dpilawa/bytec/various/hirschmann_ent10512_pinout.JPG

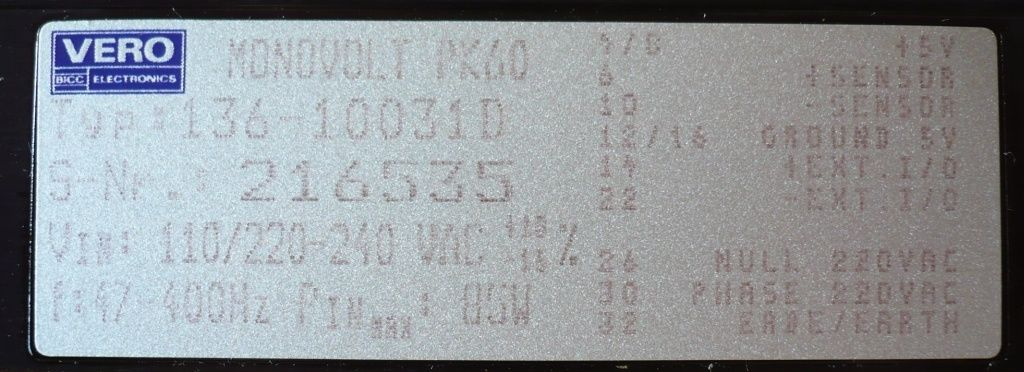
various/hirschmann_ent10512_pinout.JPG
