dpilawa/bytec/ucasm/README

Microcode Assembler

Release 2016-02-08

This software is part of "DIY Computer Poject" <http://www.pilawa.org/computer>
Copyright 2009, 2010, 2011, 2016 Dawid Pilawa <dpilawa(at)gmail(dot)com>
