dpilawa/bytec/diagrams/cpu2.0.png

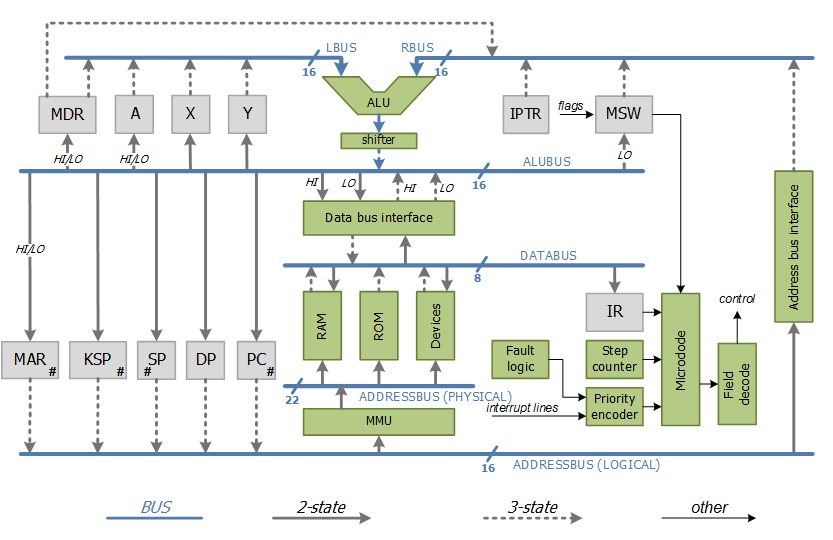
diagrams/cpu2.0.png
