dpilawa/bytec/diagrams/cpu6.png

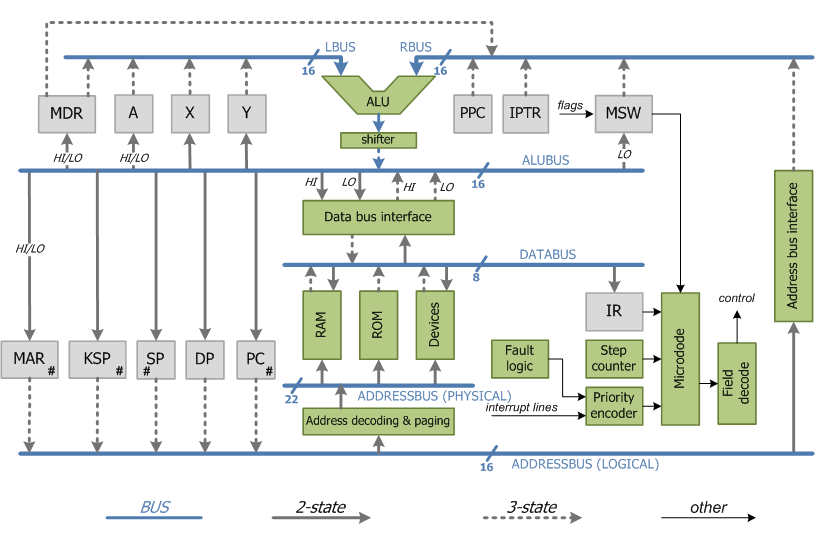
diagrams/cpu6.png
