dpilawa/bytec/instructionset/instructionset_20160414.xls

# | opcode | mnemonic | semantics | flags set | cycles
0 | 0 | NOP | no operation; fetch next instruction | -------- | 1
1 | 0 | FRET | return from fault | SICZNV-- | 17
2 | 0 | MOV A, X | copy X to A | -------- | 1
3 | 0 | MOV A, Y | copy Y to A | -------- | 1
4 | 0 | MOV A, SP | copy SP to A | -------- | 2
5 | 0 | MOV A, DP | copy DP to A | -------- | 2
6 | 0 | MOV X, A | copy A to X | -------- | 1
7 | 0 | MOV X, Y | copy Y to X | -------- | 1
8 | 0 | MOV Y, A | copy A to Y | -------- | 1
9 | 0 | MOV Y, X | copy X to Y | -------- | 1
10 | 0 | MOV SP, A | copy A to SP | -------- | 1
11 | 0 | MOV DP, A | copy A to DP | -------- | 1
12 | 0 | MOV AL, MSW | copy machine status word to low byte of A | -------- | 1
13 | 0 | MOV MSW, AL | copy low byte of A to machine status word | SICZNVP- | 1
14 | 0 | MOVL AL, X | copy low byte of X to AL | -------- | 1
15 | 0 | MOVL AL, Y | copy low byte of Y to AL | -------- | 1
16 | 0 | PUSH A | push A to stack | -------- | 4
17 | 0 | PUSH X | push X to stack | -------- | 4
18 | 0 | PUSH Y | push Y to stack | -------- | 4
19 | 0 | PUSH AH | push high byte of A to stack | -------- | 3
20 | 0 | PUSH AL | push low byte of A to stack | -------- | 3
21 | 0 | PUSH SP | push SP to stack | -------- | 4
22 | 0 | PUSH DP | push DP to stack | -------- | 4
23 | 0 | PUSH PC | push PC to stack | -------- | 4
24 | 0 | POP A | pop A from stack | -------- | 3
25 | 0 | POP X | pop X from stack | -------- | 3
26 | 0 | POP Y | pop Y from stack | -------- | 3
27 | 0 | POP AH | pop high byte of A from stack | -------- | 2
28 | 0 | POP AL | pop low byte of A from stack | -------- | 2
29 | 0 | POP SP | pop SP from stack | -------- | 3
30 | 0 | POP DP | pop DP from stack | -------- | 3
31 | 0 | JMP A | jump to absolute address in A | -------- | 2
32 | 0 | JMP #i16 | unconditional jump (offset relative to PC) | -------- | 4
33 | 0 | CALL #i16 | push program counter to stack and jump to subroutine (offset relative to PC) | -------- | 7
34 | 0 | RET | return from subroutine (pop program counter from stack) | -------- | 4
35 | 0 | IRET | return from interrupt | SICZNV-- | 20
36 | 0 | CALL A | push program counter to stack and jump to subroutine address in A | -------- | 5
37 | 0 | LD A, #i16 | load A with 16-bit immediate | -------- | 3
38 | 0 | LD A, (SP:#i8) | load A with memory at address in SP plus 8-bit signed offset | -------- | 5
39 | 0 | LD A, (SP:#i16) | load A with memory at address in SP plus 16-bit signed offset | -------- | 6
40 | 0 | LD A, (DP:#i16) | load A with memory at address in DP plus 16-bit signed offset | -------- | 6
41 | 0 | LD A, (A:#i16) | load A with memory at address in A plus 16-bit signed offset | -------- | 6
42 | 0 | LD A, (X:#i16) | load A with memory at address in X plus 16-bit signed offset | -------- | 6
43 | 0 | LD A, (Y:#i16) | load A with memory at address in Y plus 16-bit signed offset | -------- | 6
44 | 0 | LD X, #i16 | load X with 16-bit immediate | -------- | 3
45 | 0 | LD X, (SP:#i8) | load X with memory at address in SP plus 8-bit signed offset | -------- | 5
46 | 0 | LD X, (SP:#i16) | load X with memory at address in SP plus 16-bit signed offset | -------- | 6
47 | 0 | LD X, (DP:#i16) | load X with memory at address in DP plus 16-bit signed offset | -------- | 6
48 | 0 | LD X, (A:#i16) | load X with memory at address in A plus 16-bit signed offset | -------- | 6
49 | 0 | LD X, (X:#i16) | load X with memory at address in X plus 16-bit signed offset | -------- | 6
50 | 0 | LD X, (Y:#i16) | load X with memory at address in Y plus 16-bit signed offset | -------- | 6
51 | 0 | LD Y, #i16 | load Y with 16-bit immediate | -------- | 3
52 | 0 | LD Y, (SP:#i8) | load Y with memory at address in SP plus 8-bit signed offset | -------- | 5
53 | 0 | LD Y, (SP:#i16) | load Y with memory at address in SP plus 16-bit signed offset | -------- | 6
54 | 0 | LD Y, (DP:#i16) | load Y with memory at address in DP plus 16-bit signed offset | -------- | 6
55 | 0 | LD Y, (A:#i16) | load Y with memory at address in A plus 16-bit signed offset | -------- | 6
56 | 0 | LD Y, (X:#i16) | load Y with memory at address in X plus 16-bit signed offset | -------- | 6
57 | 0 | LD Y, (Y:#i16) | load Y with memory at address in Y plus 16-bit signed offset | -------- | 6
58 | 0 | LD AH, #i8 | load low byte of A with 8-bit immediate | -------- | 2
59 | 0 | LD AL, #i8 | load high byte of A with 8-bit immediate | -------- | 2
60 | 0 | LD AH, (SP:#i8) | load high byte of A with memory at address in SP plus 8-bit signed offset | -------- | 4
61 | 0 | LD AL, (SP:#i8) | load low byte of A with memory at address in SP plus 8-bit signed offset | -------- | 4
62 | 0 | LD AH, (SP:#i16) | load high byte of A with memory at address in SP plus 16-bit signed offset | -------- | 5
63 | 0 | LD AL, (SP:#i16) | load low byte of A with memory at address in SP plus 16-bit signed offset | -------- | 5
64 | 0 | LD AH, (DP:#i16) | load high byte of A with memory at address in DP plus 16-bit signed offset | -------- | 5
65 | 0 | LD AL, (DP:#i16) | load low byte of A with memory at address in DP plus 16-bit signed offset | -------- | 5
66 | 0 | LD AH, (X:#i16) | load high byte of A with memory at address in X plus 16-bit signed offset | -------- | 5
67 | 0 | LD AL, (X:#i16) | load low byte of A with memory at address in X plus 16-bit signed offset | -------- | 5
68 | 0 | LD AH, (Y:#i16) | load high byte of A with memory at address in Y plus 16-bit signed offset | -------- | 5
69 | 0 | LD AL, (Y:#i16) | load low byte of A with memory at address in Y plus 16-bit signed offset | -------- | 5
70 | 0 | ST (SP:#i8), A | store A in memory at address in SP plus 8-bit signed offset | -------- | 5
71 | 0 | ST (SP:#i16), A | store A in memory at address in SP plus 16-bit signed offset | -------- | 6
72 | 0 | ST (DP:#i16), A | store A in memory at address in DP plus 16-bit signed offset | -------- | 6
73 | 0 | ST (A:#i16), A | store A in memory at address in A plus 16-bit signed offset | -------- | 6
74 | 0 | ST (X:#i16), A | store A in memory at address in X plus 16-bit signed offset | -------- | 6
75 | 0 | ST (Y:#i16), A | store A in memory at address in Y plus 16-bit signed offset | -------- | 6
76 | 0 | ST (SP:#i8), X | store X in memory at address in SP plus 8-bit signed offset | -------- | 5
77 | 0 | ST (SP:#i16), X | store X in memory at address in SP plus 16-bit signed offset | -------- | 6
78 | 0 | ST (DP:#i16), X | store X in memory at address in DP plus 16-bit signed offset | -------- | 6
79 | 0 | ST (A:#i16), X | store X in memory at address in A plus 16-bit signed offset | -------- | 6
80 | 0 | ST (X:#i16), X | store X in memory at address in X plus 16-bit signed offset | -------- | 6
81 | 0 | ST (Y:#i16), X | store X in memory at address in Y plus 16-bit signed offset | -------- | 6
82 | 0 | ST (SP:#i8), Y | store Y in memory at address in SP plus 8-bit signed offset | -------- | 5
83 | 0 | ST (SP:#i16), Y | store Y in memory at address in SP plus 16-bit signed offset | -------- | 6
84 | 0 | ST (DP:#i16), Y | store Y in memory at address in DP plus 16-bit signed offset | -------- | 6
85 | 0 | ST (A:#i16), Y | store Y in memory at address in A plus 16-bit signed offset | -------- | 6
86 | 0 | ST (X:#i16), Y | store Y in memory at address in X plus 16-bit signed offset | -------- | 6
87 | 0 | ST (Y:#i16), Y | store Y in memory at address in Y plus 16-bit signed offset | -------- | 6
88 | 0 | ST (SP:#i8), AH | store high byte of A at address in SP plus 8-bit signed offset | -------- | 4
89 | 0 | ST (SP:#i8), AL | store low byte of A at address in SP plus 8-bit signed offset | -------- | 4
90 | 0 | ST (SP:#i16), AH | store high byte of A at address in SP plus 16-bit signed offset | -------- | 5
91 | 0 | ST (SP:#i16), AL | store low byte of A at address in SP plus 16-bit signed offset | -------- | 5
92 | 0 | ST (DP:#i16), AH | store high byte of A at address in DP plus 16-bit signed offset | -------- | 5
93 | 0 | ST (DP:#i16), AL | store low byte of A at address in DP plus 16-bit signed offset | -------- | 5
94 | 0 | ST (X:#i16), AH | store high byte of A at address in X plus 16-bit signed offset | -------- | 5
95 | 0 | ST (X:#i16), AL | store low byte of A at address in X plus 16-bit signed offset | -------- | 5
96 | 0 | ST (Y:#i16), AH | store high byte of A at address in Y plus 16-bit signed offset | -------- | 5
97 | 0 | ST (Y:#i16), AL | store low byte of A at address in Y plus 16-bit signed offset | -------- | 5
98 | 0 | ADD A, #i16 | add 16-bit signed immediate to A | --CZNV-- | 3
99 | 0 | ADD A, X | add X to A | --CZNV-- | 2
100 | 0 | ADD A, Y | add Y to A | --CZNV-- | 2
101 | 0 | ADD A, (SP:#i8) | add memory at address in SP plus 8-bit signed offset to A | --CZNV-- | 5
102 | 0 | ADD A, (SP:#i16) | add memory at address in SP plus 16-bit signed offset to A | --CZNV-- | 6
103 | 0 | ADD A, (DP:#i16) | add memory at address in DP plus 16-bit signed offset to A | --CZNV-- | 6
104 | 0 | ADD A, (A:#i16) | add memory at address in A plus 16-bit signed offset to A | --CZNV-- | 6
105 | 0 | ADD A, (X:#i16) | add memory at address in X plus 16-bit signed offset to A | --CZNV-- | 6
106 | 0 | ADD A, (Y:#i16) | add memory at address in Y plus 16-bit signed offset to A | --CZNV-- | 6
107 | 0 | ADD X, #i16 | add 16-bit signed immediate to X | --CZNV-- | 3
108 | 0 | ADD X, A | add A to X | --CZNV-- | 2
109 | 0 | ADD X, Y | add Y to X | --CZNV-- | 2
110 | 0 | ADD X, (SP:#i8) | add memory at address in SP plus 8-bit signed offset to X | --CZNV-- | 5
111 | 0 | ADD X, (SP:#i16) | add memory at address in SP plus 16-bit signed offset to X | --CZNV-- | 6
112 | 0 | ADD X, (DP:#i16) | add memory at address in DP plus 16-bit signed offset to X | --CZNV-- | 6
113 | 0 | ADD X, (A:#i16) | add memory at address in A plus 16-bit signed offset to X | --CZNV-- | 6
114 | 0 | ADD X, (X:#i16) | add memory at address in X plus 16-bit signed offset to X | --CZNV-- | 6
115 | 0 | ADD X, (Y:#i16) | add memory at address in Y plus 16-bit signed offset to X | --CZNV-- | 6
116 | 0 | ADD Y, #i16 | add 16-bit signed immediate to Y | --CZNV-- | 3
117 | 0 | ADD Y, A | add A to Y | --CZNV-- | 2
118 | 0 | ADD Y, X | add X to Y | --CZNV-- | 2
119 | 0 | ADD Y, (SP:#i8) | add memory at address in SP plus 8-bit signed offset to Y | --CZNV-- | 5
120 | 0 | ADD Y, (SP:#i16) | add memory at address in SP plus 16-bit signed offset to Y | --CZNV-- | 6
121 | 0 | ADD Y, (DP:#i16) | add memory at address in DP plus 16-bit signed offset to Y | --CZNV-- | 6
122 | 0 | ADD Y, (A:#i16) | add memory at address in A plus 16-bit signed offset to Y | --CZNV-- | 6
123 | 0 | ADD Y, (X:#i16) | add memory at address in X plus 16-bit signed offset to Y | --CZNV-- | 6
124 | 0 | ADD Y, (Y:#i16) | add memory at address in Y plus 16-bit signed offset to Y | --CZNV-- | 6
125 | 0 | ADD AH, #i8 | add 8-bit immediate to high byte of A | --CZNV-- | 3
126 | 0 | ADD AL, #i8 | add 8-bit immediate to low byte of A | --CZNV-- | 2
127 | 0 | ADD AH, (SP:#i16) | add memory at address in SP plus 16-bit signed offset to high byte of A | --CZNV-- | 6
128 | 0 | ADD AL, (SP:#i16) | add memory at address in SP plus 16-bit signed offset to low byte of A | --CZNV-- | 5
129 | 0 | ADD AH, (DP:#i16) | add memory at address in DP plus 16-bit signed offset to high byte of A | --CZNV-- | 6
130 | 0 | ADD AL, (DP:#i16) | add memory at address in DP plus 16-bit signed offset to low byte of A | --CZNV-- | 5
131 | 0 | ADD AH, (X:#i16) | add memory at address in X plus 16-bit signed offset to high byte of A | --CZNV-- | 6
132 | 0 | ADD AL, (X:#i16) | add memory at address in X plus 16-bit signed offset to low byte of A | --CZNV-- | 5
133 | 0 | ADD AH, (Y:#i16) | add memory at address in Y plus 16-bit signed offset to high byte of A | --CZNV-- | 6
134 | 0 | ADD AL, (Y:#i16) | add memory at address in Y plus 16-bit signed offset to low byte of A | --CZNV-- | 5
135 | 0 | SUB A, #i16 | subtract 16-bit signed immediate from A | --CZNV-- | 3
136 | 0 | SUB A, X | subtract X from A | --CZNV-- | 2
137 | 0 | SUB A, Y | subtract Y from A | --CZNV-- | 2
138 | 0 | SUB A, (SP:#i8) | subtract memory at address in SP plus 8-bit signed offset from A | --CZNV-- | 5
139 | 0 | SUB A, (SP:#i16) | subtract memory at address in SP plus 16-bit signed offset from A | --CZNV-- | 6
140 | 0 | SUB A, (DP:#i16) | subtract memory at address in DP plus 16-bit signed offset from A | --CZNV-- | 6
141 | 0 | SUB A, (A:#i16) | subtract memory at address in A plus 16-bit signed offset from A | --CZNV-- | 6
142 | 0 | SUB A, (X:#i16) | subtract memory at address in X plus 16-bit signed offset from A | --CZNV-- | 6
143 | 0 | SUB A, (Y:#i16) | subtract memory at address in Y plus 16-bit signed offset from A | --CZNV-- | 6
144 | 0 | SUB X, #i16 | subtract 16-bit signed immediate from X | --CZNV-- | 3
145 | 0 | SUB X, A | subtract A from X | --CZNV-- | 2
146 | 0 | SUB X, Y | subtract Y from X | --CZNV-- | 2
147 | 0 | SUB X, (SP:#i8) | subtract memory at address in SP plus 8-bit signed offset from X | --CZNV-- | 5
148 | 0 | SUB X, (SP:#i16) | subtract memory at address in SP plus 16-bit signed offset from X | --CZNV-- | 6
149 | 0 | SUB X, (DP:#i16) | subtract memory at address in DP plus 16-bit signed offset from X | --CZNV-- | 6
150 | 0 | SUB X, (A:#i16) | subtract memory at address in A plus 16-bit signed offset from X | --CZNV-- | 6
151 | 0 | SUB X, (X:#i16) | subtract memory at address in X plus 16-bit signed offset from X | --CZNV-- | 6
152 | 0 | SUB X, (Y:#i16) | subtract memory at address in Y plus 16-bit signed offset from X | --CZNV-- | 6
153 | 0 | SUB Y, #i16 | subtract 16-bit signed immediate from Y | --CZNV-- | 3
154 | 0 | SUB Y, A | subtract A from Y | --CZNV-- | 2
155 | 0 | SUB Y, X | subtract X from Y | --CZNV-- | 2
156 | 0 | SUB Y, (SP:#i8) | subtract memory at address in SP plus 8-bit signed offset from Y | --CZNV-- | 5
157 | 0 | SUB Y, (SP:#i16) | subtract memory at address in SP plus 16-bit signed offset from Y | --CZNV-- | 6
158 | 0 | SUB Y, (DP:#i16) | subtract memory at address in DP plus 16-bit signed offset from Y | --CZNV-- | 6
159 | 0 | SUB Y, (A:#i16) | subtract memory at address in A plus 16-bit signed offset from Y | --CZNV-- | 6
160 | 0 | SUB Y, (X:#i16) | subtract memory at address in X plus 16-bit signed offset from Y | --CZNV-- | 6
161 | 0 | SUB Y, (Y:#i16) | subtract memory at address in Y plus 16-bit signed offset from Y | --CZNV-- | 6
162 | 0 | SUB AH, #i8 | subtract 8-bit immediate from high byte of A | --CZNV-- | 3
163 | 0 | SUB AL, #i8 | subtract 8-bit immediate from low byte of A | --CZNV-- | 2
164 | 0 | SUB AH, (SP:#i16) | subtract memory at address in SP plus 16-bit signed offset from high byte of A | --CZNV-- | 6
165 | 0 | SUB AL, (SP:#i16) | subtract memory at address in SP plus 16-bit signed offset from low byte of A | --CZNV-- | 5
166 | 0 | SUB AH, (DP:#i16) | subtract memory at address in DP plus 16-bit signed offset from high byte of A | --CZNV-- | 6
167 | 0 | SUB AL, (DP:#i16) | subtract memory at address in DP plus 16-bit signed offset from low byte of A | --CZNV-- | 5
168 | 0 | SUB AH, (X:#i16) | subtract memory at address in X plus 16-bit signed offset from high byte of A | --CZNV-- | 6
169 | 0 | SUB AL, (X:#i16) | subtract memory at address in X plus 16-bit signed offset from low byte of A | --CZNV-- | 5
170 | 0 | SUB AH, (Y:#i16) | subtract memory at address in Y plus 16-bit signed offset from high byte of A | --CZNV-- | 6
171 | 0 | SUB AL, (Y:#i16) | subtract memory at address in Y plus 16-bit signed offset from low byte of A | --CZNV-- | 5
172 | 0 | AND A, #i16 | bitwise AND on A and 16-bit immediate, result in A | --CZNV-- | 3
173 | 0 | AND A, X | bitwise AND on A and X, result in A | --CZNV-- | 2
174 | 0 | AND A, Y | bitwise AND on A and Y, result in A | --CZNV-- | 2
175 | 0 | AND A, (SP:#i16) | bitwise AND on A and memory at address in SP plus 16-bit signed offset, result in A | --CZNV-- | 6
176 | 0 | AND A, (DP:#i16) | bitwise AND on A and memory at address in DP plus 16-bit signed offset, result in A | --CZNV-- | 6
177 | 0 | AND AH, #i8 | bitwise AND on high byte of A and 8-bit immediate, result in low byte of A | --CZNV-- | 2
178 | 0 | AND AL, #i8 | bitwise AND on low byte of A and 8-bit immediate, result in low byte of A | --CZNV-- | 2
179 | 0 | AND AH, (SP:#i16) | bitwise AND on high byte of A and memory at address in SP plus 16-bit signed offset, result in high byte of A | --CZNV-- | 5
180 | 0 | AND AL, (SP:#i16) | bitwise AND on low byte of A and memory at address in SP plus 16-bit signed offset, result in low byte of A | --CZNV-- | 5
181 | 0 | AND AH, (DP:#i16) | bitwise AND on high byte of A and memory at address in DP plus 16-bit signed offset, result in high byte of A | --CZNV-- | 5
182 | 0 | AND AL, (DP:#i16) | bitwise AND on low byte of A and memory at address in DP plus 16-bit signed offset, result in low byte of A | --CZNV-- | 5
183 | 0 | OR A, #i16 | bitwise OR on A and 16-bit immediate, result in A | --CZNV-- | 3
184 | 0 | OR A, X | bitwise OR on A and X, result in A | --CZNV-- | 2
185 | 0 | OR A, Y | bitwise OR on A and Y, result in A | --CZNV-- | 2
186 | 0 | OR A, (SP:#i16) | bitwise OR on A and memory at address in SP plus 16-bit signed offset, result in A | --CZNV-- | 6
187 | 0 | OR A, (DP:#i16) | bitwise OR on A and memory at address in DP plus 16-bit signed offset, result in A | --CZNV-- | 6
188 | 0 | OR AH, #i8 | bitwise OR on high byte of A and 8-bit immediate, result in low byte of A | --CZNV-- | 2
189 | 0 | OR AL, #i8 | bitwise OR on low byte of A and 8-bit immediate, result in low byte of A | --CZNV-- | 2
190 | 0 | OR AH, (SP:#i16) | bitwise OR on high byte of A and memory at address in SP plus 16-bit signed offset, result in high byte of A | --CZNV-- | 5
191 | 0 | OR AL, (SP:#i16) | bitwise OR on low byte of A and memory at address in SP plus 16-bit signed offset, result in low byte of A | --CZNV-- | 5
192 | 0 | OR AH, (DP:#i16) | bitwise OR on high byte of A and memory at address in DP plus 16-bit signed offset, result in high byte of A | --CZNV-- | 5
193 | 0 | OR AL, (DP:#i16) | bitwise OR on low byte of A and memory at address in DP plus 16-bit signed offset, result in low byte of A | --CZNV-- | 5
194 | 0 | XOR A, #i16 | bitwise XOR on A and 16-bit immediate, result in A | --CZNV-- | 3
195 | 0 | XOR A, X | bitwise XOR on A and X, result in A | --CZNV-- | 2
196 | 0 | XOR A, Y | bitwise XOR on A and Y, result in A | --CZNV-- | 2
197 | 0 | XOR A, (SP:#i16) | bitwise XOR on A and memory at address in SP plus 16-bit signed offset, result in A | --CZNV-- | 6
198 | 0 | XOR A, (DP:#i16) | bitwise XOR on A and memory at address in DP plus 16-bit signed offset, result in A | --CZNV-- | 6
199 | 0 | XOR AH, #i8 | bitwise XOR on high byte of A and 8-bit immediate, result in low byte of A | --CZNV-- | 2
200 | 0 | XOR AL, #i8 | bitwise XOR on low byte of A and 8-bit immediate, result in low byte of A | --CZNV-- | 2
201 | 0 | XOR AH, (SP:#i16) | bitwise XOR on high byte of A and memory at address in SP plus 16-bit signed offset, result in high byte of A | --CZNV-- | 5
202 | 0 | XOR AL, (SP:#i16) | bitwise XOR on low byte of A and memory at address in SP plus 16-bit signed offset, result in low byte of A | --CZNV-- | 5
203 | 0 | XOR AH, (DP:#i16) | bitwise XOR on high byte of A and memory at address in DP plus 16-bit signed offset, result in high byte of A | --CZNV-- | 5
204 | 0 | XOR AL, (DP:#i16) | bitwise XOR on low byte of A and memory at address in DP plus 16-bit signed offset, result in low byte of A | --CZNV-- | 5
205 | 0 | SEX A | sign extend A (low 8 bits to 16 bits) | --CZNV-- | 2
206 | 0 | SHL A | logical shift left of A | --CZNV-- | 1
207 | 0 | SHR A | logical shift right of A | --CZNV-- | 1
208 | 0 | SHL AH | logical shift left of high byte of A | --CZNV-- | 1
209 | 0 | SHL AL | logical shift left of low byte of A | --CZNV-- | 1
210 | 0 | SHR AH | logical shift right of high byte of A | --CZNV-- | 1
211 | 0 | SHR AL | logical shift right of low byte of A | --CZNV-- | 1
212 | 0 | ADC A, X | add with carry X to A | --CZNV-- | 2
213 | 0 | ADC A, Y | add with carry Y to A | --CZNV-- | 2
214 | 0 | SBC A, X | subtract with carry X from A | --CZNV-- | 2
215 | 0 | SBC A, Y | subtract with carry Y from A | --CZNV-- | 2
216 | 0 | ADD SP, #i16 | Add 16-bit signed immediate to SP | --CZNV-- | 4
217 | 0 | CMP A, #i16 | compare A to 16-bit signed immediate, set flags | --CZNV-- | 3
218 | 0 | CMP A, X | compare A to X, set flags | --CZNV-- | 2
219 | 0 | CMP A, Y | compare A to Y, set flags | --CZNV-- | 2
220 | 0 | CMP A, (SP:#i16) | compare A to memory at address in SP plus 16-bit signed offset | --CZNV-- | 6
221 | 0 | CMP A, (DP:#i16) | compare A to memory at address in DP plus 16-bit signed offset | --CZNV-- | 6
222 | 0 | CMP AH, #i8 | compare AH to 8-bit signed immediate, set flags | --CZNV-- | 3
223 | 0 | CMP AH, (SP:#i16) | compare high byte of A to memory at address in SP plus 16-bit signed offset | --CZNV-- | 6
224 | 0 | CMP AH, (DP:#i16) | compare high byte of A to memory at address in DP plus 16-bit signed offset | --CZNV-- | 6
225 | 0 | CMP AL, #i8 | compare AL to 8-bit signed immediate, set flags | --CZNV-- | 2
226 | 0 | CMP AL, (SP:#i16) | compare low byte of A to memory at address in SP plus 16-bit signed offset | --CZNV-- | 5
227 | 0 | CMP AL, (DP:#i16) | compare low byte of A to memory at address in DP plus 16-bit signed offset | --CZNV-- | 5
228 | 0 | JE #i16 | jump if equal (offset relative to PC) | -------- | 3 /4
229 | 0 | JNE #i16 | jump if not equal (offset relative to PC) | -------- | 3 /4
230 | 0 | JL #i16 | jump if lower (offset relative to PC) | -------- | 3 /4
231 | 0 | JLE #i16 | jump if lower or equal (offset relative to PC) | -------- | 3 /4
232 | 0 | JG #i16 | jump if greater (offset relative to PC) | -------- | 3 /4
233 | 0 | JGE #i16 | jump if greater or equal (offset relative to PC) | -------- | 3 /4
234 | 0 | JLU #i16 | jump if lower unsigned (offset relative to PC) | -------- | 3 /4
235 | 0 | JLEU #i16 | jump if lower or equal unsigned (offset relative to PC) | -------- | 3 /4
236 | 0 | JGU #i16 | jump if greater unsigned (offset relative to PC) | -------- | 3 /4
237 | 0 | JGEU #i16 | jump if greater or equal unsigned (offset relative to PC) | -------- | 3 /4
238 | 0 | JZ #i16 | jump if zero (offset relative to PC) | -------- | 3 /4
239 | 0 | JNZ #i16 | jump if not zero (offset relative to PC) | -------- | 3 /4
240 | 0 | JC #i16 | jump if carry (offset relative to PC) | -------- | 3 /4
241 | 0 | JNC #i16 | jump if not carry (offset relative to PC) | -------- | 3 /4
242 | 0 | JN #i16 | jump if negative (offset relative to PC) | -------- | 3 /4
243 | 0 | JNN #i16 | jump if not negative (offset relative to PC) | -------- | 3 /4
244 | 0 | JV #i16 | jump if overflow (offset relative to PC) | -------- | 3 /4
245 | 0 | JNV #i16 | jump if not overflow (offset relative to PC) | -------- | 3 /4
246 | 0 | LEA A, (A:#i16) | load effective address in A plus 16-bit signed offset to A | -------- | 3
247 | 0 | LEA A, (DP:#i16) | load effective address in SP plus 16-bit signed offset to A | -------- | 4
248 | 0 | LEA A, (SP:#i16) | load effective address in DP plus 16-bit signed offset to A | -------- | 4
249 | 0 | LEA X, (A:#i16) | load effective address in A plus 16-bit signed offset to X | -------- | 3
250 | 0 | LEA X, (DP:#i16) | load effective address in SP plus 16-bit signed offset to X | -------- | 4
251 | 0 | LEA X, (SP:#i16) | load effective address in DP plus 16-bit signed offset to X | -------- | 4
252 | 0 | LEA Y, (A:#i16) | load effective address in A plus 16-bit signed offset to Y | -------- | 3
253 | 0 | LEA Y, (DP:#i16) | load effective address in SP plus 16-bit signed offset to Y | -------- | 4
254 | 0 | LEA Y, (SP:#i16) | load effective address in DP plus 16-bit signed offset to Y | -------- | 4
255 | 0 | SYSCALL #i8 | call a system interrupt | SI------ | 29
256 | 0 | n/a | IRQ #0 | SI------ | 22
257 | 0 | n/a | IRQ #1 | SI------ | 22
258 | 0 | n/a | IRQ #2 | SI------ | 22
259 | 0 | n/a | IRQ #3 | SI------ | 22
260 | 0 | n/a | IRQ #4 | SI------ | 22
261 | 0 | n/a | IRQ #5 | SI------ | 22
262 | 0 | n/a | IRQ #6 | SI------ | 22
263 | 0 | n/a | IRQ #7 | SI------ | 22
264 | 0 | n/a | fault #0 – illegal instruction / protection violation | SI------ | 22
265 | 0 | n/a | fault #1 – unused | SI------ | 22
266 | 0 | n/a | fault #2 – unused | SI------ | 22
267 | 0 | n/a | fault #3 – unused | SI------ | 22
268 | 0 | n/a | fault #4 – unused | SI------ | 22
269 | 0 | n/a | fault #5 – unused | SI------ | 22
270 | 0 | n/a | fault #6 – unused | SI------ | 22
271 | 0 | n/a | unreachable opcode – interrupt vector entry used for SYSCALL | SI------ | 1
