dpilawa/bytec/instructionset/instructionset_20110624.xls

# | opcode | mnemonic | semantics | flags set | cycles
0 | 00 | NOP | no operation; fetch next instruction | ------ | 1
1 | 01 | HALT | halt the machine; fetch self | ------ | 3
2 | 02 | MOV A, X | copy X to A | ------ | 1
3 | 03 | MOV A, Y | copy Y to A | ------ | 1
4 | 04 | MOV A, SP | copy SP to A | ------ | 2
5 | 05 | MOV A, DP | copy DP to A | ------ | 2
6 | 06 | MOV X, A | copy A to X | ------ | 1
7 | 07 | MOV X, Y | copy Y to X | ------ | 1
8 | 08 | MOV Y, A | copy A to Y | ------ | 1
9 | 09 | MOV Y, X | copy X to Y | ------ | 1
10 | 0A | MOV SP, A | copy A to SP | ------ | 1
11 | 0B | MOV SP, DP | copy DP to SP | ------ | 2
12 | 0C | MOV DP, A | copy A to DP | ------ | 1
13 | 0D | MOV DP, SP | copy SP to DP | ------ | 2
14 | 0E | MOV AL, MSW | copy machine status word to low byte of A | ------ | 1
15 | 0F | MOV MSW, AL | copy low byte of A to machine status word | SICZNV | 1
16 | 10 | PUSH A | push A to stack | ------ | 4
17 | 11 | PUSH X | push X to stack | ------ | 4
18 | 12 | PUSH Y | push Y to stack | ------ | 4
19 | 13 | PUSH SP | push SP to stack | ------ | 4
20 | 14 | PUSH DP | push DP to stack | ------ | 4
21 | 15 | PUSH PC | push PC to stack | ------ | 4
22 | 16 | POP A | pop A from stack | ------ | 3
23 | 17 | POP X | pop X from stack | ------ | 3
24 | 18 | POP Y | pop Y from stack | ------ | 3
25 | 19 | POP SP | pop SP from stack | ------ | 3
26 | 1A | POP DP | pop DP from stack | ------ | 3
27 | 1B | POP PC | pop PC from stack | ------ | 4
28 | 1C | JMP #i16 | unconditional jump (offset relative to PC) | ------ | 4
29 | 1D | CALL #i16 | push program counter to stack and jump to subroutine (offset relative to PC) | ------ | 7
30 | 1E | RET | return from subroutine (pop program counter from stack) | ------ | 4
31 | 1F | IRET | return from interrupt | SICZNV | 20
32 | 20 | CALL (SP) | push program counter to stack and jump to subroutine address on previous top of the stack | ------ | 8
33 | 21 | LD A, #i16 | load A with 16-bit immediate | ------ | 3
34 | 22 | LD A, #i8 | load A with 8-bit immediate (with sign extension to high byte) | ------ | 2
35 | 23 | LD A, (SP) | load A with memory at address in SP | ------ | 4
36 | 24 | LD A, (SP:#i8) | load A with memory at address in SP plus 8-bit signed offset | ------ | 5
37 | 25 | LD A, (SP:#i16) | load A with memory at address in SP plus 16-bit signed offset | ------ | 6
38 | 26 | LD A, (DP:#i16) | load A with memory at address in DP plus 16-bit signed offset | ------ | 6
39 | 27 | LD A, (A:#i16) | load A with memory at address in A plus 16-bit signed offset | ------ | 6
40 | 28 | LD A, (X:#i16) | load A with memory at address in X plus 16-bit signed offset | ------ | 6
41 | 29 | LD A, (Y:#i16) | load A with memory at address in Y plus 16-bit signed offset | ------ | 6
42 | 2A | LD X, #i16 | load X with 16-bit immediate | ------ | 3
43 | 2B | LD X, #i8 | load X with 8-bit immediate (sign extended) | ------ | 2
44 | 2C | LD X, (SP) | load X with memory at address in SP | ------ | 4
45 | 2D | LD X, (SP:#i8) | load X with memory at address in SP plus 8-bit signed offset | ------ | 5
46 | 2E | LD X, (SP:#i16) | load X with memory at address in SP plus 16-bit signed offset | ------ | 6
47 | 2F | LD X, (DP:#i16) | load X with memory at address in DP plus 16-bit signed offset | ------ | 6
48 | 30 | LD X, (A:#i16) | load X with memory at address in A plus 16-bit signed offset | ------ | 6
49 | 31 | LD X, (X:#i16) | load X with memory at address in X plus 16-bit signed offset | ------ | 6
50 | 32 | LD X, (Y:#i16) | load X with memory at address in Y plus 16-bit signed offset | ------ | 6
51 | 33 | LD Y, #i16 | load Y with 16-bit immediate | ------ | 3
52 | 34 | LD Y, #i8 | load Y with 8-bit immediate (sign extended) | ------ | 2
53 | 35 | LD Y, (SP) | load Y with memory at address in SP | ------ | 4
54 | 36 | LD Y, (SP:#i8) | load Y with memory at address in SP plus 8-bit signed offset | ------ | 5
55 | 37 | LD Y, (SP:#i16) | load Y with memory at address in SP plus 16-bit signed offset | ------ | 6
56 | 38 | LD Y, (DP:#i16) | load Y with memory at address in DP plus 16-bit signed offset | ------ | 6
57 | 39 | LD Y, (A:#i16) | load Y with memory at address in A plus 16-bit signed offset | ------ | 6
58 | 3A | LD Y, (X:#i16) | load Y with memory at address in X plus 16-bit signed offset | ------ | 6
59 | 3B | LD Y, (Y:#i16) | load Y with memory at address in Y plus 16-bit signed offset | ------ | 6
60 | 3C | LD AH, #i8 | load low byte of A with 8-bit immediate | ------ | 2
61 | 3D | LD AL, #i8 | load high byte of A with 8-bit immediate | ------ | 2
62 | 3E | LD AH, (SP:#i8) | load high byte of A with memory at address in SP plus 8-bit signed offset | ------ | 4
63 | 3F | LD AL, (SP:#i8) | load low byte of A with memory at address in SP plus 8-bit signed offset | ------ | 4
64 | 40 | LD AH, (SP:#i16) | load high byte of A with memory at address in SP plus 16-bit signed offset | ------ | 5
65 | 41 | LD AL, (SP:#i16) | load low byte of A with memory at address in SP plus 16-bit signed offset | ------ | 5
66 | 42 | LD AH, (DP:#i16) | load high byte of A with memory at address in DP plus 16-bit signed offset | ------ | 5
67 | 43 | LD AL, (DP:#i16) | load low byte of A with memory at address in DP plus 16-bit signed offset | ------ | 5
68 | 44 | LD AH, (DP:X) | load high byte of A with memory at address in DP plus 16-bit signed offset in X | ------ | 3
69 | 45 | LD AL, (DP:X) | load low byte of A with memory at address in DP plus 16-bit signed offset in X | ------ | 3
70 | 46 | LD AH, (X:#i16) | load high byte of A with memory at address in X plus 16-bit signed offset | ------ | 5
71 | 47 | LD AL, (X:#i16) | load low byte of A with memory at address in X plus 16-bit signed offset | ------ | 5
72 | 48 | LD AH, (Y:#i16) | load high byte of A with memory at address in Y plus 16-bit signed offset | ------ | 5
73 | 49 | LD AL, (Y:#i16) | load low byte of A with memory at address in Y plus 16-bit signed offset | ------ | 5
74 | 4A | ST (SP), A | store A in memory at address in SP | ------ | 4
75 | 4B | ST (SP:#i8), A | store A in memory at address in SP plus 8-bit signed offset | ------ | 5
76 | 4C | ST (SP:#i16), A | store A in memory at address in SP plus 16-bit signed offset | ------ | 6
77 | 4D | ST (DP:#i16), A | store A in memory at address in DP plus 16-bit signed offset | ------ | 6
78 | 4E | ST (A:#i16), A | store A in memory at address in A plus 16-bit signed offset | ------ | 6
79 | 4F | ST (X:#i16), A | store A in memory at address in X plus 16-bit signed offset | ------ | 6
80 | 50 | ST (Y:#i16), A | store A in memory at address in Y plus 16-bit signed offset | ------ | 6
81 | 51 | ST (SP), X | store X in memory at address in SP | ------ | 4
82 | 52 | ST (SP:#i8), X | store X in memory at address in SP plus 8-bit signed offset | ------ | 5
83 | 53 | ST (SP:#i16), X | store X in memory at address in SP plus 16-bit signed offset | ------ | 6
84 | 54 | ST (DP:#i16), X | store X in memory at address in DP plus 16-bit signed offset | ------ | 6
85 | 55 | ST (A:#i16), X | store X in memory at address in A plus 16-bit signed offset | ------ | 6
86 | 56 | ST (X:#i16), X | store X in memory at address in X plus 16-bit signed offset | ------ | 6
87 | 57 | ST (Y:#i16), X | store X in memory at address in Y plus 16-bit signed offset | ------ | 6
88 | 58 | ST (SP), Y | store Y in memory at address in SP | ------ | 4
89 | 59 | ST (SP:#i8), Y | store Y in memory at address in SP plus 8-bit signed offset | ------ | 5
90 | 5A | ST (SP:#i16), Y | store Y in memory at address in SP plus 16-bit signed offset | ------ | 6
91 | 5B | ST (DP:#i16), Y | store Y in memory at address in DP plus 16-bit signed offset | ------ | 6
92 | 5C | ST (A:#i16), Y | store Y in memory at address in A plus 16-bit signed offset | ------ | 6
93 | 5D | ST (X:#i16), Y | store Y in memory at address in X plus 16-bit signed offset | ------ | 6
94 | 5E | ST (Y:#i16), Y | store Y in memory at address in Y plus 16-bit signed offset | ------ | 6
95 | 5F | ST (SP), AH | store high byte of A at address in SP | ------ | 2
96 | 60 | ST (SP), AL | store low byte of A at address in SP | ------ | 2
97 | 61 | ST (SP:#i8), AH | store high byte of A at address in SP plus 8-bit signed offset | ------ | 4
98 | 62 | ST (SP:#i8), AL | store low byte of A at address in SP plus 8-bit signed offset | ------ | 4
99 | 63 | ST (SP:#i16), AH | store high byte of A at address in SP plus 16-bit signed offset | ------ | 5
100 | 64 | ST (SP:#i16), AL | store low byte of A at address in SP plus 16-bit signed offset | ------ | 5
101 | 65 | ST (DP:#i16), AH | store high byte of A at address in DP plus 16-bit signed offset | ------ | 5
102 | 66 | ST (DP:#i16), AL | store low byte of A at address in DP plus 16-bit signed offset | ------ | 5
103 | 67 | ST (DP:X), AH | store high byte of A at address in DP plus 16-bit signed offset in X | ------ | 3
104 | 68 | ST (DP:X), AL | store low byte of A at address in DP plus 16-bit signed offset in X | ------ | 3
105 | 69 | ST (X:#i16), AH | store high byte of A at address in X plus 16-bit signed offset | ------ | 5
106 | 6A | ST (X:#i16), AL | store low byte of A at address in X plus 16-bit signed offset | ------ | 5
107 | 6B | ST (Y:#i16), AH | store high byte of A at address in Y plus 16-bit signed offset | ------ | 5
108 | 6C | ST (Y:#i16), AL | store low byte of A at address in Y plus 16-bit signed offset | ------ | 5
109 | 6D | ADD A, #i8 | add 8-bit signed immediate to A | --CZNV | 2
110 | 6E | ADD A, #i16 | add 16-bit signed immediate to A | --CZNV | 3
111 | 6F | ADD A, X | add X to A | --CZNV | 2
112 | 70 | ADD A, Y | add Y to A | --CZNV | 2
113 | 71 | ADD A, (SP) | add memory at address in SP to A | --CZNV | 4
114 | 72 | ADD A, (SP:#i8) | add memory at address in SP plus 8-bit signed offset to A | --CZNV | 5
115 | 73 | ADD A, (SP:#i16) | add memory at address in SP plus 16-bit signed offset to A | --CZNV | 6
116 | 74 | ADD A, (DP:#i16) | add memory at address in DP plus 16-bit signed offset to A | --CZNV | 6
117 | 75 | ADD AH, (SP) | add memory at address in SP to high byte of A | --CZNV | 3
118 | 76 | ADD AH, (SP:#i8) | add memory at address in SP plus 8-bit signed offset to high byte of A | --CZNV | 5
119 | 77 | ADD AH, (SP:#i16) | add memory at address in SP plus 16-bit signed offset to high byte of A | --CZNV | 6
120 | 78 | ADD AH, (DP:#i16) | add memory at address in DP plus 16-bit signed offset to high byte of A | --CZNV | 6
121 | 79 | ADD AL, (SP) | add memory at address in SP to low byte of A | --CZNV | 2
122 | 7A | ADD AL, (SP:#i8) | add memory at address in SP plus 8-bit signed offset to low byte of A | --CZNV | 4
123 | 7B | ADD AL, (SP:#i16) | add memory at address in SP plus 16-bit signed offset to low byte of A | --CZNV | 5
124 | 7C | ADD AL, (DP:#i16) | add memory at address in DP plus 16-bit signed offset to low byte of A | --CZNV | 5
125 | 7D | SUB A, #i8 | subtract 8-bit signed immediate from A | --CZNV | 2
126 | 7E | SUB A, #i16 | subtract 16-bit signed immediate from A | --CZNV | 3
127 | 7F | SUB A, X | subtract X from A | --CZNV | 2
128 | 80 | SUB A, Y | subtract Y from A | --CZNV | 2
129 | 81 | SUB A, (SP) | subtract memory at address in SP from A | --CZNV | 4
130 | 82 | SUB A, (SP:#i8) | subtract memory at address in SP plus 8-bit signed offset from A | --CZNV | 5
131 | 83 | SUB A, (SP:#i16) | subtract memory at address in SP plus 16-bit signed offset from A | --CZNV | 6
132 | 84 | SUB A, (DP:#i16) | subtract memory at address in DP plus 16-bit signed offset from A | --CZNV | 6
133 | 85 | SUB AH, (SP) | subtract memory at address in SP from high byte of A | --CZNV | 3
134 | 86 | SUB AH, (SP:#i8) | subtract memory at address in SP plus 8-bit signed offset from high byte of A | --CZNV | 5
135 | 87 | SUB AH, (SP:#i16) | subtract memory at address in SP plus 16-bit signed offset from high byte of A | --CZNV | 6
136 | 88 | SUB AH, (DP:#i16) | subtract memory at address in DP plus 16-bit signed offset from high byte of A | --CZNV | 6
137 | 89 | SUB AL, (SP) | subtract memory at address in SP from low byte of A | --CZNV | 2
138 | 8A | SUB AL, (SP:#i8) | subtract memory at address in SP plus 8-bit signed offset from low byte of A | --CZNV | 4
139 | 8B | SUB AL, (SP:#i16) | subtract memory at address in SP plus 16-bit signed offset from low byte of A | --CZNV | 5
140 | 8C | SUB AL, (DP:#i16) | subtract memory at address in DP plus 16-bit signed offset from low byte of A | --CZNV | 5
141 | 8D | AND A, #i16 | bitwise AND on A and 16-bit immediate, result in A | --CZNV | 3
142 | 8E | AND A, X | bitwise AND on A and X, result in A | --CZNV | 2
143 | 8F | AND A, Y | bitwise AND on A and Y, result in A | --CZNV | 2
144 | 90 | AND A, (SP) | bitwise AND on A and memory at address in SP, result in A | --CZNV | 4
145 | 91 | AND A, (SP:#i8) | bitwise AND on A and memory at address in SP plus 8-bit signed offset, result in A | --CZNV | 5
146 | 92 | AND A, (SP:#i16) | bitwise AND on A and memory at address in SP plus 16-bit signed offset, result in A | --CZNV | 6
147 | 93 | AND A, (DP:#i16) | bitwise AND on A and memory at address in DP plus 16-bit signed offset, result in A | --CZNV | 6
148 | 94 | AND AH, (SP) | bitwise AND on high byte of A and memory at address in SP, result in high byte of A | --CZNV | 2
149 | 95 | AND AH, (SP:#i8) | bitwise AND on high byte of A and memory at address in SP plus 8-bit signed offset, result in high byte of A | --CZNV | 4
150 | 96 | AND AH, (SP:#i16) | bitwise AND on high byte of A and memory at address in SP plus 16-bit signed offset, result in high byte of A | --CZNV | 5
151 | 97 | AND AH, (DP:#i16) | bitwise AND on high byte of A and memory at address in DP plus 16-bit signed offset, result in high byte of A | --CZNV | 5
152 | 98 | AND AL, (SP) | bitwise AND on low byte of A and memory at address in SP, result in low byte of A | --CZNV | 2
153 | 99 | AND AL, (SP:#i8) | bitwise AND on low byte of A and memory at address in SP plus 8-bit signed offset, result in low byte of A | --CZNV | 4
154 | 9A | AND AL, (SP:#i16) | bitwise AND on low byte of A and memory at address in SP plus 16-bit signed offset, result in low byte of A | --CZNV | 5
155 | 9B | AND AL, (DP:#i16) | bitwise AND on low byte of A and memory at address in DP plus 16-bit signed offset, result in low byte of A | --CZNV | 5
156 | 9C | OR A, #i16 | bitwise OR on A and 16-bit immediate, result in A | --CZNV | 3
157 | 9D | OR A, X | bitwise OR on A and X, result in A | --CZNV | 2
158 | 9E | OR A, Y | bitwise OR on A and Y, result in A | --CZNV | 2
159 | 9F | OR A, (SP) | bitwise OR on A and memory at address in SP, result in A | --CZNV | 4
160 | A0 | OR A, (SP:#i8) | bitwise OR on A and memory at address in SP plus 8-bit signed offset, result in A | --CZNV | 5
161 | A1 | OR A, (SP:#i16) | bitwise OR on A and memory at address in SP plus 16-bit signed offset, result in A | --CZNV | 6
162 | A2 | OR A, (DP:#i16) | bitwise OR on A and memory at address in DP plus 16-bit signed offset, result in A | --CZNV | 6
163 | A3 | OR AH, (SP) | bitwise OR on high byte of A and memory at address in SP, result in high byte of A | --CZNV | 2
164 | A4 | OR AH, (SP:#i8) | bitwise OR on high byte of A and memory at address in SP plus 8-bit signed offset, result in high byte of A | --CZNV | 4
165 | A5 | OR AH, (SP:#i16) | bitwise OR on high byte of A and memory at address in SP plus 16-bit signed offset, result in high byte of A | --CZNV | 5
166 | A6 | OR AH, (DP:#i16) | bitwise OR on high byte of A and memory at address in DP plus 16-bit signed offset, result in high byte of A | --CZNV | 5
167 | A7 | OR AL, (SP) | bitwise OR on low byte of A and memory at address in SP, result in low byte of A | --CZNV | 2
168 | A8 | OR AL, (SP:#i8) | bitwise OR on low byte of A and memory at address in SP plus 8-bit signed offset, result in low byte of A | --CZNV | 4
169 | A9 | OR AL, (SP:#i16) | bitwise OR on low byte of A and memory at address in SP plus 16-bit signed offset, result in low byte of A | --CZNV | 5
170 | AA | OR AL, (DP:#i16) | bitwise OR on low byte of A and memory at address in DP plus 16-bit signed offset, result in low byte of A | --CZNV | 5
171 | AB | XOR A, #i16 | bitwise exclusive OR on A and 16-bit immediate, result in A | --CZNV | 3
172 | AC | XOR A, A | bitwise exclusive OR on A and A, result in A | --CZNV | 2
173 | AD | XOR A, X | bitwise exclusive OR on A and X, result in A | --CZNV | 2
174 | AE | XOR A, Y | bitwise exclusive OR on A and Y, result in A | --CZNV | 2
175 | AF | XOR X, X | bitwise exclusive OR on X and X, result in X | --CZNV | 2
176 | B0 | XOR Y, Y | bitwise exclusive OR on Y and Y, result in Y | --CZNV | 2
177 | B1 | SHL A | logical shift left of A | --CZNV | 2
178 | B2 | SHL X | logical shift left of X | --CZNV | 2
179 | B3 | SHL Y | logical shift left of Y | --CZNV | 2
180 | B4 | SHR A | logical shift right of A | --CZNV | 2
181 | B5 | SHR X | logical shift right of X | --CZNV | 2
182 | B6 | SHR Y | logical shift right of Y | --CZNV | 2
183 | B7 | SHL AH | logical shift left of high byte of A | --CZNV | 4
184 | B8 | SHL AL | logical shift left of low byte of A | --CZNV | 2
185 | B9 | SHR AH | logical shift right of high byte of A | --CZNV | 2
186 | BA | SHR AL | logical shift right of low byte of A | --CZNV | 3
187 | BB | ADC A, X | add with carry X to A | --CZNV | 2
188 | BC | ADC A, Y | add with carry Y to A | --CZNV | 2
189 | BD | SBC A, X | subtract with carry X from A | --CZNV | 2
190 | BE | SBC A, Y | subtract with carry Y from A | --CZNV | 2
191 | BF | ADD SP, #i8 | add 8-bit signed immediate to SP | --CZNV | 3
192 | C0 | ADD DP, #i8 | add 8-bit signed immediate to DP | --CZNV | 3
193 | C1 | ADD X, #i8 | add 8-bit signed immediate to X | --CZNV | 2
194 | C2 | ADD Y, #i8 | add 8-bit signed immediate to Y | --CZNV | 2
195 | C3 | PUSH AH | push high byte of A to stack | ------ | 3
196 | C4 | PUSH AL | push low byte of A to stack | ------ | 3
197 | C5 | CMP A, #i8 | compare A to 8-bit signed immediate, set flags | --CZNV | 2
198 | C6 | CMP A, #i16 | compare A to 16-bit signed immediate, set flags | --CZNV | 3
199 | C7 | CMP A, X | compare A to X, set flags | --CZNV | 2
200 | C8 | CMP A, Y | compare A to Y, set flags | --CZNV | 2
201 | C9 | CMP A, (SP) | compare A to memory at address in SP | --CZNV | 4
202 | CA | CMP A, (SP:#i8) | compare A to memory at address in SP plus 8-bit signed offset | --CZNV | 5
203 | CB | CMP A, (SP:#i16) | compare A to memory at address in SP plus 16-bit signed offset | --CZNV | 6
204 | CC | CMP A, (DP:#i16) | compare A to memory at address in DP plus 16-bit signed offset | --CZNV | 6
205 | CD | CMP AH, (SP) | compare high byte of A to memory at address in SP | --CZNV | 3
206 | CE | CMP AH, (SP:#i8) | compare high byte of A to memory at address in SP plus 8-bit signed offset | --CZNV | 5
207 | CF | CMP AH, (SP:#i16) | compare high byte of A to memory at address in SP plus 16-bit signed offset | --CZNV | 6
208 | D0 | CMP AH, (DP:#i16) | compare high byte of A to memory at address in DP plus 16-bit signed offset | --CZNV | 6
209 | D1 | CMP AL, (SP) | compare low byte of A to memory at address in SP | --CZNV | 2
210 | D2 | CMP AL, (SP:#i8) | compare low byte of A to memory at address in SP plus 8-bit signed offset | --CZNV | 4
211 | D3 | CMP AL, (SP:#i16) | compare low byte of A to memory at address in SP plus 16-bit signed offset | --CZNV | 5
212 | D4 | CMP AL, (DP:#i16) | compare low byte of A to memory at address in DP plus 16-bit signed offset | --CZNV | 5
213 | D5 | JE #i16 | jump if equal (offset relative to PC) | ------ | 3 /4
214 | D6 | JL #i16 | jump if lower (offset relative to PC) | ------ | 3 /4
215 | D7 | JLE #i16 | jump if lower or equal (offset relative to PC) | ------ | 3 /4
216 | D8 | JG #i16 | jump if greater (offset relative to PC) | ------ | 3 /4
217 | D9 | JGE #i16 | jump if greater or equal (offset relative to PC) | ------ | 3 /4
218 | DA | JZ #i16 | jump if zero (offset relative to PC) | ------ | 3 /4
219 | DB | JNE #i16 | jump if not equal (offset relative to PC) | ------ | 3 /4
220 | DC | JNZ #i16 | jump if not zero (offset relative to PC) | ------ | 3 /4
221 | DD | JC #i16 | jump if carry (offset relative to PC) | ------ | 3 /4
222 | DE | JNC #i16 | jump if not carry (offset relative to PC) | ------ | 3 /4
223 | DF | JN #i16 | jump if negative (offset relative to PC) | ------ | 3 /4
224 | E0 | JNN #i16 | jump if not negative (offset relative to PC) | ------ | 3 /4
225 | E1 | JV #i16 | jump if overflow (offset relative to PC) | ------ | 3 /4
226 | E2 | JNV #i16 | jump if not overflow (offset relative to PC) | ------ | 3 /4
227 | E3 | INC X | increase value of X | --CZNV | 1
228 | E4 | DEC X | decrease value of X | --CZNV | 1
229 | E5 | INC Y | increase value of Y | --CZNV | 1
230 | E6 | DEC Y | decrease value of Y | --CZNV | 1
231 | E7 | LD A, (DP) | load A with memory at address in DP | ------ | 4
232 | E8 | LD A, (DP:X) | load A with memory at address in DP plus 16-bit signed offset in X | ------ | 4
233 | E9 | LD A, (DP:Y) | load A with memory at address in DP plus 16-bit signed offset in Y | ------ | 4
234 | EA | ST (DP), A | store A in memory at address in DP | ------ | 4
235 | EB | ST (DP:X), A | store A in memory at address in DP plus 16-bit signed offset in X | ------ | 4
236 | EC | ST (DP:Y), A | store A in memory at address in DP plus 16-bit signed offset in Y | ------ | 4
237 | ED | LD AL, (DP) | load low byte of A with memory at address in DP | ------ | 2
238 | EE | ST (DP), AL | store low byte of A at address in DP | ------ | 2
239 | EF | push #i8 | push 8-bit immediate on stack | ------ | 3
240 | F0 | push #i16 | push 16-bit immediate on stack | ------ | 5
241 | F1 | ld dp, #i16 | load immediate to data pointer | ------ | 3
242 | F2 | ld sp, #i16 | load immediate to stack pointer | ------ | 3
243 | F3 | add ah, #i8 | add 8-bit immediate to high byte of A | ------ | 3
244 | F4 | add al, #i8 | add 8-bit immediate to low byte of A | ------ | 2
245 | F5 | sub ah, #i8 | subtract 8-bit immediate from high byte of A | ------ | 3
246 | F6 | sub al, #i8 | subtract 8-bit immediate from low byte of A | ------ | 2
247 | F7 | and ah, #i8 | bitwise AND on high byte of A and 8-bit immediate, result in low byte of A | --CZNV | 2
248 | F8 | and al, #i8 | bitwise AND on low byte of A and 8-bit immediate, result in low byte of A | --CZNV | 2
249 | F9 | or ah, #i8 | bitwise OR on high byte of A and 8-bit immediate, result in low byte of A | --CZNV | 2
250 | FA | or al, #i8 | bitwise OR on low byte of A and 8-bit immediate, result in low byte of A | --CZNV | 2
251 | FB | cmp ah, #i8 | compare high byte of A to 8-bit signed immediate | --CZNV | 3
252 | FC | cmp al, #i8 | compare low byte of A to 8-bit signed immediate | --CZNV | 2
253 | FD | STI | set interrupt enable flag | -I---- | 2
254 | FE | CLI | clear interrupt enable flag | -I---- | 2
255 | FF | SYSCALL | call a software interrupt | SI---- | 25
256 | 100 | n/a | IRQ #0 | SI---- | 25
257 | 101 | n/a | IRQ #1 | SI---- | 25
258 | 102 | n/a | IRQ #2 | SI---- | 25
259 | 103 | n/a | IRQ #3 | SI---- | 25
260 | 104 | n/a | IRQ #4 | SI---- | 25
261 | 105 | n/a | IRQ #5 | SI---- | 25
262 | 106 | n/a | IRQ #6 | SI---- | 25
263 | 107 | n/a | IRQ #7 | SI---- | 25
264 | 108 | n/a | fault #0 – illegal instruction / protection violation | SI---- | 25
265 | 109 | n/a | fault #1 – unused | SI---- | 25
266 | 10A | n/a | fault #2 – unused | SI---- | 25
267 | 10B | n/a | fault #3 – unused | SI---- | 25
268 | 10C | n/a | fault #4 – unused | SI---- | 25
269 | 10D | n/a | fault #5 – unused | SI---- | 25
270 | 10E | n/a | fault #6 – unused | SI---- | 25
271 | 10F | n/a | unreachable opcode – interrupt vector entry used for SYSCALL | SI---- | 25
