dpilawa/bytec/instructionset/instructionset_20130125.xls

# | opcode | mnemonic | semantics | flags set | cycles
0 | 00 | NOP | no operation; fetch next instruction | ------ | 1
1 | 01 | HALT | halt the machine; fetch self | ------ | 3
2 | 02 | MOV A, X | copy X to A | ------ | 1
3 | 03 | MOV A, Y | copy Y to A | ------ | 1
4 | 04 | MOV A, SP | copy SP to A | ------ | 2
5 | 05 | MOV A, DP | copy DP to A | ------ | 2
6 | 06 | MOV X, A | copy A to X | ------ | 1
7 | 07 | MOV X, Y | copy Y to X | ------ | 1
8 | 08 | MOV Y, A | copy A to Y | ------ | 1
9 | 09 | MOV Y, X | copy X to Y | ------ | 1
10 | 0A | MOV SP, A | copy A to SP | ------ | 1
11 | 0B | MOV DP, A | copy A to DP | ------ | 1
12 | 0C | MOV AL, MSW | copy machine status word to low byte of A | ------ | 1
13 | 0D | MOV MSW, AL | copy low byte of A to machine status word | SICZNV | 1
14 | 0E | MOVL AL, X | copy low byte of X to AL | ------ | 1
15 | 0F | MOVL AL, Y | copy low byte of Y to AL | ------ | 1
16 | 10 | PUSH A | push A to stack | ------ | 4
17 | 11 | PUSH X | push X to stack | ------ | 4
18 | 12 | PUSH Y | push Y to stack | ------ | 4
19 | 13 | PUSH AH | push high byte of A to stack | ------ | 3
20 | 14 | PUSH AL | push low byte of A to stack | ------ | 3
21 | 15 | PUSH SP | push SP to stack | ------ | 4
22 | 16 | PUSH DP | push DP to stack | ------ | 4
23 | 17 | PUSH PC | push PC to stack | ------ | 4
24 | 18 | POP A | pop A from stack | ------ | 3
25 | 19 | POP X | pop X from stack | ------ | 3
26 | 1A | POP Y | pop Y from stack | ------ | 3
27 | 1B | POP AH | pop high byte of A from stack | ------ | 2
28 | 1C | POP AL | pop low byte of A from stack | ------ | 2
29 | 1D | POP SP | pop SP from stack | ------ | 3
30 | 1E | POP DP | pop DP from stack | ------ | 3
31 | 1F | POP PC | pop PC from stack | ------ | 4
32 | 20 | JMP #i16 | unconditional jump (offset relative to PC) | ------ | 4
33 | 21 | CALL #i16 | push program counter to stack and jump to subroutine (offset relative to PC) | ------ | 7
34 | 22 | RET | return from subroutine (pop program counter from stack) | ------ | 4
35 | 23 | IRET | return from interrupt | SICZNV | 20
36 | 24 | CALL (SP) | push program counter to stack and jump to subroutine address on previous top of the stack | ------ | 8
37 | 25 | LD A, #i16 | load A with 16-bit immediate | ------ | 3
38 | 26 | LD A, (SP:#i8) | load A with memory at address in SP plus 8-bit signed offset | ------ | 5
39 | 27 | LD A, (SP:#i16) | load A with memory at address in SP plus 16-bit signed offset | ------ | 6
40 | 28 | LD A, (DP:#i16) | load A with memory at address in DP plus 16-bit signed offset | ------ | 6
41 | 29 | LD A, (A:#i16) | load A with memory at address in A plus 16-bit signed offset | ------ | 6
42 | 2A | LD A, (X:#i16) | load A with memory at address in X plus 16-bit signed offset | ------ | 6
43 | 2B | LD A, (Y:#i16) | load A with memory at address in Y plus 16-bit signed offset | ------ | 6
44 | 2C | LD X, #i16 | load X with 16-bit immediate | ------ | 3
45 | 2D | LD X, (SP:#i8) | load X with memory at address in SP plus 8-bit signed offset | ------ | 5
46 | 2E | LD X, (SP:#i16) | load X with memory at address in SP plus 16-bit signed offset | ------ | 6
47 | 2F | LD X, (DP:#i16) | load X with memory at address in DP plus 16-bit signed offset | ------ | 6
48 | 30 | LD X, (A:#i16) | load X with memory at address in A plus 16-bit signed offset | ------ | 6
49 | 31 | LD X, (X:#i16) | load X with memory at address in X plus 16-bit signed offset | ------ | 6
50 | 32 | LD X, (Y:#i16) | load X with memory at address in Y plus 16-bit signed offset | ------ | 6
51 | 33 | LD Y, #i16 | load Y with 16-bit immediate | ------ | 3
52 | 34 | LD Y, (SP:#i8) | load Y with memory at address in SP plus 8-bit signed offset | ------ | 5
53 | 35 | LD Y, (SP:#i16) | load Y with memory at address in SP plus 16-bit signed offset | ------ | 6
54 | 36 | LD Y, (DP:#i16) | load Y with memory at address in DP plus 16-bit signed offset | ------ | 6
55 | 37 | LD Y, (A:#i16) | load Y with memory at address in A plus 16-bit signed offset | ------ | 6
56 | 38 | LD Y, (X:#i16) | load Y with memory at address in X plus 16-bit signed offset | ------ | 6
57 | 39 | LD Y, (Y:#i16) | load Y with memory at address in Y plus 16-bit signed offset | ------ | 6
58 | 3A | LD AH, #i8 | load low byte of A with 8-bit immediate | ------ | 2
59 | 3B | LD AL, #i8 | load high byte of A with 8-bit immediate | ------ | 2
60 | 3C | LD AH, (SP:#i8) | load high byte of A with memory at address in SP plus 8-bit signed offset | ------ | 4
61 | 3D | LD AL, (SP:#i8) | load low byte of A with memory at address in SP plus 8-bit signed offset | ------ | 4
62 | 3E | LD AH, (SP:#i16) | load high byte of A with memory at address in SP plus 16-bit signed offset | ------ | 5
63 | 3F | LD AL, (SP:#i16) | load low byte of A with memory at address in SP plus 16-bit signed offset | ------ | 5
64 | 40 | LD AH, (DP:#i16) | load high byte of A with memory at address in DP plus 16-bit signed offset | ------ | 5
65 | 41 | LD AL, (DP:#i16) | load low byte of A with memory at address in DP plus 16-bit signed offset | ------ | 5
66 | 42 | LD AH, (X:#i16) | load high byte of A with memory at address in X plus 16-bit signed offset | ------ | 5
67 | 43 | LD AL, (X:#i16) | load low byte of A with memory at address in X plus 16-bit signed offset | ------ | 5
68 | 44 | LD AH, (Y:#i16) | load high byte of A with memory at address in Y plus 16-bit signed offset | ------ | 5
69 | 45 | LD AL, (Y:#i16) | load low byte of A with memory at address in Y plus 16-bit signed offset | ------ | 5
70 | 46 | ST (SP:#i8), A | store A in memory at address in SP plus 8-bit signed offset | ------ | 5
71 | 47 | ST (SP:#i16), A | store A in memory at address in SP plus 16-bit signed offset | ------ | 6
72 | 48 | ST (DP:#i16), A | store A in memory at address in DP plus 16-bit signed offset | ------ | 6
73 | 49 | ST (A:#i16), A | store A in memory at address in A plus 16-bit signed offset | ------ | 6
74 | 4A | ST (X:#i16), A | store A in memory at address in X plus 16-bit signed offset | ------ | 6
75 | 4B | ST (Y:#i16), A | store A in memory at address in Y plus 16-bit signed offset | ------ | 6
76 | 4C | ST (SP:#i8), X | store X in memory at address in SP plus 8-bit signed offset | ------ | 5
77 | 4D | ST (SP:#i16), X | store X in memory at address in SP plus 16-bit signed offset | ------ | 6
78 | 4E | ST (DP:#i16), X | store X in memory at address in DP plus 16-bit signed offset | ------ | 6
79 | 4F | ST (A:#i16), X | store X in memory at address in A plus 16-bit signed offset | ------ | 6
80 | 50 | ST (X:#i16), X | store X in memory at address in X plus 16-bit signed offset | ------ | 6
81 | 51 | ST (Y:#i16), X | store X in memory at address in Y plus 16-bit signed offset | ------ | 6
82 | 52 | ST (SP:#i8), Y | store Y in memory at address in SP plus 8-bit signed offset | ------ | 5
83 | 53 | ST (SP:#i16), Y | store Y in memory at address in SP plus 16-bit signed offset | ------ | 6
84 | 54 | ST (DP:#i16), Y | store Y in memory at address in DP plus 16-bit signed offset | ------ | 6
85 | 55 | ST (A:#i16), Y | store Y in memory at address in A plus 16-bit signed offset | ------ | 6
86 | 56 | ST (X:#i16), Y | store Y in memory at address in X plus 16-bit signed offset | ------ | 6
87 | 57 | ST (Y:#i16), Y | store Y in memory at address in Y plus 16-bit signed offset | ------ | 6
88 | 58 | ST (SP:#i8), AH | store high byte of A at address in SP plus 8-bit signed offset | ------ | 4
89 | 59 | ST (SP:#i8), AL | store low byte of A at address in SP plus 8-bit signed offset | ------ | 4
90 | 5A | ST (SP:#i16), AH | store high byte of A at address in SP plus 16-bit signed offset | ------ | 5
91 | 5B | ST (SP:#i16), AL | store low byte of A at address in SP plus 16-bit signed offset | ------ | 5
92 | 5C | ST (DP:#i16), AH | store high byte of A at address in DP plus 16-bit signed offset | ------ | 5
93 | 5D | ST (DP:#i16), AL | store low byte of A at address in DP plus 16-bit signed offset | ------ | 5
94 | 5E | ST (X:#i16), AH | store high byte of A at address in X plus 16-bit signed offset | ------ | 5
95 | 5F | ST (X:#i16), AL | store low byte of A at address in X plus 16-bit signed offset | ------ | 5
96 | 60 | ST (Y:#i16), AH | store high byte of A at address in Y plus 16-bit signed offset | ------ | 5
97 | 61 | ST (Y:#i16), AL | store low byte of A at address in Y plus 16-bit signed offset | ------ | 5
98 | 62 | ADD A, #i16 | add 16-bit signed immediate to A | --CZNV | 3
99 | 63 | ADD A, X | add X to A | --CZNV | 2
100 | 64 | ADD A, Y | add Y to A | --CZNV | 2
101 | 65 | ADD A, (SP:#i8) | add memory at address in SP plus 8-bit signed offset to A | --CZNV | 5
102 | 66 | ADD A, (SP:#i16) | add memory at address in SP plus 16-bit signed offset to A | --CZNV | 6
103 | 67 | ADD A, (DP:#i16) | add memory at address in DP plus 16-bit signed offset to A | --CZNV | 6
104 | 68 | ADD A, (A:#i16) | add memory at address in A plus 16-bit signed offset to A | --CZNV | 6
105 | 69 | ADD A, (X:#i16) | add memory at address in X plus 16-bit signed offset to A | --CZNV | 6
106 | 6A | ADD A, (Y:#i16) | add memory at address in Y plus 16-bit signed offset to A | --CZNV | 6
107 | 6B | ADD X, #i16 | add 16-bit signed immediate to X | --CZNV | 3
108 | 6C | ADD X, A | add A to X | --CZNV | 2
109 | 6D | ADD X, Y | add Y to X | --CZNV | 2
110 | 6E | ADD X, (SP:#i8) | add memory at address in SP plus 8-bit signed offset to X | --CZNV | 5
111 | 6F | ADD X, (SP:#i16) | add memory at address in SP plus 16-bit signed offset to X | --CZNV | 6
112 | 70 | ADD X, (DP:#i16) | add memory at address in DP plus 16-bit signed offset to X | --CZNV | 6
113 | 71 | ADD X, (A:#i16) | add memory at address in A plus 16-bit signed offset to X | --CZNV | 6
114 | 72 | ADD X, (X:#i16) | add memory at address in X plus 16-bit signed offset to X | --CZNV | 6
115 | 73 | ADD X, (Y:#i16) | add memory at address in Y plus 16-bit signed offset to X | --CZNV | 6
116 | 74 | ADD Y, #i16 | add 16-bit signed immediate to Y | --CZNV | 3
117 | 75 | ADD Y, A | add A to Y | --CZNV | 2
118 | 76 | ADD Y, X | add X to Y | --CZNV | 2
119 | 77 | ADD Y, (SP:#i8) | add memory at address in SP plus 8-bit signed offset to Y | --CZNV | 5
120 | 78 | ADD Y, (SP:#i16) | add memory at address in SP plus 16-bit signed offset to Y | --CZNV | 6
121 | 79 | ADD Y, (DP:#i16) | add memory at address in DP plus 16-bit signed offset to Y | --CZNV | 6
122 | 7A | ADD Y, (A:#i16) | add memory at address in A plus 16-bit signed offset to Y | --CZNV | 6
123 | 7B | ADD Y, (X:#i16) | add memory at address in X plus 16-bit signed offset to Y | --CZNV | 6
124 | 7C | ADD Y, (Y:#i16) | add memory at address in Y plus 16-bit signed offset to Y | --CZNV | 6
125 | 7D | ADD AH, #i8 | add 8-bit immediate to high byte of A | --CZNV | 3
126 | 7E | ADD AL, #i8 | add 8-bit immediate to low byte of A | --CZNV | 2
127 | 7F | ADD AH, (SP:#i16) | add memory at address in SP plus 16-bit signed offset to high byte of A | --CZNV | 6
128 | 80 | ADD AL, (SP:#i16) | add memory at address in SP plus 16-bit signed offset to low byte of A | --CZNV | 5
129 | 81 | ADD AH, (DP:#i16) | add memory at address in DP plus 16-bit signed offset to high byte of A | --CZNV | 6
130 | 82 | ADD AL, (DP:#i16) | add memory at address in DP plus 16-bit signed offset to low byte of A | --CZNV | 5
131 | 83 | ADD AH, (X:#i16) | add memory at address in X plus 16-bit signed offset to high byte of A | --CZNV | 6
132 | 84 | ADD AL, (X:#i16) | add memory at address in X plus 16-bit signed offset to low byte of A | --CZNV | 5
133 | 85 | ADD AH, (Y:#i16) | add memory at address in Y plus 16-bit signed offset to high byte of A | --CZNV | 6
134 | 86 | ADD AL, (Y:#i16) | add memory at address in Y plus 16-bit signed offset to low byte of A | --CZNV | 5
135 | 87 | SUB A, #i16 | subtract 16-bit signed immediate from A | --CZNV | 3
136 | 88 | SUB A, X | subtract X from A | --CZNV | 2
137 | 89 | SUB A, Y | subtract Y from A | --CZNV | 2
138 | 8A | SUB A, (SP:#i8) | subtract memory at address in SP plus 8-bit signed offset from A | --CZNV | 5
139 | 8B | SUB A, (SP:#i16) | subtract memory at address in SP plus 16-bit signed offset from A | --CZNV | 6
140 | 8C | SUB A, (DP:#i16) | subtract memory at address in DP plus 16-bit signed offset from A | --CZNV | 6
141 | 8D | SUB A, (A:#i16) | subtract memory at address in A plus 16-bit signed offset from A | --CZNV | 6
142 | 8E | SUB A, (X:#i16) | subtract memory at address in X plus 16-bit signed offset from A | --CZNV | 6
143 | 8F | SUB A, (Y:#i16) | subtract memory at address in Y plus 16-bit signed offset from A | --CZNV | 6
144 | 90 | SUB X, #i16 | subtract 16-bit signed immediate from X | --CZNV | 3
145 | 91 | SUB X, A | subtract A from X | --CZNV | 2
146 | 92 | SUB X, Y | subtract Y from X | --CZNV | 2
147 | 93 | SUB X, (SP:#i8) | subtract memory at address in SP plus 8-bit signed offset from X | --CZNV | 5
148 | 94 | SUB X, (SP:#i16) | subtract memory at address in SP plus 16-bit signed offset from X | --CZNV | 6
149 | 95 | SUB X, (DP:#i16) | subtract memory at address in DP plus 16-bit signed offset from X | --CZNV | 6
150 | 96 | SUB X, (A:#i16) | subtract memory at address in A plus 16-bit signed offset from X | --CZNV | 6
151 | 97 | SUB X, (X:#i16) | subtract memory at address in X plus 16-bit signed offset from X | --CZNV | 6
152 | 98 | SUB X, (Y:#i16) | subtract memory at address in Y plus 16-bit signed offset from X | --CZNV | 6
153 | 99 | SUB Y, #i16 | subtract 16-bit signed immediate from Y | --CZNV | 3
154 | 9A | SUB Y, A | subtract A from Y | --CZNV | 2
155 | 9B | SUB Y, X | subtract X from Y | --CZNV | 2
156 | 9C | SUB Y, (SP:#i8) | subtract memory at address in SP plus 8-bit signed offset from Y | --CZNV | 5
157 | 9D | SUB Y, (SP:#i16) | subtract memory at address in SP plus 16-bit signed offset from Y | --CZNV | 6
158 | 9E | SUB Y, (DP:#i16) | subtract memory at address in DP plus 16-bit signed offset from Y | --CZNV | 6
159 | 9F | SUB Y, (A:#i16) | subtract memory at address in A plus 16-bit signed offset from Y | --CZNV | 6
160 | A0 | SUB Y, (X:#i16) | subtract memory at address in X plus 16-bit signed offset from Y | --CZNV | 6
161 | A1 | SUB Y, (Y:#i16) | subtract memory at address in Y plus 16-bit signed offset from Y | --CZNV | 6
162 | A2 | SUB AH, #i8 | subtract 8-bit immediate from high byte of A | --CZNV | 3
163 | A3 | SUB AL, #i8 | subtract 8-bit immediate from low byte of A | --CZNV | 2
164 | A4 | SUB AH, (SP:#i16) | subtract memory at address in SP plus 16-bit signed offset from high byte of A | --CZNV | 6
165 | A5 | SUB AL, (SP:#i16) | subtract memory at address in SP plus 16-bit signed offset from low byte of A | --CZNV | 5
166 | A6 | SUB AH, (DP:#i16) | subtract memory at address in DP plus 16-bit signed offset from high byte of A | --CZNV | 6
167 | A7 | SUB AL, (DP:#i16) | subtract memory at address in DP plus 16-bit signed offset from low byte of A | --CZNV | 5
168 | A8 | SUB AH, (X:#i16) | subtract memory at address in X plus 16-bit signed offset from high byte of A | --CZNV | 6
169 | A9 | SUB AL, (X:#i16) | subtract memory at address in X plus 16-bit signed offset from low byte of A | --CZNV | 5
170 | AA | SUB AH, (Y:#i16) | subtract memory at address in Y plus 16-bit signed offset from high byte of A | --CZNV | 6
171 | AB | SUB AL, (Y:#i16) | subtract memory at address in Y plus 16-bit signed offset from low byte of A | --CZNV | 5
172 | AC | AND A, #i16 | bitwise AND on A and 16-bit immediate, result in A | --CZNV | 3
173 | AD | AND A, X | bitwise AND on A and X, result in A | --CZNV | 2
174 | AE | AND A, Y | bitwise AND on A and Y, result in A | --CZNV | 2
175 | AF | AND A, (SP:#i16) | bitwise AND on A and memory at address in SP plus 16-bit signed offset, result in A | --CZNV | 6
176 | B0 | AND A, (DP:#i16) | bitwise AND on A and memory at address in DP plus 16-bit signed offset, result in A | --CZNV | 6
177 | B1 | AND AH, #i8 | bitwise AND on high byte of A and 8-bit immediate, result in low byte of A | --CZNV | 2
178 | B2 | AND AL, #i8 | bitwise AND on low byte of A and 8-bit immediate, result in low byte of A | --CZNV | 2
179 | B3 | AND AH, (SP:#i16) | bitwise AND on high byte of A and memory at address in SP plus 16-bit signed offset, result in high byte of A | --CZNV | 5
180 | B4 | AND AL, (SP:#i16) | bitwise AND on low byte of A and memory at address in SP plus 16-bit signed offset, result in low byte of A | --CZNV | 5
181 | B5 | AND AH, (DP:#i16) | bitwise AND on high byte of A and memory at address in DP plus 16-bit signed offset, result in high byte of A | --CZNV | 5
182 | B6 | AND AL, (DP:#i16) | bitwise AND on low byte of A and memory at address in DP plus 16-bit signed offset, result in low byte of A | --CZNV | 5
183 | B7 | OR A, #i16 | bitwise OR on A and 16-bit immediate, result in A | --CZNV | 3
184 | B8 | OR A, X | bitwise OR on A and X, result in A | --CZNV | 2
185 | B9 | OR A, Y | bitwise OR on A and Y, result in A | --CZNV | 2
186 | BA | OR A, (SP:#i16) | bitwise OR on A and memory at address in SP plus 16-bit signed offset, result in A | --CZNV | 6
187 | BB | OR A, (DP:#i16) | bitwise OR on A and memory at address in DP plus 16-bit signed offset, result in A | --CZNV | 6
188 | BC | OR AH, #i8 | bitwise OR on high byte of A and 8-bit immediate, result in low byte of A | --CZNV | 2
189 | BD | OR AL, #i8 | bitwise OR on low byte of A and 8-bit immediate, result in low byte of A | --CZNV | 2
190 | BE | OR AH, (SP:#i16) | bitwise OR on high byte of A and memory at address in SP plus 16-bit signed offset, result in high byte of A | --CZNV | 5
191 | BF | OR AL, (SP:#i16) | bitwise OR on low byte of A and memory at address in SP plus 16-bit signed offset, result in low byte of A | --CZNV | 5
192 | C0 | OR AH, (DP:#i16) | bitwise OR on high byte of A and memory at address in DP plus 16-bit signed offset, result in high byte of A | --CZNV | 5
193 | C1 | OR AL, (DP:#i16) | bitwise OR on low byte of A and memory at address in DP plus 16-bit signed offset, result in low byte of A | --CZNV | 5
194 | C2 | XOR A, #i16 | bitwise XOR on A and 16-bit immediate, result in A | --CZNV | 3
195 | C3 | XOR A, X | bitwise XOR on A and X, result in A | --CZNV | 2
196 | C4 | XOR A, Y | bitwise XOR on A and Y, result in A | --CZNV | 2
197 | C5 | XOR A, (SP:#i16) | bitwise XOR on A and memory at address in SP plus 16-bit signed offset, result in A | --CZNV | 6
198 | C6 | XOR A, (DP:#i16) | bitwise XOR on A and memory at address in DP plus 16-bit signed offset, result in A | --CZNV | 6
199 | C7 | XOR AH, #i8 | bitwise XOR on high byte of A and 8-bit immediate, result in low byte of A | --CZNV | 2
200 | C8 | XOR AL, #i8 | bitwise XOR on low byte of A and 8-bit immediate, result in low byte of A | --CZNV | 2
201 | C9 | XOR AH, (SP:#i16) | bitwise XOR on high byte of A and memory at address in SP plus 16-bit signed offset, result in high byte of A | --CZNV | 5
202 | CA | XOR AL, (SP:#i16) | bitwise XOR on low byte of A and memory at address in SP plus 16-bit signed offset, result in low byte of A | --CZNV | 5
203 | CB | XOR AH, (DP:#i16) | bitwise XOR on high byte of A and memory at address in DP plus 16-bit signed offset, result in high byte of A | --CZNV | 5
204 | CC | XOR AL, (DP:#i16) | bitwise XOR on low byte of A and memory at address in DP plus 16-bit signed offset, result in low byte of A | --CZNV | 5
205 | CD | SEX A | sign extend A (low 8 bits to 16 bits) | --CZNV | 2
206 | CE | SHL A | logical shift left of A | --CZNV | 2
207 | CF | SHR A | logical shift right of A | --CZNV | 1
208 | D0 | SHL AH | logical shift left of high byte of A | --CZNV | 2
209 | D1 | SHL AL | logical shift left of low byte of A | --CZNV | 2
210 | D2 | SHR AH | logical shift right of high byte of A | --CZNV | 1
211 | D3 | SHR AL | logical shift right of low byte of A | --CZNV | 1
212 | D4 | ADC A, X | add with carry X to A | --CZNV | 2
213 | D5 | ADC A, Y | add with carry Y to A | --CZNV | 2
214 | D6 | SBC A, X | subtract with carry X from A | --CZNV | 2
215 | D7 | SBC A, Y | subtract with carry Y from A | --CZNV | 2
216 | D8 | ADD SP, #i16 | Add 16-bit signed immediate to SP | --CZNV | 4
217 | D9 | CMP A, #i16 | compare A to 16-bit signed immediate, set flags | --CZNV | 3
218 | DA | CMP A, X | compare A to X, set flags | --CZNV | 2
219 | DB | CMP A, Y | compare A to Y, set flags | --CZNV | 2
220 | DC | CMP A, (SP:#i16) | compare A to memory at address in SP plus 16-bit signed offset | --CZNV | 6
221 | DD | CMP A, (DP:#i16) | compare A to memory at address in DP plus 16-bit signed offset | --CZNV | 6
222 | DE | CMP AH, #i8 | compare AH to 8-bit signed immediate, set flags | --CZNV | 3
223 | DF | CMP AH, (SP:#i16) | compare high byte of A to memory at address in SP plus 16-bit signed offset | --CZNV | 6
224 | E0 | CMP AH, (DP:#i16) | compare high byte of A to memory at address in DP plus 16-bit signed offset | --CZNV | 6
225 | E1 | CMP AL, #i8 | compare AL to 8-bit signed immediate, set flags | --CZNV | 2
226 | E2 | CMP AL, (SP:#i16) | compare low byte of A to memory at address in SP plus 16-bit signed offset | --CZNV | 5
227 | E3 | CMP AL, (DP:#i16) | compare low byte of A to memory at address in DP plus 16-bit signed offset | --CZNV | 5
228 | E4 | JE #i16 | jump if equal (offset relative to PC) | ------ | 3 /4
229 | E5 | JNE #i16 | jump if not equal (offset relative to PC) | ------ | 3 /4
230 | E6 | JL #i16 | jump if lower (offset relative to PC) | ------ | 3 /4
231 | E7 | JLE #i16 | jump if lower or equal (offset relative to PC) | ------ | 3 /4
232 | E8 | JG #i16 | jump if greater (offset relative to PC) | ------ | 3 /4
233 | E9 | JGE #i16 | jump if greater or equal (offset relative to PC) | ------ | 3 /4
234 | EA | JLU #i16 | jump if lower unsigned (offset relative to PC) | ------ | 3 /4
235 | EB | JLEU #i16 | jump if lower or equal unsigned (offset relative to PC) | ------ | 3 /4
236 | EC | JGU #i16 | jump if greater unsigned (offset relative to PC) | ------ | 3 /4
237 | ED | JGEU #i16 | jump if greater or equal unsigned (offset relative to PC) | ------ | 3 /4
238 | EE | JZ #i16 | jump if zero (offset relative to PC) | ------ | 3 /4
239 | EF | JNZ #i16 | jump if not zero (offset relative to PC) | ------ | 3 /4
240 | F0 | JC #i16 | jump if carry (offset relative to PC) | ------ | 3 /4
241 | F1 | JNC #i16 | jump if not carry (offset relative to PC) | ------ | 3 /4
242 | F2 | JN #i16 | jump if negative (offset relative to PC) | ------ | 3 /4
243 | F3 | JNN #i16 | jump if not negative (offset relative to PC) | ------ | 3 /4
244 | F4 | JV #i16 | jump if overflow (offset relative to PC) | ------ | 3 /4
245 | F5 | JNV #i16 | jump if not overflow (offset relative to PC) | ------ | 3 /4
246 | F6 | LEA A, (DP:#i16) | load effective address in SP plus 16-bit signed offset to A | ------ | 4
247 | F7 | LEA A, (SP:#i16) | load effective address in DP plus 16-bit signed offset to A | ------ | 4
248 | F8 | LEA X, (DP:#i16) | load effective address in SP plus 16-bit signed offset to X | ------ | 4
249 | F9 | LEA X, (SP:#i16) | load effective address in DP plus 16-bit signed offset to X | ------ | 4
250 | FA | LEA Y, (DP:#i16) | load effective address in SP plus 16-bit signed offset to Y | ------ | 4
251 | FB | LEA Y, (SP:#i16) | load effective address in DP plus 16-bit signed offset to Y | ------ | 4
252 | FC
253 | FD | STI | set interrupt enable flag | -I---- | 2
254 | FE | CLI | clear interrupt enable flag | -I---- | 2
255 | FF | SYSCALL #i8 | call a system interrupt | SI---- | 32
256 | 100 | n/a | IRQ #0 | SI---- | 25
257 | 101 | n/a | IRQ #1 | SI---- | 25
258 | 102 | n/a | IRQ #2 | SI---- | 25
259 | 103 | n/a | IRQ #3 | SI---- | 25
260 | 104 | n/a | IRQ #4 | SI---- | 25
261 | 105 | n/a | IRQ #5 | SI---- | 25
262 | 106 | n/a | IRQ #6 | SI---- | 25
263 | 107 | n/a | IRQ #7 | SI---- | 25
264 | 108 | n/a | fault #0 – illegal instruction / protection violation | SI---- | 25
265 | 109 | n/a | fault #1 – unused | SI---- | 25
266 | 10A | n/a | fault #2 – unused | SI---- | 25
267 | 10B | n/a | fault #3 – unused | SI---- | 25
268 | 10C | n/a | fault #4 – unused | SI---- | 25
269 | 10D | n/a | fault #5 – unused | SI---- | 25
270 | 10E | n/a | fault #6 – unused | SI---- | 25
271 | 10F | n/a | unreachable opcode – interrupt vector entry used for SYSCALL | SI---- | 25
