dpilawa/bytec/schematics/schematics_20100606.pdf

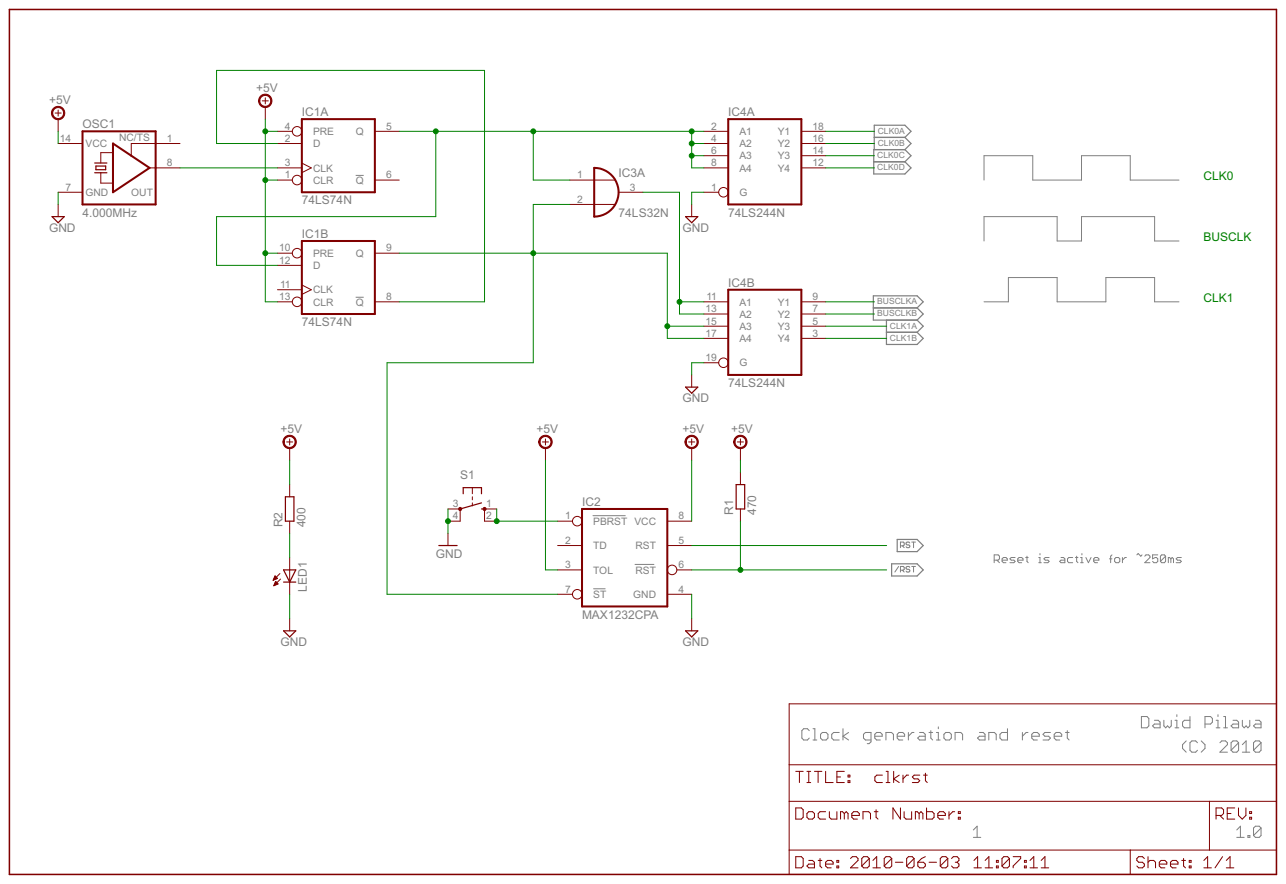
[picture p4: page 1]

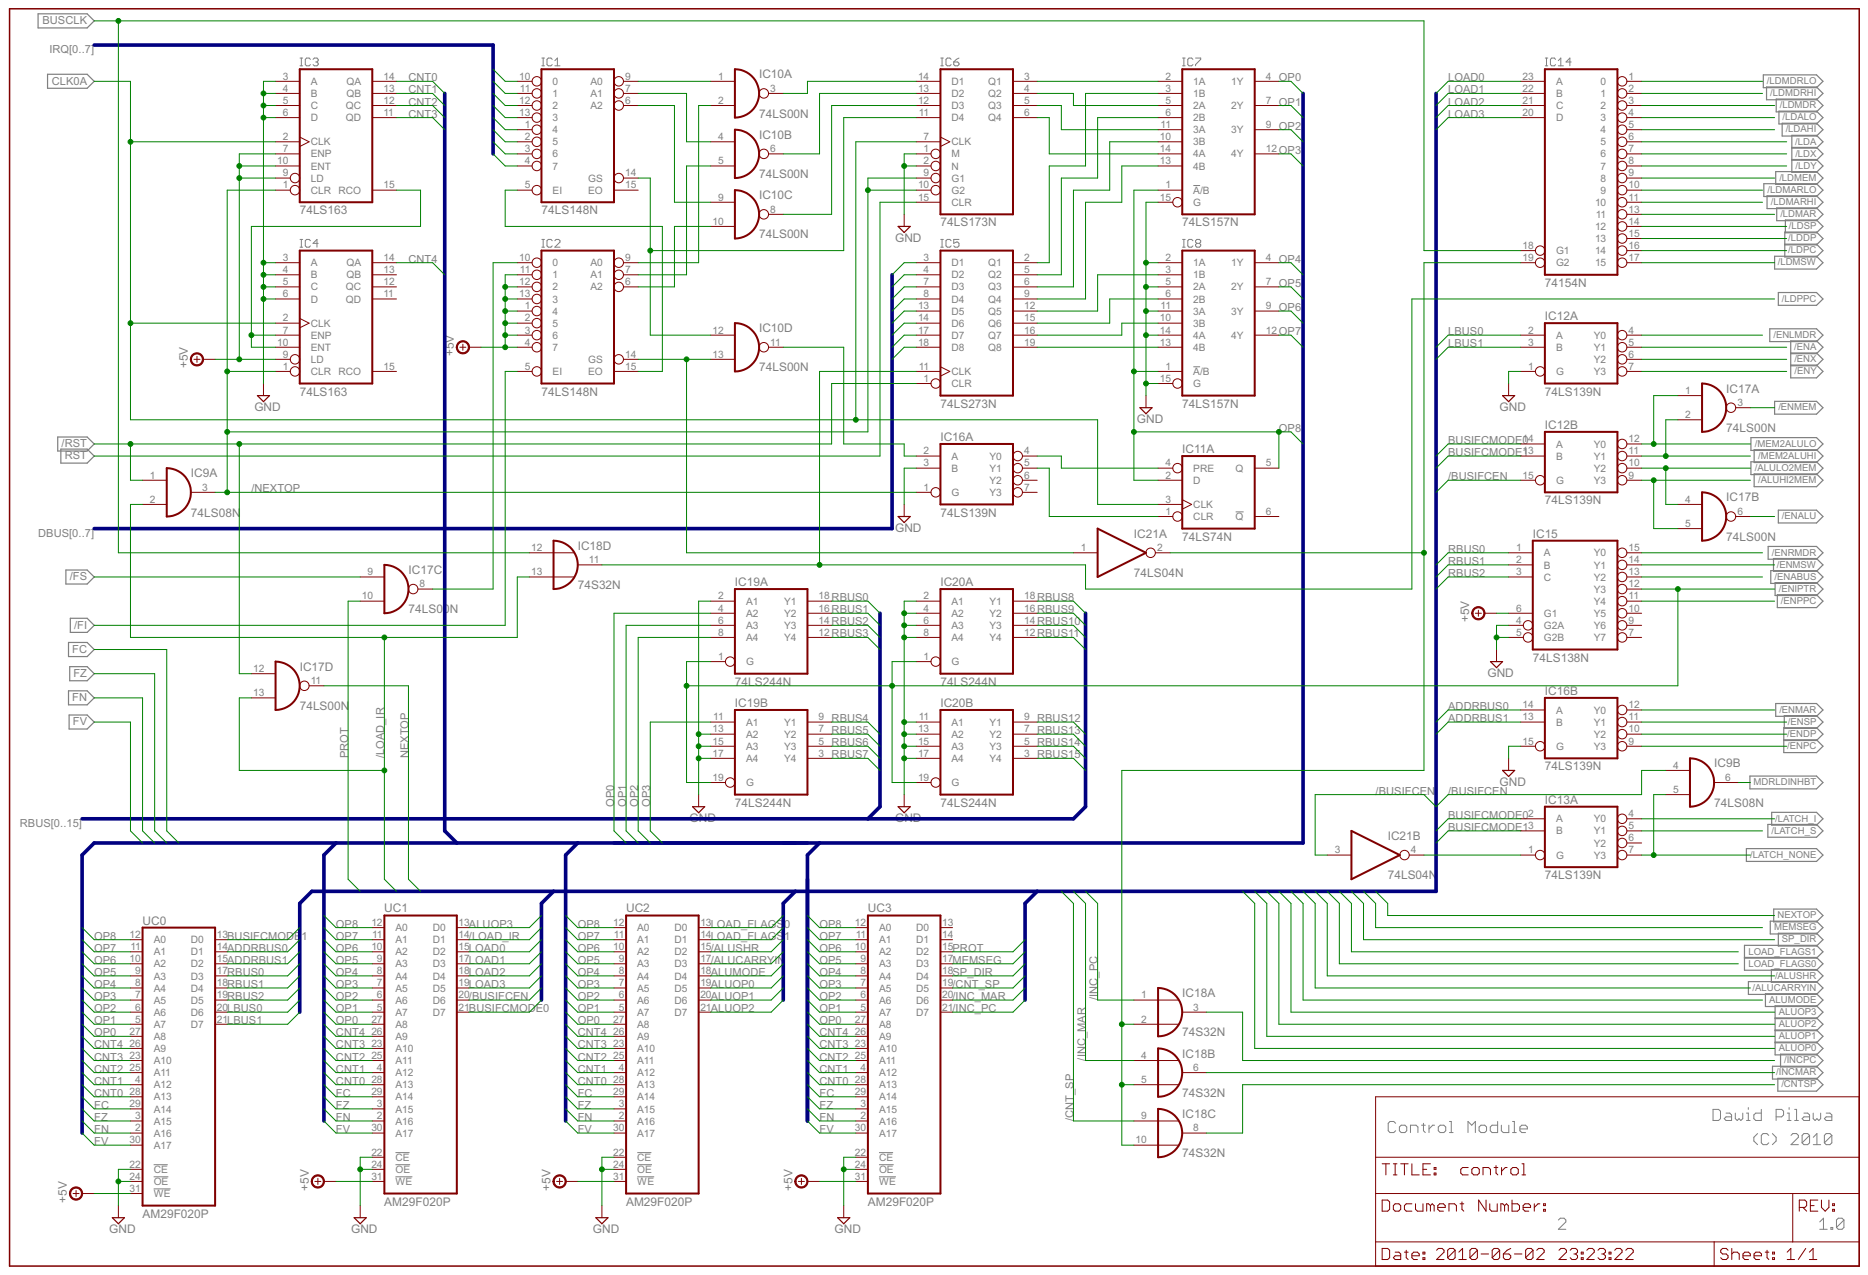
[picture p5: page 2]

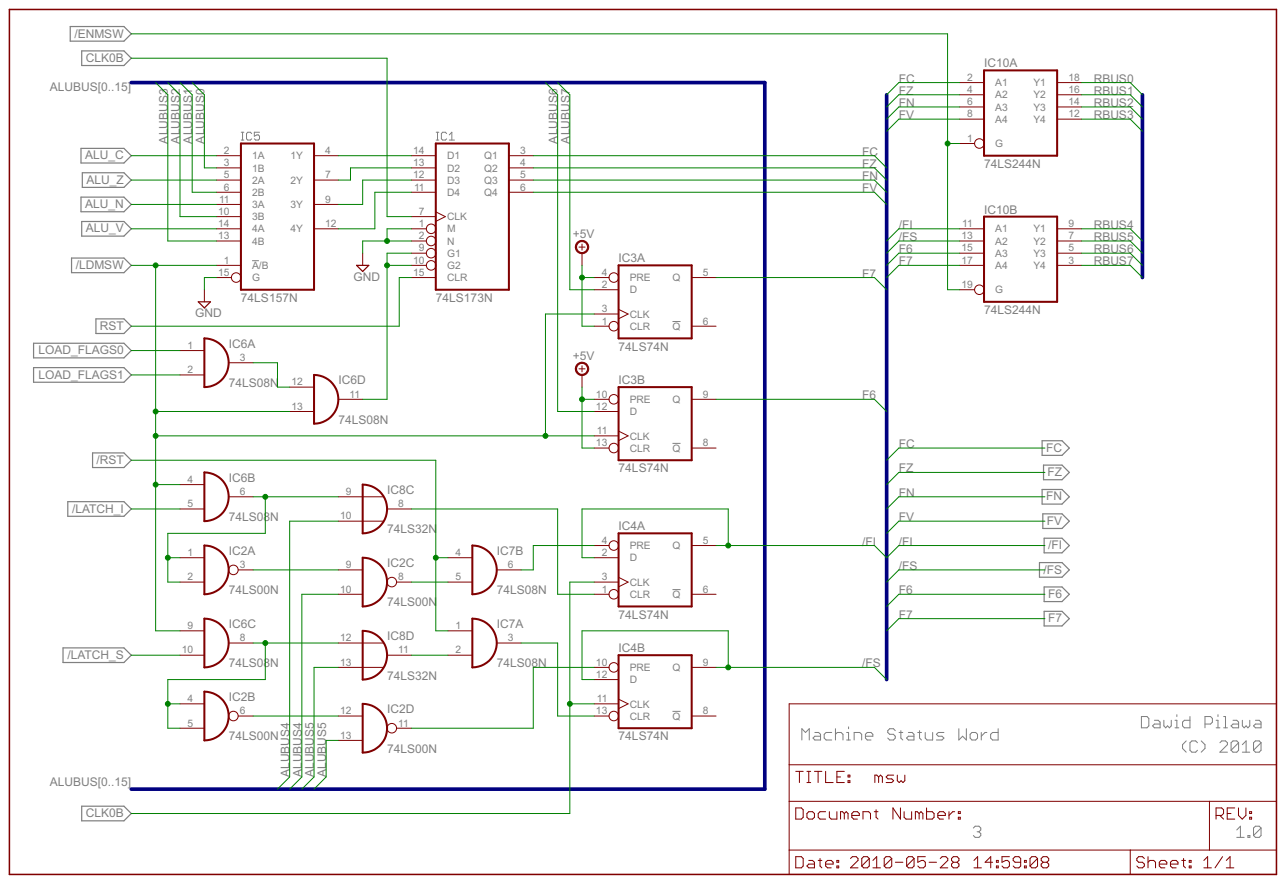
[picture p6: page 3]

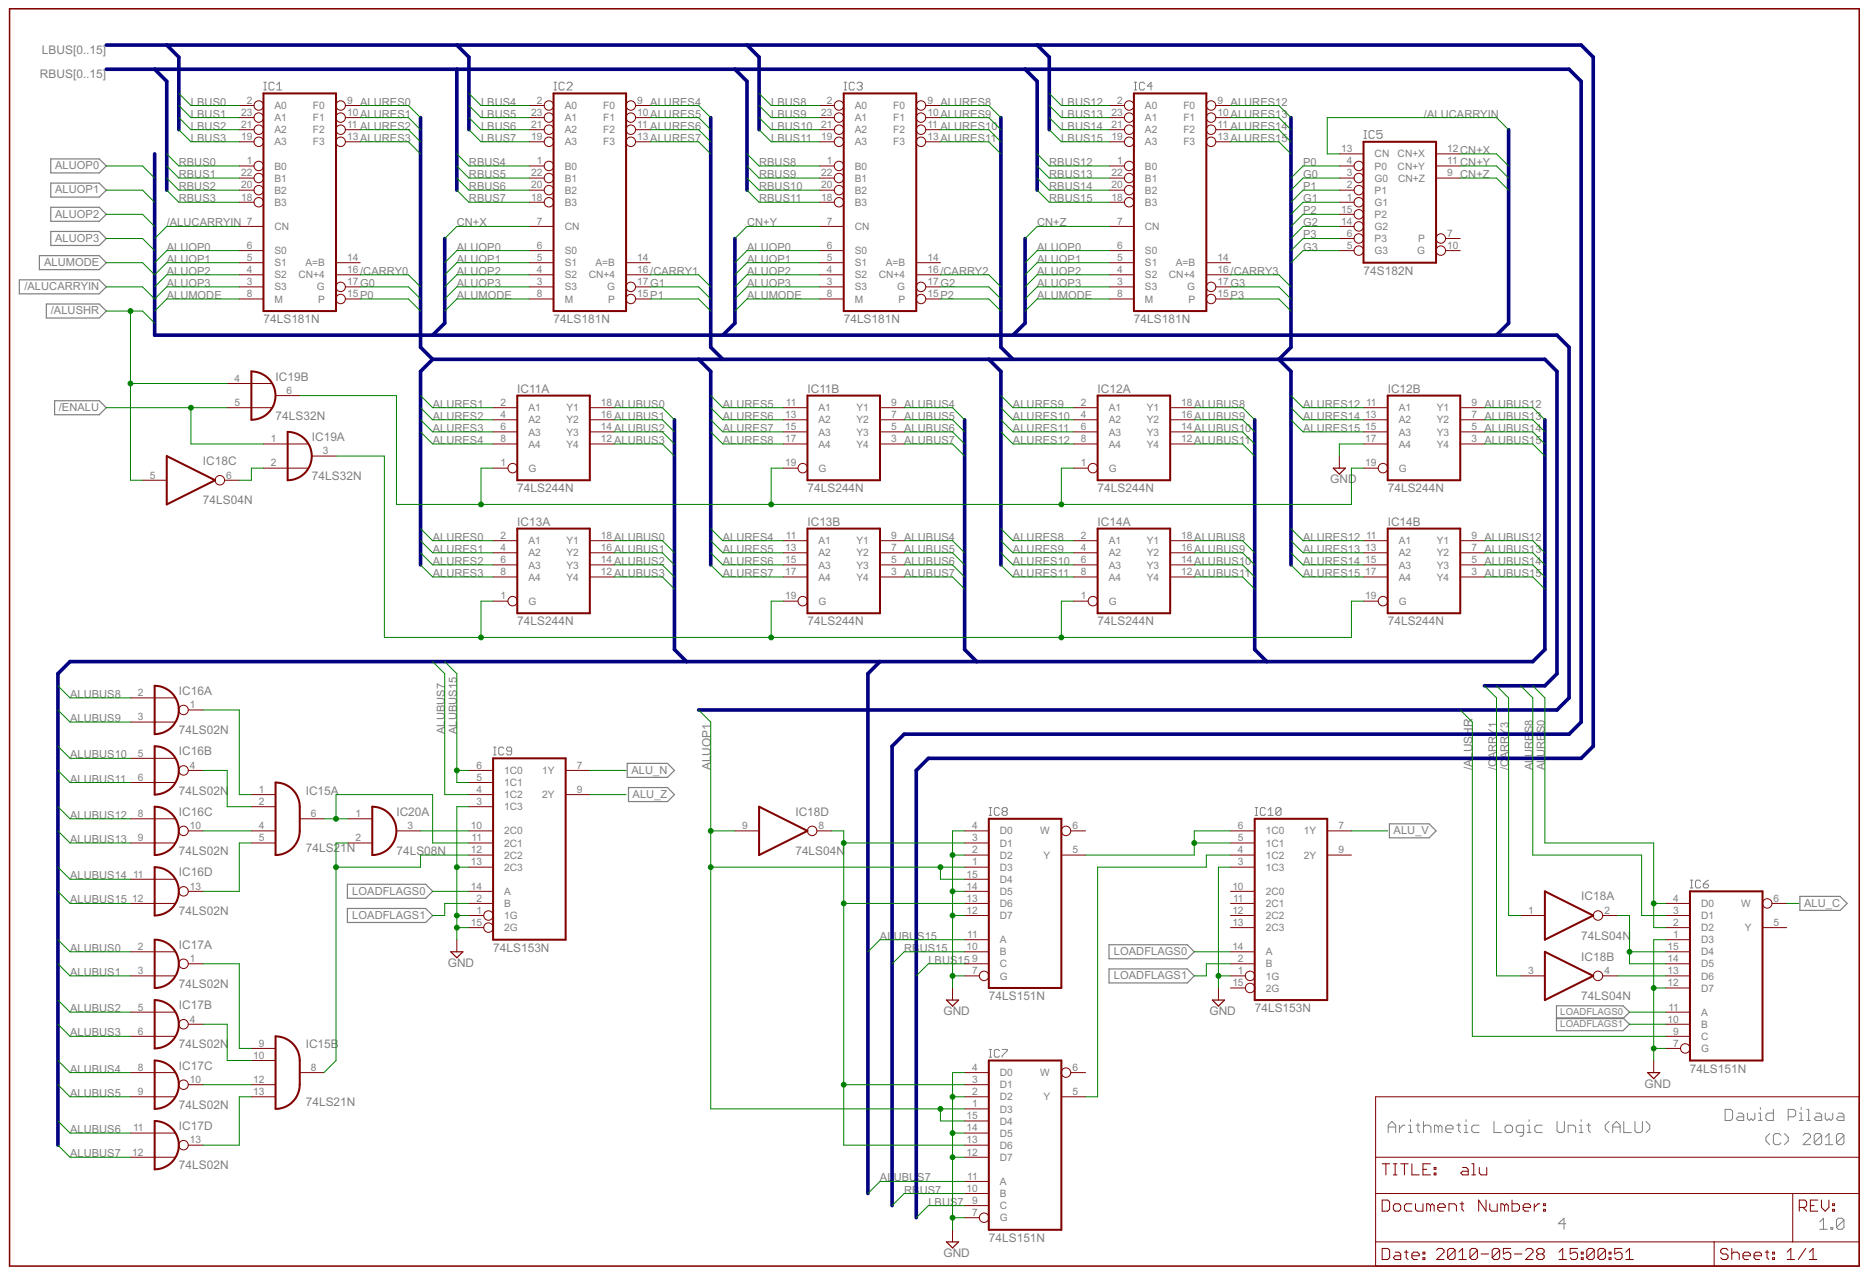
[picture p7: page 4]

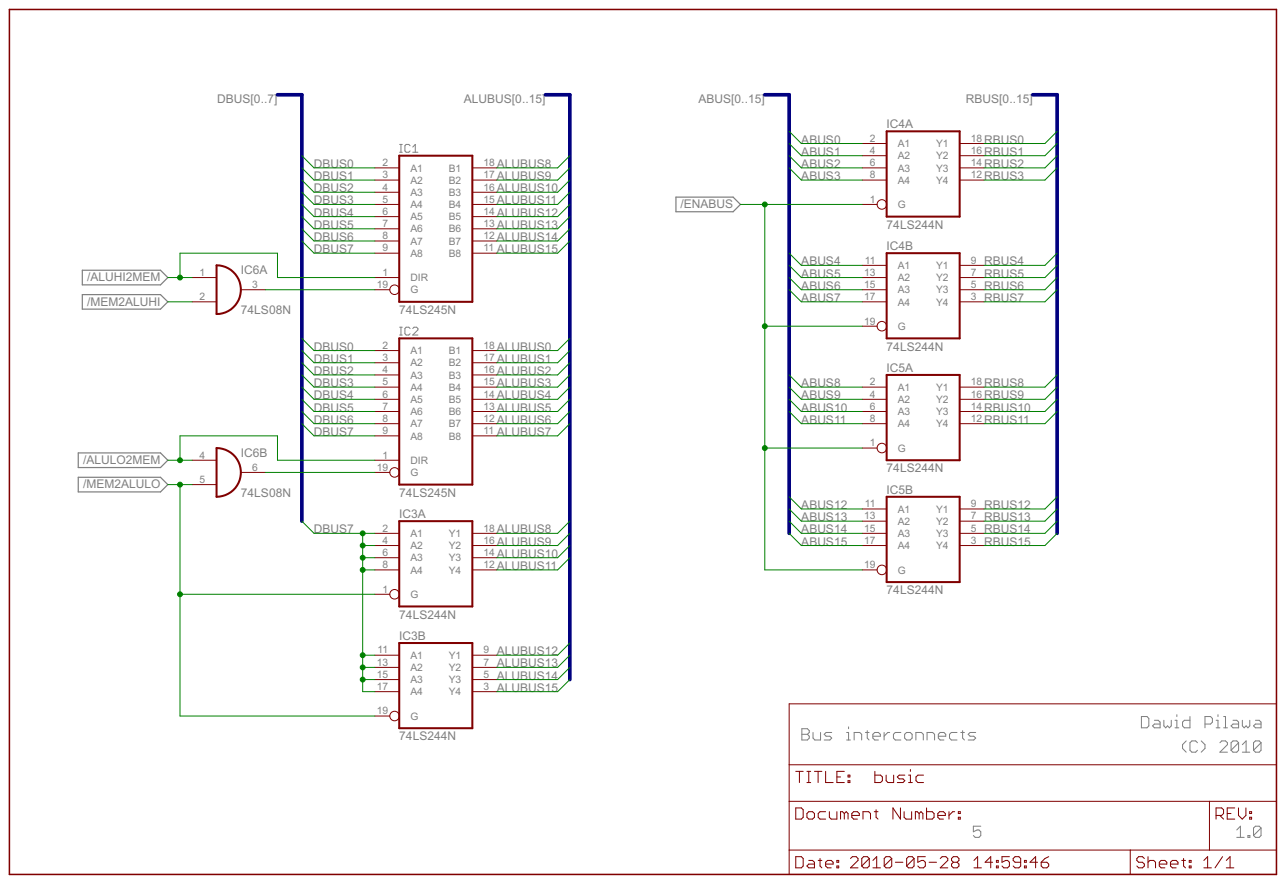
[picture p8: page 5]

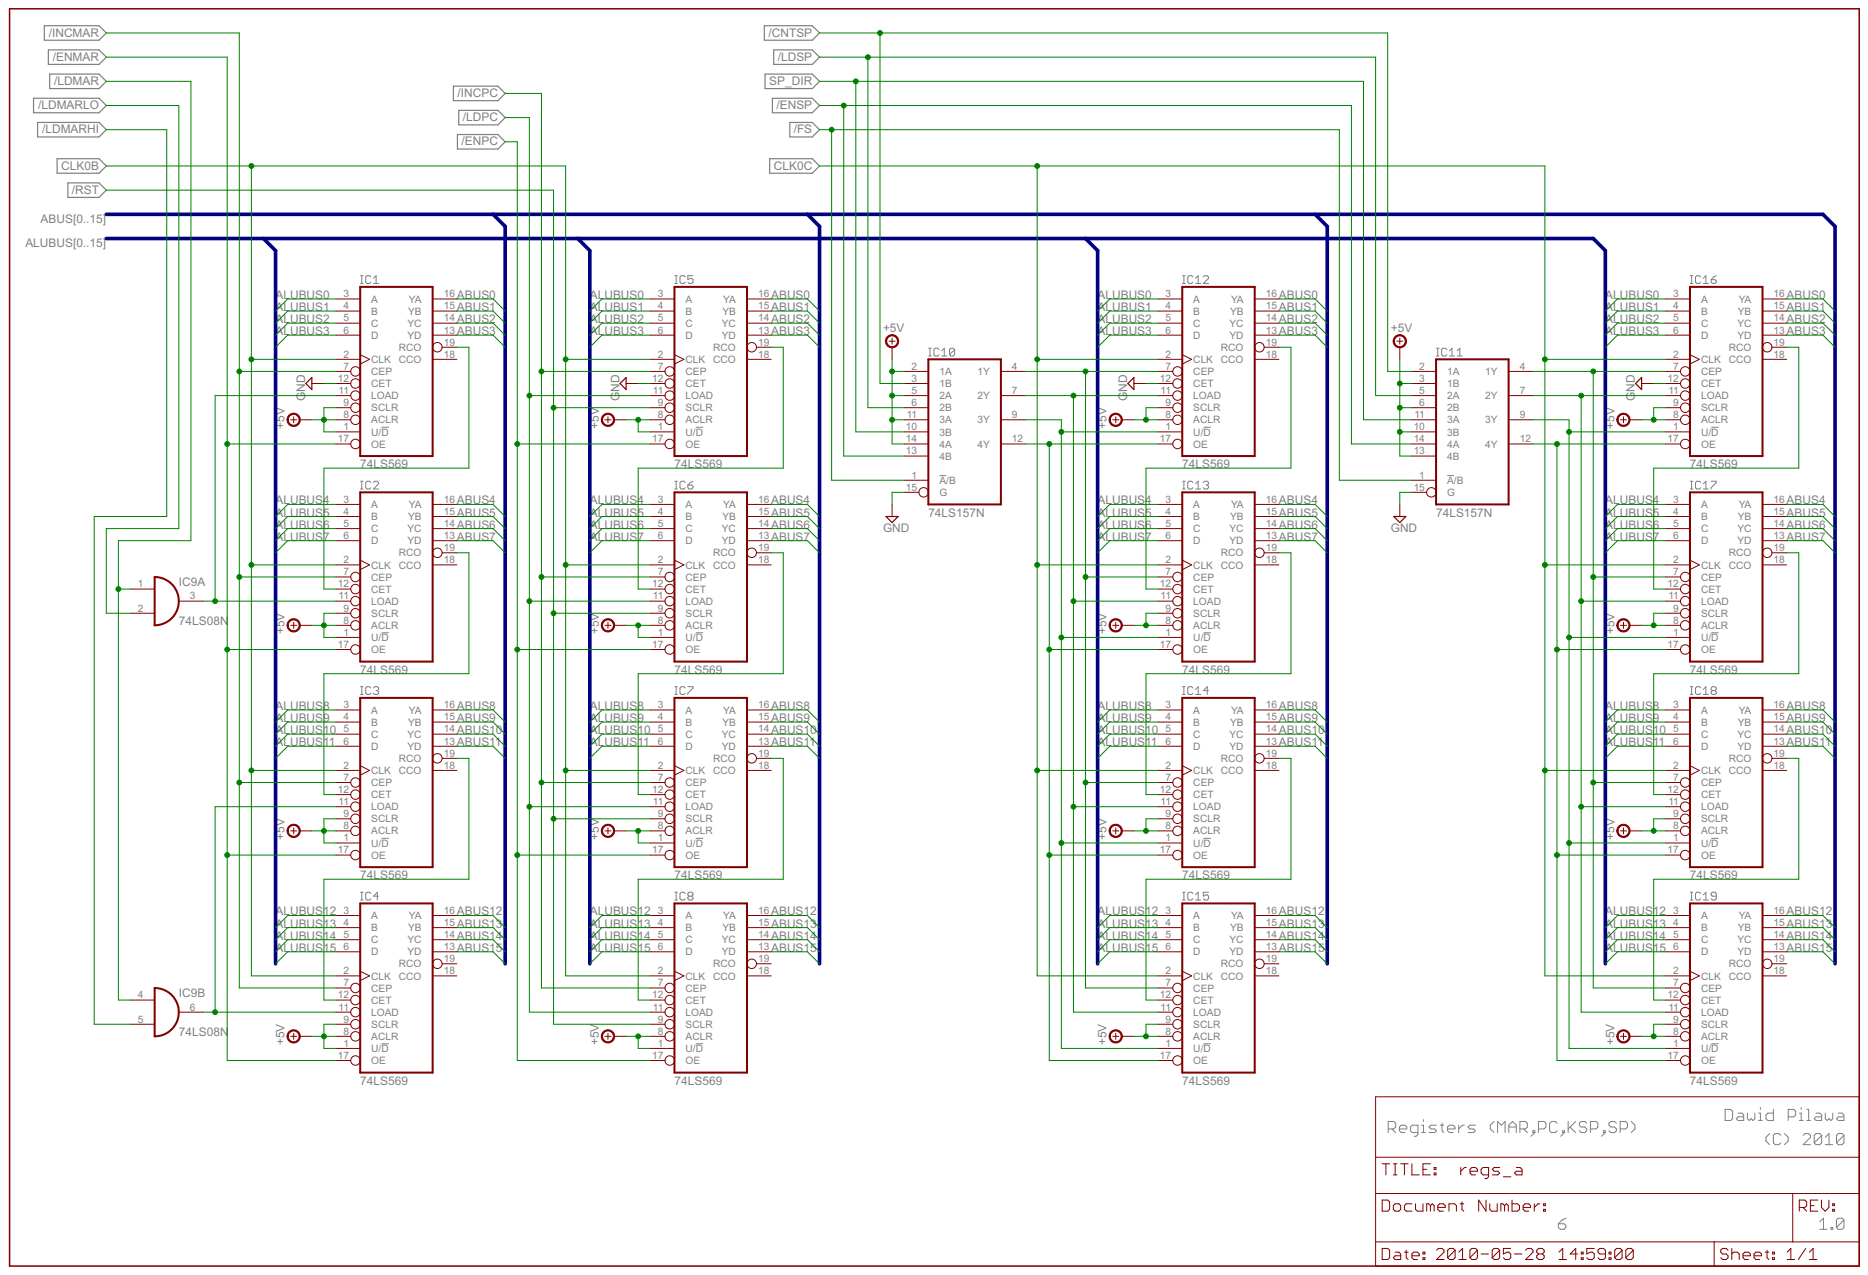
[picture p9: page 6]

+5V +5V +5V +5V +5V +5V +5V +5V 74LS08N 74LS08N 74LS569 74LS569 74LS569 74LS569 74LS569 74LS569 74LS569 74LS569 74LS157N 74LS157N 74LS569 74LS569 74LS569 74LS569 74LS569 74LS569 74LS569 74LS569 +5V GND +5V +5V +5V +5V +5V GND +5V +5V +5V +5V GND GND GND GND 12 3 IC9A 45 6 IC9B U/D 1 CLK 2 A 3 B 4 C 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

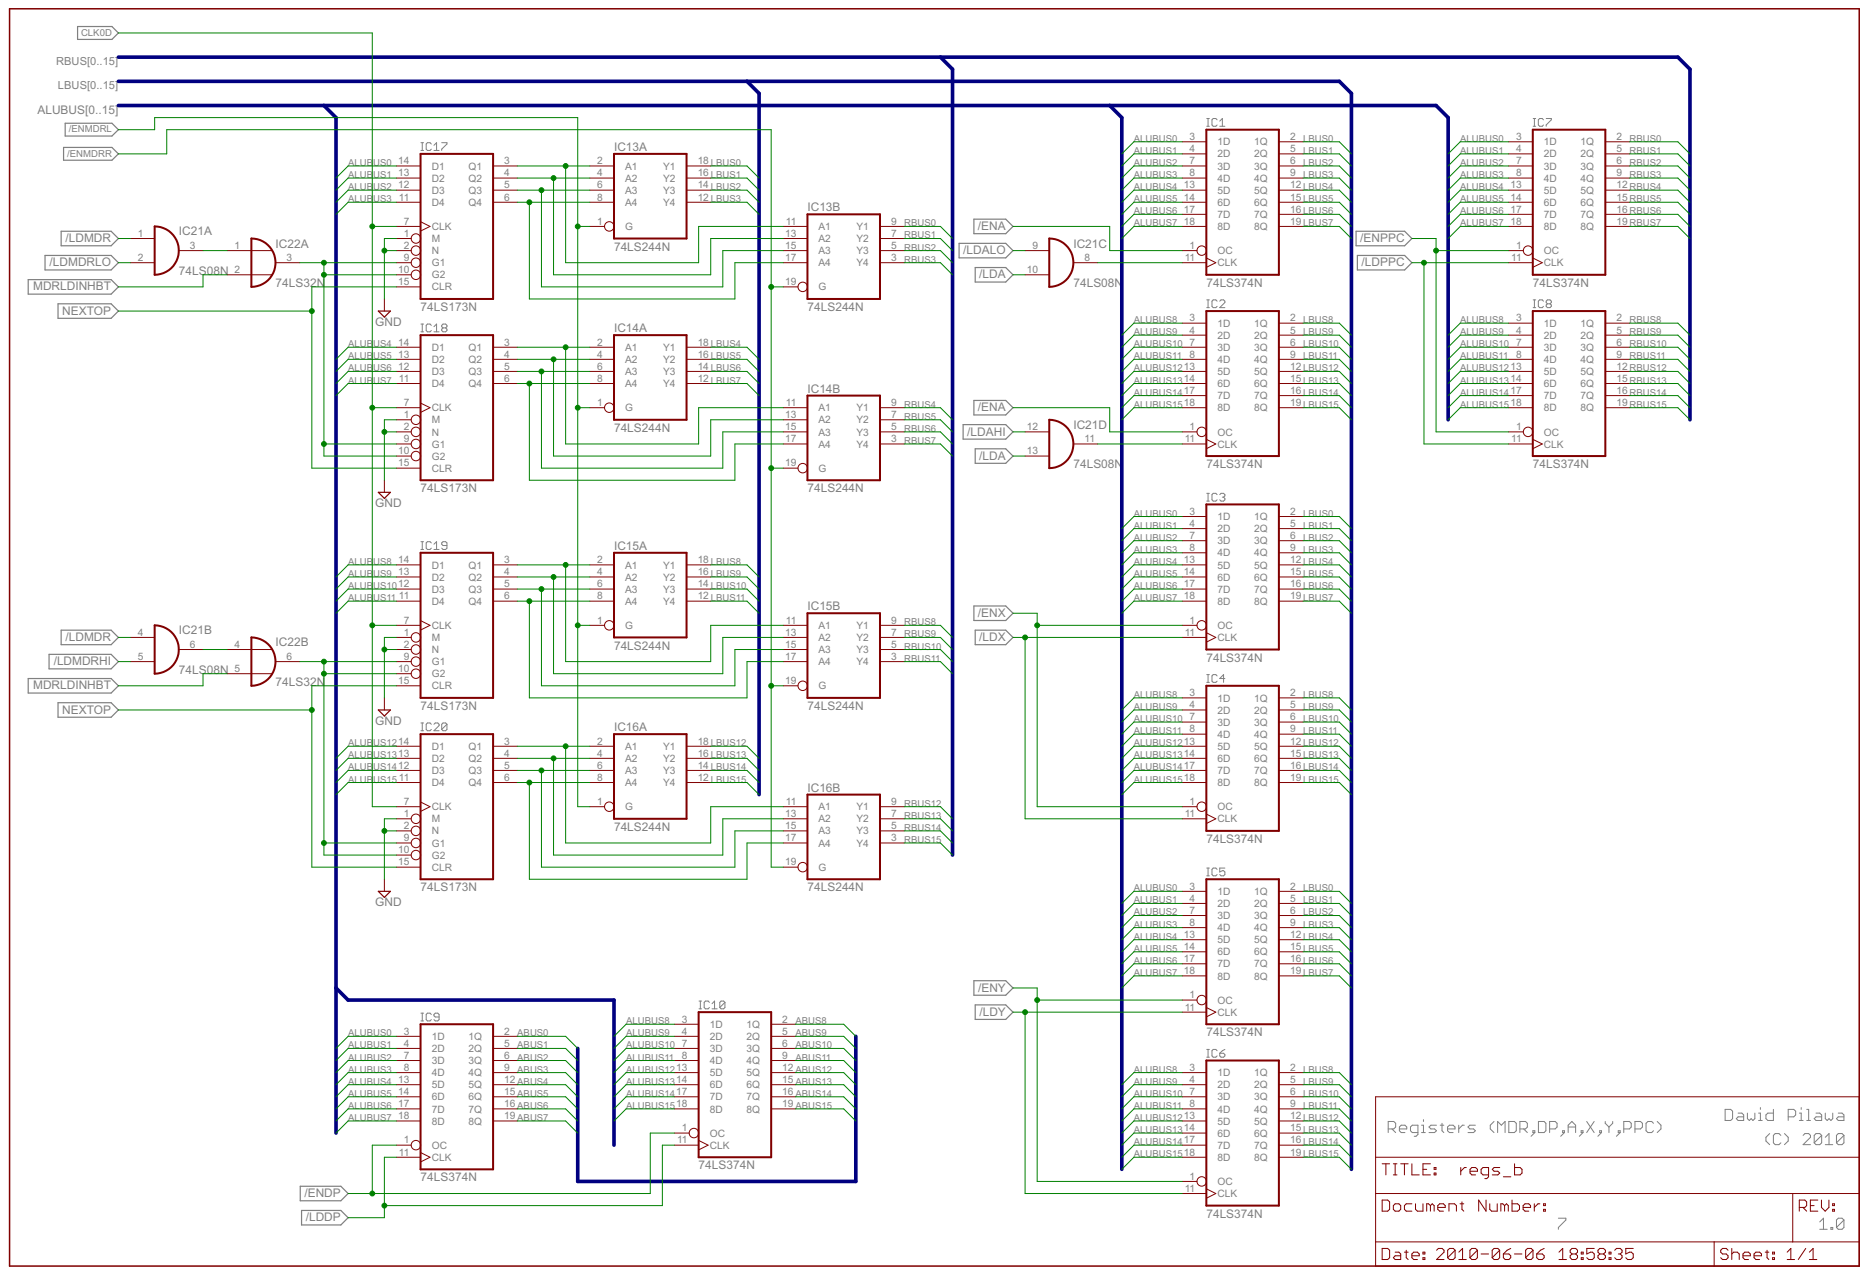
[picture p10: page 7]

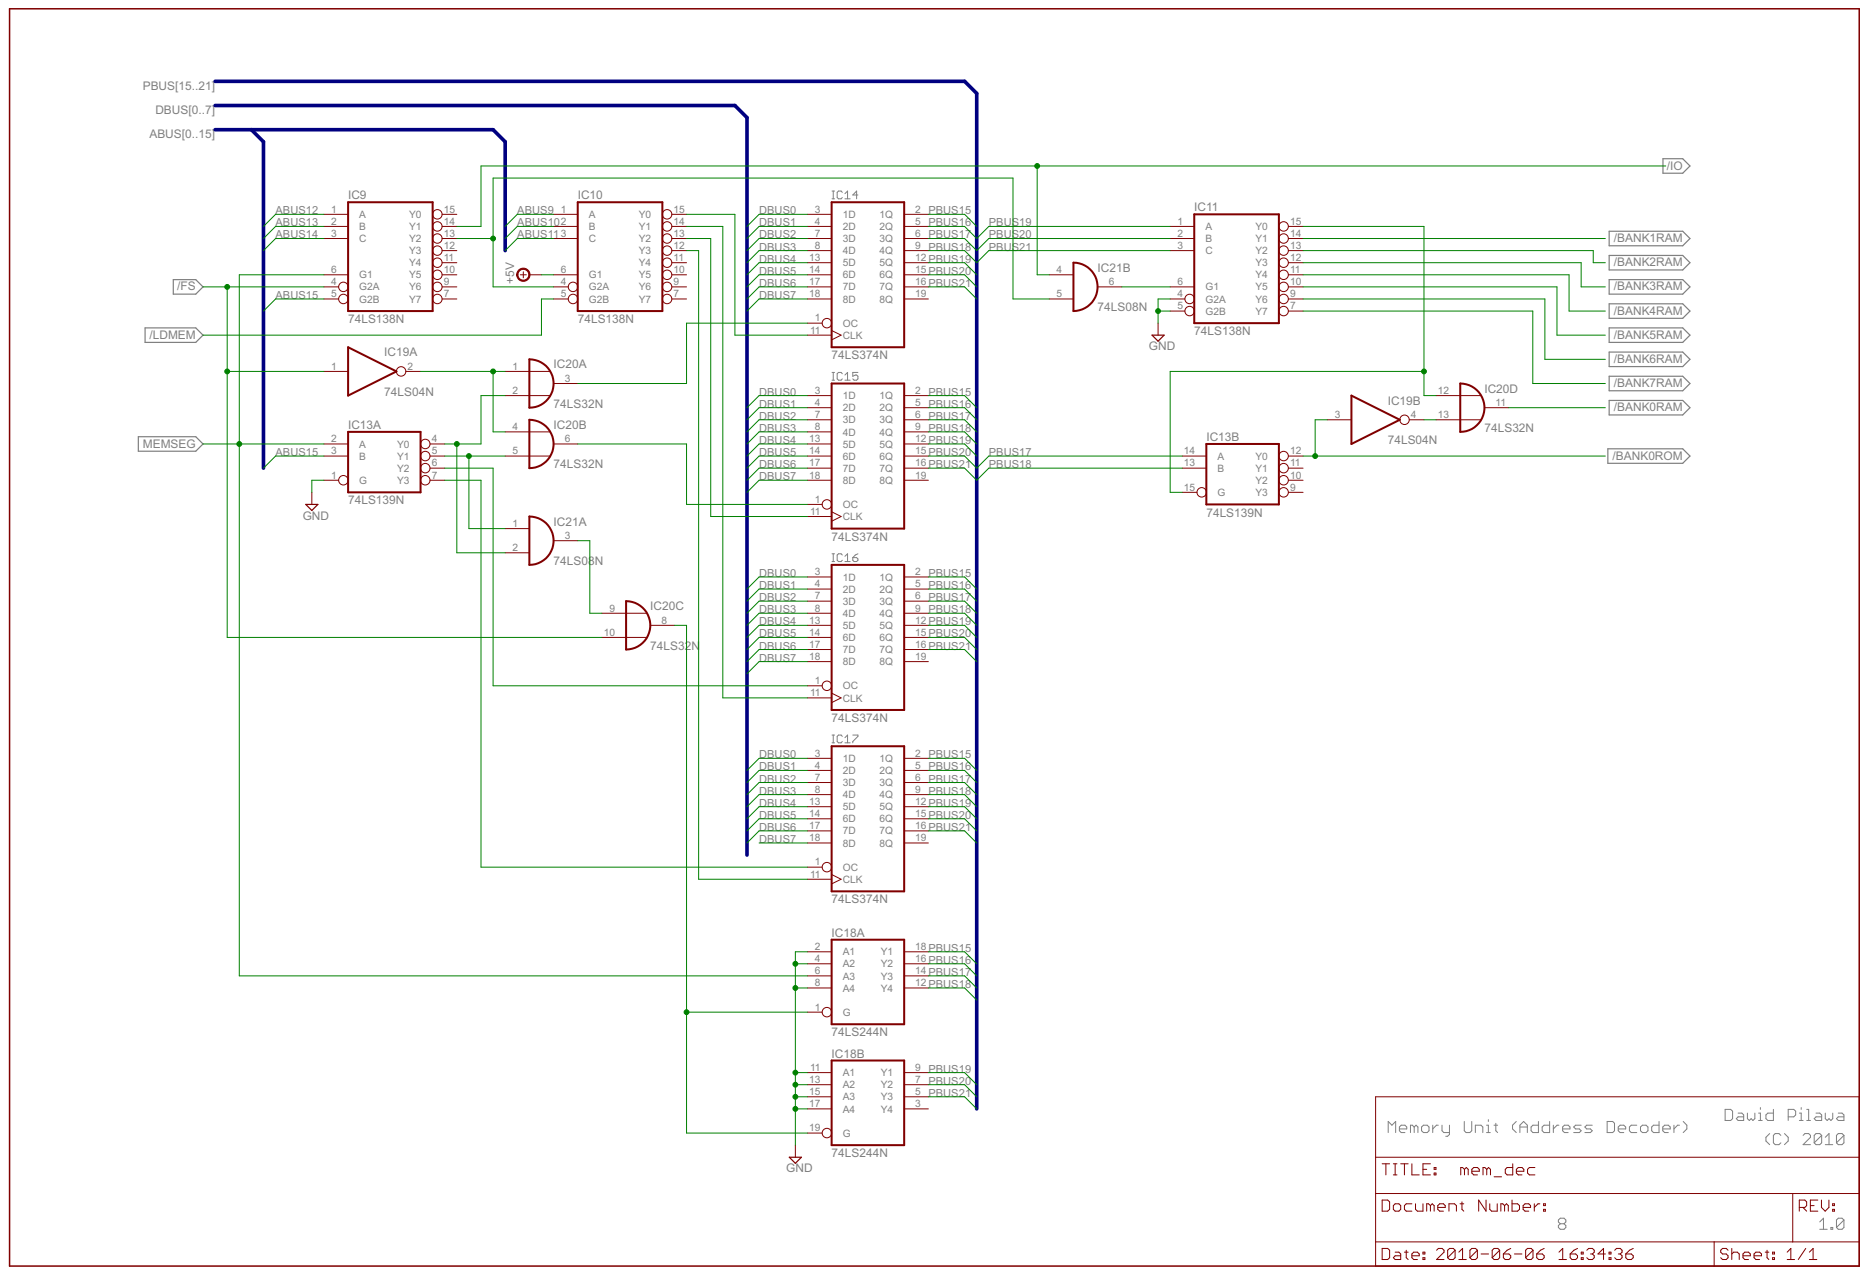
[picture p11: page 8]

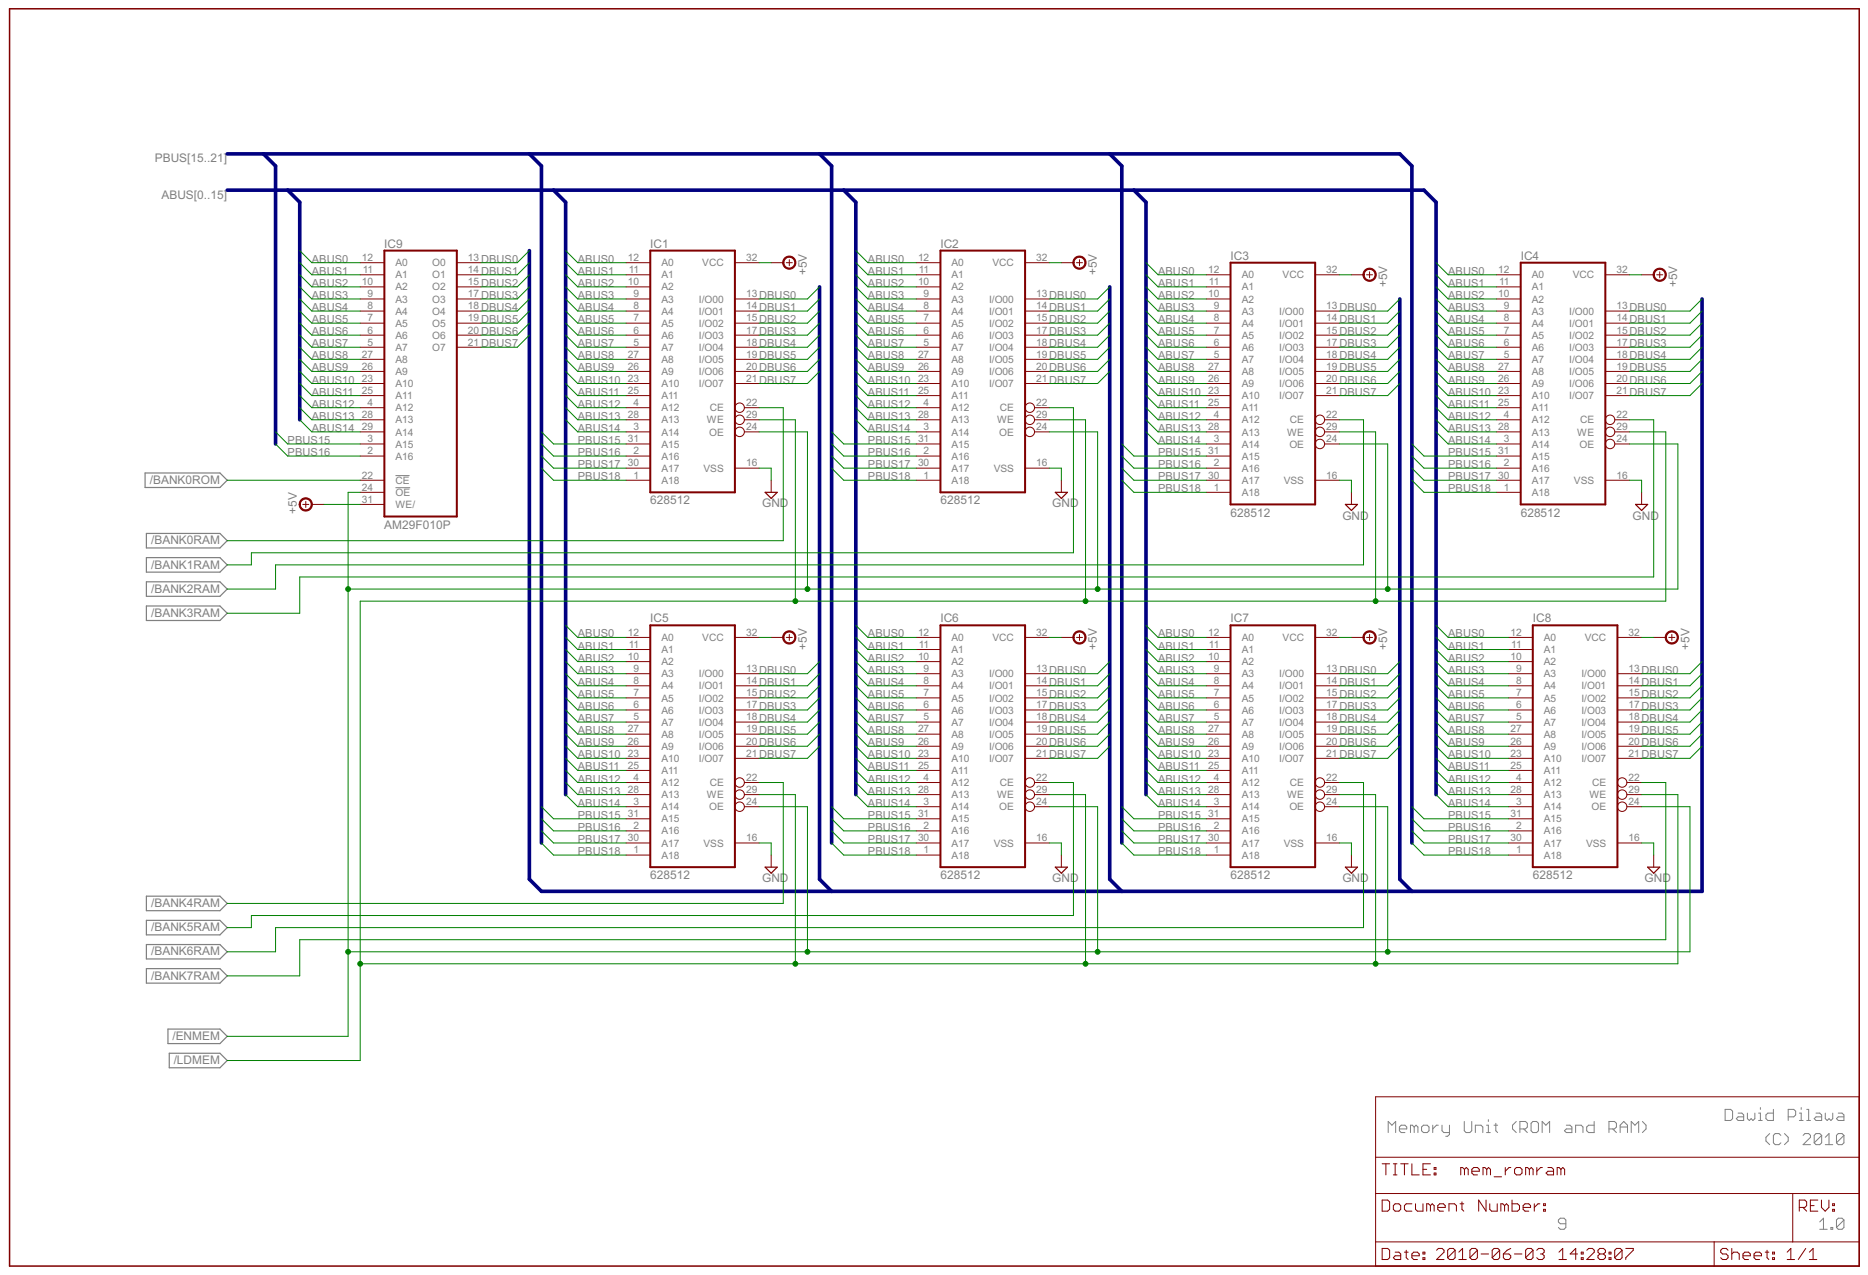
[picture p12: page 9]
