dpilawa/bytec/schematics/schematics_20100728.pdf

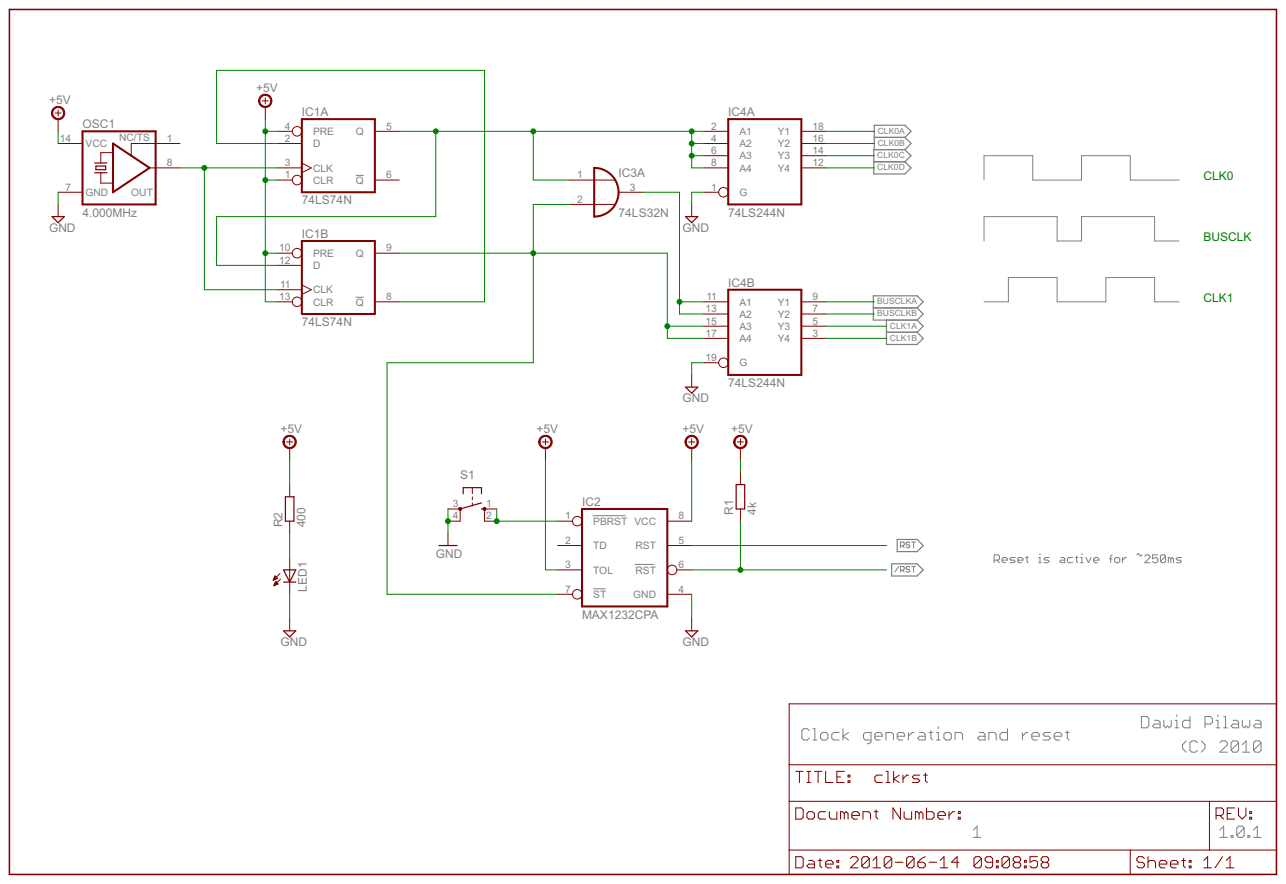
[picture p13: page 1]

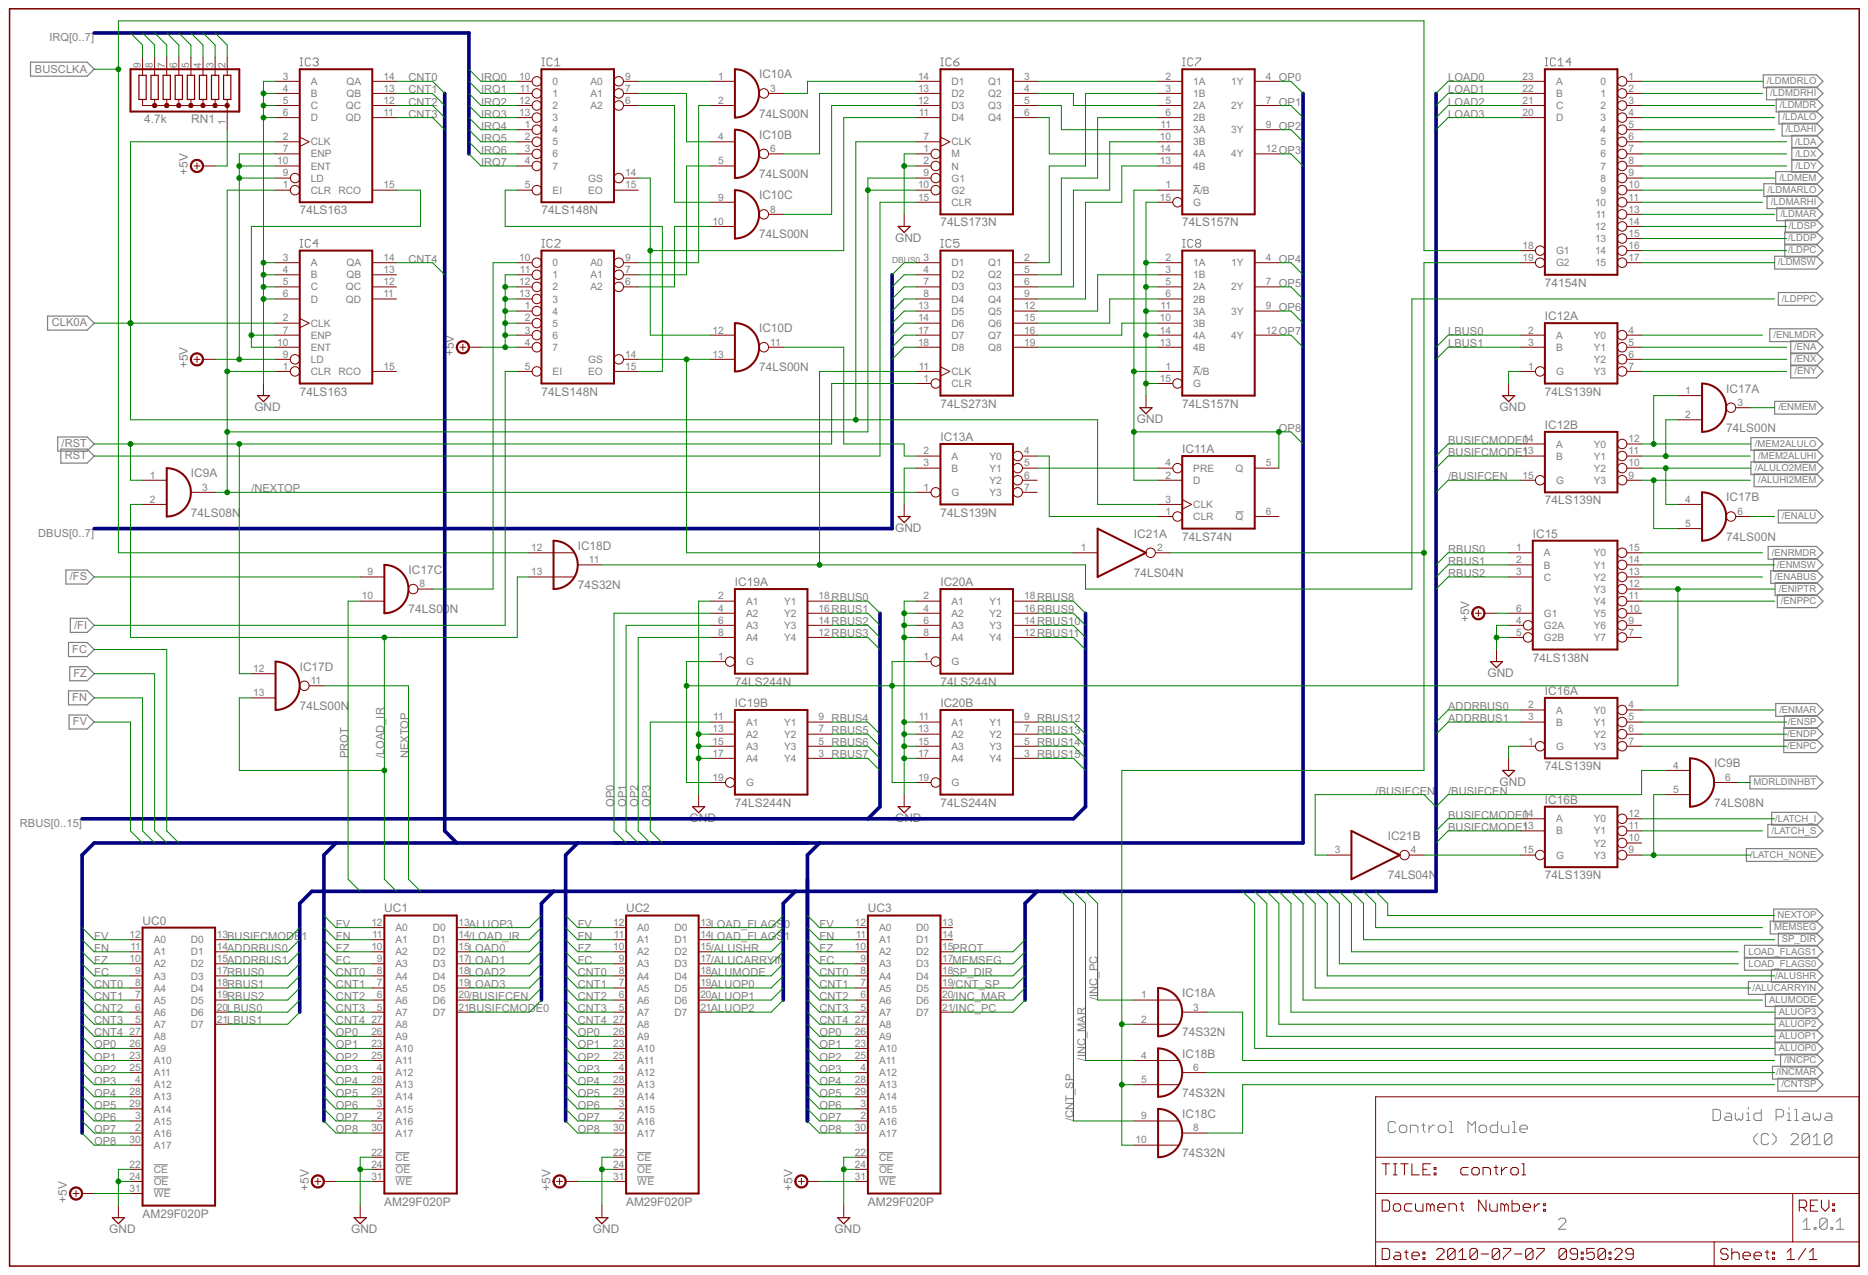
[picture p14: page 2]





+5V +5V +5V +5V +5V +5V +5V +5V 74LS08N 74LS08N 74LS569 74LS569 74LS569 74LS569 74LS569 74LS569 74LS569 74LS569 74LS157N 74LS157N 74LS569 74LS569 74LS569 74LS569 74LS569 74LS569 74LS569 74LS569 +5V GND +5V +5V +5V +5V +5V GND +5V +5V +5V +5V GND GND GND GND 12 3 IC9A 45 6 IC9B U/D 1 CLK 2 A 3 B 4 C 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


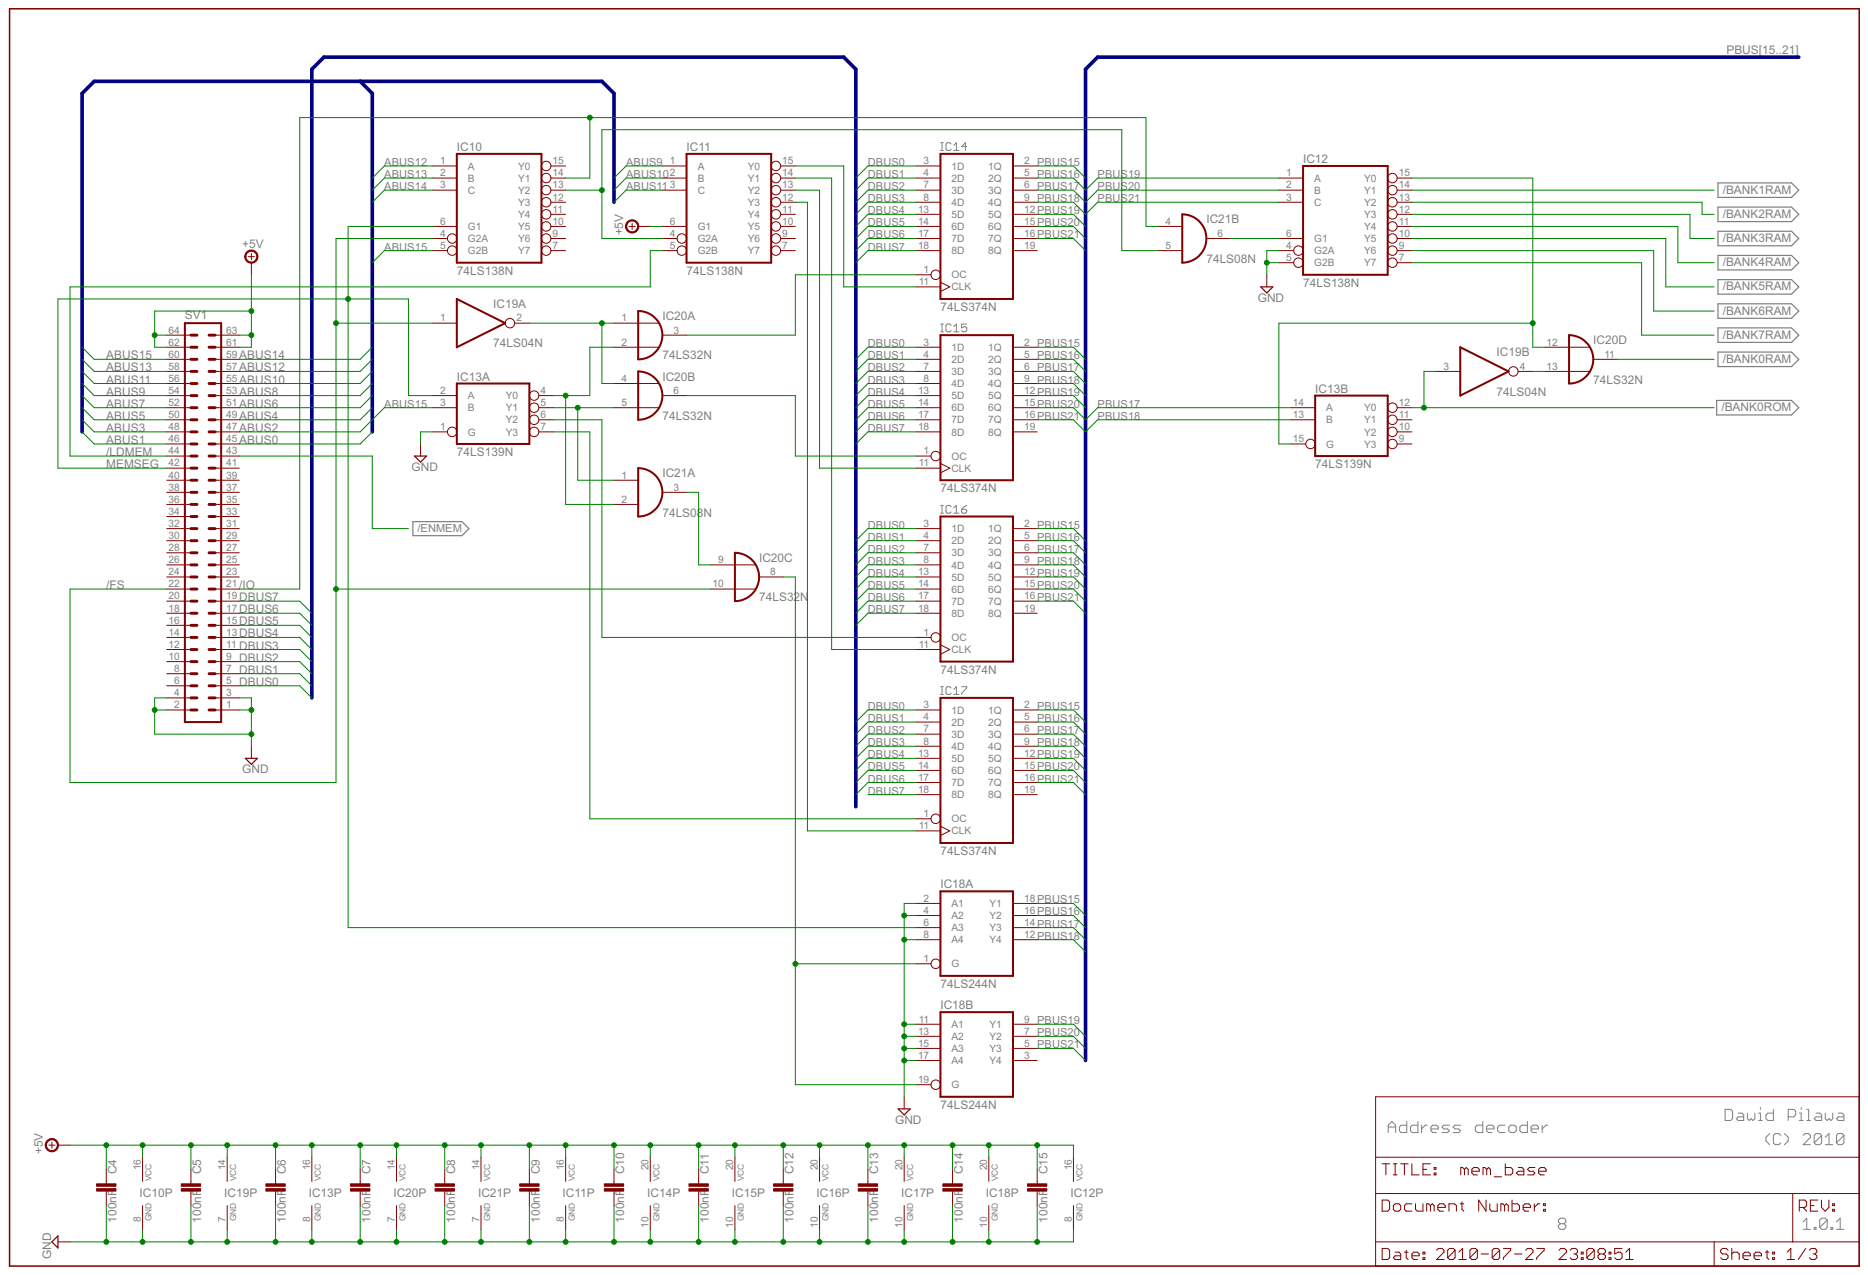
[picture p15: page 8]

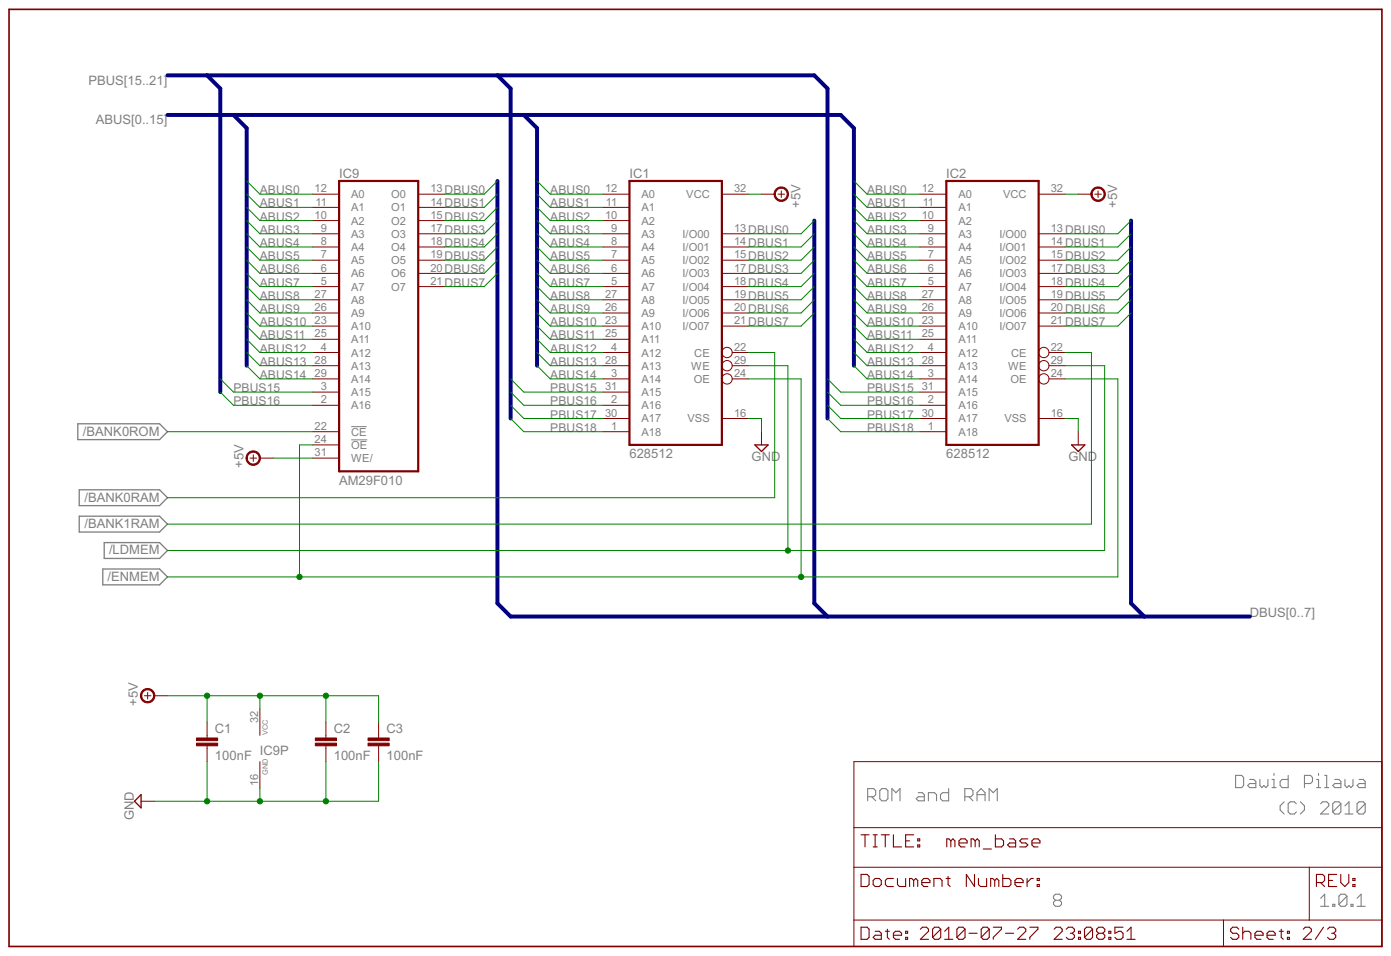
[picture p16: page 9]

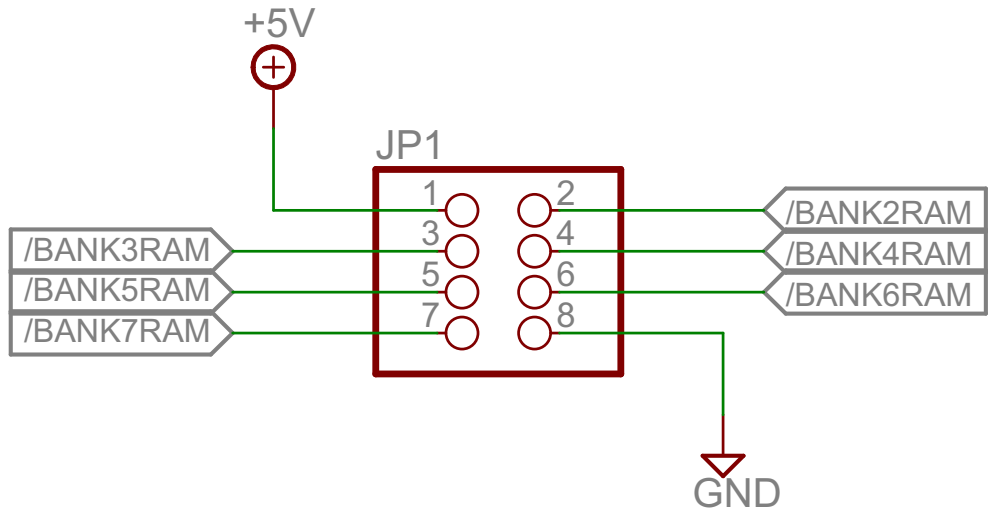
[picture p17: page 10]

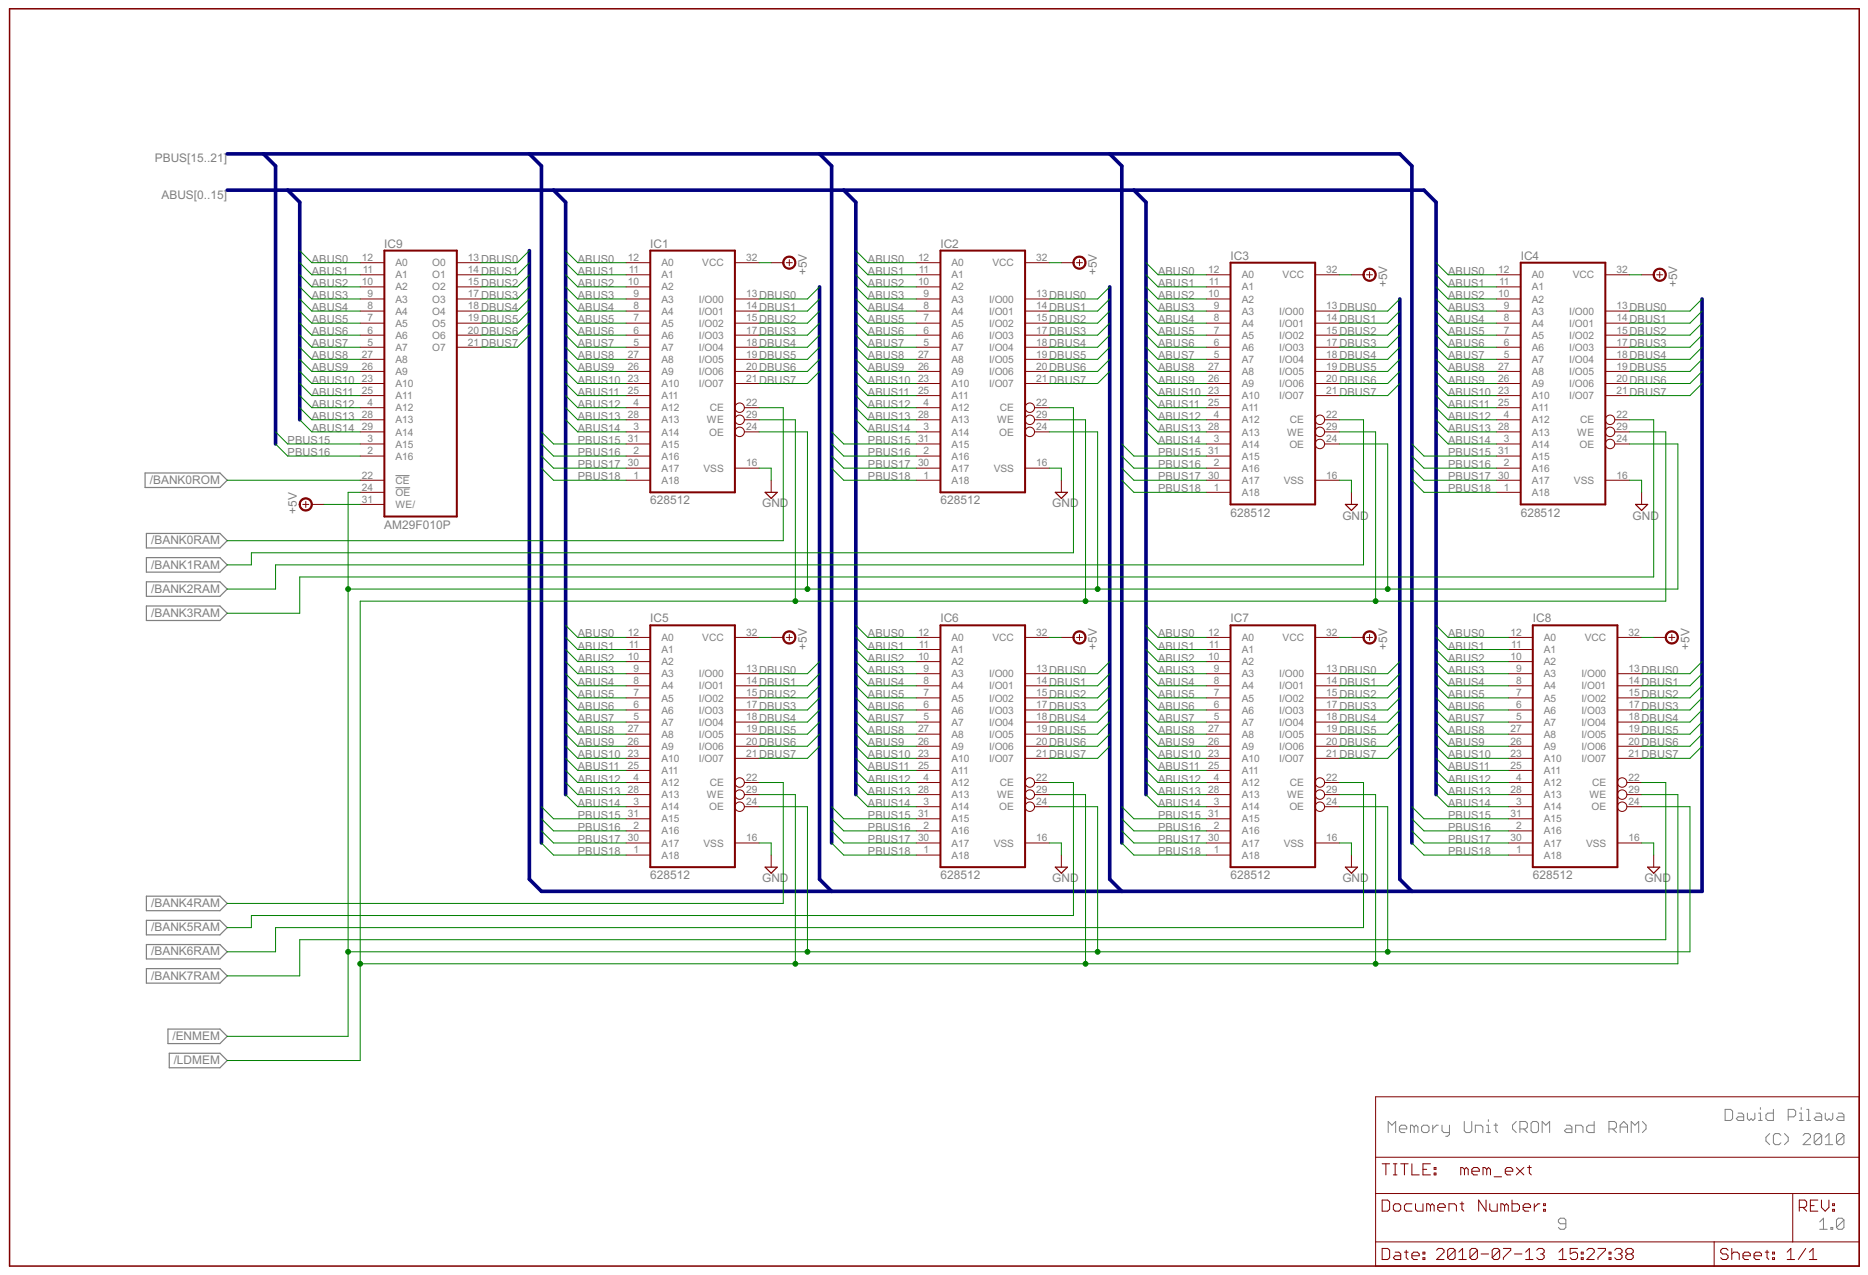
[picture p18: page 11]
