dpilawa/bytec/schematics/schematics_20110614.pdf

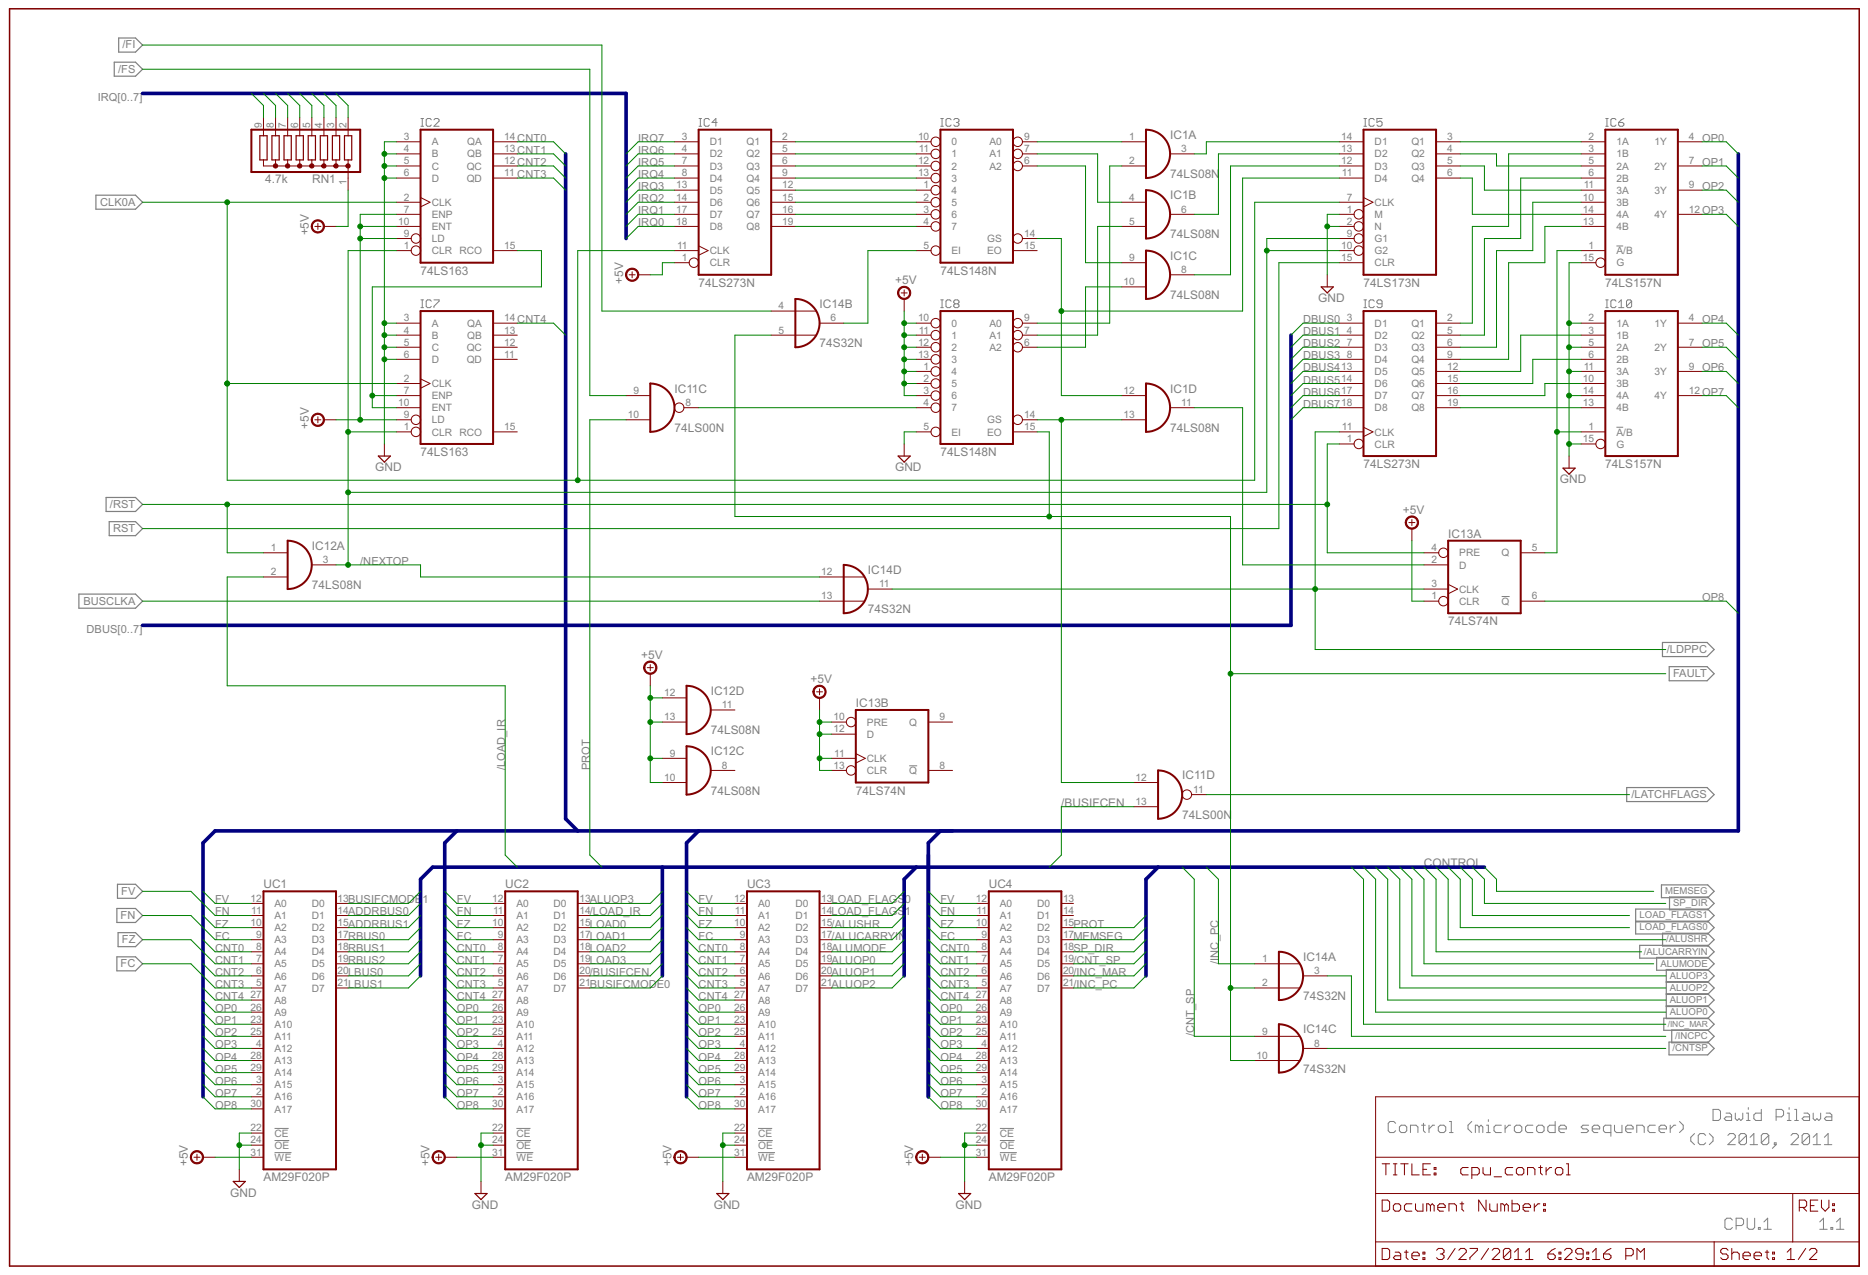
[picture p19: page 1]

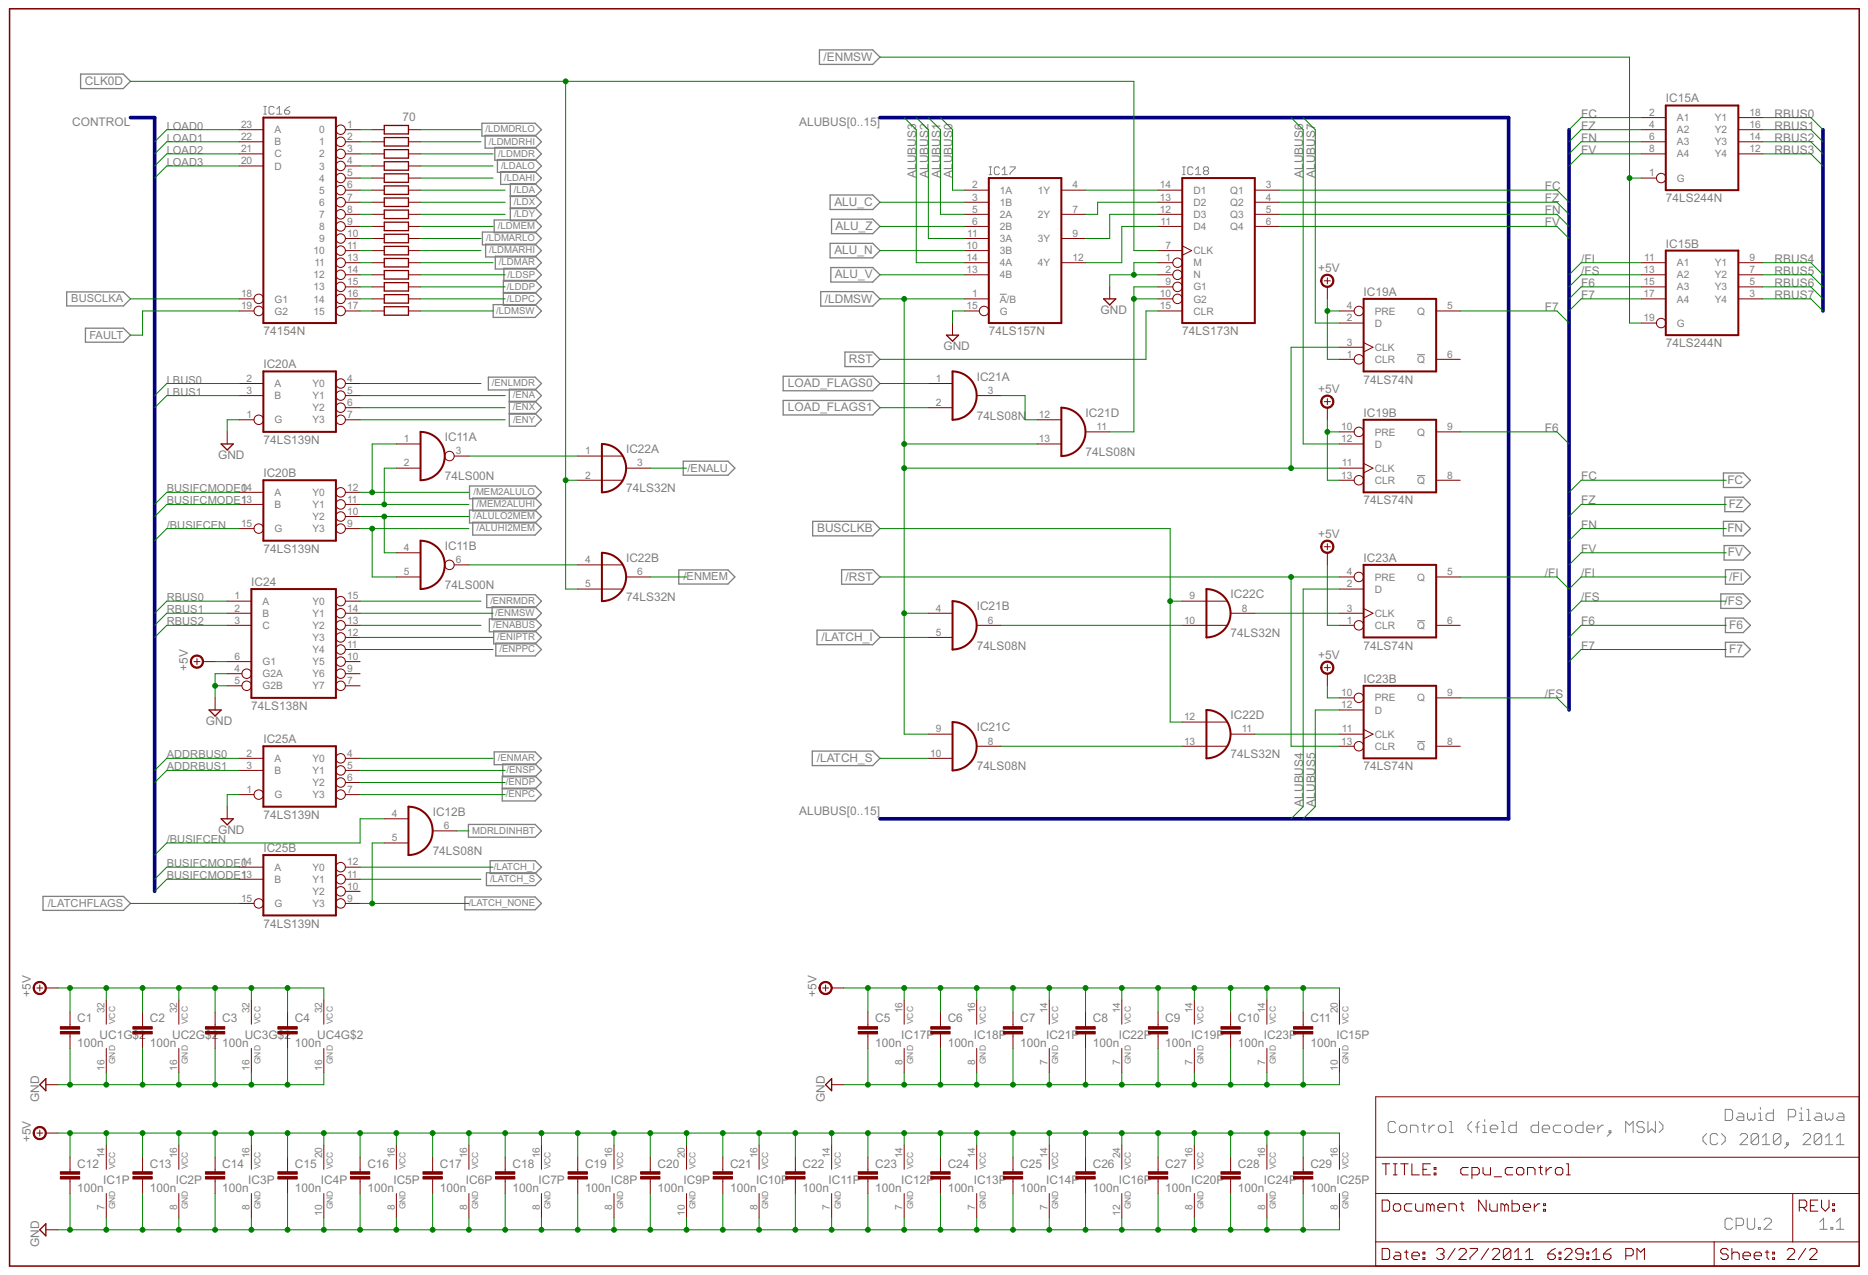
[picture p20: page 2]

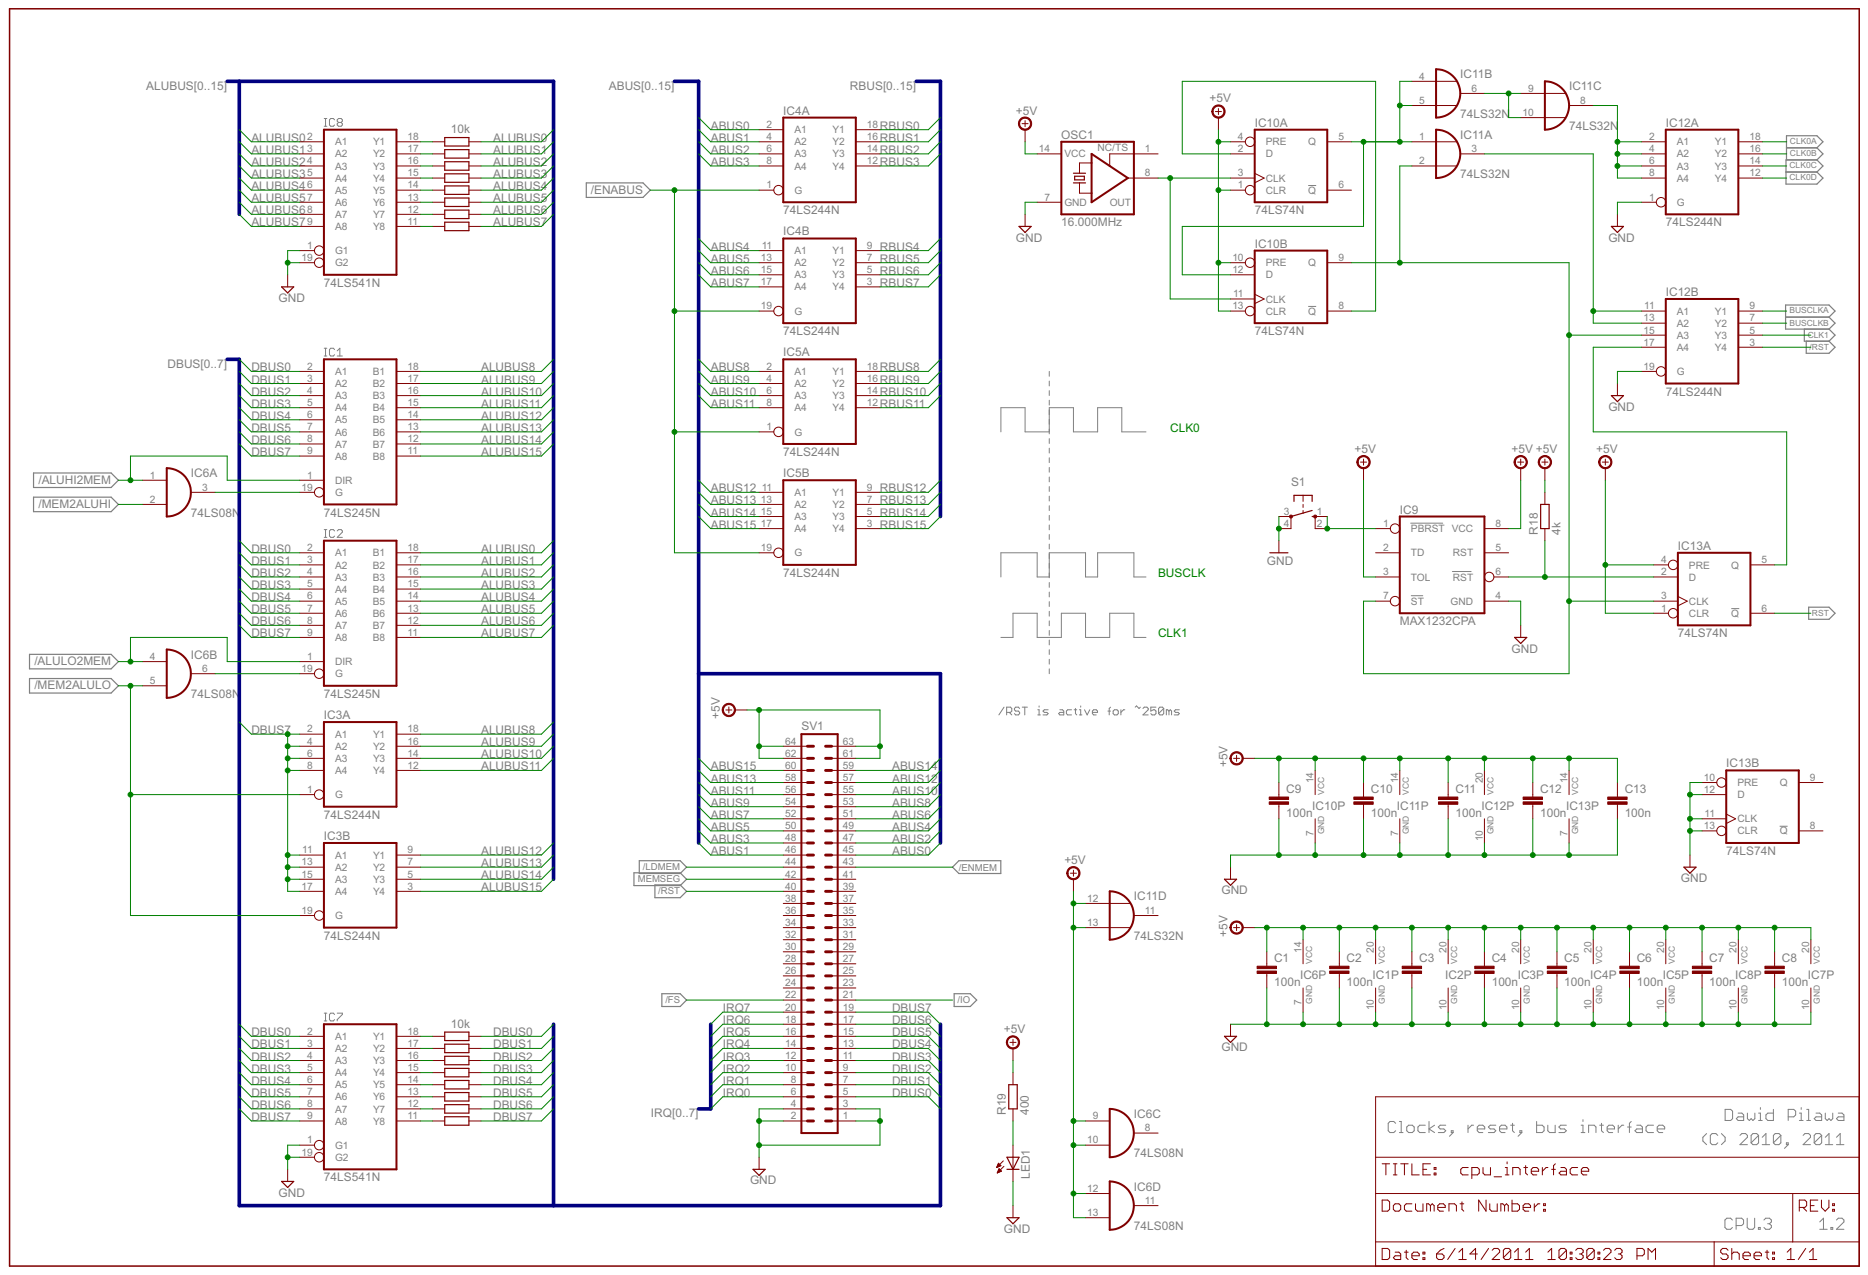
[picture p21: page 3]

4 G3

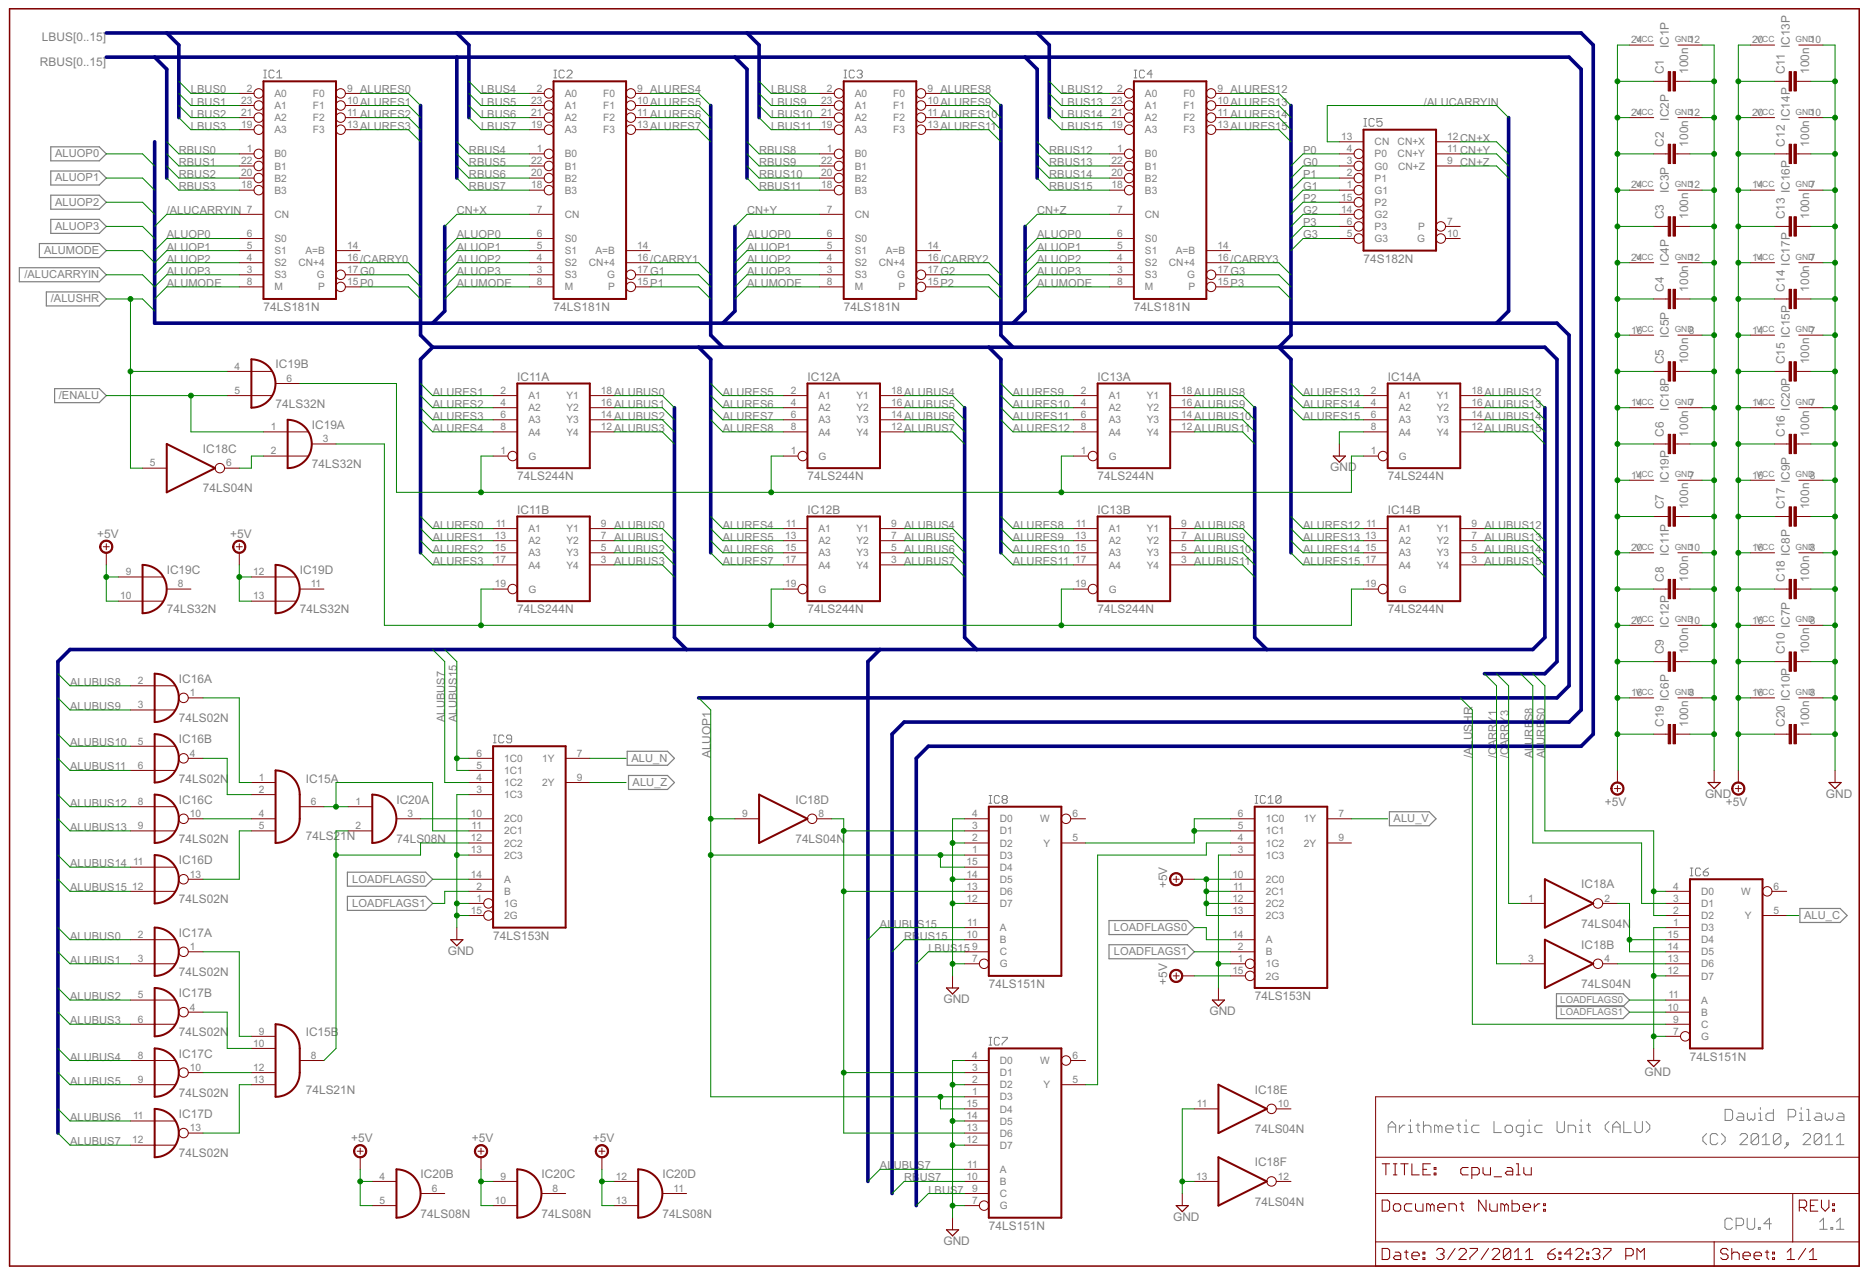
[picture p22: page 4]

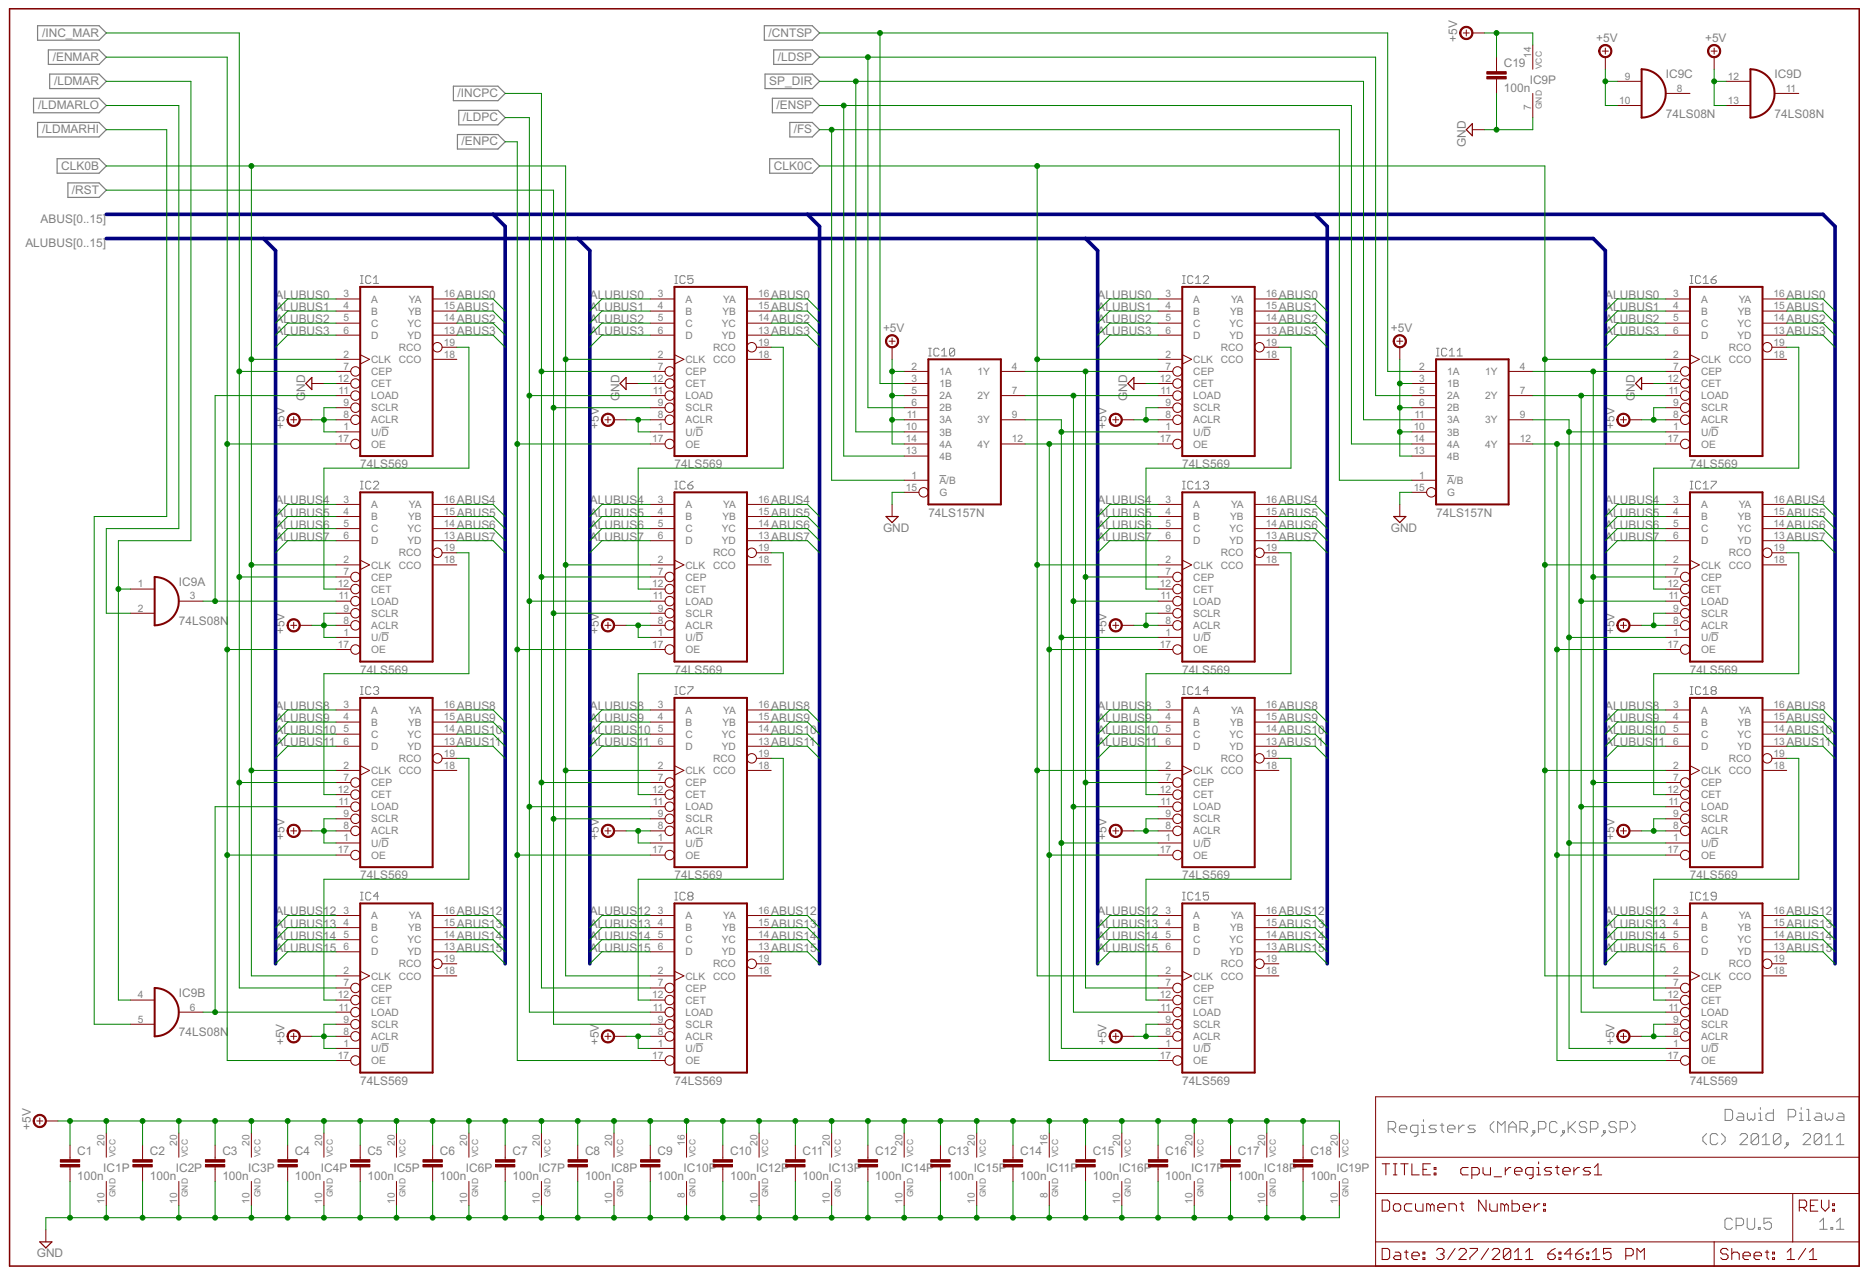
[picture p23: page 5]

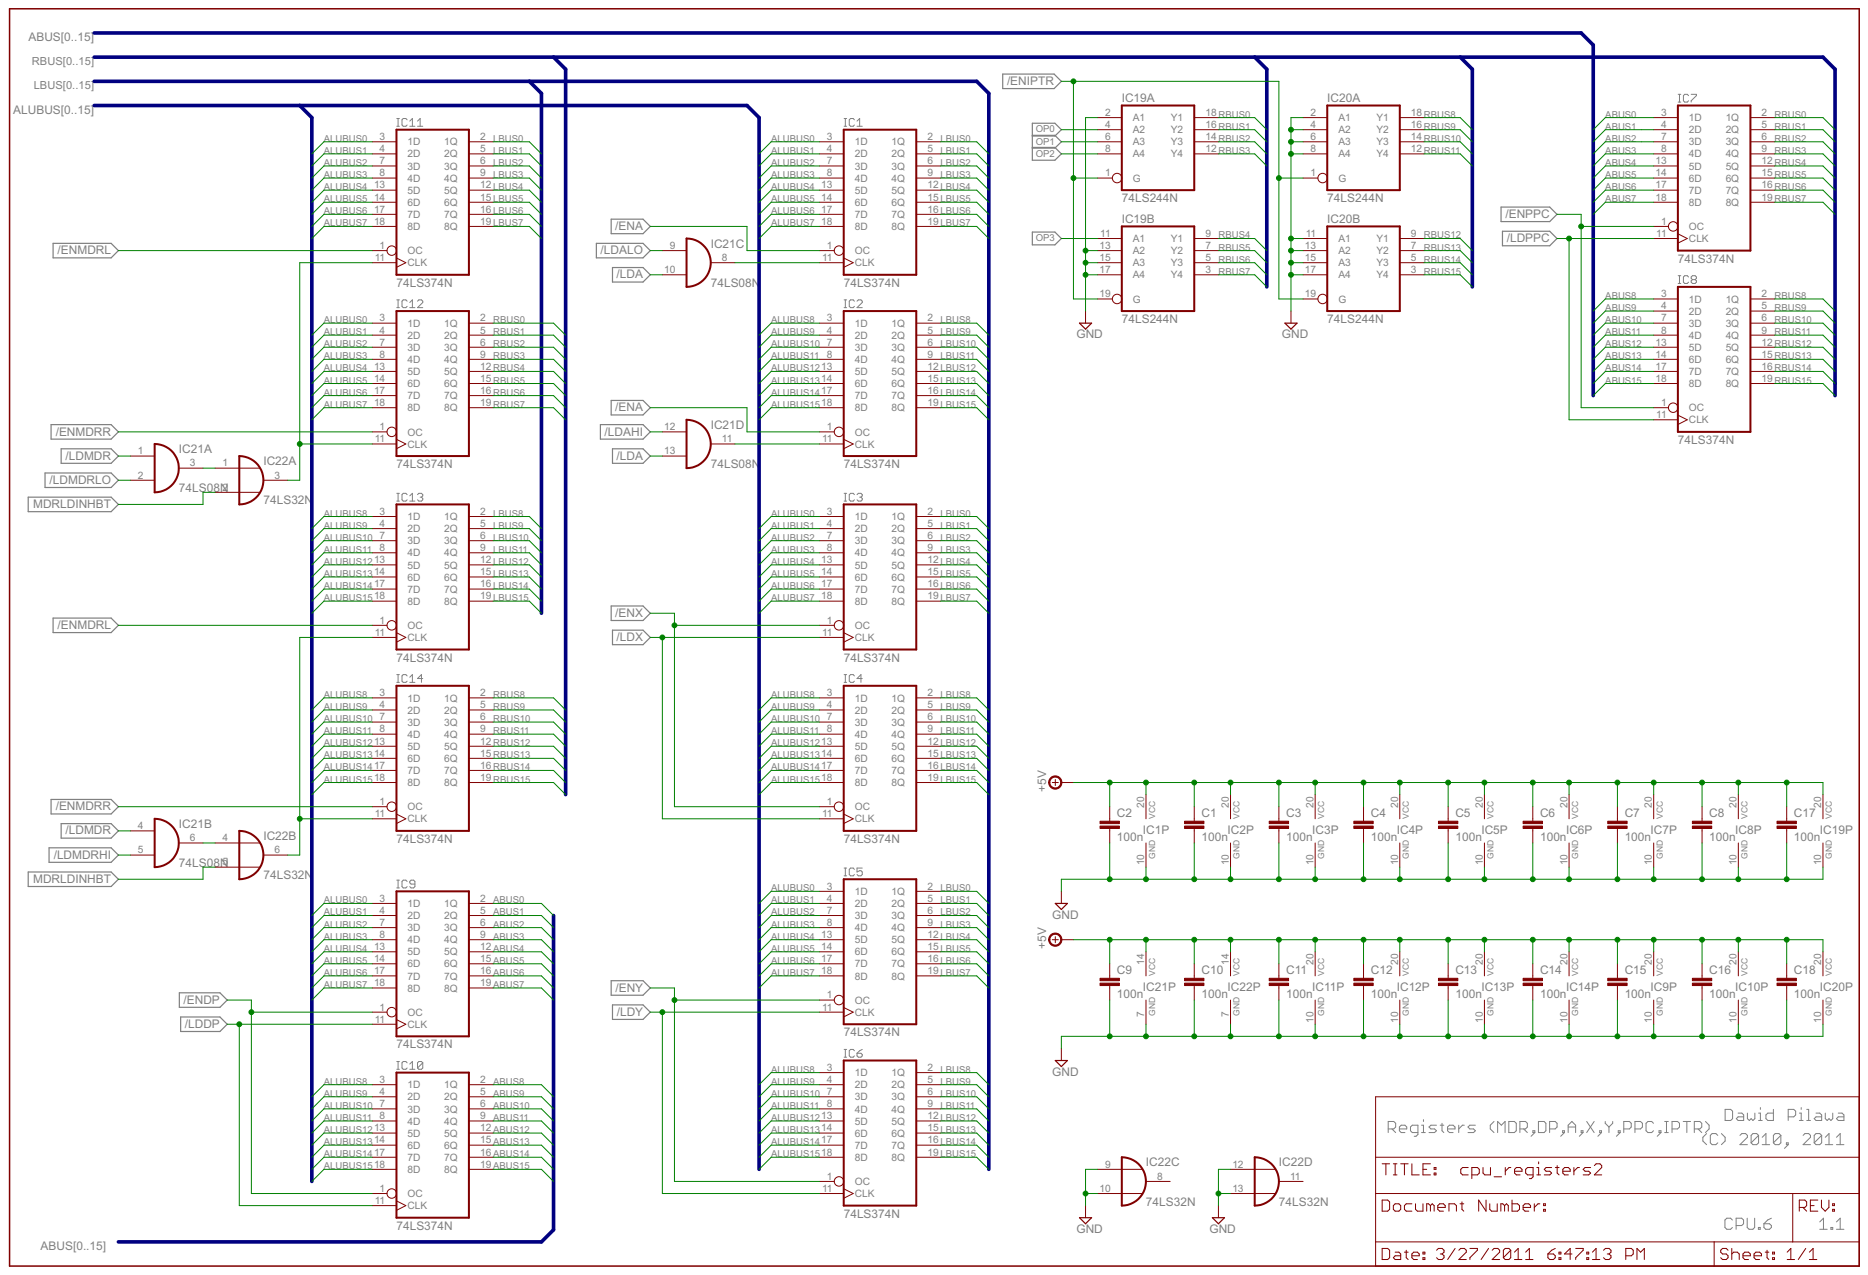
[picture p24: page 6]

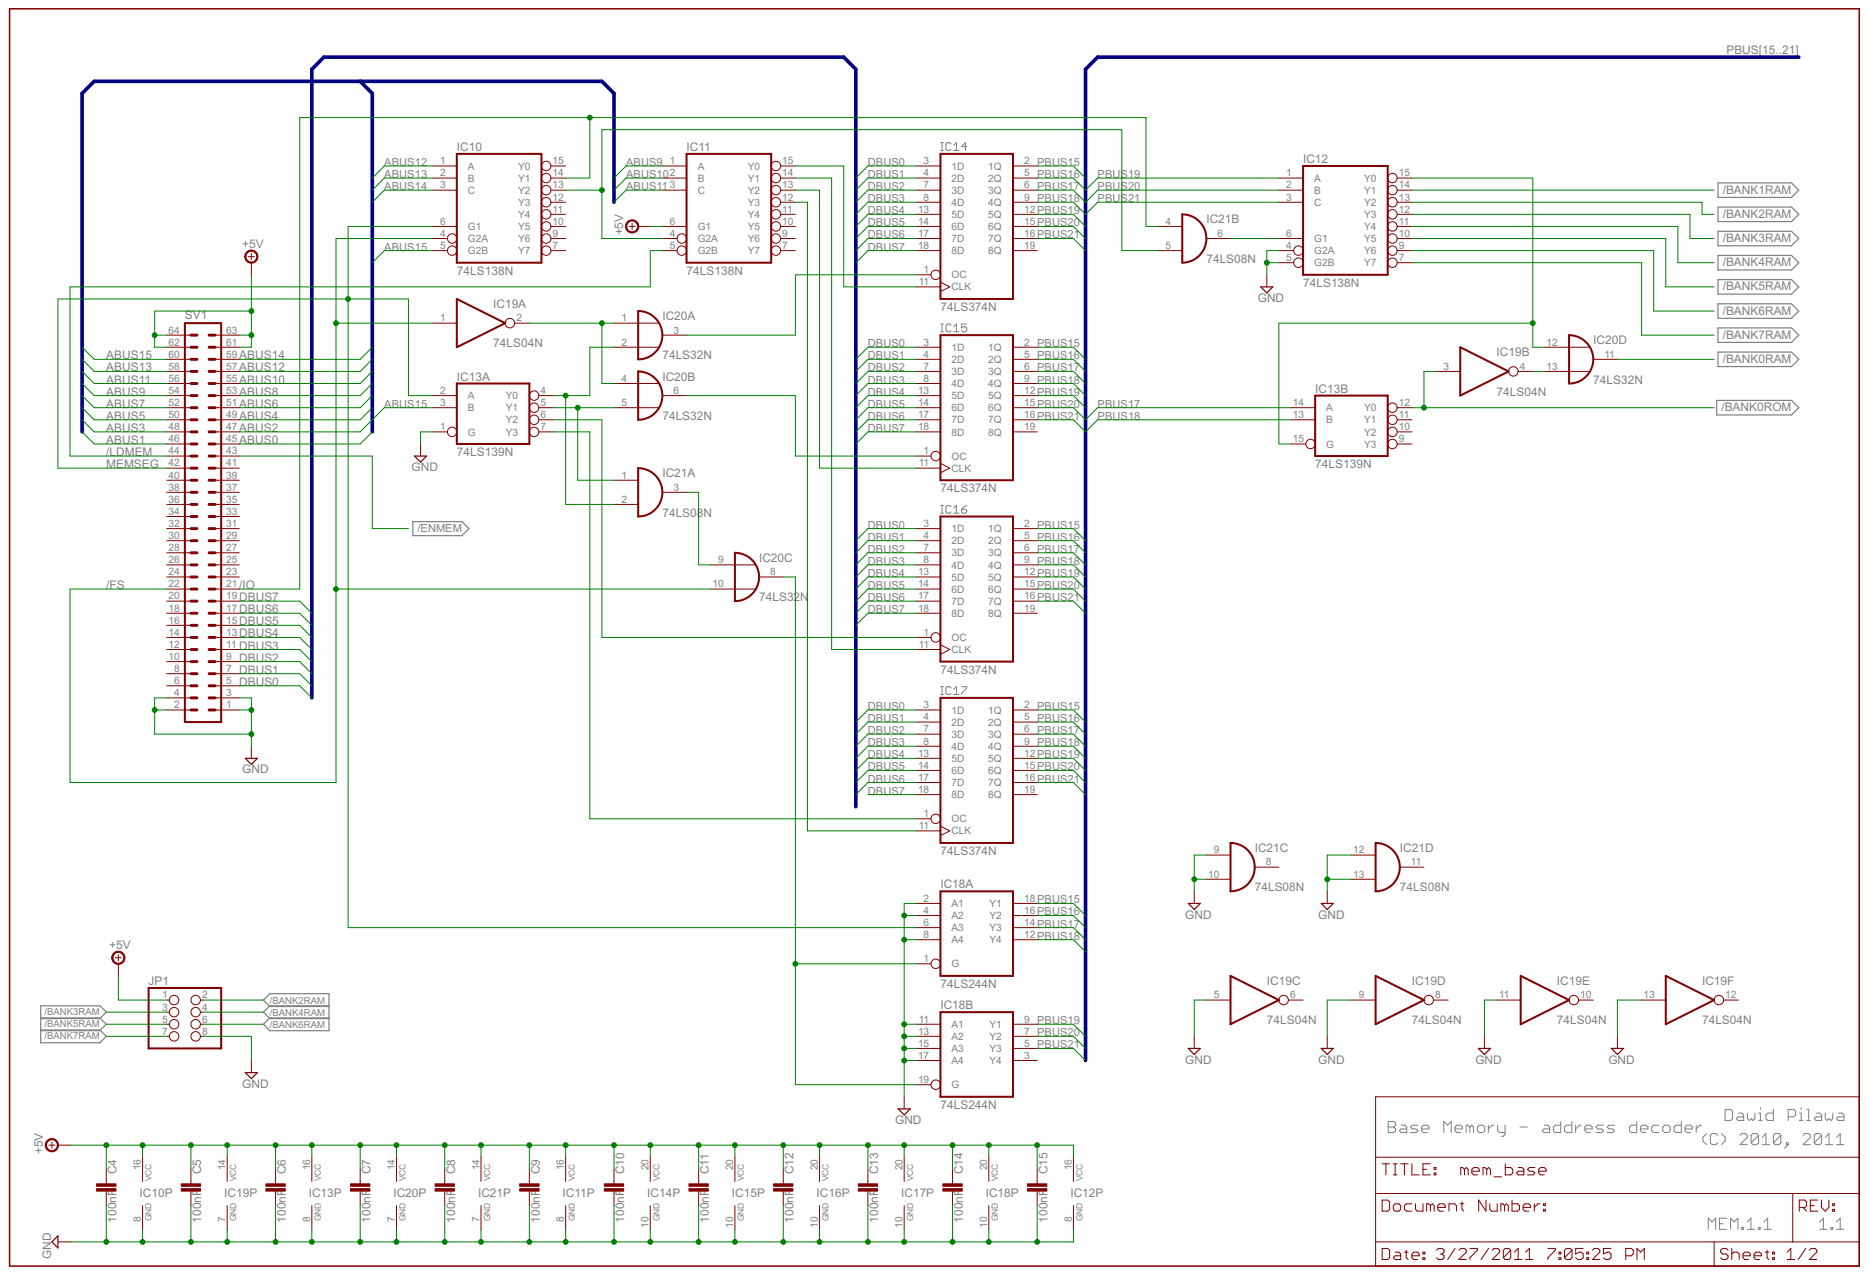
[picture p25: page 7]

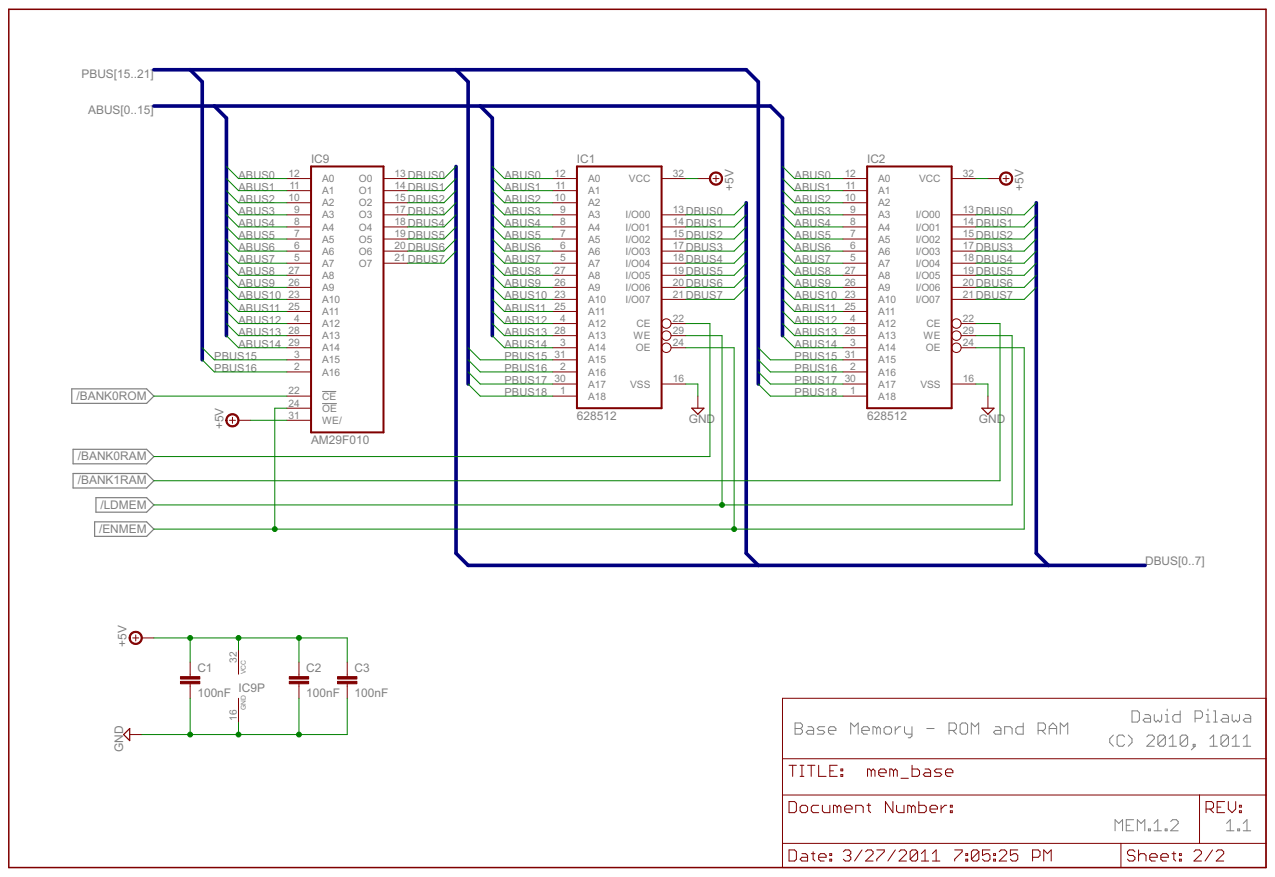
[picture p26: page 8]
+5V GND; GND 100nF ⁺⁵V GND; VCC; 32 VSS; GND VCC IC9P C1; C3 ABUS[0..15] PBUS[15..21]; DBUS[0..7] ABUS0; ABUS0; ABUS0 ABUS1; ABUS1; ABUS1 ABUS2; ABUS2; ABUS2 ABUS3; ABUS3; ABUS3 ABUS4; ABUS4; ABUS4 ABUS5; ABUS5; ABUS5 ABUS6; ABUS6; ABUS6 ABUS7; ABUS7; ABUS7 ABUS8; ABUS8; ABUS8 ABUS9; ABUS9; ABUS9 ABUS10; ABUS10; ABUS10 ABUS11; ABUS11; ABUS11 ABUS12; ABUS12; ABUS12 ABUS13; ABUS13; ABUS13 ABUS14; ABUS14; ABUS14 PBUS15; PBUS15; PBUS15 PBUS16; PBUS16; PBUS16 DBUS0; DBUS0; DBUS0 DBUS1; DBUS1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

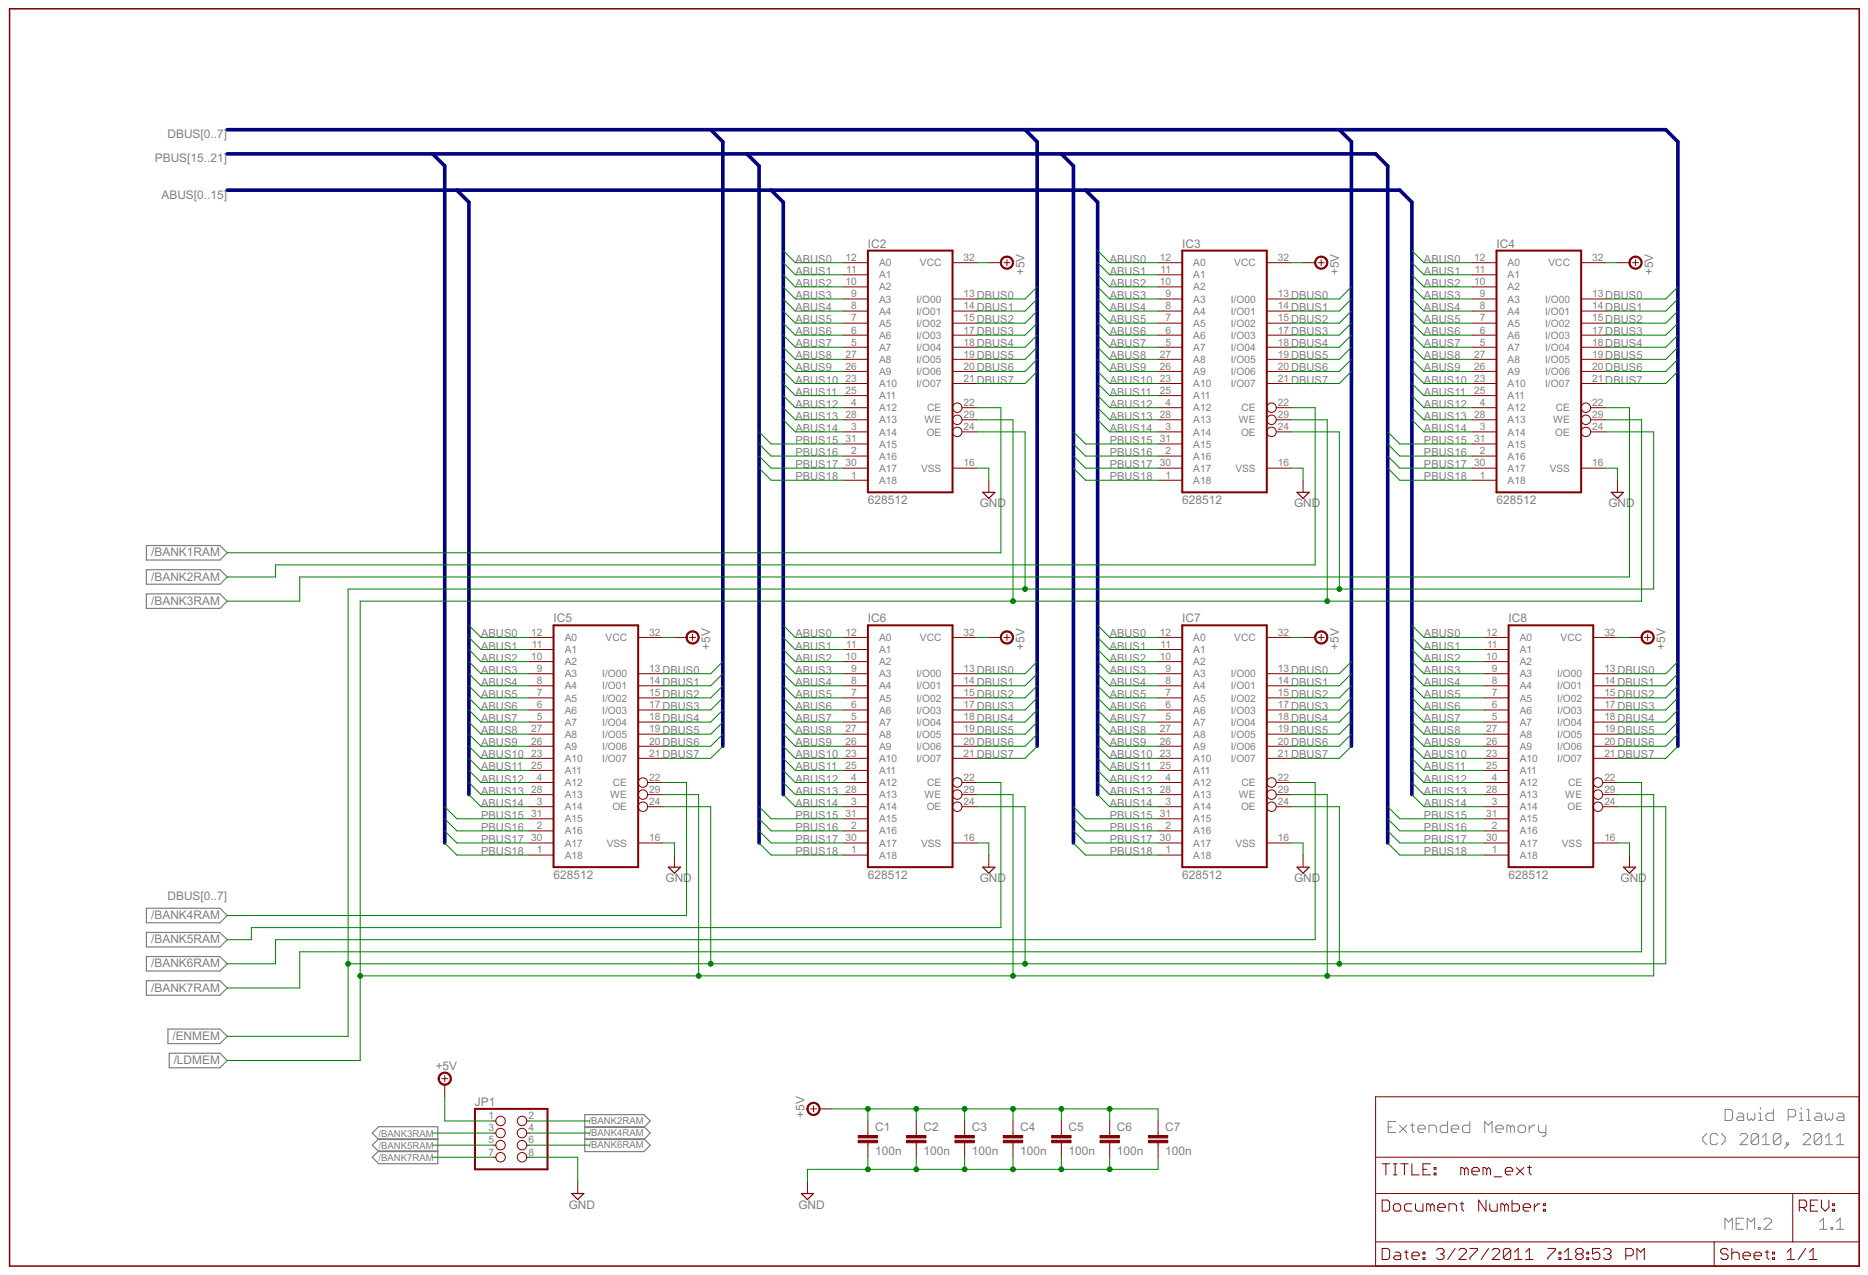
[picture p27: page 9]

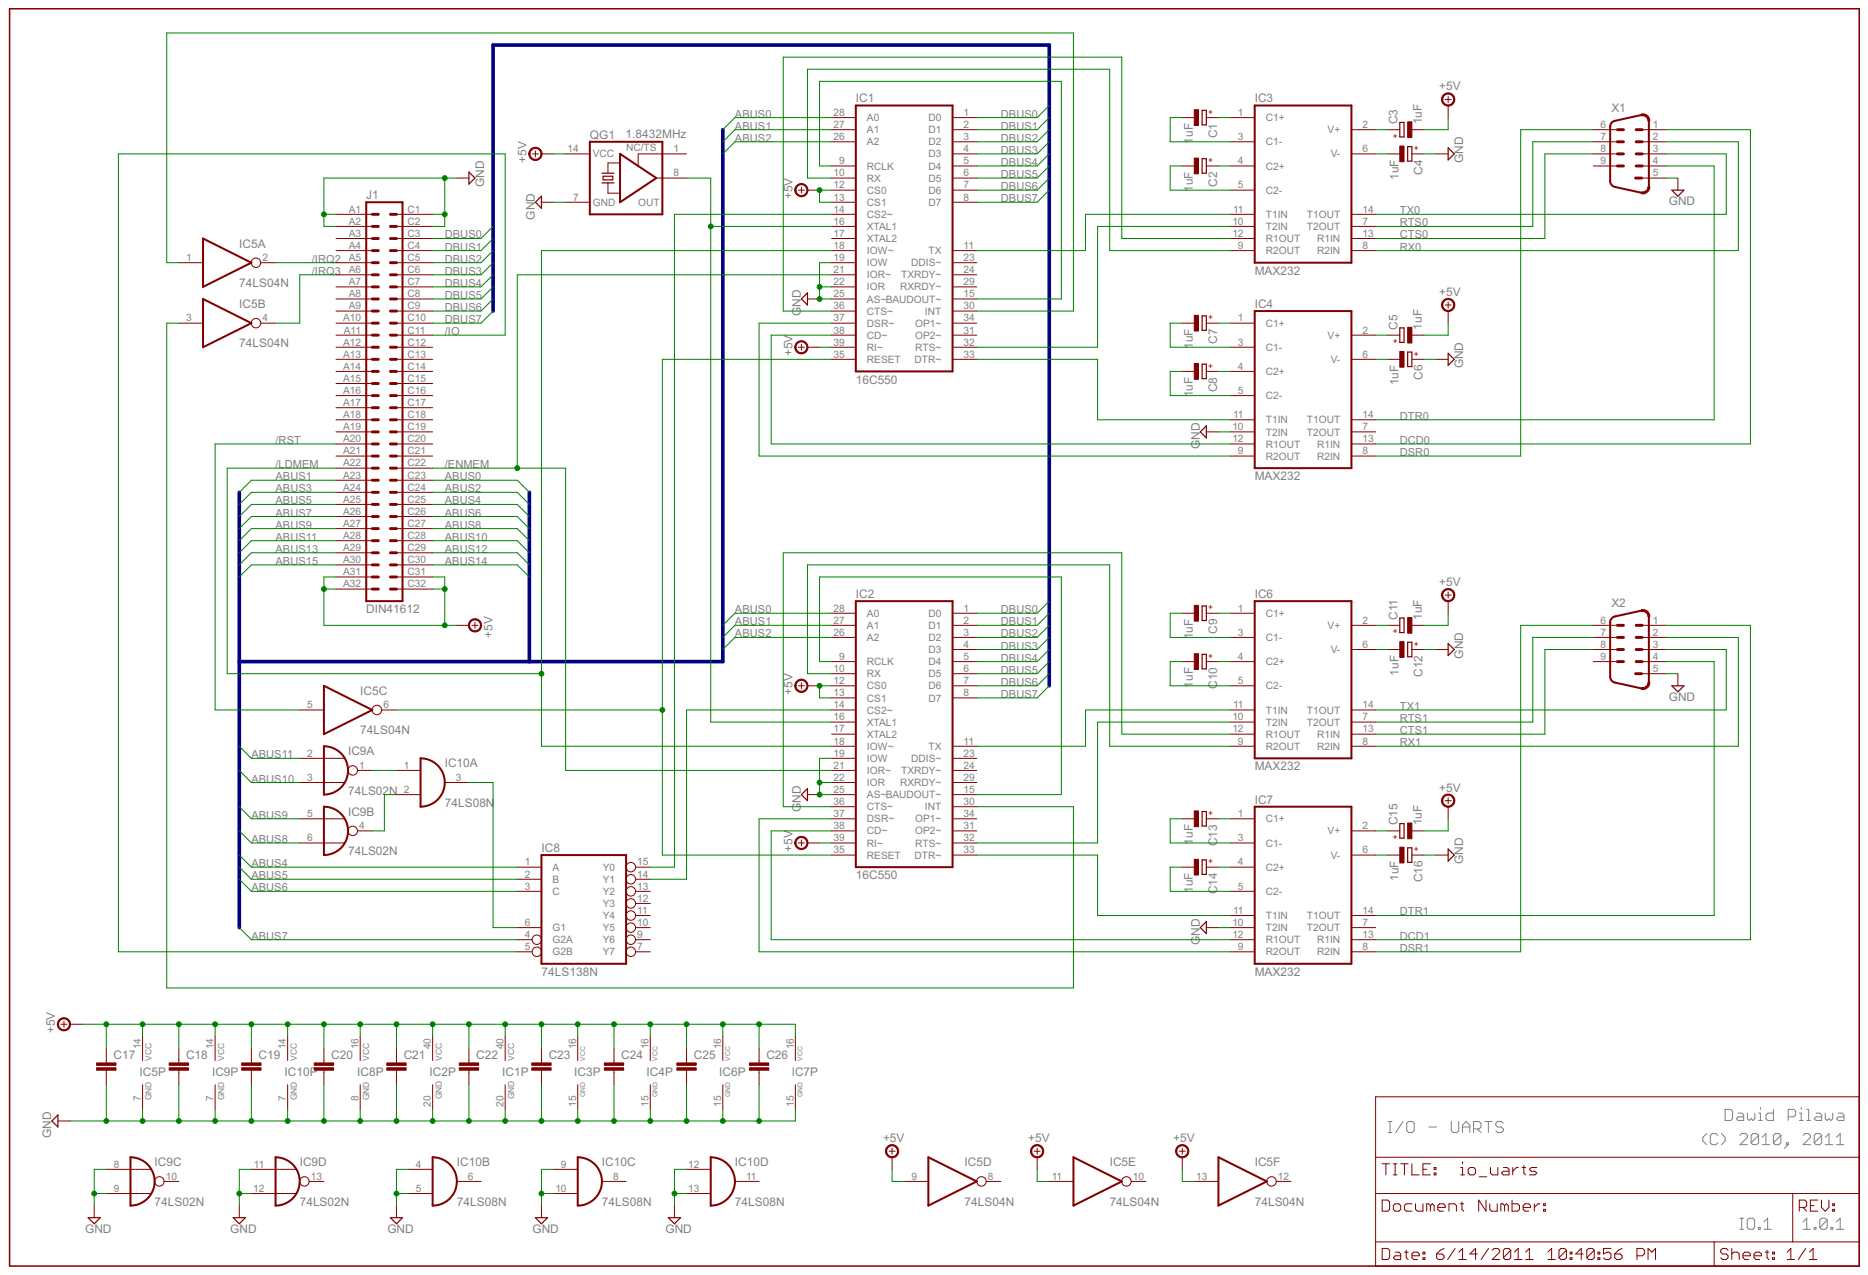
[picture p28: page 10]
