dpilawa/bytec/schematics/schematics_20141206.pdf

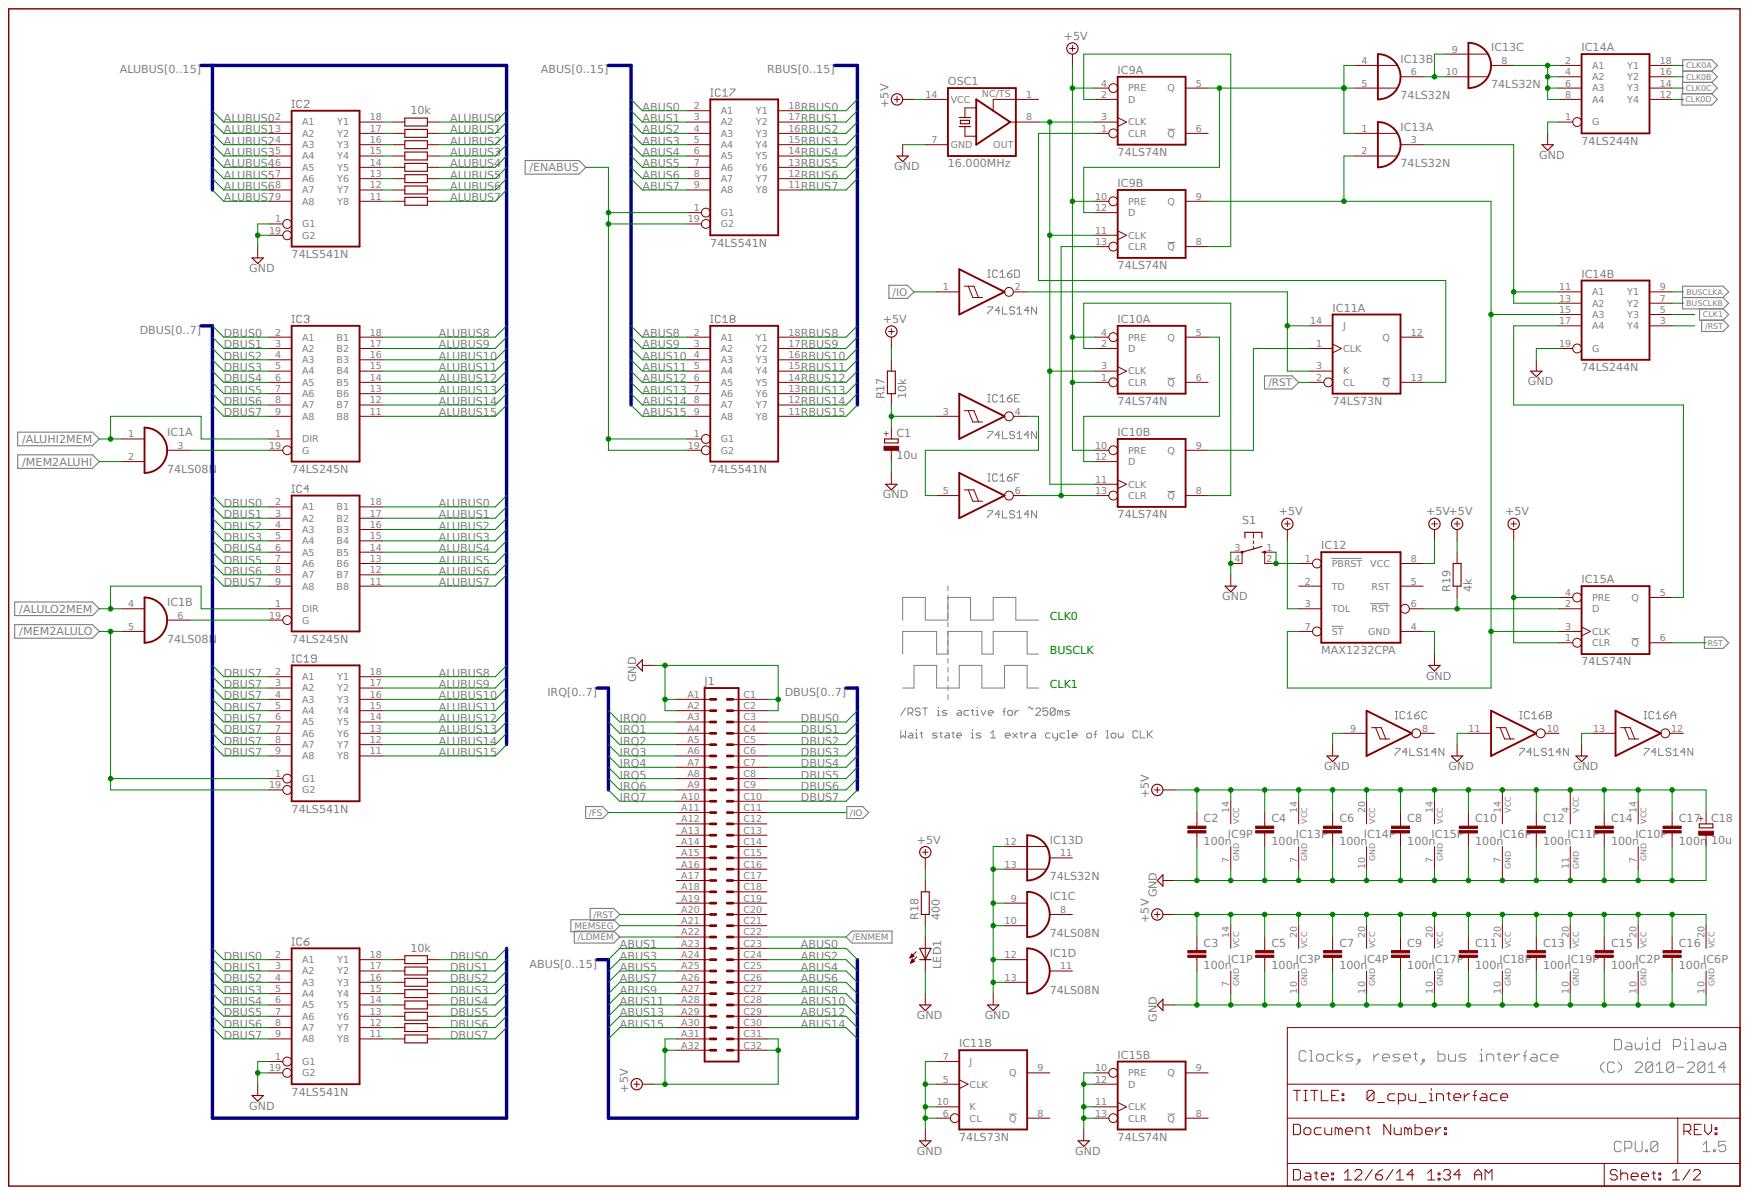
[picture p29: page 1]

# BOARD CONNECTORS

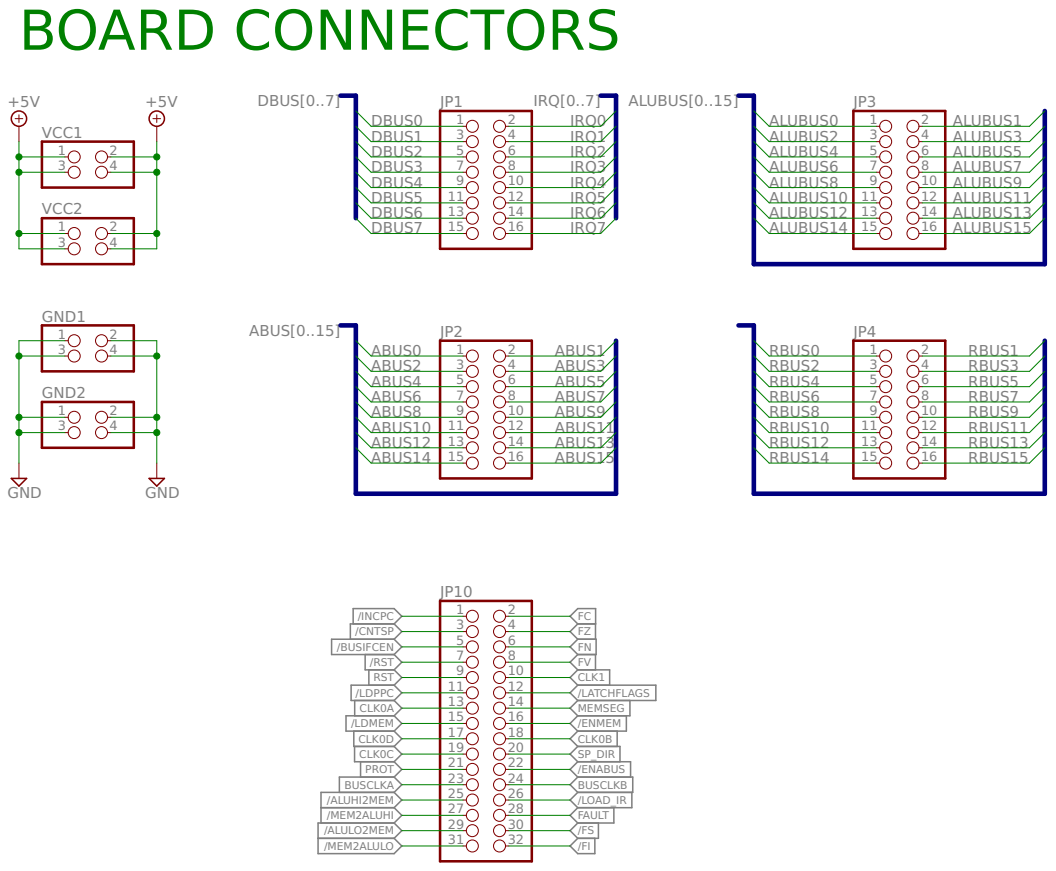
[picture p30: page 2]
GND; VCC1; VCC2; 4 GND1; 4 GND2; DBUS[0..7]; IRQ[0..7]; ALUBUS[0..15]; ABUS[0..15]; /ALUHI2MEM; /ALULO2MEM; /MEM2ALUHI /MEM2ALULO; DBUS0 DBUS1 DBUS2 DBUS3 DBUS4 DBUS5 DBUS6 DBUS7; ALUBUS8; ALUBUS9; ALUBUS10; ALUBUS11; ALUBUS12; ALUBUS13; ALUBUS14; ALUBUS15; ALUBUS0; ALUBUS1; ALUBUS2; ALUBUS3; ALUBUS4; ALUBUS5; ALUBUS6; ALUBUS7; /ENABUS; ABUS0; ABUS1; ABUS2; ABUS3; ABUS4; ABUS5; ABUS6; ABUS7; ABUS8; ABUS9; ABUS10; ABUS11; ABUS12; ABUS13; ABUS14; ABUS15; RBUS0; RBUS1; RBUS2; RBUS3; RBUS4; RBUS5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

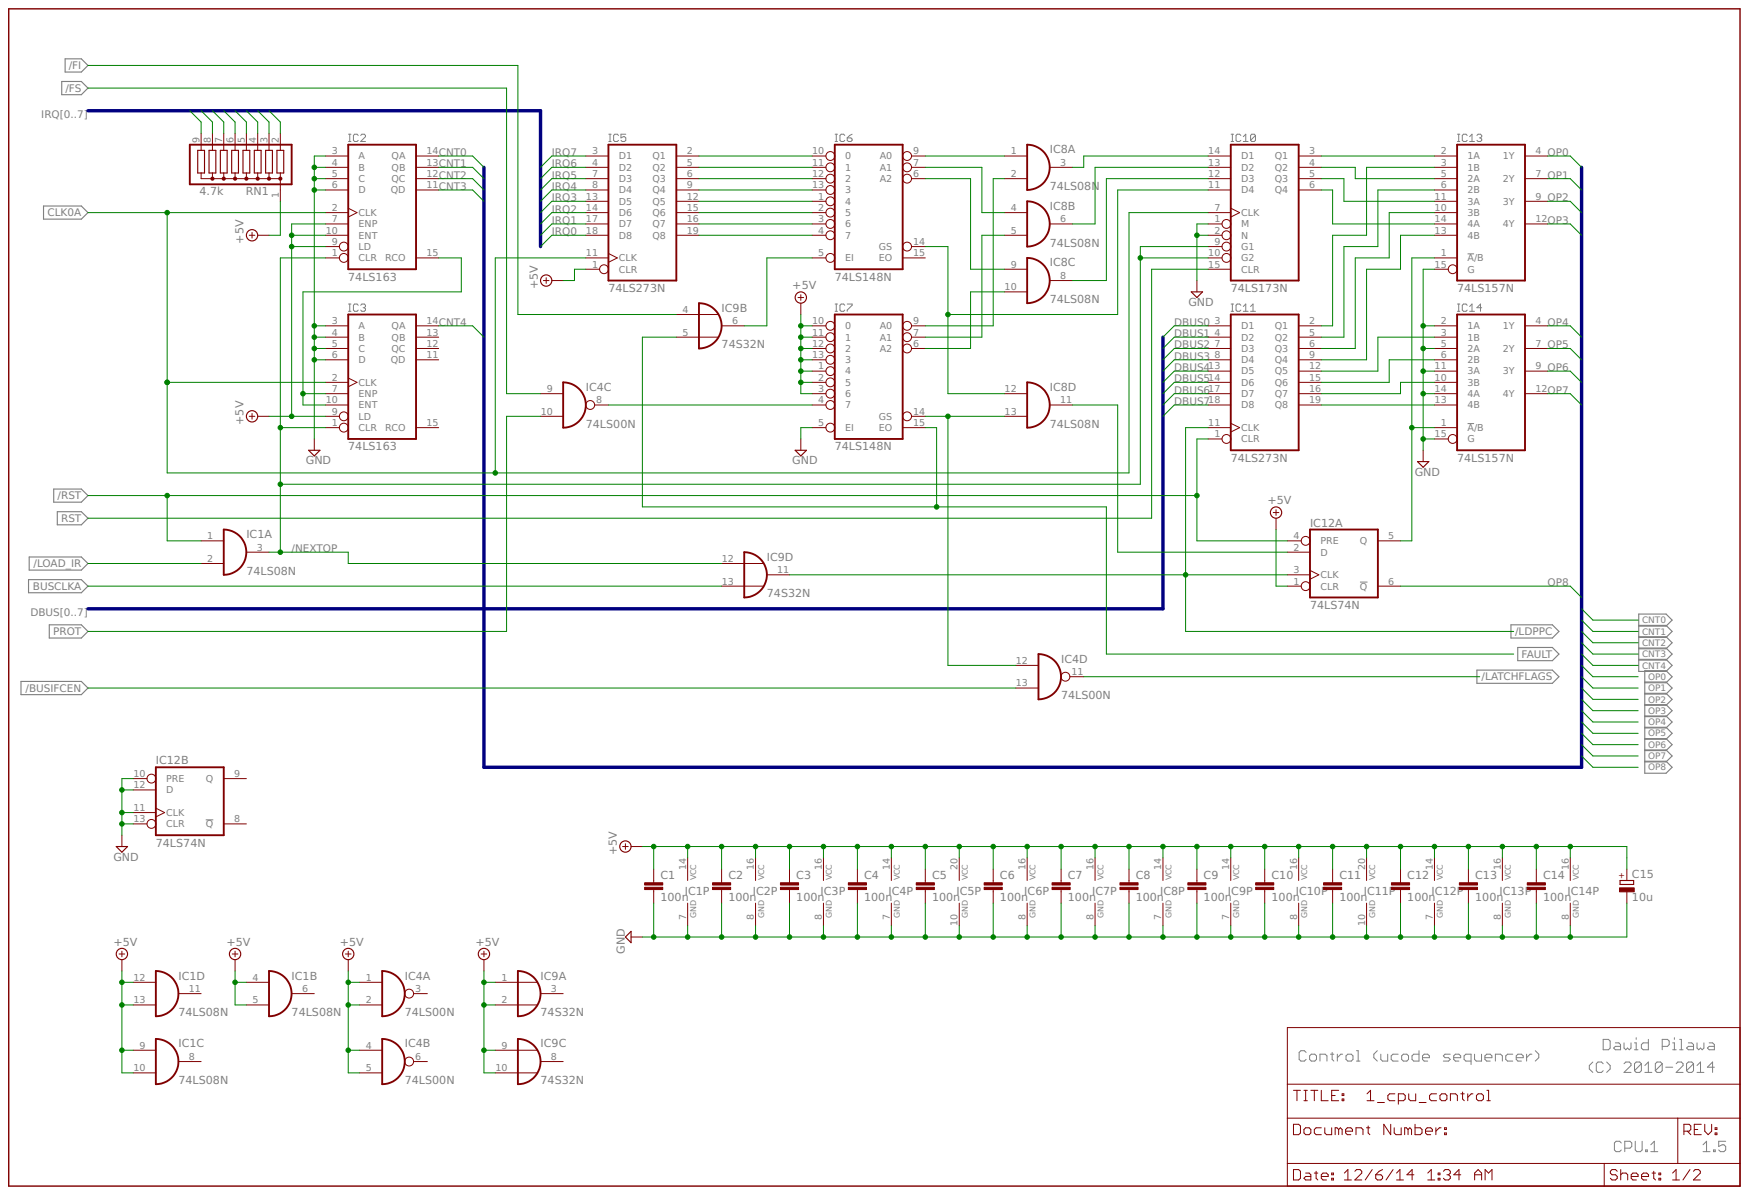
[picture p31: page 3]

# BOARD CONNECTORS

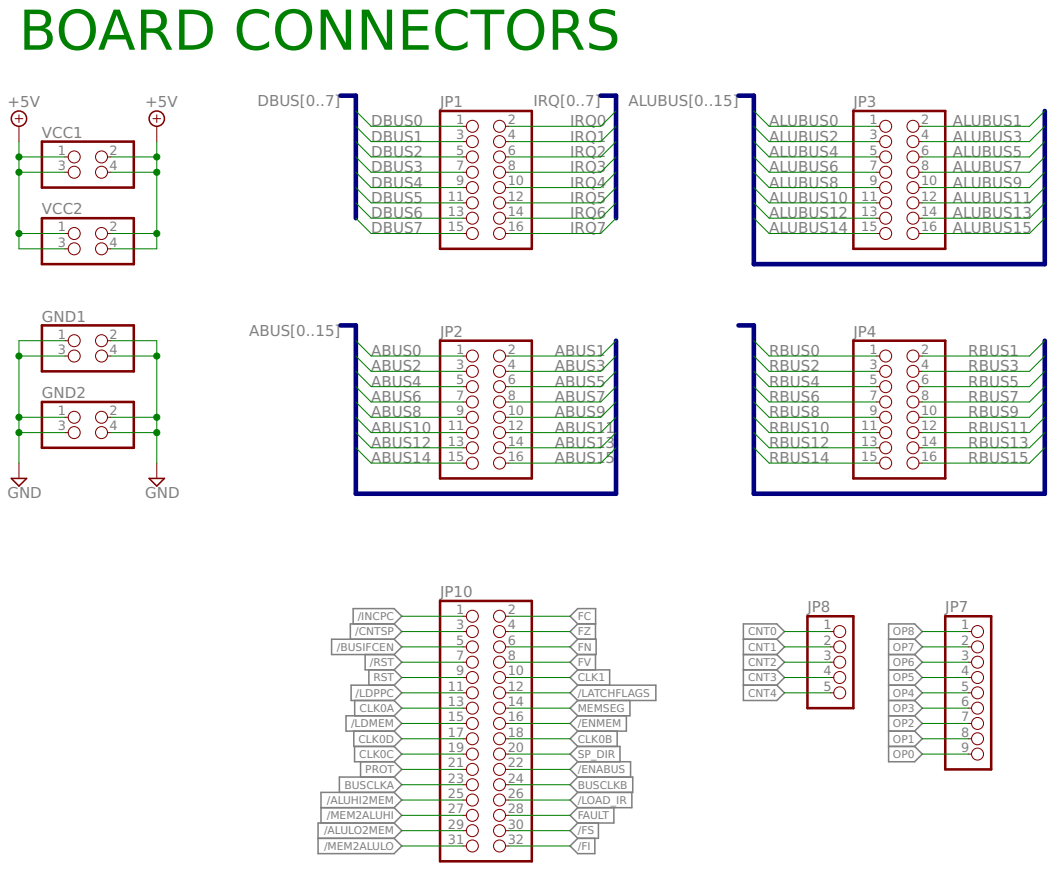
[picture p32: page 4]
GND; VCC1; 4 VCC2; 4 GND1; 4 GND2; DBUS[0..7]; IRQ[0..7]; ALUBUS[0..15]; ABUS[0..15]; CNT0 CNT1 CNT2 CNT3 CNT4; /RST; FAULT; IRQ0 IRQ1; IRQ3 IRQ4 IRQ5; IRQ7; DBUS0 DBUS1 DBUS2 DBUS3; DBUS5 DBUS6 DBUS7; RST; /LOAD_IR; /BUSIFCEN; /LDPPC; BUSCLKA; CLK0A; PROT; DBUS4; IRQ2; IRQ6; /LATCHFLAGS; /ALUHI2MEM; /ALULO2MEM; /MEM2ALUHI /MEM2ALULO; ALUBUS8; ALUBUS9; ALUBUS10; ALUBUS11; ALUBUS12; ALUBUS13; ALUBUS14; ALUBUS15; ALUBUS0; ALUBUS1; ALUBUS2; ALUBUS3; ALUBUS4; ALUBUS5; ALUBUS6; ALUBUS7; /ENABUS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

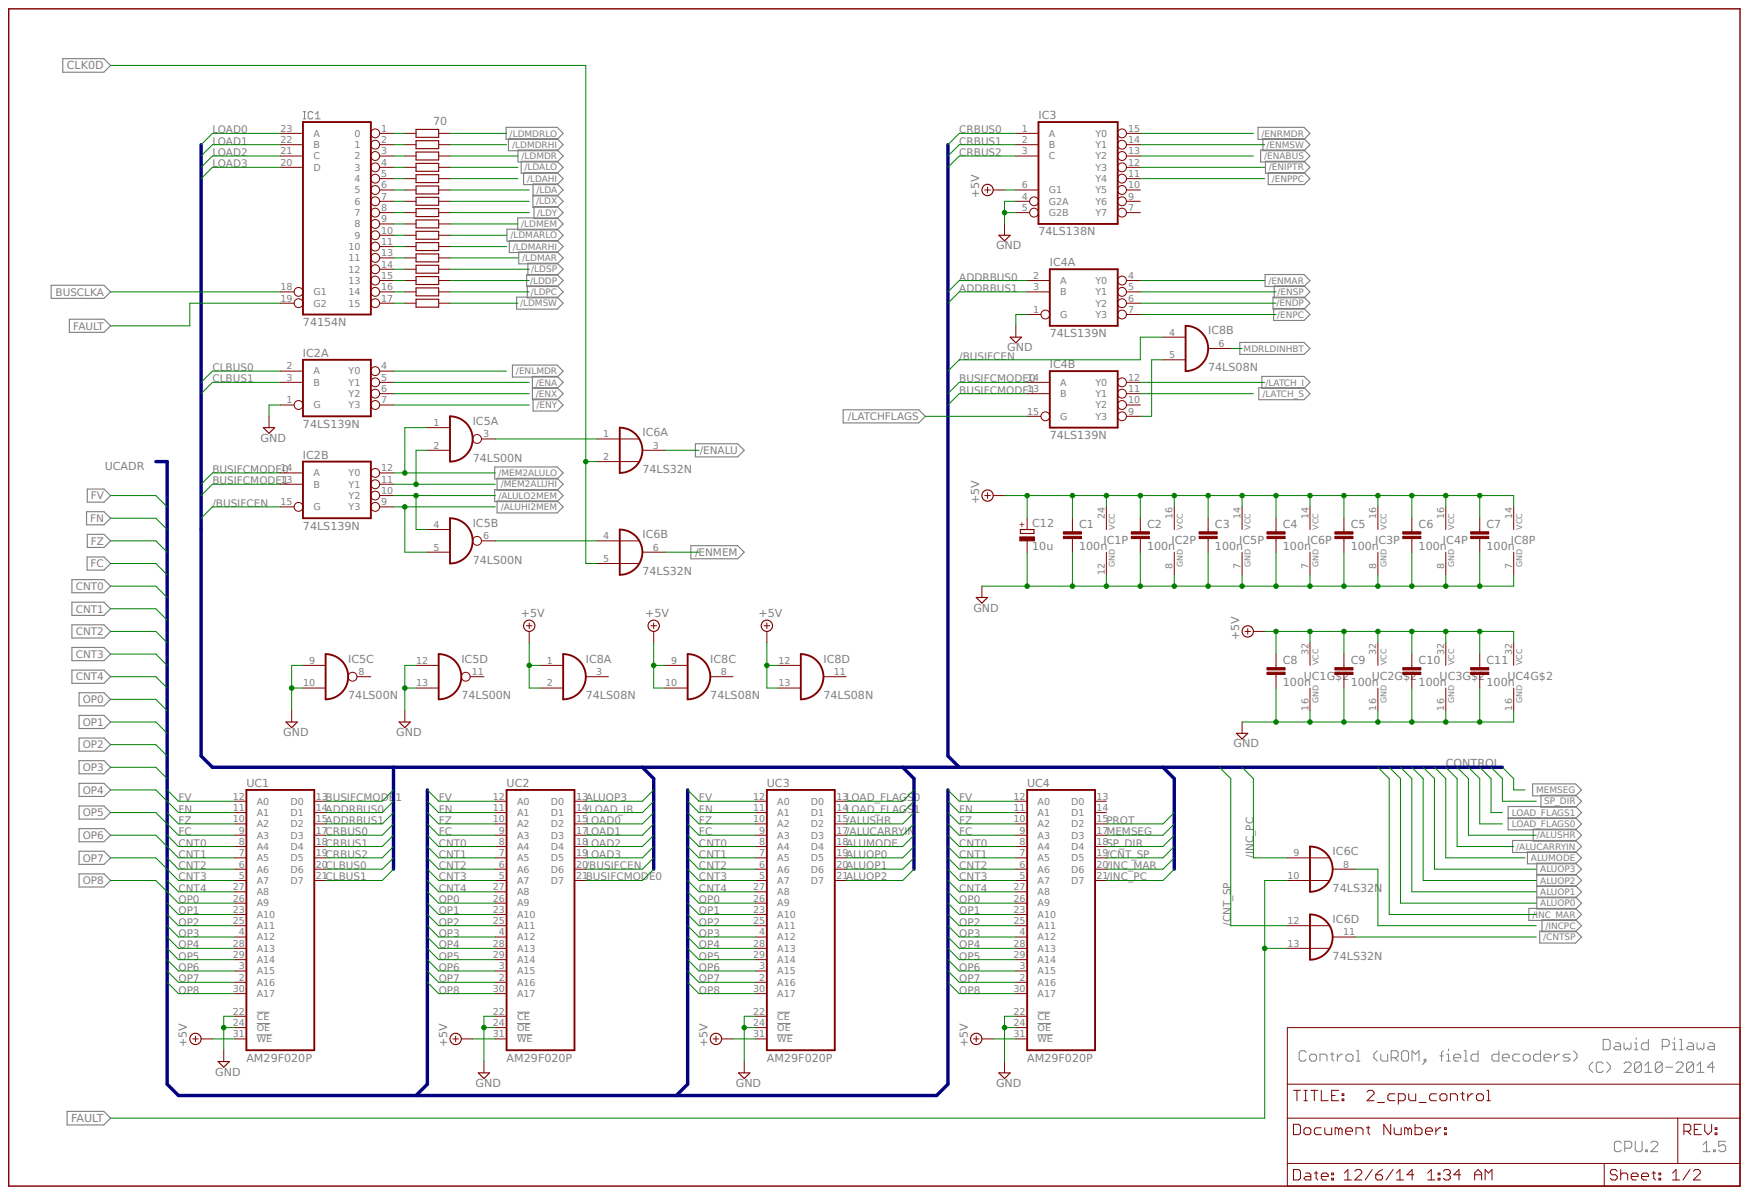
[picture p33: page 5]

# BOARD CONNECTORS

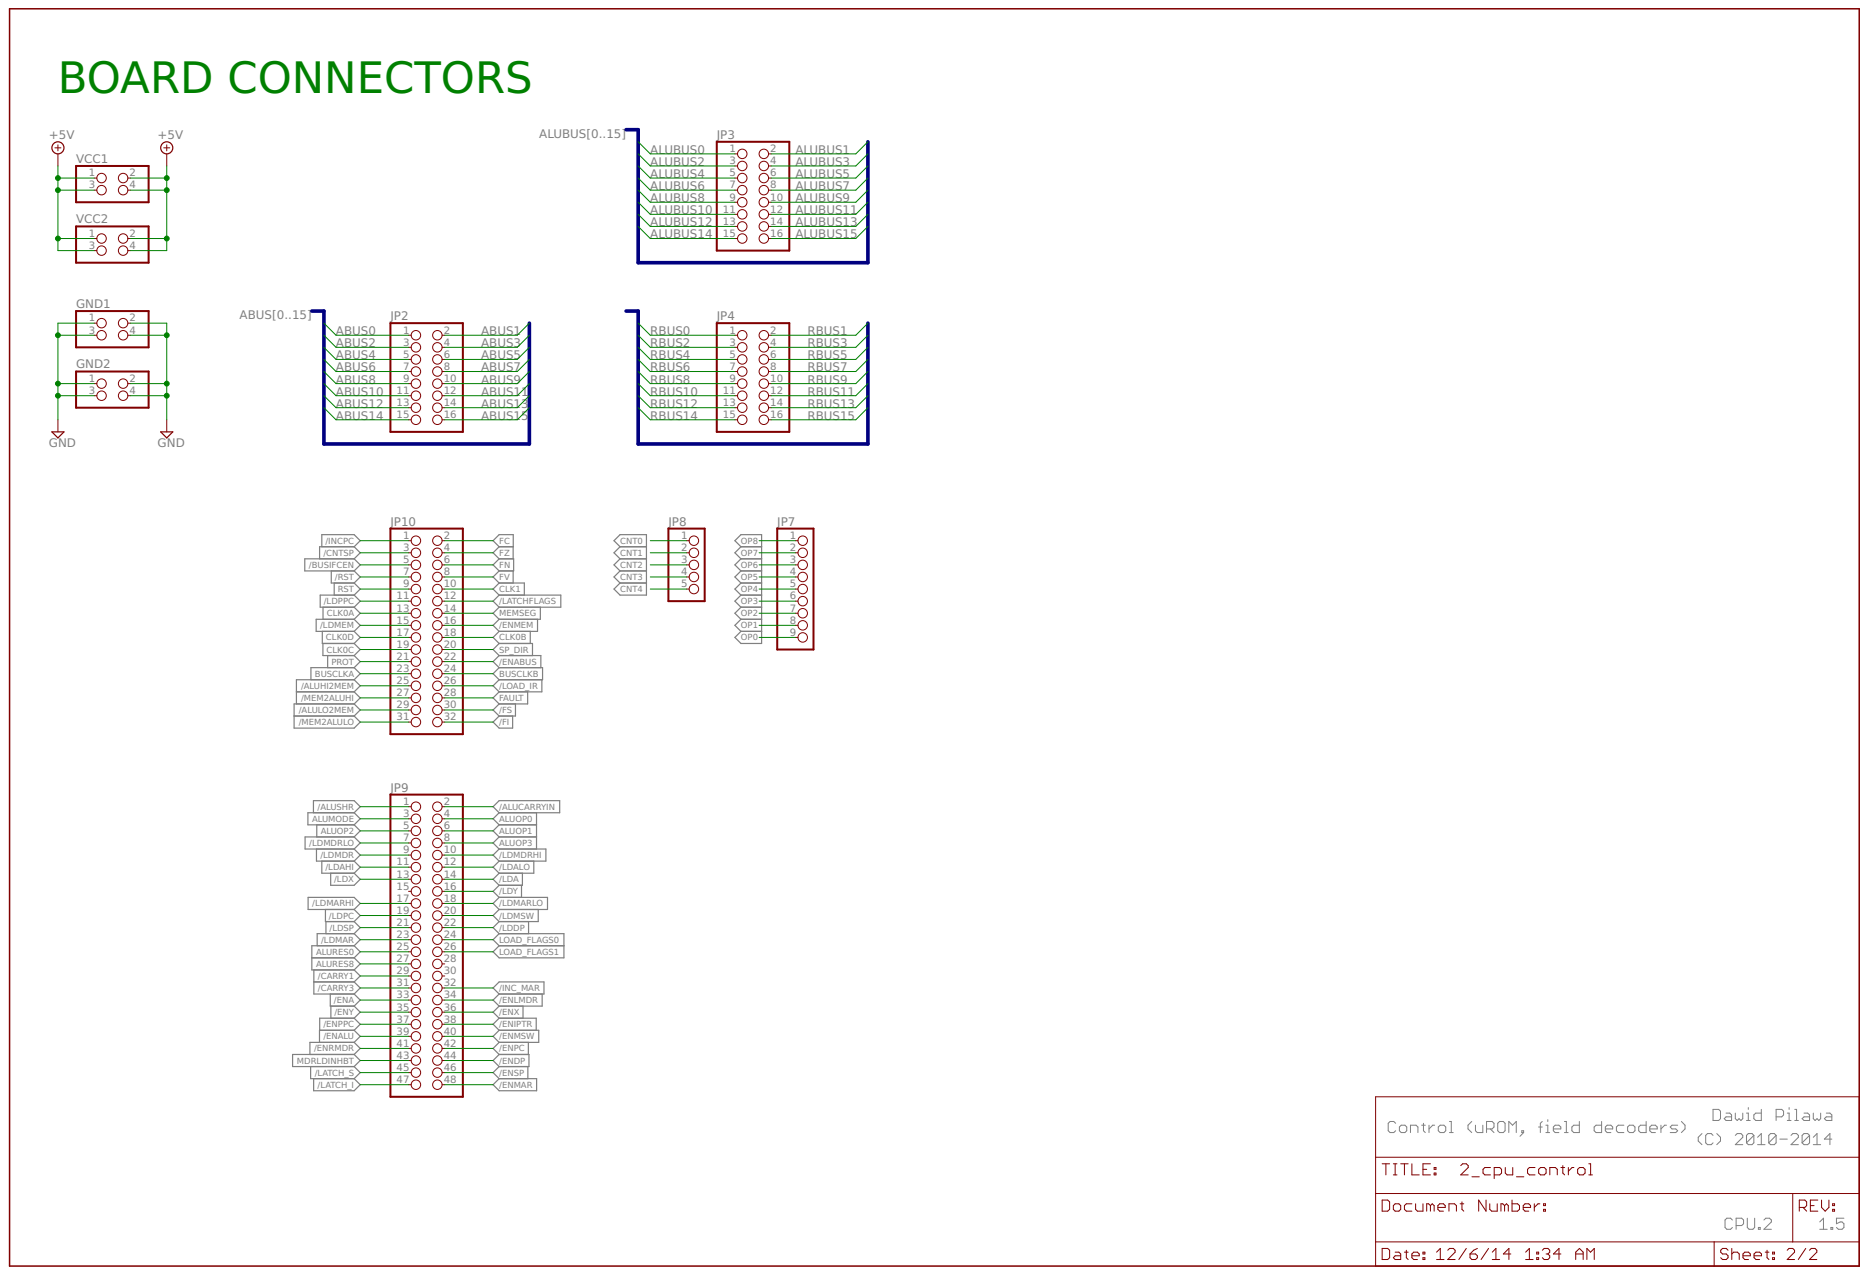
[picture p34: page 6]
GND; VCC1; VCC2; 4 GND1; 4 GND2; ALUBUS[0..15]; ABUS[0..15]; CNT0 CNT1 CNT2 CNT3 CNT4; /RST; FAULT; RST; /LOAD_IR; /BUSIFCEN; ALUOP3 ALUOP2; ALUOP1 ALUMODE; ALUOP0; /ALUSHR; /ALUCARRYIN; LOAD_FLAGS1; LOAD_FLAGS0; /INC_MAR; SP_DIR MEMSEG; /CNTSP; /INCPC; /LDPPC; BUSCLKA; CLK0A; PROT; /LATCHFLAGS; /ALUHI2MEM; /ALULO2MEM; /MEM2ALUHI /MEM2ALULO; ALUBUS8; ALUBUS9; ALUBUS10; ALUBUS11; ALUBUS12; ALUBUS13; ALUBUS14; ALUBUS15; ALUBUS0; ALUBUS1; ALUBUS2; ALUBUS3; ALUBUS4; ALUBUS5; ALUBUS6; ALUBUS7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

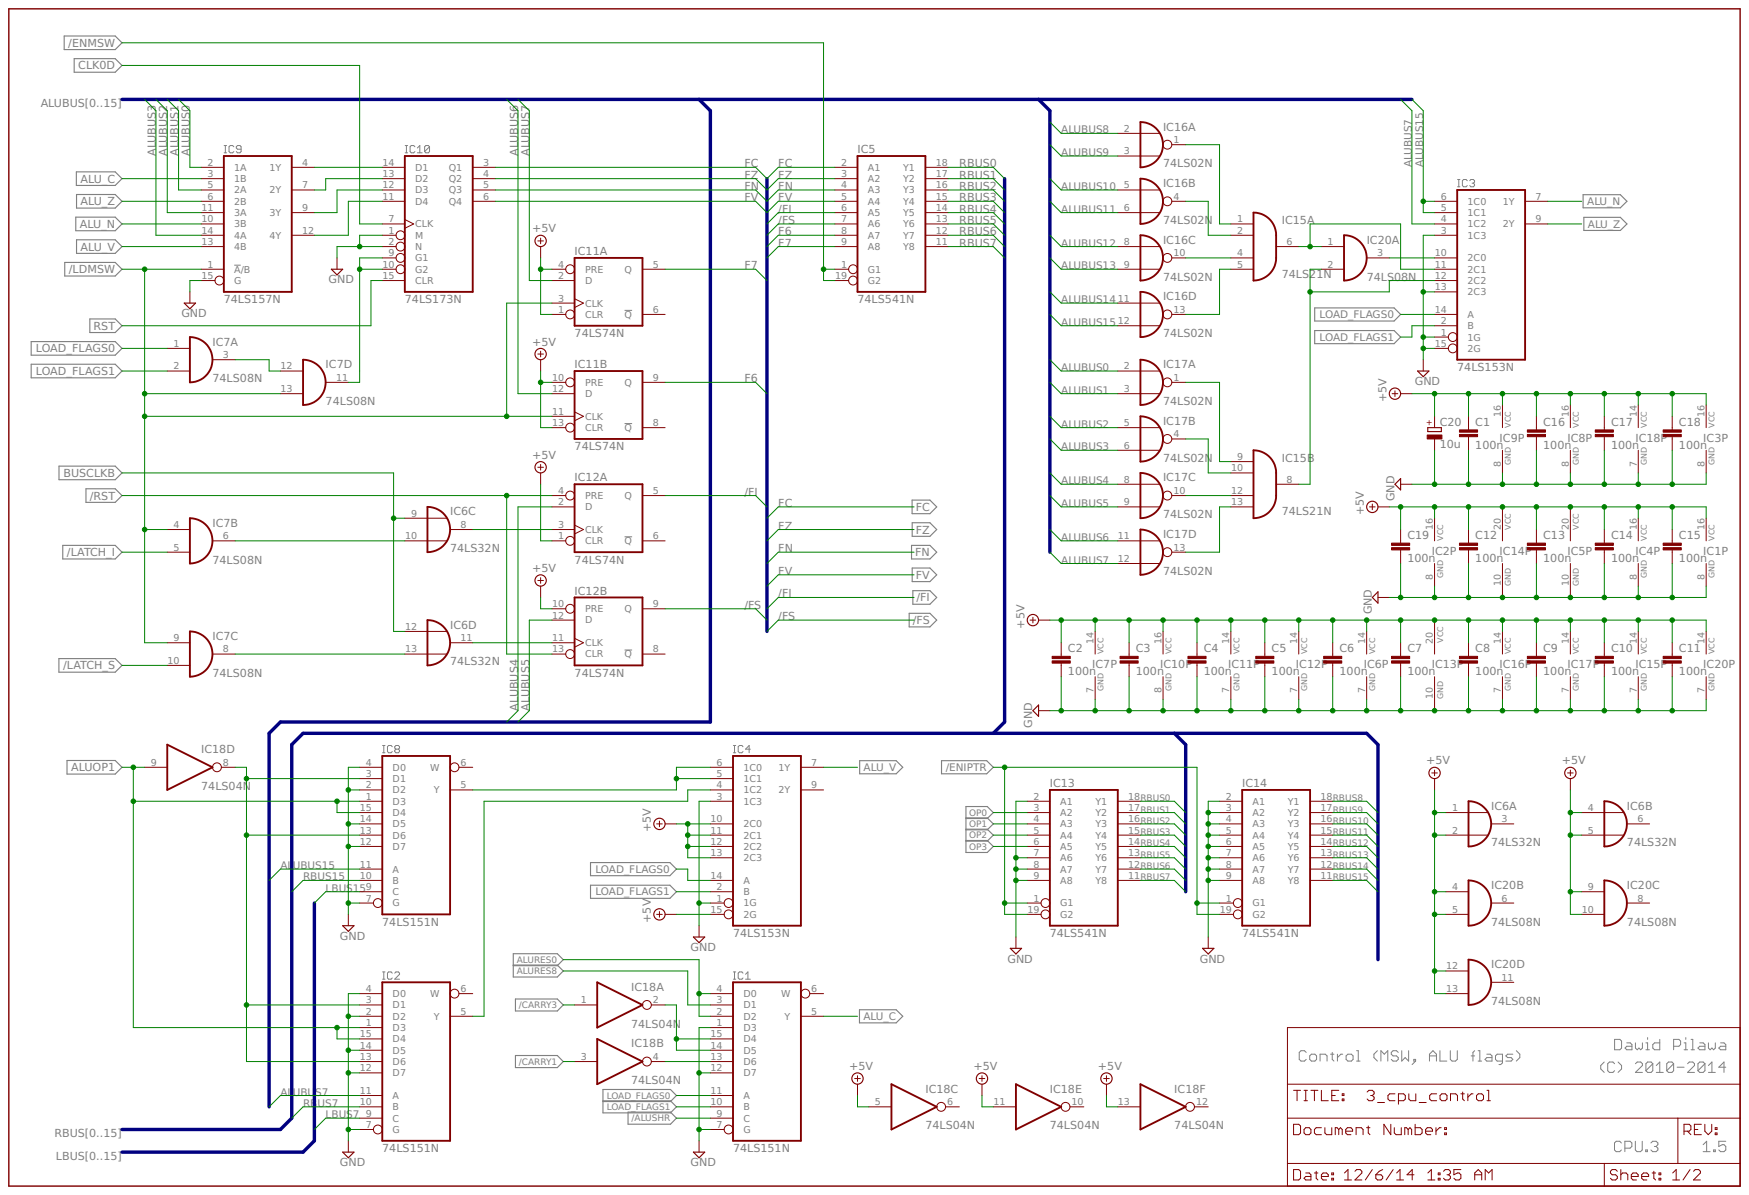
[picture p35: page 7]

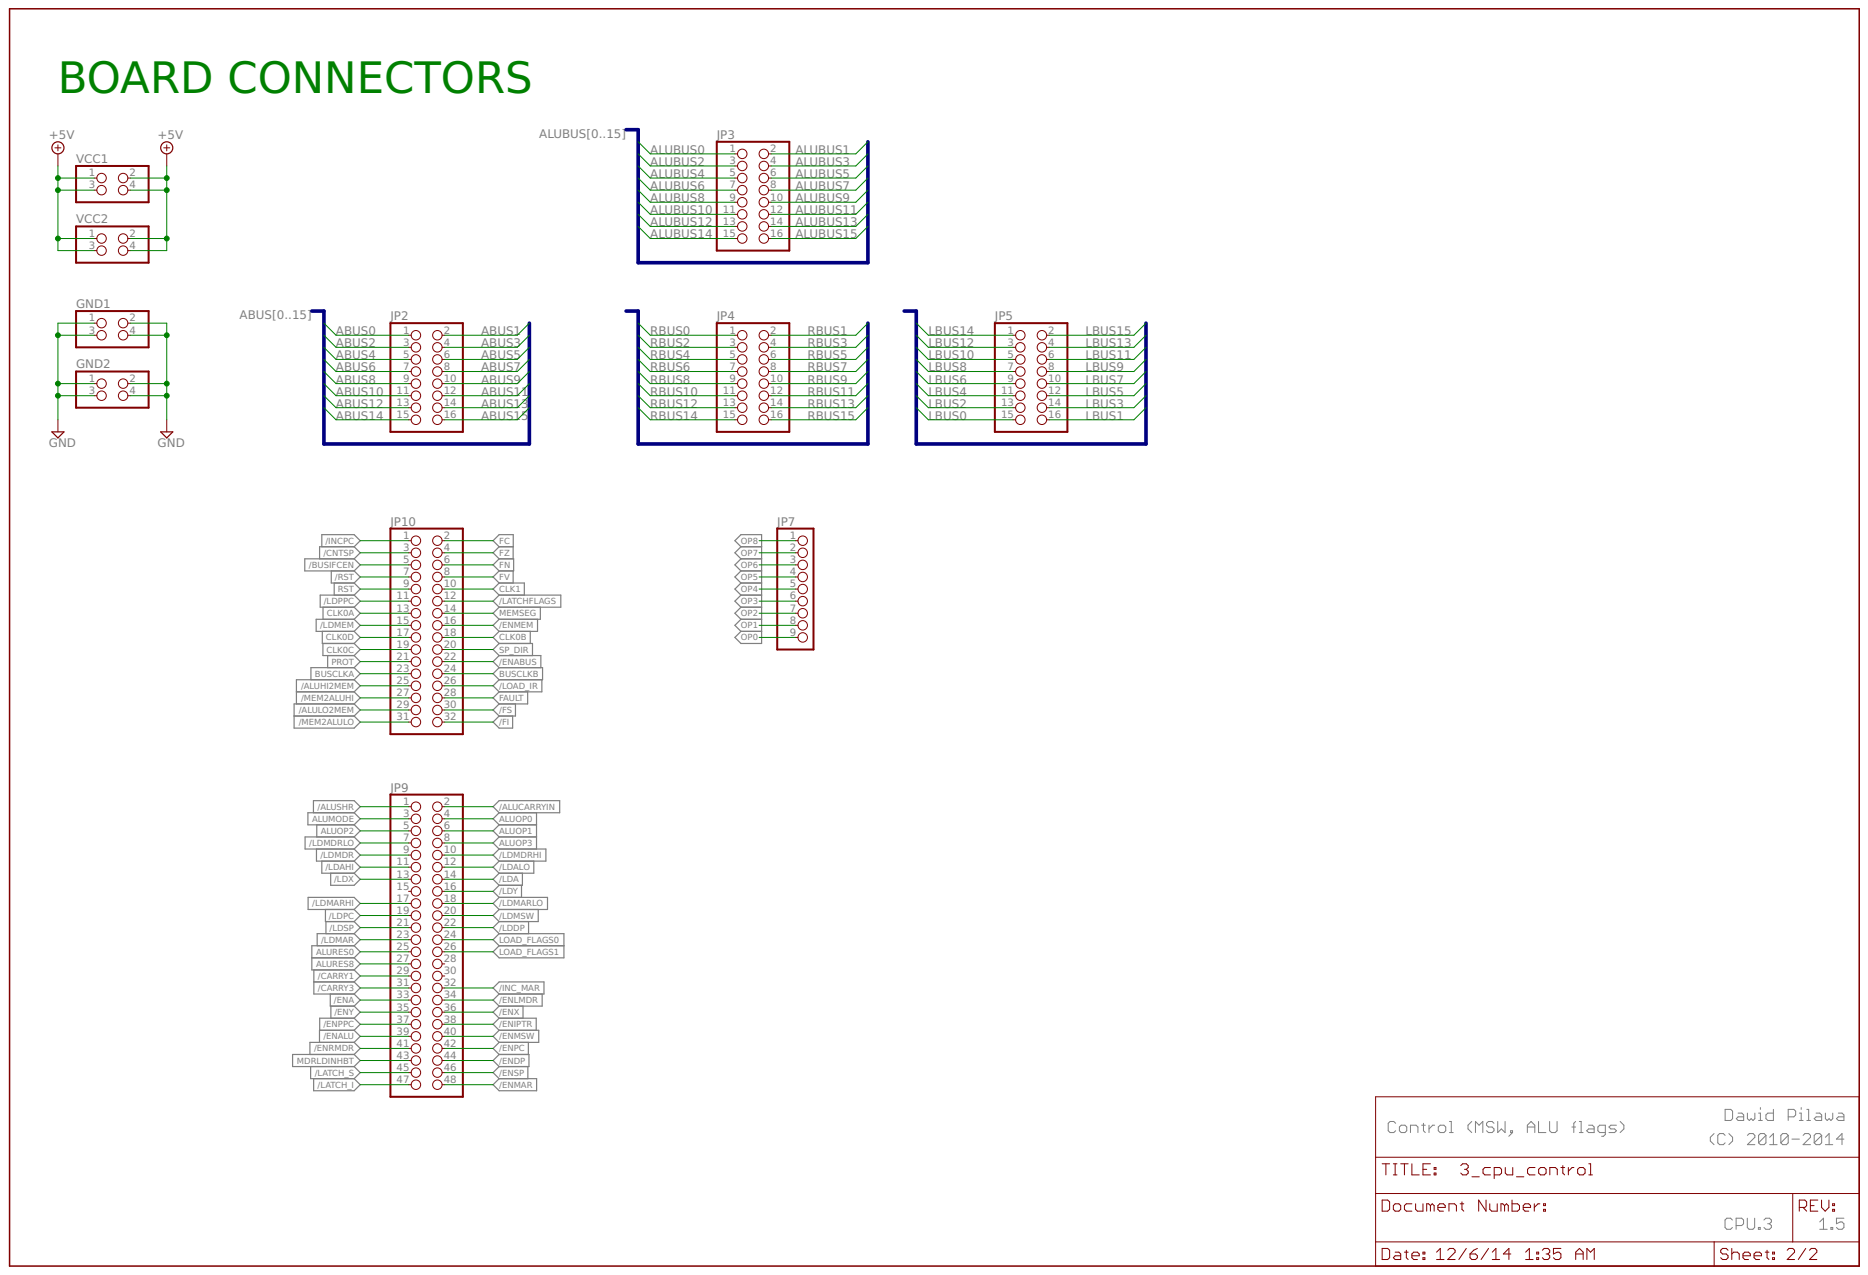
[picture p36: page 8]
+5V GND; GND VCC1 1; 16 VCC2 1; 4 GND1 1; 4 GND2 1; 16 ALUBUS[0..15] ABUS[0..15]; ALUBUS0; ALUBUS1 LOAD_FLAGS0 LOAD_FLAGS1 /LDMSW /LATCH_S /RST /LATCH_I; ALUBUS2; ALUBUS3 FCFZFNFV/FI /FS /ENMSW; RBUS0; RBUS1 RBUS2; RBUS3 RBUS4; RBUS5 RBUS6; RBUS7 RST; ALUBUS6; ALUBUS7 BUSCLKB; ALUBUS4; ALUBUS5 CLK0D ALURES0 ALURES8; ALUOP1 /ALUSHR; LBUS7 LBUS15 /CARRY1; RBUS15 /CARRY3; ALUBUS8; ALUBUS9 ALUBUS10; ALUBUS11 ALUBUS12; ALUBUS13 ALUBUS14; ALUBUS15 RBUS8; RBUS9 RBUS10; RBUS11 RBUS12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

4 G3

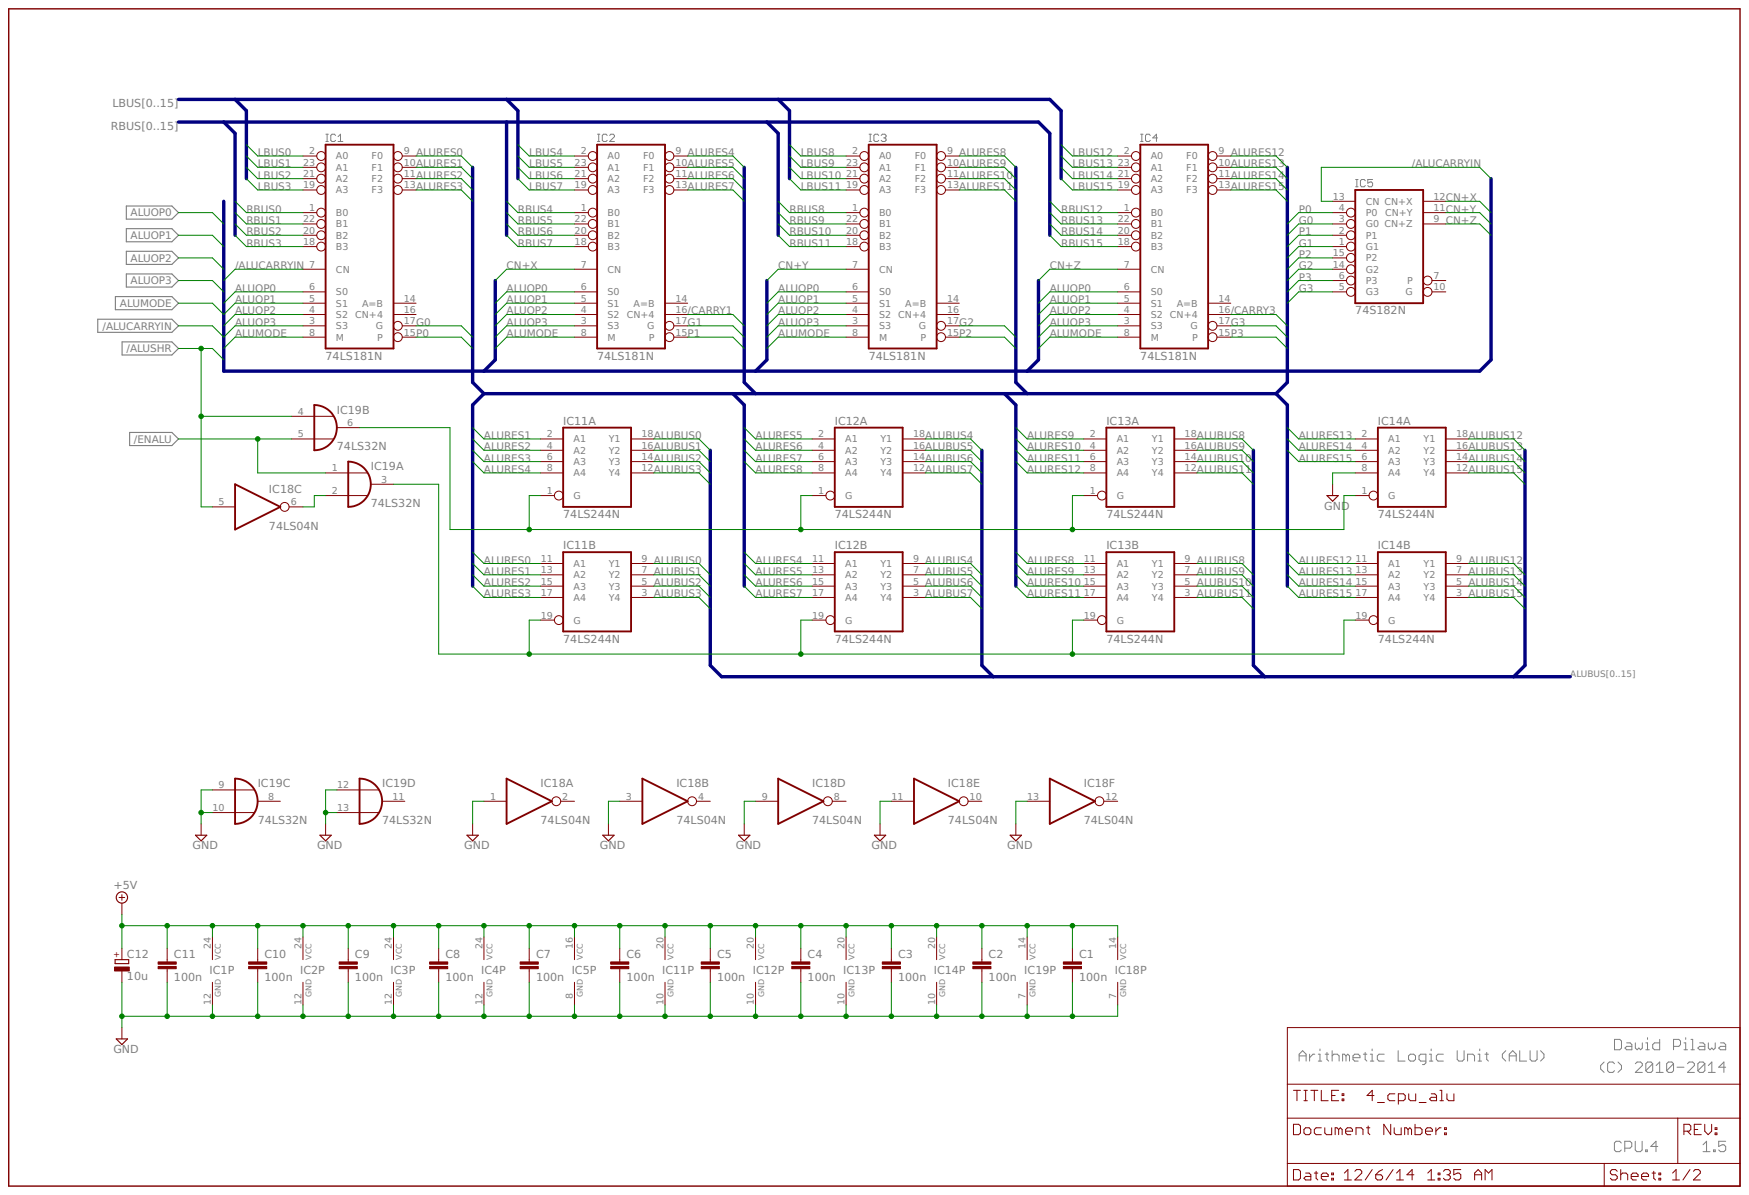
[picture p37: page 9]

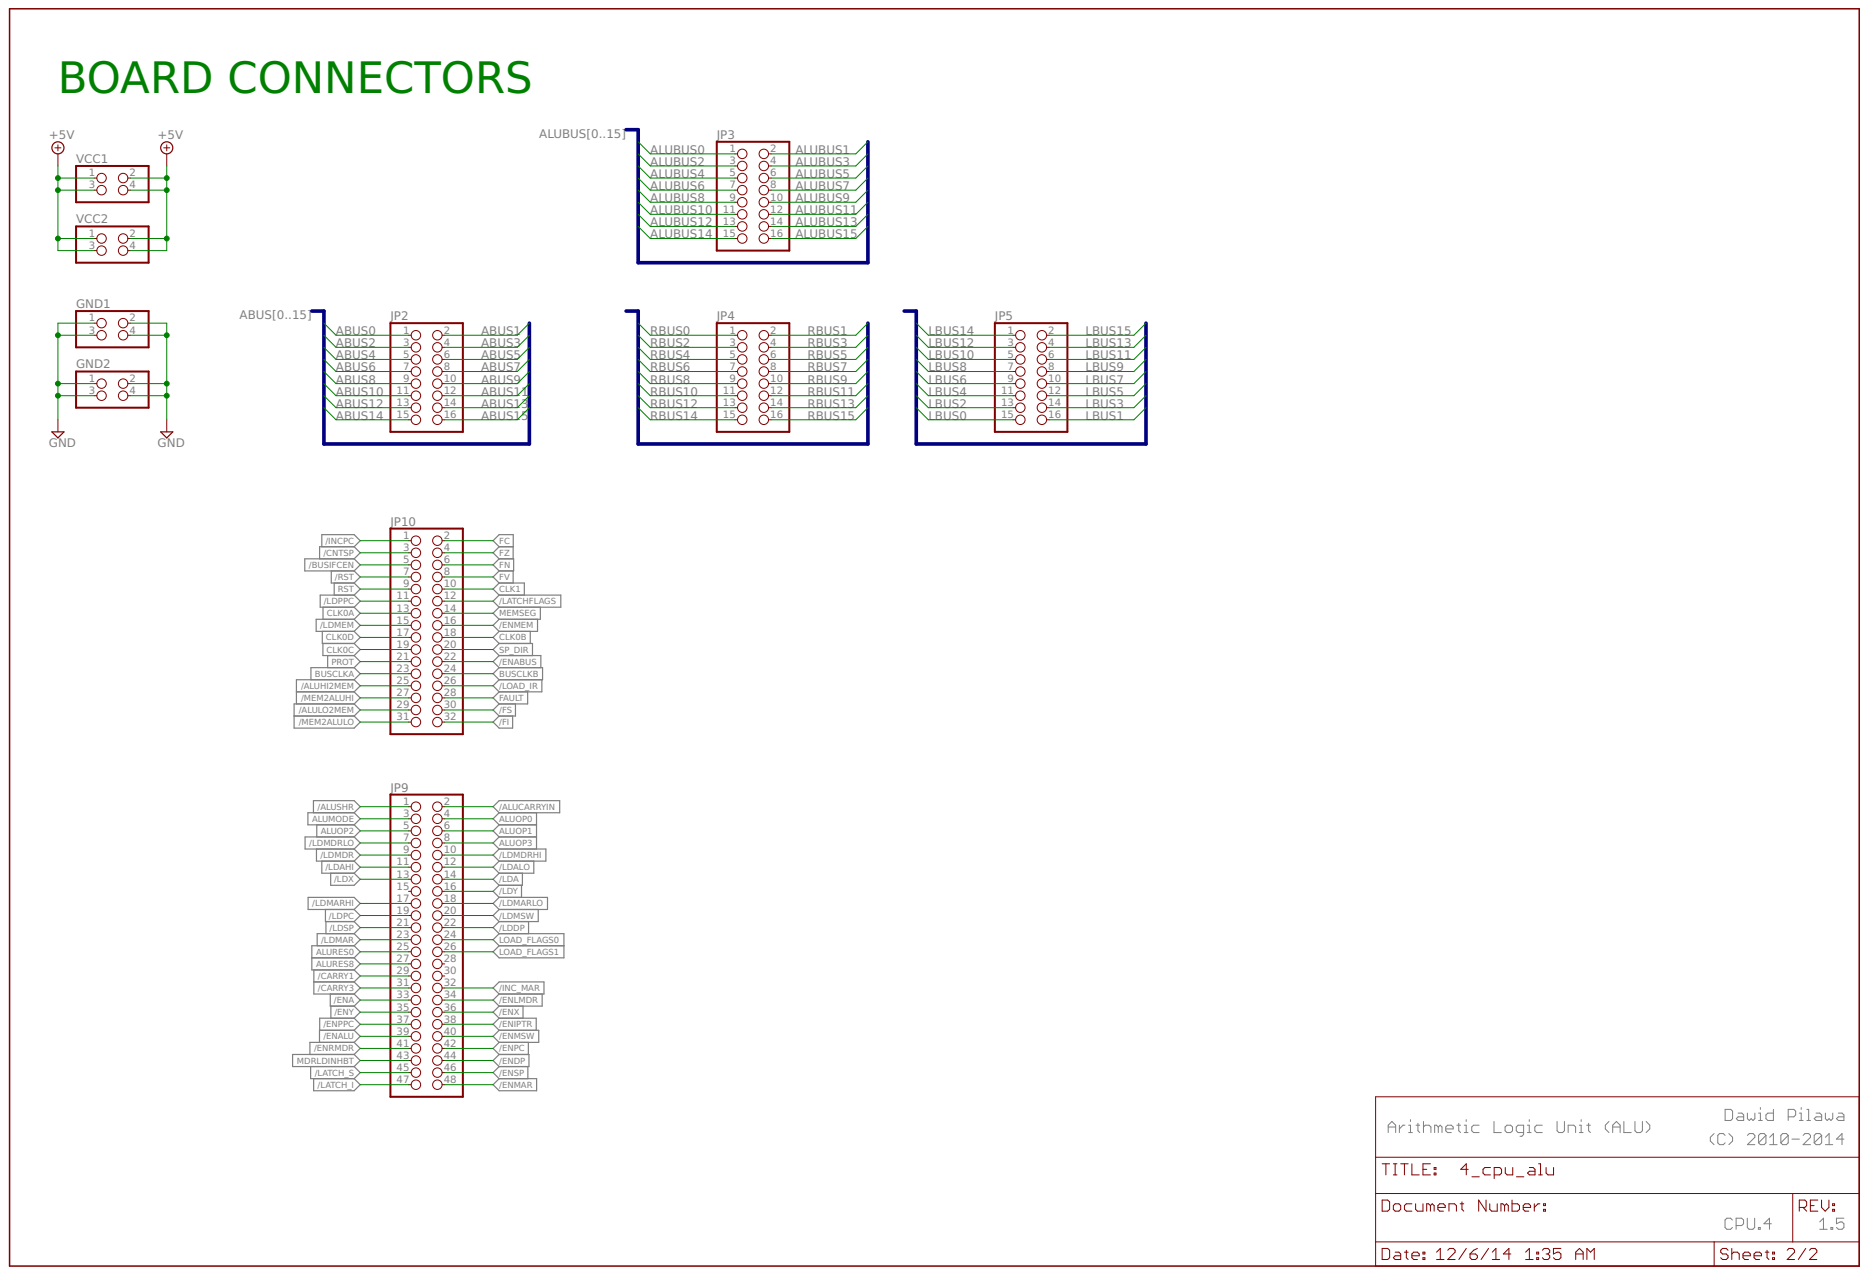
[picture p38: page 10]
+5V GND; GND VCC1 1; 16 VCC2 1; 4 GND1 1; 4 GND2 1; 16 ALUBUS[0..15] ABUS[0..15]; ALURES0 ALURES8; /ALUCARRYIN ALUOP0 ALUOP2; ALUOP1 ALUOP3 ALUMODE /ALUSHR /ENALU; LBUS0; LBUS1 LBUS2; LBUS3 RBUS0; RBUS1 RBUS2; RBUS3; LBUS4; LBUS5 LBUS6; LBUS7 RBUS4; RBUS5 RBUS6; RBUS7; LBUS8; LBUS9 LBUS10; LBUS11 RBUS8; RBUS9 RBUS10; RBUS11; LBUS12; LBUS13 LBUS14; LBUS15 /CARRY1; RBUS12; RBUS13 RBUS14; RBUS15 /CARRY3; ALUBUS0; ALUBUS1 ALUBUS2; ALUBUS3 ALUBUS4; ALUBUS5 ALUBUS6; ALUBUS7 ALUBUS8; ALUBUS9 ALUBUS10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

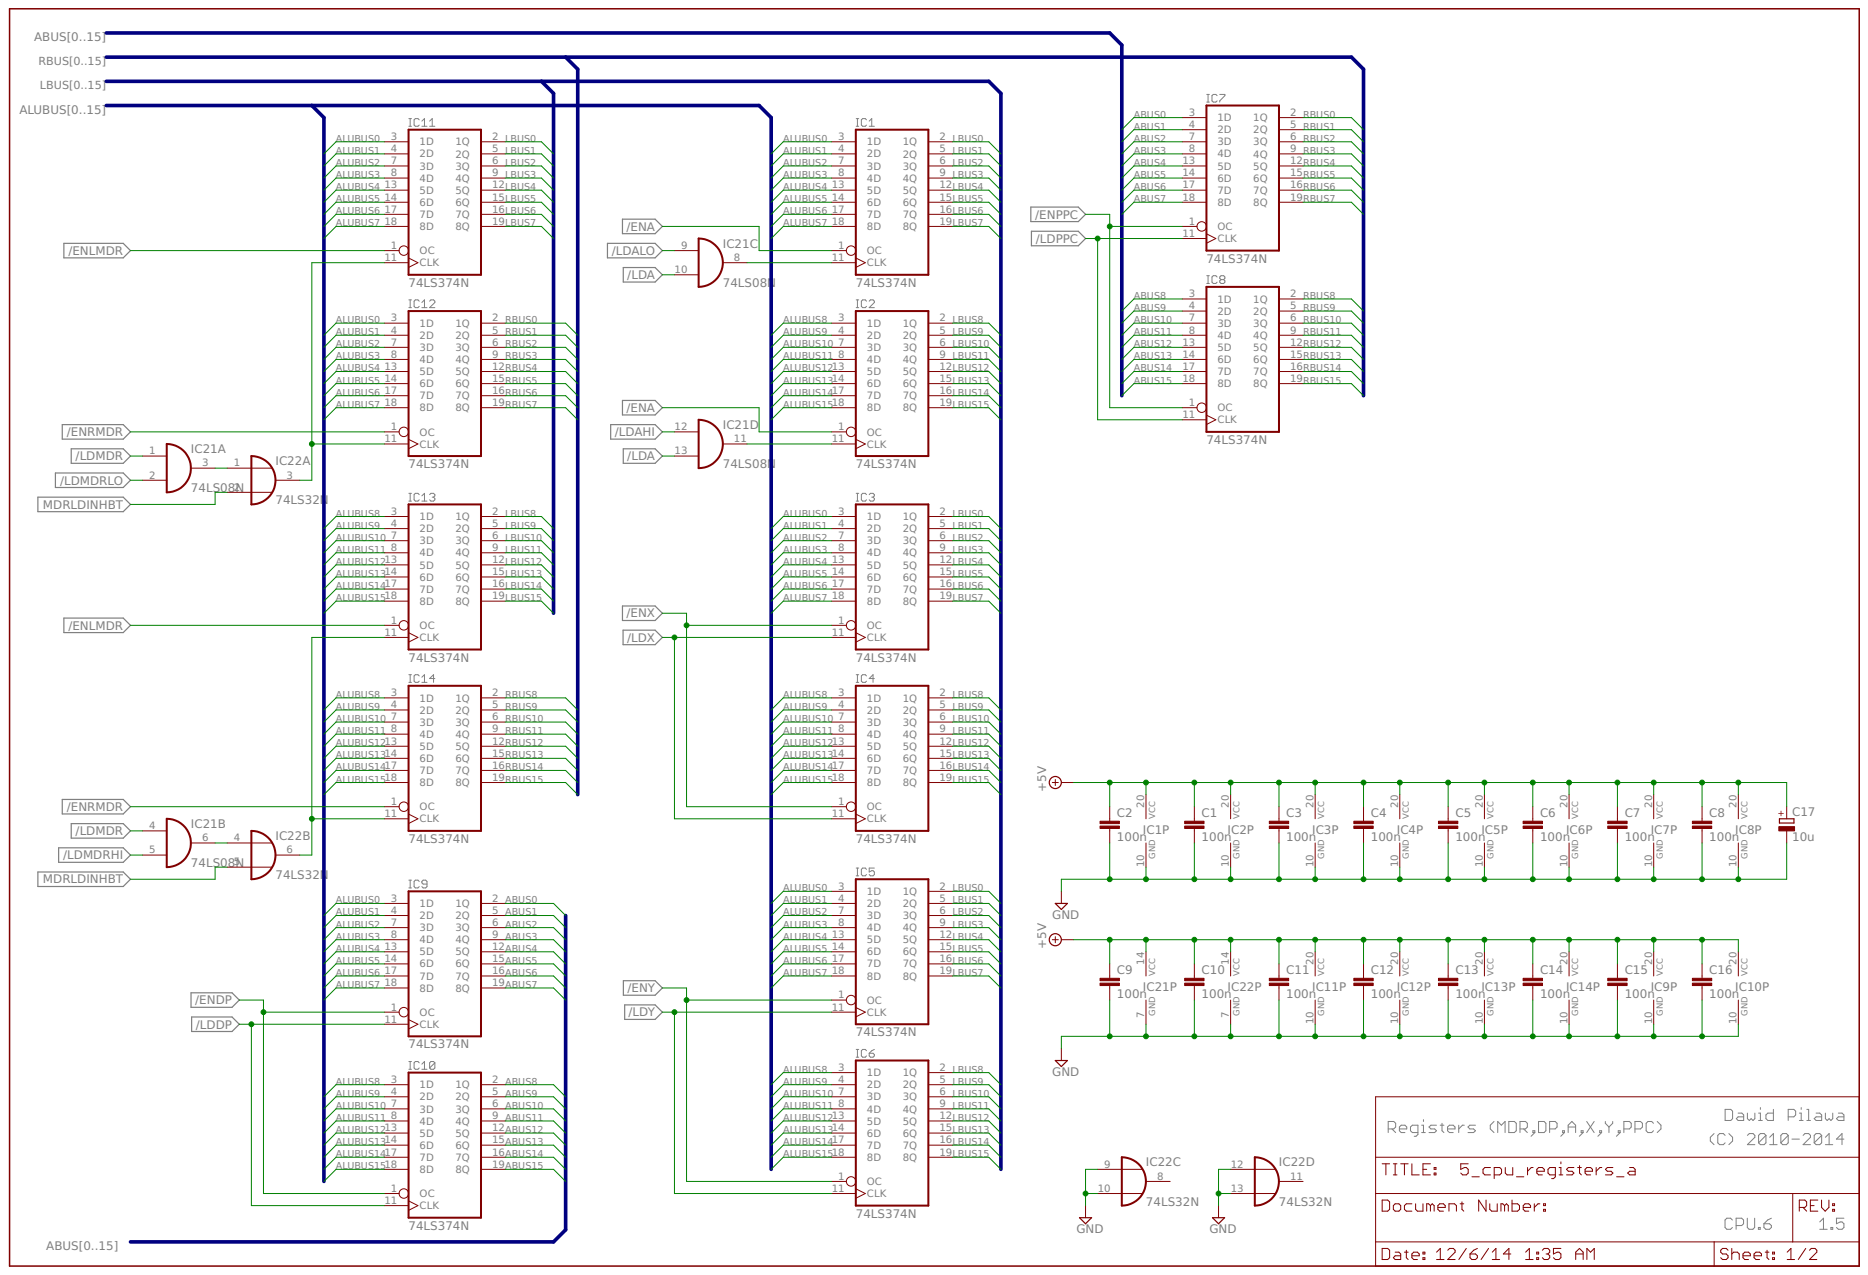
[picture p39: page 11]

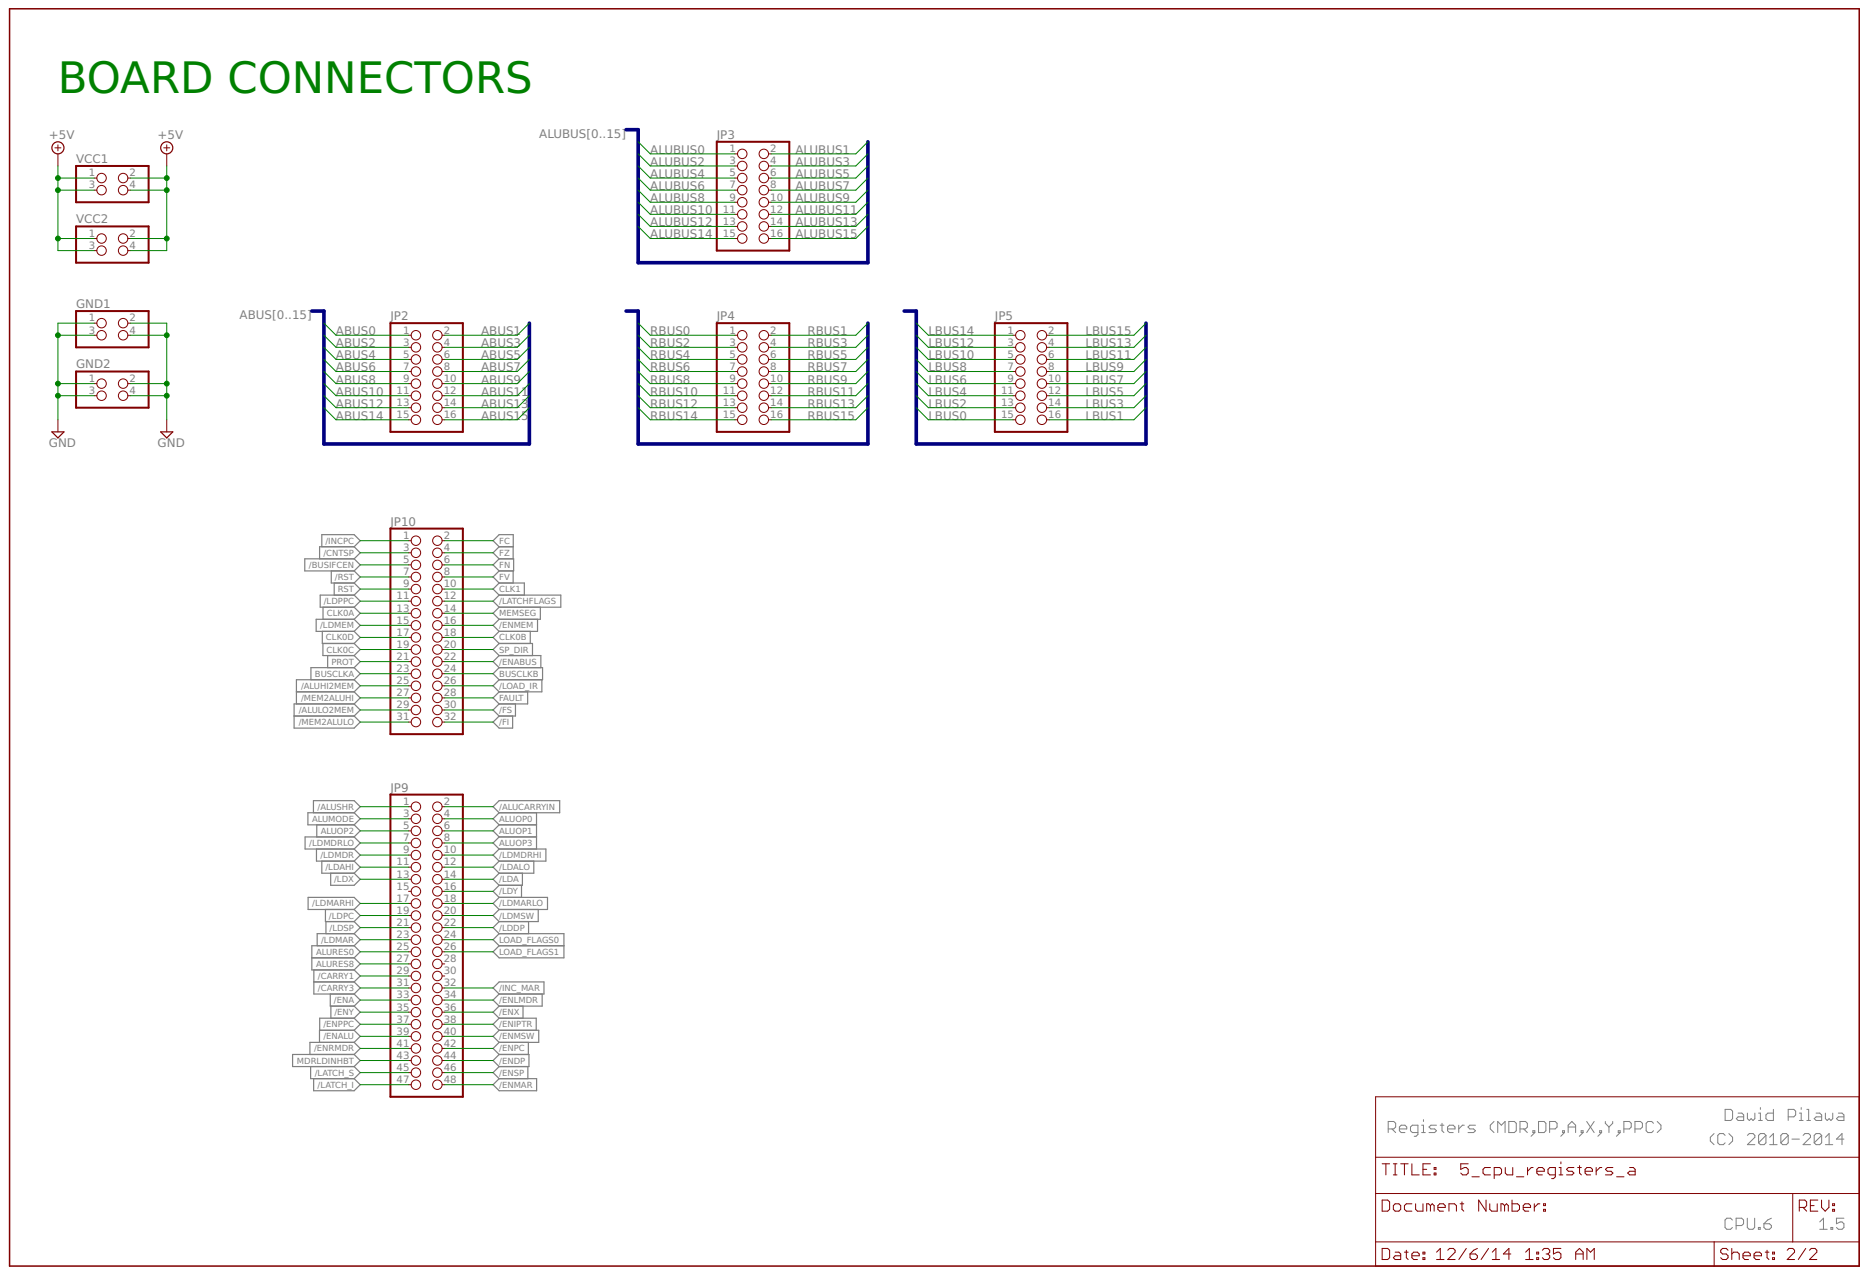
[picture p40: page 12]
+5V GND; GND VCC1 1; 16 VCC2 1; 4 GND1 1; 4 GND2 1; 16 ALUBUS[0..15] ABUS[0..15]; /LDMDR /LDMDRLO MDRLDINHBT; /LDMDRHI; ALUBUS0; ALUBUS1 ALUBUS2; ALUBUS3 ALUBUS4; ALUBUS5 ALUBUS6; ALUBUS7 ALUBUS9 ALUBUS10; ALUBUS11 ALUBUS12; ALUBUS13 ALUBUS15 ALUBUS8 ALUBUS14; LBUS0; LBUS1 LBUS2; LBUS3 RBUS0; RBUS1 RBUS2; RBUS3; LBUS4; LBUS5 LBUS7 LBUS8; LBUS9 LBUS10; LBUS11 LBUS12; LBUS13 LBUS14; LBUS15 LBUS6 RBUS4; RBUS5 RBUS6; RBUS7 RBUS8; RBUS9 RBUS10; RBUS11 RBUS12; RBUS13 RBUS14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

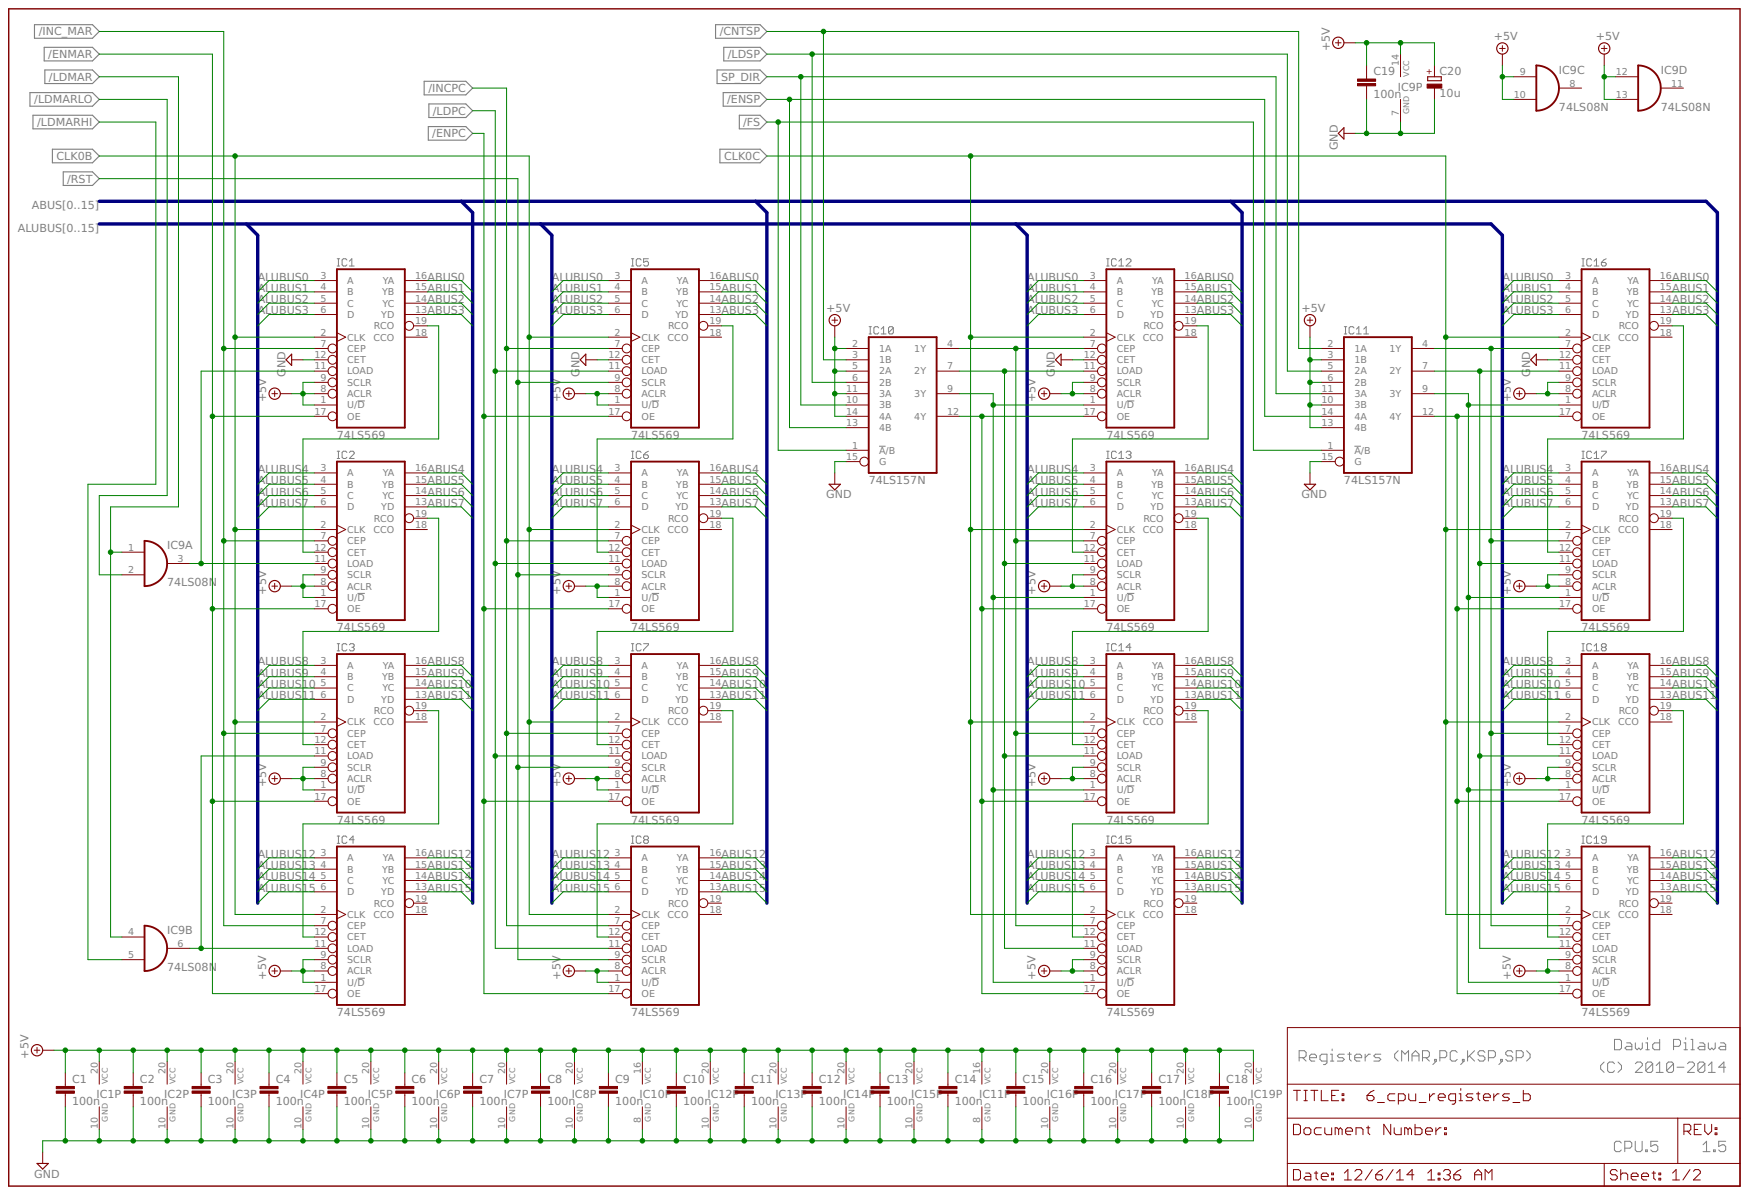
[picture p41: page 13]

# BOARD CONNECTORS

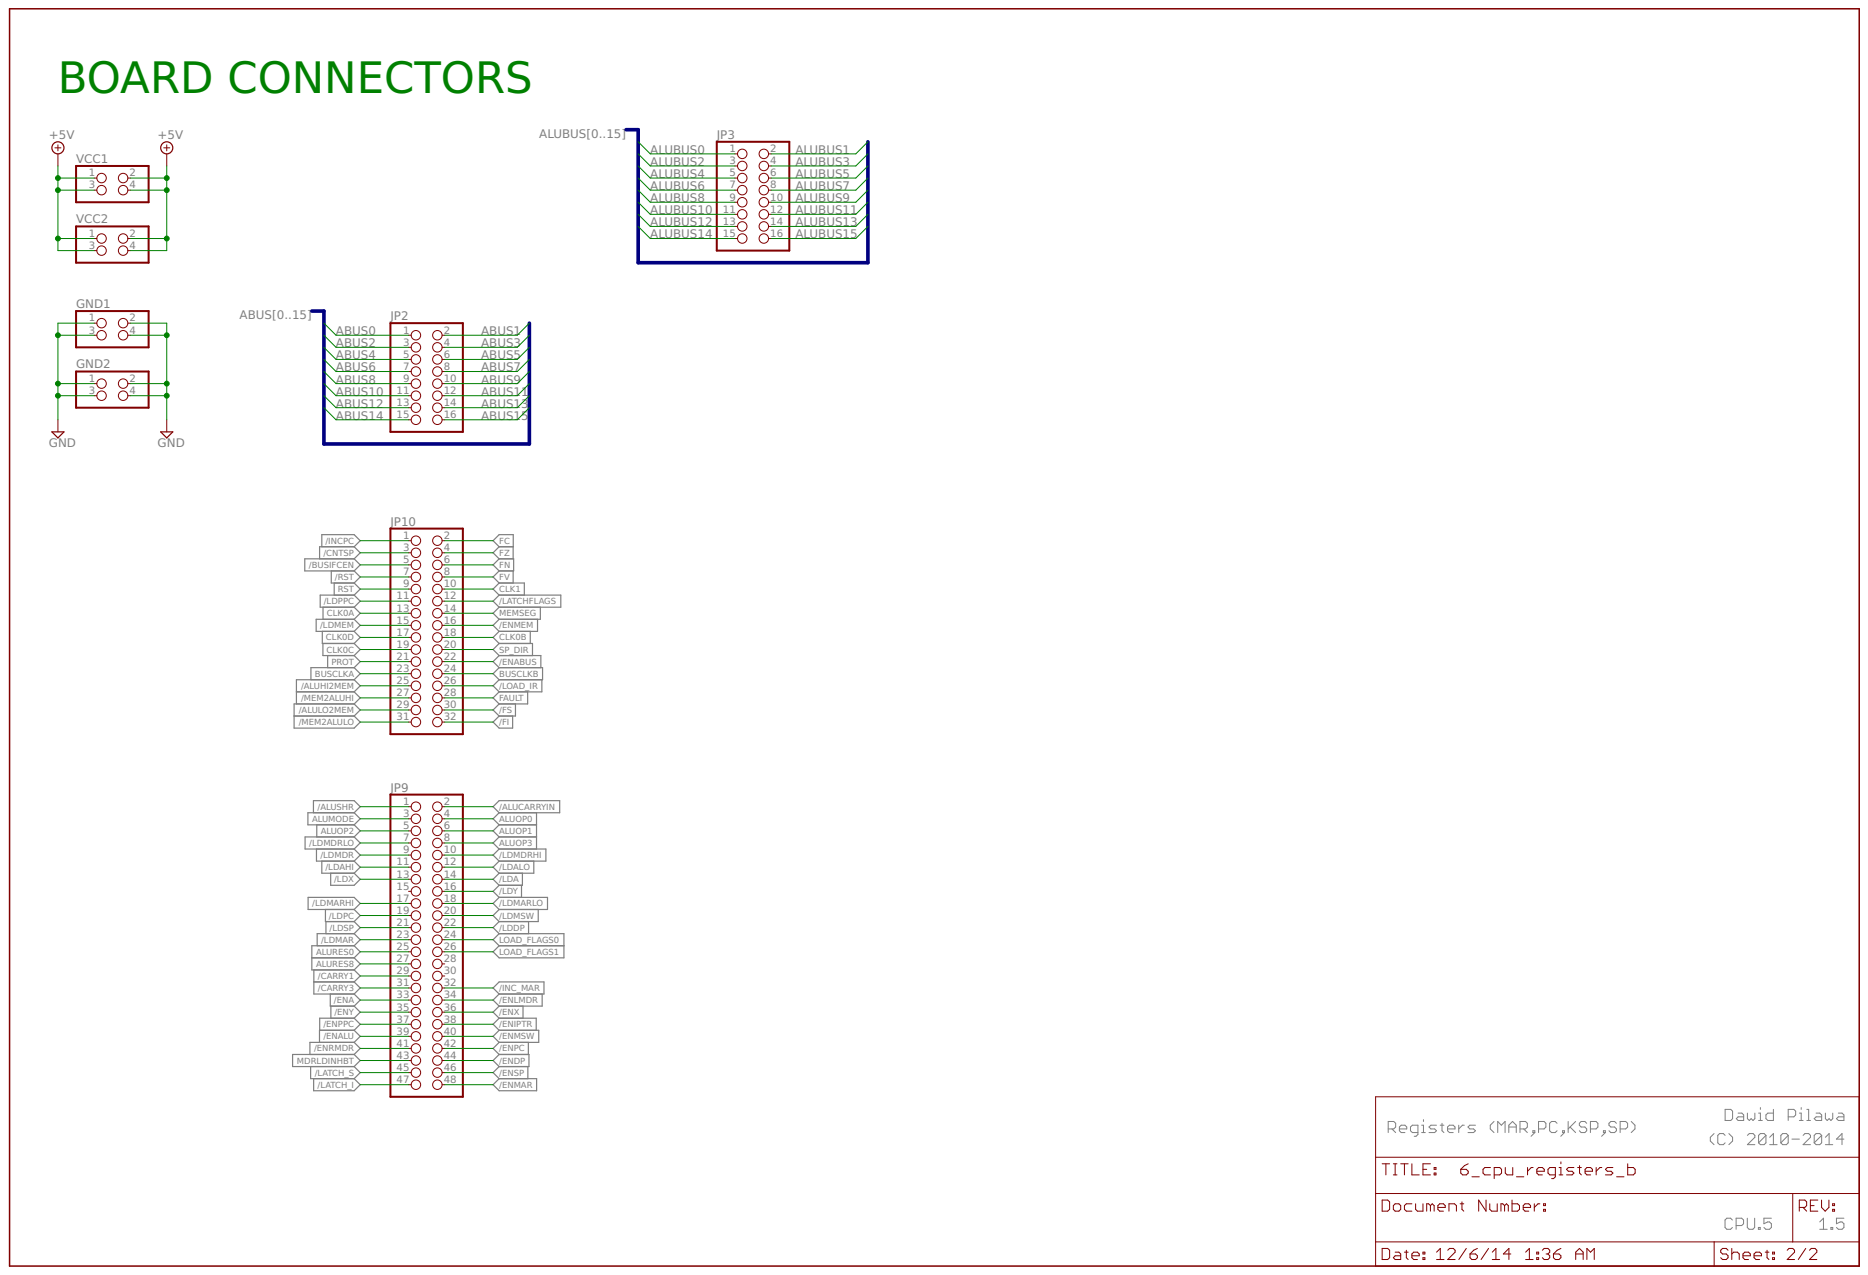
[picture p42: page 14]
GND; VCC1; VCC2; 4 GND1; 4 GND2; ALUBUS[0..15]; ABUS[0..15]; ALUBUS0; ALUBUS1; ALUBUS2; ALUBUS3; ALUBUS4; ALUBUS5; ALUBUS6; ALUBUS7; ALUBUS8; ALUBUS9; ALUBUS10; ALUBUS11; ALUBUS12; ALUBUS13; ALUBUS14; ALUBUS15; /RST; /INCPC; /LDPC; /ENPC; ABUS0; ABUS1; ABUS2; ABUS3; ABUS4; ABUS5; ABUS6; ABUS7; ABUS8; ABUS9; ABUS10; ABUS11; ABUS12; ABUS13; ABUS14; ABUS15; /INC_MAR; /ENMAR; /LDMAR; /LDMARHI; /LDMARLO; /LDSP; /ENSP; /CNTSP; SP_DIR; CLK0C; CLK0B; LOAD_FLAGS0 LOAD_FLAGS1; /LDMSW; /LATCH_S /LATCH_I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

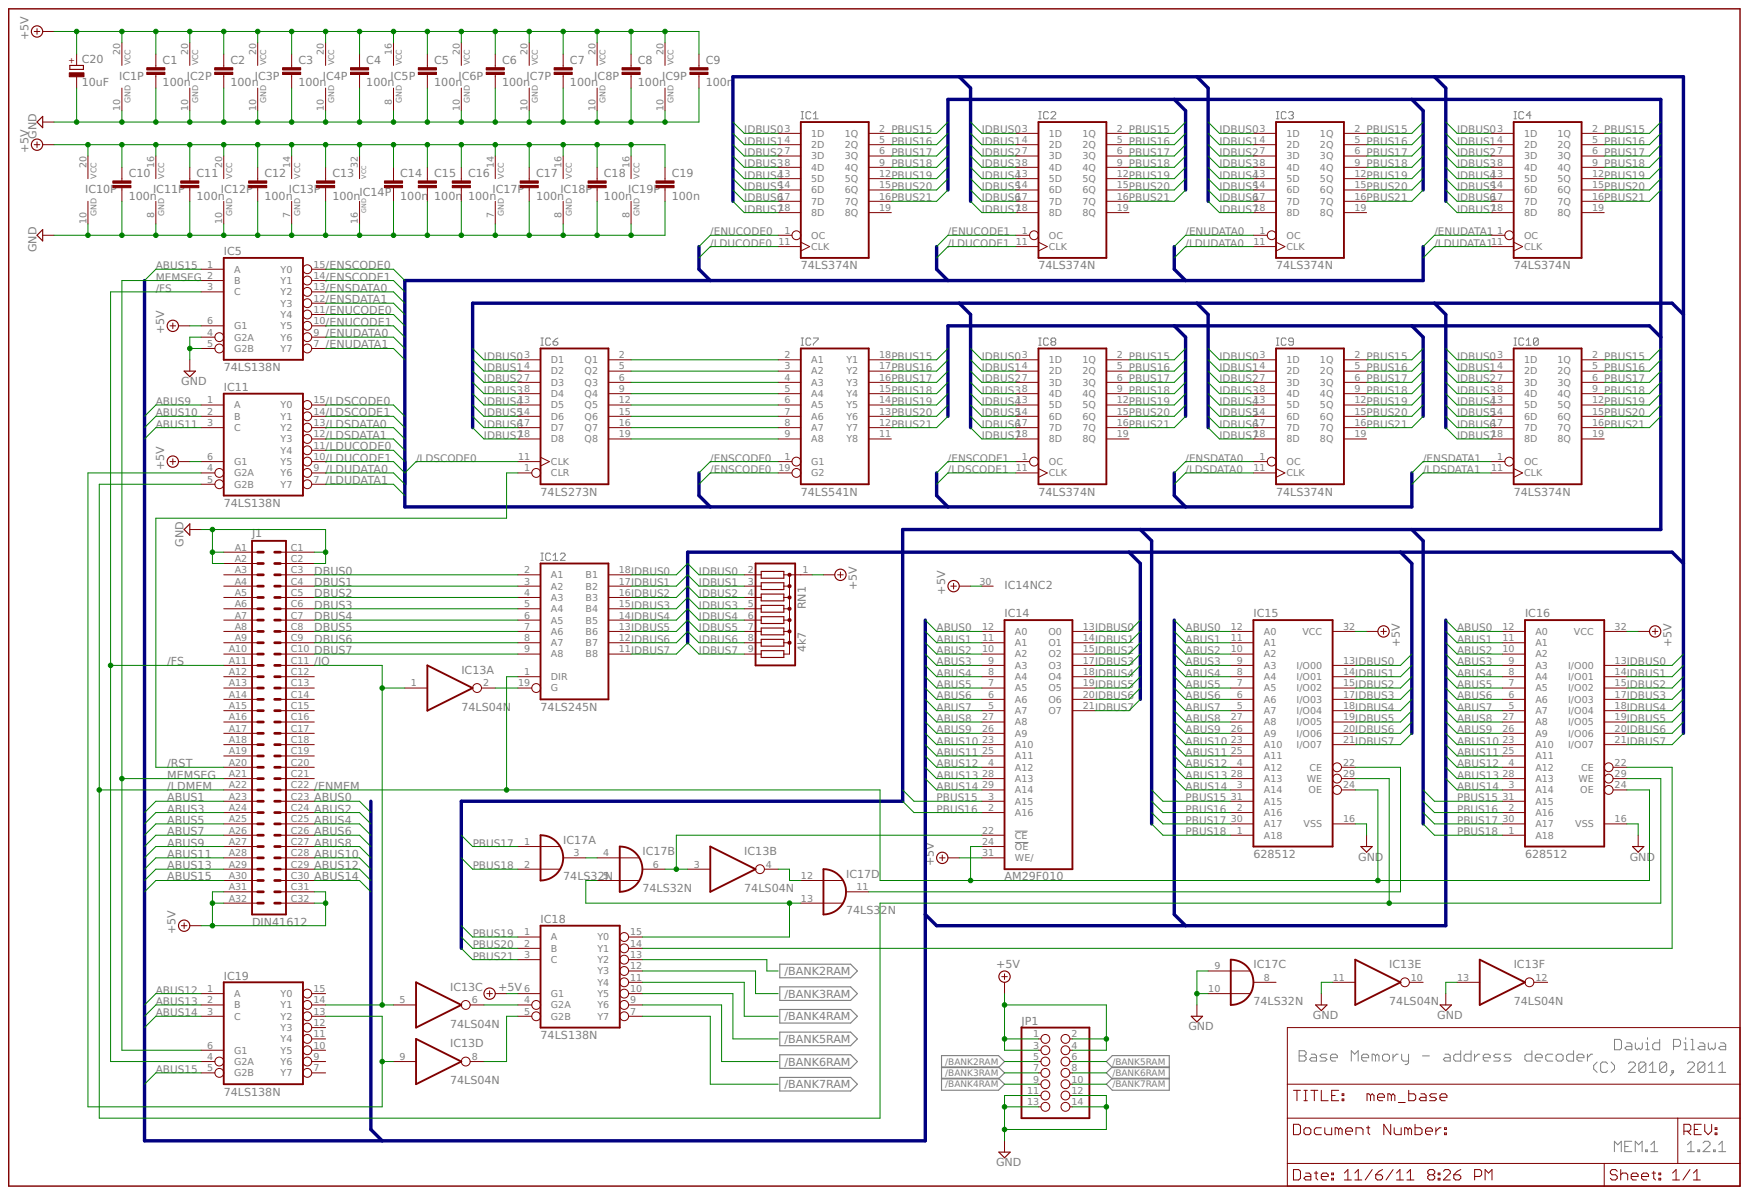
[picture p43: page 15]

17 B1 IDBUS1 | IDBUS1 3
16 B2 IDBUS2 15 B3 | IDBUS2 4

14 B4 IDBUS4 | IDBUS4 6

IDBUS3 | 5 IDBUS3

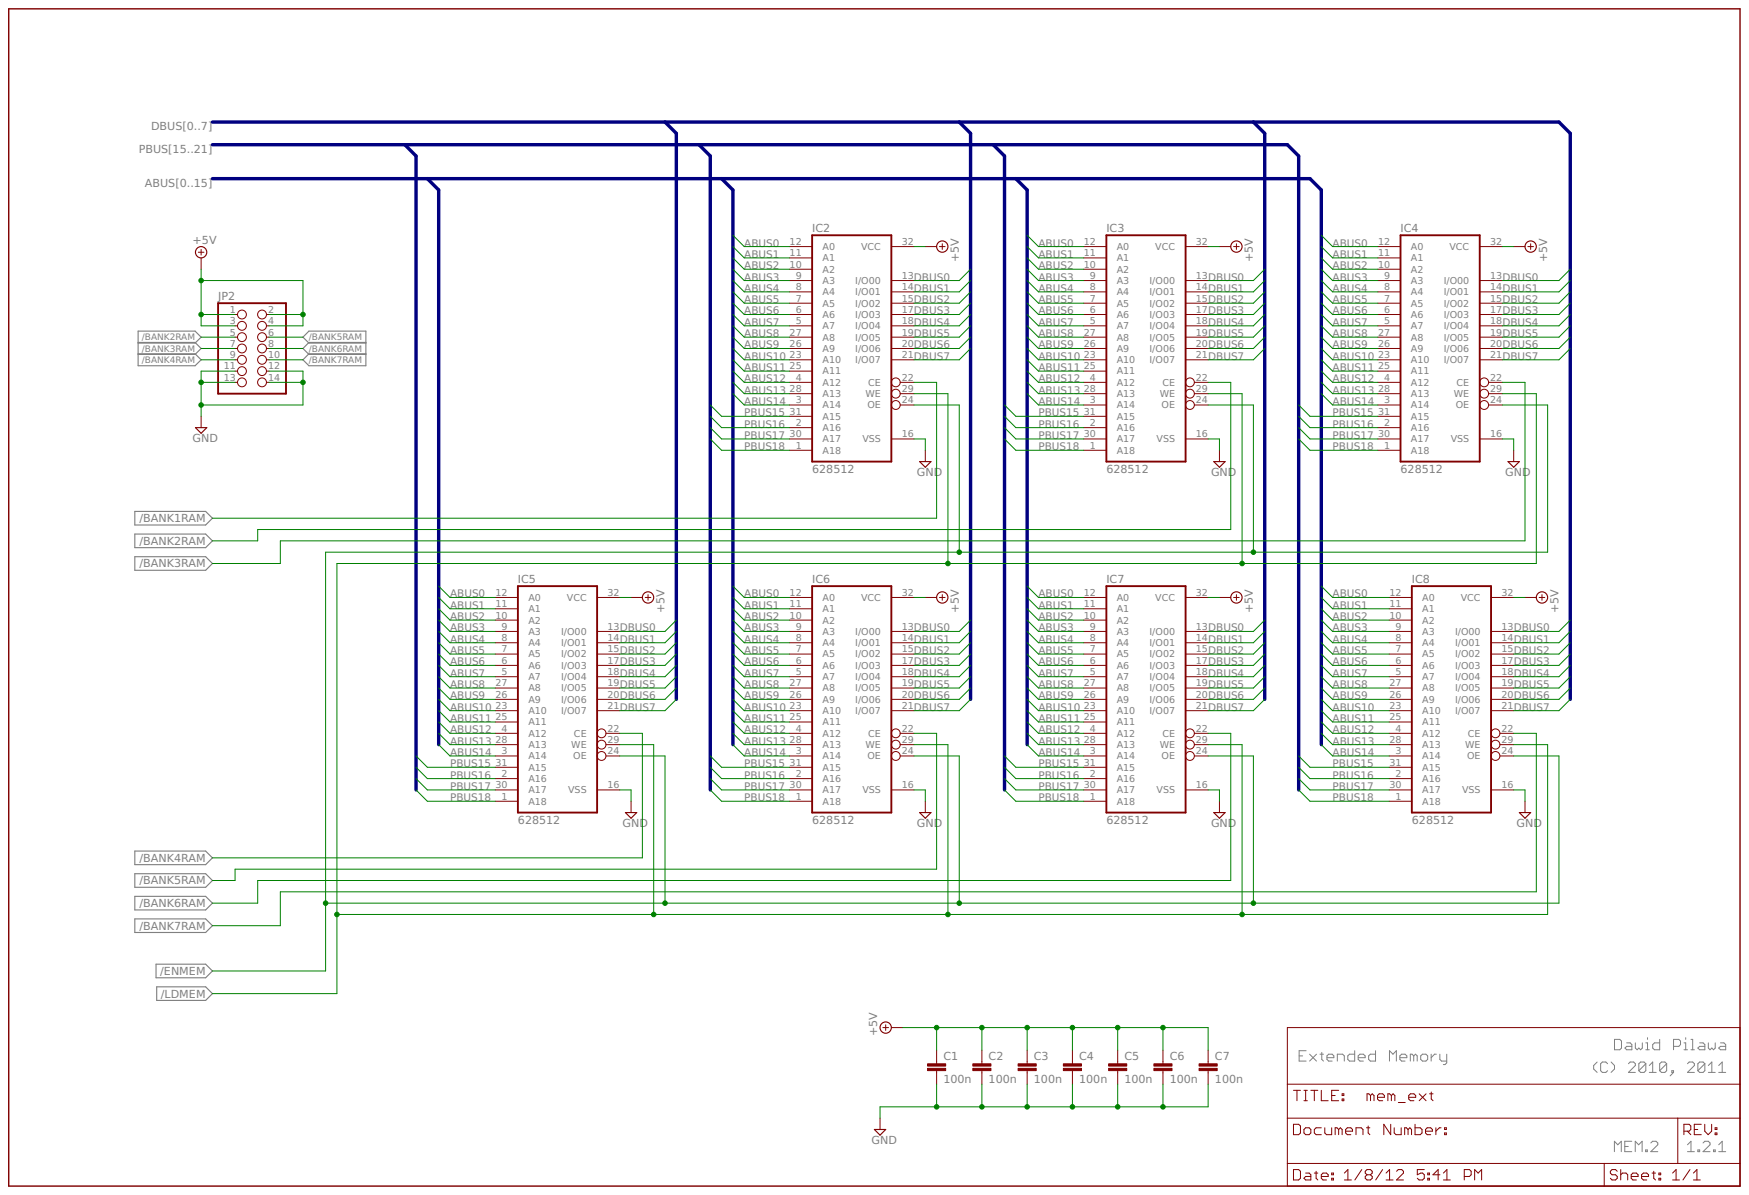
[picture p44: page 16]

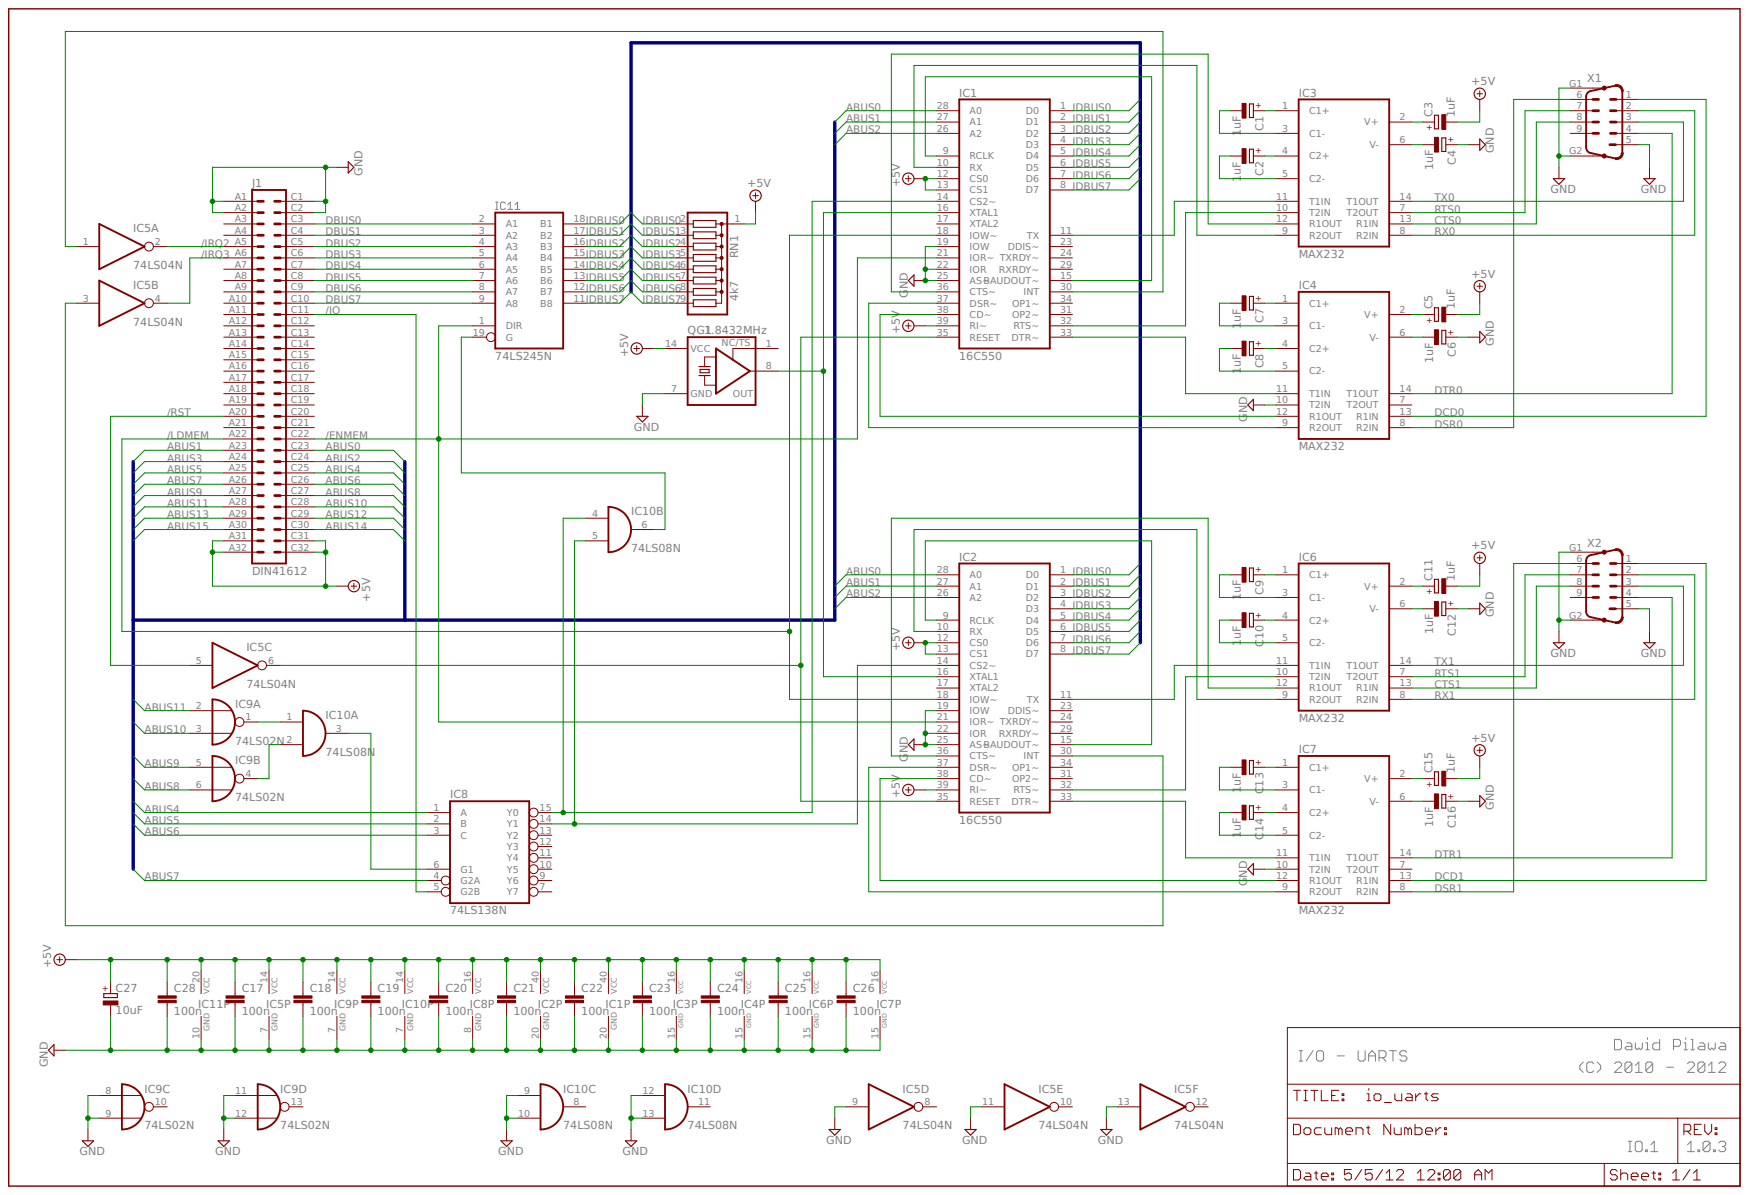
[picture p45: page 17]

A1A2A3A4A5A6A7A8A9 A10 A11 A12 A13 A14 A15 A16 A17 A18 A19 A20 A21 A22 A23 A24 A25 A26 A27 A28 A29 A30 A31 A32

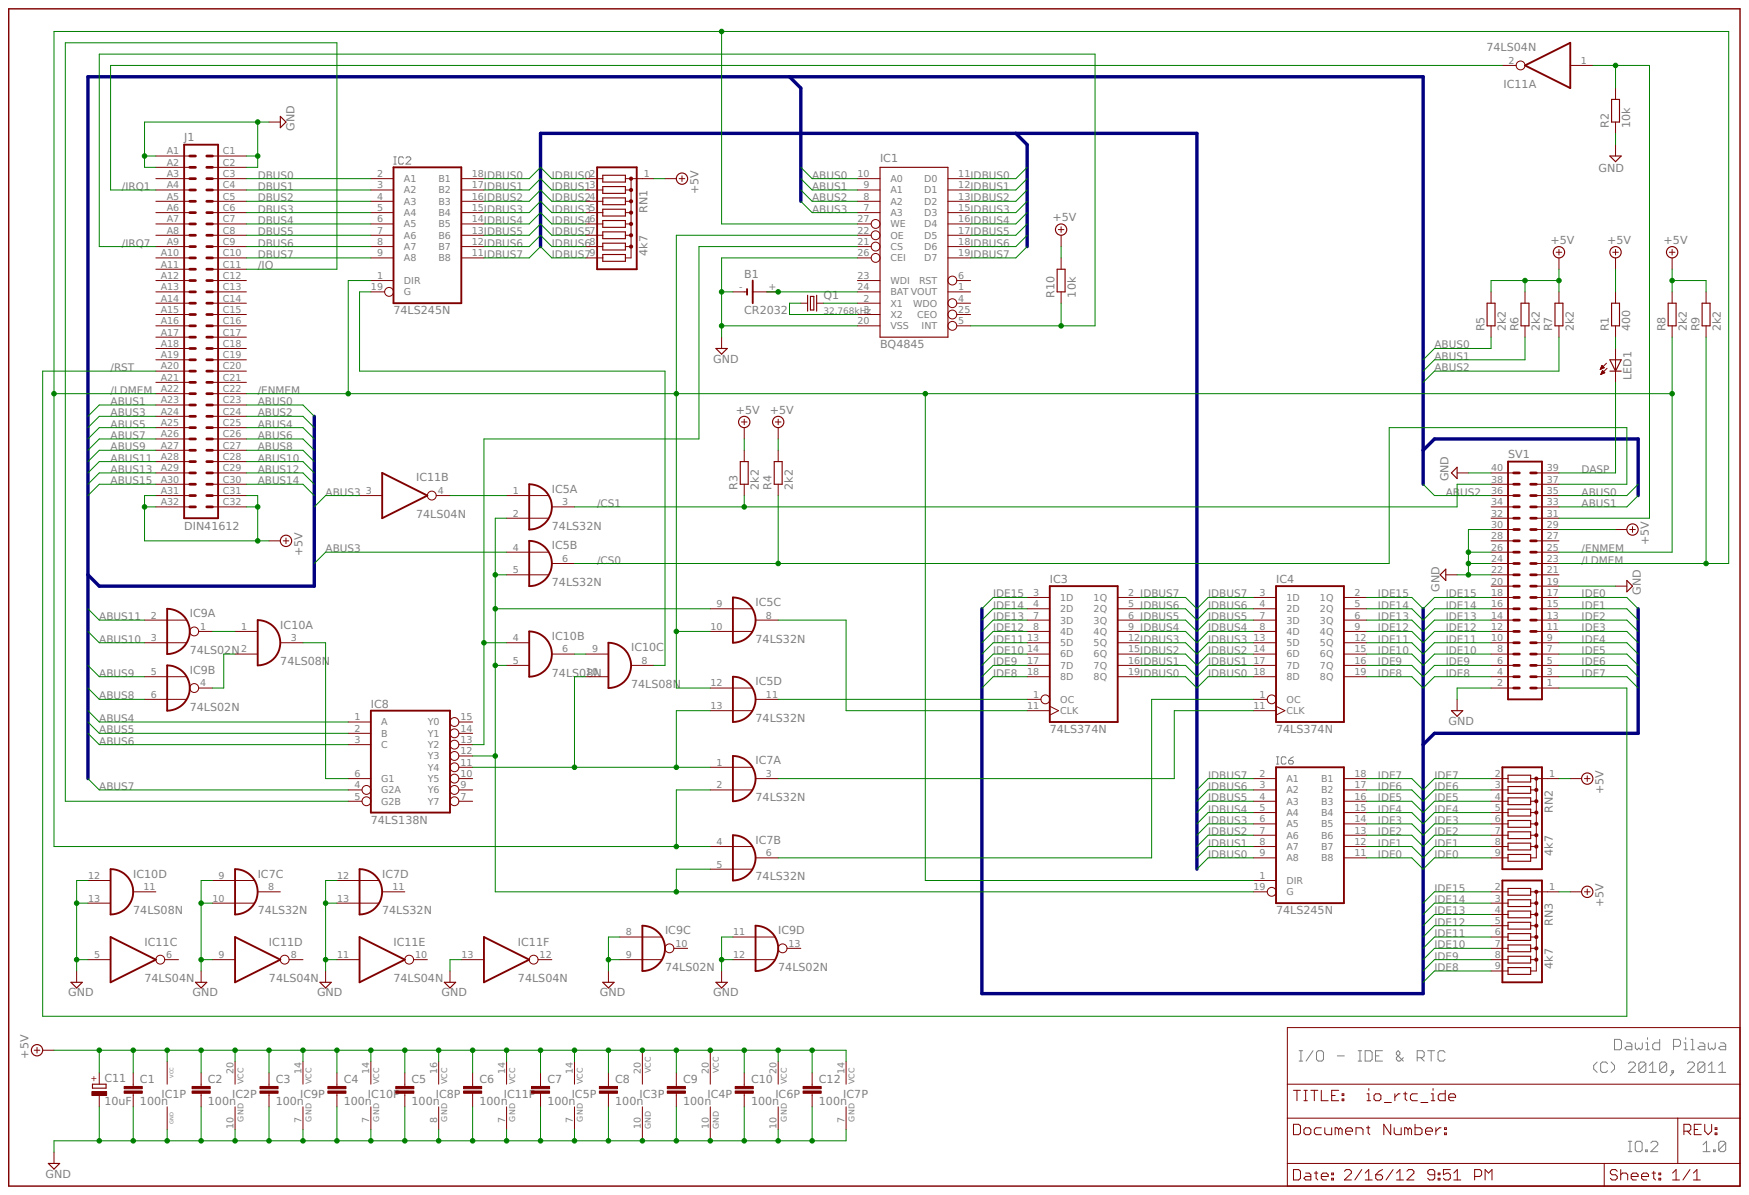
[picture p46: page 18]

12 B6 IDE1 | IDE1 8

IDE2 | 7 IDE2
