dpilawa/bytec/schematics/schematics_20160414.pdf

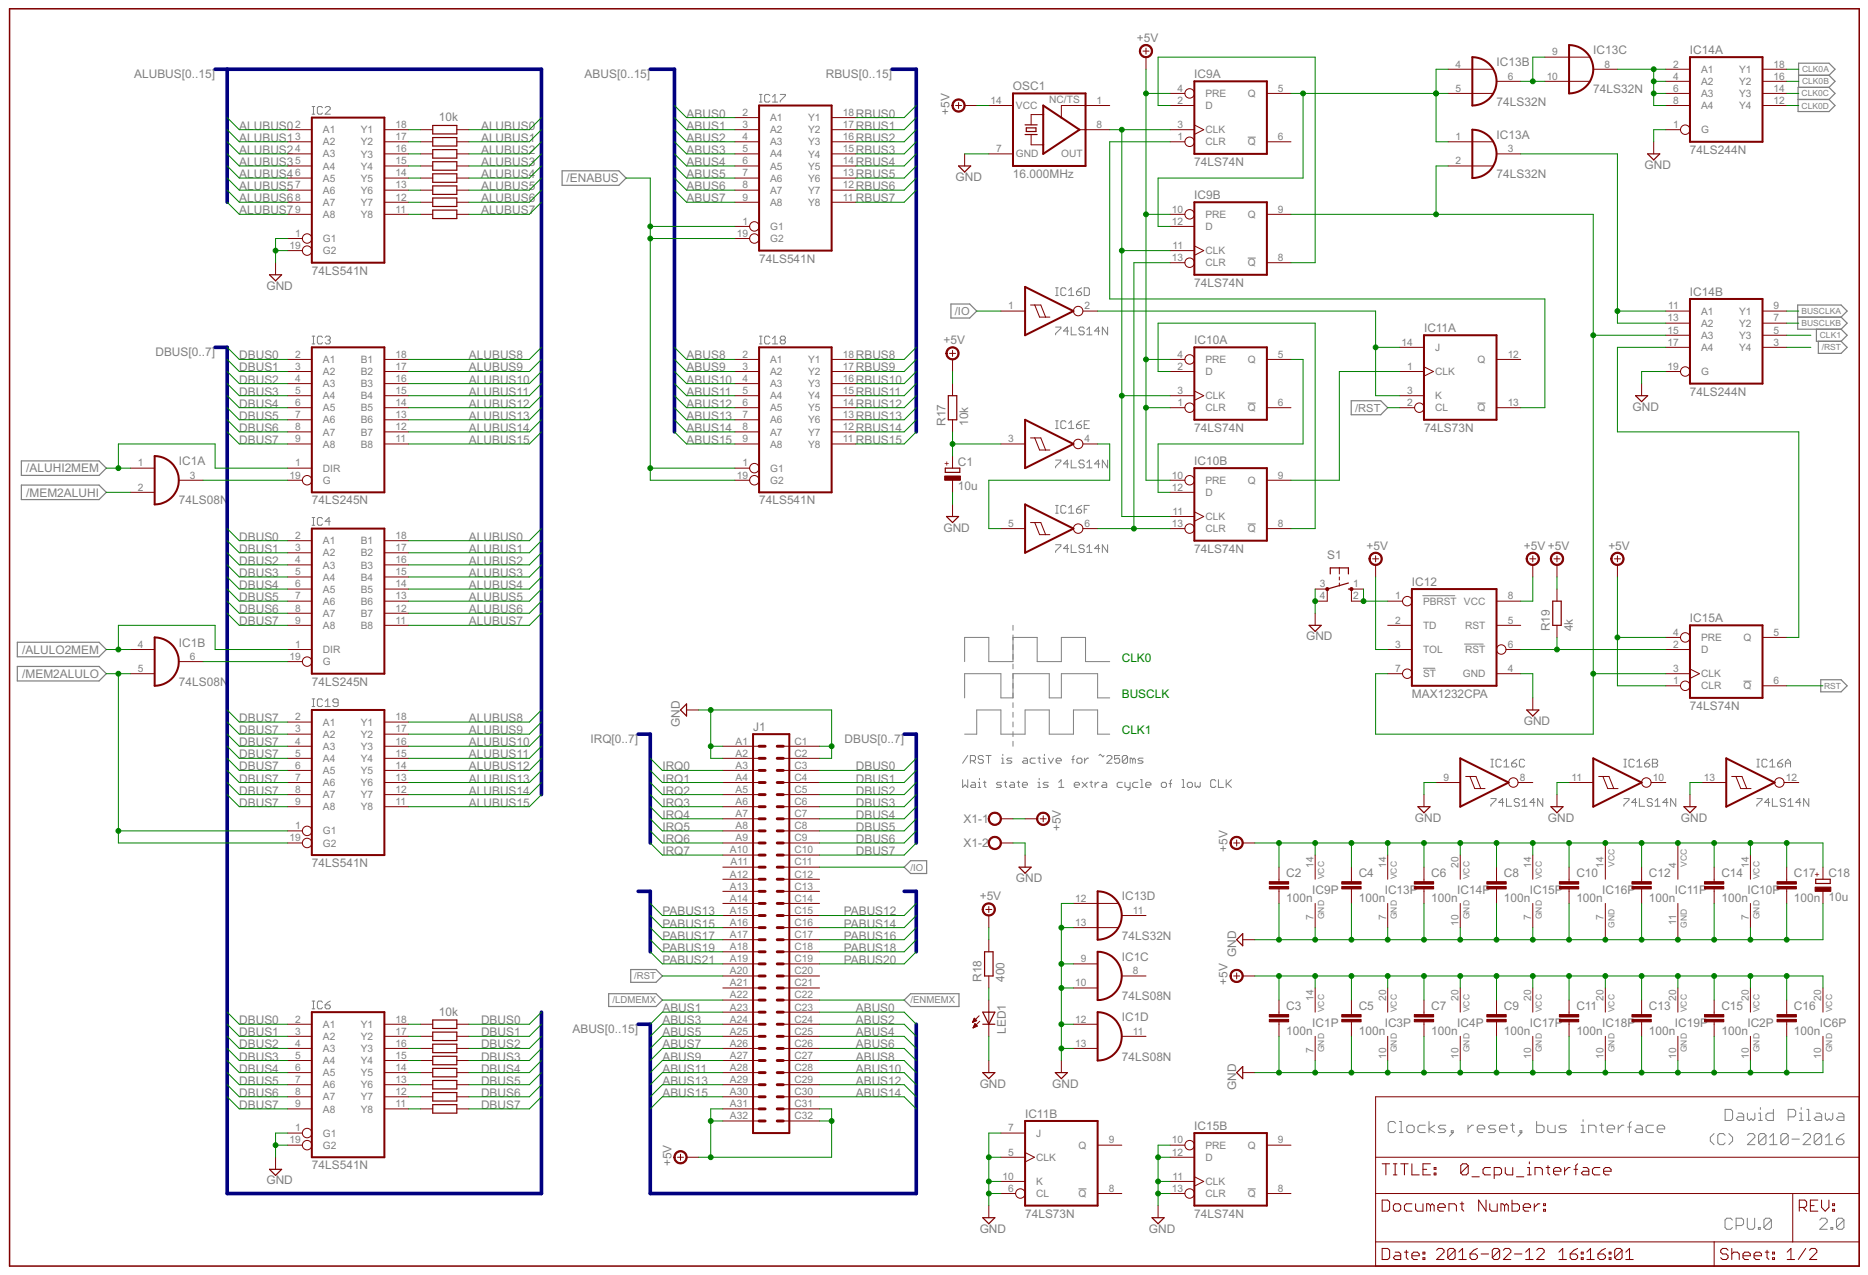
[picture p47: page 1]

# BOARD CONNECTORS

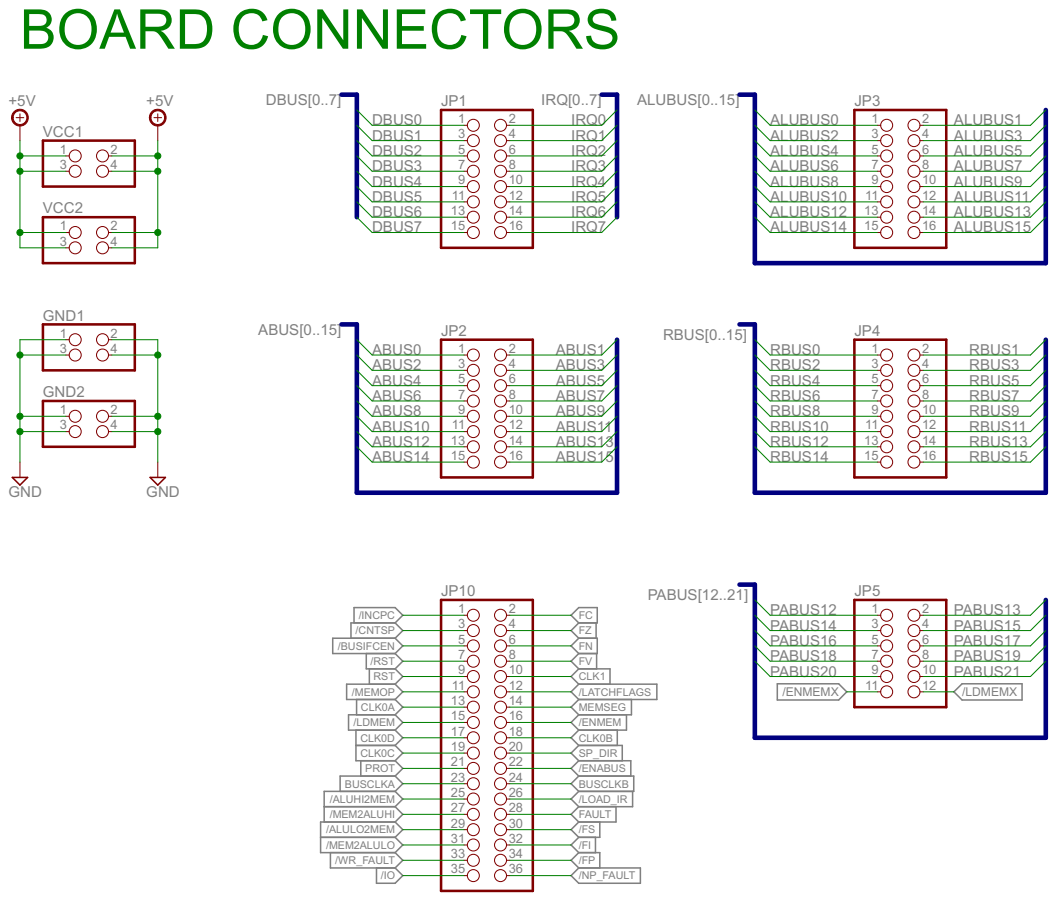
[picture p48: page 2]
GND; VCC1; VCC2; 4 GND1; 4 GND2; DBUS[0..7]; ALUBUS[0..15]; RBUS[0..15]; IRQ[0..7]; ABUS[0..15]; PABUS[12..21]; /ALUHI2MEM; /ALULO2MEM; /MEM2ALUHI; /MEM2ALULO; DBUS0 DBUS1 DBUS2 DBUS3 DBUS4 DBUS5 DBUS6 DBUS7; ALUBUS8; ALUBUS9; ALUBUS10; ALUBUS11; ALUBUS12; ALUBUS13; ALUBUS14; ALUBUS15; ALUBUS0; ALUBUS1; ALUBUS2; ALUBUS3; ALUBUS4; ALUBUS5; ALUBUS6; ALUBUS7; /ENABUS; ABUS0; ABUS1; ABUS2; ABUS3; ABUS4; ABUS5; ABUS6; ABUS7; ABUS8; ABUS9; ABUS10; ABUS11; ABUS12; ABUS13; ABUS14; ABUS15; RBUS0; RBUS1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

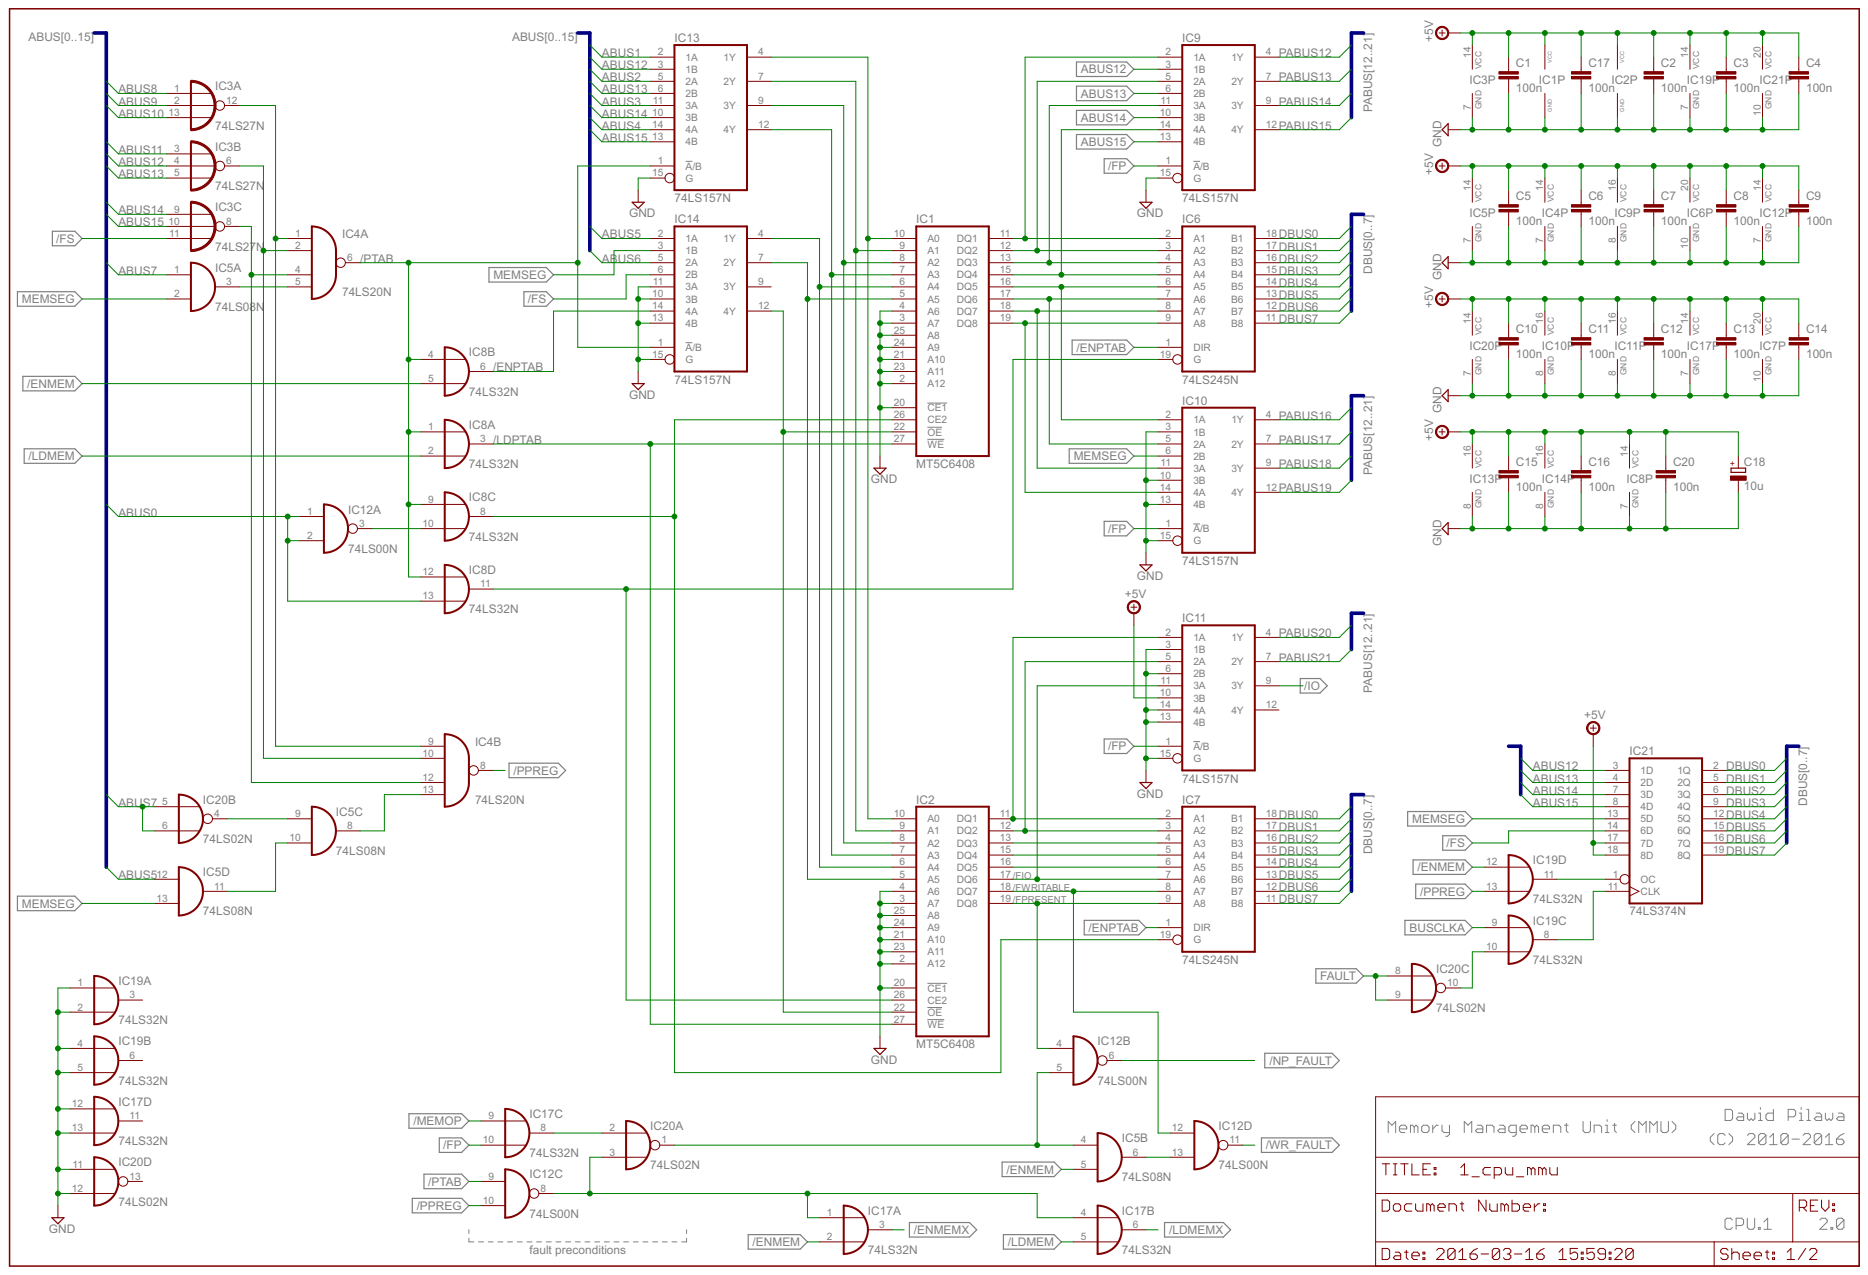
[picture p49: page 3]

# BOARD CONNECTORS

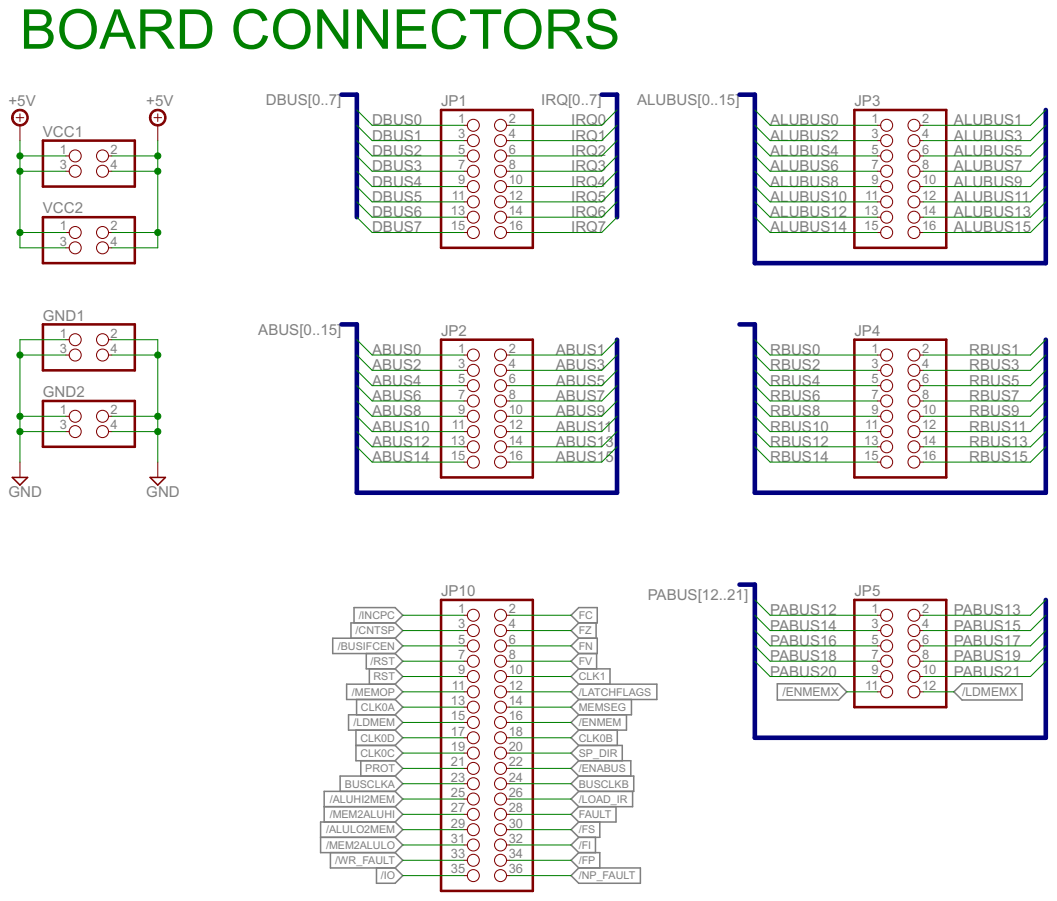
[picture p50: page 4]
GND; VCC1; VCC2; 4 GND1; 4 GND2; DBUS[0..7]; IRQ[0..7]; ALUBUS[0..15]; ABUS[0..15]; PABUS[12..21]; /ALUHI2MEM; /ALULO2MEM; /MEM2ALUHI; /MEM2ALULO; DBUS0 DBUS1 DBUS2 DBUS3 DBUS4 DBUS5 DBUS6 DBUS7; ALUBUS8; ALUBUS9; ALUBUS10; ALUBUS11; ALUBUS12; ALUBUS13; ALUBUS14; ALUBUS15; ALUBUS0; ALUBUS1; ALUBUS2; ALUBUS3; ALUBUS4; ALUBUS5; ALUBUS6; ALUBUS7; /ENABUS; ABUS0; ABUS1; ABUS2; ABUS3; ABUS4; ABUS5; ABUS6; ABUS7; ABUS8; ABUS9; ABUS10; ABUS11; ABUS12; ABUS13; ABUS14; ABUS15; RBUS0; RBUS1; RBUS2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

# IC10M

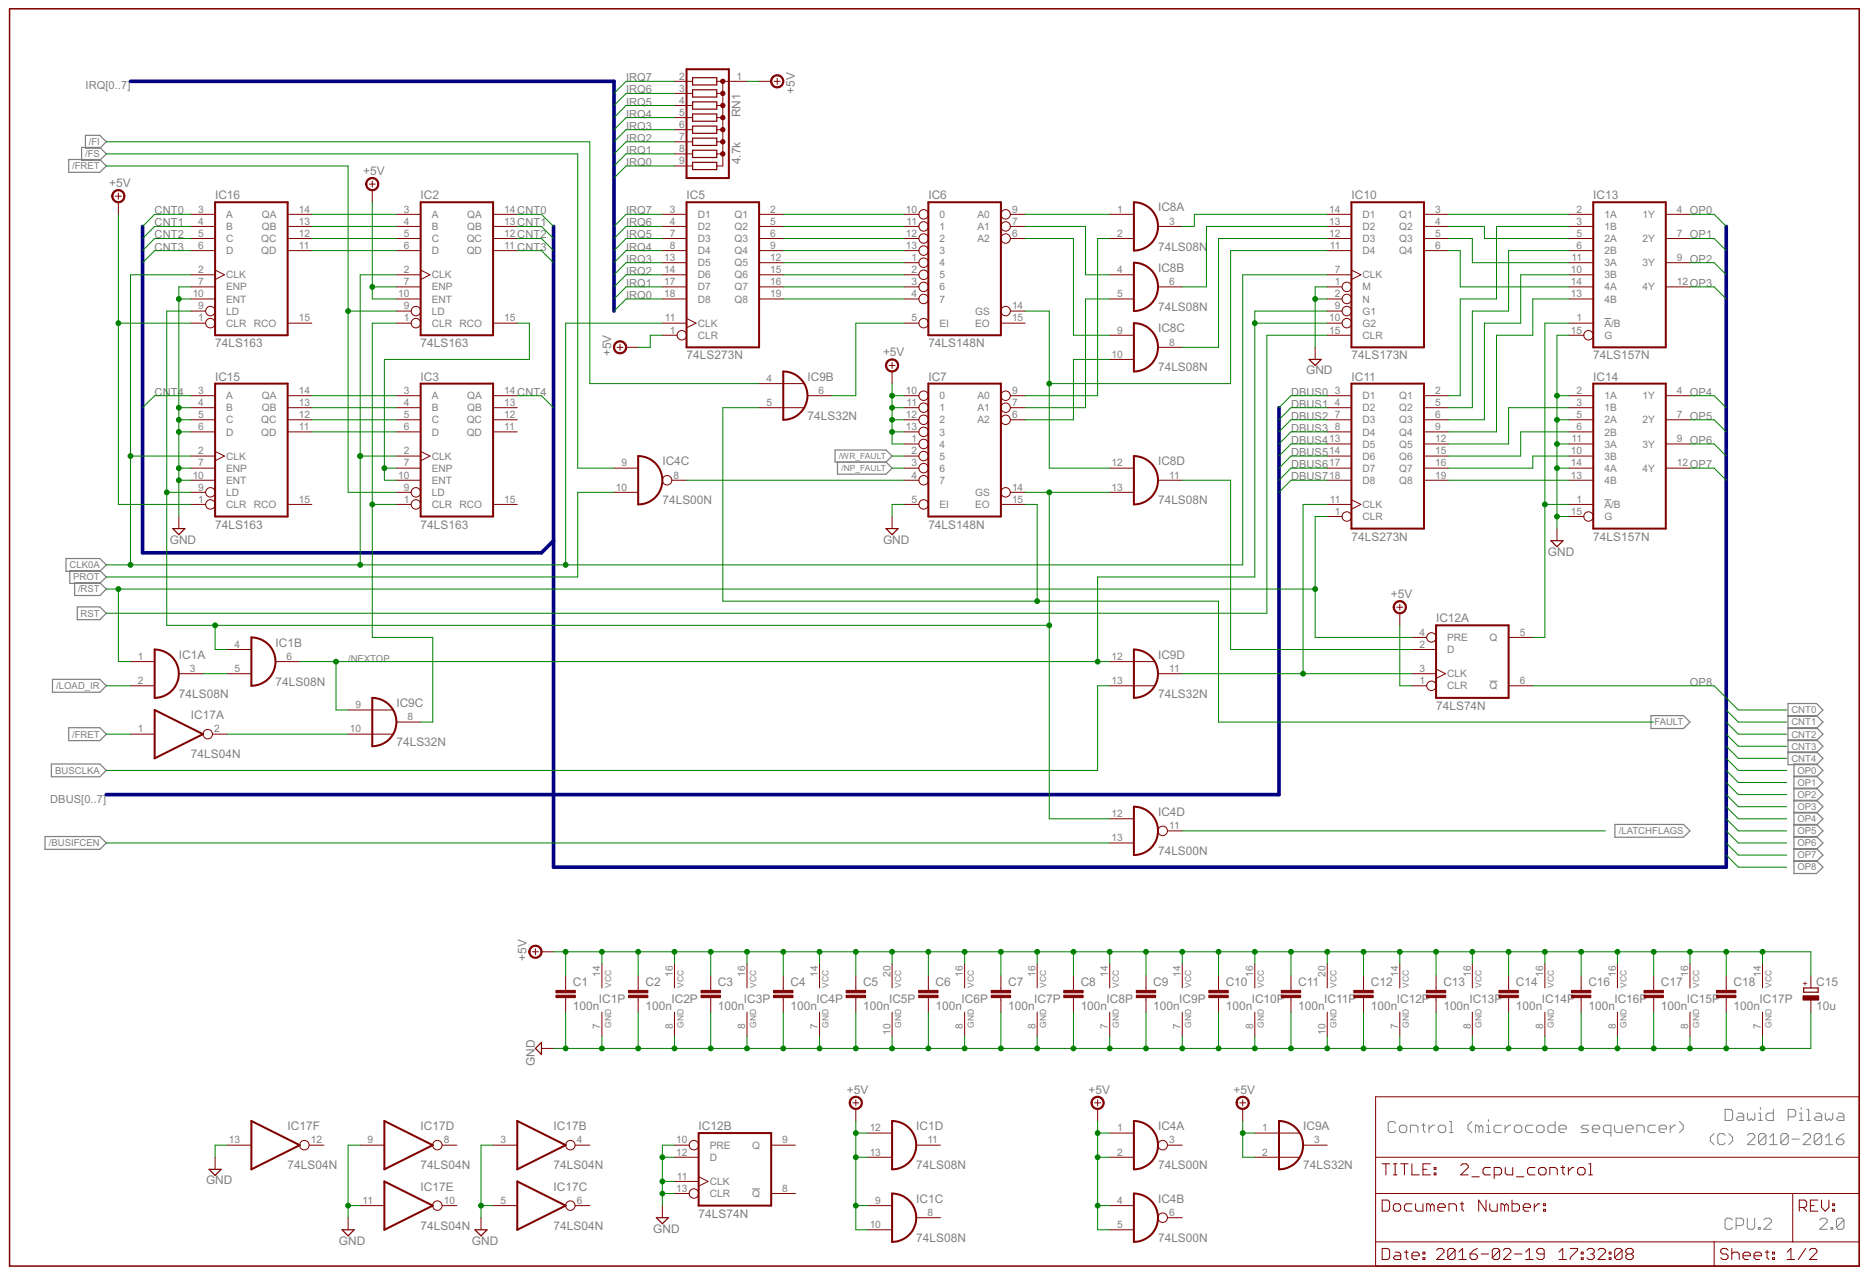
[picture p51: page 5]

# BOARD CONNECTORS

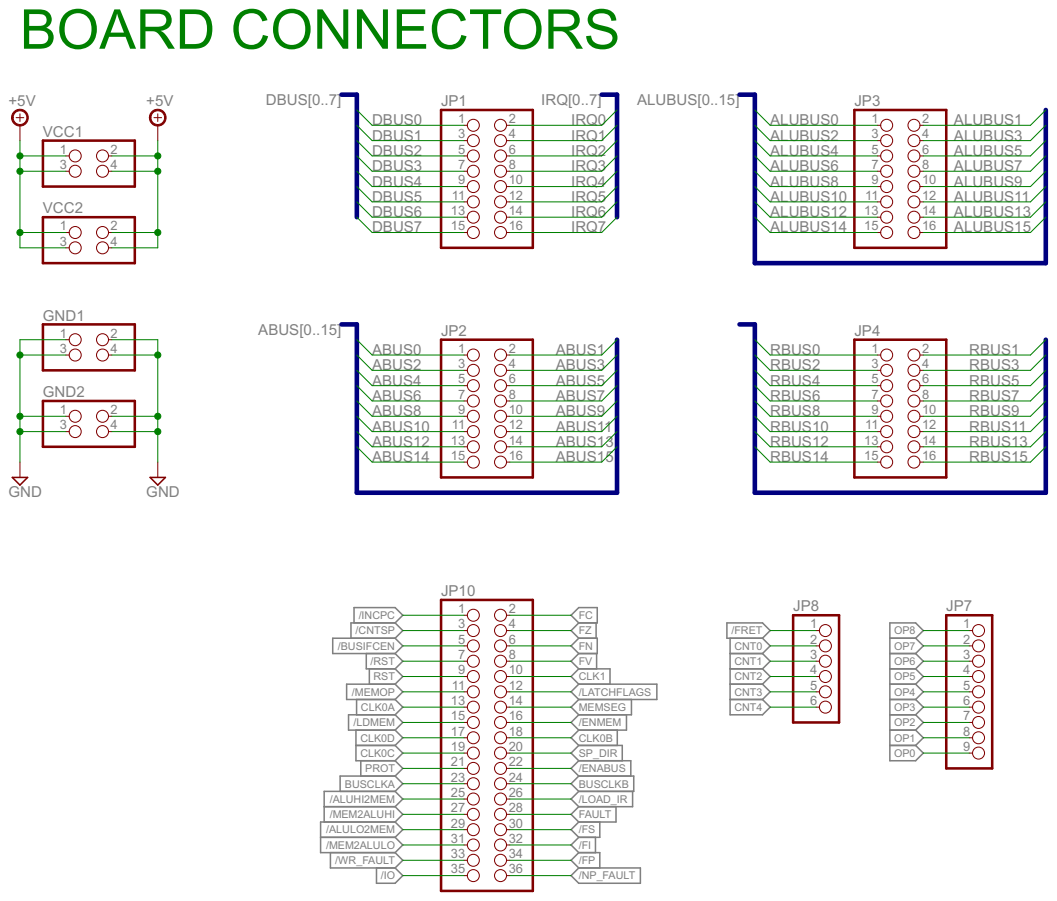
[picture p52: page 6]
GND; VCC1; 4 VCC2; 4 GND1; 4 GND2; DBUS[0..7]; IRQ[0..7]; ALUBUS[0..15]; ABUS[0..15]; CNT0 CNT1 CNT2 CNT3 CNT4; /RST; FAULT; IRQ0 IRQ1; IRQ3 IRQ4 IRQ5; IRQ7; DBUS0 DBUS1 DBUS2 DBUS3; DBUS5 DBUS6 DBUS7; RST; /LOAD_IR; /BUSIFCEN; BUSCLKA; CLK0A; PROT; DBUS4; IRQ2; IRQ6; /LATCHFLAGS; /ALUHI2MEM; /ALULO2MEM; /MEM2ALUHI; /MEM2ALULO; ALUBUS8; ALUBUS9; ALUBUS10; ALUBUS11; ALUBUS12; ALUBUS13; ALUBUS14; ALUBUS15; ALUBUS0; ALUBUS1; ALUBUS2; ALUBUS3; ALUBUS4; ALUBUS5; ALUBUS6; ALUBUS7; /ENABUS; ABUS0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

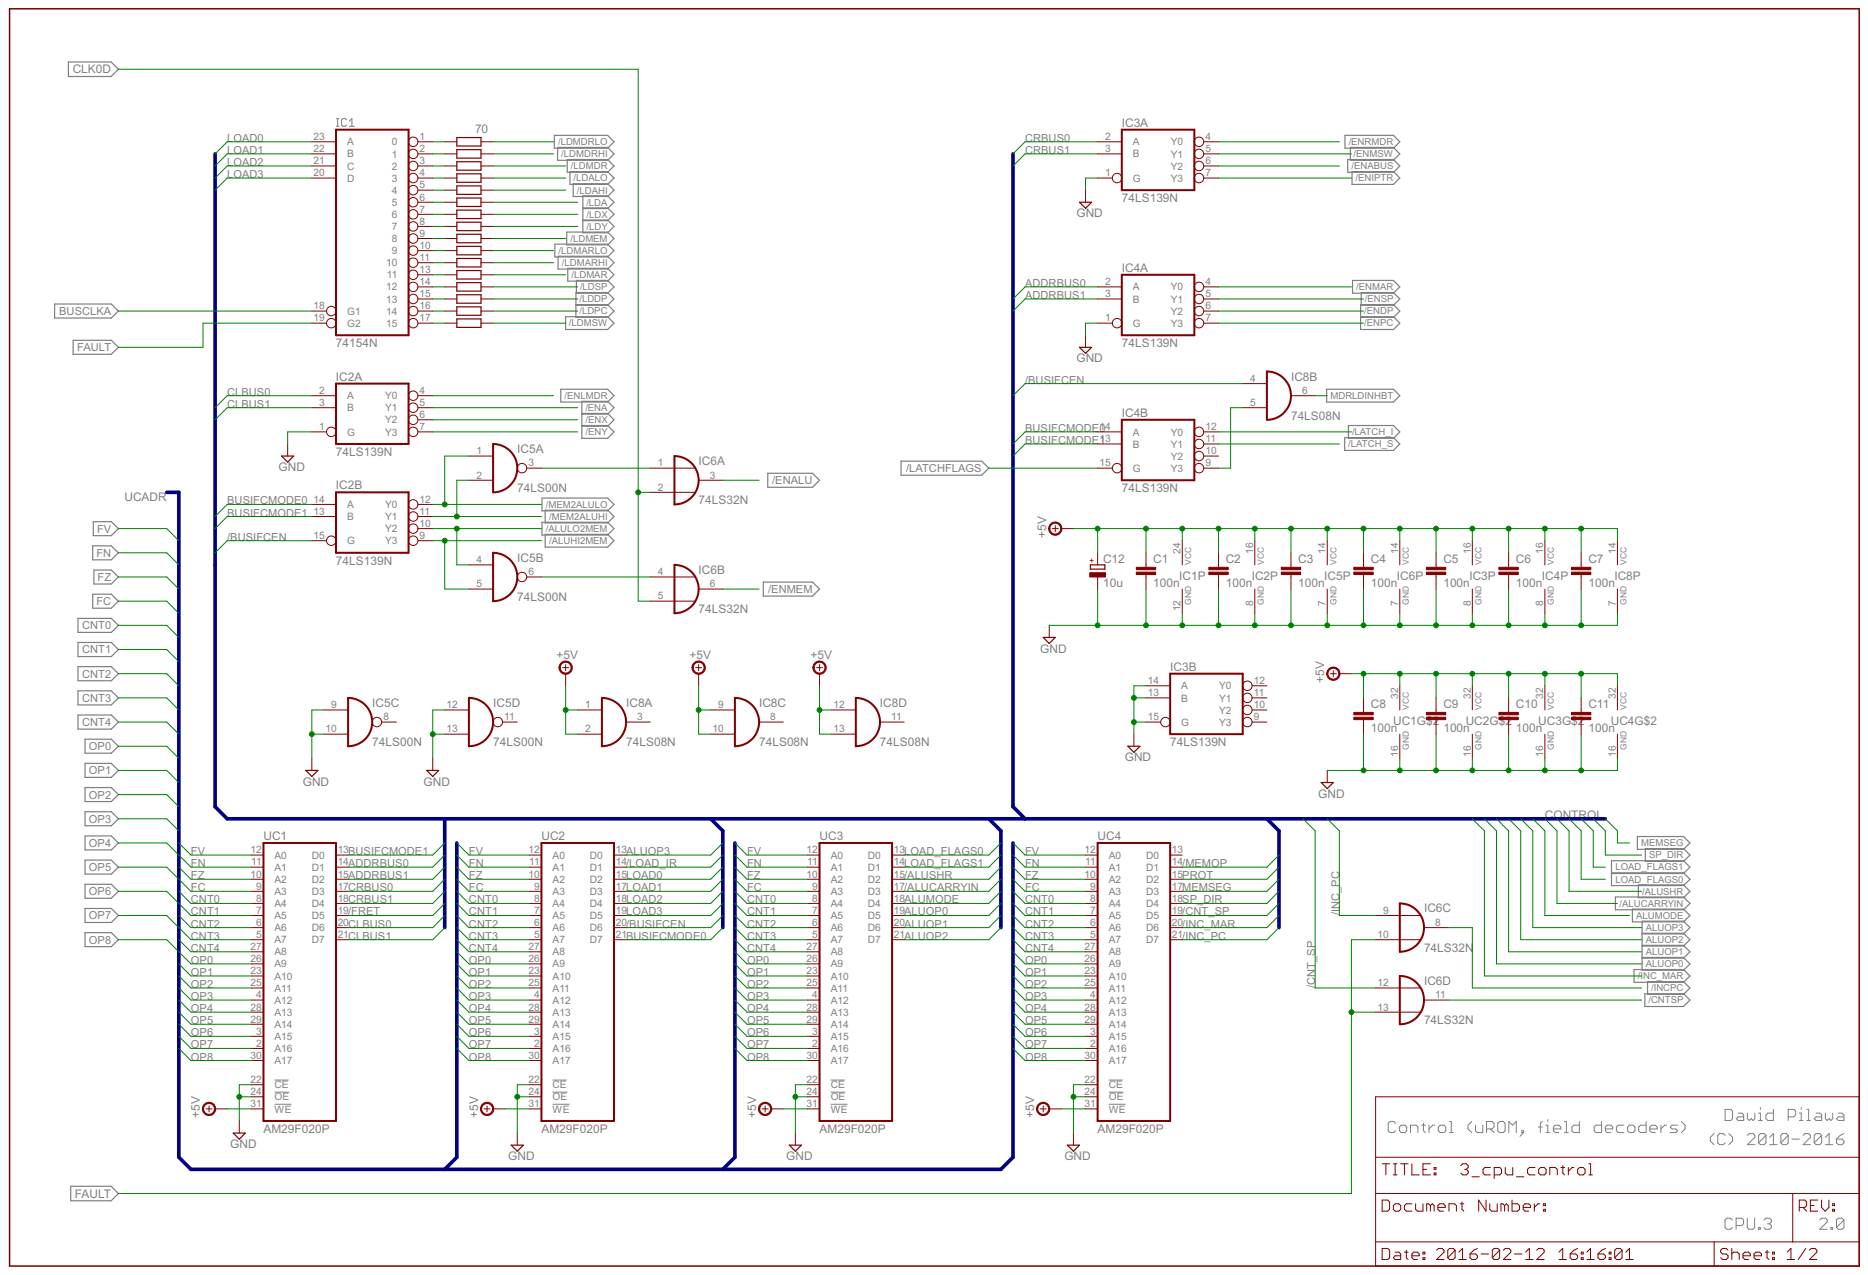
[picture p53: page 7]

# BOARD CONNECTORS

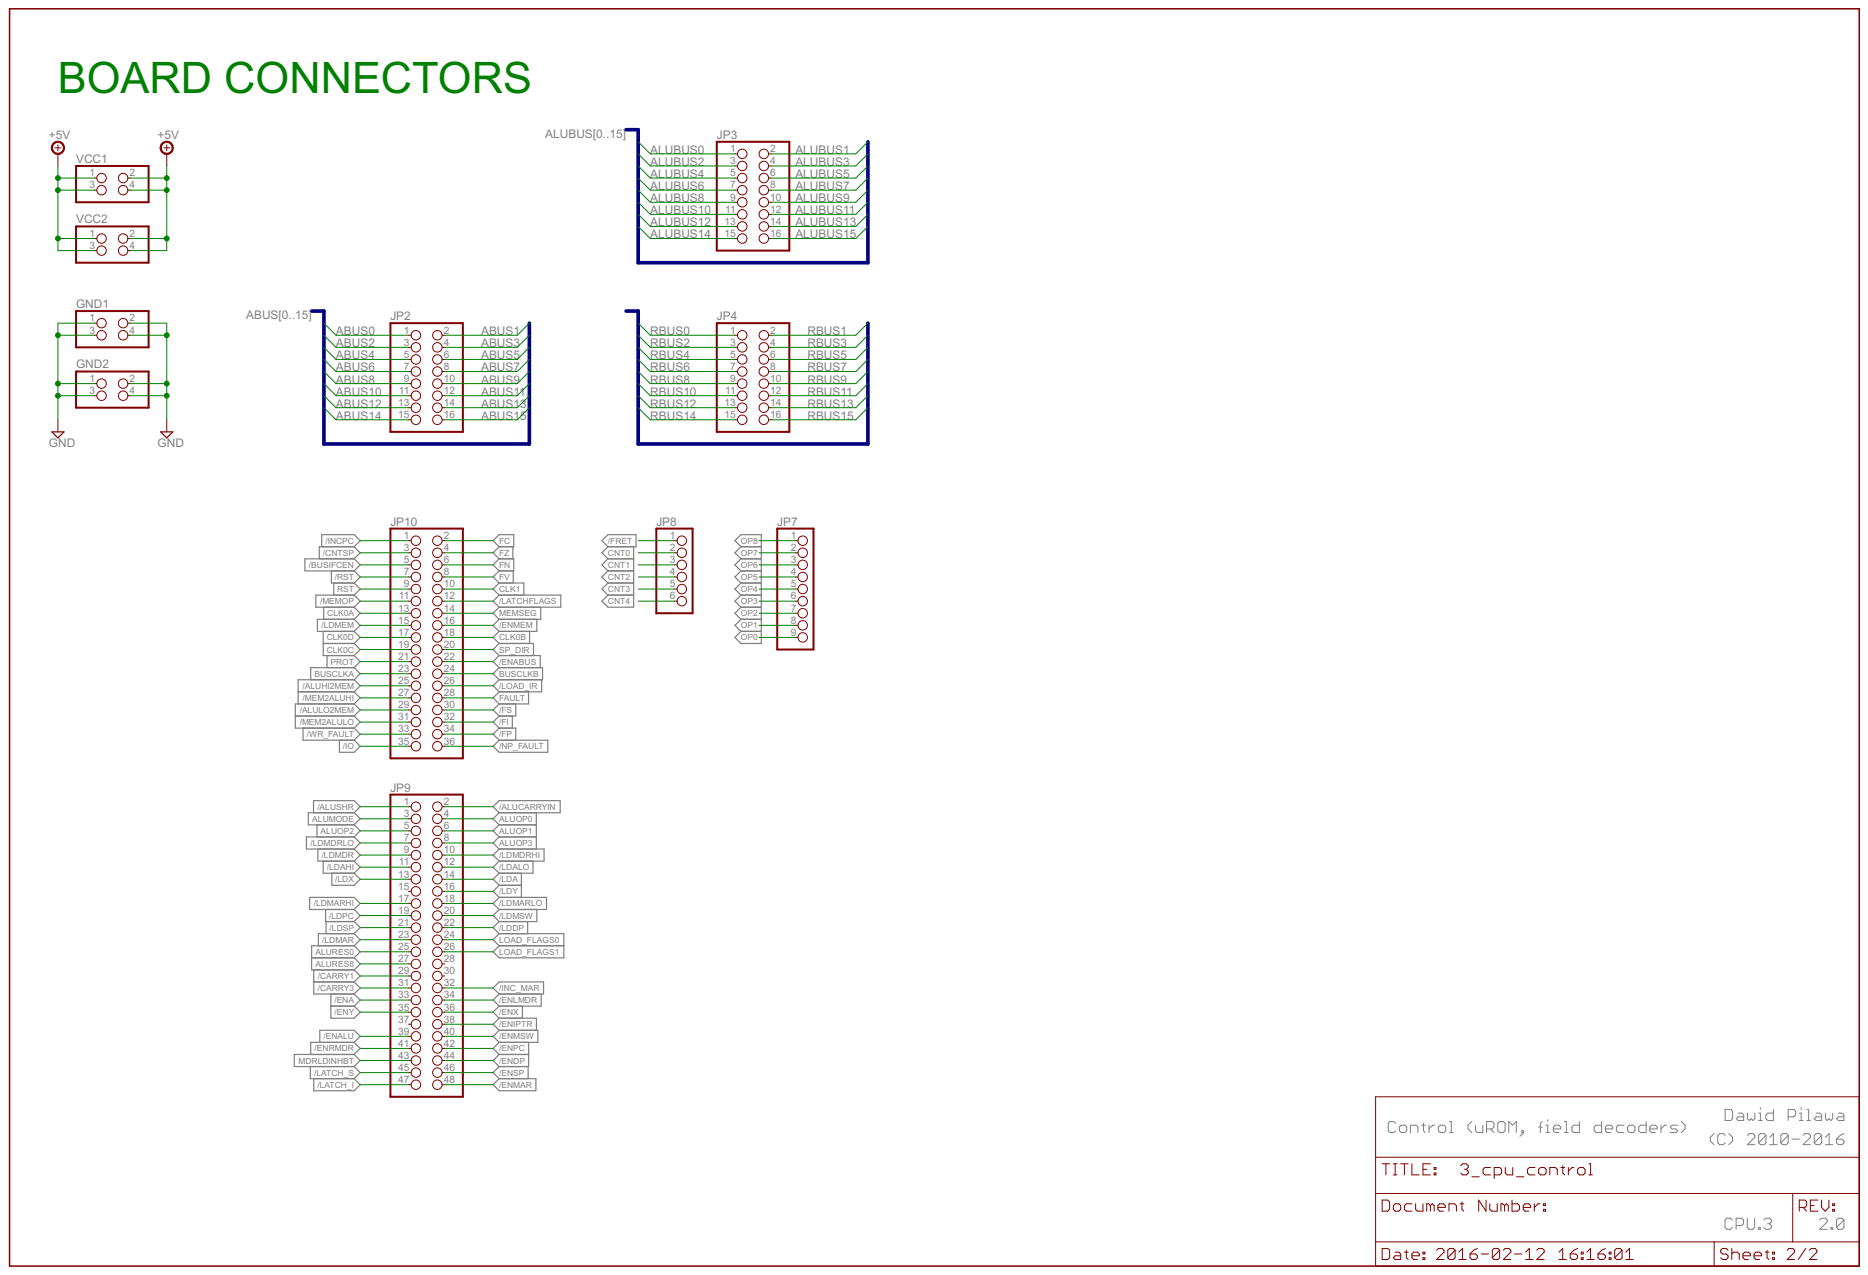
[picture p54: page 8]
GND; VCC1; VCC2; 4 GND1; 4 GND2; ALUBUS[0..15]; ABUS[0..15]; CNT0 CNT1 CNT2 CNT3 CNT4; /RST; FAULT; RST; /LOAD_IR; /BUSIFCEN; ALUOP3 ALUOP2; ALUOP1 ALUMODE; ALUOP0; /ALUSHR; /ALUCARRYIN; LOAD_FLAGS1; LOAD_FLAGS0; /INC_MAR; SP_DIR MEMSEG; /CNTSP; /INCPC; BUSCLKA; CLK0A; PROT; /LATCHFLAGS; /ALUHI2MEM; /ALULO2MEM; /MEM2ALUHI; /MEM2ALULO; ALUBUS8; ALUBUS9; ALUBUS10; ALUBUS11; ALUBUS12; ALUBUS13; ALUBUS14; ALUBUS15; ALUBUS0; ALUBUS1; ALUBUS2; ALUBUS3; ALUBUS4; ALUBUS5; ALUBUS6; ALUBUS7; /ENABUS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

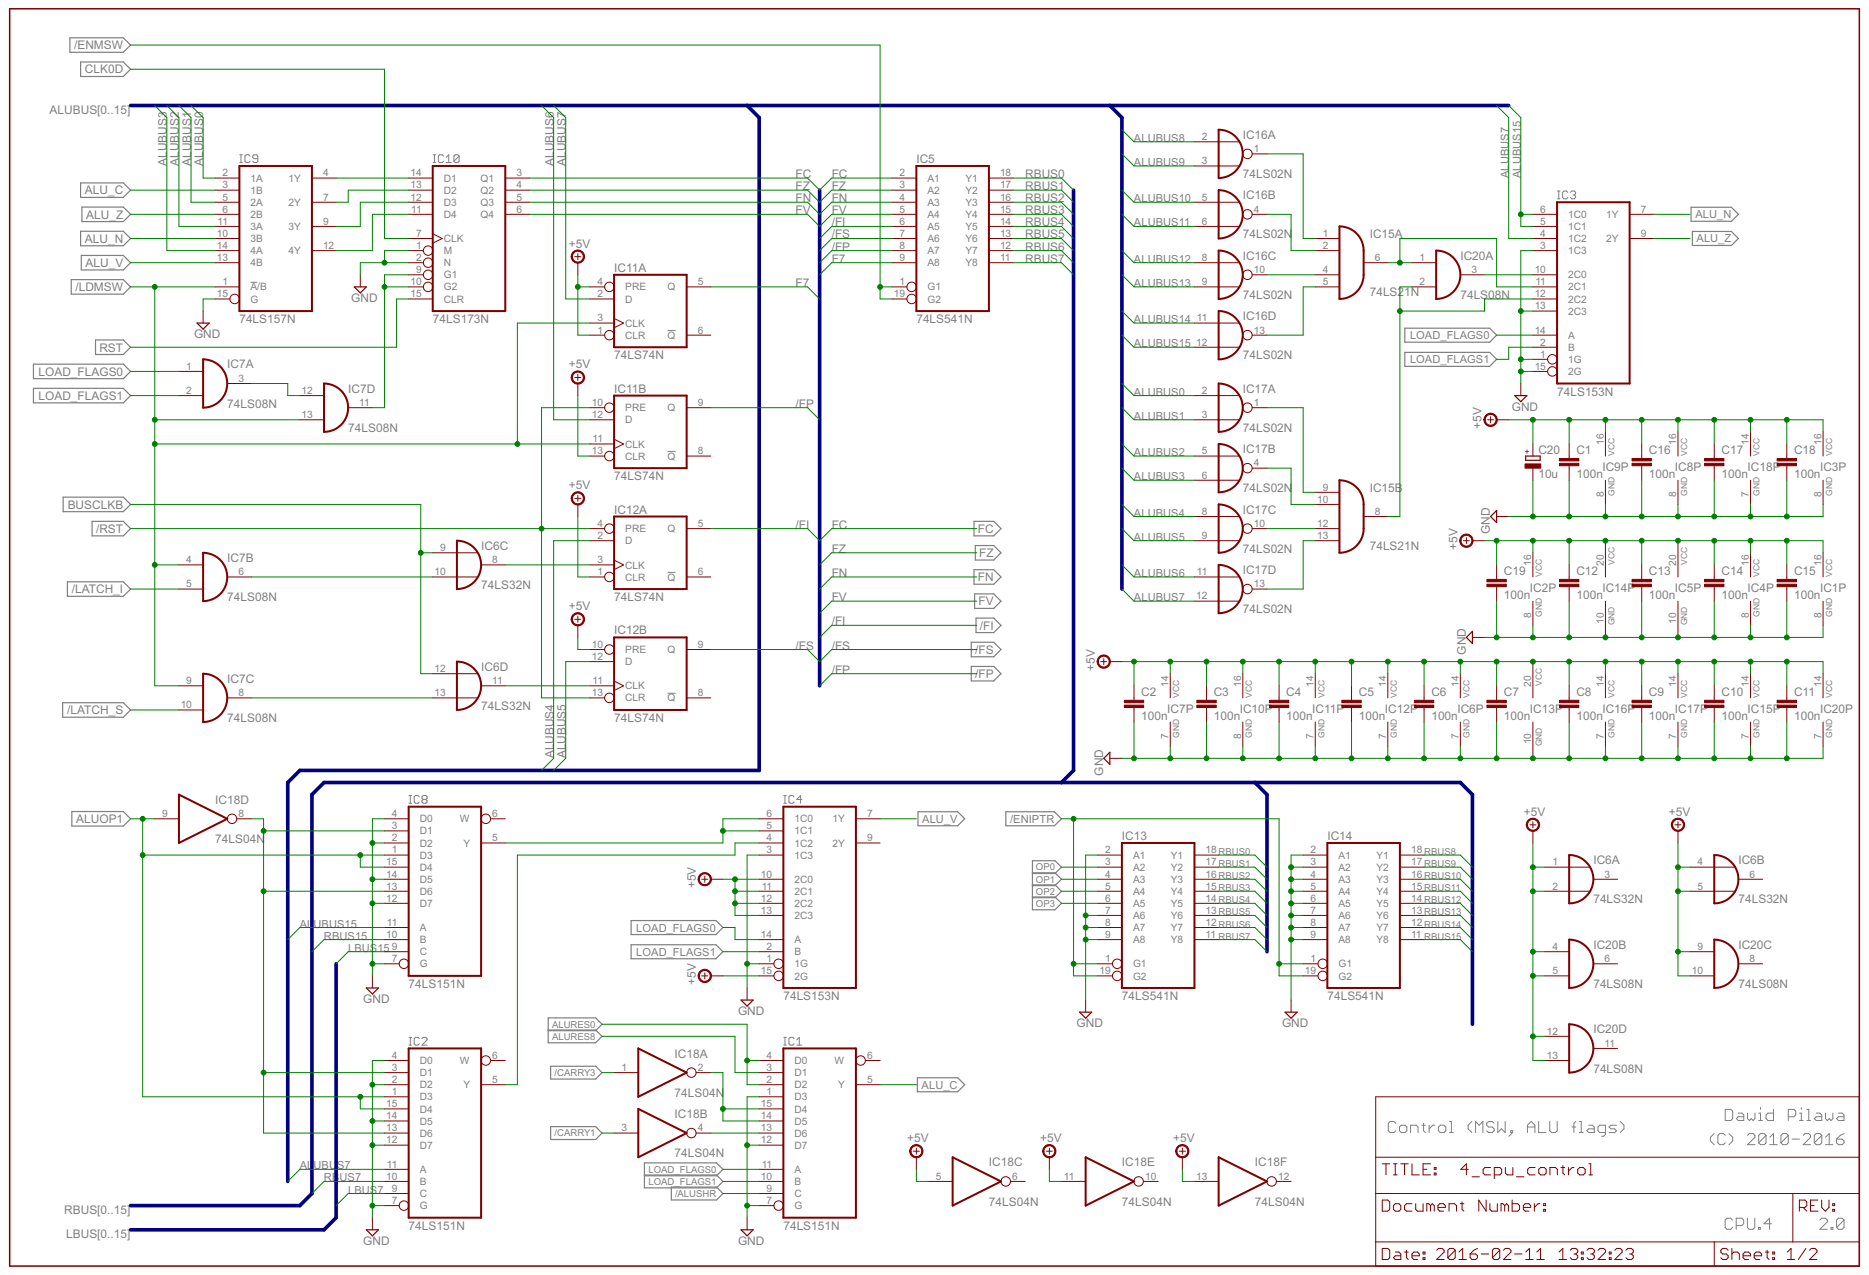
[picture p55: page 9]

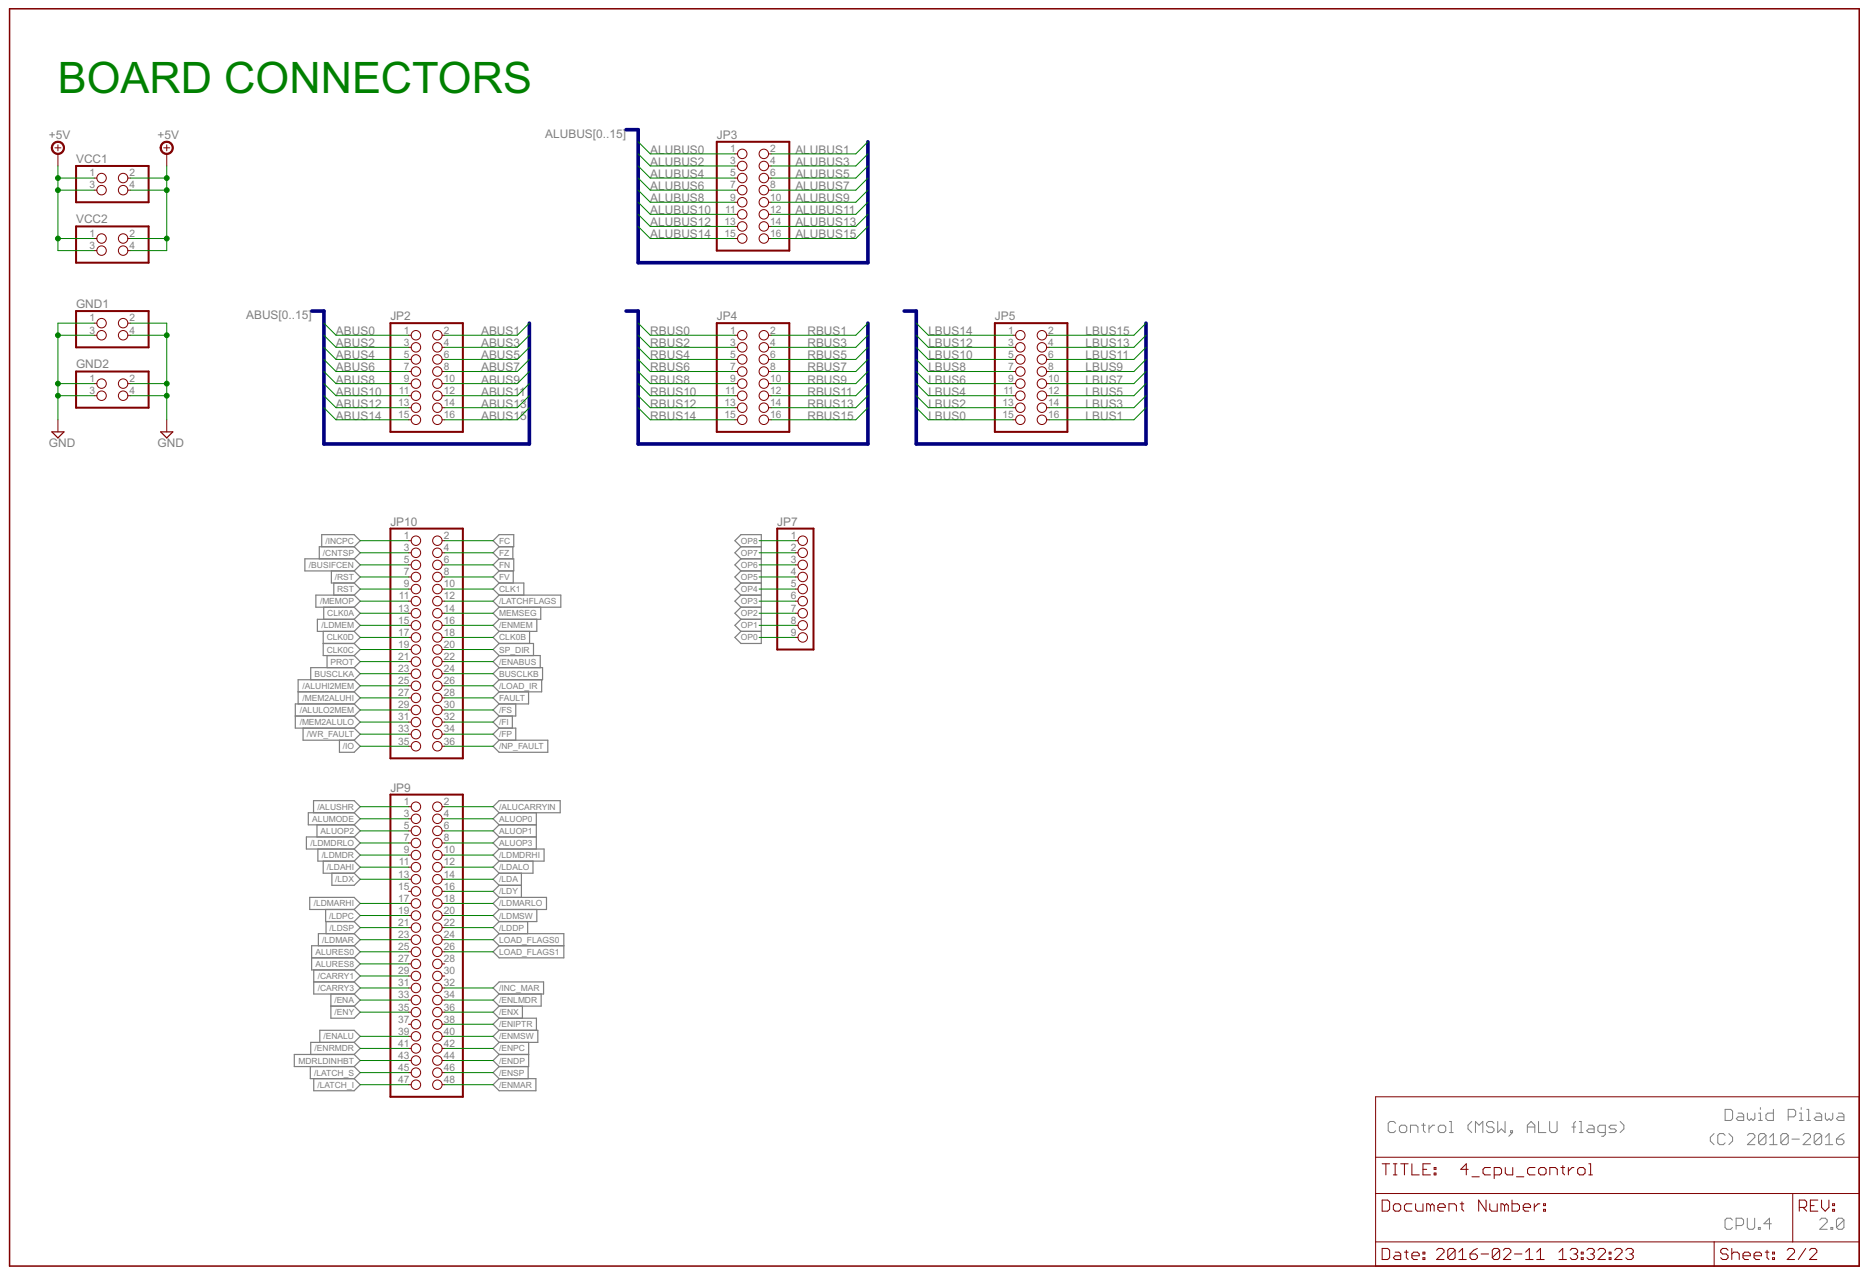
[picture p56: page 10]
+5V GND; GND VCC1 1; 16 VCC2 1; 4 GND1 1; 4 GND2 1; 16 ALUBUS[0..15] ABUS[0..15]; ALUBUS0; ALUBUS1 LOAD_FLAGS0 LOAD_FLAGS1 /LDMSW /LATCH_S /RST /LATCH_I; ALUBUS2; ALUBUS3 FCFZFNFV/FI /FS /ENMSW; RBUS0; RBUS1 RBUS2; RBUS3 RBUS4; RBUS5 RBUS6; RBUS7 RST; ALUBUS6; ALUBUS7 BUSCLKB; ALUBUS4; ALUBUS5 CLK0D ALURES0 ALURES8; ALUOP1 /ALUSHR; LBUS7 LBUS15 /CARRY1; RBUS15 /CARRY3; ALUBUS8; ALUBUS9 ALUBUS10; ALUBUS11 ALUBUS12; ALUBUS13 ALUBUS14; ALUBUS15 RBUS8; RBUS9 RBUS10; RBUS11 RBUS12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

4 G3

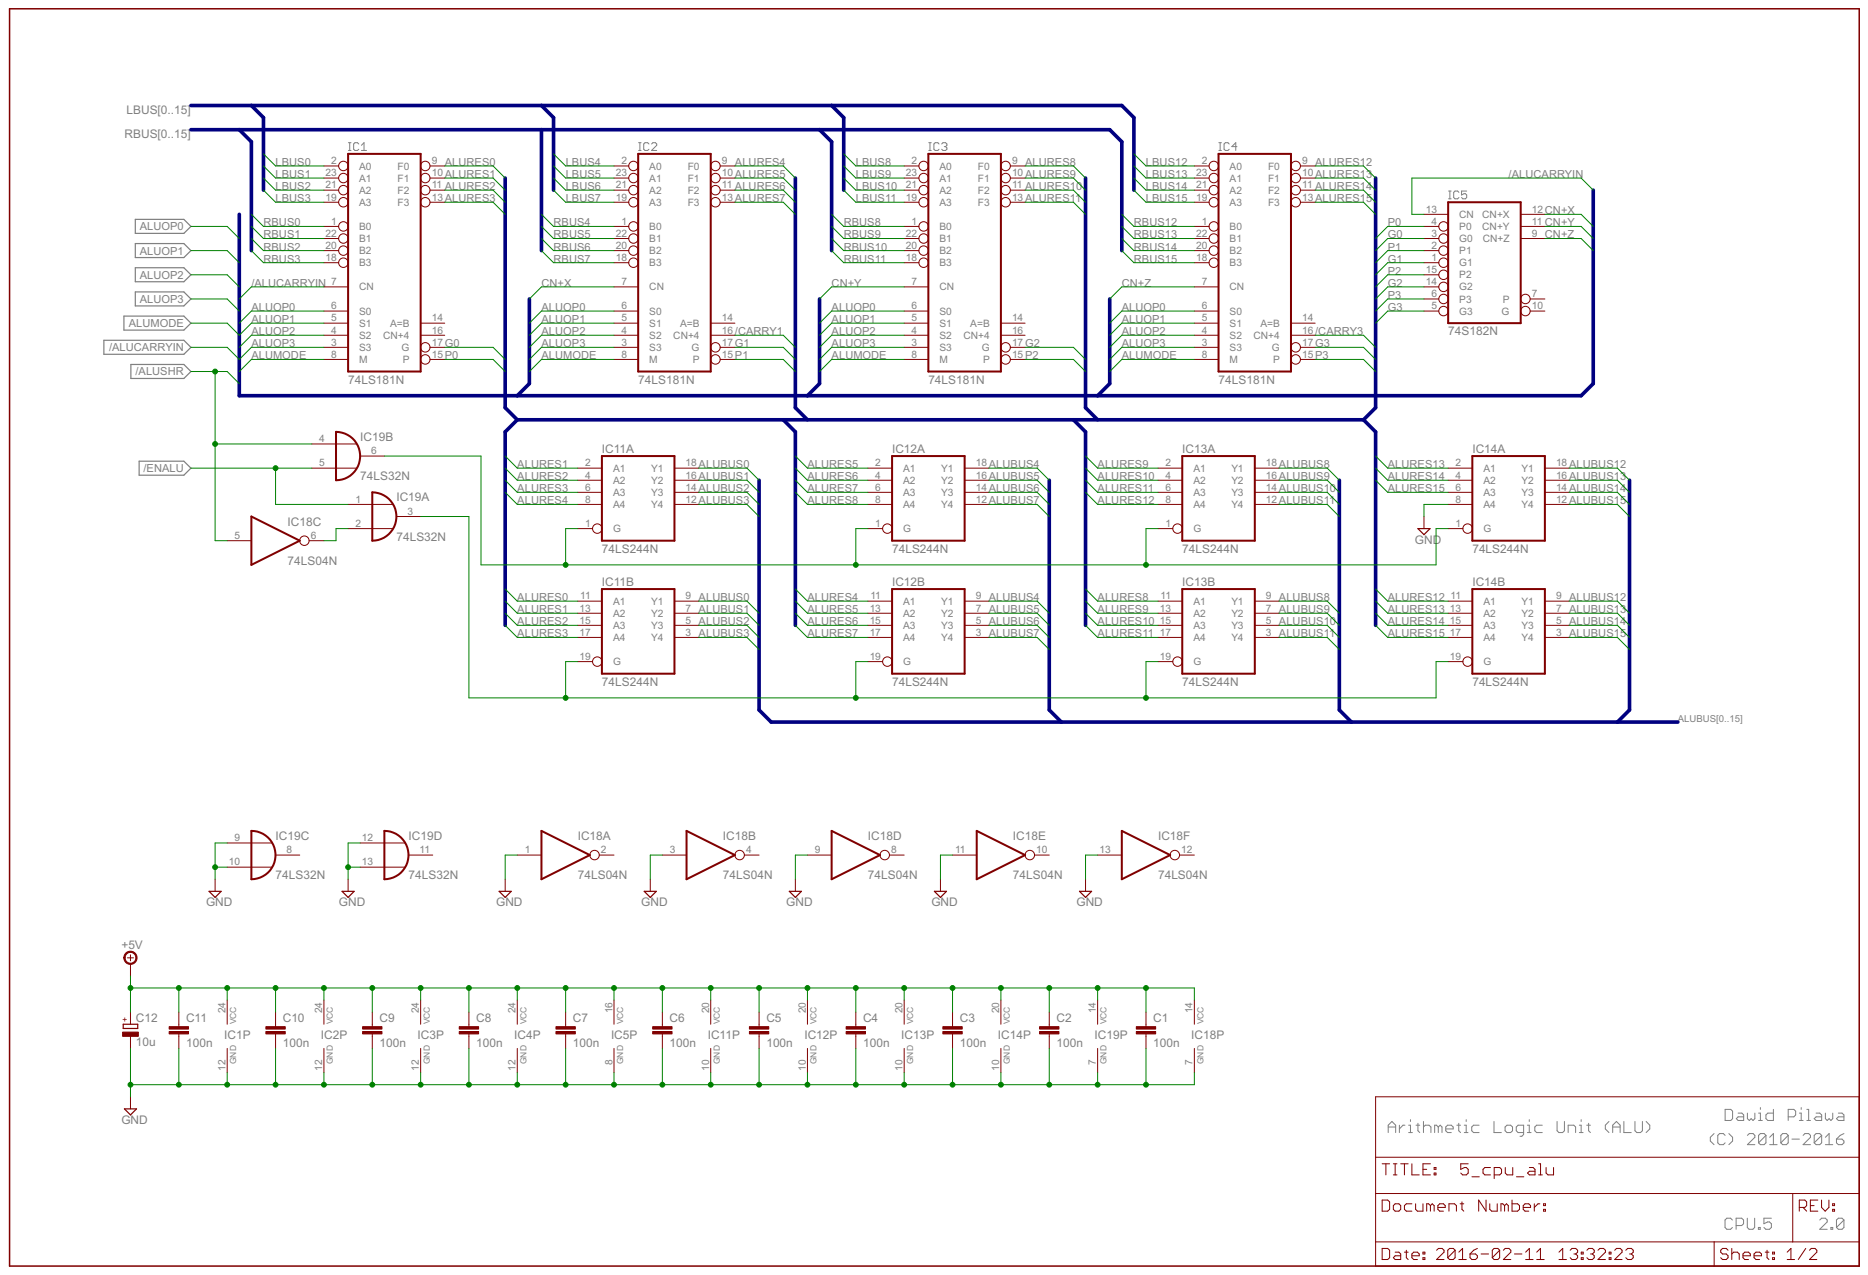
[picture p57: page 11]

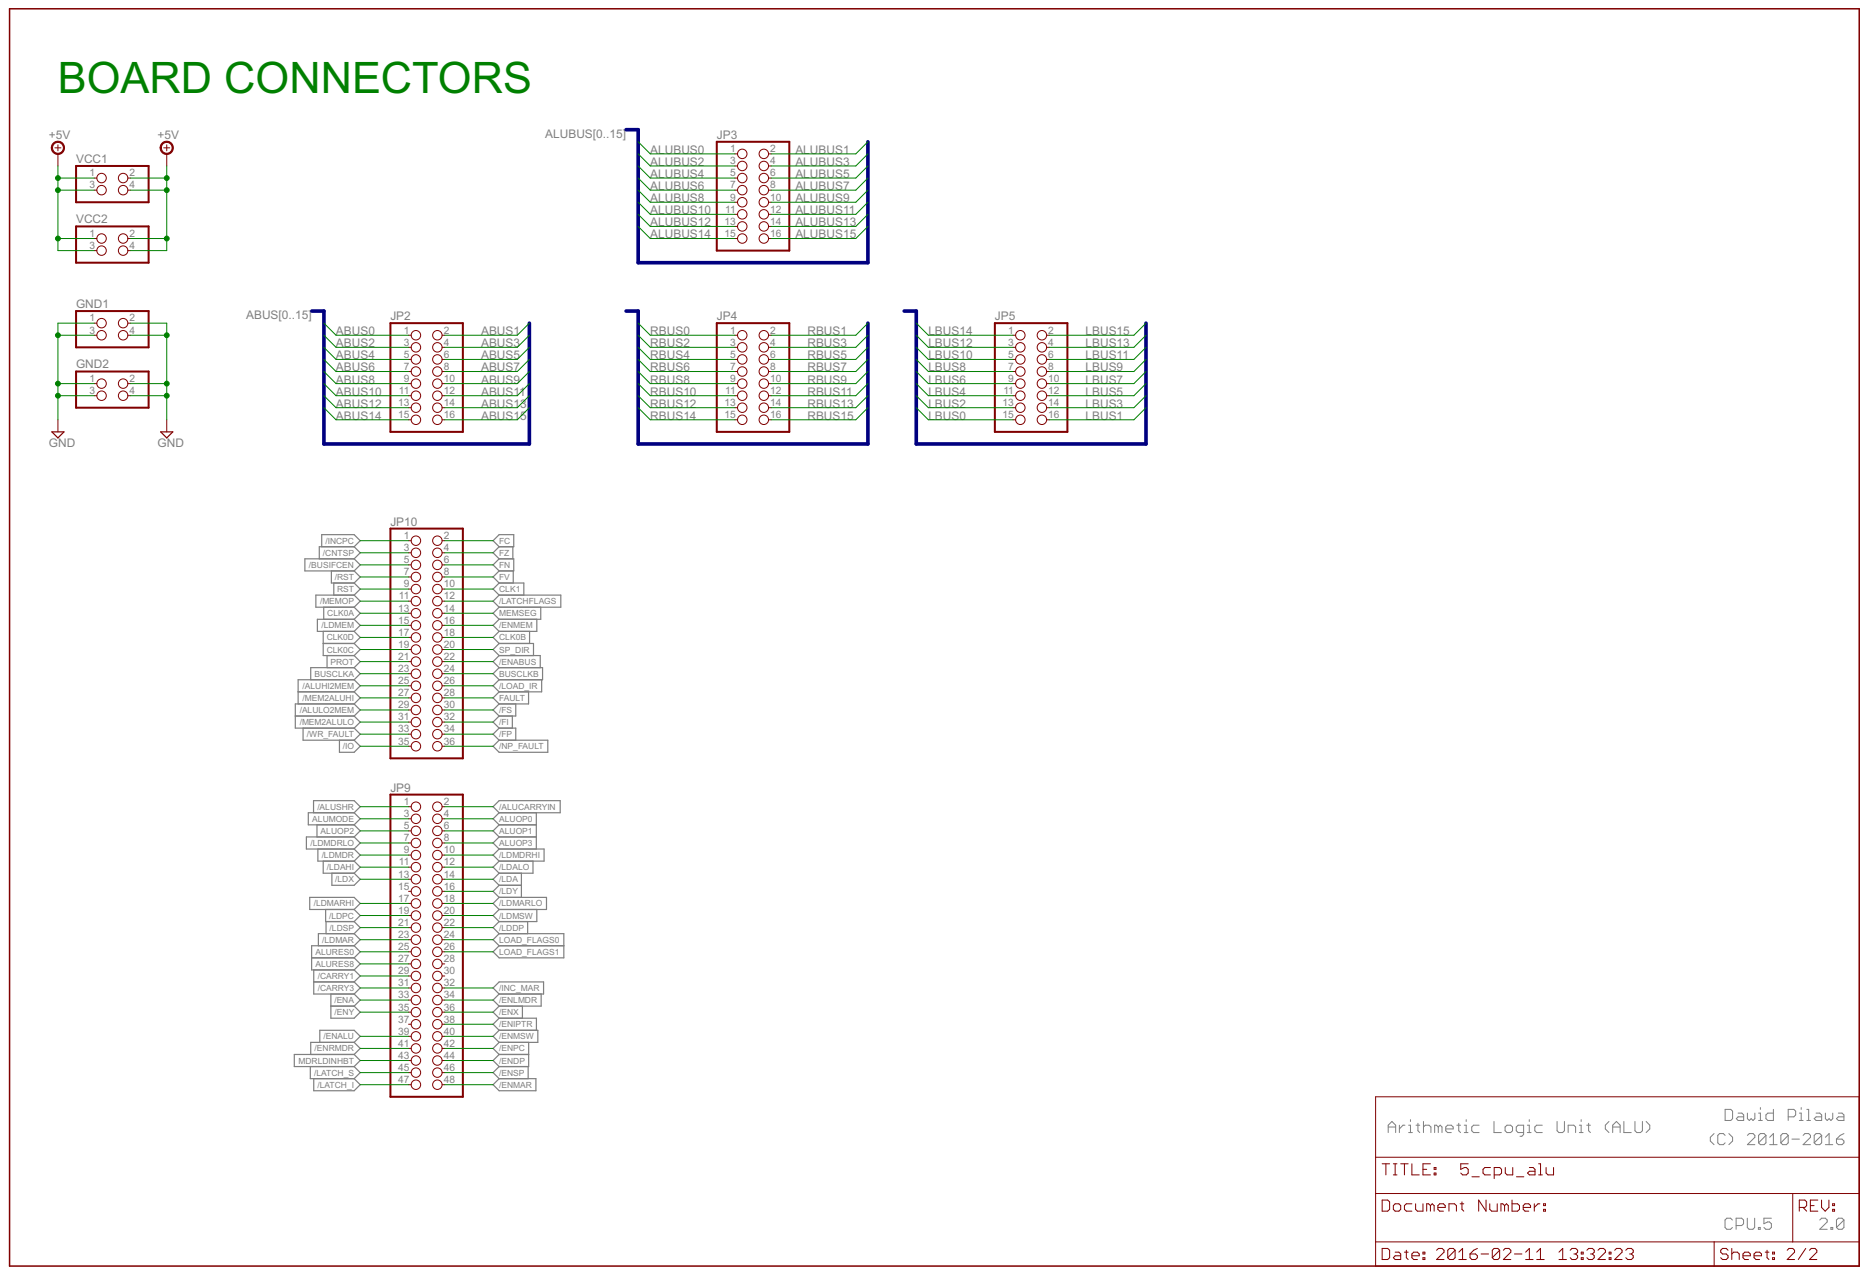
[picture p58: page 12]
+5V GND; GND VCC1 1; 16 VCC2 1; 4 GND1 1; 4 GND2 1; 16 ALUBUS[0..15] ABUS[0..15]; ALURES0 ALURES8; /ALUCARRYIN ALUOP0 ALUOP2; ALUOP1 ALUOP3 ALUMODE /ALUSHR /ENALU; LBUS0; LBUS1 LBUS2; LBUS3 RBUS0; RBUS1 RBUS2; RBUS3; LBUS4; LBUS5 LBUS6; LBUS7 RBUS4; RBUS5 RBUS6; RBUS7; LBUS8; LBUS9 LBUS10; LBUS11 RBUS8; RBUS9 RBUS10; RBUS11; LBUS12; LBUS13 LBUS14; LBUS15 /CARRY1; RBUS12; RBUS13 RBUS14; RBUS15 /CARRY3; ALUBUS0; ALUBUS1 ALUBUS2; ALUBUS3 ALUBUS4; ALUBUS5 ALUBUS6; ALUBUS7 ALUBUS8; ALUBUS9 ALUBUS10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

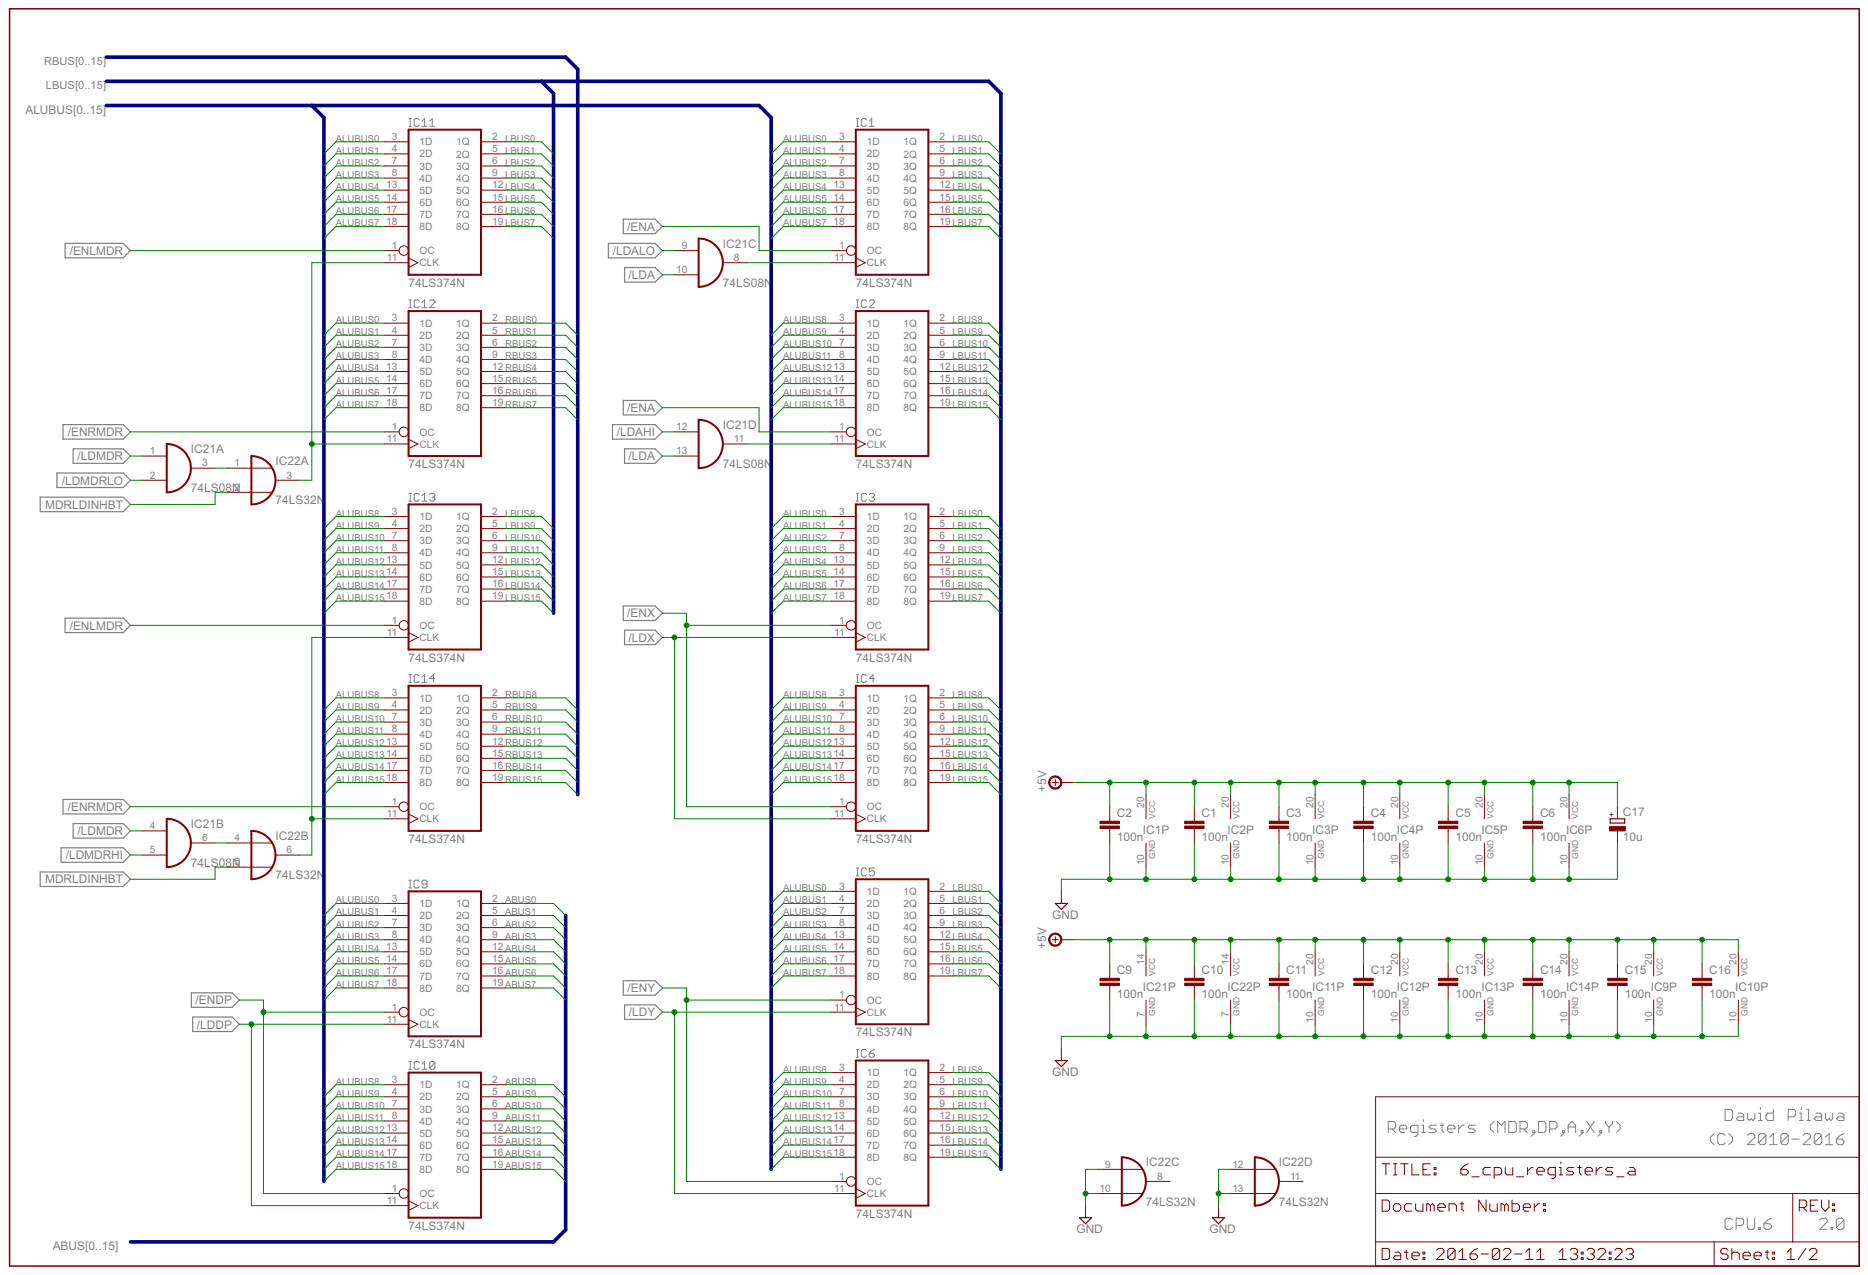
[picture p59: page 13]

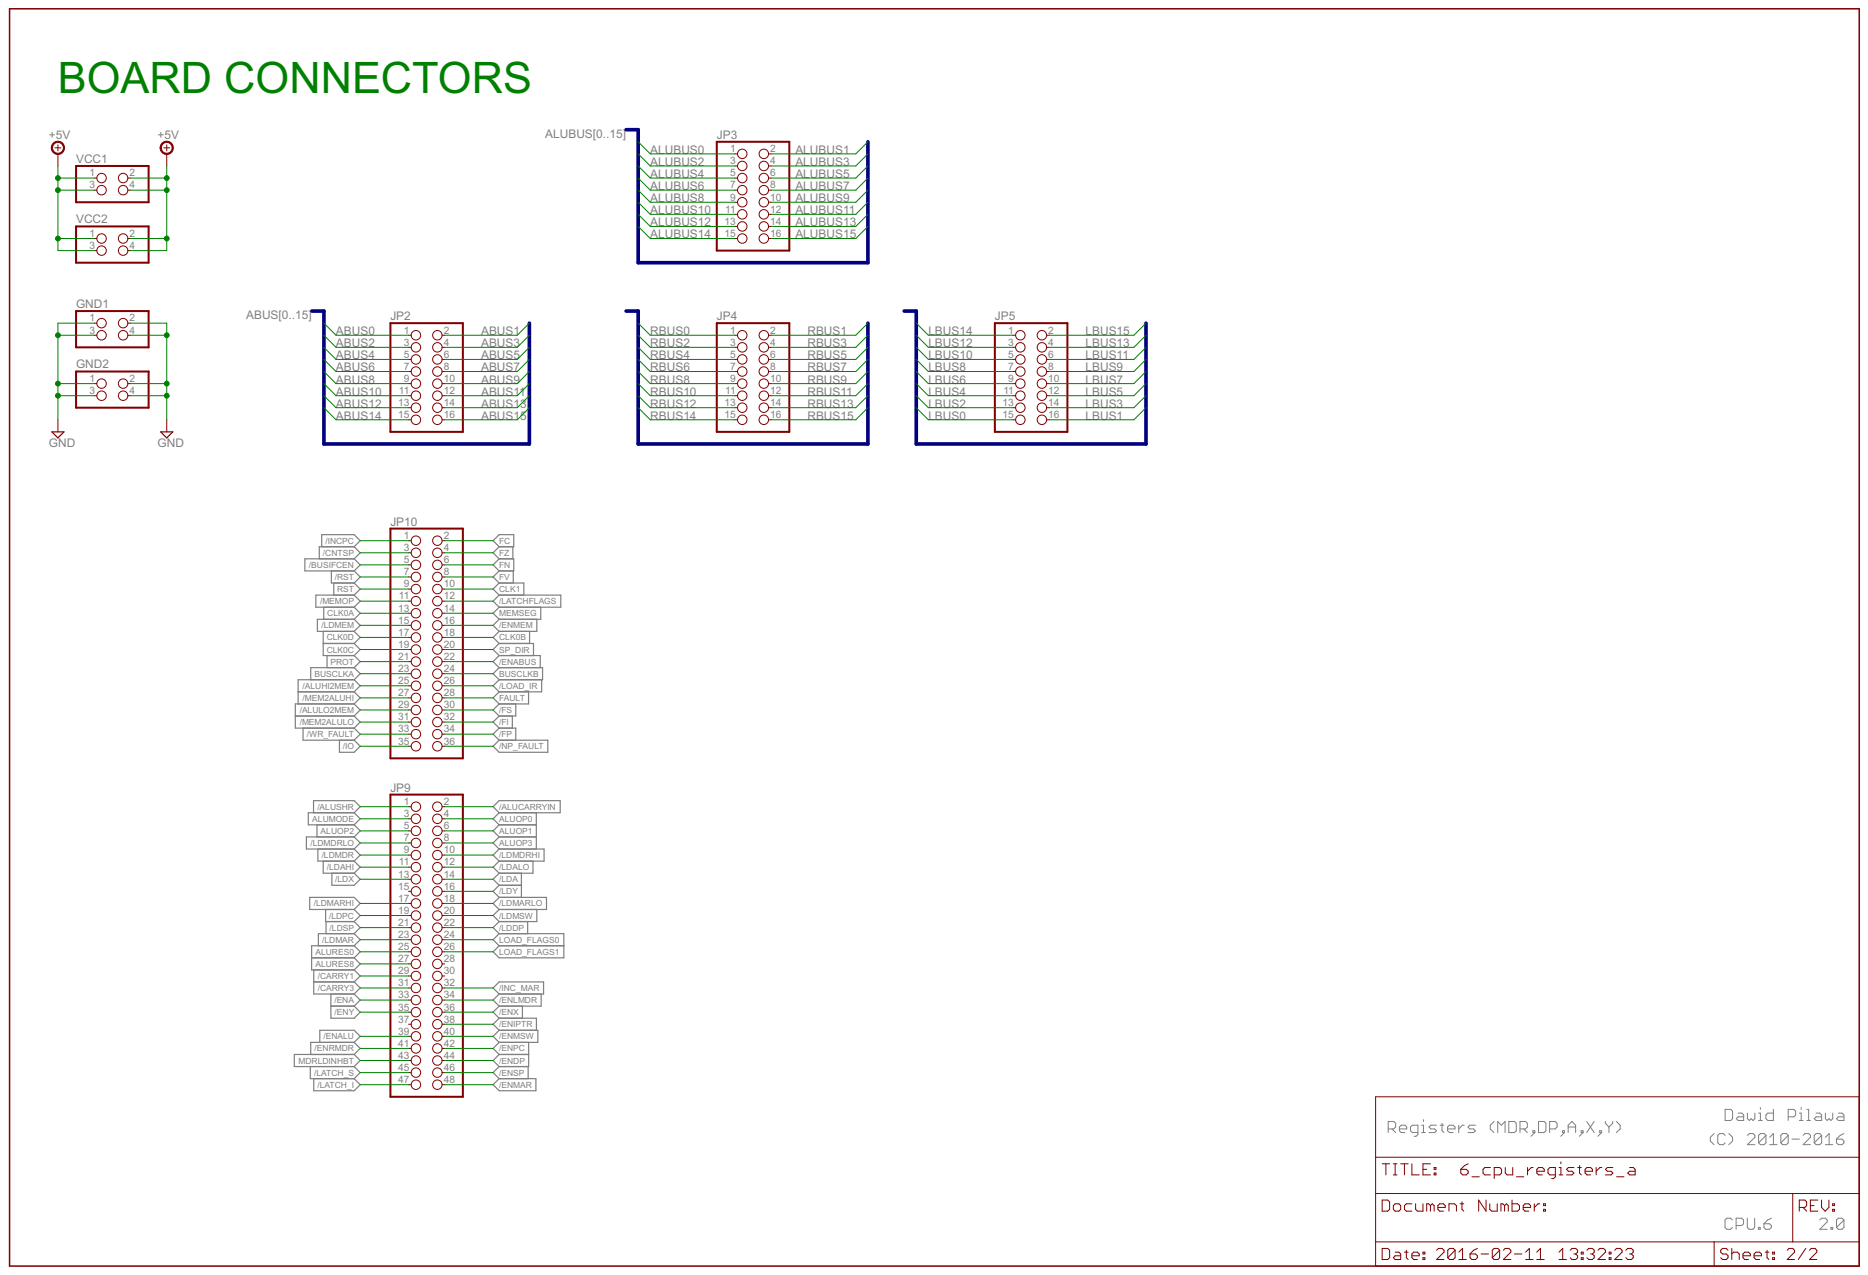
[picture p60: page 14]
+5V GND; GND VCC1 1; 16 VCC2 1; 4 GND1 1; 4 GND2 1; 16 ALUBUS[0..15] ABUS[0..15]; /LDMDR /LDMDRLO MDRLDINHBT; /LDMDRHI; ALUBUS0; ALUBUS1 ALUBUS2; ALUBUS3 ALUBUS4; ALUBUS5 ALUBUS6; ALUBUS7 ALUBUS9 ALUBUS10; ALUBUS11 ALUBUS12; ALUBUS13 ALUBUS15 ALUBUS8 ALUBUS14; LBUS0; LBUS1 LBUS2; LBUS3 RBUS0; RBUS1 RBUS2; RBUS3; LBUS4; LBUS5 LBUS7 LBUS8; LBUS9 LBUS10; LBUS11 LBUS12; LBUS13 LBUS14; LBUS15 LBUS6 RBUS4; RBUS5 RBUS6; RBUS7 RBUS8; RBUS9 RBUS10; RBUS11 RBUS12; RBUS13 RBUS14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

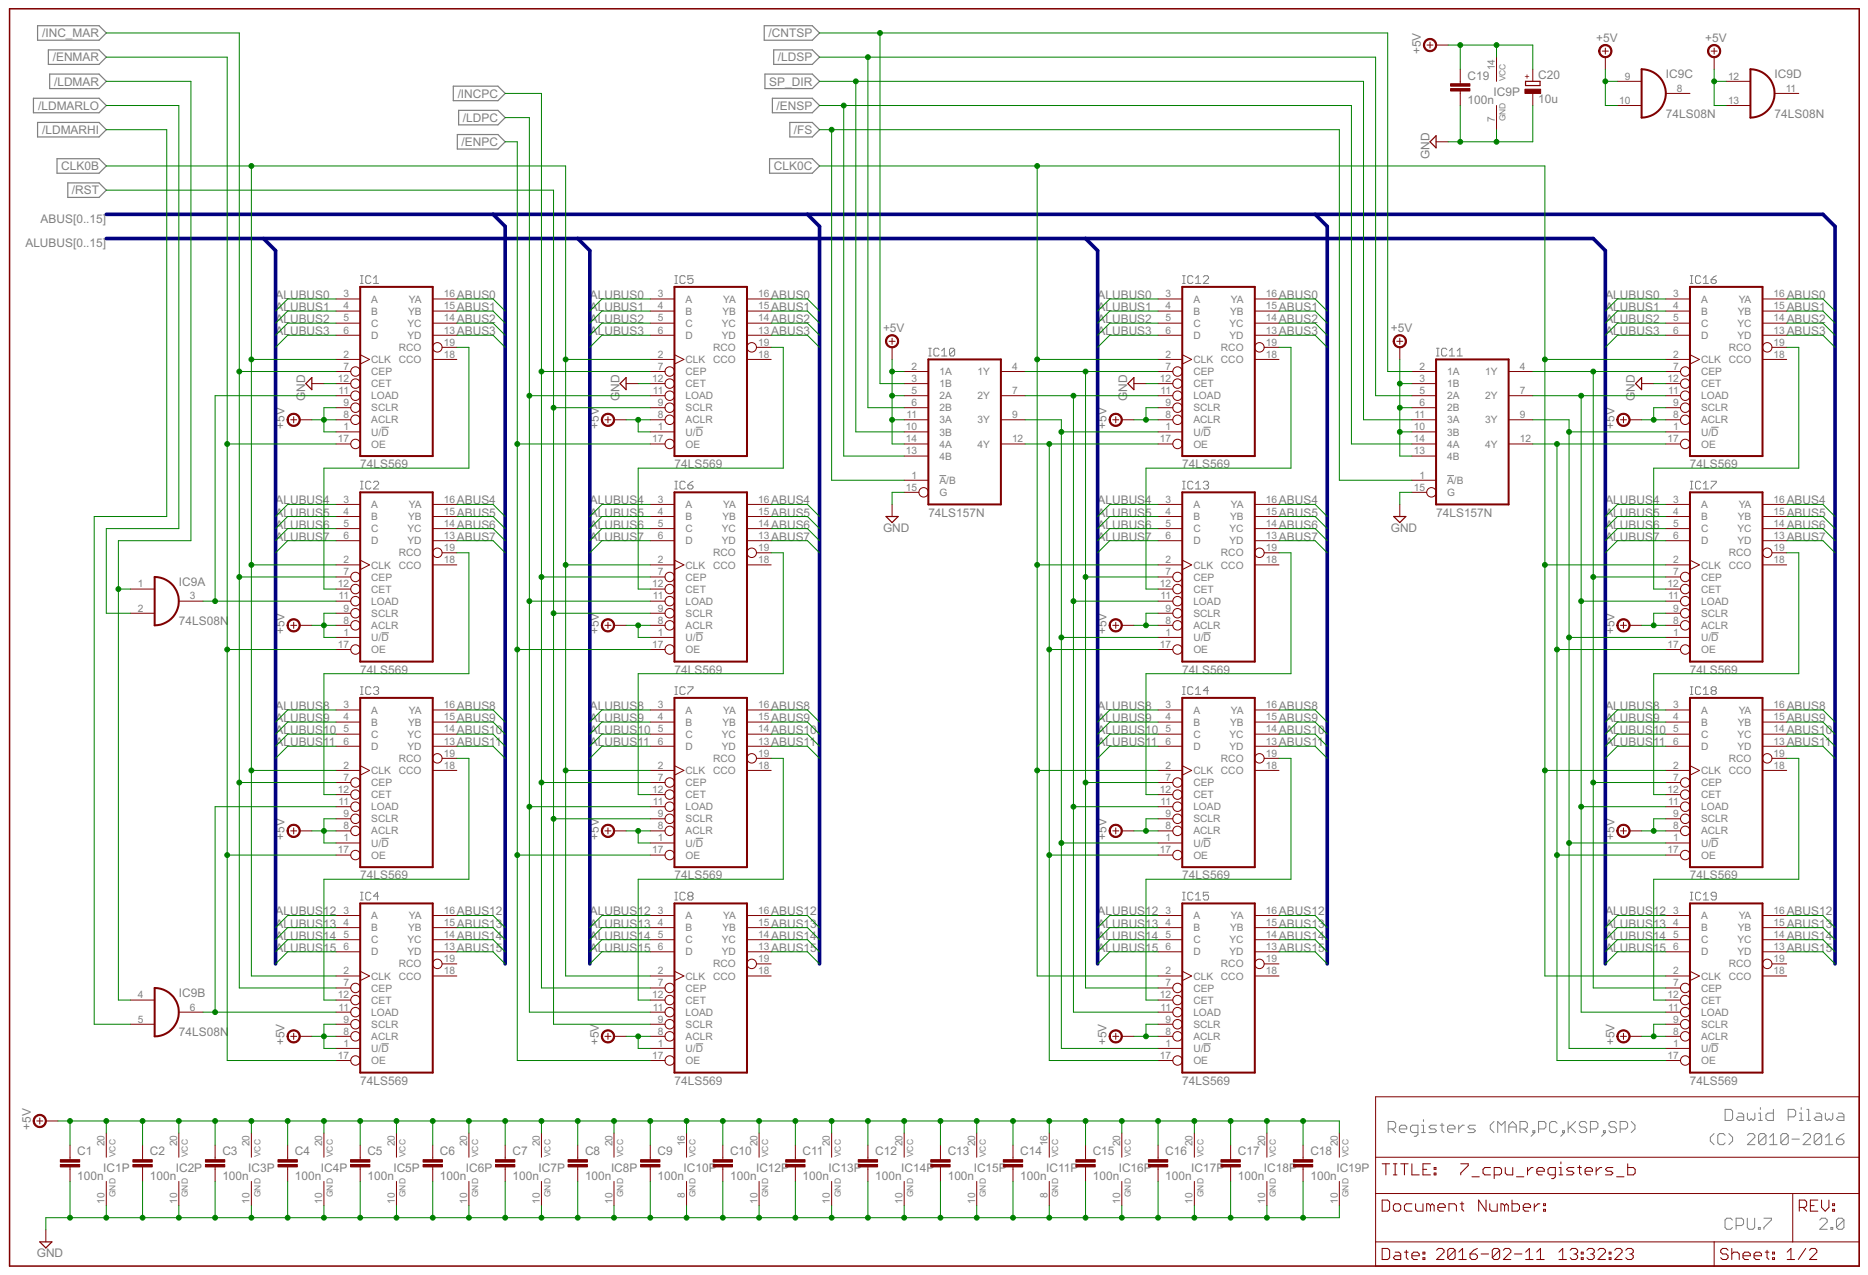
[picture p61: page 15]

# BOARD CONNECTORS

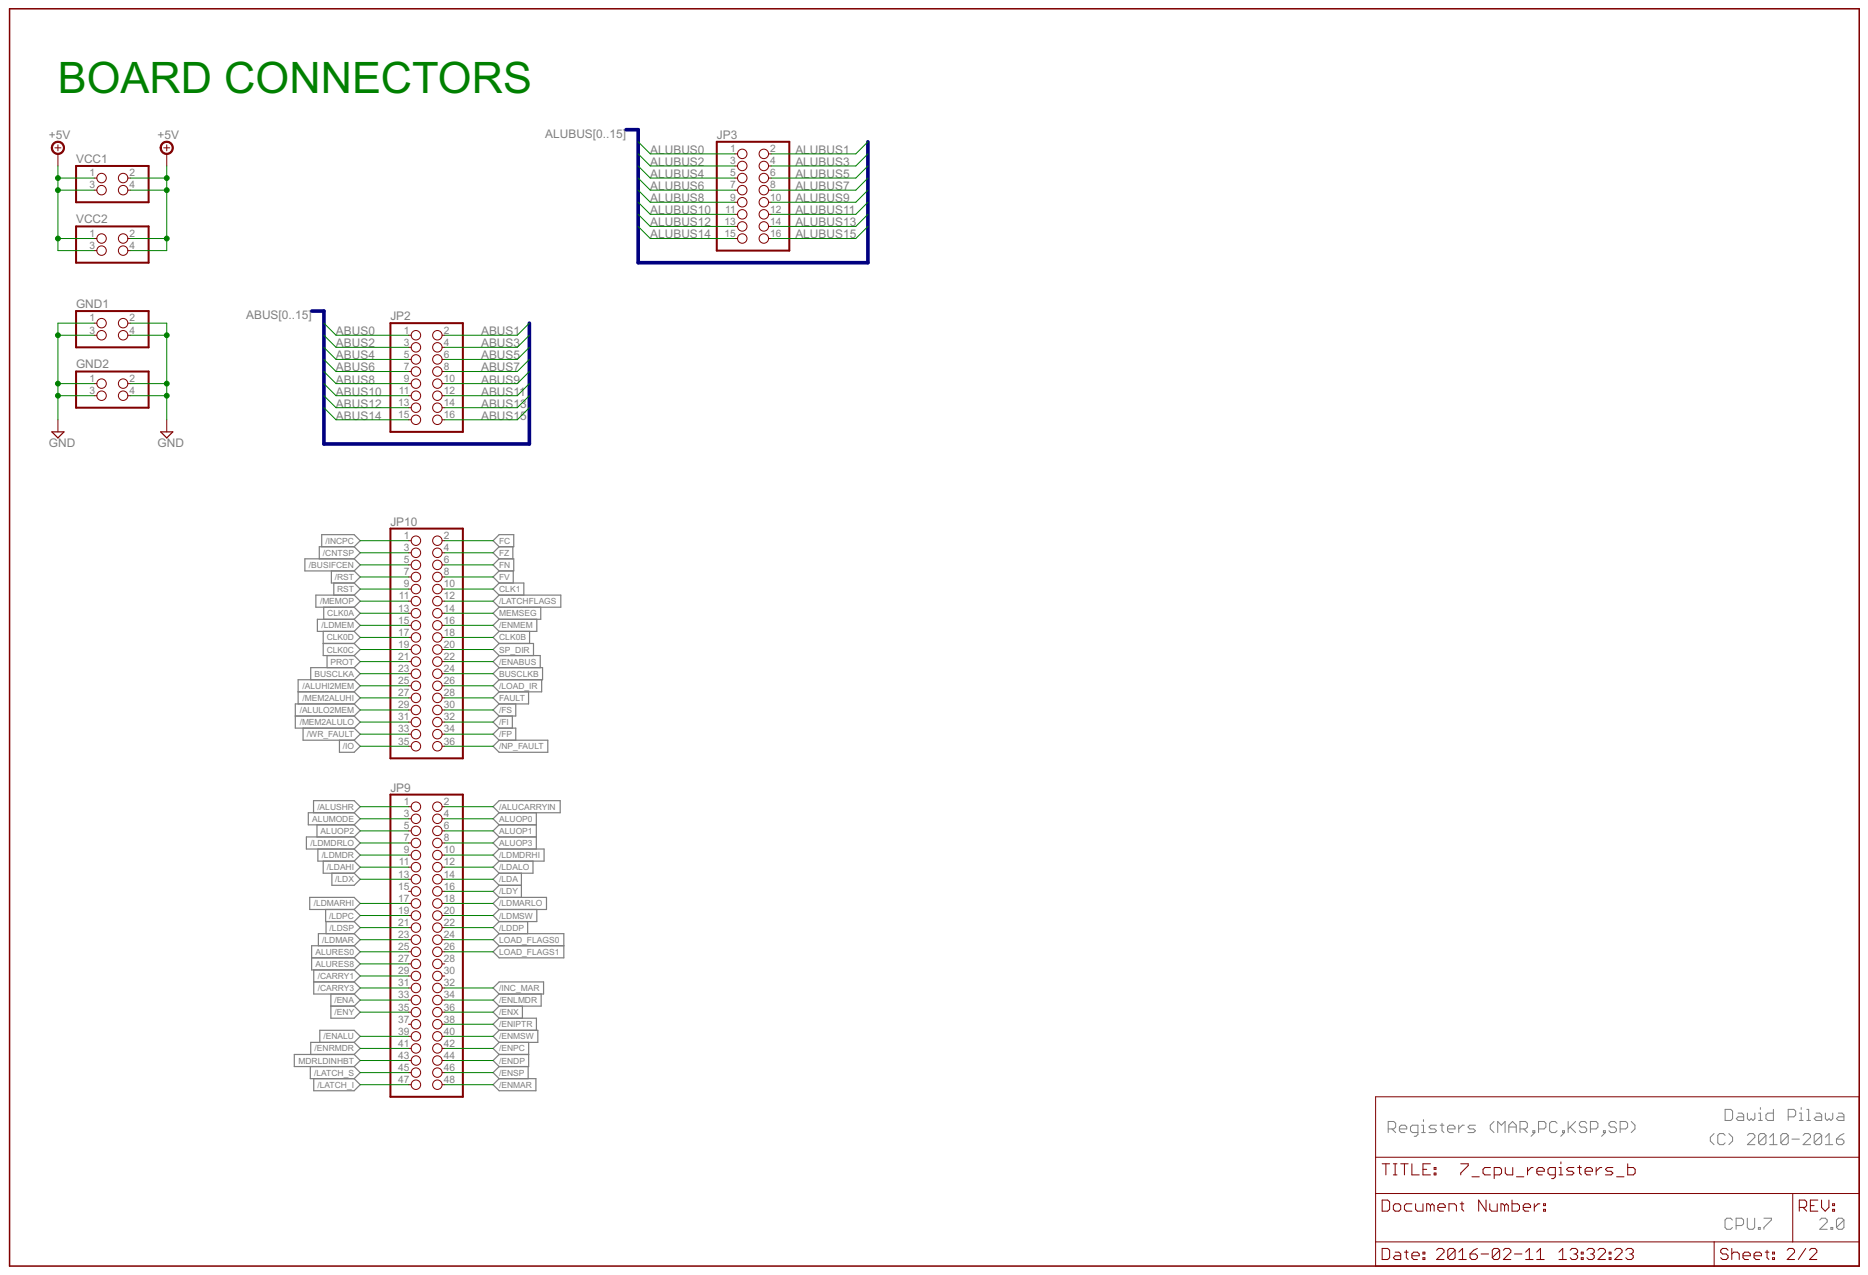
[picture p62: page 16]
GND; VCC1; VCC2; 4 GND1; 4 GND2; ALUBUS[0..15]; ABUS[0..15]; ALUBUS0; ALUBUS1; ALUBUS2; ALUBUS3; ALUBUS4; ALUBUS5; ALUBUS6; ALUBUS7; ALUBUS8; ALUBUS9; ALUBUS10; ALUBUS11; ALUBUS12; ALUBUS13; ALUBUS14; ALUBUS15; /RST; /INCPC; /LDPC; /ENPC; ABUS0; ABUS1; ABUS2; ABUS3; ABUS4; ABUS5; ABUS6; ABUS7; ABUS8; ABUS9; ABUS10; ABUS11; ABUS12; ABUS13; ABUS14; ABUS15; /INC_MAR; /ENMAR; /LDMAR; /LDMARHI; /LDMARLO; /LDSP; /ENSP; /CNTSP; SP_DIR; CLK0C; CLK0B; LOAD_FLAGS0; LOAD_FLAGS1; /LDMSW; /LATCH_S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

C1C2C3C4C5C6C7C8C9C10 C11 C12 C13 C14 C15 C16 C17 C18 C19 C20 C21 C22 C23 C24 C25 C26 C27 C28 C29 C30 C31 C32 A1A2A3A4A5A6A7A8A9 A10 A11 A12 A13 A14 A15 A16 A17 A18 A19 A20 A21 A22 A23 A24 A25 A26 A27 A28 A29 A30 A31 A32

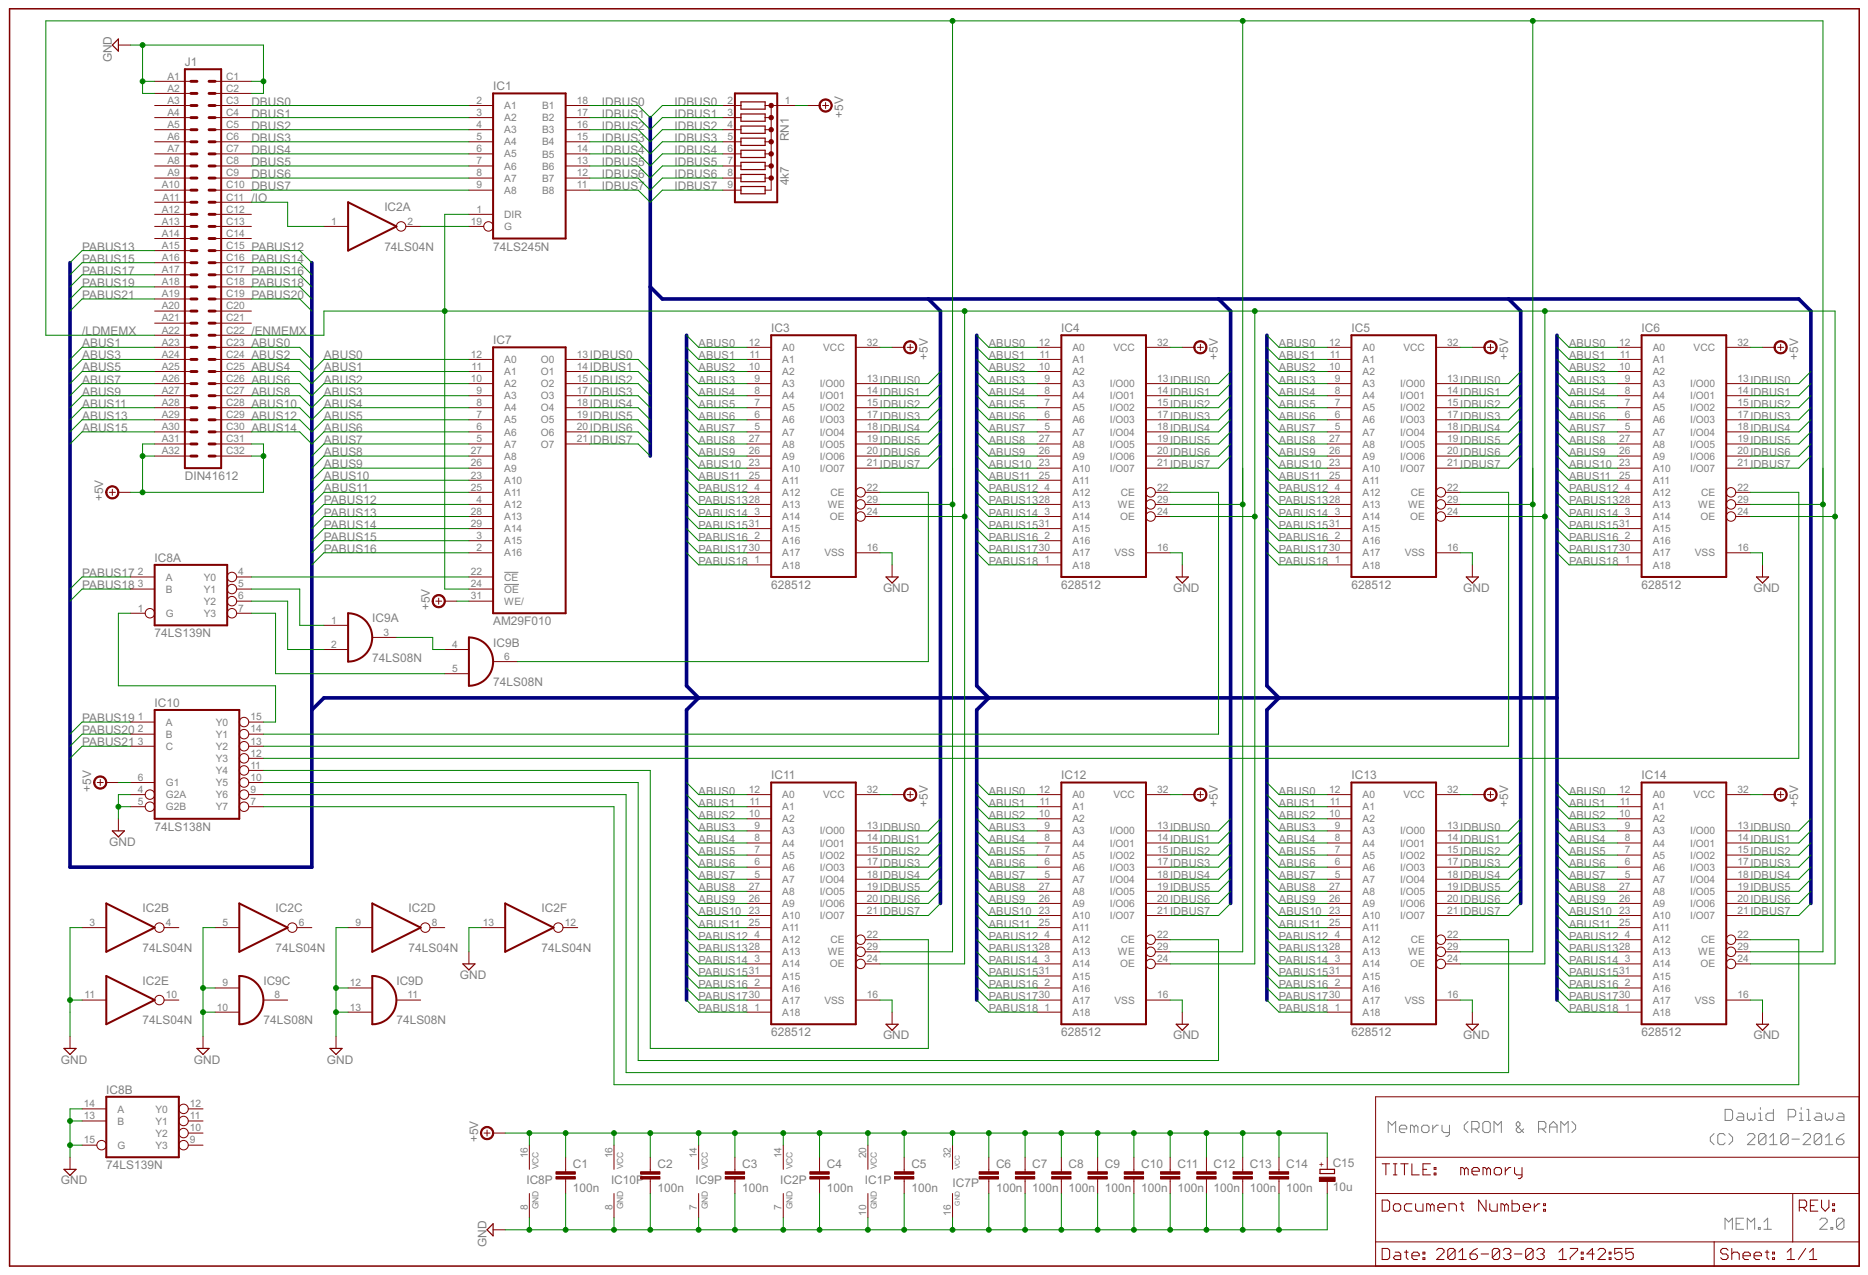
[picture p63: page 17]

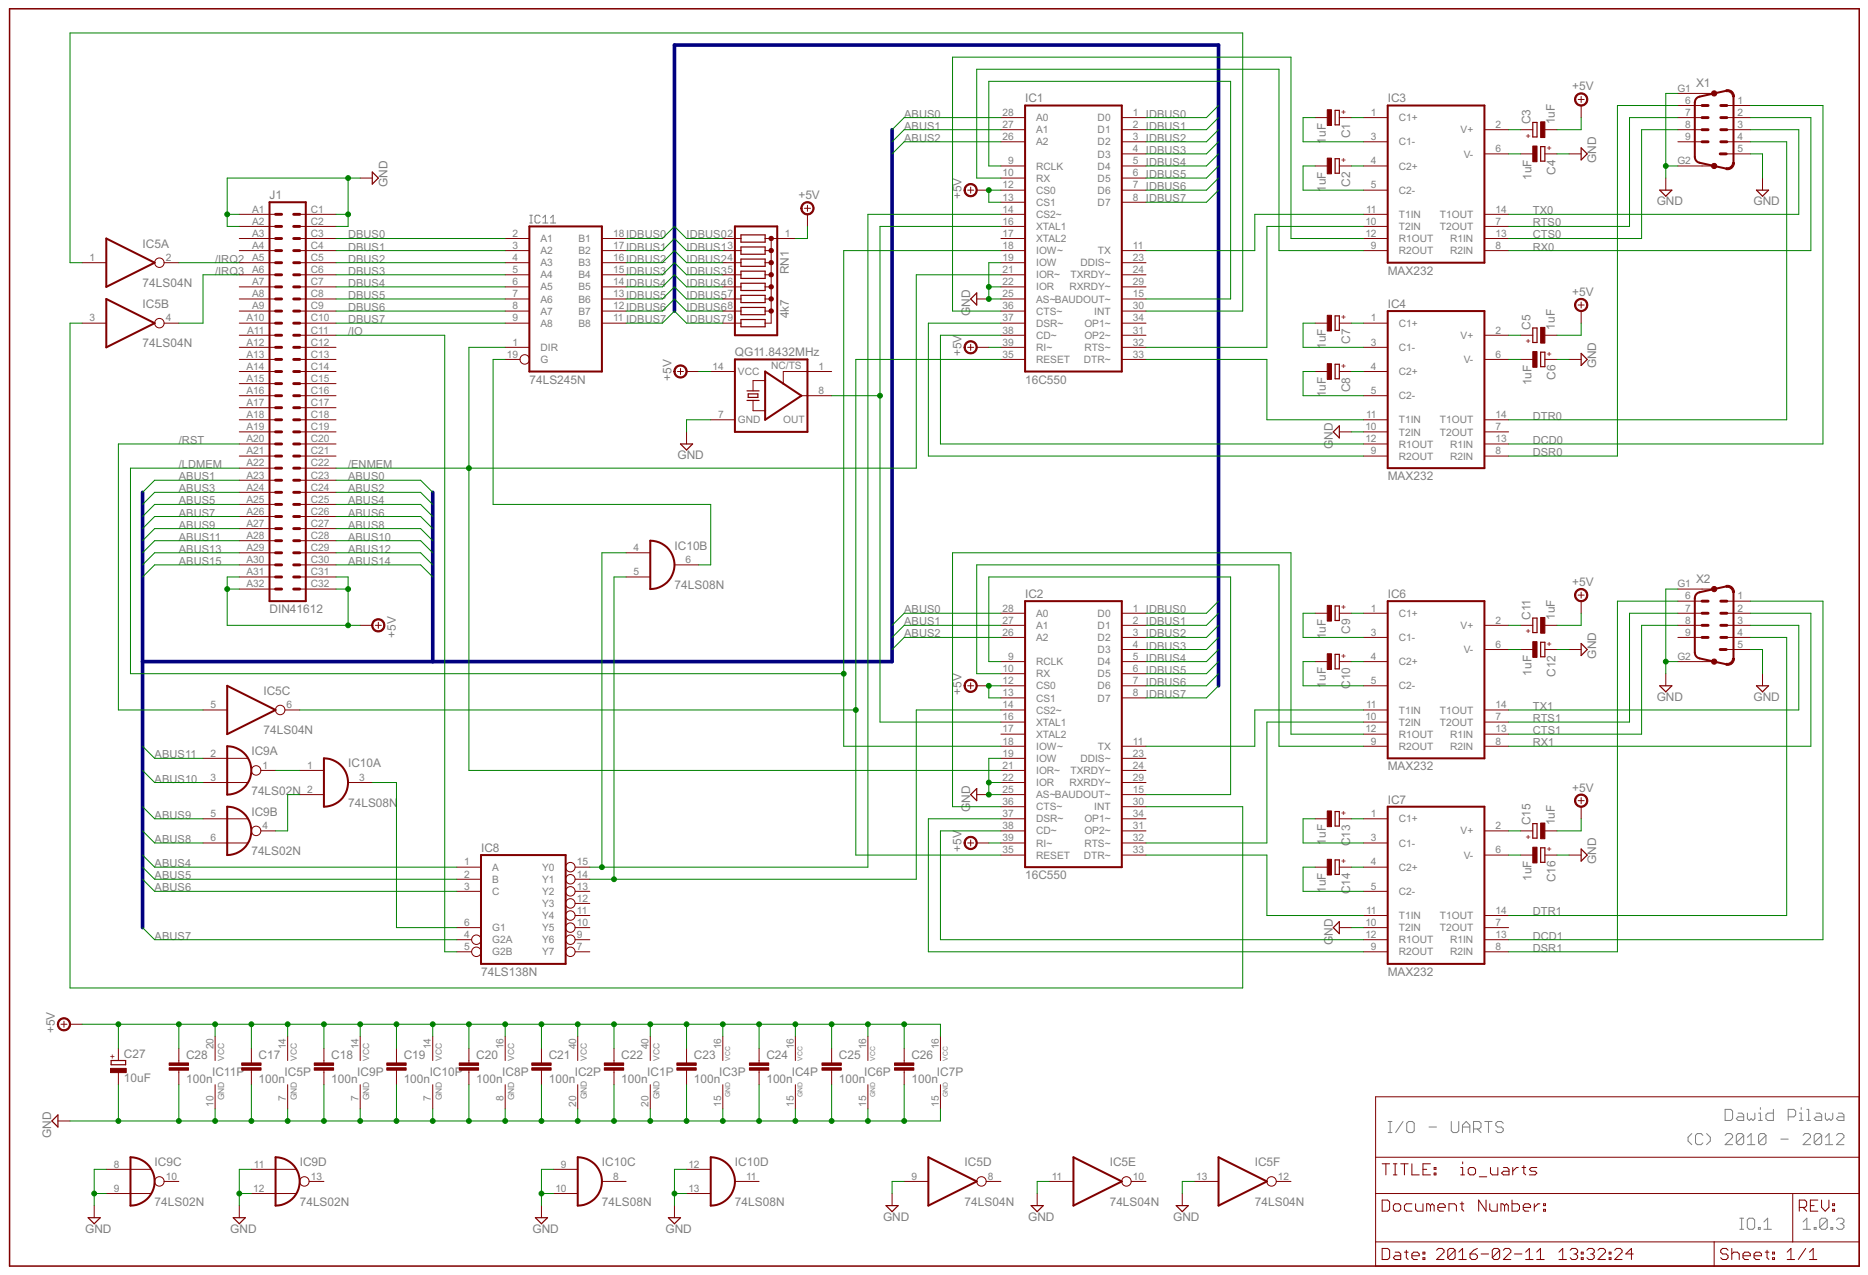
[picture p64: page 18]
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

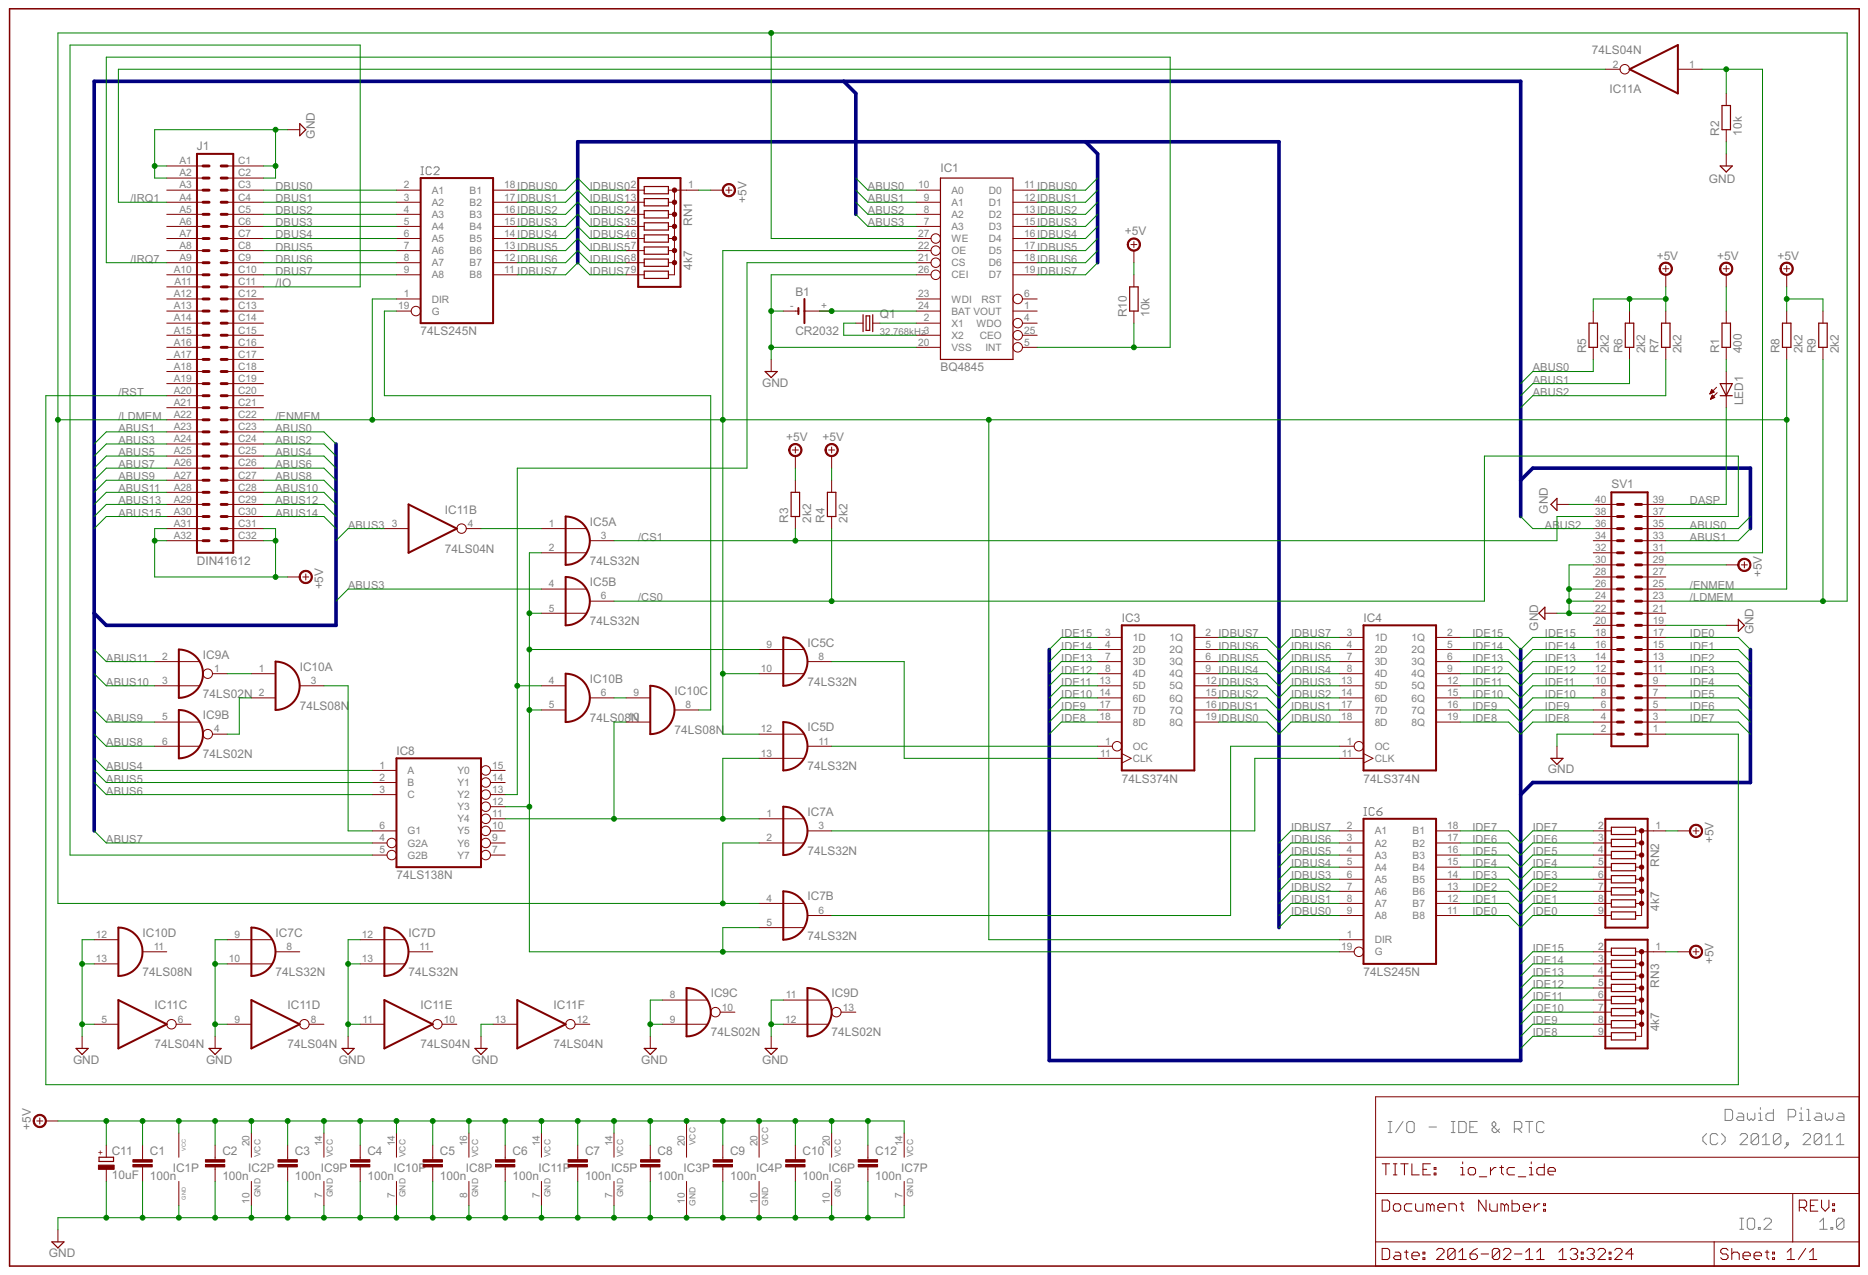
[picture p65: page 19]

16 B2 IDE5 | IDE5 4
15 B3 IDE4 | IDE4 5

13 B5 IDE2 | IDE2 7
12 B6 IDE1 | IDE1 8
