dpilawa/bytec/schematics/schematics_20110327.pdf

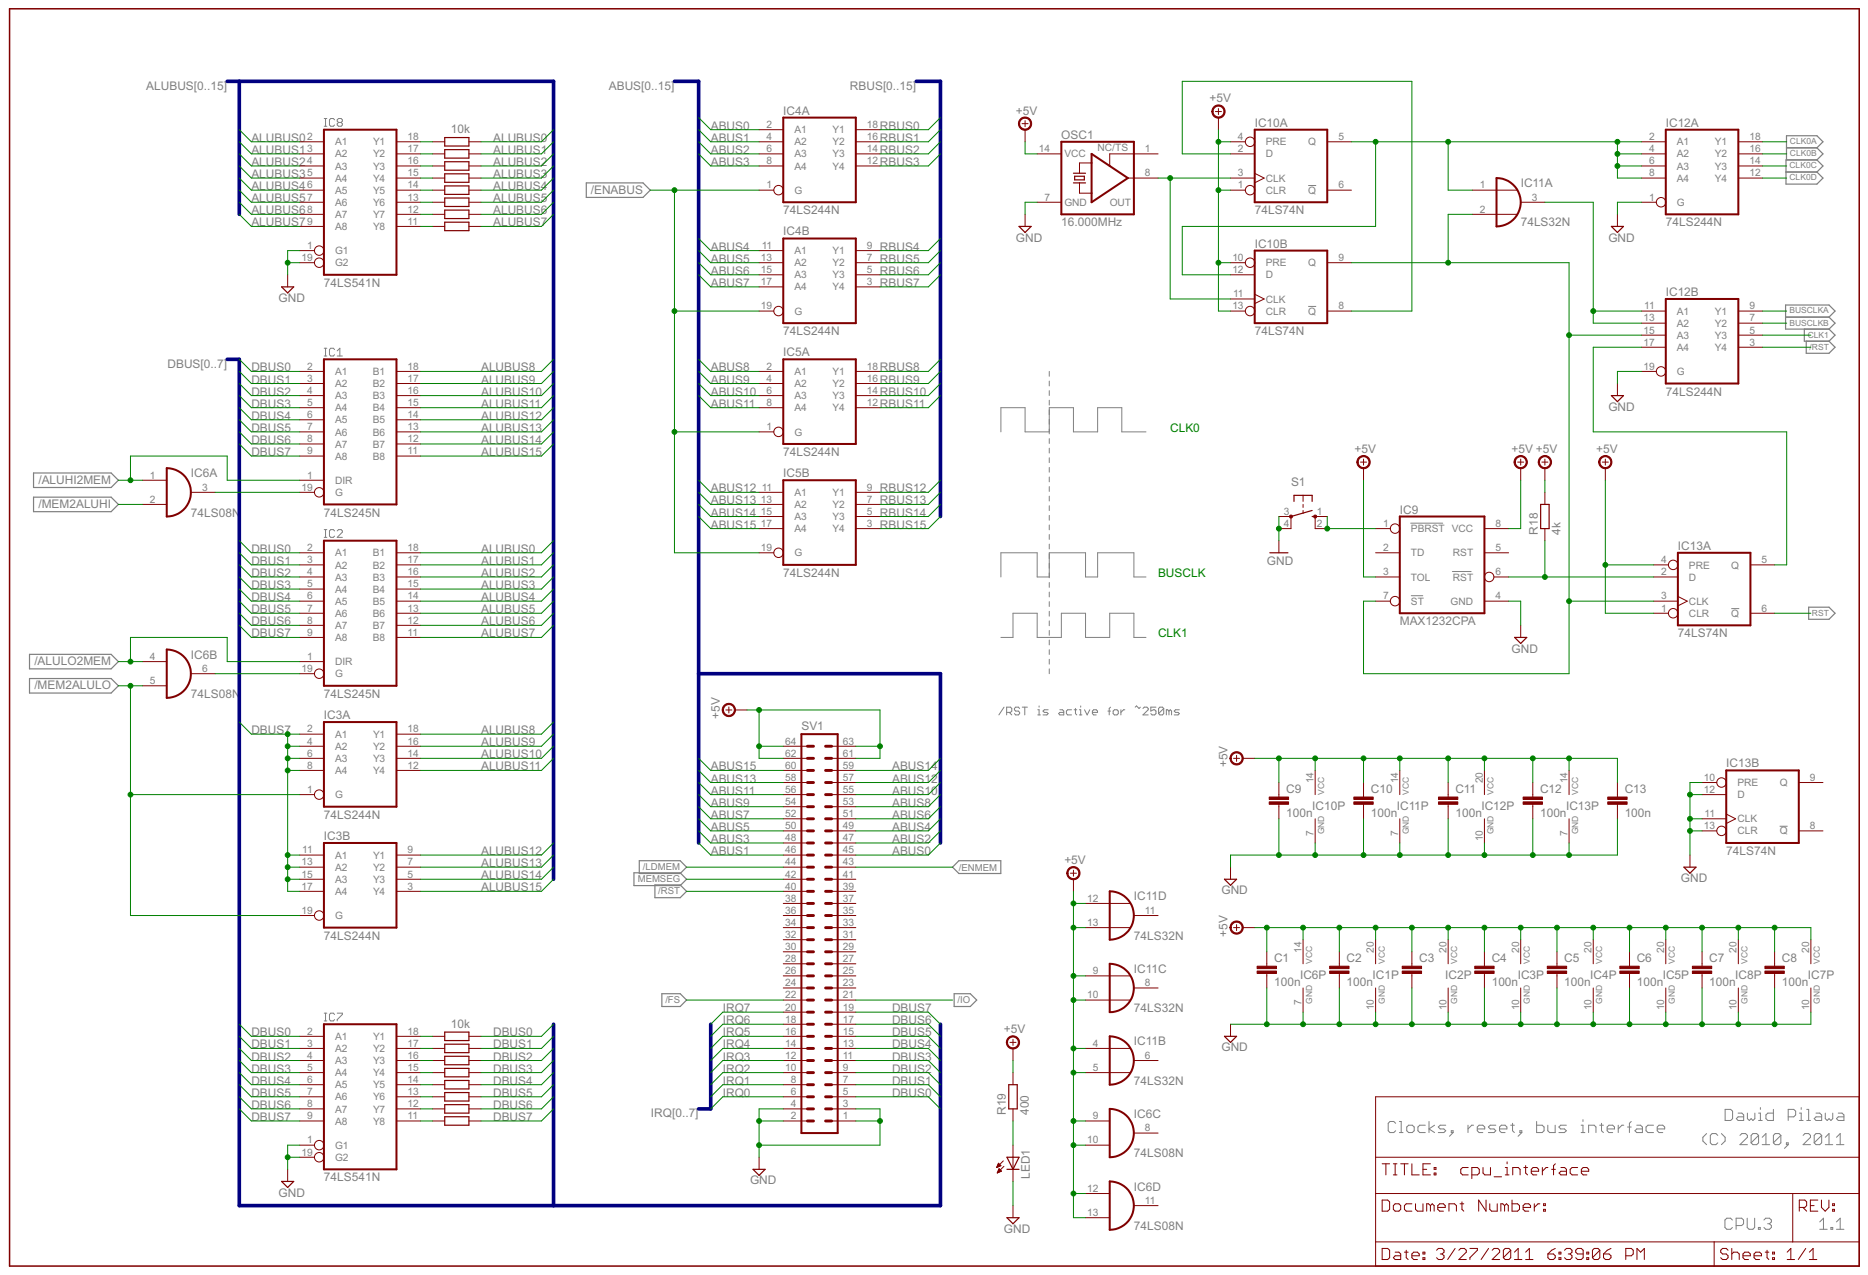
[picture p66: page 3]






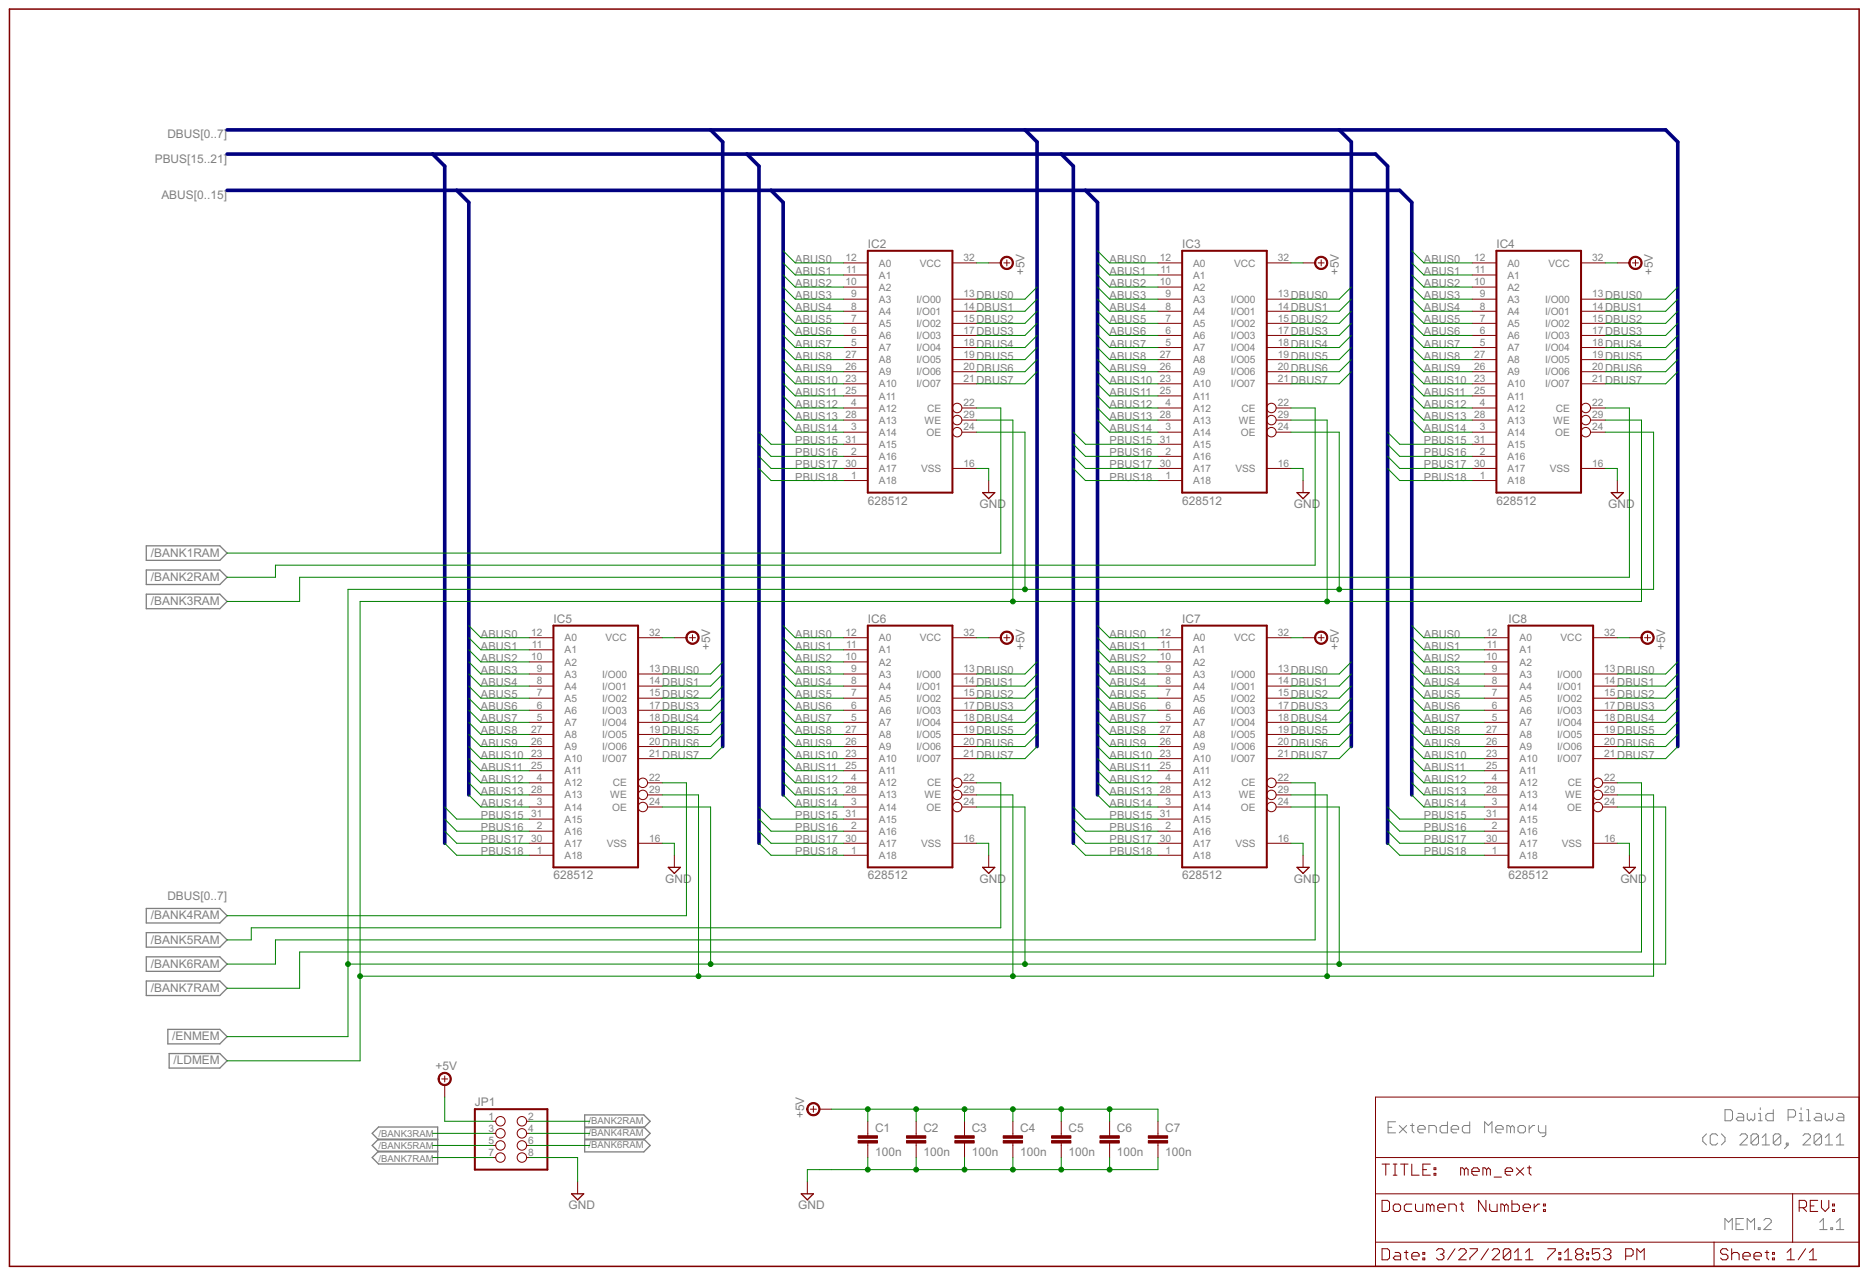
[picture p67: page 9]
