dpilawa/bytec/schematics/schematics_20110528.pdf

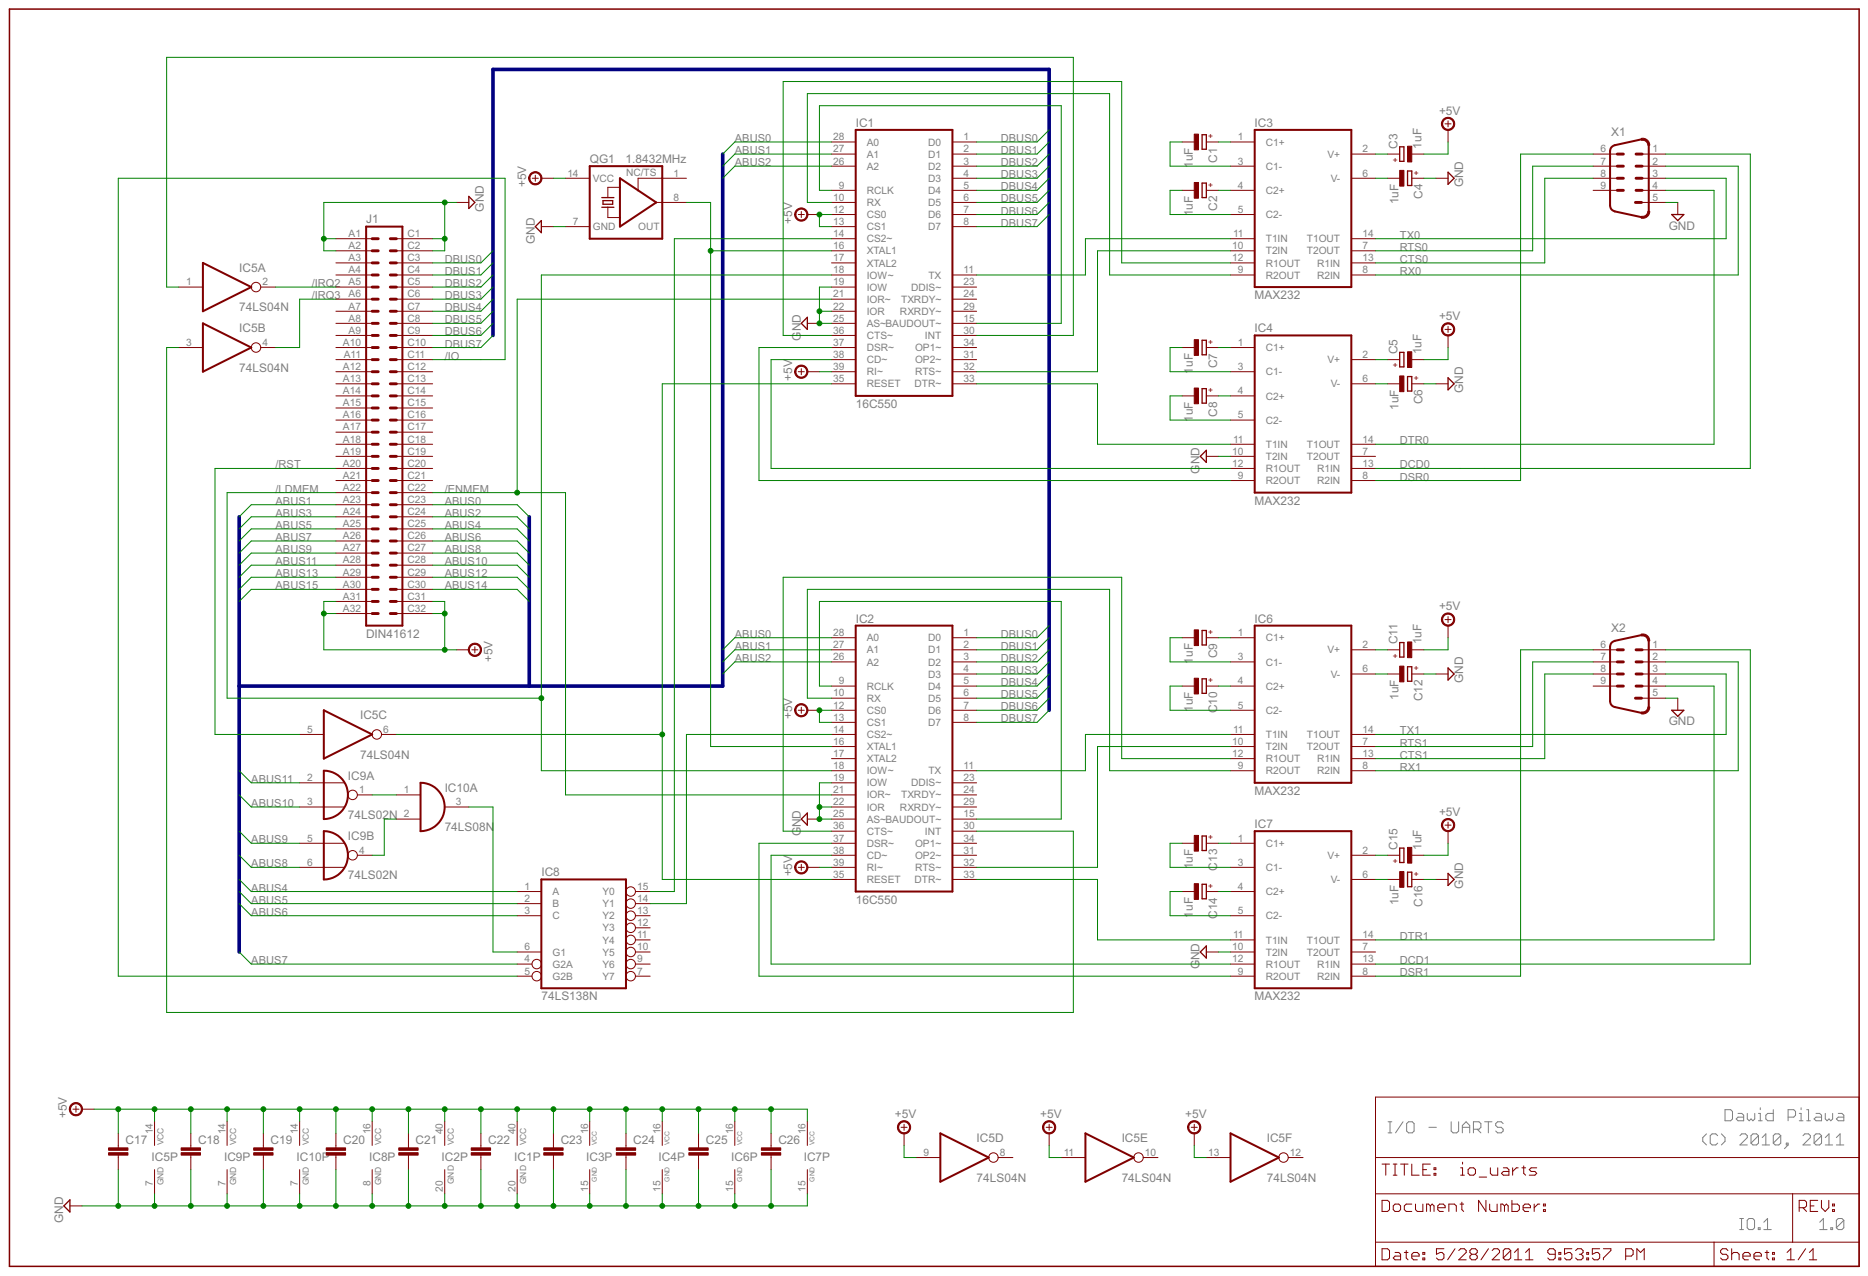
[picture p68: page 10]
