dpilawa/bytec/schematics/schematics_20111101.pdf

4 G3




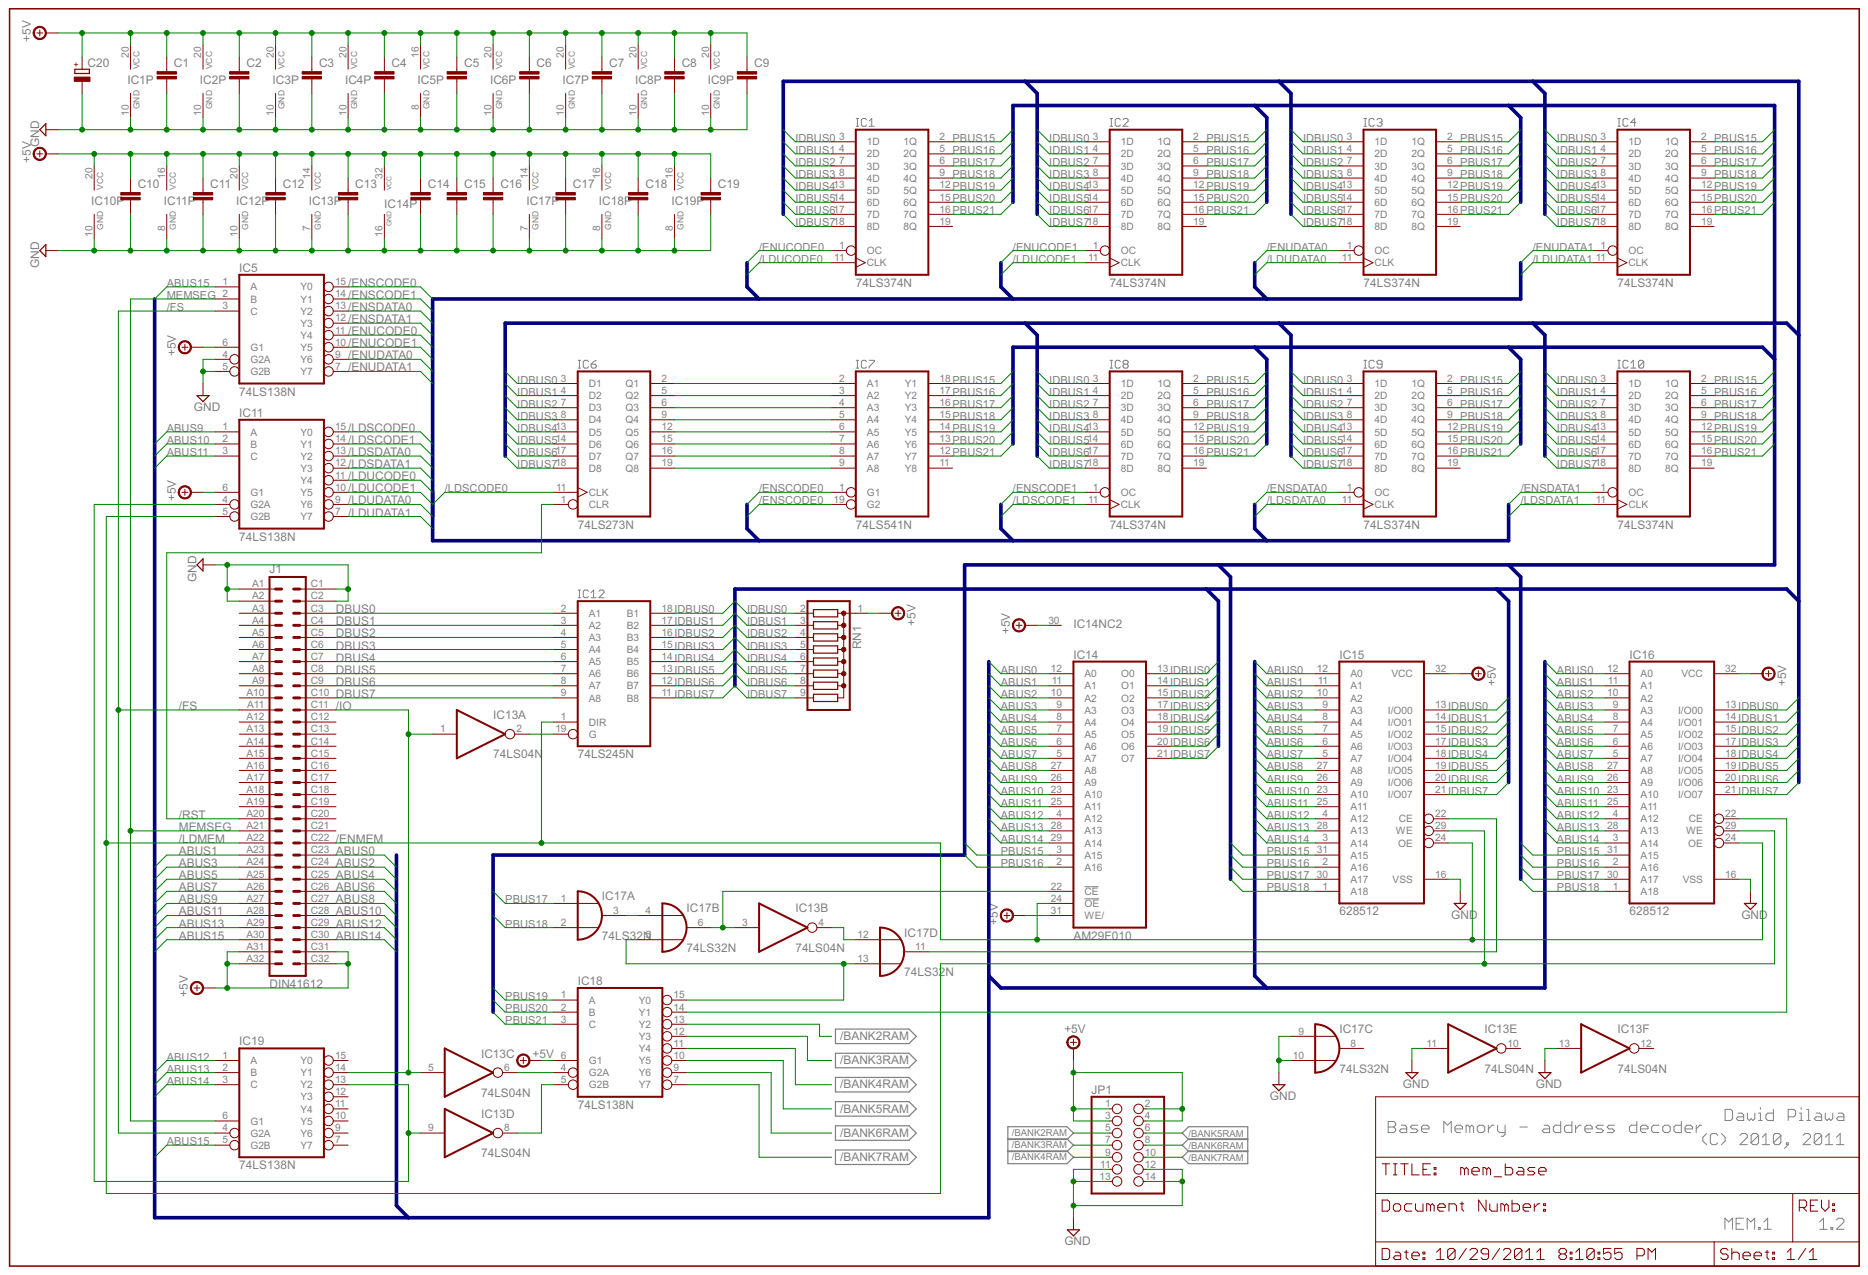
[picture p69: page 7]

17 B1 IDBUS1 | IDBUS1 3
16 B2 IDBUS2 | 4 IDBUS2
15 B3 IDBUS3 | IDBUS3 5
14 B4 IDBUS4 | IDBUS4 6

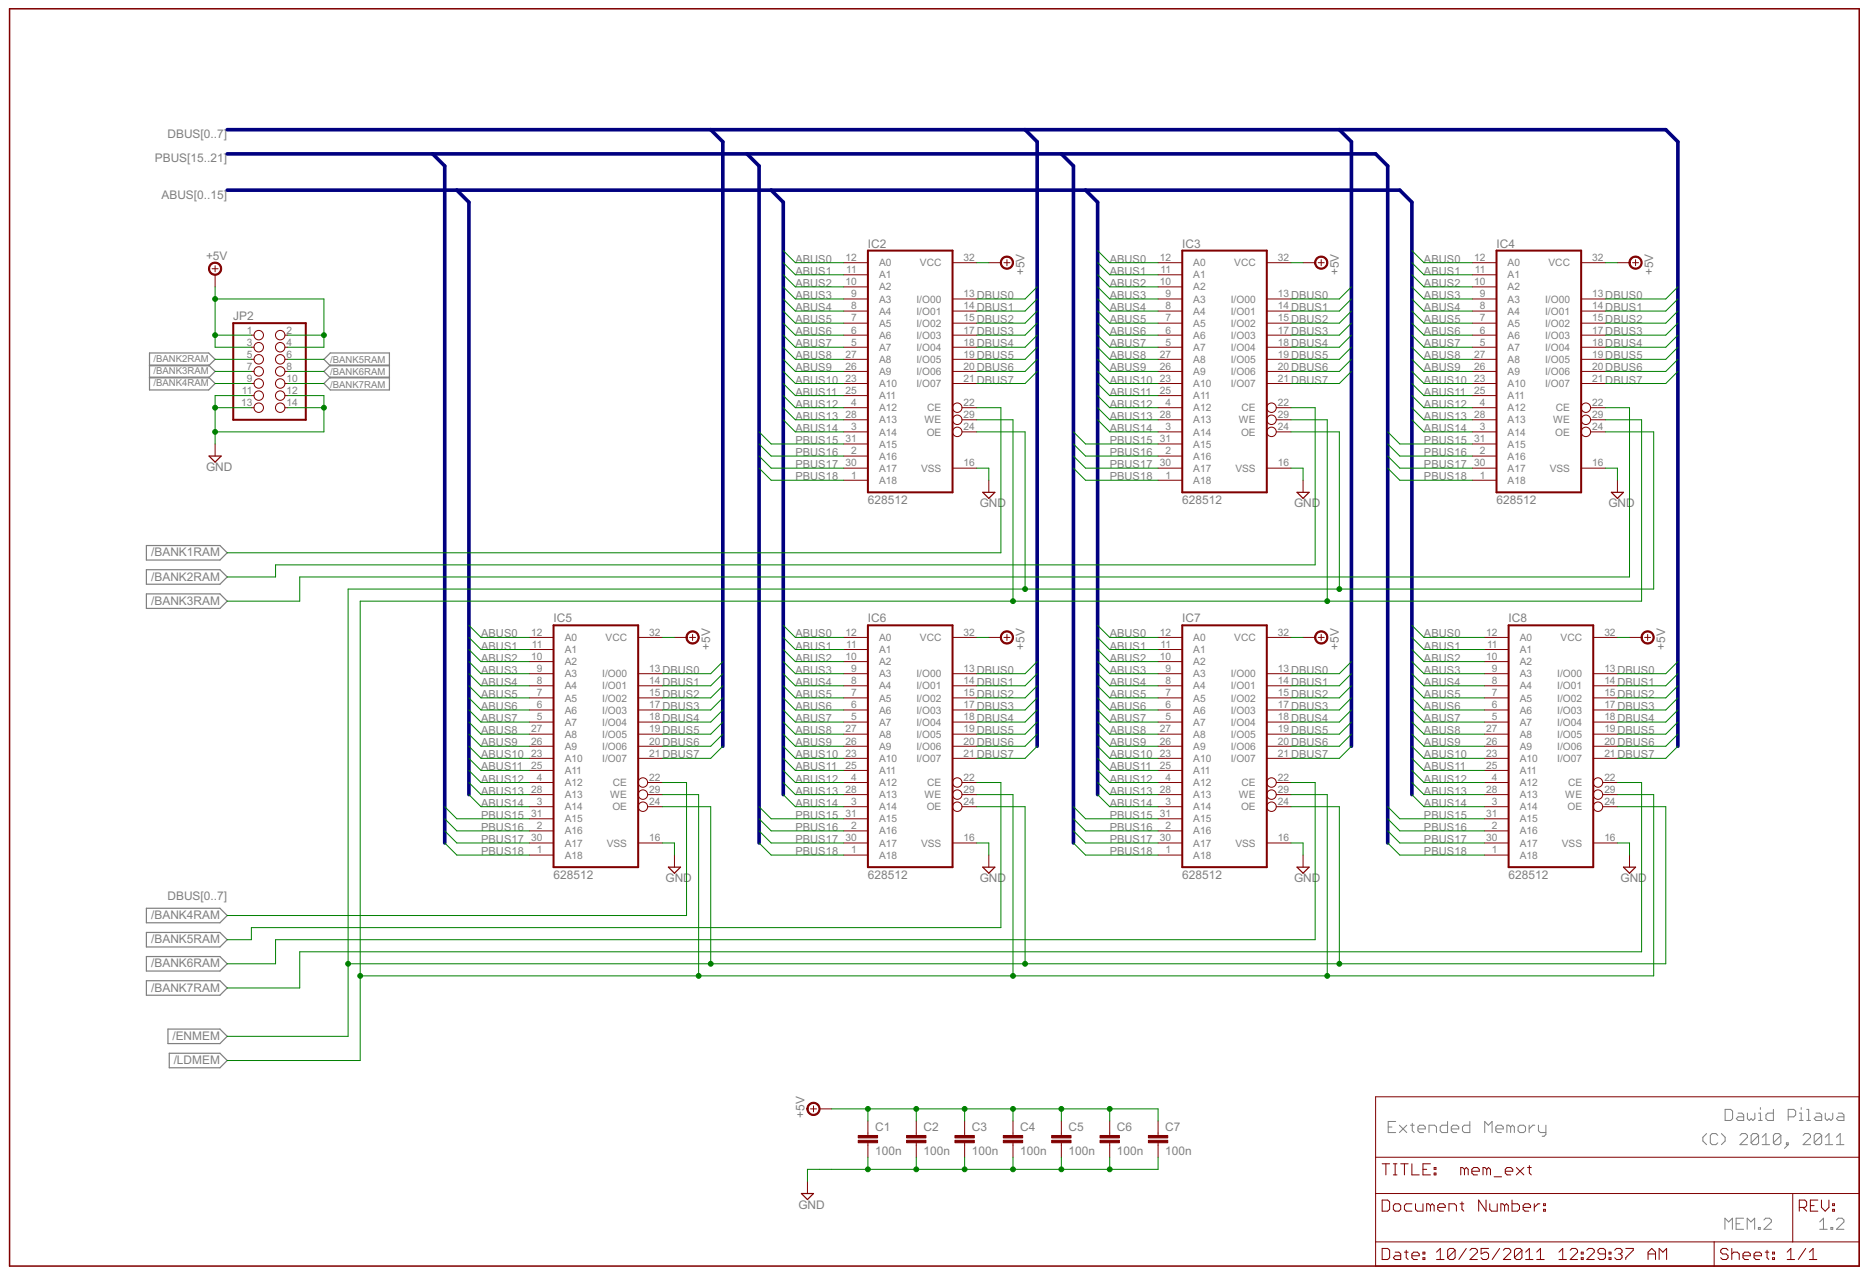
[picture p70: page 8]

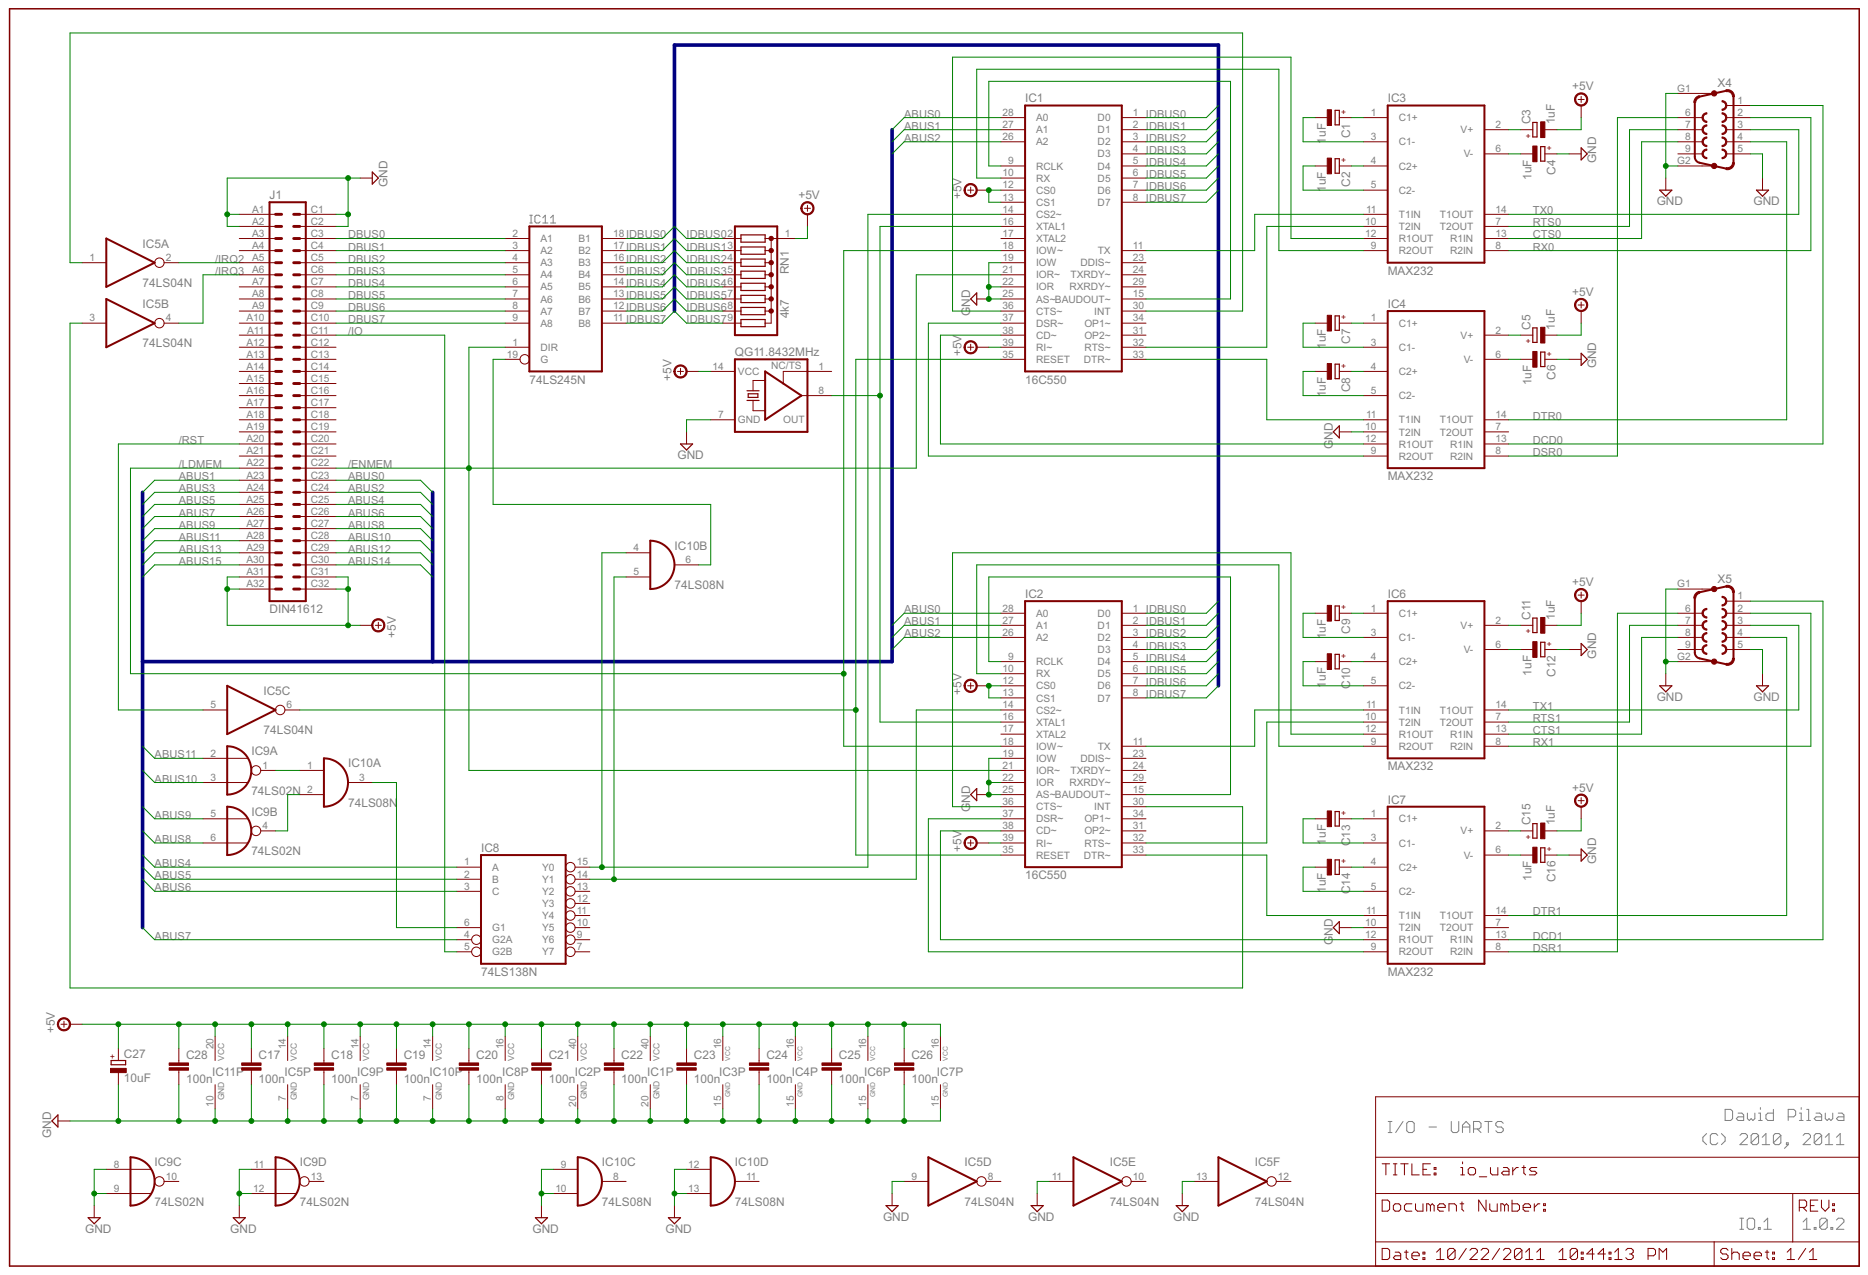
[picture p71: page 9]
