dpilawa/bytec/schematics/schematics_20120108.pdf

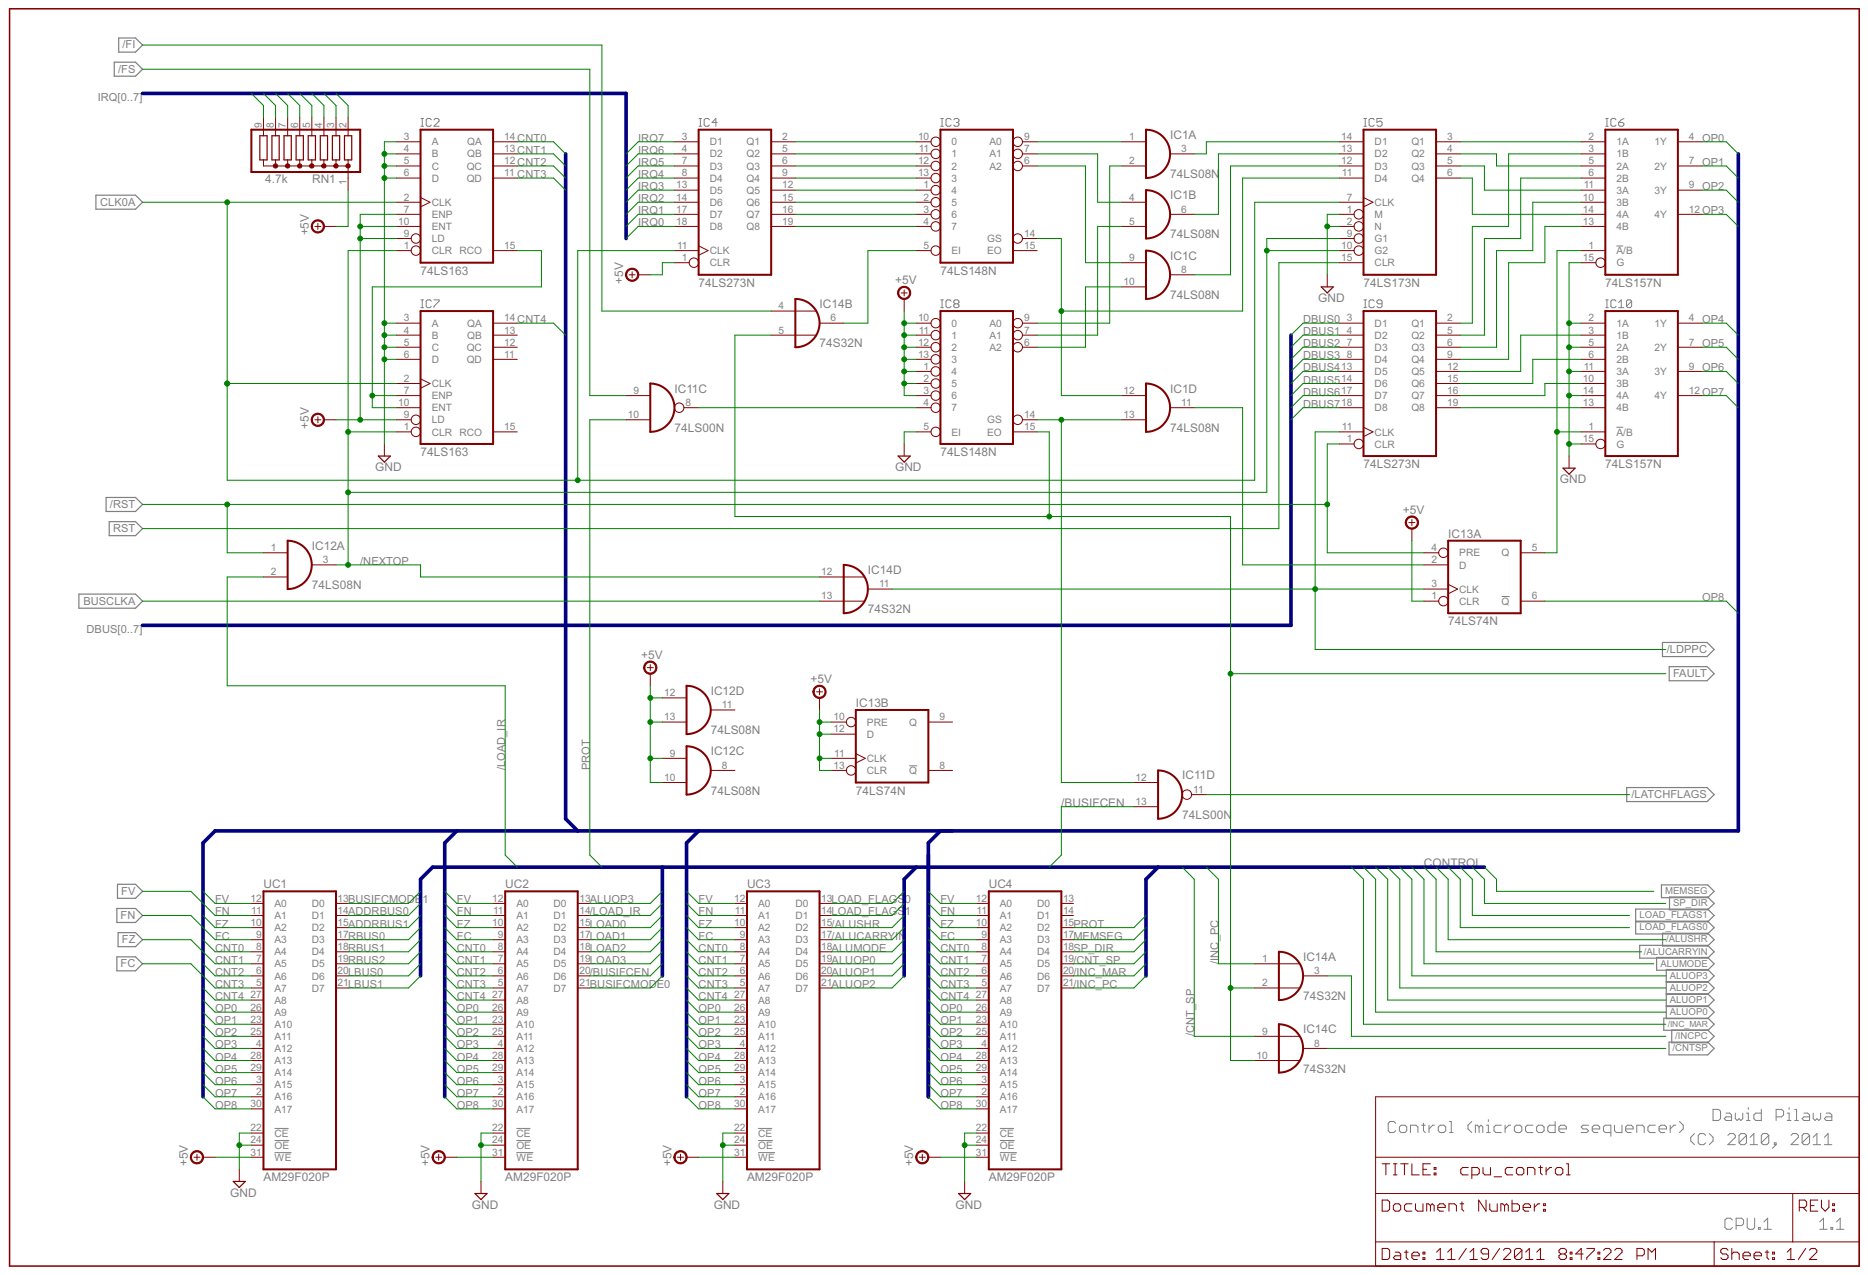
[picture p72: page 1]

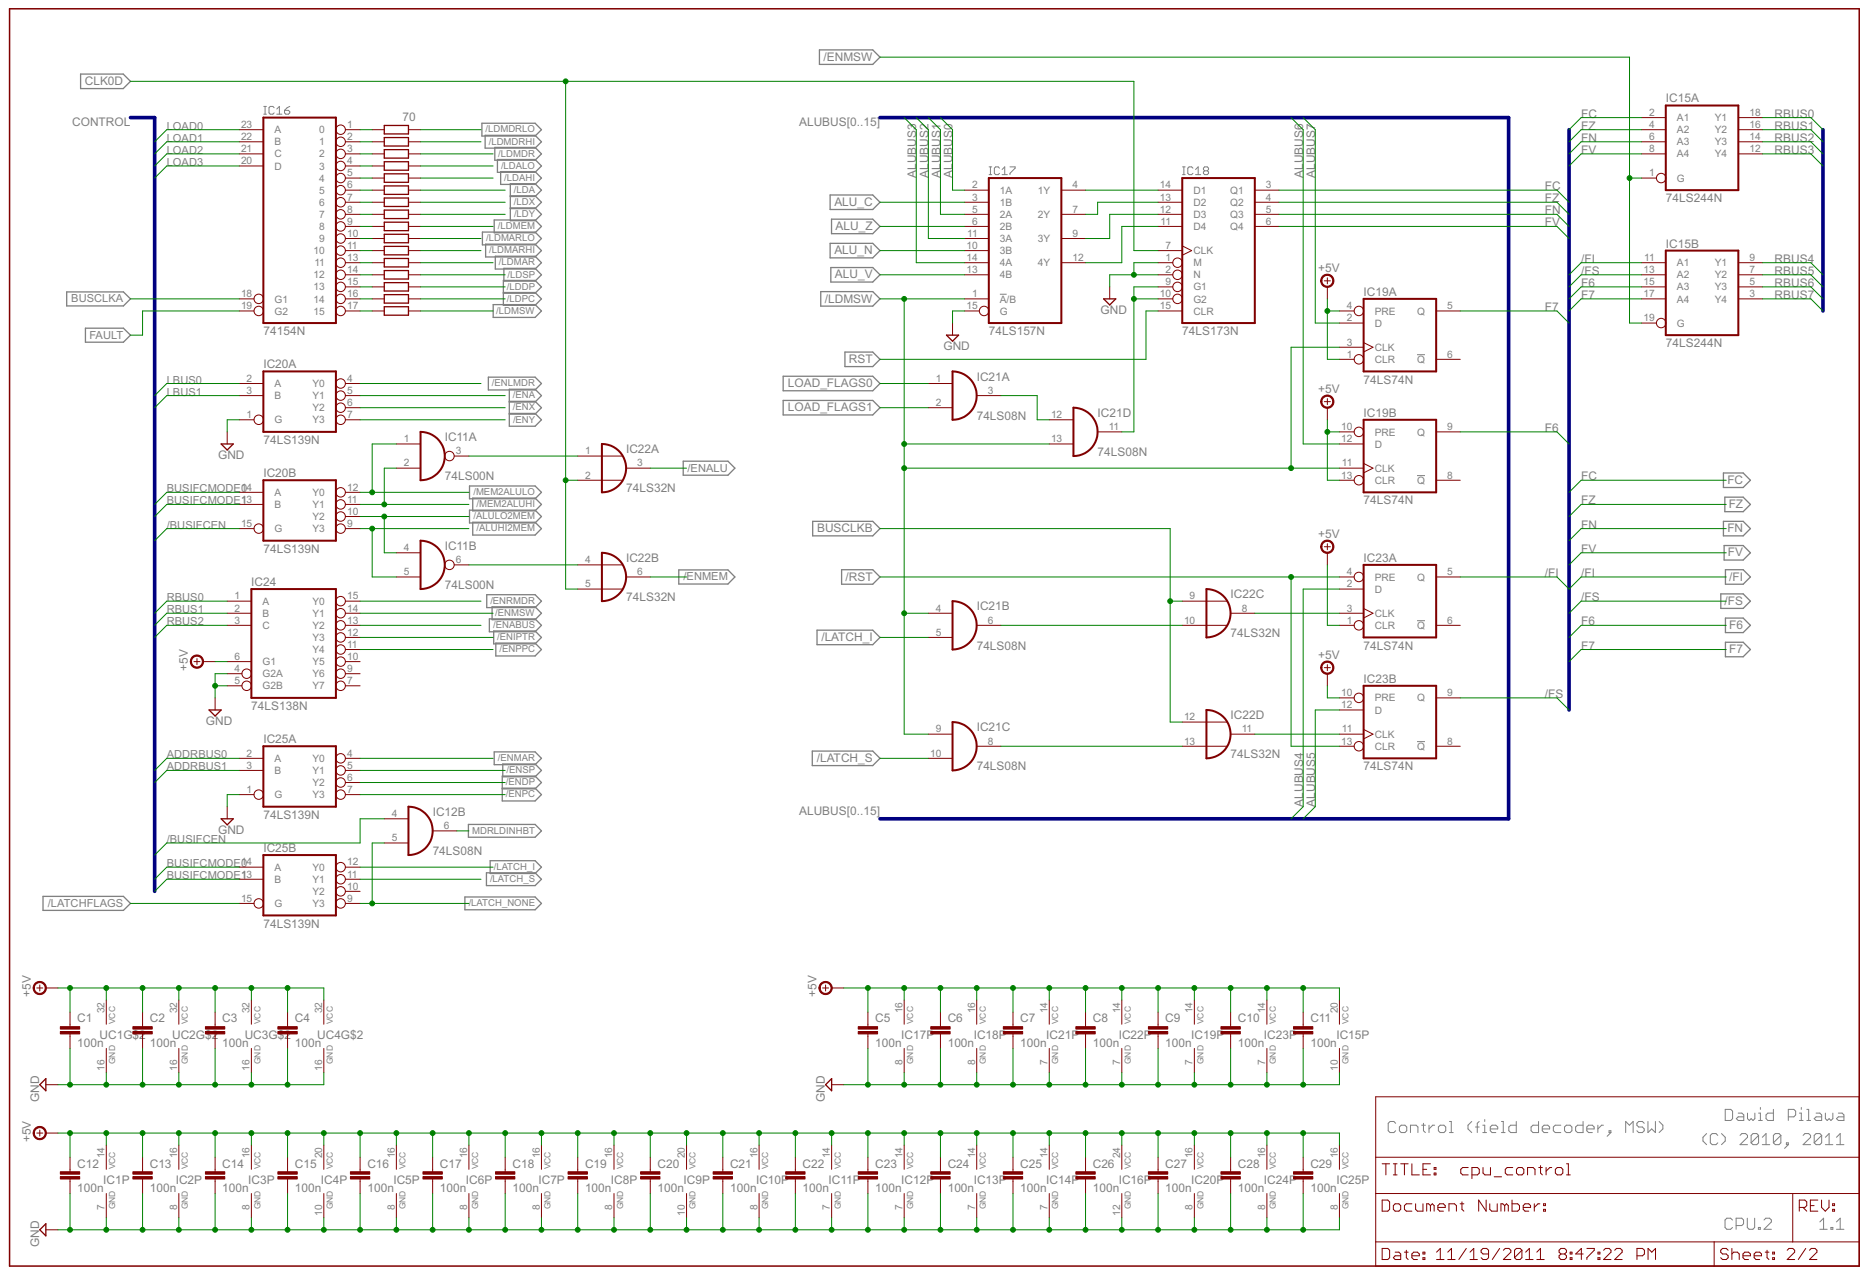
[picture p73: page 2]

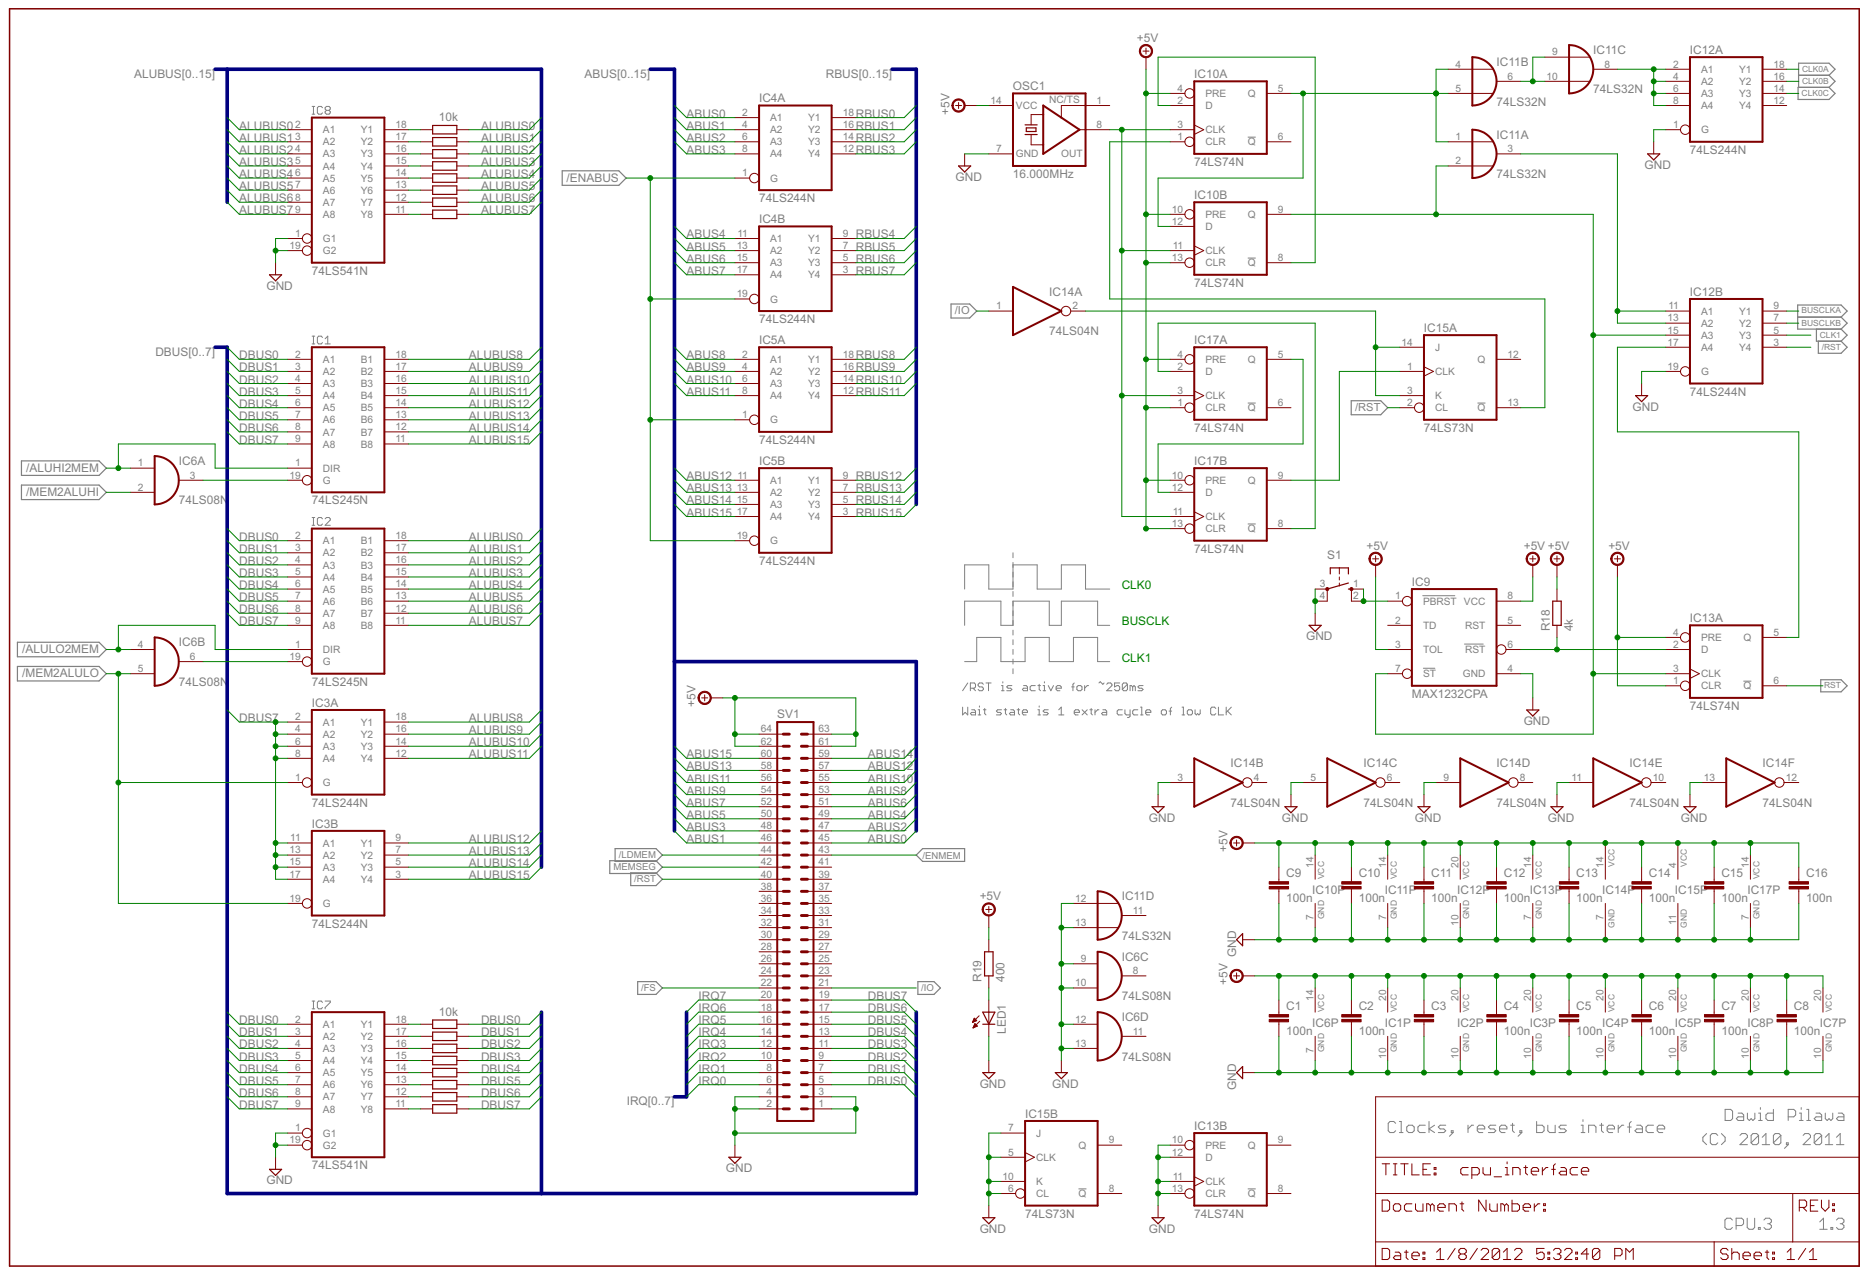
[picture p74: page 3]

4 G3




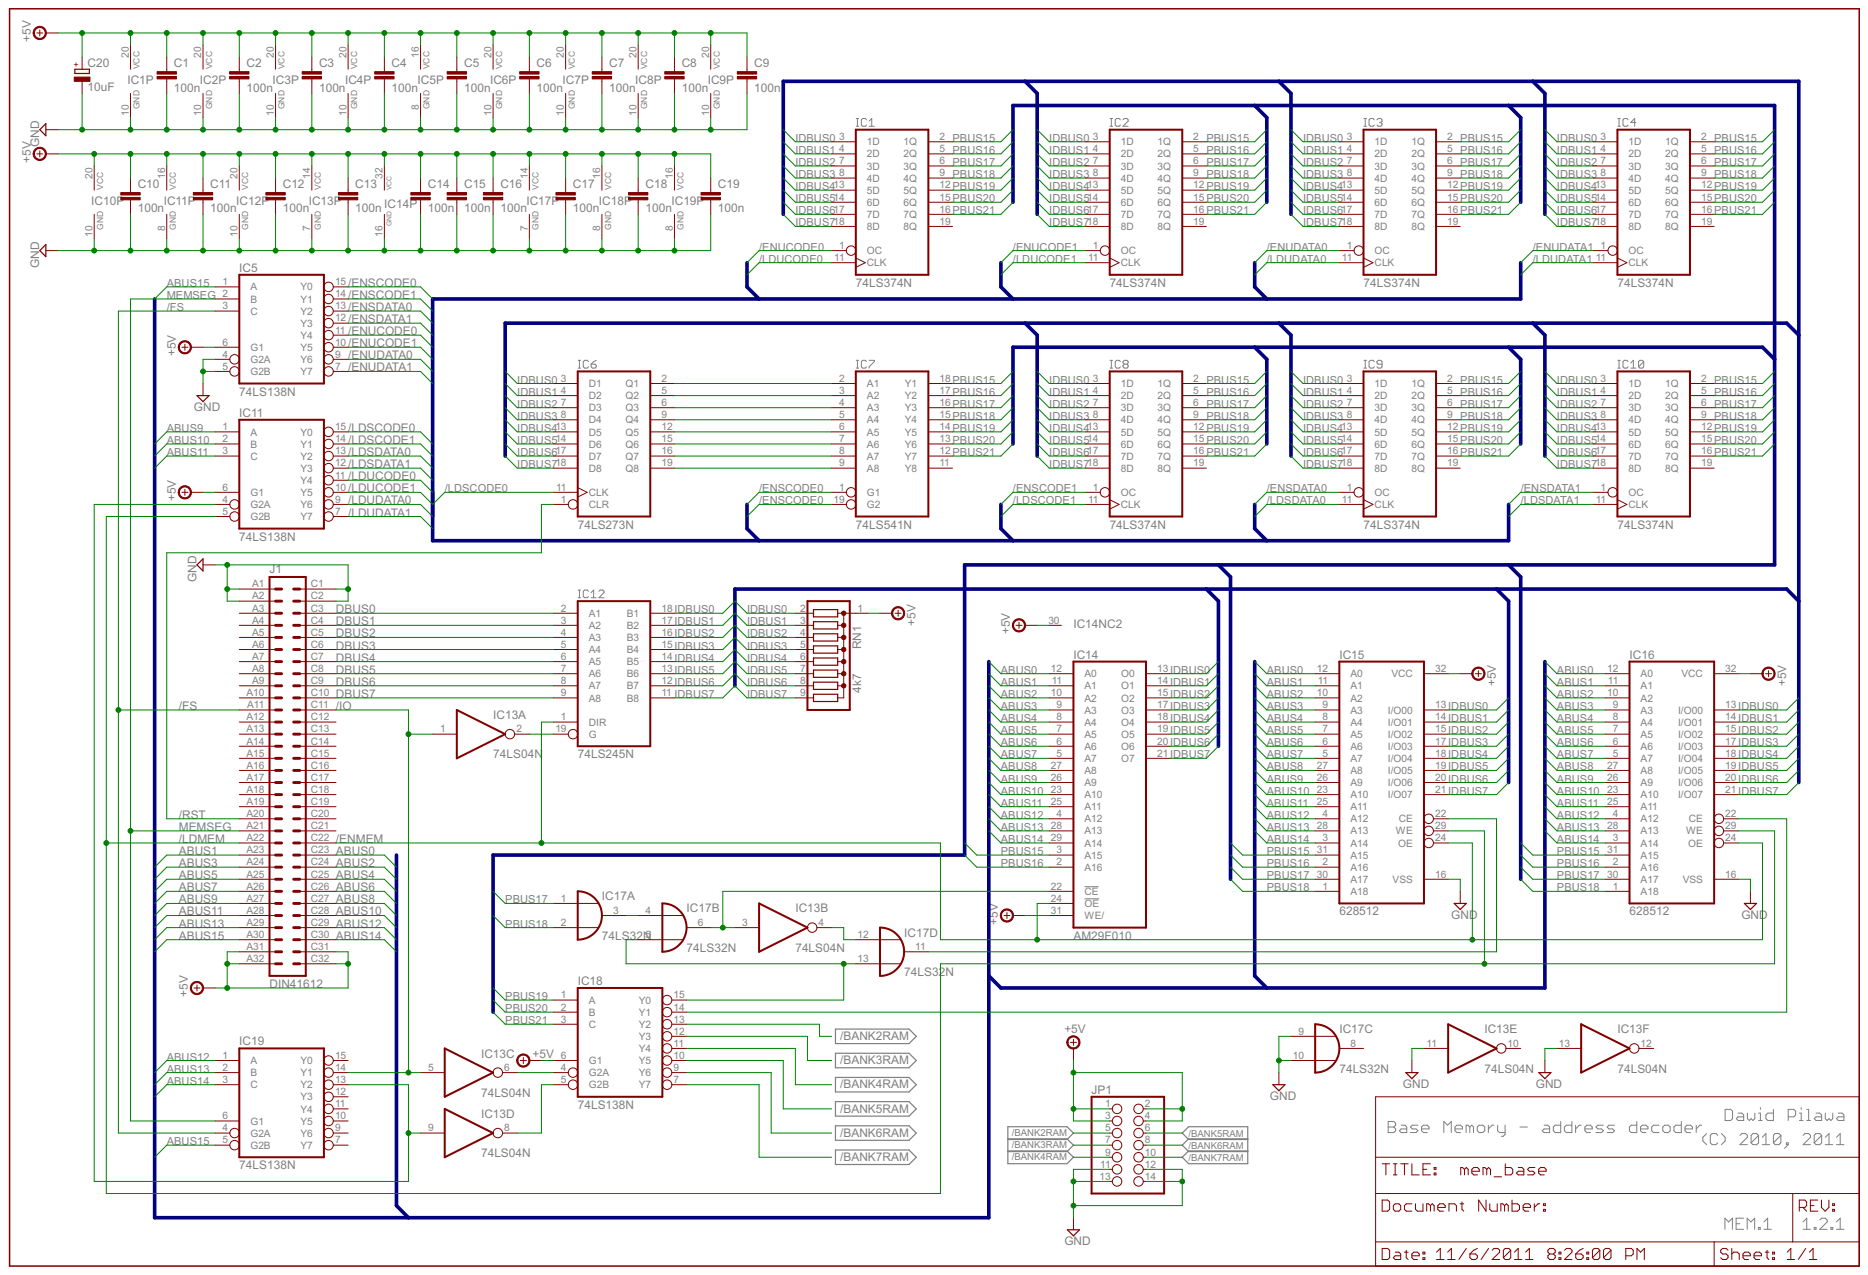
[picture p75: page 7]

17 B1 IDBUS1 | IDBUS1 3
16 B2 IDBUS2 | 4 IDBUS2
15 B3 IDBUS3 | IDBUS3 5
14 B4 IDBUS4 | IDBUS4 6

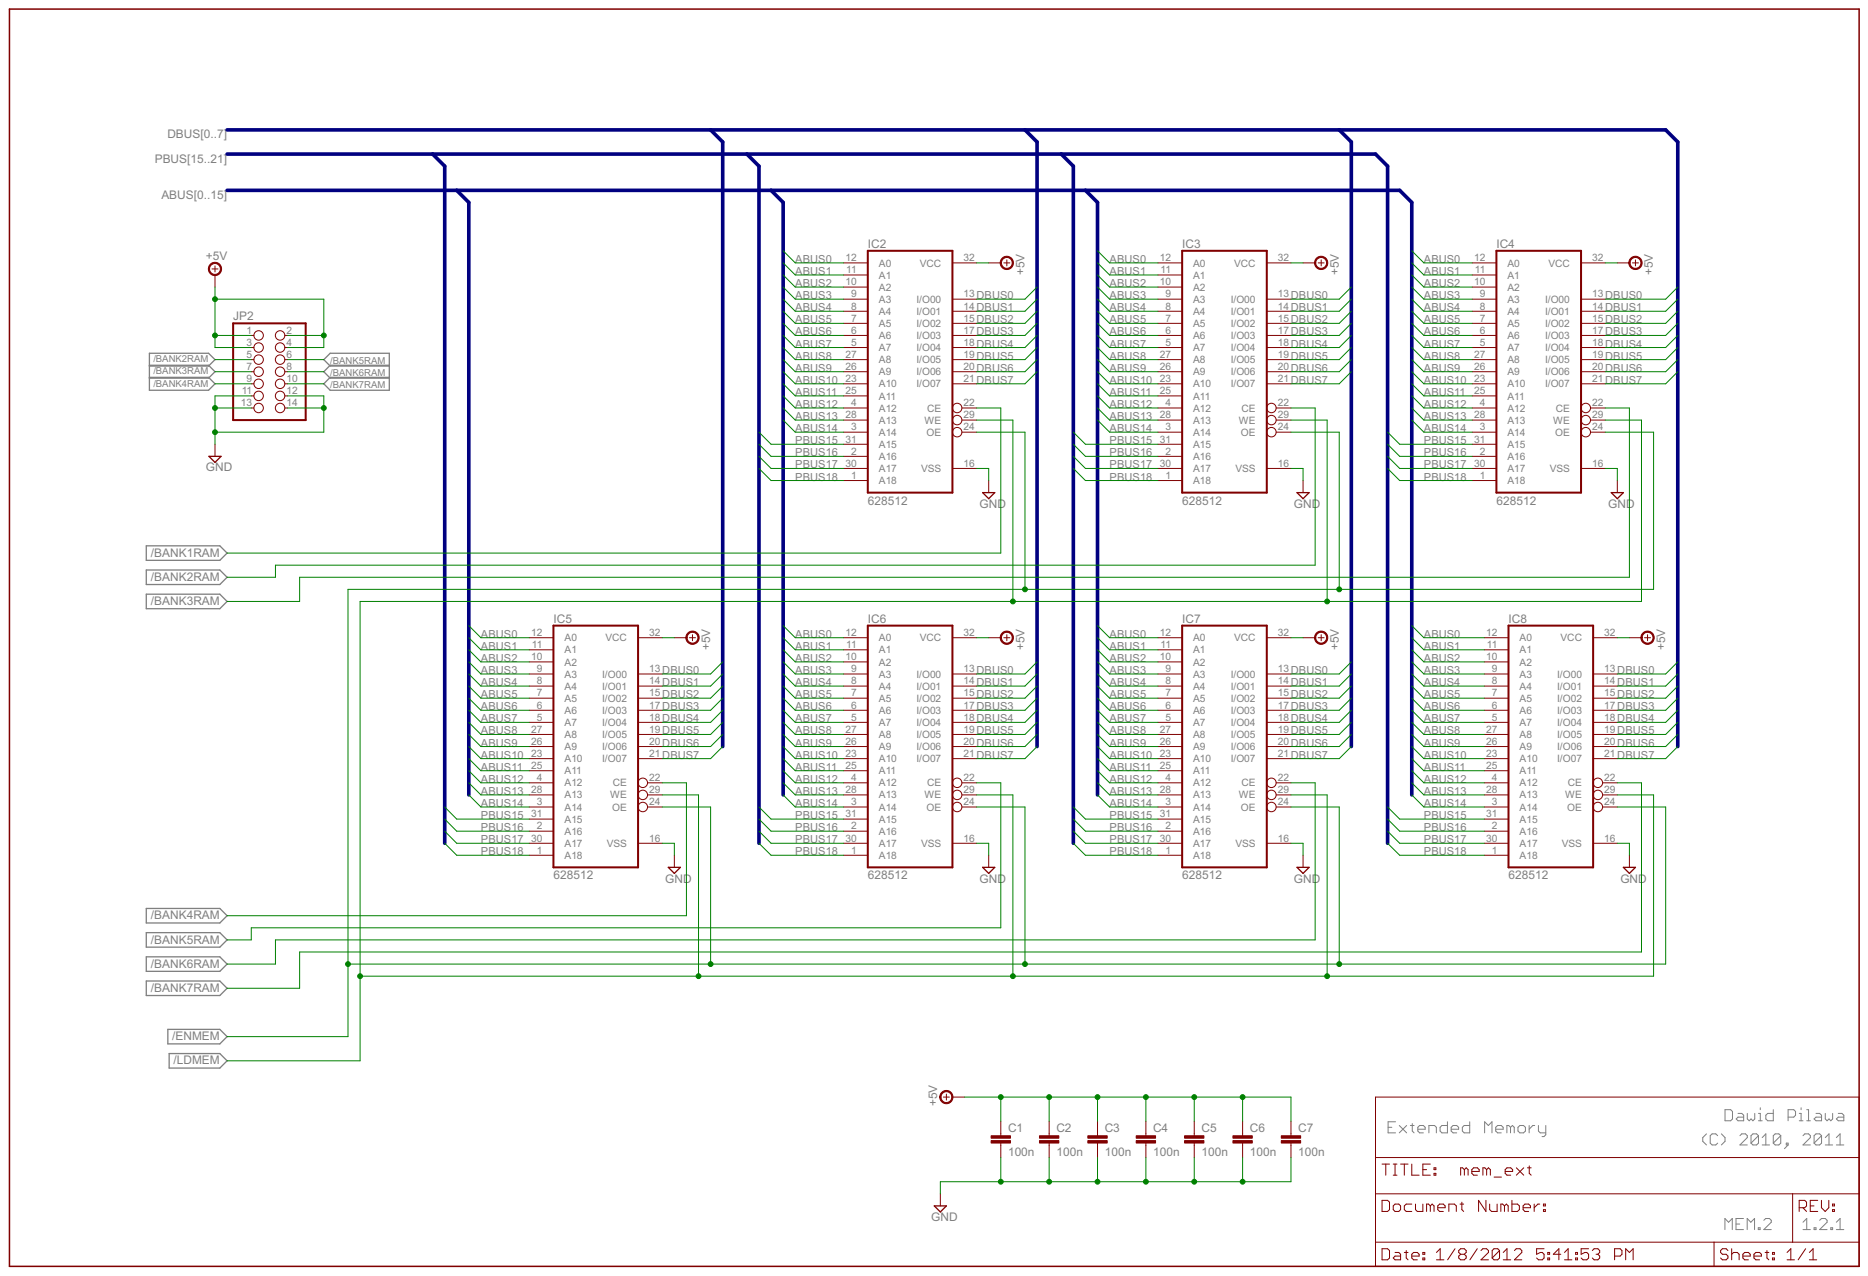
[picture p76: page 8]
