dpilawa/bytec/schematics/schematics_20120505.pdf

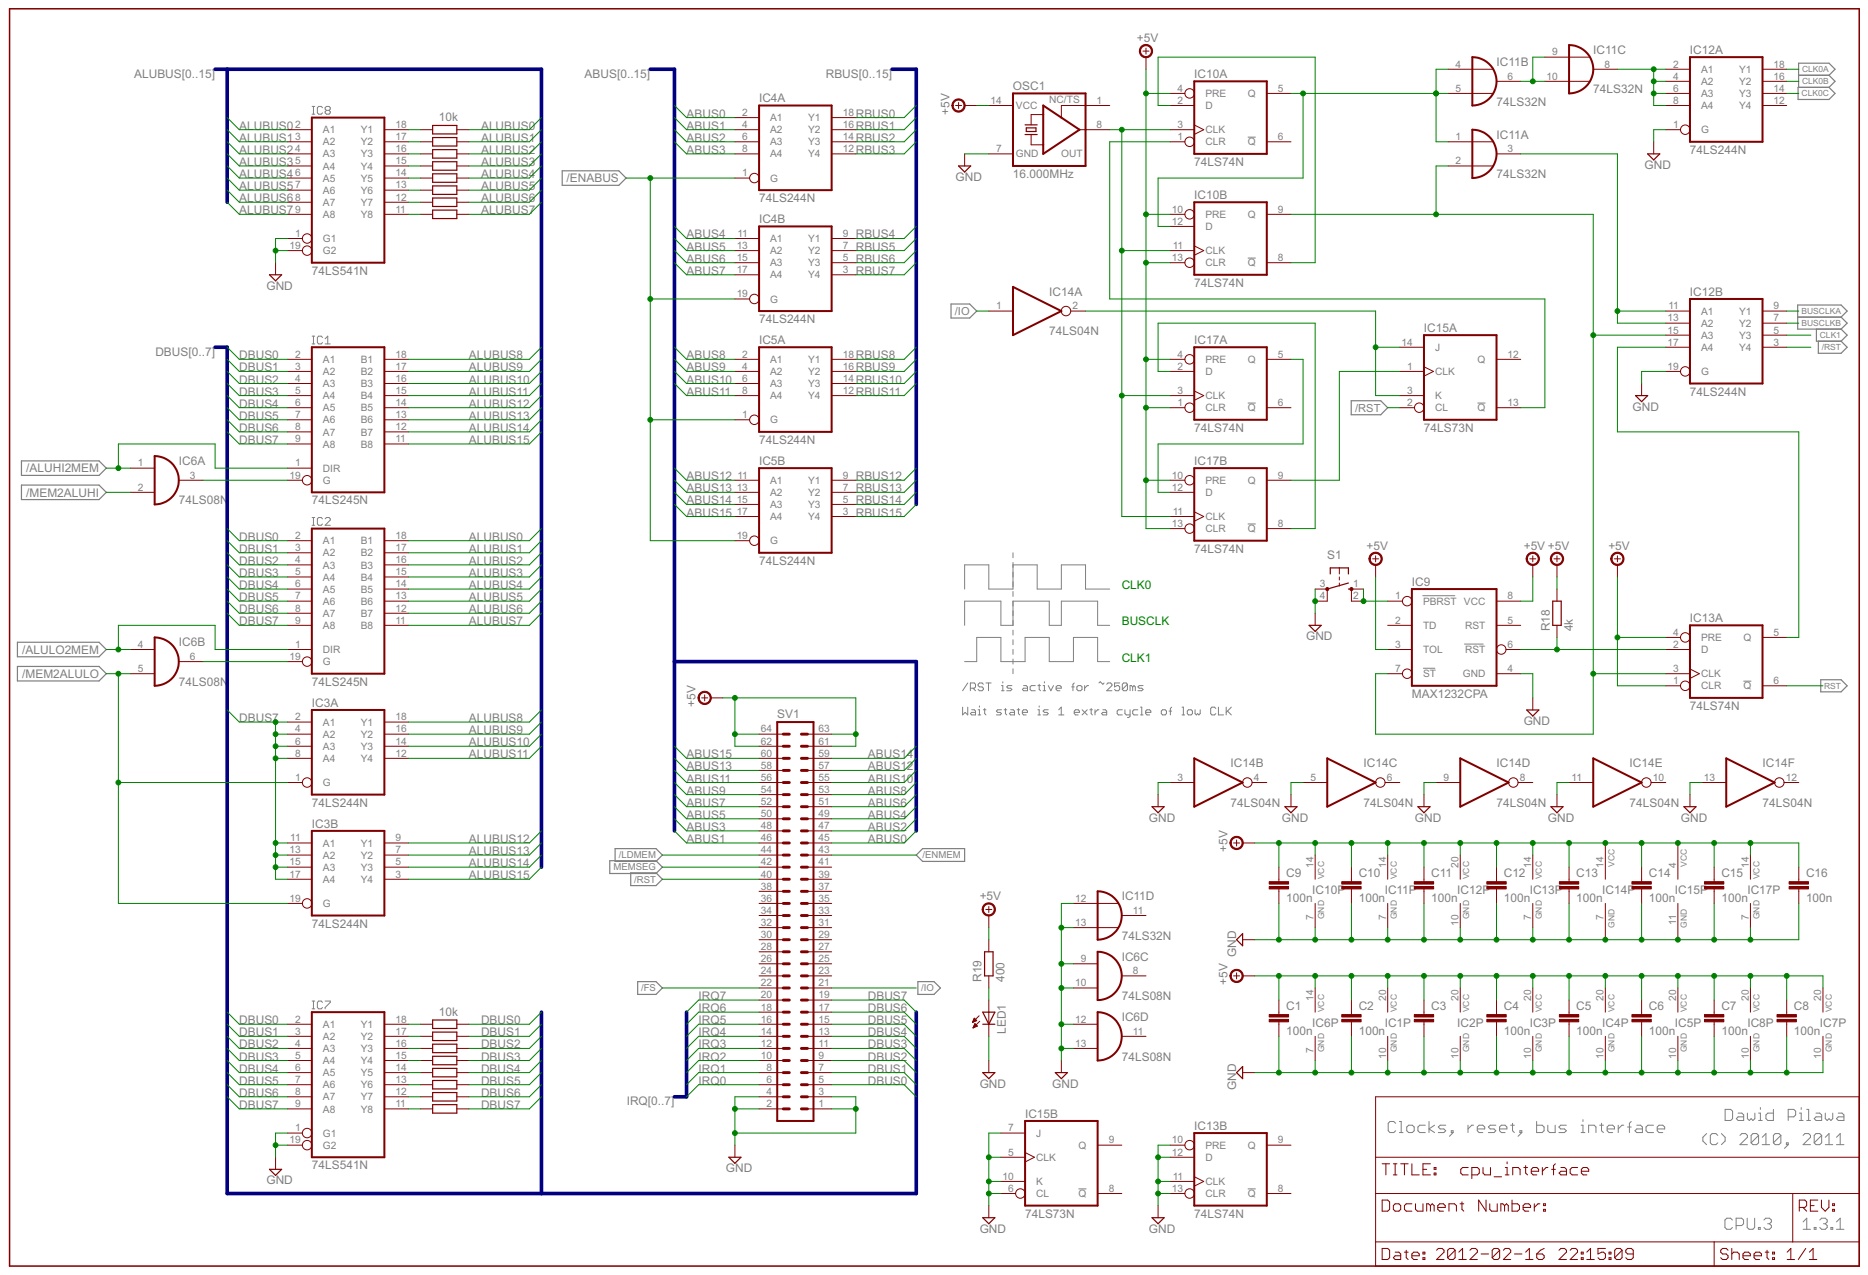
[picture p87: page 3]

4 G3




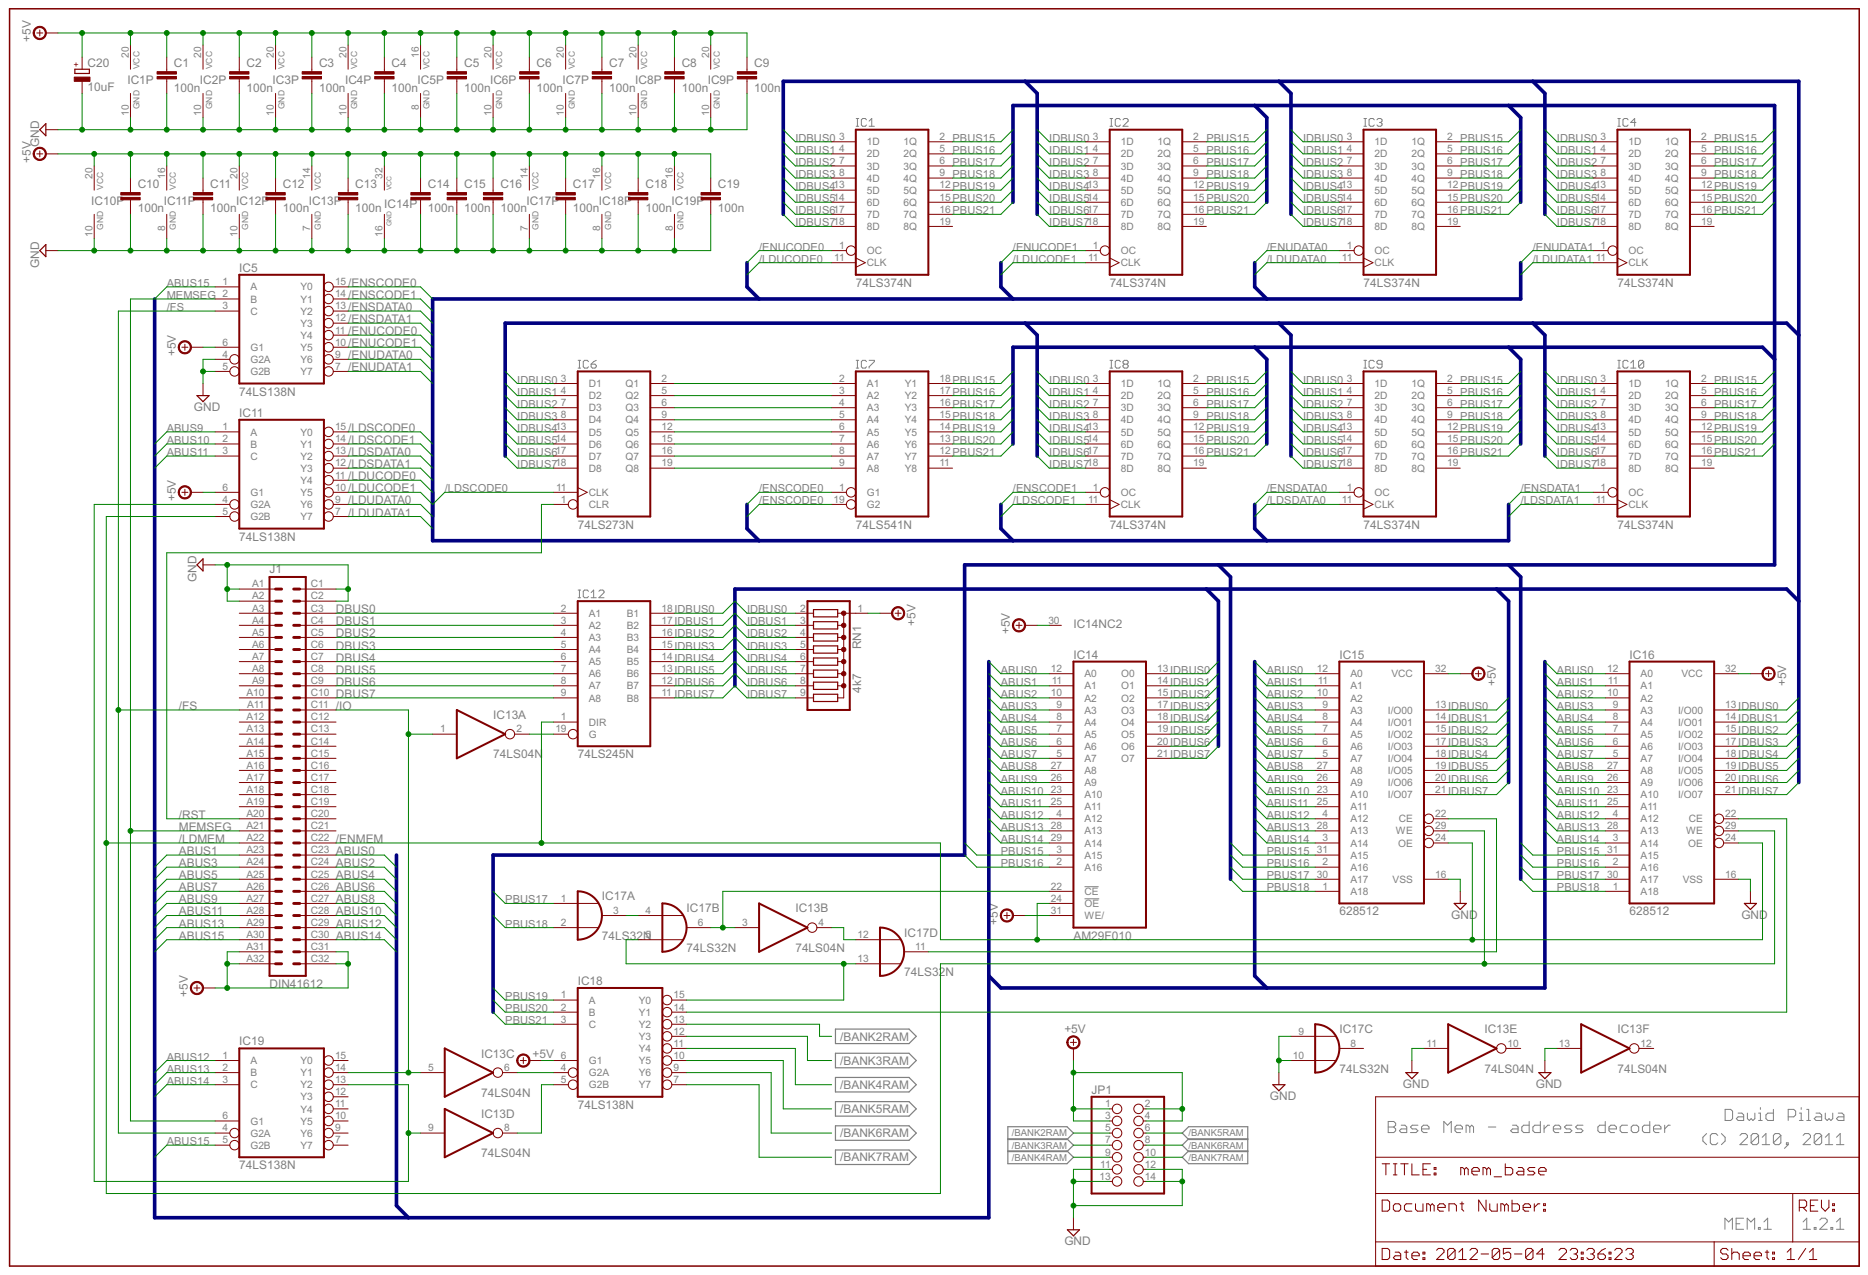
[picture p88: page 7]

17 B1 IDBUS1 | IDBUS1 3
16 B2 IDBUS2 | 4 IDBUS2
15 B3 IDBUS3 | IDBUS3 5
14 B4 IDBUS4 | IDBUS4 6


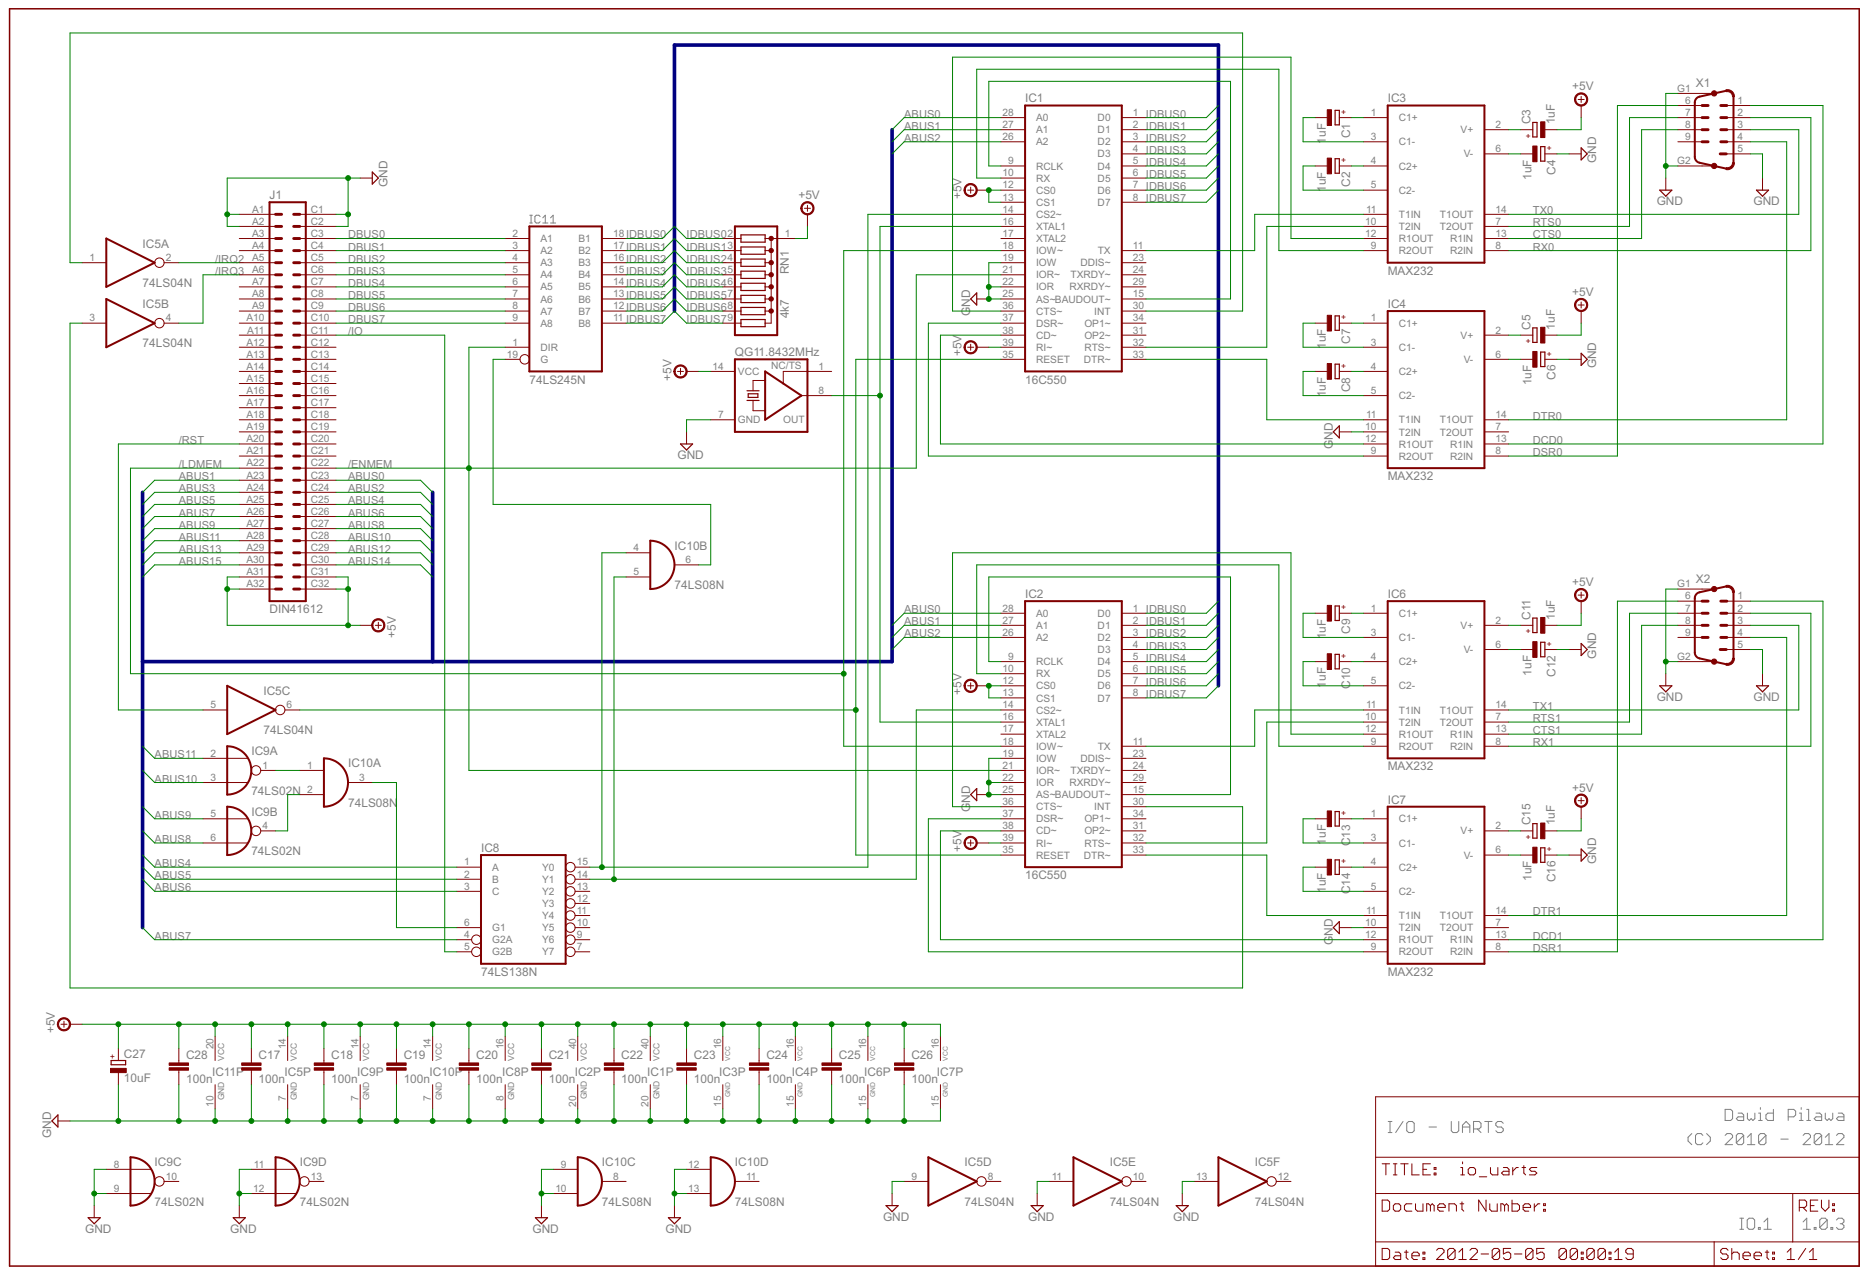
[picture p89: page 9]

C1C2C3C4C5C6C7C8C9C10 C11 C12 C13 C14 C15 C16 C17 C18 C19 C20 C21 C22 C23 C24 C25 C26 C27 C28 C29 C30 C31 C32

J1 A1A2A3A4A5A6A7A8A9 A10 A11 A12 A13 A14 A15 A16 A17 A18 A19 A20 A21 A22 A23 A24 A25 A26 A27 A28 A29 A30 A31 A32


16 B2 IDE5 | IDE5 4
15 B3 IDE4 | IDE4 5

13 B5 IDE2 | IDE2 7
12 B6 IDE1 | IDE1 8
