dpilawa/bytec/eagle/0_cpu_interface.brd

## EAGLE design eagle/0_cpu_interface.brd (2016-04-14)

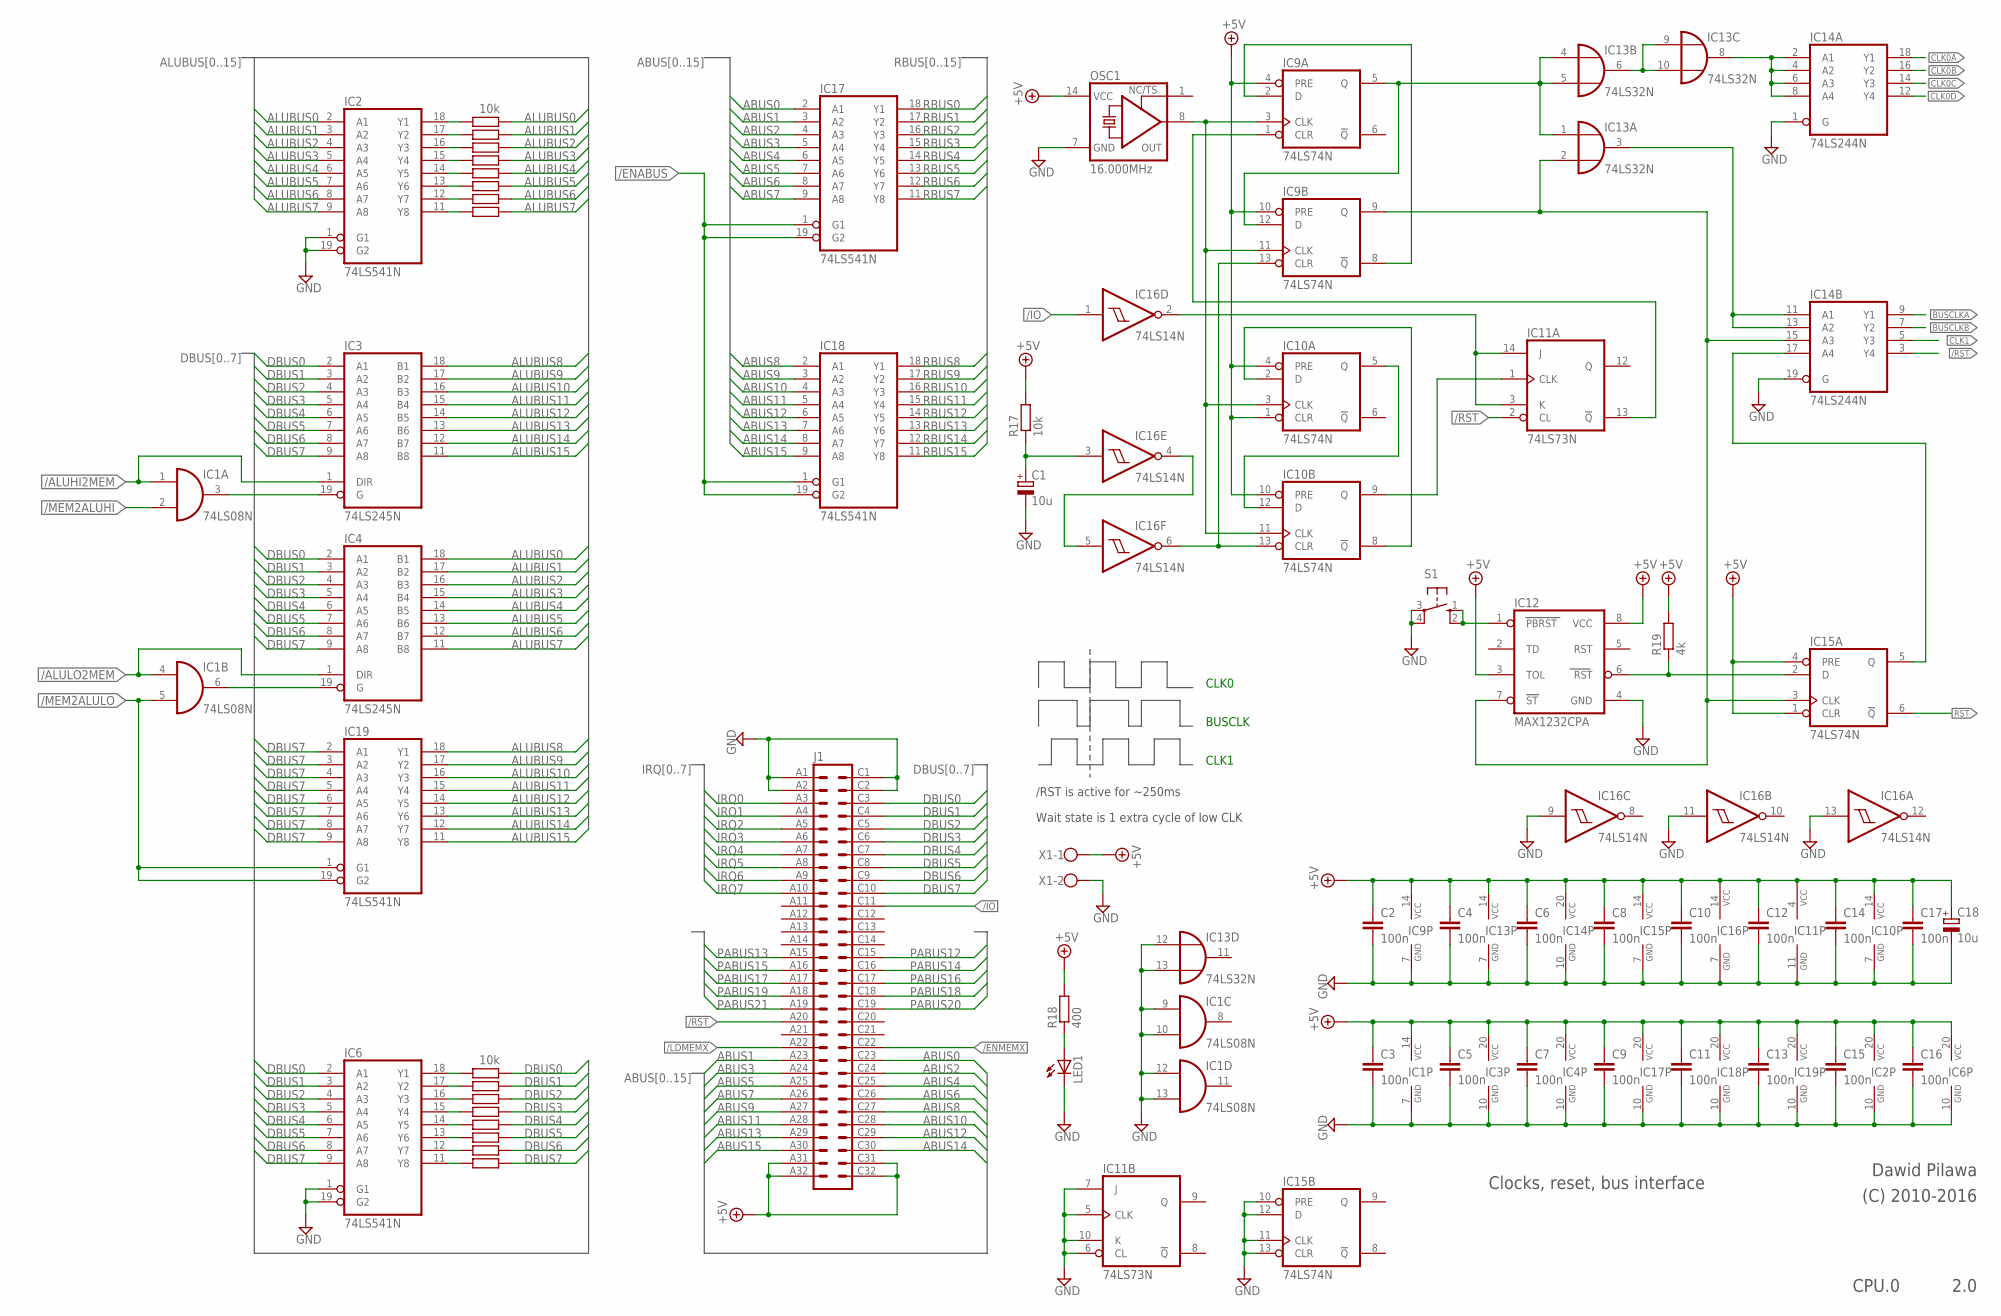
[picture p90: schematic 0_cpu_interface.sch, sheet 1]

Parts:
C1: 10u; E2,5-5
C2, C3, C4, C5, C6, C7, C8, C9, C10, C11, C12, C13, C14, C15, C16, C17: 100n; C050-024X044
C18: 10u; E2,5-6
IC1: 74LS08N; DIL14
IC2, IC6, IC17, IC18, IC19: 74LS541N; DIL20
IC3, IC4: 74LS245N; DIL20
IC9, IC10, IC15: 74LS74N; DIL14
IC11: 74LS73N; DIL14
IC12: MAX1232CPA; DIL08
IC13: 74LS32N; DIL14
IC14: 74LS244N; DIL20
IC16: 74LS14N; DIL14
J1: VG64B
LED1: LED5MM
OSC1: 16.000MHz; DIL14S
R1, R9, R17: 10k; 0204/7
R2, R3, R4, R5, R6, R7, R8, R10, R11, R12, R13, R14, R15, R16: R-EU_0204/7; 0204/7
R18: 400; 0204/7
R19: 4k; 0204/7
S1: 10-XX; B3F-10XX
X1: W237-102

Connections:
+5V: C2.1, C3.1, C4.1, C5.1, C6.1, C7.1, C8.1, C9.1, C10.1, C11.1, C12.1, C13.1, C14.1, C15.1, C16.1, C17.1, C18.+, IC1.14 (VCC), IC2.20 (VCC), IC3.20 (VCC), IC4.20 (VCC), IC6.20 (VCC), IC9.4 (PRE), IC9.10 (PRE), IC9.14 (VCC), IC10.1 (CLR), IC10.4 (PRE), IC10.10 (PRE), IC10.14 (VCC), IC11.4 (VCC), IC12.3 (TOL), IC12.8 (VCC), IC13.14 (VCC), IC14.20 (VCC), IC15.1 (CLR), IC15.4 (PRE), IC15.14 (VCC), IC16.14 (VCC), IC17.20 (VCC), IC18.20 (VCC), IC19.20 (VCC), J1.A31, J1.A32, J1.C31, J1.C32, OSC1.14 (VCC), R17.2, R18.2, R19.2, X1.1; also elsewhere on the board
/ALUHI2MEM: IC1.1 (I0), IC3.1 (DIR); also elsewhere on the board
/ALULO2MEM: IC1.4 (I0), IC4.1 (DIR); also elsewhere on the board
/ENABUS: IC17.1 (G1), IC17.19 (G2), IC18.1 (G1), IC18.19 (G2); also elsewhere on the board
/ENMEMX: J1.C22; also elsewhere on the board
/IO: IC16.1 (I), J1.C11; also elsewhere on the board
/LDMEMX: J1.A22; also elsewhere on the board
/MEM2ALUHI: IC1.2 (I1); also elsewhere on the board
/MEM2ALULO: IC1.5 (I1), IC19.1 (G1), IC19.19 (G2); also elsewhere on the board
/RST: IC11.2 (CL), IC14.3 (Y4), J1.A20; also elsewhere on the board
ABUS0: IC17.2 (A1), J1.C23; also elsewhere on the board
ABUS1: IC17.3 (A2), J1.A23; also elsewhere on the board
ABUS2: IC17.4 (A3), J1.C24; also elsewhere on the board
ABUS3: IC17.5 (A4), J1.A24; also elsewhere on the board
ABUS4: IC17.6 (A5), J1.C25; also elsewhere on the board
ABUS5: IC17.7 (A6), J1.A25; also elsewhere on the board
ABUS6: IC17.8 (A7), J1.C26; also elsewhere on the board
ABUS7: IC17.9 (A8), J1.A26; also elsewhere on the board
ABUS8: IC18.2 (A1), J1.C27; also elsewhere on the board
ABUS9: IC18.3 (A2), J1.A27; also elsewhere on the board
ABUS10: IC18.4 (A3), J1.C28; also elsewhere on the board
ABUS11: IC18.5 (A4), J1.A28; also elsewhere on the board
ABUS12: IC18.6 (A5), J1.C29; also elsewhere on the board
ABUS13: IC18.7 (A6), J1.A29; also elsewhere on the board
ABUS14: IC18.8 (A7), J1.C30; also elsewhere on the board
ABUS15: IC18.9 (A8), J1.A30; also elsewhere on the board
ALUBUS0: IC2.2 (A1), IC4.18 (B1), R1.2; also elsewhere on the board
ALUBUS1: IC2.3 (A2), IC4.17 (B2), R2.2; also elsewhere on the board
ALUBUS2: IC2.4 (A3), IC4.16 (B3), R3.2; also elsewhere on the board
ALUBUS3: IC2.5 (A4), IC4.15 (B4), R4.2; also elsewhere on the board
ALUBUS4: IC2.6 (A5), IC4.14 (B5), R5.2; also elsewhere on the board
ALUBUS5: IC2.7 (A6), IC4.13 (B6), R6.2; also elsewhere on the board
ALUBUS6: IC2.8 (A7), IC4.12 (B7), R7.2; also elsewhere on the board
ALUBUS7: IC2.9 (A8), IC4.11 (B8), R8.2; also elsewhere on the board
ALUBUS8: IC3.18 (B1), IC19.18 (Y1); also elsewhere on the board
ALUBUS9: IC3.17 (B2), IC19.17 (Y2); also elsewhere on the board
ALUBUS10: IC3.16 (B3), IC19.16 (Y3); also elsewhere on the board
ALUBUS11: IC3.15 (B4), IC19.15 (Y4); also elsewhere on the board
ALUBUS12: IC3.14 (B5), IC19.14 (Y5); also elsewhere on the board
ALUBUS13: IC3.13 (B6), IC19.13 (Y6); also elsewhere on the board
ALUBUS14: IC3.12 (B7), IC19.12 (Y7); also elsewhere on the board
ALUBUS15: IC3.11 (B8), IC19.11 (Y8); also elsewhere on the board
BUSCLK: IC13.3 (O), IC14.11 (A1), IC14.13 (A2)
BUSCLKA: IC14.9 (Y1); also elsewhere on the board
BUSCLKB: IC14.7 (Y2); also elsewhere on the board
CLK0: IC9.5 (Q), IC9.12 (D), IC13.1 (I0), IC13.4 (I0), IC13.5 (I1)
CLK0A: IC14.18 (Y1); also elsewhere on the board
CLK0B: IC14.16 (Y2); also elsewhere on the board
CLK0C: IC14.14 (Y3); also elsewhere on the board
CLK0D: IC14.12 (Y4); also elsewhere on the board
CLK1: IC14.5 (Y3); also elsewhere on the board
DBUS0: IC3.2 (A1), IC4.2 (A1), IC6.2 (A1), J1.C3, R9.2; also elsewhere on the board
DBUS1: IC3.3 (A2), IC4.3 (A2), IC6.3 (A2), J1.C4, R10.2; also elsewhere on the board
DBUS2: IC3.4 (A3), IC4.4 (A3), IC6.4 (A3), J1.C5, R11.2; also elsewhere on the board
DBUS3: IC3.5 (A4), IC4.5 (A4), IC6.5 (A4), J1.C6, R12.2; also elsewhere on the board
DBUS4: IC3.6 (A5), IC4.6 (A5), IC6.6 (A5), J1.C7, R13.2; also elsewhere on the board
DBUS5: IC3.7 (A6), IC4.7 (A6), IC6.7 (A6), J1.C8, R14.2; also elsewhere on the board
DBUS6: IC3.8 (A7), IC4.8 (A7), IC6.8 (A7), J1.C9, R15.2; also elsewhere on the board
DBUS7: IC3.9 (A8), IC4.9 (A8), IC6.9 (A8), IC19.2 (A1), IC19.3 (A2), IC19.4 (A3), IC19.5 (A4), IC19.6 (A5), IC19.7 (A6), IC19.8 (A7), IC19.9 (A8), J1.C10, R16.2; also elsewhere on the board
GND: C1.-, C2.2, C3.2, C4.2, C5.2, C6.2, C7.2, C8.2, C9.2, C10.2, C11.2, C12.2, C13.2, C14.2, C15.2, C16.2, C17.2, C18.-, IC1.7 (GND), IC1.9 (I0), IC1.10 (I1), IC1.12 (I0), IC1.13 (I1), IC2.1 (G1), IC2.10 (GND), IC2.19 (G2), IC3.10 (GND), IC4.10 (GND), IC6.1 (G1), IC6.10 (GND), IC6.19 (G2), IC9.7 (GND), IC10.7 (GND), IC11.5 (CLK), IC11.6 (CL), IC11.7 (J), IC11.10 (K), IC11.11 (GND), IC12.4 (GND), IC13.7 (GND), IC13.12 (I0), IC13.13 (I1), IC14.1 (G), IC14.10 (GND), IC14.19 (G), IC15.7 (GND), IC15.10 (PRE), IC15.11 (CLK), IC15.12 (D), IC15.13 (CLR), IC16.7 (GND), IC16.9 (I), IC16.11 (I), IC16.13 (I), IC17.10 (GND), IC18.10 (GND), IC19.10 (GND), J1.A1, J1.A2, J1.C1, J1.C2, LED1.K (C), OSC1.7 (GND), S1.3, S1.4 (P1), X1.2; also elsewhere on the board
IRQ0: J1.A3; also elsewhere on the board
IRQ1: J1.A4; also elsewhere on the board
IRQ2: J1.A5; also elsewhere on the board
IRQ3: J1.A6; also elsewhere on the board
IRQ4: J1.A7; also elsewhere on the board
IRQ5: J1.A8; also elsewhere on the board
IRQ6: J1.A9; also elsewhere on the board
IRQ7: J1.A10; also elsewhere on the board
unnamed: IC1.3 (O), IC3.19 (G)
unnamed: IC1.6 (O), IC4.19 (G)
unnamed: IC2.18 (Y1), R1.1
unnamed: IC2.17 (Y2), R2.1
unnamed: IC2.16 (Y3), R3.1
unnamed: IC2.15 (Y4), R4.1
unnamed: IC2.14 (Y5), R5.1
unnamed: IC2.13 (Y6), R6.1
unnamed: IC2.12 (Y7), R7.1
unnamed: IC2.11 (Y8), R8.1
unnamed: IC6.18 (Y1), R9.1
unnamed: IC6.17 (Y2), R10.1
unnamed: IC6.16 (Y3), R11.1
unnamed: IC6.15 (Y4), R12.1
unnamed: IC6.14 (Y5), R13.1
unnamed: IC6.12 (Y7), R15.1
unnamed: IC6.11 (Y8), R16.1
unnamed: IC6.13 (Y6), R14.1
unnamed: IC12.1 (PBRST), S1.1 (S), S1.2 (S1)
unnamed: IC9.3 (CLK), IC9.11 (CLK), IC10.3 (CLK), IC10.11 (CLK), OSC1.8 (OUT)
unnamed: LED1.A, R18.1
unnamed: IC9.2 (D), IC9.8 (!Q)
unnamed: IC14.17 (A4), IC15.5 (Q)
unnamed: IC12.6 (RST), IC15.2 (D), R19.1
unnamed: IC10.2 (D), IC10.8 (!Q)
unnamed: IC13.8 (O), IC14.2 (A1), IC14.4 (A2), IC14.6 (A3), IC14.8 (A4)
unnamed: IC9.1 (CLR), IC11.13 (!Q)
unnamed: C1.+, IC16.3 (I), R17.1
unnamed: IC13.6 (O), IC13.9 (I0), IC13.10 (I1)
unnamed: IC9.9 (Q), IC12.7 (ST), IC13.2 (I1), IC14.15 (A3), IC15.3 (CLK)
unnamed: IC10.5 (Q), IC10.12 (D)
unnamed: IC10.9 (Q), IC11.1 (CLK)
unnamed: IC11.3 (K), IC11.14 (J), IC16.2 (O)
unnamed: IC16.4 (O), IC16.5 (I)
unnamed: IC9.13 (CLR), IC10.13 (CLR), IC16.6 (O)
PABUS12: J1.C15; also elsewhere on the board
PABUS13: J1.A15; also elsewhere on the board
PABUS14: J1.C16; also elsewhere on the board
PABUS15: J1.A16; also elsewhere on the board
PABUS16: J1.C17; also elsewhere on the board
PABUS17: J1.A17; also elsewhere on the board
PABUS18: J1.C18; also elsewhere on the board
PABUS19: J1.A18; also elsewhere on the board
PABUS20: J1.C19; also elsewhere on the board
PABUS21: J1.A19; also elsewhere on the board
RBUS0: IC17.18 (Y1); also elsewhere on the board
RBUS1: IC17.17 (Y2); also elsewhere on the board
RBUS2: IC17.16 (Y3); also elsewhere on the board
RBUS3: IC17.15 (Y4); also elsewhere on the board
RBUS4: IC17.14 (Y5); also elsewhere on the board
RBUS5: IC17.13 (Y6); also elsewhere on the board
RBUS6: IC17.12 (Y7); also elsewhere on the board
RBUS7: IC17.11 (Y8); also elsewhere on the board
RBUS8: IC18.18 (Y1); also elsewhere on the board
RBUS9: IC18.17 (Y2); also elsewhere on the board
RBUS10: IC18.16 (Y3); also elsewhere on the board
RBUS11: IC18.15 (Y4); also elsewhere on the board
RBUS12: IC18.14 (Y5); also elsewhere on the board
RBUS13: IC18.13 (Y6); also elsewhere on the board
RBUS14: IC18.12 (Y7); also elsewhere on the board
RBUS15: IC18.11 (Y8); also elsewhere on the board
RST: IC15.6 (!Q); also elsewhere on the board

Notes on the sheet:
Clocks, reset, bus interface
Dawid Pilawa
(C) 2010-2016
CPU.0
2.0
/RST is active for ~250ms
CLK0
BUSCLK
CLK1
Wait state is 1 extra cycle of low CLK

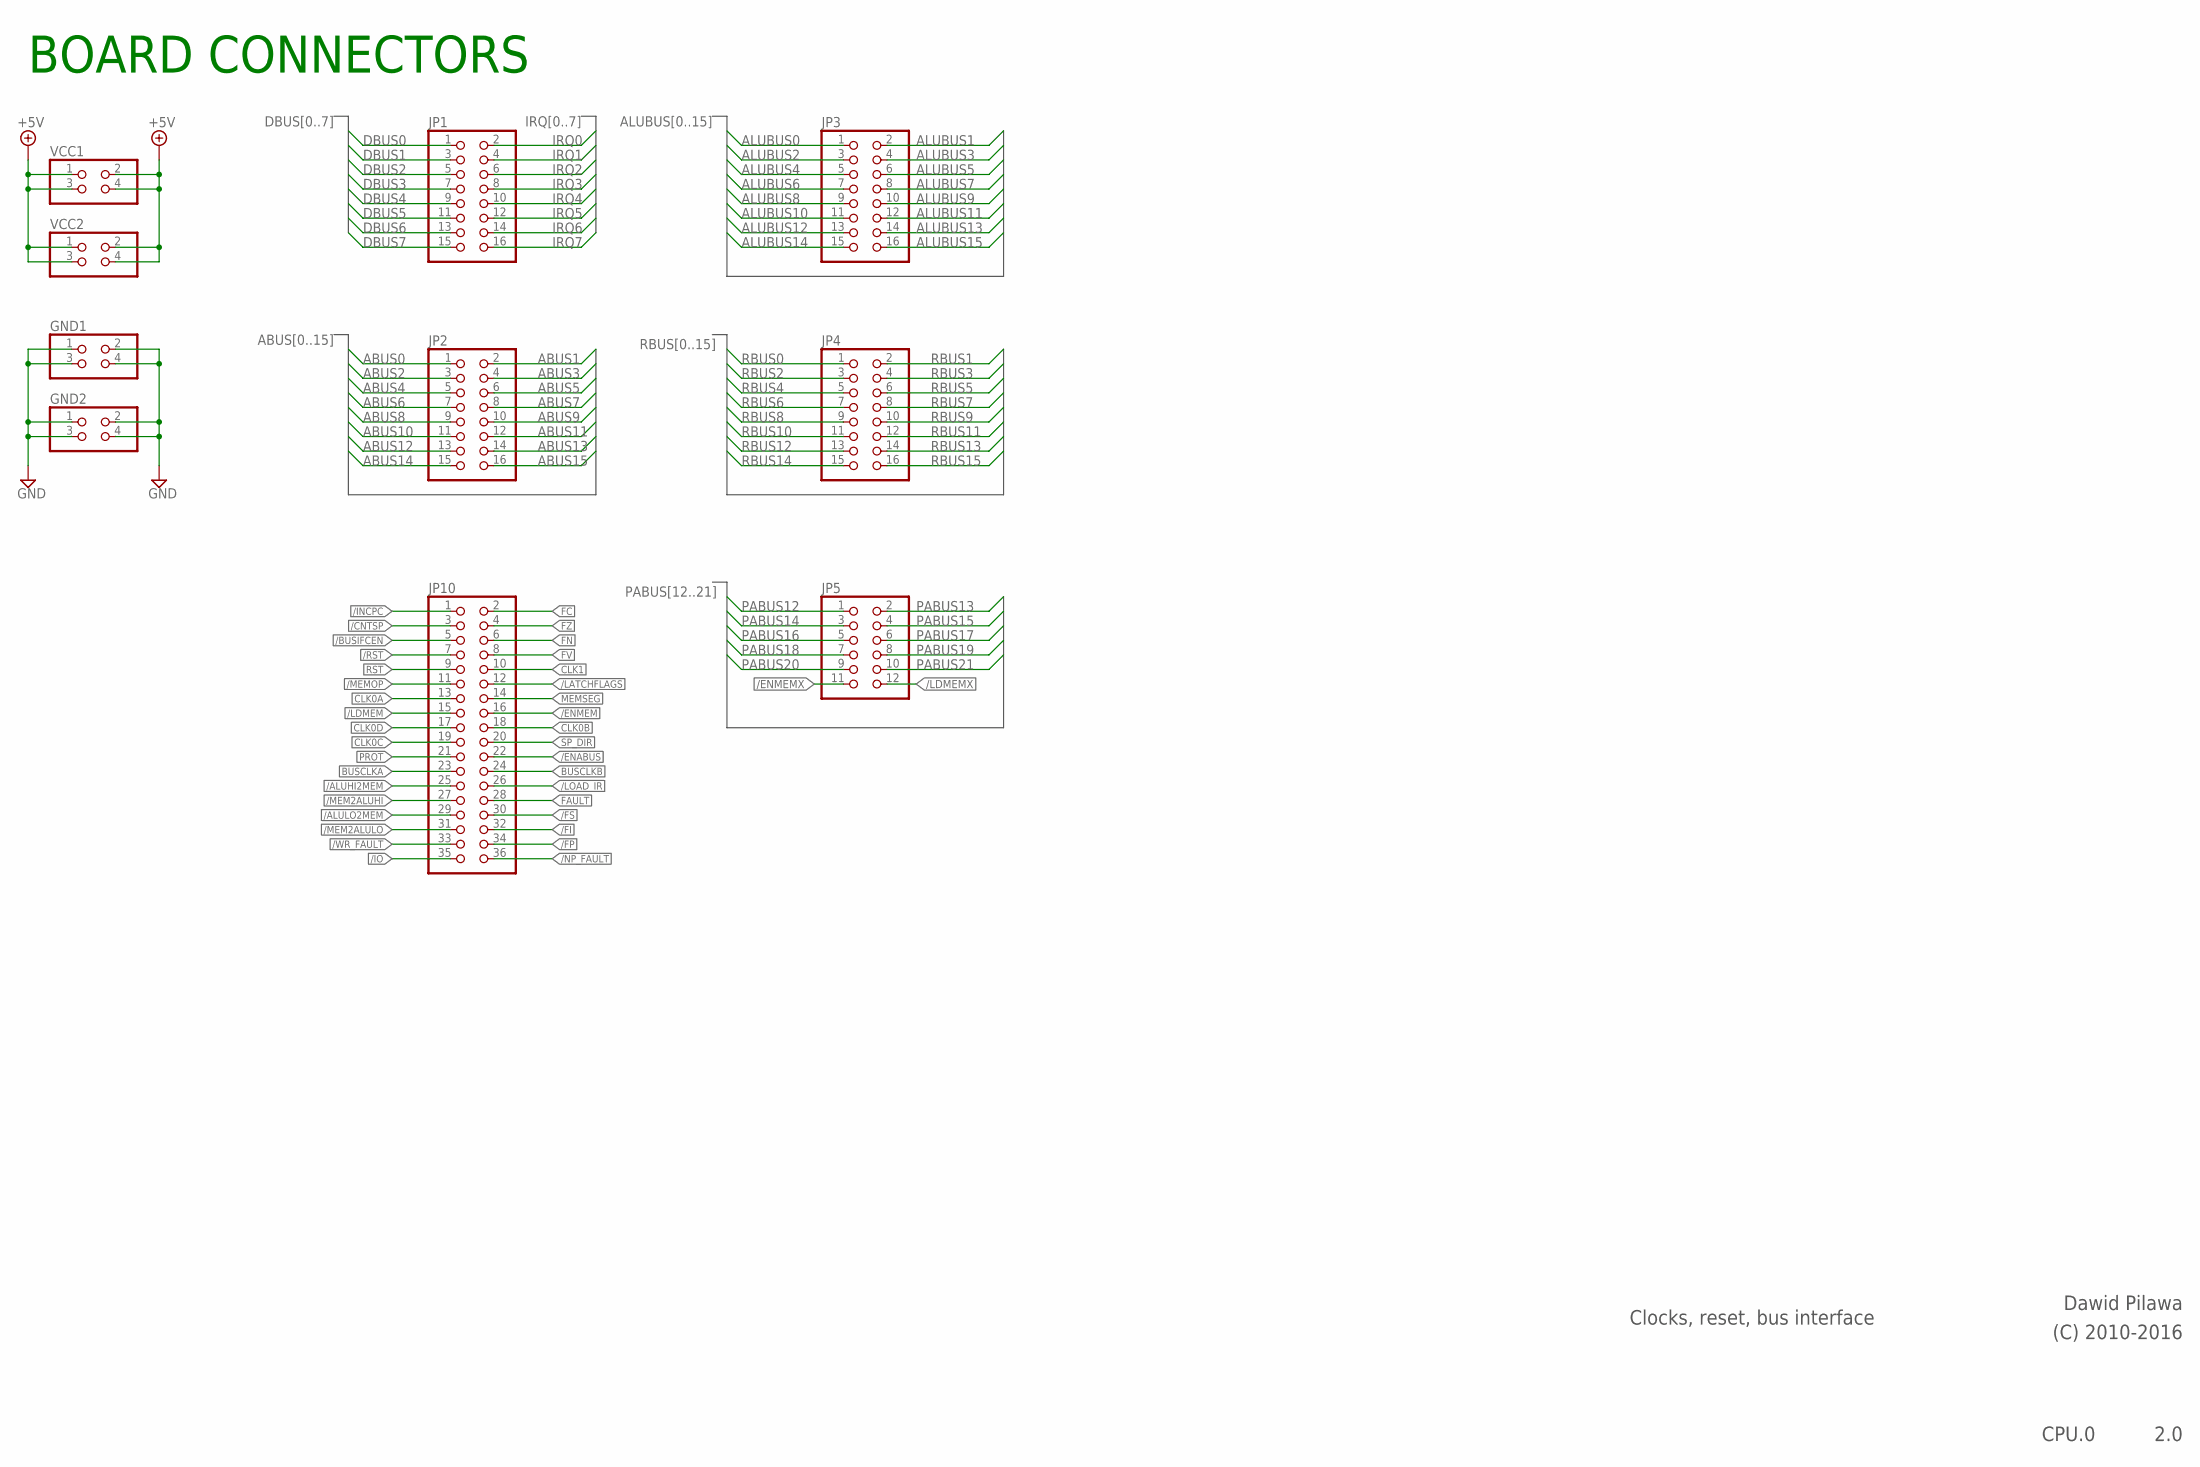
[picture p91: schematic 0_cpu_interface.sch, sheet 2]

Parts:
GND1, GND2: PINHD-2X2; 2X02
JP1, JP2, JP3, JP4: PINHD-2X8; 2X08
JP5: PINHD-2X6; 2X06
JP10: PINHD-2X18; 2X18
VCC1, VCC2: PINHD-2X2; 2X02

Connections:
+5V: VCC1.1, VCC1.2, VCC1.3, VCC1.4, VCC2.1, VCC2.2, VCC2.3, VCC2.4; also elsewhere on the board
/ALUHI2MEM: JP10.25; also elsewhere on the board
/ALULO2MEM: JP10.29; also elsewhere on the board
/BUSIFCEN: JP10.5
/CNTSP: JP10.3
/ENABUS: JP10.22; also elsewhere on the board
/ENMEM: JP10.16
/ENMEMX: JP5.11; also elsewhere on the board
/FI: JP10.32
/FP: JP10.34
/FS: JP10.30
/INCPC: JP10.1
/IO: JP10.35; also elsewhere on the board
/LATCHFLAGS: JP10.12
/LDMEM: JP10.15
/LDMEMX: JP5.12; also elsewhere on the board
/LOAD_IR: JP10.26
/MEM2ALUHI: JP10.27; also elsewhere on the board
/MEM2ALULO: JP10.31; also elsewhere on the board
/MEMOP: JP10.11
/NP_FAULT: JP10.36
/RST: JP10.7; also elsewhere on the board
/WR_FAULT: JP10.33
ABUS0: JP2.1; also elsewhere on the board
ABUS1: JP2.2; also elsewhere on the board
ABUS2: JP2.3; also elsewhere on the board
ABUS3: JP2.4; also elsewhere on the board
ABUS4: JP2.5; also elsewhere on the board
ABUS5: JP2.6; also elsewhere on the board
ABUS6: JP2.7; also elsewhere on the board
ABUS7: JP2.8; also elsewhere on the board
ABUS8: JP2.9; also elsewhere on the board
ABUS9: JP2.10; also elsewhere on the board
ABUS10: JP2.11; also elsewhere on the board
ABUS11: JP2.12; also elsewhere on the board
ABUS12: JP2.13; also elsewhere on the board
ABUS13: JP2.14; also elsewhere on the board
ABUS14: JP2.15; also elsewhere on the board
ABUS15: JP2.16; also elsewhere on the board
ALUBUS0: JP3.1; also elsewhere on the board
ALUBUS1: JP3.2; also elsewhere on the board
ALUBUS2: JP3.3; also elsewhere on the board
ALUBUS3: JP3.4; also elsewhere on the board
ALUBUS4: JP3.5; also elsewhere on the board
ALUBUS5: JP3.6; also elsewhere on the board
ALUBUS6: JP3.7; also elsewhere on the board
ALUBUS7: JP3.8; also elsewhere on the board
ALUBUS8: JP3.9; also elsewhere on the board
ALUBUS9: JP3.10; also elsewhere on the board
ALUBUS10: JP3.11; also elsewhere on the board
ALUBUS11: JP3.12; also elsewhere on the board
ALUBUS12: JP3.13; also elsewhere on the board
ALUBUS13: JP3.14; also elsewhere on the board
ALUBUS14: JP3.15; also elsewhere on the board
ALUBUS15: JP3.16; also elsewhere on the board
BUSCLKA: JP10.23; also elsewhere on the board
BUSCLKB: JP10.24; also elsewhere on the board
CLK0A: JP10.13; also elsewhere on the board
CLK0B: JP10.18; also elsewhere on the board
CLK0C: JP10.19; also elsewhere on the board
CLK0D: JP10.17; also elsewhere on the board
CLK1: JP10.10; also elsewhere on the board
DBUS0: JP1.1; also elsewhere on the board
DBUS1: JP1.3; also elsewhere on the board
DBUS2: JP1.5; also elsewhere on the board
DBUS3: JP1.7; also elsewhere on the board
DBUS4: JP1.9; also elsewhere on the board
DBUS5: JP1.11; also elsewhere on the board
DBUS6: JP1.13; also elsewhere on the board
DBUS7: JP1.15; also elsewhere on the board
FAULT: JP10.28
FC: JP10.2
FN: JP10.6
FV: JP10.8
FZ: JP10.4
GND: GND1.1, GND1.2, GND1.3, GND1.4, GND2.1, GND2.2, GND2.3, GND2.4; also elsewhere on the board
IRQ0: JP1.2; also elsewhere on the board
IRQ1: JP1.4; also elsewhere on the board
IRQ2: JP1.6; also elsewhere on the board
IRQ3: JP1.8; also elsewhere on the board
IRQ4: JP1.10; also elsewhere on the board
IRQ5: JP1.12; also elsewhere on the board
IRQ6: JP1.14; also elsewhere on the board
IRQ7: JP1.16; also elsewhere on the board
MEMSEG: JP10.14
PABUS12: JP5.1; also elsewhere on the board
PABUS13: JP5.2; also elsewhere on the board
PABUS14: JP5.3; also elsewhere on the board
PABUS15: JP5.4; also elsewhere on the board
PABUS16: JP5.5; also elsewhere on the board
PABUS17: JP5.6; also elsewhere on the board
PABUS18: JP5.7; also elsewhere on the board
PABUS19: JP5.8; also elsewhere on the board
PABUS20: JP5.9; also elsewhere on the board
PABUS21: JP5.10; also elsewhere on the board
PROT: JP10.21
RBUS0: JP4.1; also elsewhere on the board
RBUS1: JP4.2; also elsewhere on the board
RBUS2: JP4.3; also elsewhere on the board
RBUS3: JP4.4; also elsewhere on the board
RBUS4: JP4.5; also elsewhere on the board
RBUS5: JP4.6; also elsewhere on the board
RBUS6: JP4.7; also elsewhere on the board
RBUS7: JP4.8; also elsewhere on the board
RBUS8: JP4.9; also elsewhere on the board
RBUS9: JP4.10; also elsewhere on the board
RBUS10: JP4.11; also elsewhere on the board
RBUS11: JP4.12; also elsewhere on the board
RBUS12: JP4.13; also elsewhere on the board
RBUS13: JP4.14; also elsewhere on the board
RBUS14: JP4.15; also elsewhere on the board
RBUS15: JP4.16; also elsewhere on the board
RST: JP10.9; also elsewhere on the board
SP_DIR: JP10.20

Notes on the sheet:
Clocks, reset, bus interface
Dawid Pilawa
(C) 2010-2016
CPU.0
2.0
BOARD CONNECTORS

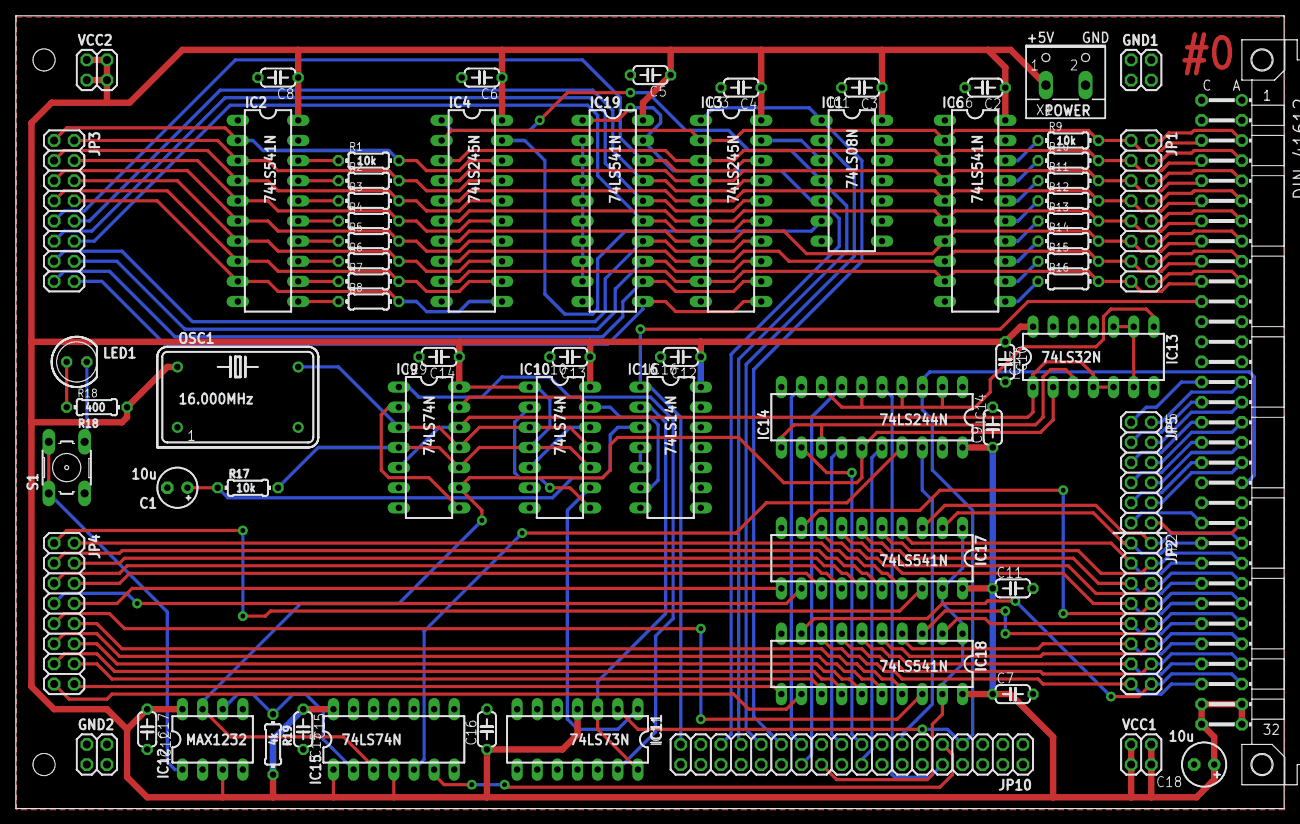
[picture p92: board 0_cpu_interface.brd from above]

Board: 2 copper layers, 160.0 x 100.0 mm, 68 parts (0 on the bottom side), 130 nets.
