dpilawa/bytec/eagle/1_cpu_mmu.brd

## EAGLE design eagle/1_cpu_mmu.brd (2016-04-14)

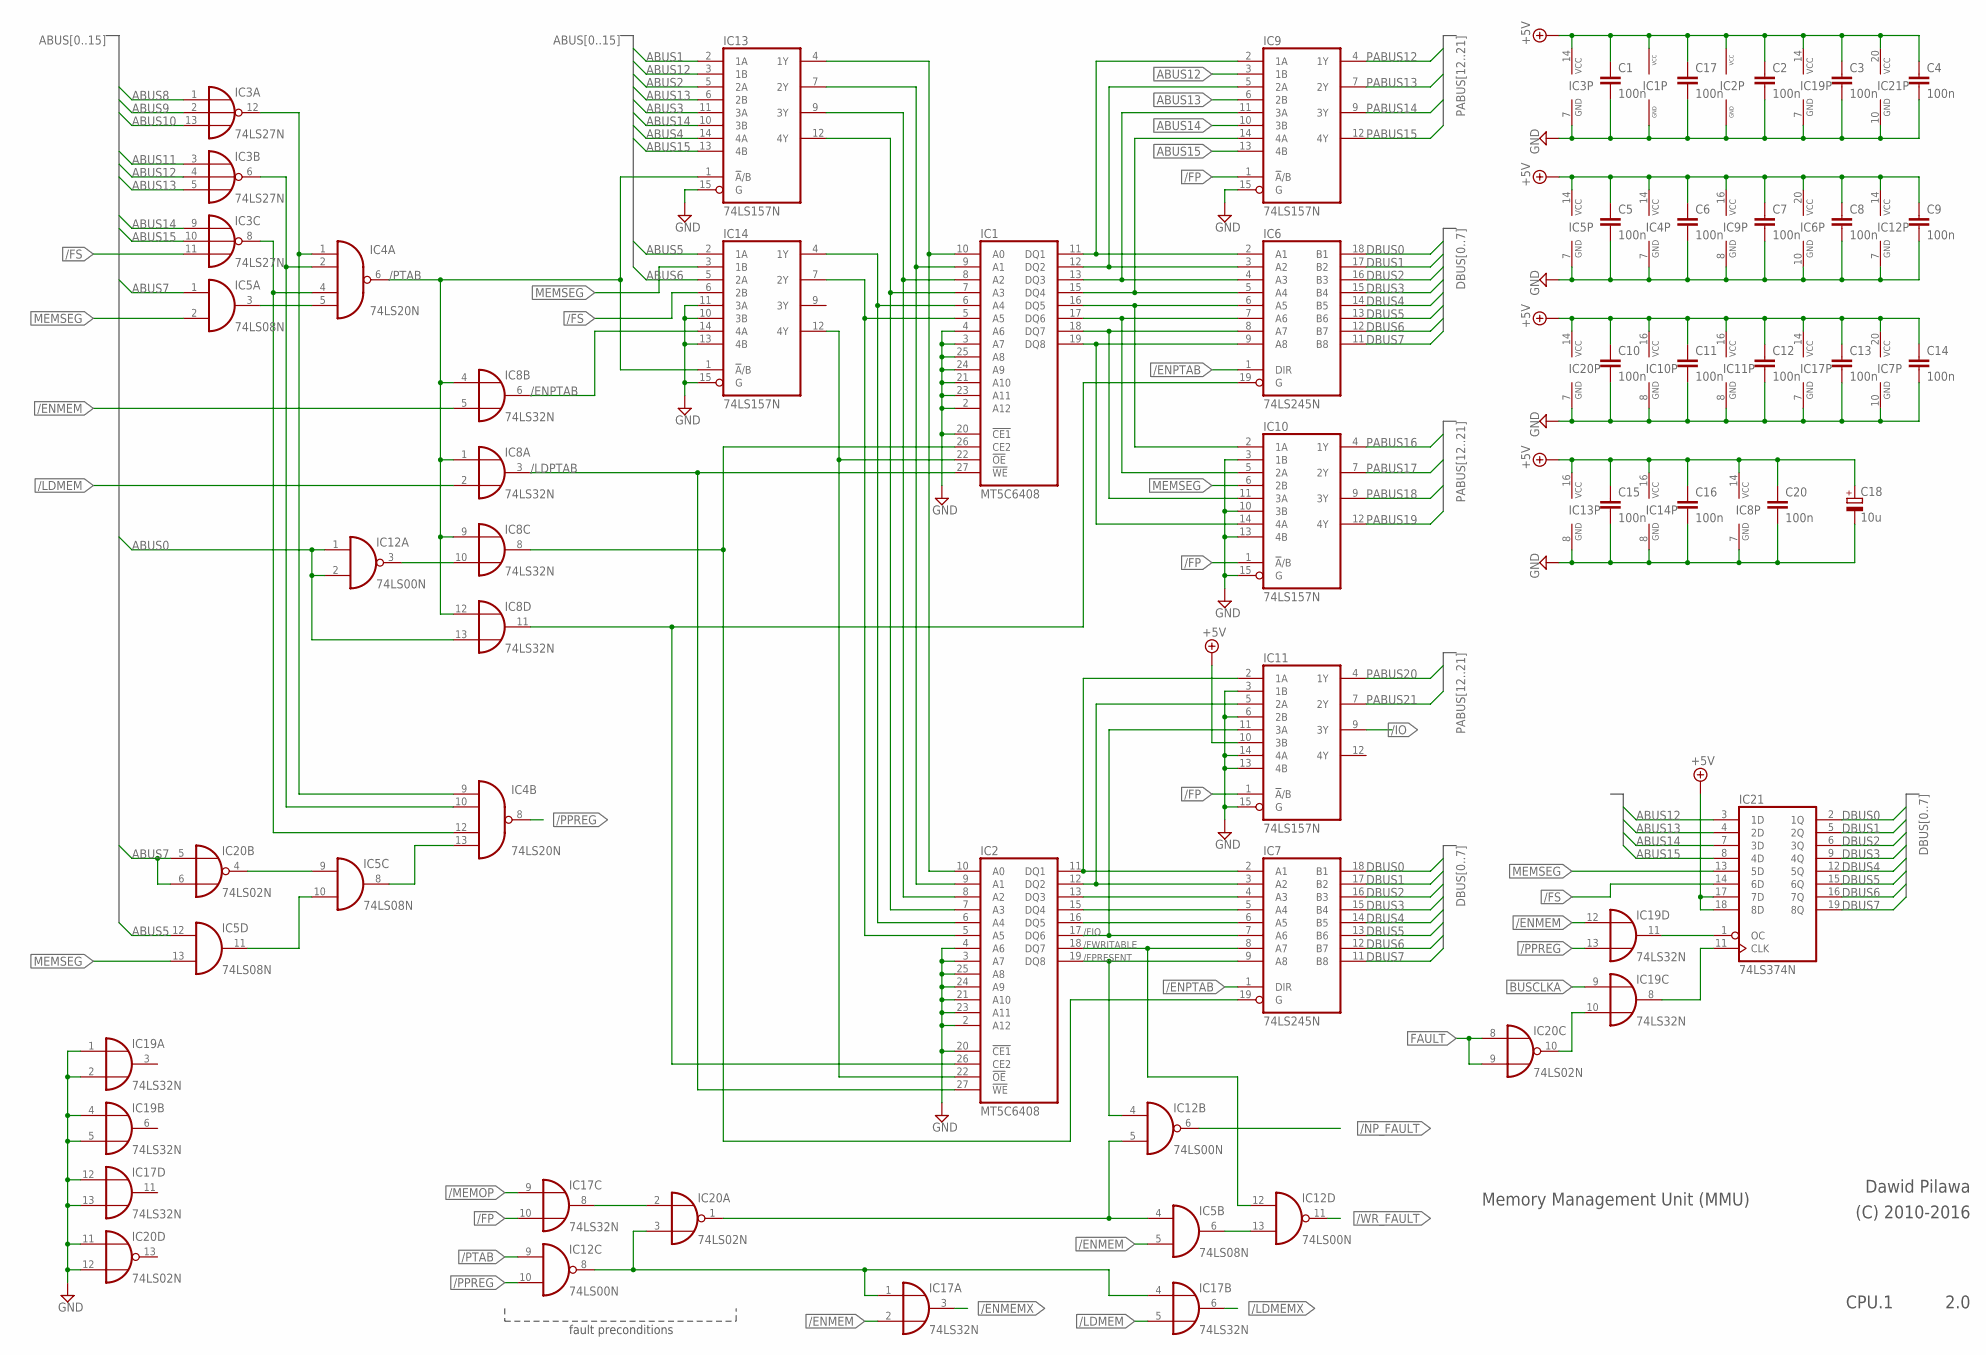
[picture p93: schematic 1_cpu_mmu.sch, sheet 1]

Parts:
C1, C2, C3, C4, C5, C6, C7, C8, C9, C10, C11, C12, C13, C14, C15, C16, C17, C20: 100n; C050-024X044
C18: 10u; E2,5-6
IC1, IC2: MT5C6408; DIL28-3
IC3: 74LS27N; DIL14
IC4: 74LS20N; DIL14
IC5: 74LS08N; DIL14
IC6, IC7: 74LS245N; DIL20
IC8, IC17, IC19: 74LS32N; DIL14
IC9, IC10, IC11, IC13, IC14: 74LS157N; DIL16
IC12: 74LS00N; DIL14
IC20: 74LS02N; DIL14
IC21: 74LS374N; DIL20

Connections:
+5V: C1.1, C2.1, C3.1, C4.1, C5.1, C6.1, C7.1, C8.1, C9.1, C10.1, C11.1, C12.1, C13.1, C14.1, C15.1, C16.1, C17.1, C18.+, C20.1, IC1.28 (VCC), IC2.28 (VCC), IC3.14 (VCC), IC4.14 (VCC), IC5.14 (VCC), IC6.20 (VCC), IC7.20 (VCC), IC8.14 (VCC), IC9.16 (VCC), IC10.16 (VCC), IC11.10 (3B), IC11.16 (VCC), IC12.14 (VCC), IC13.16 (VCC), IC14.16 (VCC), IC17.14 (VCC), IC19.14 (VCC), IC20.14 (VCC), IC21.17 (7D), IC21.18 (8D), IC21.20 (VCC); also elsewhere on the board
/ENMEM: IC5.5 (I1), IC8.5 (I1), IC17.2 (I1), IC19.12 (I0); also elsewhere on the board
/ENMEMX: IC17.3 (O); also elsewhere on the board
/ENPTAB: IC6.1 (DIR), IC7.1 (DIR), IC8.6 (O), IC14.14 (4A)
/FIO: IC2.17 (DQ6), IC7.7 (A6), IC11.11 (3A)
/FP: IC9.1 (!A!/B), IC10.1 (!A!/B), IC11.1 (!A!/B), IC17.10 (I1); also elsewhere on the board
/FPRESENT: IC2.19 (DQ8), IC7.9 (A8), IC12.4 (I0)
/FS: IC3.11 (I2), IC14.6 (2B), IC21.14 (6D); also elsewhere on the board
/FWRITABLE: IC2.18 (DQ7), IC7.8 (A7), IC12.12 (I0)
/IO: IC11.9 (3Y); also elsewhere on the board
/LDMEM: IC8.2 (I1), IC17.5 (I1); also elsewhere on the board
/LDMEMX: IC17.6 (O); also elsewhere on the board
/LDPTAB: IC1.27 (!WE), IC2.27 (!WE), IC8.3 (O)
/MEMOP: IC17.9 (I0); also elsewhere on the board
/NP_FAULT: IC12.6 (O); also elsewhere on the board
/PPREG: IC4.8 (O), IC12.10 (I1), IC19.13 (I1)
/PTAB: IC4.6 (O), IC8.1 (I0), IC8.4 (I0), IC8.9 (I0), IC8.12 (I0), IC12.9 (I0), IC13.1 (!A!/B), IC14.1 (!A!/B)
/WR_FAULT: IC12.11 (O); also elsewhere on the board
ABUS0: IC8.13 (I1), IC12.1 (I0), IC12.2 (I1); also elsewhere on the board
ABUS1: IC13.2 (1A); also elsewhere on the board
ABUS2: IC13.5 (2A); also elsewhere on the board
ABUS3: IC13.11 (3A); also elsewhere on the board
ABUS4: IC13.14 (4A); also elsewhere on the board
ABUS5: IC5.12 (I0), IC14.2 (1A); also elsewhere on the board
ABUS6: IC14.5 (2A); also elsewhere on the board
ABUS7: IC5.1 (I0), IC20.5 (I0), IC20.6 (I1); also elsewhere on the board
ABUS8: IC3.1 (I0); also elsewhere on the board
ABUS9: IC3.2 (I1); also elsewhere on the board
ABUS10: IC3.13 (I2); also elsewhere on the board
ABUS11: IC3.3 (I0); also elsewhere on the board
ABUS12: IC3.4 (I1), IC9.3 (1B), IC13.3 (1B), IC21.3 (1D); also elsewhere on the board
ABUS13: IC3.5 (I2), IC9.6 (2B), IC13.6 (2B), IC21.4 (2D); also elsewhere on the board
ABUS14: IC3.9 (I0), IC9.10 (3B), IC13.10 (3B), IC21.7 (3D); also elsewhere on the board
ABUS15: IC3.10 (I1), IC9.13 (4B), IC13.13 (4B), IC21.8 (4D); also elsewhere on the board
BUSCLKA: IC19.9 (I0); also elsewhere on the board
DBUS0: IC6.18 (B1), IC7.18 (B1), IC21.2 (1Q); also elsewhere on the board
DBUS1: IC6.17 (B2), IC7.17 (B2), IC21.5 (2Q); also elsewhere on the board
DBUS2: IC6.16 (B3), IC7.16 (B3), IC21.6 (3Q); also elsewhere on the board
DBUS3: IC6.15 (B4), IC7.15 (B4), IC21.9 (4Q); also elsewhere on the board
DBUS4: IC6.14 (B5), IC7.14 (B5), IC21.12 (5Q); also elsewhere on the board
DBUS5: IC6.13 (B6), IC7.13 (B6), IC21.15 (6Q); also elsewhere on the board
DBUS6: IC6.12 (B7), IC7.12 (B7), IC21.16 (7Q); also elsewhere on the board
DBUS7: IC6.11 (B8), IC7.11 (B8), IC21.19 (8Q); also elsewhere on the board
FAULT: IC20.8 (I0), IC20.9 (I1); also elsewhere on the board
GND: C1.2, C2.2, C3.2, C4.2, C5.2, C6.2, C7.2, C8.2, C9.2, C10.2, C11.2, C12.2, C13.2, C14.2, C15.2, C16.2, C17.2, C18.-, C20.2, IC1.2 (A12), IC1.3 (A7), IC1.4 (A6), IC1.14 (GND), IC1.20 (!CE1), IC1.21 (A10), IC1.23 (A11), IC1.24 (A9), IC1.25 (A8), IC2.2 (A12), IC2.3 (A7), IC2.4 (A6), IC2.14 (GND), IC2.20 (!CE1), IC2.21 (A10), IC2.23 (A11), IC2.24 (A9), IC2.25 (A8), IC3.7 (GND), IC4.7 (GND), IC5.7 (GND), IC6.10 (GND), IC7.10 (GND), IC8.7 (GND), IC9.8 (GND), IC9.15 (G), IC10.3 (1B), IC10.8 (GND), IC10.10 (3B), IC10.13 (4B), IC10.15 (G), IC11.3 (1B), IC11.6 (2B), IC11.8 (GND), IC11.13 (4B), IC11.14 (4A), IC11.15 (G), IC12.7 (GND), IC13.8 (GND), IC13.15 (G), IC14.8 (GND), IC14.10 (3B), IC14.11 (3A), IC14.13 (4B), IC14.15 (G), IC17.7 (GND), IC17.12 (I0), IC17.13 (I1), IC19.1 (I0), IC19.2 (I1), IC19.4 (I0), IC19.5 (I1), IC19.7 (GND), IC20.7 (GND), IC20.11 (I0), IC20.12 (I1), IC21.10 (GND); also elsewhere on the board
MEMSEG: IC5.2 (I1), IC5.13 (I1), IC10.6 (2B), IC14.3 (1B), IC21.13 (5D); also elsewhere on the board
unnamed: IC3.12 (O), IC4.1 (I0), IC4.9 (I0)
unnamed: IC3.6 (O), IC4.2 (I1), IC4.10 (I1)
unnamed: IC5.9 (I0), IC20.4 (O)
unnamed: IC4.5 (I3), IC5.3 (O)
unnamed: IC1.11 (DQ1), IC6.2 (A1), IC9.2 (1A)
unnamed: IC1.12 (DQ2), IC6.3 (A2), IC9.5 (2A)
unnamed: IC1.13 (DQ3), IC6.4 (A3), IC9.11 (3A)
unnamed: IC1.15 (DQ4), IC6.5 (A4), IC9.14 (4A)
unnamed: IC1.16 (DQ5), IC6.6 (A5), IC10.2 (1A)
unnamed: IC1.17 (DQ6), IC6.7 (A6), IC10.5 (2A)
unnamed: IC1.18 (DQ7), IC6.8 (A7), IC10.11 (3A)
unnamed: IC1.19 (DQ8), IC6.9 (A8), IC10.14 (4A)
unnamed: IC2.11 (DQ1), IC7.2 (A1), IC11.2 (1A)
unnamed: IC2.12 (DQ2), IC7.3 (A2), IC11.5 (2A)
unnamed: IC2.13 (DQ3), IC7.4 (A3)
unnamed: IC2.15 (DQ4), IC7.5 (A4)
unnamed: IC2.16 (DQ5), IC7.6 (A5)
unnamed: IC17.8 (O), IC20.2 (I0)
unnamed: IC1.10 (A0), IC2.10 (A0), IC13.4 (1Y)
unnamed: IC1.9 (A1), IC2.9 (A1), IC13.7 (2Y)
unnamed: IC1.8 (A2), IC2.8 (A2), IC13.9 (3Y)
unnamed: IC1.7 (A3), IC2.7 (A3), IC13.12 (4Y)
unnamed: IC1.6 (A4), IC2.6 (A4), IC14.4 (1Y)
unnamed: IC1.5 (A5), IC2.5 (A5), IC14.7 (2Y)
unnamed: IC1.26 (CE2), IC7.19 (G), IC8.8 (O)
unnamed: IC2.26 (CE2), IC6.19 (G), IC8.11 (O)
unnamed: IC1.22 (!OE), IC2.22 (!OE), IC14.12 (4Y)
unnamed: IC8.10 (I1), IC12.3 (O)
unnamed: IC12.8 (O), IC17.1 (I0), IC17.4 (I0), IC20.3 (I1)
unnamed: IC5.4 (I0), IC12.5 (I1), IC20.1 (O)
unnamed: IC5.6 (O), IC12.13 (I1)
unnamed: IC5.10 (I1), IC5.11 (O)
unnamed: IC3.8 (O), IC4.4 (I2), IC4.12 (I2)
unnamed: IC4.13 (I3), IC5.8 (O)
unnamed: IC19.10 (I1), IC20.10 (O)
unnamed: IC19.8 (O), IC21.11 (CLK)
unnamed: IC19.11 (O), IC21.1 (OC)
PABUS12: IC9.4 (1Y); also elsewhere on the board
PABUS13: IC9.7 (2Y); also elsewhere on the board
PABUS14: IC9.9 (3Y); also elsewhere on the board
PABUS15: IC9.12 (4Y); also elsewhere on the board
PABUS16: IC10.4 (1Y); also elsewhere on the board
PABUS17: IC10.7 (2Y); also elsewhere on the board
PABUS18: IC10.9 (3Y); also elsewhere on the board
PABUS19: IC10.12 (4Y); also elsewhere on the board
PABUS20: IC11.4 (1Y); also elsewhere on the board
PABUS21: IC11.7 (2Y); also elsewhere on the board

Notes on the sheet:
Memory Management Unit (MMU)
Dawid Pilawa
(C) 2010-2016
CPU.1
2.0
fault preconditions
