dpilawa/bytec/eagle/1_cpu_mmu.brd

## EAGLE design eagle/1_cpu_mmu.brd (continued)

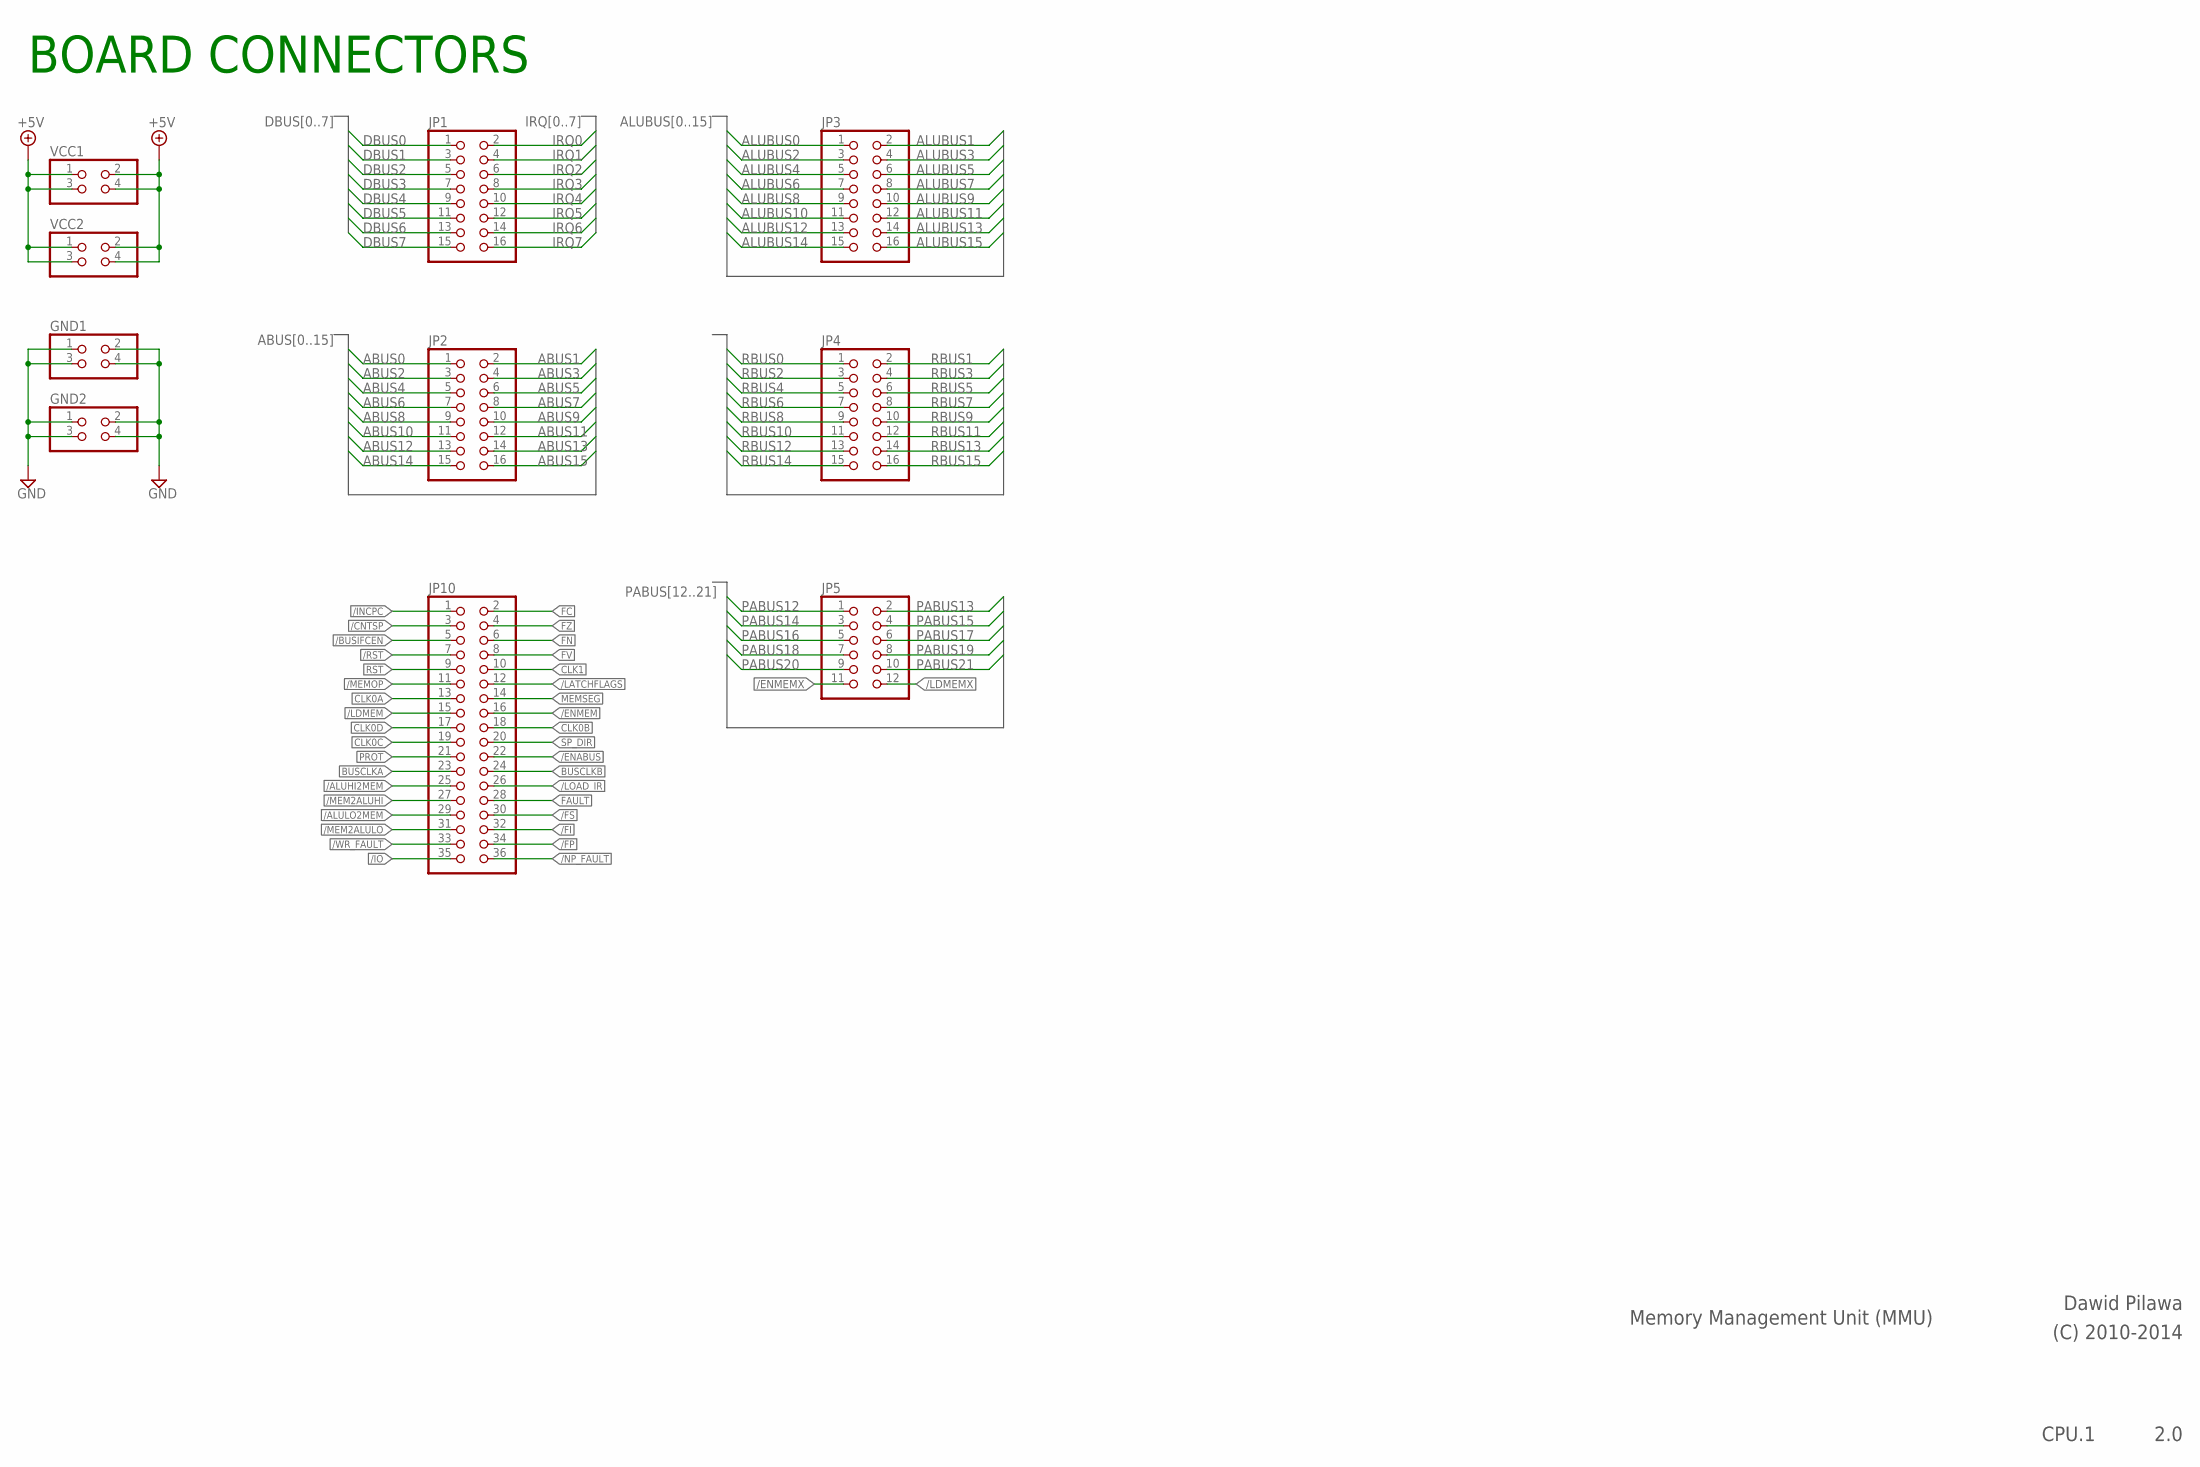
[picture p94: schematic 1_cpu_mmu.sch, sheet 2]

Parts:
GND1, GND2: PINHD-2X2; 2X02
JP1, JP2, JP3, JP4: PINHD-2X8; 2X08
JP5: PINHD-2X6; 2X06
JP10: PINHD-2X18; 2X18
VCC1, VCC2: PINHD-2X2; 2X02

Connections:
+5V: VCC1.1, VCC1.2, VCC1.3, VCC1.4, VCC2.1, VCC2.2, VCC2.3, VCC2.4; also elsewhere on the board
/ALUHI2MEM: JP10.25
/ALULO2MEM: JP10.29
/BUSIFCEN: JP10.5
/CNTSP: JP10.3
/ENABUS: JP10.22
/ENMEM: JP10.16; also elsewhere on the board
/ENMEMX: JP5.11; also elsewhere on the board
/FI: JP10.32
/FP: JP10.34; also elsewhere on the board
/FS: JP10.30; also elsewhere on the board
/INCPC: JP10.1
/IO: JP10.35; also elsewhere on the board
/LATCHFLAGS: JP10.12
/LDMEM: JP10.15; also elsewhere on the board
/LDMEMX: JP5.12; also elsewhere on the board
/LOAD_IR: JP10.26
/MEM2ALUHI: JP10.27
/MEM2ALULO: JP10.31
/MEMOP: JP10.11; also elsewhere on the board
/NP_FAULT: JP10.36; also elsewhere on the board
/RST: JP10.7
/WR_FAULT: JP10.33; also elsewhere on the board
ABUS0: JP2.1; also elsewhere on the board
ABUS1: JP2.2; also elsewhere on the board
ABUS2: JP2.3; also elsewhere on the board
ABUS3: JP2.4; also elsewhere on the board
ABUS4: JP2.5; also elsewhere on the board
ABUS5: JP2.6; also elsewhere on the board
ABUS6: JP2.7; also elsewhere on the board
ABUS7: JP2.8; also elsewhere on the board
ABUS8: JP2.9; also elsewhere on the board
ABUS9: JP2.10; also elsewhere on the board
ABUS10: JP2.11; also elsewhere on the board
ABUS11: JP2.12; also elsewhere on the board
ABUS12: JP2.13; also elsewhere on the board
ABUS13: JP2.14; also elsewhere on the board
ABUS14: JP2.15; also elsewhere on the board
ABUS15: JP2.16; also elsewhere on the board
ALUBUS0: JP3.1
ALUBUS1: JP3.2
ALUBUS2: JP3.3
ALUBUS3: JP3.4
ALUBUS4: JP3.5
ALUBUS5: JP3.6
ALUBUS6: JP3.7
ALUBUS7: JP3.8
ALUBUS8: JP3.9
ALUBUS9: JP3.10
ALUBUS10: JP3.11
ALUBUS11: JP3.12
ALUBUS12: JP3.13
ALUBUS13: JP3.14
ALUBUS14: JP3.15
ALUBUS15: JP3.16
BUSCLKA: JP10.23; also elsewhere on the board
BUSCLKB: JP10.24
CLK0A: JP10.13
CLK0B: JP10.18
CLK0C: JP10.19
CLK0D: JP10.17
CLK1: JP10.10
DBUS0: JP1.1; also elsewhere on the board
DBUS1: JP1.3; also elsewhere on the board
DBUS2: JP1.5; also elsewhere on the board
DBUS3: JP1.7; also elsewhere on the board
DBUS4: JP1.9; also elsewhere on the board
DBUS5: JP1.11; also elsewhere on the board
DBUS6: JP1.13; also elsewhere on the board
DBUS7: JP1.15; also elsewhere on the board
FAULT: JP10.28; also elsewhere on the board
FC: JP10.2
FN: JP10.6
FV: JP10.8
FZ: JP10.4
GND: GND1.1, GND1.2, GND1.3, GND1.4, GND2.1, GND2.2, GND2.3, GND2.4; also elsewhere on the board
IRQ0: JP1.2
IRQ1: JP1.4
IRQ2: JP1.6
IRQ3: JP1.8
IRQ4: JP1.10
IRQ5: JP1.12
IRQ6: JP1.14
IRQ7: JP1.16
MEMSEG: JP10.14; also elsewhere on the board
PABUS12: JP5.1; also elsewhere on the board
PABUS13: JP5.2; also elsewhere on the board
PABUS14: JP5.3; also elsewhere on the board
PABUS15: JP5.4; also elsewhere on the board
PABUS16: JP5.5; also elsewhere on the board
PABUS17: JP5.6; also elsewhere on the board
PABUS18: JP5.7; also elsewhere on the board
PABUS19: JP5.8; also elsewhere on the board
PABUS20: JP5.9; also elsewhere on the board
PABUS21: JP5.10; also elsewhere on the board
PROT: JP10.21
RBUS0: JP4.1
RBUS1: JP4.2
RBUS2: JP4.3
RBUS3: JP4.4
RBUS4: JP4.5
RBUS5: JP4.6
RBUS6: JP4.7
RBUS7: JP4.8
RBUS8: JP4.9
RBUS9: JP4.10
RBUS10: JP4.11
RBUS11: JP4.12
RBUS12: JP4.13
RBUS13: JP4.14
RBUS14: JP4.15
RBUS15: JP4.16
RST: JP10.9
SP_DIR: JP10.20

Notes on the sheet:
Memory Management Unit (MMU)
Dawid Pilawa
(C) 2010-2014
CPU.1
2.0
BOARD CONNECTORS

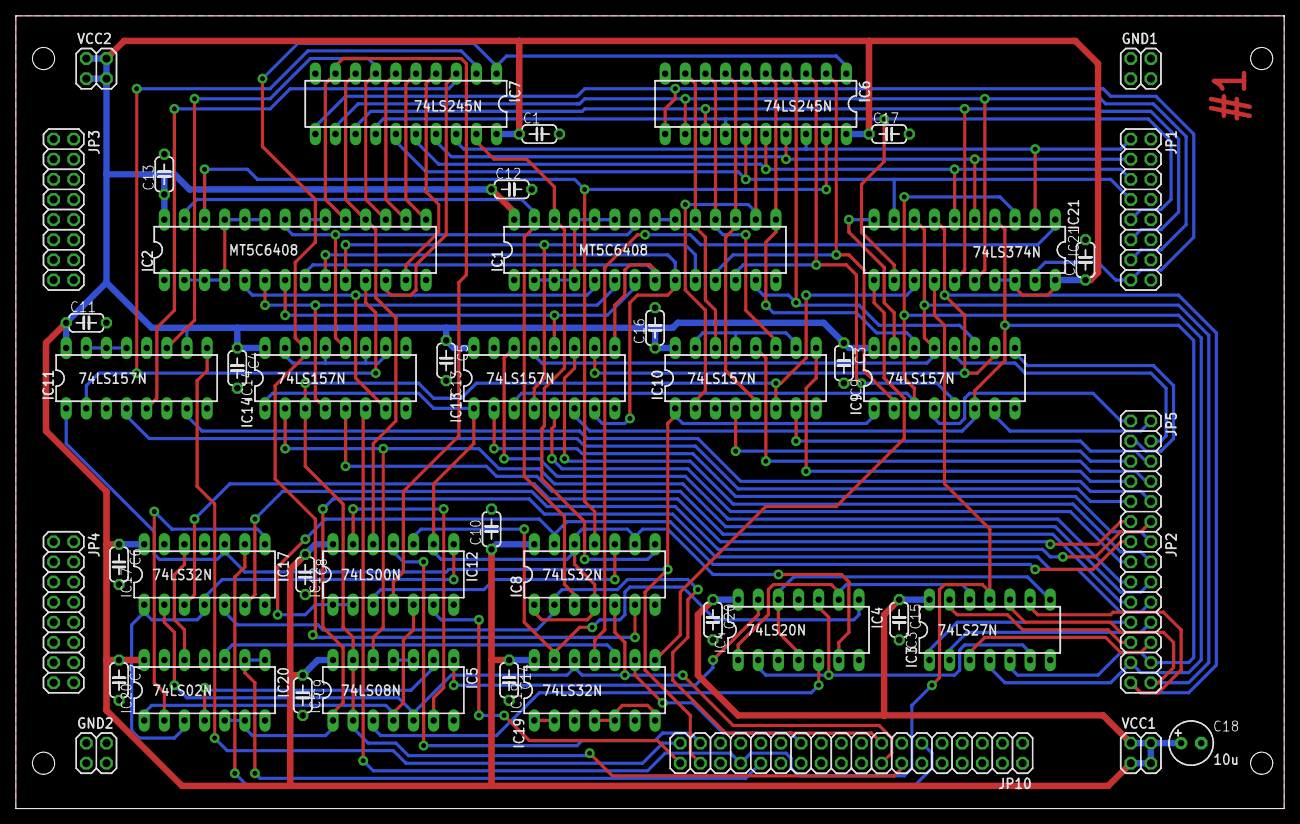
[picture p95: board 1_cpu_mmu.brd from above]

Board: 2 copper layers, 160.0 x 100.0 mm, 47 parts (0 on the bottom side), 93 nets.
