dpilawa/bytec/eagle/memory.brd

## EAGLE design eagle/memory.brd (2016-03-07)

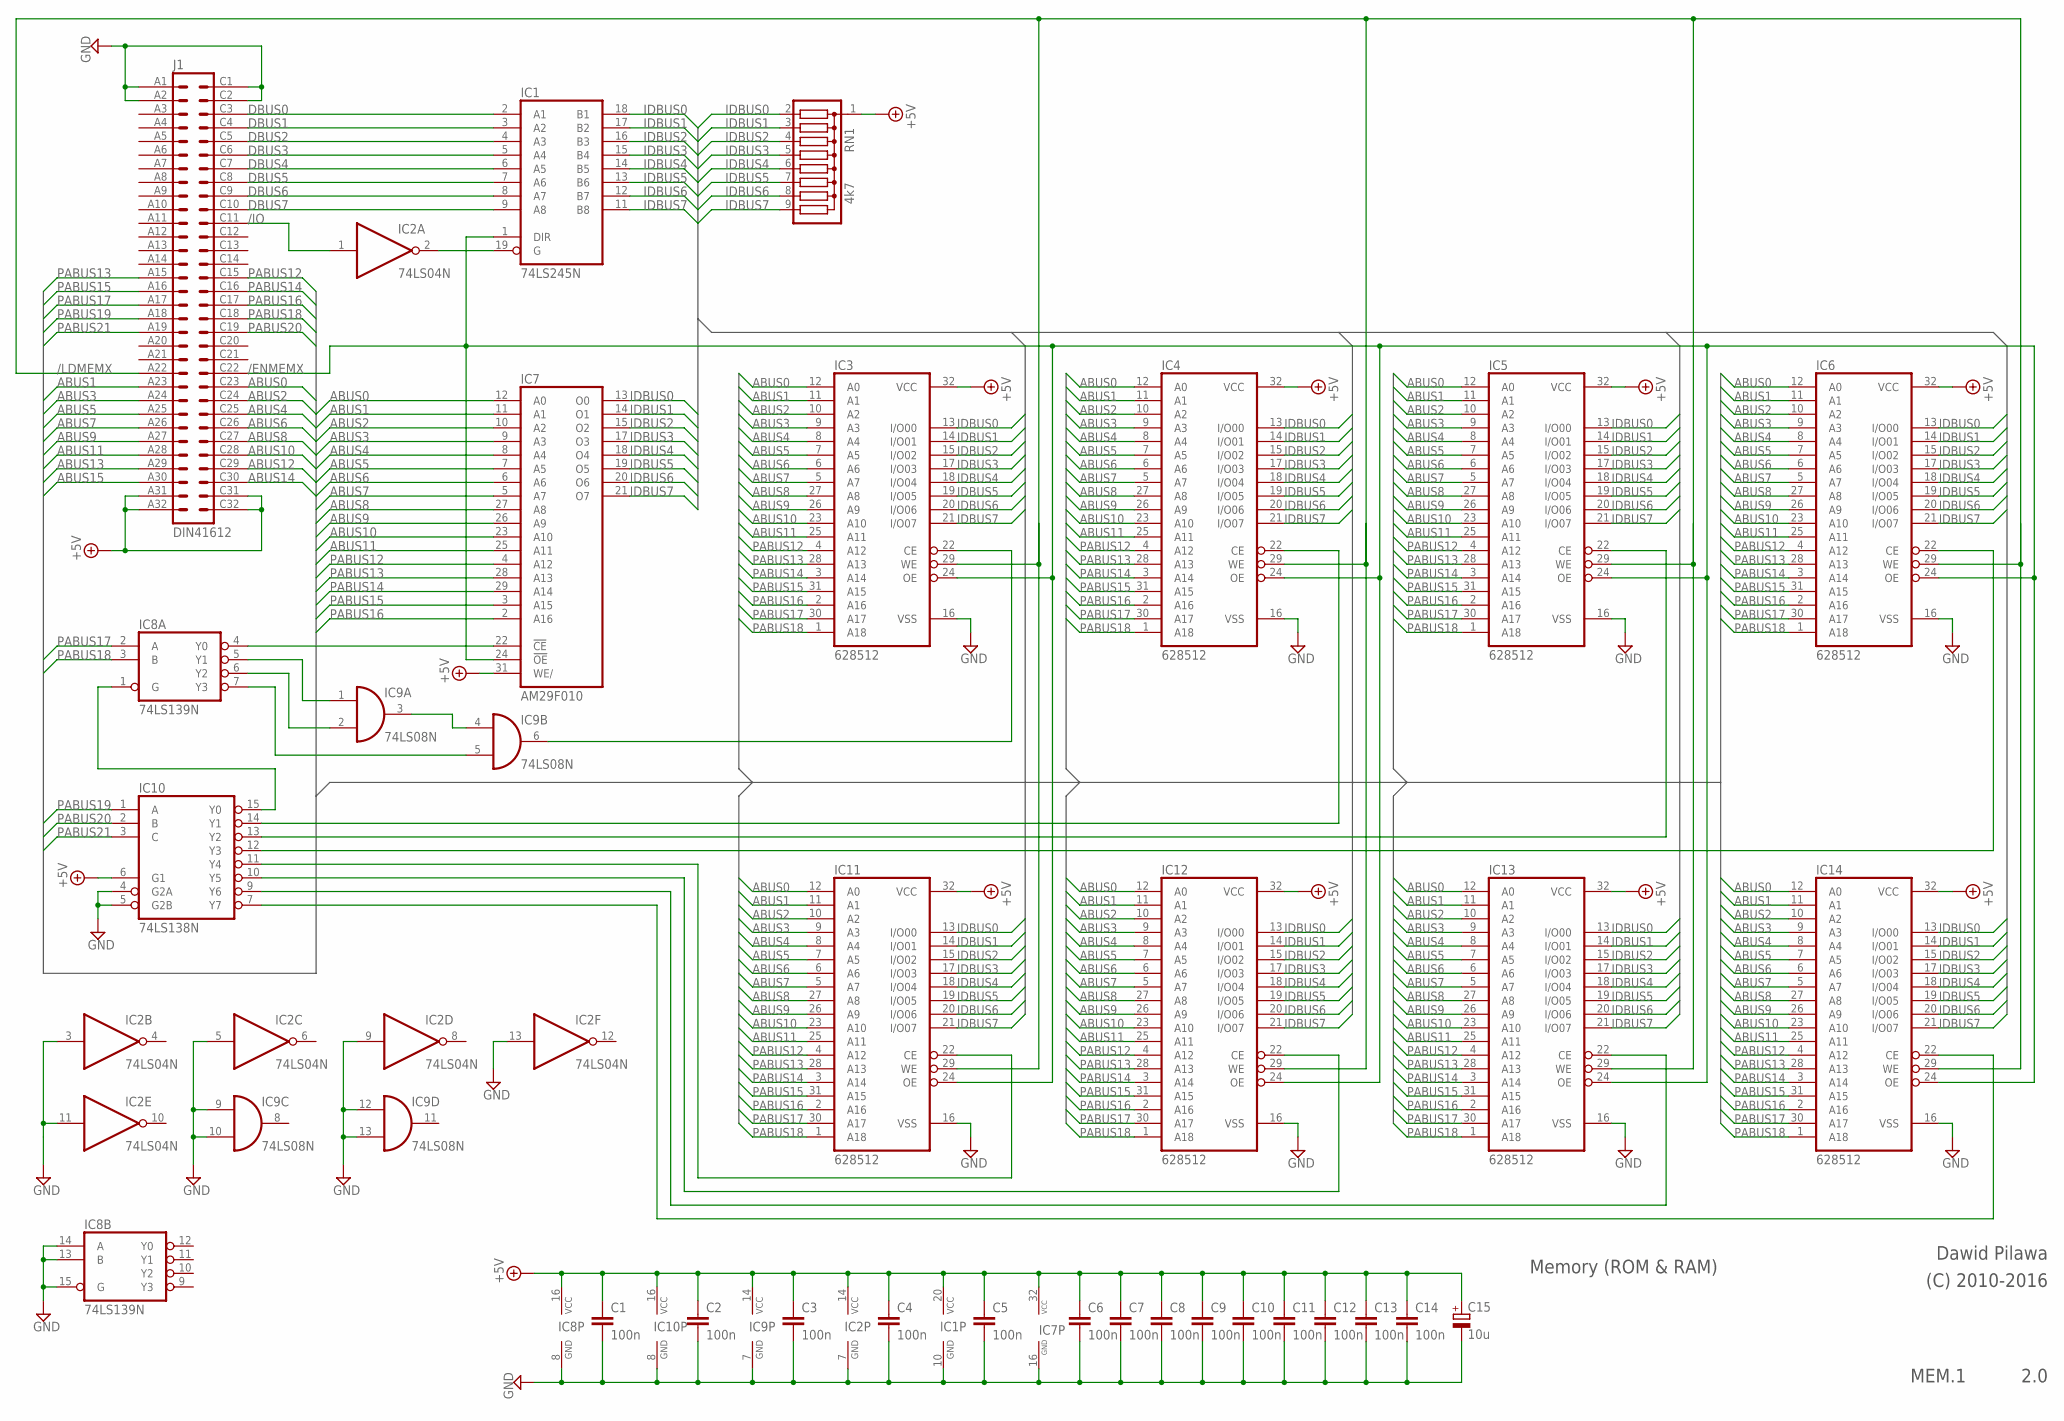
[picture p96: schematic memory.sch]

Parts:
C1, C2, C3, C4, C5, C6, C7, C8, C9, C10, C11, C12, C13, C14: 100n; C050-024X044
C15: 10u; E2,5-6
IC1: 74LS245N; DIL20
IC2: 74LS04N; DIL14
IC3, IC4, IC5, IC6, IC11, IC12, IC13, IC14: 628512; DIL32
IC7: AM29F010; DIL32-6
IC8: 74LS139N; DIL16
IC9: 74LS08N; DIL14
IC10: 74LS138N; DIL16
J1: DIN41612; VG64B
RN1: 4k7; SIL9

Connections:
+5V: C1.1, C2.1, C3.1, C4.1, C5.1, C6.1, C7.1, C8.1, C9.1, C10.1, C11.1, C12.1, C13.1, C14.1, C15.+, IC1.20 (VCC), IC2.14 (VCC), IC3.32 (VCC), IC4.32 (VCC), IC5.32 (VCC), IC6.32 (VCC), IC7.31 (WE/), IC7.32 (VCC), IC8.16 (VCC), IC9.14 (VCC), IC10.6 (G1), IC10.16 (VCC), IC11.32 (VCC), IC12.32 (VCC), IC13.32 (VCC), IC14.32 (VCC), J1.A31, J1.A32, J1.C31, J1.C32, RN1.1
/BANK0RAM: IC3.22 (CE), IC9.6 (O)
/BANK1: IC4.22 (CE), IC10.14 (Y1)
/BANK2: IC5.22 (CE), IC10.13 (Y2)
/BANK3: IC6.22 (CE), IC10.12 (Y3)
/BANK4: IC10.11 (Y4), IC11.22 (CE)
/BANK5: IC10.10 (Y5), IC12.22 (CE)
/BANK6: IC10.9 (Y6), IC13.22 (CE)
/BANK7: IC10.7 (Y7), IC14.22 (CE)
/ENMEMX: IC1.1 (DIR), IC3.24 (OE), IC4.24 (OE), IC5.24 (OE), IC6.24 (OE), IC7.24 (!OE), IC11.24 (OE), IC12.24 (OE), IC13.24 (OE), IC14.24 (OE), J1.C22
/IO: IC2.1 (I), J1.C11
/LDMEMX: IC3.29 (WE), IC4.29 (WE), IC5.29 (WE), IC6.29 (WE), IC11.29 (WE), IC12.29 (WE), IC13.29 (WE), IC14.29 (WE), J1.A22
ABUS0: IC3.12 (A0), IC4.12 (A0), IC5.12 (A0), IC6.12 (A0), IC7.12 (A0), IC11.12 (A0), IC12.12 (A0), IC13.12 (A0), IC14.12 (A0), J1.C23
ABUS1: IC3.11 (A1), IC4.11 (A1), IC5.11 (A1), IC6.11 (A1), IC7.11 (A1), IC11.11 (A1), IC12.11 (A1), IC13.11 (A1), IC14.11 (A1), J1.A23
ABUS2: IC3.10 (A2), IC4.10 (A2), IC5.10 (A2), IC6.10 (A2), IC7.10 (A2), IC11.10 (A2), IC12.10 (A2), IC13.10 (A2), IC14.10 (A2), J1.C24
ABUS3: IC3.9 (A3), IC4.9 (A3), IC5.9 (A3), IC6.9 (A3), IC7.9 (A3), IC11.9 (A3), IC12.9 (A3), IC13.9 (A3), IC14.9 (A3), J1.A24
ABUS4: IC3.8 (A4), IC4.8 (A4), IC5.8 (A4), IC6.8 (A4), IC7.8 (A4), IC11.8 (A4), IC12.8 (A4), IC13.8 (A4), IC14.8 (A4), J1.C25
ABUS5: IC3.7 (A5), IC4.7 (A5), IC5.7 (A5), IC6.7 (A5), IC7.7 (A5), IC11.7 (A5), IC12.7 (A5), IC13.7 (A5), IC14.7 (A5), J1.A25
ABUS6: IC3.6 (A6), IC4.6 (A6), IC5.6 (A6), IC6.6 (A6), IC7.6 (A6), IC11.6 (A6), IC12.6 (A6), IC13.6 (A6), IC14.6 (A6), J1.C26
ABUS7: IC3.5 (A7), IC4.5 (A7), IC5.5 (A7), IC6.5 (A7), IC7.5 (A7), IC11.5 (A7), IC12.5 (A7), IC13.5 (A7), IC14.5 (A7), J1.A26
ABUS8: IC3.27 (A8), IC4.27 (A8), IC5.27 (A8), IC6.27 (A8), IC7.27 (A8), IC11.27 (A8), IC12.27 (A8), IC13.27 (A8), IC14.27 (A8), J1.C27
ABUS9: IC3.26 (A9), IC4.26 (A9), IC5.26 (A9), IC6.26 (A9), IC7.26 (A9), IC11.26 (A9), IC12.26 (A9), IC13.26 (A9), IC14.26 (A9), J1.A27
ABUS10: IC3.23 (A10), IC4.23 (A10), IC5.23 (A10), IC6.23 (A10), IC7.23 (A10), IC11.23 (A10), IC12.23 (A10), IC13.23 (A10), IC14.23 (A10), J1.C28
ABUS11: IC3.25 (A11), IC4.25 (A11), IC5.25 (A11), IC6.25 (A11), IC7.25 (A11), IC11.25 (A11), IC12.25 (A11), IC13.25 (A11), IC14.25 (A11), J1.A28
ABUS12: J1.C29
ABUS13: J1.A29
ABUS14: J1.C30
ABUS15: J1.A30
DBUS0: IC1.2 (A1), J1.C3
DBUS1: IC1.3 (A2), J1.C4
DBUS2: IC1.4 (A3), J1.C5
DBUS3: IC1.5 (A4), J1.C6
DBUS4: IC1.6 (A5), J1.C7
DBUS5: IC1.7 (A6), J1.C8
DBUS6: IC1.8 (A7), J1.C9
DBUS7: IC1.9 (A8), J1.C10
GND: C1.2, C2.2, C3.2, C4.2, C5.2, C6.2, C7.2, C8.2, C9.2, C10.2, C11.2, C12.2, C13.2, C14.2, C15.-, IC1.10 (GND), IC2.3 (I), IC2.5 (I), IC2.7 (GND), IC2.9 (I), IC2.11 (I), IC2.13 (I), IC3.16 (VSS), IC4.16 (VSS), IC5.16 (VSS), IC6.16 (VSS), IC7.16 (GND), IC8.8 (GND), IC8.13 (B), IC8.14 (A), IC8.15 (G), IC9.7 (GND), IC9.9 (I0), IC9.10 (I1), IC9.12 (I0), IC9.13 (I1), IC10.4 (G2A), IC10.5 (G2B), IC10.8 (GND), IC11.16 (VSS), IC12.16 (VSS), IC13.16 (VSS), IC14.16 (VSS), J1.A1, J1.A2, J1.C1, J1.C2
IDBUS0: IC1.18 (B1), IC3.13 (I/O00), IC4.13 (I/O00), IC5.13 (I/O00), IC6.13 (I/O00), IC7.13 (O0), IC11.13 (I/O00), IC12.13 (I/O00), IC13.13 (I/O00), IC14.13 (I/O00), RN1.2
IDBUS1: IC1.17 (B2), IC3.14 (I/O01), IC4.14 (I/O01), IC5.14 (I/O01), IC6.14 (I/O01), IC7.14 (O1), IC11.14 (I/O01), IC12.14 (I/O01), IC13.14 (I/O01), IC14.14 (I/O01), RN1.3
IDBUS2: IC1.16 (B3), IC3.15 (I/O02), IC4.15 (I/O02), IC5.15 (I/O02), IC6.15 (I/O02), IC7.15 (O2), IC11.15 (I/O02), IC12.15 (I/O02), IC13.15 (I/O02), IC14.15 (I/O02), RN1.4
IDBUS3: IC1.15 (B4), IC3.17 (I/O03), IC4.17 (I/O03), IC5.17 (I/O03), IC6.17 (I/O03), IC7.17 (O3), IC11.17 (I/O03), IC12.17 (I/O03), IC13.17 (I/O03), IC14.17 (I/O03), RN1.5
IDBUS4: IC1.14 (B5), IC3.18 (I/O04), IC4.18 (I/O04), IC5.18 (I/O04), IC6.18 (I/O04), IC7.18 (O4), IC11.18 (I/O04), IC12.18 (I/O04), IC13.18 (I/O04), IC14.18 (I/O04), RN1.6
IDBUS5: IC1.13 (B6), IC3.19 (I/O05), IC4.19 (I/O05), IC5.19 (I/O05), IC6.19 (I/O05), IC7.19 (O5), IC11.19 (I/O05), IC12.19 (I/O05), IC13.19 (I/O05), IC14.19 (I/O05), RN1.7
IDBUS6: IC1.12 (B7), IC3.20 (I/O06), IC4.20 (I/O06), IC5.20 (I/O06), IC6.20 (I/O06), IC7.20 (O6), IC11.20 (I/O06), IC12.20 (I/O06), IC13.20 (I/O06), IC14.20 (I/O06), RN1.8
IDBUS7: IC1.11 (B8), IC3.21 (I/O07), IC4.21 (I/O07), IC5.21 (I/O07), IC6.21 (I/O07), IC7.21 (O7), IC11.21 (I/O07), IC12.21 (I/O07), IC13.21 (I/O07), IC14.21 (I/O07), RN1.9
unnamed: IC1.19 (G), IC2.2 (O)
unnamed: IC8.1 (G), IC10.15 (Y0)
unnamed: IC8.5 (Y1), IC9.1 (I0)
unnamed: IC8.6 (Y2), IC9.2 (I1)
unnamed: IC7.22 (!CE), IC8.4 (Y0)
unnamed: IC8.7 (Y3), IC9.5 (I1)
unnamed: IC9.3 (O), IC9.4 (I0)
PABUS12: IC3.4 (A12), IC4.4 (A12), IC5.4 (A12), IC6.4 (A12), IC7.4 (A12), IC11.4 (A12), IC12.4 (A12), IC13.4 (A12), IC14.4 (A12), J1.C15
PABUS13: IC3.28 (A13), IC4.28 (A13), IC5.28 (A13), IC6.28 (A13), IC7.28 (A13), IC11.28 (A13), IC12.28 (A13), IC13.28 (A13), IC14.28 (A13), J1.A15
PABUS14: IC3.3 (A14), IC4.3 (A14), IC5.3 (A14), IC6.3 (A14), IC7.29 (A14), IC11.3 (A14), IC12.3 (A14), IC13.3 (A14), IC14.3 (A14), J1.C16
PABUS15: IC3.31 (A15), IC4.31 (A15), IC5.31 (A15), IC6.31 (A15), IC7.3 (A15), IC11.31 (A15), IC12.31 (A15), IC13.31 (A15), IC14.31 (A15), J1.A16
PABUS16: IC3.2 (A16), IC4.2 (A16), IC5.2 (A16), IC6.2 (A16), IC7.2 (A16), IC11.2 (A16), IC12.2 (A16), IC13.2 (A16), IC14.2 (A16), J1.C17
PABUS17: IC3.30 (A17), IC4.30 (A17), IC5.30 (A17), IC6.30 (A17), IC8.2 (A), IC11.30 (A17), IC12.30 (A17), IC13.30 (A17), IC14.30 (A17), J1.A17
PABUS18: IC3.1 (A18), IC4.1 (A18), IC5.1 (A18), IC6.1 (A18), IC8.3 (B), IC11.1 (A18), IC12.1 (A18), IC13.1 (A18), IC14.1 (A18), J1.C18
PABUS19: IC10.1 (A), J1.A18
PABUS20: IC10.2 (B), J1.C19
PABUS21: IC10.3 (C), J1.A19

Notes on the sheet:
Memory (ROM & RAM)
Dawid Pilawa
(C) 2010-2016
MEM.1
2.0

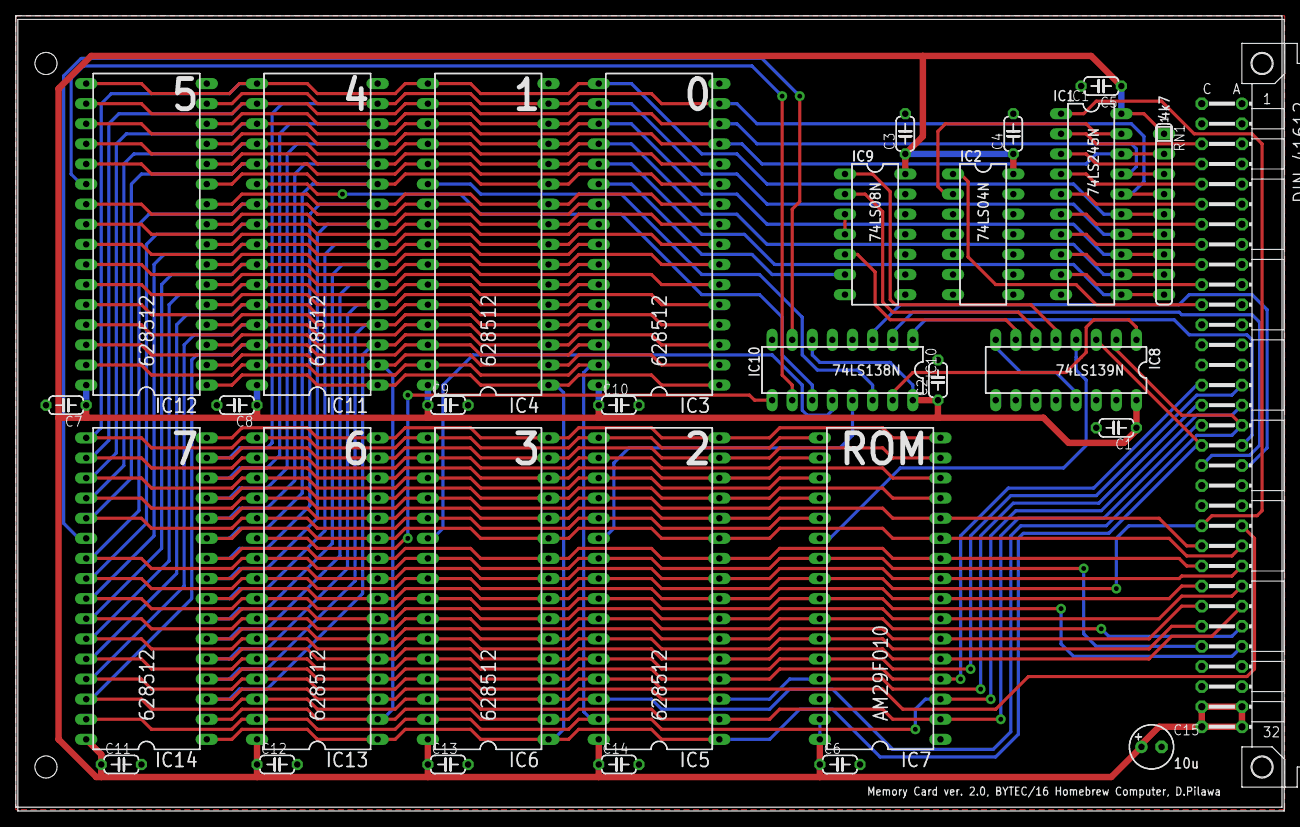
[picture p97: board memory.brd from above]

Board: 2 copper layers, 160.0 x 100.0 mm, 31 parts (0 on the bottom side), 58 nets.
