dpilawa/bytec/eagle/3_cpu_control.brd

## EAGLE design eagle/3_cpu_control.brd (2016-02-10)

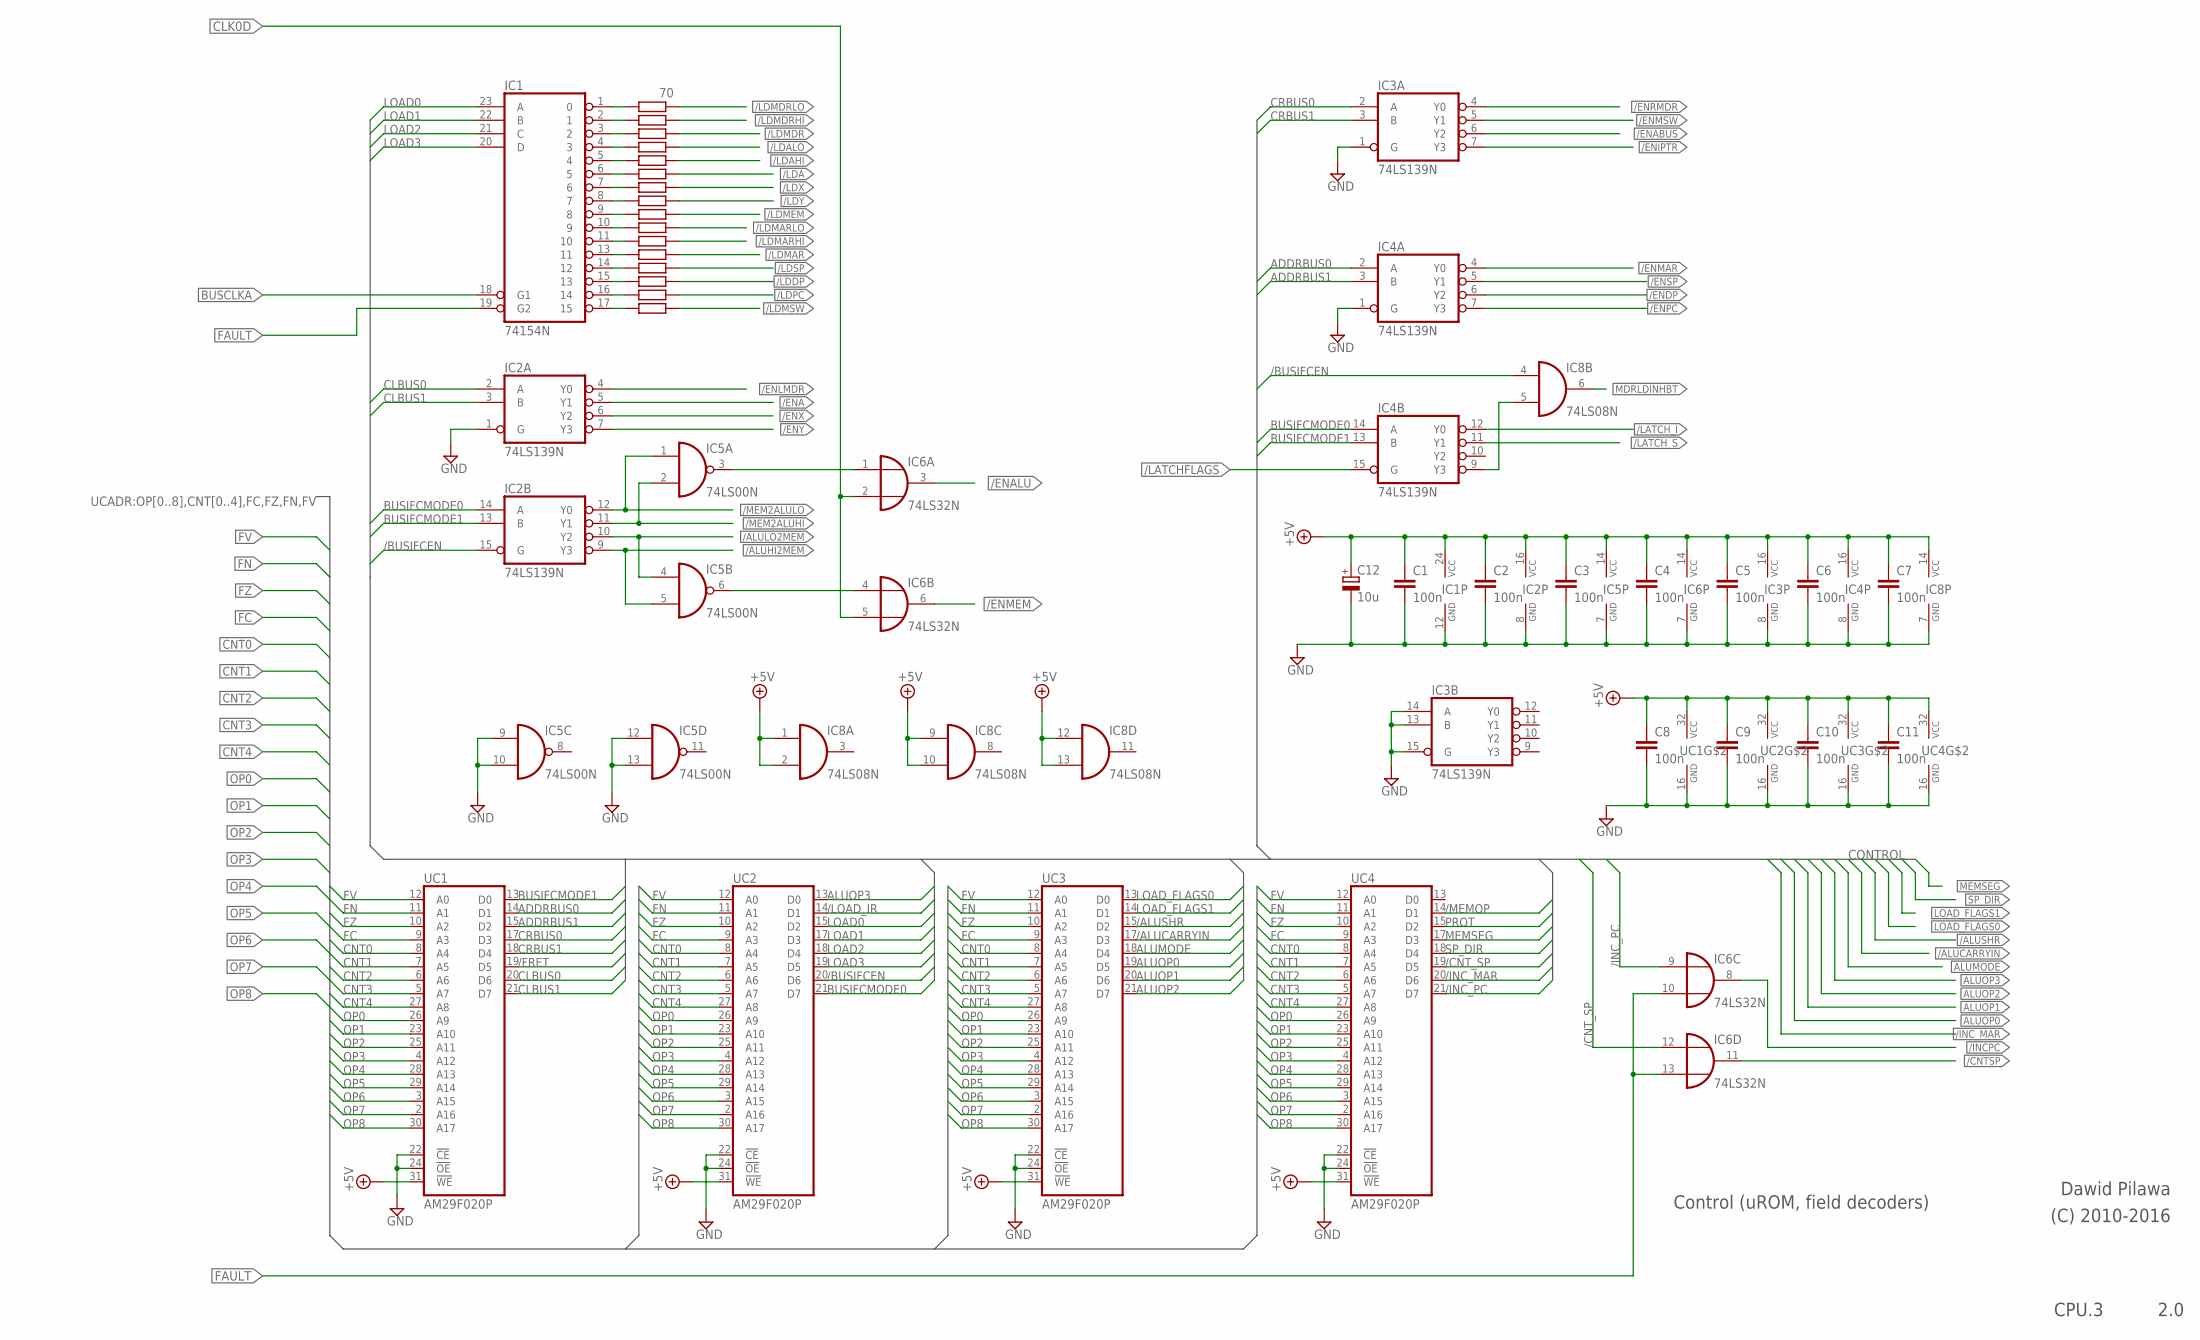
[picture p98: schematic 3_cpu_control.sch, sheet 1]

Parts:
C1, C2, C3, C4, C5, C6, C7, C8, C9, C10, C11: 100n; C050-024X044
C12: 10u; E5-6
IC1: 74154N; DIL24-6
IC2, IC3, IC4: 74LS139N; DIL16
IC5: 74LS00N; DIL14
IC6: 74LS32N; DIL14
IC8: 74LS08N; DIL14
R1: 70; 0204/7
R2, R3, R4, R5, R6, R7, R8, R9, R10, R11, R12, R13, R14, R15, R16: R-EU_0204/7; 0204/7
UC1, UC2, UC3, UC4: AM29F020P; DIL32-6

Connections:
+5V: C1.1, C2.1, C3.1, C4.1, C5.1, C6.1, C7.1, C8.1, C9.1, C10.1, C11.1, C12.+, IC1.24 (VCC), IC2.16 (VCC), IC3.16 (VCC), IC4.16 (VCC), IC5.14 (VCC), IC6.14 (VCC), IC8.1 (I0), IC8.2 (I1), IC8.9 (I0), IC8.10 (I1), IC8.12 (I0), IC8.13 (I1), IC8.14 (VCC), UC1.31 (!WE), UC1.32 (AVCC), UC2.31 (!WE), UC2.32 (AVCC), UC3.31 (!WE), UC3.32 (AVCC), UC4.31 (!WE), UC4.32 (AVCC); also elsewhere on the board
/ALUCARRYIN: UC3.17 (D3); also elsewhere on the board
/ALUHI2MEM: IC2.9 (Y3), IC5.5 (I1); also elsewhere on the board
/ALULO2MEM: IC2.10 (Y2), IC5.4 (I0); also elsewhere on the board
/ALUSHR: UC3.15 (D2); also elsewhere on the board
/BUSIFCEN: IC2.15 (G), IC8.4 (I0), UC2.20 (D6); also elsewhere on the board
/CNTSP: IC6.11 (O); also elsewhere on the board
/CNT_SP: IC6.12 (I0), UC4.19 (D5)
/ENA: IC2.5 (Y1); also elsewhere on the board
/ENABUS: IC3.6 (Y2); also elsewhere on the board
/ENALU: IC6.3 (O); also elsewhere on the board
/ENDP: IC4.6 (Y2); also elsewhere on the board
/ENIPTR: IC3.7 (Y3); also elsewhere on the board
/ENLMDR: IC2.4 (Y0); also elsewhere on the board
/ENMAR: IC4.4 (Y0); also elsewhere on the board
/ENMEM: IC6.6 (O); also elsewhere on the board
/ENMSW: IC3.5 (Y1); also elsewhere on the board
/ENPC: IC4.7 (Y3); also elsewhere on the board
/ENRMDR: IC3.4 (Y0); also elsewhere on the board
/ENSP: IC4.5 (Y1); also elsewhere on the board
/ENX: IC2.6 (Y2); also elsewhere on the board
/ENY: IC2.7 (Y3); also elsewhere on the board
/FRET: UC1.19 (D5); also elsewhere on the board
/INCPC: IC6.8 (O); also elsewhere on the board
/INC_MAR: UC4.20 (D6); also elsewhere on the board
/INC_PC: IC6.9 (I0), UC4.21 (D7)
/LATCHFLAGS: IC4.15 (G); also elsewhere on the board
/LATCH_I: IC4.12 (Y0); also elsewhere on the board
/LATCH_NONE: IC4.9 (Y3), IC8.5 (I1)
/LATCH_S: IC4.11 (Y1); also elsewhere on the board
/LDA: R6.2; also elsewhere on the board
/LDAHI: R5.2; also elsewhere on the board
/LDALO: R4.2; also elsewhere on the board
/LDDP: R14.2; also elsewhere on the board
/LDMAR: R12.2; also elsewhere on the board
/LDMARHI: R11.2; also elsewhere on the board
/LDMARLO: R10.2; also elsewhere on the board
/LDMDR: R3.2; also elsewhere on the board
/LDMDRHI: R2.2; also elsewhere on the board
/LDMDRLO: R1.2; also elsewhere on the board
/LDMEM: R9.2; also elsewhere on the board
/LDMSW: R16.2; also elsewhere on the board
/LDPC: R15.2; also elsewhere on the board
/LDSP: R13.2; also elsewhere on the board
/LDX: R7.2; also elsewhere on the board
/LDY: R8.2; also elsewhere on the board
/LOAD_IR: UC2.14 (D1); also elsewhere on the board
/MEM2ALUHI: IC2.11 (Y1), IC5.2 (I1); also elsewhere on the board
/MEM2ALULO: IC2.12 (Y0), IC5.1 (I0); also elsewhere on the board
/MEMOP: UC4.14 (D1); also elsewhere on the board
ADDRBUS0: IC4.2 (A), UC1.14 (D1)
ADDRBUS1: IC4.3 (B), UC1.15 (D2)
ALUMODE: UC3.18 (D4); also elsewhere on the board
ALUOP0: UC3.19 (D5); also elsewhere on the board
ALUOP1: UC3.20 (D6); also elsewhere on the board
ALUOP2: UC3.21 (D7); also elsewhere on the board
ALUOP3: UC2.13 (D0); also elsewhere on the board
BUSCLKA: IC1.18 (G1); also elsewhere on the board
BUSIFCMODE0: IC2.14 (A), IC4.14 (A), UC2.21 (D7)
BUSIFCMODE1: IC2.13 (B), IC4.13 (B), UC1.13 (D0)
CLBUS0: IC2.2 (A), UC1.20 (D6)
CLBUS1: IC2.3 (B), UC1.21 (D7)
CLK0D: IC6.2 (I1), IC6.5 (I1); also elsewhere on the board
CNT0: UC1.8 (A4), UC2.8 (A4), UC3.8 (A4), UC4.8 (A4); also elsewhere on the board
CNT1: UC1.7 (A5), UC2.7 (A5), UC3.7 (A5), UC4.7 (A5); also elsewhere on the board
CNT2: UC1.6 (A6), UC2.6 (A6), UC3.6 (A6), UC4.6 (A6); also elsewhere on the board
CNT3: UC1.5 (A7), UC2.5 (A7), UC3.5 (A7), UC4.5 (A7); also elsewhere on the board
CNT4: UC1.27 (A8), UC2.27 (A8), UC3.27 (A8), UC4.27 (A8); also elsewhere on the board
CRBUS0: IC3.2 (A), UC1.17 (D3)
CRBUS1: IC3.3 (B), UC1.18 (D4)
FAULT: IC1.19 (G2), IC6.10 (I1), IC6.13 (I1); also elsewhere on the board
FC: UC1.9 (A3), UC2.9 (A3), UC3.9 (A3), UC4.9 (A3); also elsewhere on the board
FN: UC1.11 (A1), UC2.11 (A1), UC3.11 (A1), UC4.11 (A1); also elsewhere on the board
FV: UC1.12 (A0), UC2.12 (A0), UC3.12 (A0), UC4.12 (A0); also elsewhere on the board
FZ: UC1.10 (A2), UC2.10 (A2), UC3.10 (A2), UC4.10 (A2); also elsewhere on the board
GND: C1.2, C2.2, C3.2, C4.2, C5.2, C6.2, C7.2, C8.2, C9.2, C10.2, C11.2, C12.-, IC1.12 (GND), IC2.1 (G), IC2.8 (GND), IC3.1 (G), IC3.8 (GND), IC3.13 (B), IC3.14 (A), IC3.15 (G), IC4.1 (G), IC4.8 (GND), IC5.7 (GND), IC5.9 (I0), IC5.10 (I1), IC5.12 (I0), IC5.13 (I1), IC6.7 (GND), IC8.7 (GND), UC1.16 (AGND), UC1.22 (!CE), UC1.24 (!OE), UC2.16 (AGND), UC2.22 (!CE), UC2.24 (!OE), UC3.16 (AGND), UC3.22 (!CE), UC3.24 (!OE), UC4.16 (AGND), UC4.22 (!CE), UC4.24 (!OE); also elsewhere on the board
LOAD0: IC1.23 (A), UC2.15 (D2)
LOAD1: IC1.22 (B), UC2.17 (D3)
LOAD2: IC1.21 (C), UC2.18 (D4)
LOAD3: IC1.20 (D), UC2.19 (D5)
LOAD_FLAGS0: UC3.13 (D0); also elsewhere on the board
LOAD_FLAGS1: UC3.14 (D1); also elsewhere on the board
MDRLDINHBT: IC8.6 (O); also elsewhere on the board
MEMSEG: UC4.17 (D3); also elsewhere on the board
unnamed: IC1.16 (14), R15.1
unnamed: IC5.3 (O), IC6.1 (I0)
unnamed: IC5.6 (O), IC6.4 (I0)
unnamed: IC1.1 (0), R1.1
unnamed: IC1.2 (1), R2.1
unnamed: IC1.3 (2), R3.1
unnamed: IC1.4 (3), R4.1
unnamed: IC1.5 (4), R5.1
unnamed: IC1.6 (5), R6.1
unnamed: IC1.7 (6), R7.1
unnamed: IC1.8 (7), R8.1
unnamed: IC1.9 (8), R9.1
unnamed: IC1.10 (9), R10.1
unnamed: IC1.11 (10), R11.1
unnamed: IC1.13 (11), R12.1
unnamed: IC1.14 (12), R13.1
unnamed: IC1.15 (13), R14.1
unnamed: IC1.17 (15), R16.1
OP0: UC1.26 (A9), UC2.26 (A9), UC3.26 (A9), UC4.26 (A9); also elsewhere on the board
OP1: UC1.23 (A10), UC2.23 (A10), UC3.23 (A10), UC4.23 (A10); also elsewhere on the board
OP2: UC1.25 (A11), UC2.25 (A11), UC3.25 (A11), UC4.25 (A11); also elsewhere on the board
OP3: UC1.4 (A12), UC2.4 (A12), UC3.4 (A12), UC4.4 (A12); also elsewhere on the board
OP4: UC1.28 (A13), UC2.28 (A13), UC3.28 (A13), UC4.28 (A13); also elsewhere on the board
OP5: UC1.29 (A14), UC2.29 (A14), UC3.29 (A14), UC4.29 (A14); also elsewhere on the board
OP6: UC1.3 (A15), UC2.3 (A15), UC3.3 (A15), UC4.3 (A15); also elsewhere on the board
OP7: UC1.2 (A16), UC2.2 (A16), UC3.2 (A16), UC4.2 (A16); also elsewhere on the board
OP8: UC1.30 (A17), UC2.30 (A17), UC3.30 (A17), UC4.30 (A17); also elsewhere on the board
PROT: UC4.15 (D2); also elsewhere on the board
SP_DIR: UC4.18 (D4); also elsewhere on the board

Notes on the sheet:
Control (uROM, field decoders)
2.0
Dawid Pilawa
(C) 2010-2016
CPU.3
CONTROL
