dpilawa/bytec/eagle/3_cpu_control.brd

## EAGLE design eagle/3_cpu_control.brd (continued)

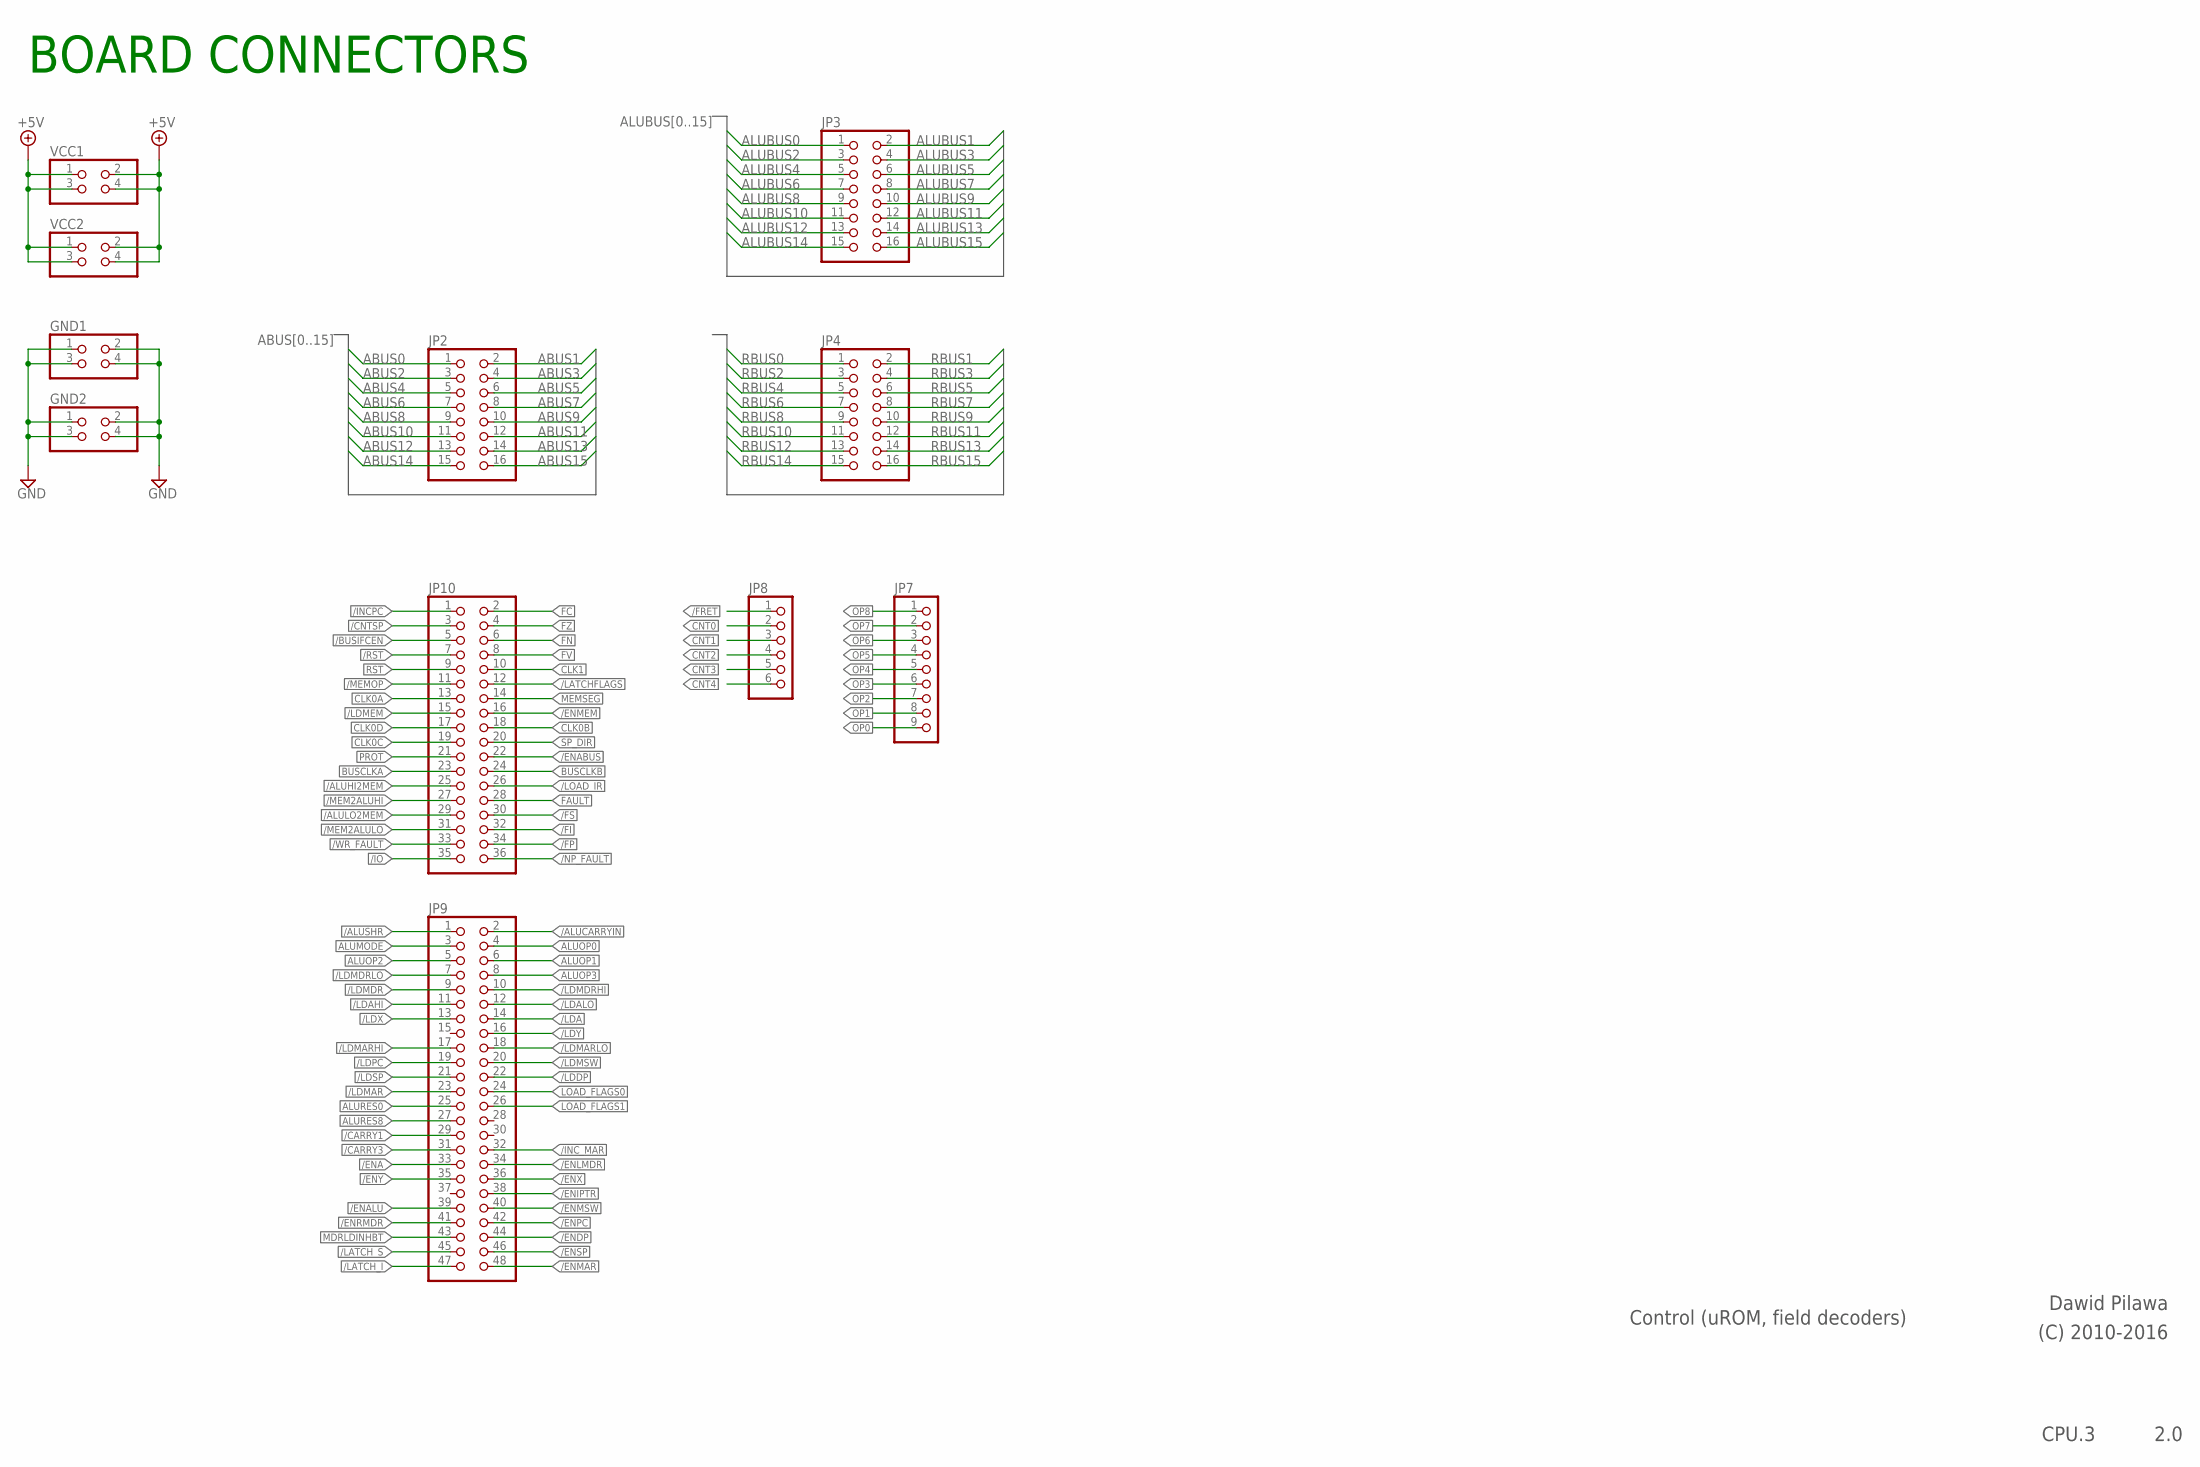
[picture p99: schematic 3_cpu_control.sch, sheet 2]

Parts:
GND1, GND2: PINHD-2X2; 2X02
JP2, JP3, JP4: PINHD-2X8; 2X08
JP7: PINHD-1X9; 1X09
JP8: PINHD-1X6; 1X06
JP9: PINHD-2X24; 2X24
JP10: PINHD-2X18; 2X18
VCC1, VCC2: PINHD-2X2; 2X02

Connections:
+5V: VCC1.1, VCC1.2, VCC1.3, VCC1.4, VCC2.1, VCC2.2, VCC2.3, VCC2.4; also elsewhere on the board
/ALUCARRYIN: JP9.2; also elsewhere on the board
/ALUHI2MEM: JP10.25; also elsewhere on the board
/ALULO2MEM: JP10.29; also elsewhere on the board
/ALUSHR: JP9.1; also elsewhere on the board
/BUSIFCEN: JP10.5; also elsewhere on the board
/CARRY1: JP9.29
/CARRY3: JP9.31
/CNTSP: JP10.3; also elsewhere on the board
/ENA: JP9.33; also elsewhere on the board
/ENABUS: JP10.22; also elsewhere on the board
/ENALU: JP9.39; also elsewhere on the board
/ENDP: JP9.44; also elsewhere on the board
/ENIPTR: JP9.38; also elsewhere on the board
/ENLMDR: JP9.34; also elsewhere on the board
/ENMAR: JP9.48; also elsewhere on the board
/ENMEM: JP10.16; also elsewhere on the board
/ENMSW: JP9.40; also elsewhere on the board
/ENPC: JP9.42; also elsewhere on the board
/ENRMDR: JP9.41; also elsewhere on the board
/ENSP: JP9.46; also elsewhere on the board
/ENX: JP9.36; also elsewhere on the board
/ENY: JP9.35; also elsewhere on the board
/FI: JP10.32
/FP: JP10.34
/FRET: JP8.1; also elsewhere on the board
/FS: JP10.30
/INCPC: JP10.1; also elsewhere on the board
/INC_MAR: JP9.32; also elsewhere on the board
/IO: JP10.35
/LATCHFLAGS: JP10.12; also elsewhere on the board
/LATCH_I: JP9.47; also elsewhere on the board
/LATCH_S: JP9.45; also elsewhere on the board
/LDA: JP9.14; also elsewhere on the board
/LDAHI: JP9.11; also elsewhere on the board
/LDALO: JP9.12; also elsewhere on the board
/LDDP: JP9.22; also elsewhere on the board
/LDMAR: JP9.23; also elsewhere on the board
/LDMARHI: JP9.17; also elsewhere on the board
/LDMARLO: JP9.18; also elsewhere on the board
/LDMDR: JP9.9; also elsewhere on the board
/LDMDRHI: JP9.10; also elsewhere on the board
/LDMDRLO: JP9.7; also elsewhere on the board
/LDMEM: JP10.15; also elsewhere on the board
/LDMSW: JP9.20; also elsewhere on the board
/LDPC: JP9.19; also elsewhere on the board
/LDSP: JP9.21; also elsewhere on the board
/LDX: JP9.13; also elsewhere on the board
/LDY: JP9.16; also elsewhere on the board
/LOAD_IR: JP10.26; also elsewhere on the board
/MEM2ALUHI: JP10.27; also elsewhere on the board
/MEM2ALULO: JP10.31; also elsewhere on the board
/MEMOP: JP10.11; also elsewhere on the board
/NP_FAULT: JP10.36
/RST: JP10.7
/WR_FAULT: JP10.33
ABUS0: JP2.1
ABUS1: JP2.2
ABUS2: JP2.3
ABUS3: JP2.4
ABUS4: JP2.5
ABUS5: JP2.6
ABUS6: JP2.7
ABUS7: JP2.8
ABUS8: JP2.9
ABUS9: JP2.10
ABUS10: JP2.11
ABUS11: JP2.12
ABUS12: JP2.13
ABUS13: JP2.14
ABUS14: JP2.15
ABUS15: JP2.16
ALUBUS0: JP3.1
ALUBUS1: JP3.2
ALUBUS2: JP3.3
ALUBUS3: JP3.4
ALUBUS4: JP3.5
ALUBUS5: JP3.6
ALUBUS6: JP3.7
ALUBUS7: JP3.8
ALUBUS8: JP3.9
ALUBUS9: JP3.10
ALUBUS10: JP3.11
ALUBUS11: JP3.12
ALUBUS12: JP3.13
ALUBUS13: JP3.14
ALUBUS14: JP3.15
ALUBUS15: JP3.16
ALUMODE: JP9.3; also elsewhere on the board
ALUOP0: JP9.4; also elsewhere on the board
ALUOP1: JP9.6; also elsewhere on the board
ALUOP2: JP9.5; also elsewhere on the board
ALUOP3: JP9.8; also elsewhere on the board
ALURES0: JP9.25
ALURES8: JP9.27
BUSCLKA: JP10.23; also elsewhere on the board
BUSCLKB: JP10.24
CLK0A: JP10.13
CLK0B: JP10.18
CLK0C: JP10.19
CLK0D: JP10.17; also elsewhere on the board
CLK1: JP10.10
CNT0: JP8.2; also elsewhere on the board
CNT1: JP8.3; also elsewhere on the board
CNT2: JP8.4; also elsewhere on the board
CNT3: JP8.5; also elsewhere on the board
CNT4: JP8.6; also elsewhere on the board
FAULT: JP10.28; also elsewhere on the board
FC: JP10.2; also elsewhere on the board
FN: JP10.6; also elsewhere on the board
FV: JP10.8; also elsewhere on the board
FZ: JP10.4; also elsewhere on the board
GND: GND1.1, GND1.2, GND1.3, GND1.4, GND2.1, GND2.2, GND2.3, GND2.4; also elsewhere on the board
LOAD_FLAGS0: JP9.24; also elsewhere on the board
LOAD_FLAGS1: JP9.26; also elsewhere on the board
MDRLDINHBT: JP9.43; also elsewhere on the board
MEMSEG: JP10.14; also elsewhere on the board
OP0: JP7.9; also elsewhere on the board
OP1: JP7.8; also elsewhere on the board
OP2: JP7.7; also elsewhere on the board
OP3: JP7.6; also elsewhere on the board
OP4: JP7.5; also elsewhere on the board
OP5: JP7.4; also elsewhere on the board
OP6: JP7.3; also elsewhere on the board
OP7: JP7.2; also elsewhere on the board
OP8: JP7.1; also elsewhere on the board
PROT: JP10.21; also elsewhere on the board
RBUS0: JP4.1
RBUS1: JP4.2
RBUS2: JP4.3
RBUS3: JP4.4
RBUS4: JP4.5
RBUS5: JP4.6
RBUS6: JP4.7
RBUS7: JP4.8
RBUS8: JP4.9
RBUS9: JP4.10
RBUS10: JP4.11
RBUS11: JP4.12
RBUS12: JP4.13
RBUS13: JP4.14
RBUS14: JP4.15
RBUS15: JP4.16
RST: JP10.9
SP_DIR: JP10.20; also elsewhere on the board

Notes on the sheet:
Control (uROM, field decoders)
2.0
Dawid Pilawa
(C) 2010-2016
CPU.3
BOARD CONNECTORS

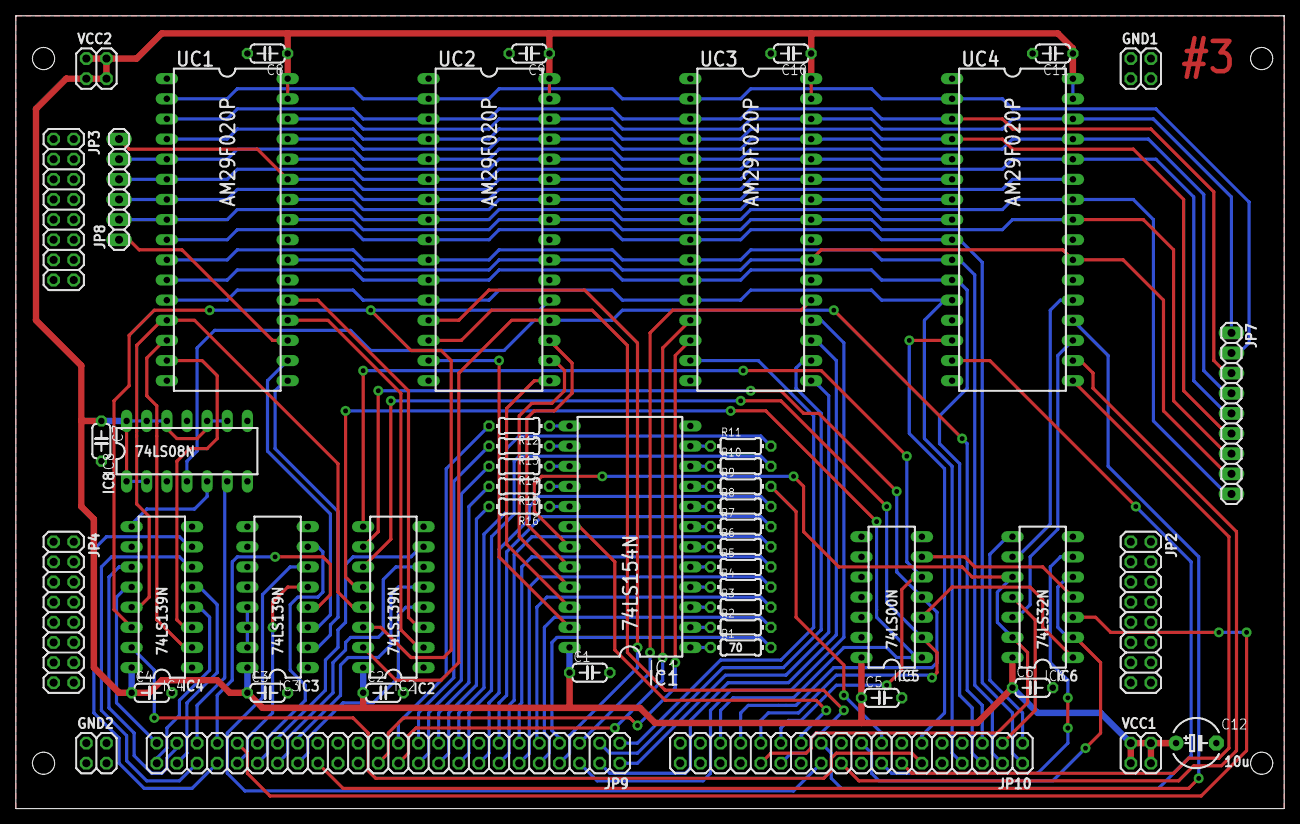
[picture p100: board 3_cpu_control.brd from above]

Board: 2 copper layers, 160.0 x 100.0 mm, 50 parts (0 on the bottom side), 113 nets.
