dpilawa/bytec/eagle/2_cpu_control.brd

## EAGLE design eagle/2_cpu_control.brd (2016-02-10)

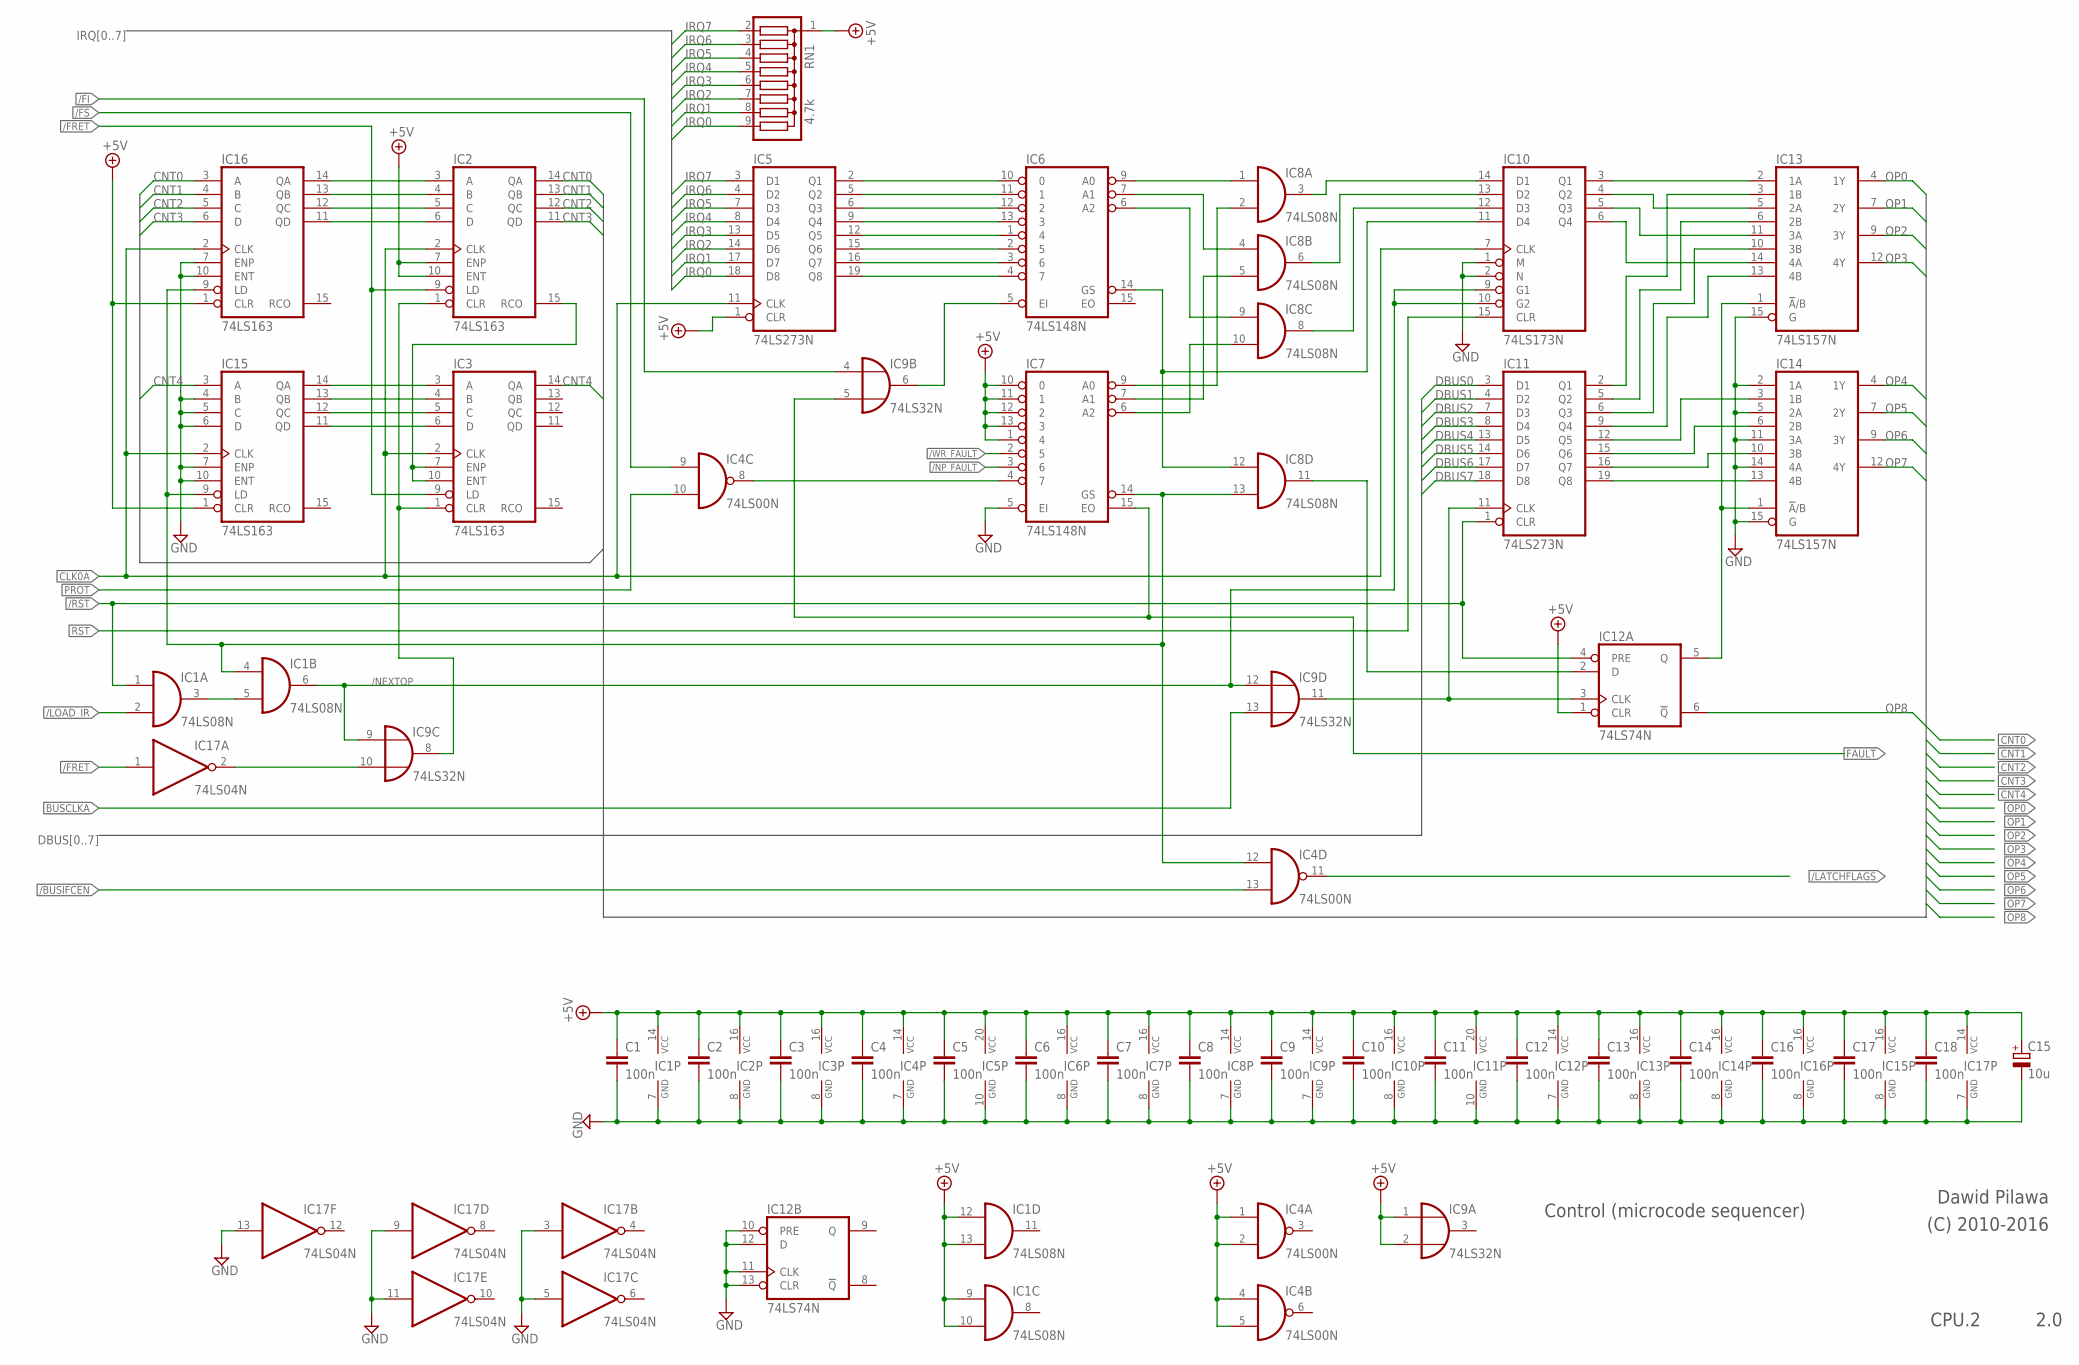
[picture p101: schematic 2_cpu_control.sch, sheet 1]

Parts:
C1, C2, C3, C4, C5, C6, C7, C8, C9, C10, C11, C12, C13, C14, C16, C17, C18: 100n; C050-024X044
C15: 10u; E5-6
IC1, IC8: 74LS08N; DIL14
IC2, IC3, IC15, IC16: 74LS163; DIL16
IC4: 74LS00N; DIL14
IC5, IC11: 74LS273N; DIL20
IC6, IC7: 74LS148N; DIL16
IC9: 74LS32N; DIL14
IC10: 74LS173N; DIL16
IC12: 74LS74N; DIL14
IC13, IC14: 74LS157N; DIL16
IC17: 74LS04N; DIL14
RN1: 4.7k; SIL9

Connections:
+5V: C1.1, C2.1, C3.1, C4.1, C5.1, C6.1, C7.1, C8.1, C9.1, C10.1, C11.1, C12.1, C13.1, C14.1, C15.+, C16.1, C17.1, C18.1, IC1.9 (I0), IC1.10 (I1), IC1.12 (I0), IC1.13 (I1), IC1.14 (VCC), IC2.7 (ENP), IC2.10 (ENT), IC2.16 (VCC), IC3.16 (VCC), IC4.1 (I0), IC4.2 (I1), IC4.4 (I0), IC4.5 (I1), IC4.14 (VCC), IC5.1 (CLR), IC5.20 (VCC), IC6.16 (VCC), IC7.1 (4), IC7.10 (0), IC7.11 (1), IC7.12 (2), IC7.13 (3), IC7.16 (VCC), IC8.14 (VCC), IC9.1 (I0), IC9.2 (I1), IC9.14 (VCC), IC10.16 (VCC), IC11.20 (VCC), IC12.1 (CLR), IC12.14 (VCC), IC13.16 (VCC), IC14.16 (VCC), IC15.1 (CLR), IC15.16 (VCC), IC16.1 (CLR), IC16.16 (VCC), IC17.14 (VCC), RN1.1; also elsewhere on the board
/BUSIFCEN: IC4.13 (I1); also elsewhere on the board
/FAULT_PF: IC4.8 (O), IC7.4 (7)
/FI: IC9.4 (I0); also elsewhere on the board
/FRET: IC2.9 (LD), IC3.9 (LD), IC17.1 (I); also elsewhere on the board
/FS: IC4.9 (I0); also elsewhere on the board
/LATCHFLAGS: IC4.11 (O); also elsewhere on the board
/LOAD_IR: IC1.2 (I1); also elsewhere on the board
/NEXTOP: IC1.6 (O), IC9.9 (I0), IC9.12 (I0), IC10.9 (G1), IC10.10 (G2)
/NP_FAULT: IC7.3 (6); also elsewhere on the board
/RST: IC1.1 (I0), IC11.1 (CLR), IC12.4 (PRE); also elsewhere on the board
/WR_FAULT: IC7.2 (5); also elsewhere on the board
BUSCLKA: IC9.13 (I1); also elsewhere on the board
CLK0A: IC2.2 (CLK), IC3.2 (CLK), IC5.11 (CLK), IC10.7 (CLK), IC15.2 (CLK), IC16.2 (CLK); also elsewhere on the board
CNT0: IC2.14 (QA), IC16.3 (A); also elsewhere on the board
CNT1: IC2.13 (QB), IC16.4 (B); also elsewhere on the board
CNT2: IC2.12 (QC), IC16.5 (C); also elsewhere on the board
CNT3: IC2.11 (QD), IC16.6 (D); also elsewhere on the board
CNT4: IC3.14 (QA), IC15.3 (A); also elsewhere on the board
DBUS0: IC11.3 (D1); also elsewhere on the board
DBUS1: IC11.4 (D2); also elsewhere on the board
DBUS2: IC11.7 (D3); also elsewhere on the board
DBUS3: IC11.8 (D4); also elsewhere on the board
DBUS4: IC11.13 (D5); also elsewhere on the board
DBUS5: IC11.14 (D6); also elsewhere on the board
DBUS6: IC11.17 (D7); also elsewhere on the board
DBUS7: IC11.18 (D8); also elsewhere on the board
FAULT: IC7.15 (EO), IC9.5 (I1); also elsewhere on the board
GND: C1.2, C2.2, C3.2, C4.2, C5.2, C6.2, C7.2, C8.2, C9.2, C10.2, C11.2, C12.2, C13.2, C14.2, C15.-, C16.2, C17.2, C18.2, IC1.7 (GND), IC2.8 (GND), IC3.8 (GND), IC4.7 (GND), IC5.10 (GND), IC6.8 (GND), IC7.5 (EI), IC7.8 (GND), IC8.7 (GND), IC9.7 (GND), IC10.1 (M), IC10.2 (N), IC10.8 (GND), IC11.10 (GND), IC12.7 (GND), IC12.10 (PRE), IC12.11 (CLK), IC12.12 (D), IC12.13 (CLR), IC13.8 (GND), IC13.15 (G), IC14.2 (1A), IC14.5 (2A), IC14.8 (GND), IC14.11 (3A), IC14.14 (4A), IC14.15 (G), IC15.4 (B), IC15.5 (C), IC15.6 (D), IC15.7 (ENP), IC15.8 (GND), IC15.10 (ENT), IC16.7 (ENP), IC16.8 (GND), IC16.10 (ENT), IC17.3 (I), IC17.5 (I), IC17.7 (GND), IC17.9 (I), IC17.11 (I), IC17.13 (I); also elsewhere on the board
IRQ0: IC5.18 (D8), RN1.9; also elsewhere on the board
IRQ1: IC5.17 (D7), RN1.8; also elsewhere on the board
IRQ2: IC5.14 (D6), RN1.7; also elsewhere on the board
IRQ3: IC5.13 (D5), RN1.6; also elsewhere on the board
IRQ4: IC5.8 (D4), RN1.5; also elsewhere on the board
IRQ5: IC5.7 (D3), RN1.4; also elsewhere on the board
IRQ6: IC5.4 (D2), RN1.3; also elsewhere on the board
IRQ7: IC5.3 (D1), RN1.2; also elsewhere on the board
unnamed: IC6.9 (A0), IC8.1 (I0)
unnamed: IC2.15 (RCO), IC3.7 (ENP), IC3.10 (ENT)
unnamed: IC7.9 (A0), IC8.2 (I1)
unnamed: IC6.7 (A1), IC8.4 (I0)
unnamed: IC7.7 (A1), IC8.5 (I1)
unnamed: IC7.6 (A2), IC8.10 (I1)
unnamed: IC6.6 (A2), IC8.9 (I0)
unnamed: IC1.3 (O), IC1.5 (I1)
unnamed: IC6.14 (GS), IC8.12 (I0), IC10.11 (D4)
unnamed: IC1.4 (I0), IC4.12 (I0), IC7.14 (GS), IC8.13 (I1), IC15.9 (LD), IC16.9 (LD)
unnamed: IC8.3 (O), IC10.14 (D1)
unnamed: IC8.6 (O), IC10.13 (D2)
unnamed: IC8.8 (O), IC10.12 (D3)
unnamed: IC8.11 (O), IC12.2 (D)
unnamed: IC9.10 (I1), IC17.2 (O)
unnamed: IC11.5 (Q2), IC13.6 (2B)
unnamed: IC9.11 (O), IC11.11 (CLK), IC12.3 (CLK)
unnamed: IC10.3 (Q1), IC13.2 (1A)
unnamed: IC10.4 (Q2), IC13.5 (2A)
unnamed: IC10.5 (Q3), IC13.11 (3A)
unnamed: IC10.6 (Q4), IC13.14 (4A)
unnamed: IC11.19 (Q8), IC14.13 (4B)
unnamed: IC11.16 (Q7), IC14.10 (3B)
unnamed: IC11.15 (Q6), IC14.6 (2B)
unnamed: IC11.12 (Q5), IC14.3 (1B)
unnamed: IC11.2 (Q1), IC13.3 (1B)
unnamed: IC6.5 (EI), IC9.6 (O)
unnamed: IC11.6 (Q3), IC13.10 (3B)
unnamed: IC3.5 (C), IC15.12 (QC)
unnamed: IC11.9 (Q4), IC13.13 (4B)
unnamed: IC2.5 (C), IC16.12 (QC)
unnamed: IC2.3 (A), IC16.14 (QA)
unnamed: IC2.4 (B), IC16.13 (QB)
unnamed: IC2.6 (D), IC16.11 (QD)
unnamed: IC3.3 (A), IC15.14 (QA)
unnamed: IC3.4 (B), IC15.13 (QB)
unnamed: IC3.6 (D), IC15.11 (QD)
unnamed: IC2.1 (CLR), IC3.1 (CLR), IC9.8 (O)
unnamed: IC12.5 (Q), IC13.1 (!A!/B), IC14.1 (!A!/B)
unnamed: IC5.19 (Q8), IC6.4 (7)
unnamed: IC5.16 (Q7), IC6.3 (6)
unnamed: IC5.15 (Q6), IC6.2 (5)
unnamed: IC5.12 (Q5), IC6.1 (4)
unnamed: IC5.9 (Q4), IC6.13 (3)
unnamed: IC5.6 (Q3), IC6.12 (2)
unnamed: IC5.5 (Q2), IC6.11 (1)
unnamed: IC5.2 (Q1), IC6.10 (0)
OP0: IC13.4 (1Y); also elsewhere on the board
OP1: IC13.7 (2Y); also elsewhere on the board
OP2: IC13.9 (3Y); also elsewhere on the board
OP3: IC13.12 (4Y); also elsewhere on the board
OP4: IC14.4 (1Y); also elsewhere on the board
OP5: IC14.7 (2Y); also elsewhere on the board
OP6: IC14.9 (3Y); also elsewhere on the board
OP7: IC14.12 (4Y); also elsewhere on the board
OP8: IC12.6 (!Q); also elsewhere on the board
PROT: IC4.10 (I1); also elsewhere on the board
RST: IC10.15 (CLR); also elsewhere on the board

Notes on the sheet:
Control (microcode sequencer)
2.0
Dawid Pilawa
(C) 2010-2016
CPU.2

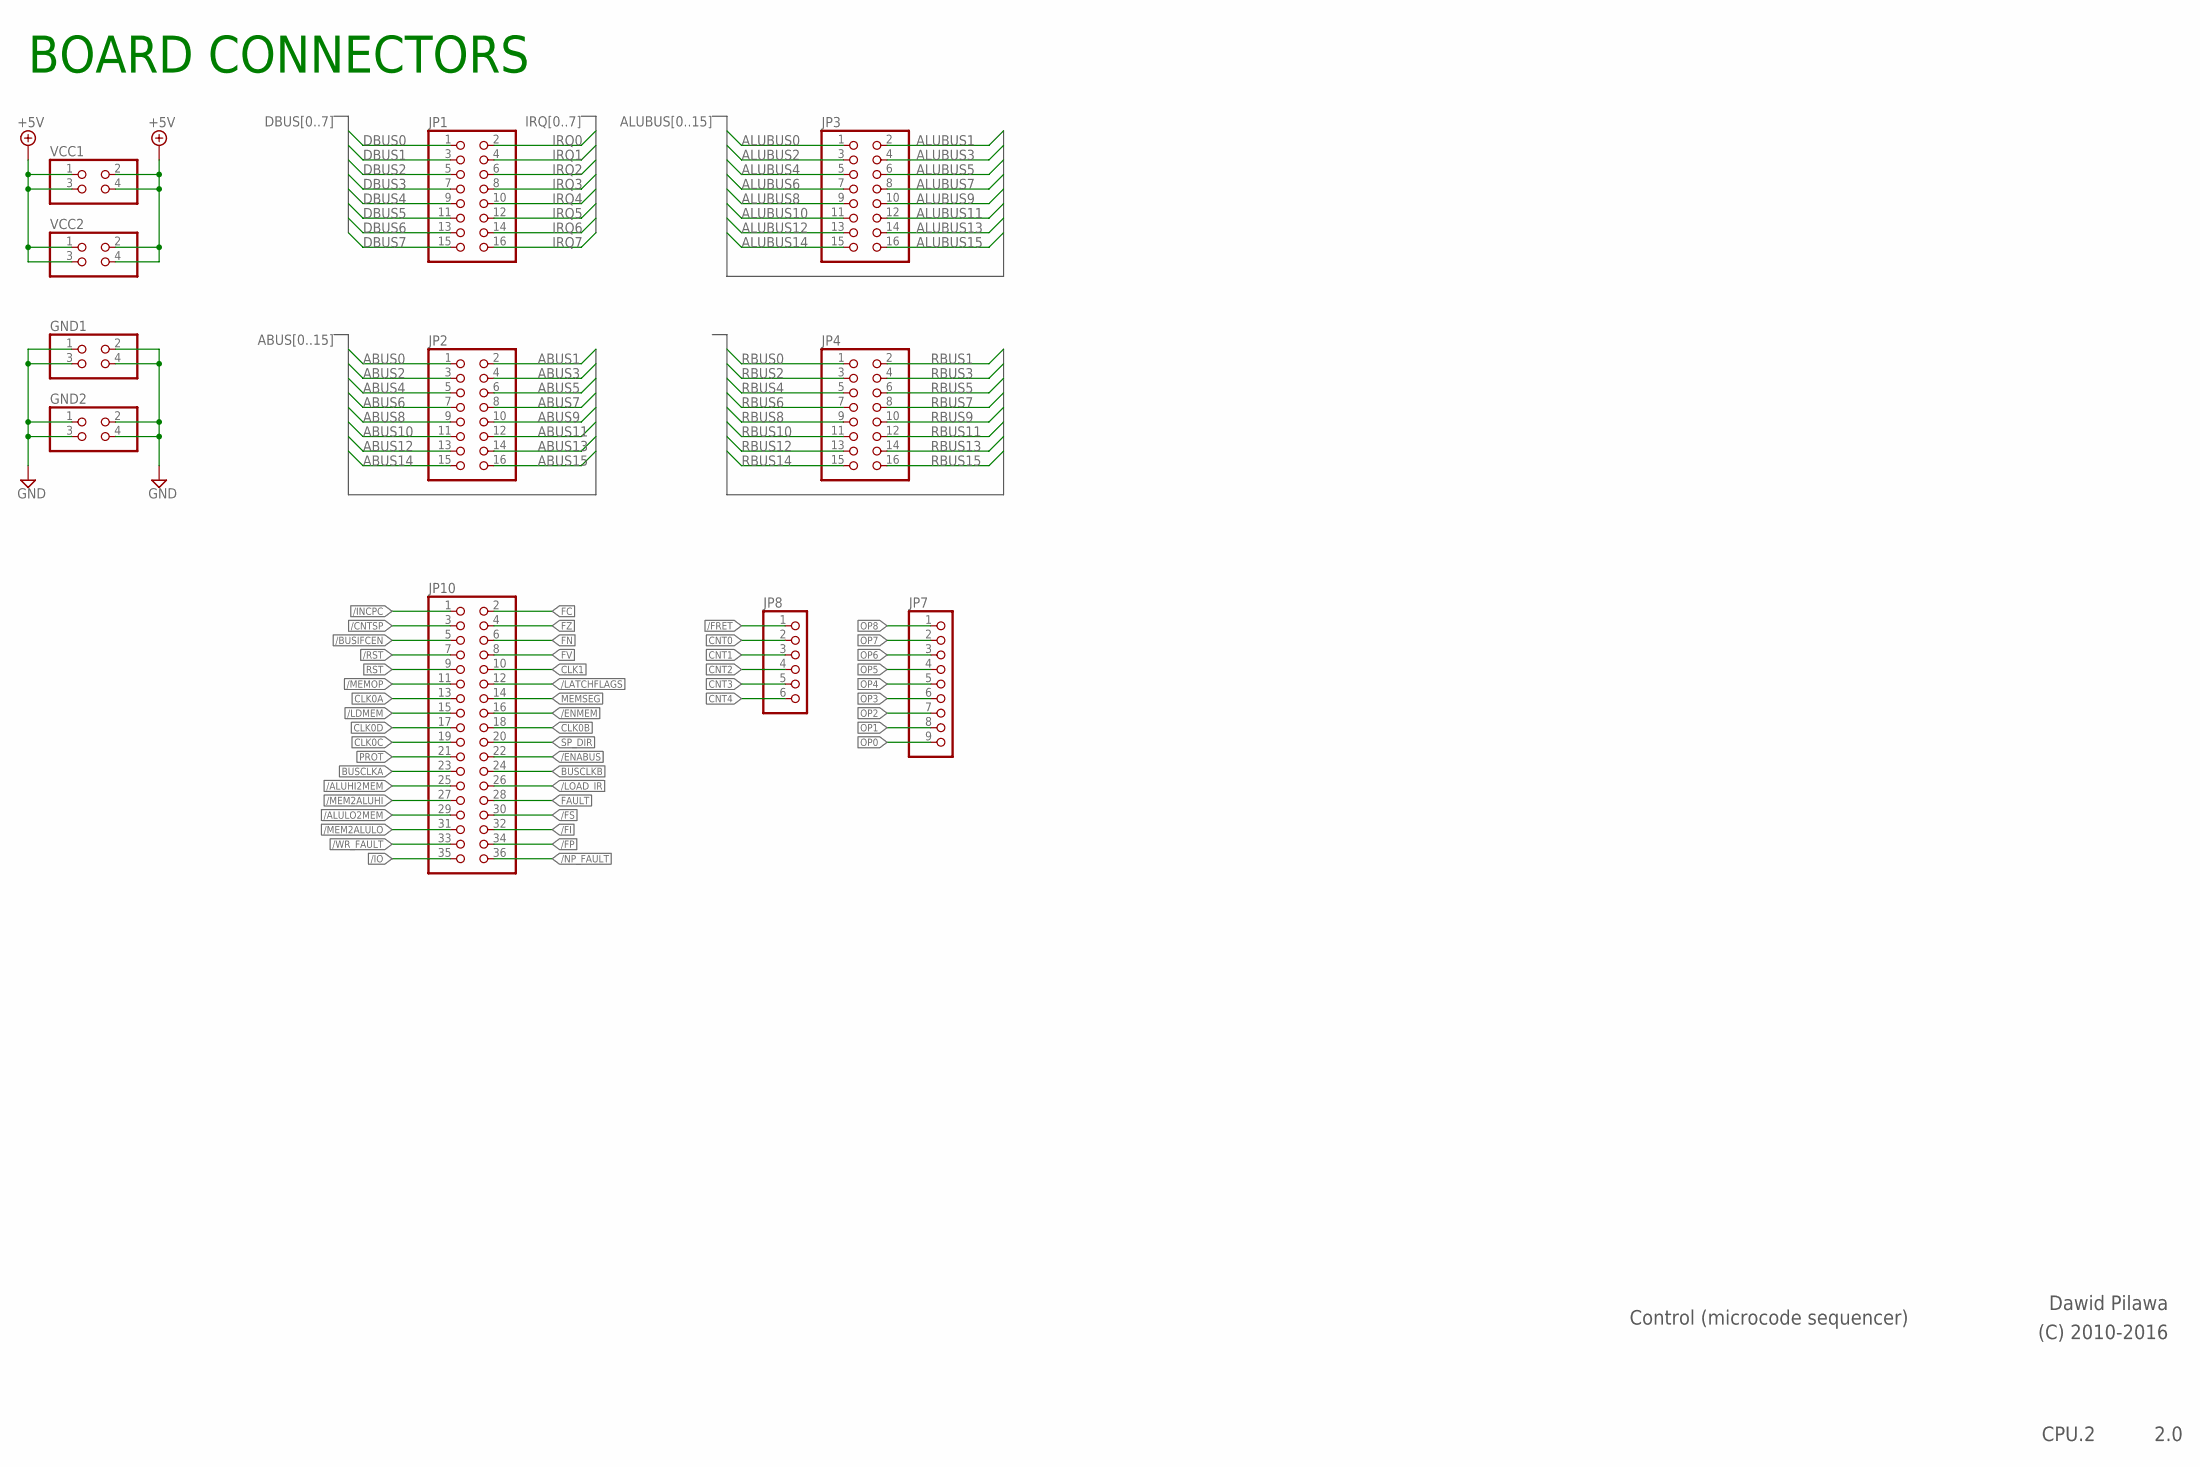
[picture p102: schematic 2_cpu_control.sch, sheet 2]

Parts:
GND1, GND2: PINHD-2X2; 2X02
JP1, JP2, JP3, JP4: PINHD-2X8; 2X08
JP7: PINHD-1X9; 1X09
JP8: PINHD-1X6; 1X06
JP10: PINHD-2X18; 2X18
VCC1, VCC2: PINHD-2X2; 2X02

Connections:
+5V: VCC1.1, VCC1.2, VCC1.3, VCC1.4, VCC2.1, VCC2.2, VCC2.3, VCC2.4; also elsewhere on the board
/ALUHI2MEM: JP10.25
/ALULO2MEM: JP10.29
/BUSIFCEN: JP10.5; also elsewhere on the board
/CNTSP: JP10.3
/ENABUS: JP10.22
/ENMEM: JP10.16
/FI: JP10.32; also elsewhere on the board
/FP: JP10.34
/FRET: JP8.1; also elsewhere on the board
/FS: JP10.30; also elsewhere on the board
/INCPC: JP10.1
/IO: JP10.35
/LATCHFLAGS: JP10.12; also elsewhere on the board
/LDMEM: JP10.15
/LOAD_IR: JP10.26; also elsewhere on the board
/MEM2ALUHI: JP10.27
/MEM2ALULO: JP10.31
/MEMOP: JP10.11
/NP_FAULT: JP10.36; also elsewhere on the board
/RST: JP10.7; also elsewhere on the board
/WR_FAULT: JP10.33; also elsewhere on the board
ABUS0: JP2.1
ABUS1: JP2.2
ABUS2: JP2.3
ABUS3: JP2.4
ABUS4: JP2.5
ABUS5: JP2.6
ABUS6: JP2.7
ABUS7: JP2.8
ABUS8: JP2.9
ABUS9: JP2.10
ABUS10: JP2.11
ABUS11: JP2.12
ABUS12: JP2.13
ABUS13: JP2.14
ABUS14: JP2.15
ABUS15: JP2.16
ALUBUS0: JP3.1
ALUBUS1: JP3.2
ALUBUS2: JP3.3
ALUBUS3: JP3.4
ALUBUS4: JP3.5
ALUBUS5: JP3.6
ALUBUS6: JP3.7
ALUBUS7: JP3.8
ALUBUS8: JP3.9
ALUBUS9: JP3.10
ALUBUS10: JP3.11
ALUBUS11: JP3.12
ALUBUS12: JP3.13
ALUBUS13: JP3.14
ALUBUS14: JP3.15
ALUBUS15: JP3.16
BUSCLKA: JP10.23; also elsewhere on the board
BUSCLKB: JP10.24
CLK0A: JP10.13; also elsewhere on the board
CLK0B: JP10.18
CLK0C: JP10.19
CLK0D: JP10.17
CLK1: JP10.10
CNT0: JP8.2; also elsewhere on the board
CNT1: JP8.3; also elsewhere on the board
CNT2: JP8.4; also elsewhere on the board
CNT3: JP8.5; also elsewhere on the board
CNT4: JP8.6; also elsewhere on the board
DBUS0: JP1.1; also elsewhere on the board
DBUS1: JP1.3; also elsewhere on the board
DBUS2: JP1.5; also elsewhere on the board
DBUS3: JP1.7; also elsewhere on the board
DBUS4: JP1.9; also elsewhere on the board
DBUS5: JP1.11; also elsewhere on the board
DBUS6: JP1.13; also elsewhere on the board
DBUS7: JP1.15; also elsewhere on the board
FAULT: JP10.28; also elsewhere on the board
FC: JP10.2
FN: JP10.6
FV: JP10.8
FZ: JP10.4
GND: GND1.1, GND1.2, GND1.3, GND1.4, GND2.1, GND2.2, GND2.3, GND2.4; also elsewhere on the board
IRQ0: JP1.2; also elsewhere on the board
IRQ1: JP1.4; also elsewhere on the board
IRQ2: JP1.6; also elsewhere on the board
IRQ3: JP1.8; also elsewhere on the board
IRQ4: JP1.10; also elsewhere on the board
IRQ5: JP1.12; also elsewhere on the board
IRQ6: JP1.14; also elsewhere on the board
IRQ7: JP1.16; also elsewhere on the board
MEMSEG: JP10.14
OP0: JP7.9; also elsewhere on the board
OP1: JP7.8; also elsewhere on the board
OP2: JP7.7; also elsewhere on the board
OP3: JP7.6; also elsewhere on the board
OP4: JP7.5; also elsewhere on the board
OP5: JP7.4; also elsewhere on the board
OP6: JP7.3; also elsewhere on the board
OP7: JP7.2; also elsewhere on the board
OP8: JP7.1; also elsewhere on the board
PROT: JP10.21; also elsewhere on the board
RBUS0: JP4.1
RBUS1: JP4.2
RBUS2: JP4.3
RBUS3: JP4.4
RBUS4: JP4.5
RBUS5: JP4.6
RBUS6: JP4.7
RBUS7: JP4.8
RBUS8: JP4.9
RBUS9: JP4.10
RBUS10: JP4.11
RBUS11: JP4.12
RBUS12: JP4.13
RBUS13: JP4.14
RBUS14: JP4.15
RBUS15: JP4.16
RST: JP10.9; also elsewhere on the board
SP_DIR: JP10.20

Notes on the sheet:
Control (microcode sequencer)
2.0
Dawid Pilawa
(C) 2010-2016
CPU.2
BOARD CONNECTORS

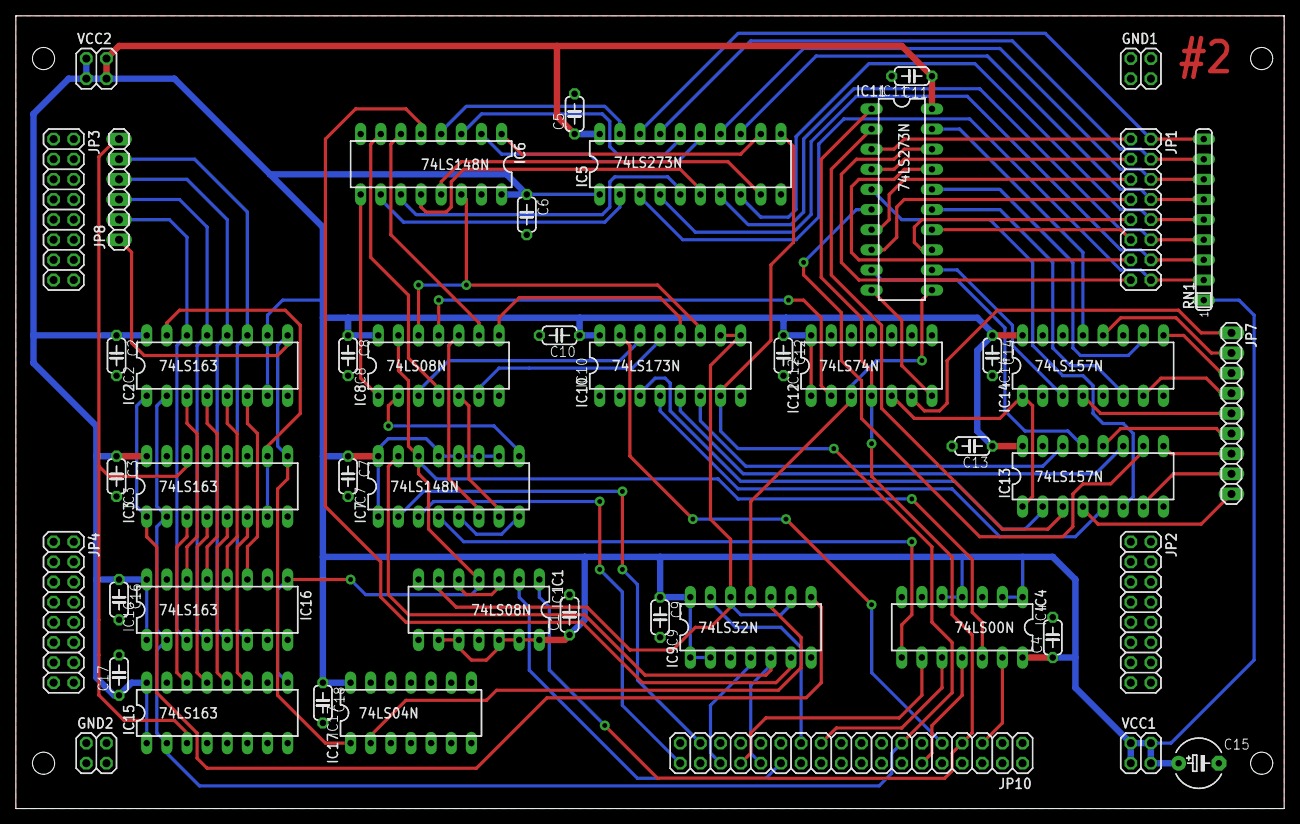
[picture p103: board 2_cpu_control.brd from above]

Board: 2 copper layers, 160.0 x 100.0 mm, 47 parts (0 on the bottom side), 95 nets.
