dpilawa/bytec/eagle/5_cpu_alu.brd

## EAGLE design eagle/5_cpu_alu.brd (2016-02-10)

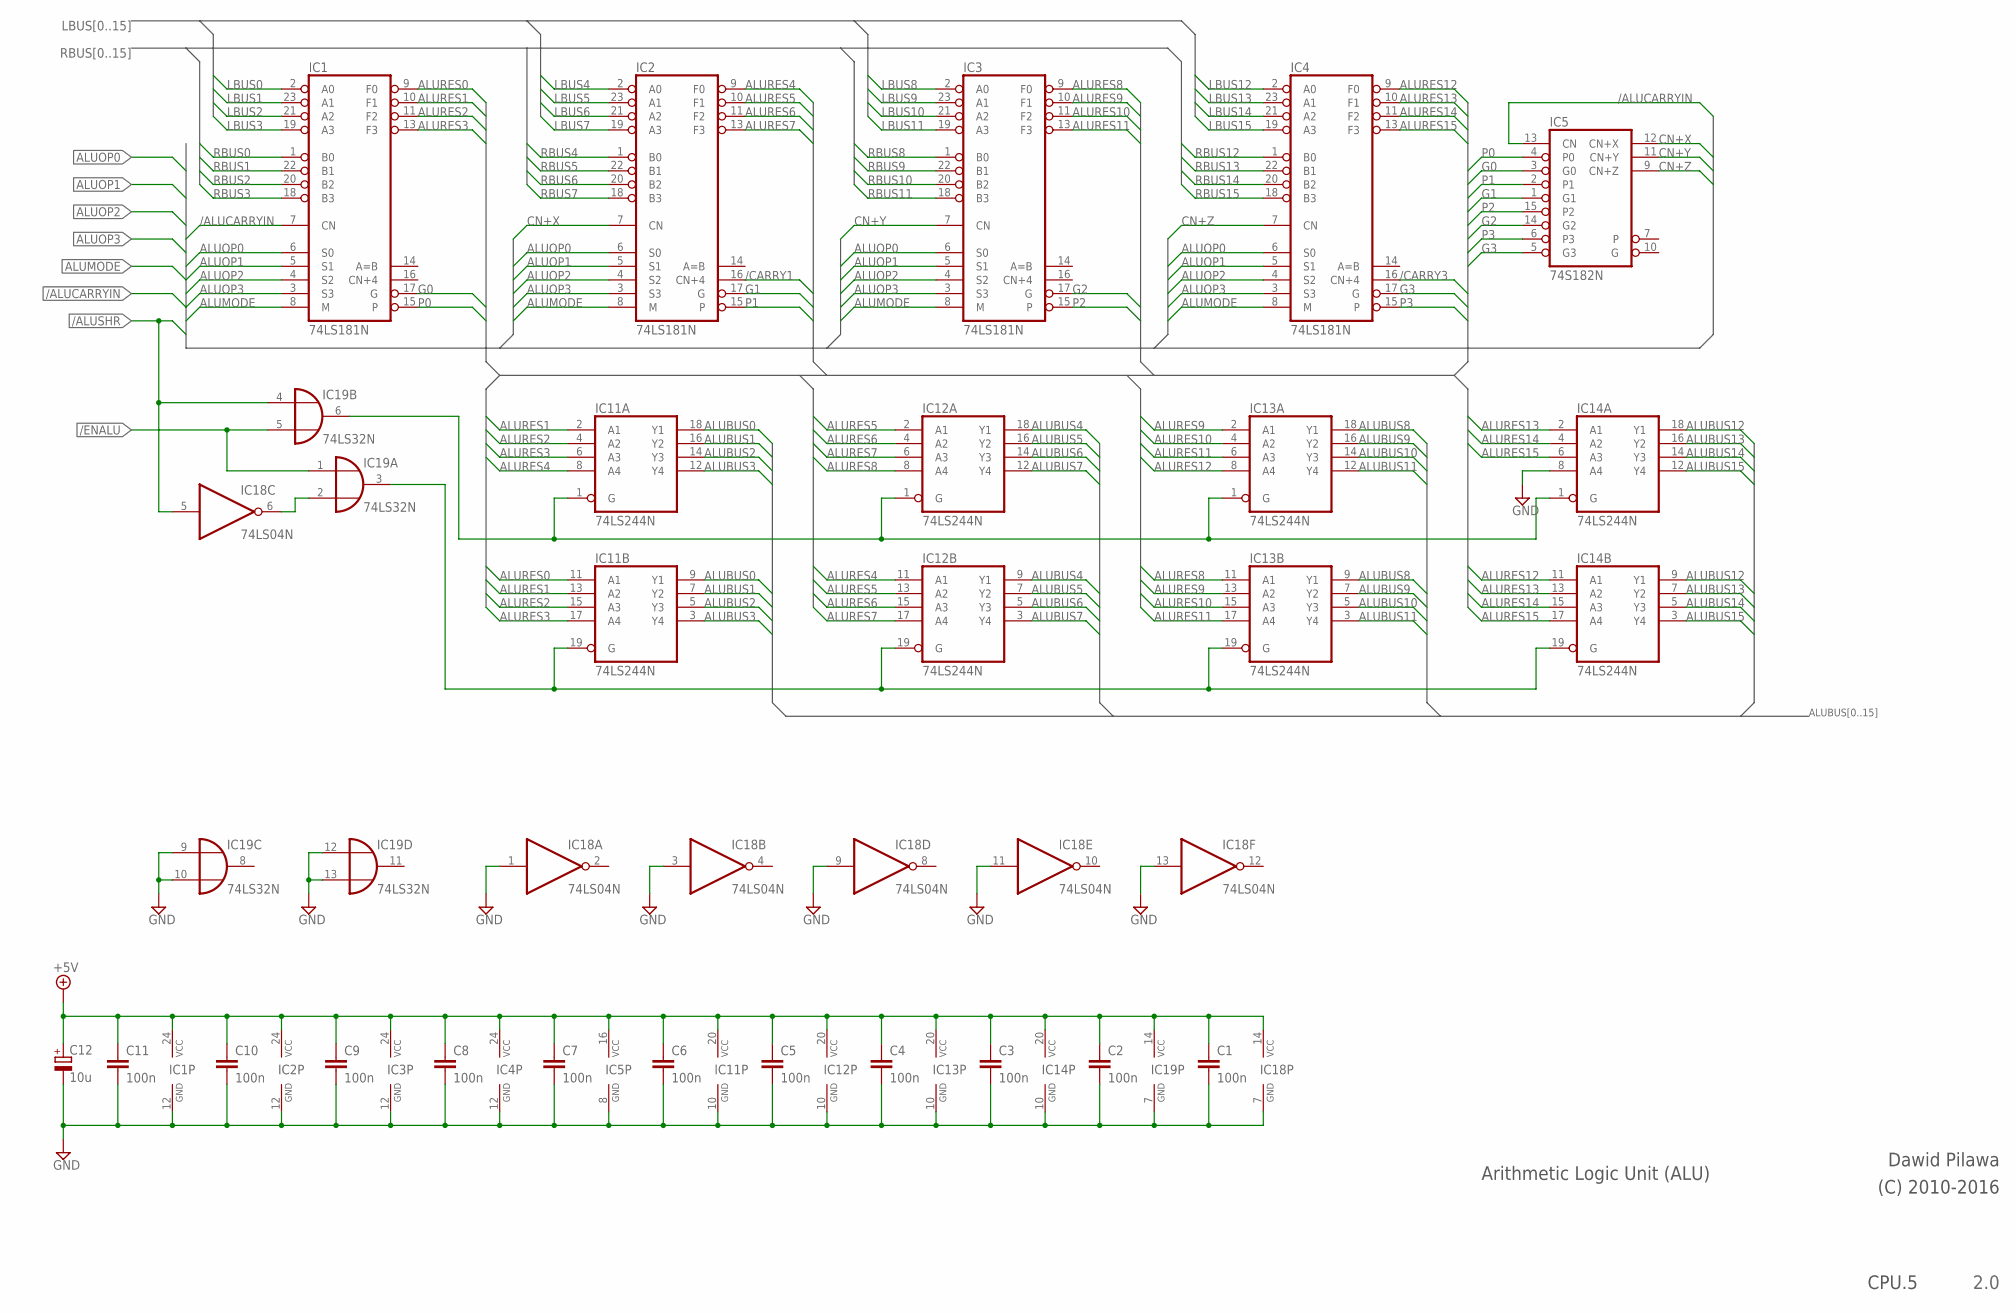
[picture p104: schematic 5_cpu_alu.sch, sheet 1]

Parts:
C1, C2, C3, C4, C5, C6, C7, C8, C9, C10, C11: 100n; C050-024X044
C12: 10u; E2,5-6
IC1, IC2, IC3, IC4: 74LS181N; DIL24-6
IC5: 74S182N; DIL16
IC11, IC12, IC13, IC14: 74LS244N; DIL20
IC18: 74LS04N; DIL14
IC19: 74LS32N; DIL14

Connections:
+5V: C1.1, C2.1, C3.1, C4.1, C5.1, C6.1, C7.1, C8.1, C9.1, C10.1, C11.1, C12.+, IC1.24 (VCC), IC2.24 (VCC), IC3.24 (VCC), IC4.24 (VCC), IC5.16 (VCC), IC11.20 (VCC), IC12.20 (VCC), IC13.20 (VCC), IC14.20 (VCC), IC18.14 (VCC), IC19.14 (VCC); also elsewhere on the board
/ALUCARRYIN: IC1.7 (CN), IC5.13 (CN); also elsewhere on the board
/ALUSHR: IC18.5 (I), IC19.4 (I0); also elsewhere on the board
/CARRY1: IC2.16 (CN+4); also elsewhere on the board
/CARRY3: IC4.16 (CN+4); also elsewhere on the board
/ENALU: IC19.1 (I0), IC19.5 (I1); also elsewhere on the board
ALUBUS0: IC11.9 (Y1), IC11.18 (Y1); also elsewhere on the board
ALUBUS1: IC11.7 (Y2), IC11.16 (Y2); also elsewhere on the board
ALUBUS2: IC11.5 (Y3), IC11.14 (Y3); also elsewhere on the board
ALUBUS3: IC11.3 (Y4), IC11.12 (Y4); also elsewhere on the board
ALUBUS4: IC12.9 (Y1), IC12.18 (Y1); also elsewhere on the board
ALUBUS5: IC12.7 (Y2), IC12.16 (Y2); also elsewhere on the board
ALUBUS6: IC12.5 (Y3), IC12.14 (Y3); also elsewhere on the board
ALUBUS7: IC12.3 (Y4), IC12.12 (Y4); also elsewhere on the board
ALUBUS8: IC13.9 (Y1), IC13.18 (Y1); also elsewhere on the board
ALUBUS9: IC13.7 (Y2), IC13.16 (Y2); also elsewhere on the board
ALUBUS10: IC13.5 (Y3), IC13.14 (Y3); also elsewhere on the board
ALUBUS11: IC13.3 (Y4), IC13.12 (Y4); also elsewhere on the board
ALUBUS12: IC14.9 (Y1), IC14.18 (Y1); also elsewhere on the board
ALUBUS13: IC14.7 (Y2), IC14.16 (Y2); also elsewhere on the board
ALUBUS14: IC14.5 (Y3), IC14.14 (Y3); also elsewhere on the board
ALUBUS15: IC14.3 (Y4), IC14.12 (Y4); also elsewhere on the board
ALUMODE: IC1.8 (M), IC2.8 (M), IC3.8 (M), IC4.8 (M); also elsewhere on the board
ALUOP0: IC1.6 (S0), IC2.6 (S0), IC3.6 (S0), IC4.6 (S0); also elsewhere on the board
ALUOP1: IC1.5 (S1), IC2.5 (S1), IC3.5 (S1), IC4.5 (S1); also elsewhere on the board
ALUOP2: IC1.4 (S2), IC2.4 (S2), IC3.4 (S2), IC4.4 (S2); also elsewhere on the board
ALUOP3: IC1.3 (S3), IC2.3 (S3), IC3.3 (S3), IC4.3 (S3); also elsewhere on the board
ALURES0: IC1.9 (F0), IC11.11 (A1); also elsewhere on the board
ALURES1: IC1.10 (F1), IC11.2 (A1), IC11.13 (A2)
ALURES2: IC1.11 (F2), IC11.4 (A2), IC11.15 (A3)
ALURES3: IC1.13 (F3), IC11.6 (A3), IC11.17 (A4)
ALURES4: IC2.9 (F0), IC11.8 (A4), IC12.11 (A1)
ALURES5: IC2.10 (F1), IC12.2 (A1), IC12.13 (A2)
ALURES6: IC2.11 (F2), IC12.4 (A2), IC12.15 (A3)
ALURES7: IC2.13 (F3), IC12.6 (A3), IC12.17 (A4)
ALURES8: IC3.9 (F0), IC12.8 (A4), IC13.11 (A1); also elsewhere on the board
ALURES9: IC3.10 (F1), IC13.2 (A1), IC13.13 (A2)
ALURES10: IC3.11 (F2), IC13.4 (A2), IC13.15 (A3)
ALURES11: IC3.13 (F3), IC13.6 (A3), IC13.17 (A4)
ALURES12: IC4.9 (F0), IC13.8 (A4), IC14.11 (A1)
ALURES13: IC4.10 (F1), IC14.2 (A1), IC14.13 (A2)
ALURES14: IC4.11 (F2), IC14.4 (A2), IC14.15 (A3)
ALURES15: IC4.13 (F3), IC14.6 (A3), IC14.17 (A4)
CN+X: IC2.7 (CN), IC5.12 (CN+X)
CN+Y: IC3.7 (CN), IC5.11 (CN+Y)
CN+Z: IC4.7 (CN), IC5.9 (CN+Z)
G0: IC1.17 (G), IC5.3 (G0)
G1: IC2.17 (G), IC5.1 (G1)
G2: IC3.17 (G), IC5.14 (G2)
G3: IC4.17 (G), IC5.5 (G3)
GND: C1.2, C2.2, C3.2, C4.2, C5.2, C6.2, C7.2, C8.2, C9.2, C10.2, C11.2, C12.-, IC1.12 (GND), IC2.12 (GND), IC3.12 (GND), IC4.12 (GND), IC5.8 (GND), IC11.10 (GND), IC12.10 (GND), IC13.10 (GND), IC14.8 (A4), IC14.10 (GND), IC18.1 (I), IC18.3 (I), IC18.7 (GND), IC18.9 (I), IC18.11 (I), IC18.13 (I), IC19.7 (GND), IC19.9 (I0), IC19.10 (I1), IC19.12 (I0), IC19.13 (I1); also elsewhere on the board
LBUS0: IC1.2 (A0); also elsewhere on the board
LBUS1: IC1.23 (A1); also elsewhere on the board
LBUS2: IC1.21 (A2); also elsewhere on the board
LBUS3: IC1.19 (A3); also elsewhere on the board
LBUS4: IC2.2 (A0); also elsewhere on the board
LBUS5: IC2.23 (A1); also elsewhere on the board
LBUS6: IC2.21 (A2); also elsewhere on the board
LBUS7: IC2.19 (A3); also elsewhere on the board
LBUS8: IC3.2 (A0); also elsewhere on the board
LBUS9: IC3.23 (A1); also elsewhere on the board
LBUS10: IC3.21 (A2); also elsewhere on the board
LBUS11: IC3.19 (A3); also elsewhere on the board
LBUS12: IC4.2 (A0); also elsewhere on the board
LBUS13: IC4.23 (A1); also elsewhere on the board
LBUS14: IC4.21 (A2); also elsewhere on the board
LBUS15: IC4.19 (A3); also elsewhere on the board
unnamed: IC11.1 (G), IC12.1 (G), IC13.1 (G), IC14.1 (G), IC19.6 (O)
unnamed: IC18.6 (O), IC19.2 (I1)
unnamed: IC11.19 (G), IC12.19 (G), IC13.19 (G), IC14.19 (G), IC19.3 (O)
P0: IC1.15, IC5.4 (P0)
P1: IC2.15, IC5.2 (P1)
P2: IC3.15, IC5.15 (P2)
P3: IC4.15, IC5.6 (P3)
RBUS0: IC1.1 (B0); also elsewhere on the board
RBUS1: IC1.22 (B1); also elsewhere on the board
RBUS2: IC1.20 (B2); also elsewhere on the board
RBUS3: IC1.18 (B3); also elsewhere on the board
RBUS4: IC2.1 (B0); also elsewhere on the board
RBUS5: IC2.22 (B1); also elsewhere on the board
RBUS6: IC2.20 (B2); also elsewhere on the board
RBUS7: IC2.18 (B3); also elsewhere on the board
RBUS8: IC3.1 (B0); also elsewhere on the board
RBUS9: IC3.22 (B1); also elsewhere on the board
RBUS10: IC3.20 (B2); also elsewhere on the board
RBUS11: IC3.18 (B3); also elsewhere on the board
RBUS12: IC4.1 (B0); also elsewhere on the board
RBUS13: IC4.22 (B1); also elsewhere on the board
RBUS14: IC4.20 (B2); also elsewhere on the board
RBUS15: IC4.18 (B3); also elsewhere on the board

Notes on the sheet:
Arithmetic Logic Unit (ALU)
Dawid Pilawa
(C) 2010-2016
2.0
CPU.5

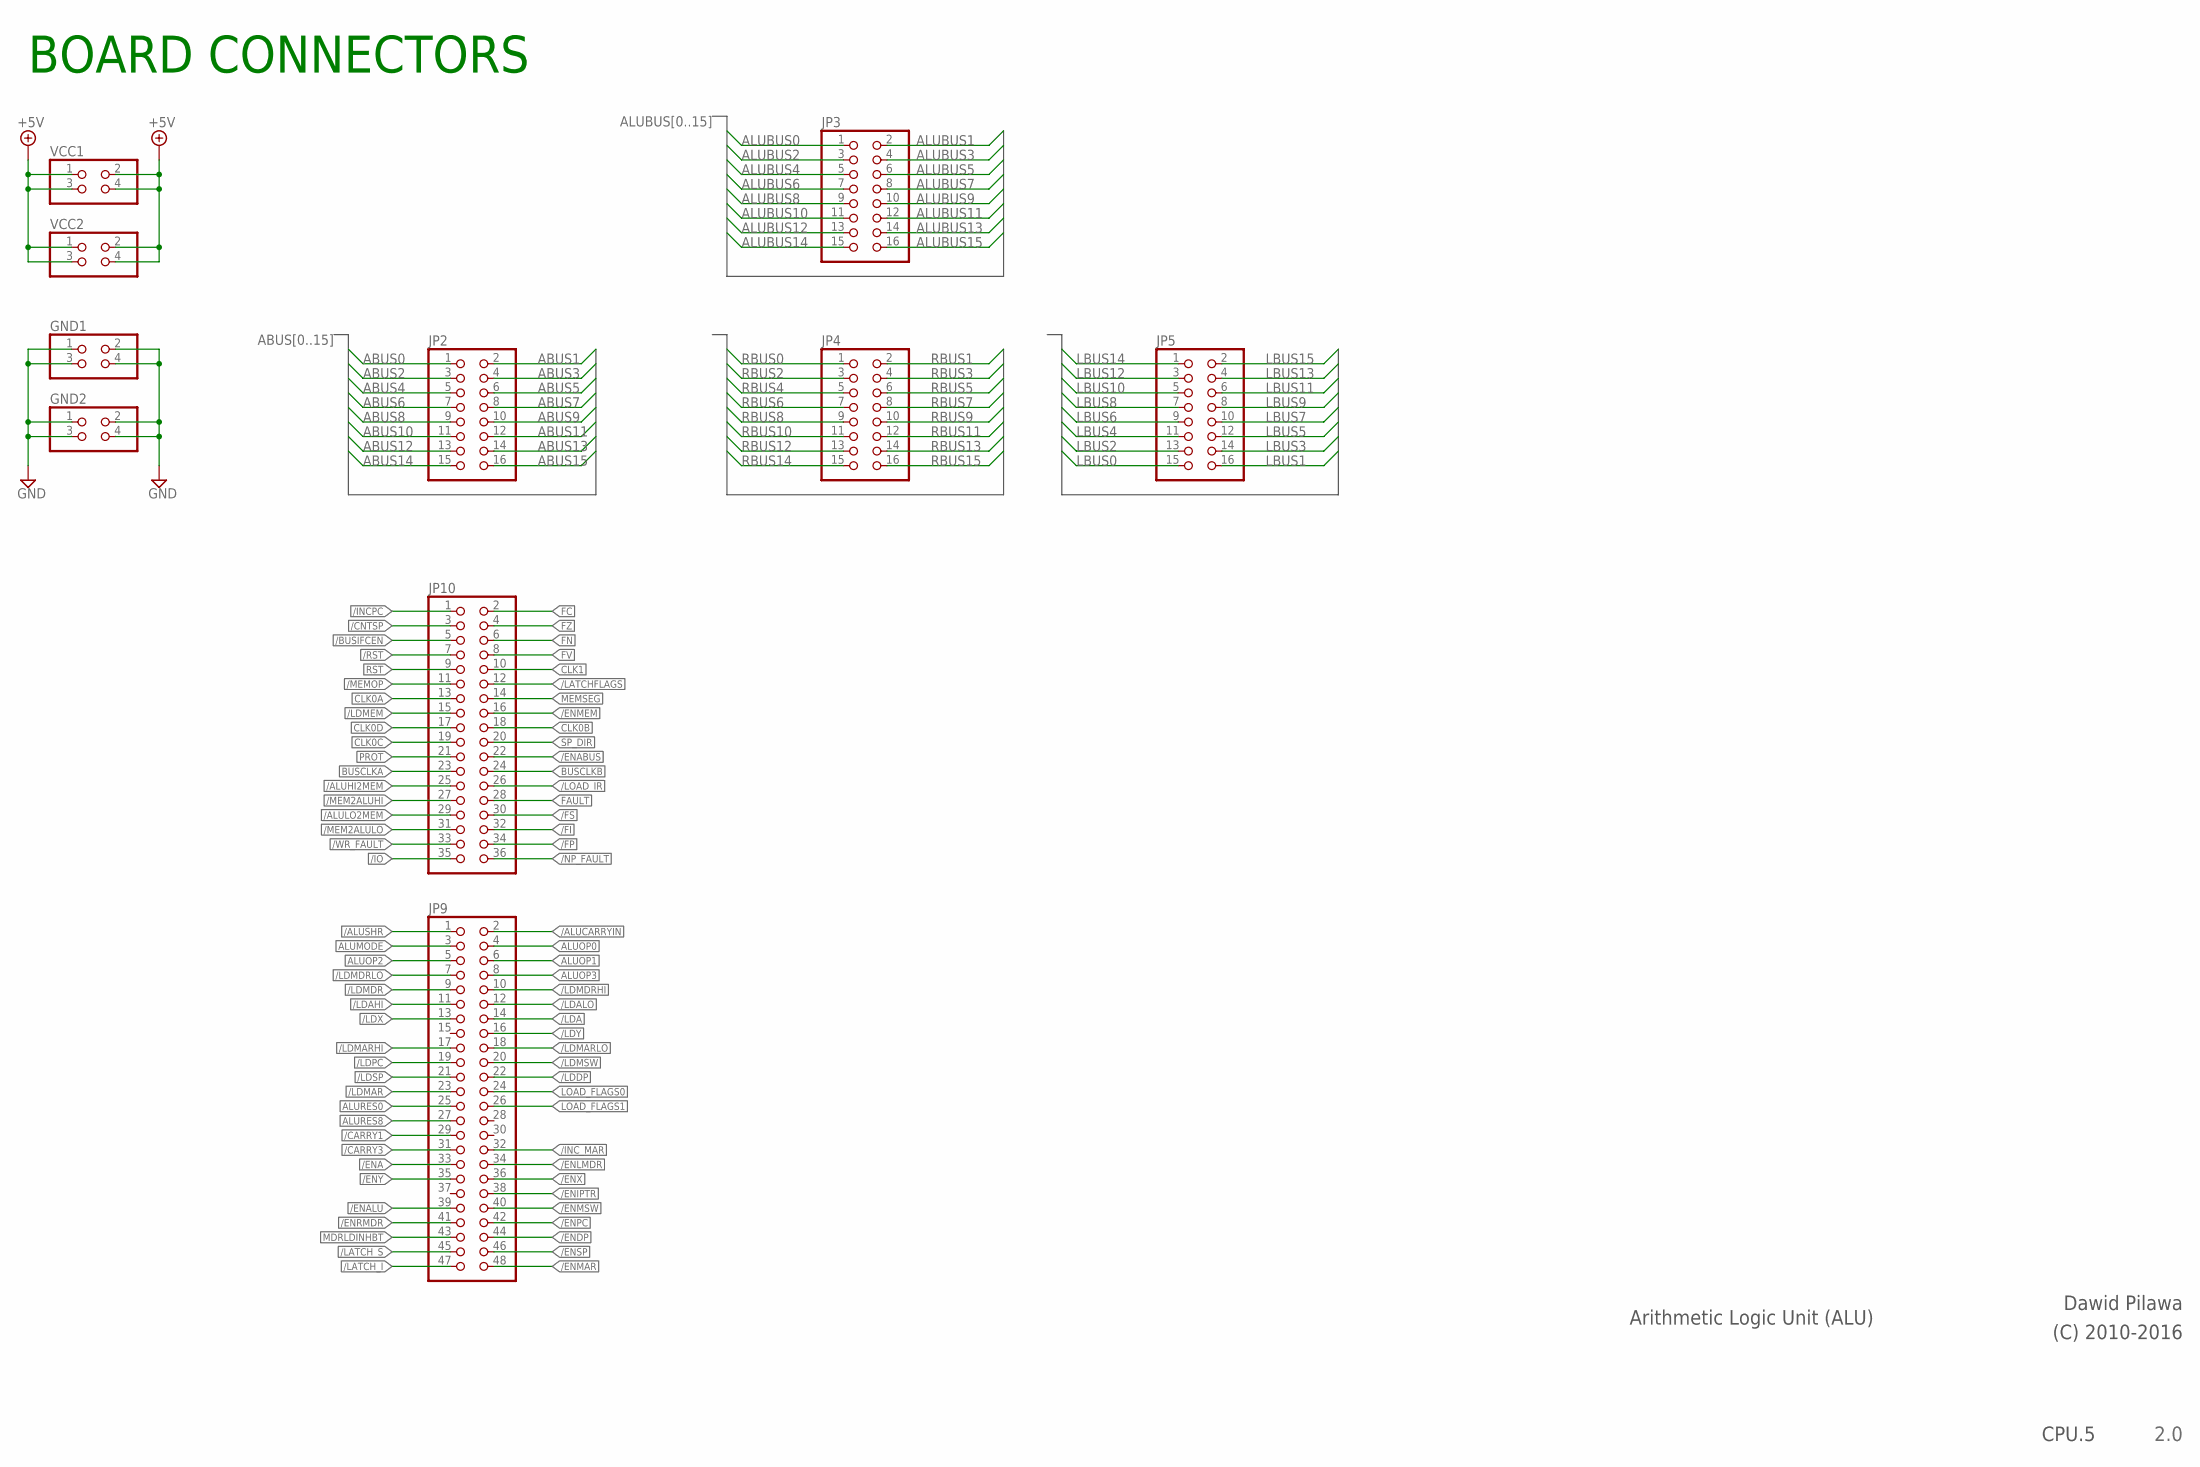
[picture p105: schematic 5_cpu_alu.sch, sheet 2]

Parts:
GND1, GND2: PINHD-2X2; 2X02
JP2, JP3, JP4, JP5: PINHD-2X8; 2X08
JP9: PINHD-2X24; 2X24
JP10: PINHD-2X18; 2X18
VCC1, VCC2: PINHD-2X2; 2X02

Connections:
+5V: VCC1.1, VCC1.2, VCC1.3, VCC1.4, VCC2.1, VCC2.2, VCC2.3, VCC2.4; also elsewhere on the board
/ALUCARRYIN: JP9.2; also elsewhere on the board
/ALUHI2MEM: JP10.25
/ALULO2MEM: JP10.29
/ALUSHR: JP9.1; also elsewhere on the board
/BUSIFCEN: JP10.5
/CARRY1: JP9.29; also elsewhere on the board
/CARRY3: JP9.31; also elsewhere on the board
/CNTSP: JP10.3
/ENA: JP9.33
/ENABUS: JP10.22
/ENALU: JP9.39; also elsewhere on the board
/ENDP: JP9.44
/ENIPTR: JP9.38
/ENLMDR: JP9.34
/ENMAR: JP9.48
/ENMEM: JP10.16
/ENMSW: JP9.40
/ENPC: JP9.42
/ENRMDR: JP9.41
/ENSP: JP9.46
/ENX: JP9.36
/ENY: JP9.35
/FI: JP10.32
/FP: JP10.34
/FS: JP10.30
/INCPC: JP10.1
/INC_MAR: JP9.32
/IO: JP10.35
/LATCHFLAGS: JP10.12
/LATCH_I: JP9.47
/LATCH_S: JP9.45
/LDA: JP9.14
/LDAHI: JP9.11
/LDALO: JP9.12
/LDDP: JP9.22
/LDMAR: JP9.23
/LDMARHI: JP9.17
/LDMARLO: JP9.18
/LDMDR: JP9.9
/LDMDRHI: JP9.10
/LDMDRLO: JP9.7
/LDMEM: JP10.15
/LDMSW: JP9.20
/LDPC: JP9.19
/LDSP: JP9.21
/LDX: JP9.13
/LDY: JP9.16
/LOAD_IR: JP10.26
/MEM2ALUHI: JP10.27
/MEM2ALULO: JP10.31
/MEMOP: JP10.11
/NP_FAULT: JP10.36
/RST: JP10.7
/WR_FAULT: JP10.33
ABUS0: JP2.1
ABUS1: JP2.2
ABUS2: JP2.3
ABUS3: JP2.4
ABUS4: JP2.5
ABUS5: JP2.6
ABUS6: JP2.7
ABUS7: JP2.8
ABUS8: JP2.9
ABUS9: JP2.10
ABUS10: JP2.11
ABUS11: JP2.12
ABUS12: JP2.13
ABUS13: JP2.14
ABUS14: JP2.15
ABUS15: JP2.16
ALUBUS0: JP3.1; also elsewhere on the board
ALUBUS1: JP3.2; also elsewhere on the board
ALUBUS2: JP3.3; also elsewhere on the board
ALUBUS3: JP3.4; also elsewhere on the board
ALUBUS4: JP3.5; also elsewhere on the board
ALUBUS5: JP3.6; also elsewhere on the board
ALUBUS6: JP3.7; also elsewhere on the board
ALUBUS7: JP3.8; also elsewhere on the board
ALUBUS8: JP3.9; also elsewhere on the board
ALUBUS9: JP3.10; also elsewhere on the board
ALUBUS10: JP3.11; also elsewhere on the board
ALUBUS11: JP3.12; also elsewhere on the board
ALUBUS12: JP3.13; also elsewhere on the board
ALUBUS13: JP3.14; also elsewhere on the board
ALUBUS14: JP3.15; also elsewhere on the board
ALUBUS15: JP3.16; also elsewhere on the board
ALUMODE: JP9.3; also elsewhere on the board
ALUOP0: JP9.4; also elsewhere on the board
ALUOP1: JP9.6; also elsewhere on the board
ALUOP2: JP9.5; also elsewhere on the board
ALUOP3: JP9.8; also elsewhere on the board
ALURES0: JP9.25; also elsewhere on the board
ALURES8: JP9.27; also elsewhere on the board
BUSCLKA: JP10.23
BUSCLKB: JP10.24
CLK0A: JP10.13
CLK0B: JP10.18
CLK0C: JP10.19
CLK0D: JP10.17
CLK1: JP10.10
FAULT: JP10.28
FC: JP10.2
FN: JP10.6
FV: JP10.8
FZ: JP10.4
GND: GND1.1, GND1.2, GND1.3, GND1.4, GND2.1, GND2.2, GND2.3, GND2.4; also elsewhere on the board
LBUS0: JP5.15; also elsewhere on the board
LBUS1: JP5.16; also elsewhere on the board
LBUS2: JP5.13; also elsewhere on the board
LBUS3: JP5.14; also elsewhere on the board
LBUS4: JP5.11; also elsewhere on the board
LBUS5: JP5.12; also elsewhere on the board
LBUS6: JP5.9; also elsewhere on the board
LBUS7: JP5.10; also elsewhere on the board
LBUS8: JP5.7; also elsewhere on the board
LBUS9: JP5.8; also elsewhere on the board
LBUS10: JP5.5; also elsewhere on the board
LBUS11: JP5.6; also elsewhere on the board
LBUS12: JP5.3; also elsewhere on the board
LBUS13: JP5.4; also elsewhere on the board
LBUS14: JP5.1; also elsewhere on the board
LBUS15: JP5.2; also elsewhere on the board
LOAD_FLAGS0: JP9.24
LOAD_FLAGS1: JP9.26
MDRLDINHBT: JP9.43
MEMSEG: JP10.14
PROT: JP10.21
RBUS0: JP4.1; also elsewhere on the board
RBUS1: JP4.2; also elsewhere on the board
RBUS2: JP4.3; also elsewhere on the board
RBUS3: JP4.4; also elsewhere on the board
RBUS4: JP4.5; also elsewhere on the board
RBUS5: JP4.6; also elsewhere on the board
RBUS6: JP4.7; also elsewhere on the board
RBUS7: JP4.8; also elsewhere on the board
RBUS8: JP4.9; also elsewhere on the board
RBUS9: JP4.10; also elsewhere on the board
RBUS10: JP4.11; also elsewhere on the board
RBUS11: JP4.12; also elsewhere on the board
RBUS12: JP4.13; also elsewhere on the board
RBUS13: JP4.14; also elsewhere on the board
RBUS14: JP4.15; also elsewhere on the board
RBUS15: JP4.16; also elsewhere on the board
RST: JP10.9
SP_DIR: JP10.20

Notes on the sheet:
Arithmetic Logic Unit (ALU)
Dawid Pilawa
(C) 2010-2016
2.0
CPU.5
BOARD CONNECTORS

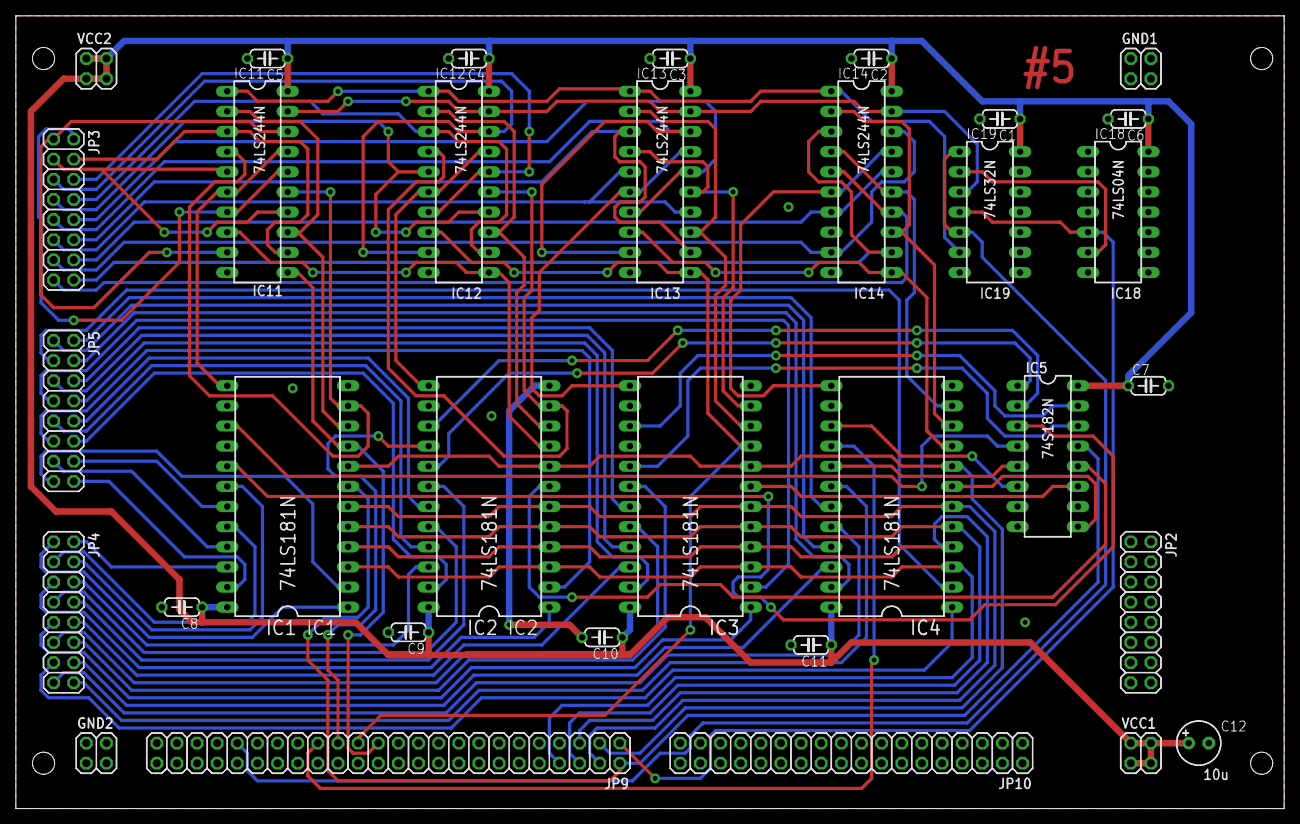
[picture p106: board 5_cpu_alu.brd from above]

Board: 2 copper layers, 160.0 x 100.0 mm, 33 parts (0 on the bottom side), 90 nets.
