dpilawa/bytec/eagle/4_cpu_control.brd

## EAGLE design eagle/4_cpu_control.brd (2016-02-10)

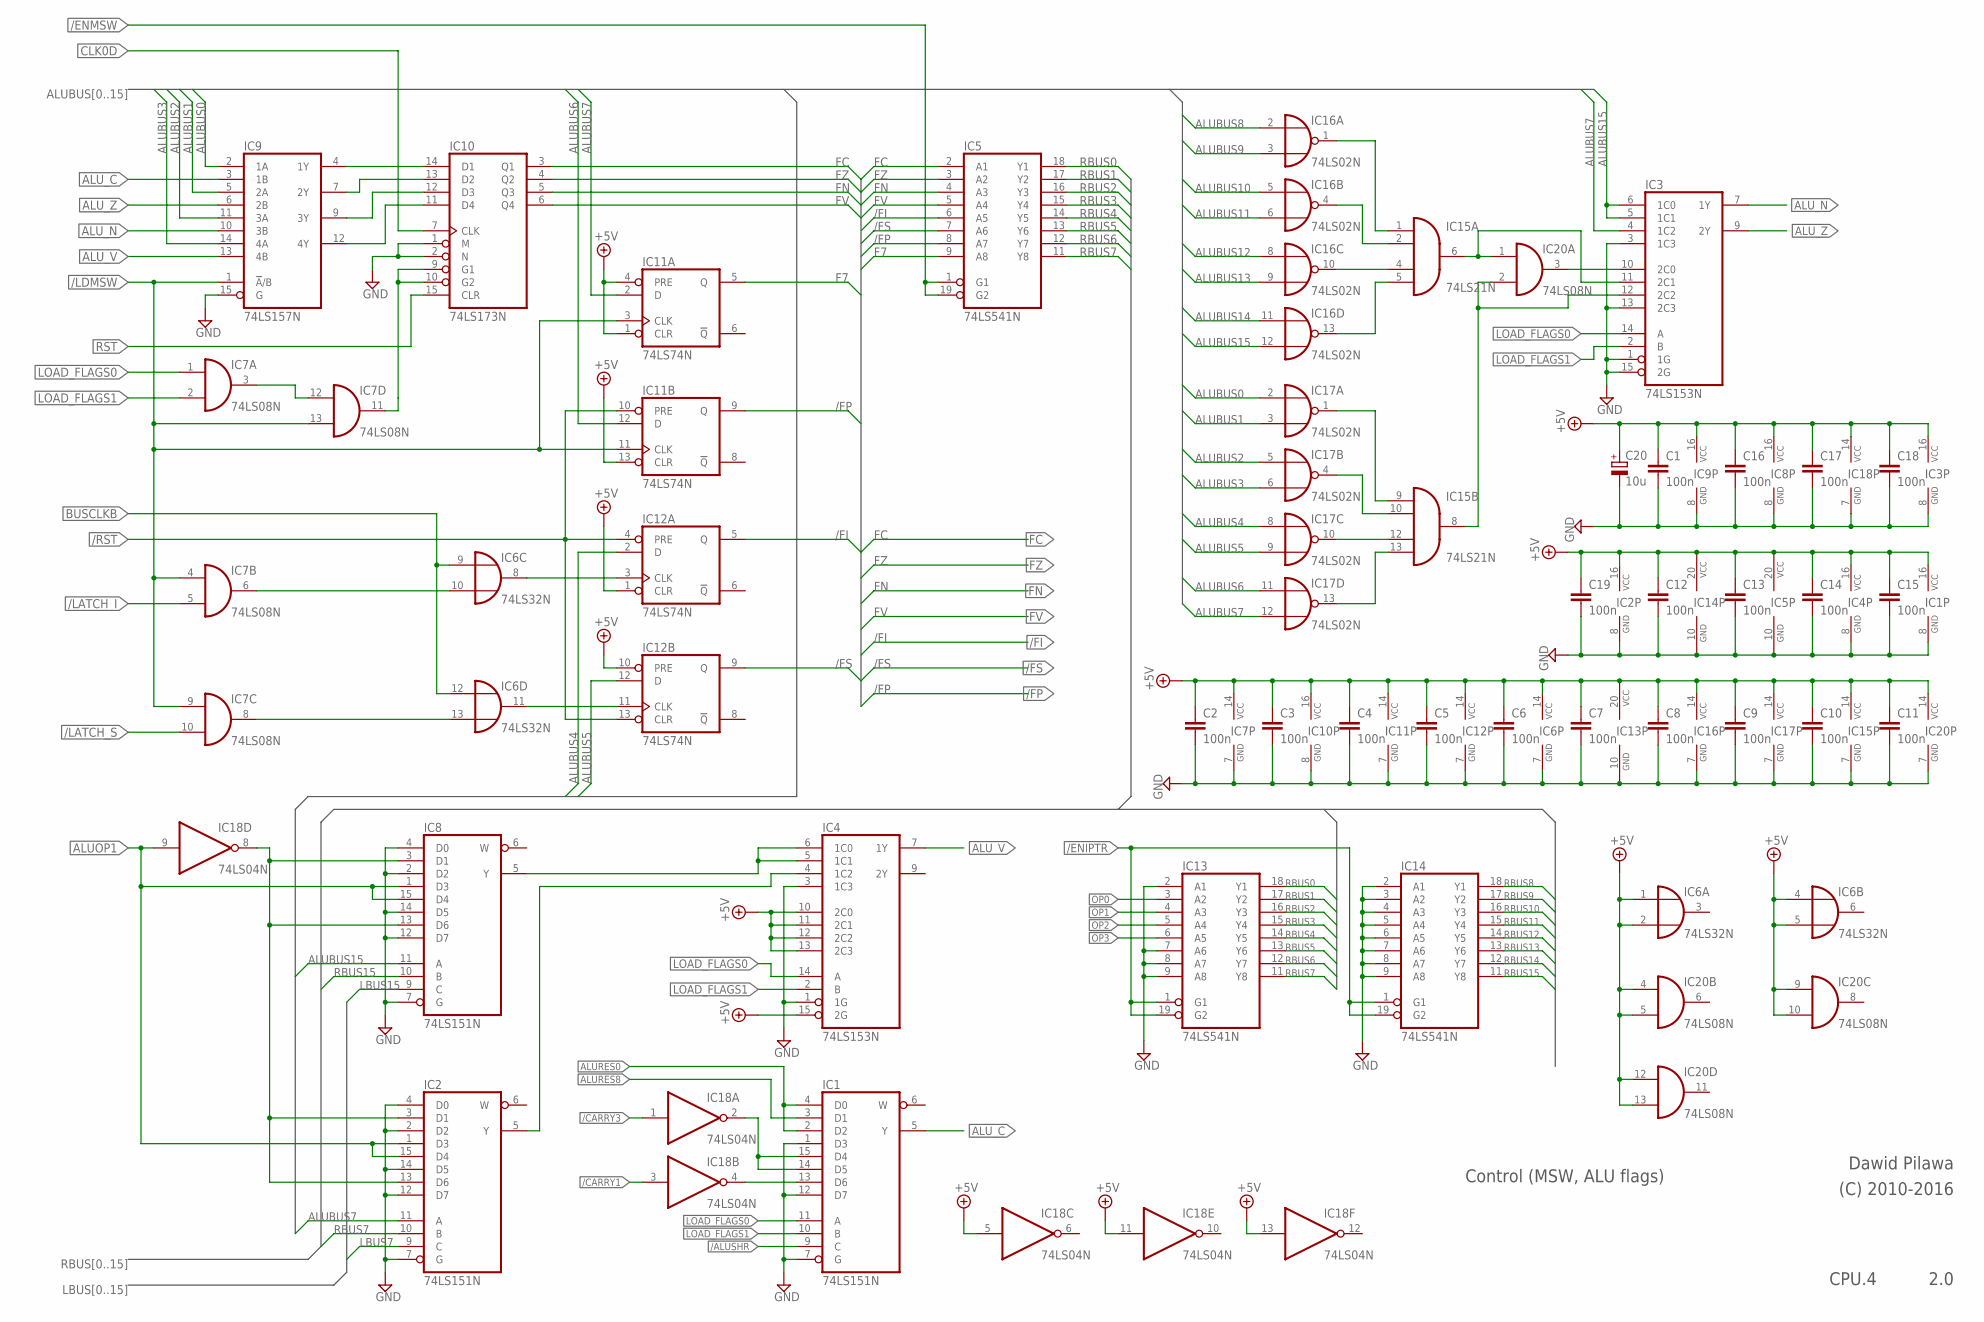
[picture p107: schematic 4_cpu_control.sch, sheet 1]

Parts:
C1, C2, C3, C4, C5, C6, C7, C8, C9, C10, C11, C12, C13, C14, C15, C16, C17, C18, C19: 100n; C050-024X044
C20: 10u; E2,5-6
IC1, IC2, IC8: 74LS151N; DIL16
IC3, IC4: 74LS153N; DIL16
IC5, IC13, IC14: 74LS541N; DIL20
IC6: 74LS32N; DIL14
IC7, IC20: 74LS08N; DIL14
IC9: 74LS157N; DIL16
IC10: 74LS173N; DIL16
IC11, IC12: 74LS74N; DIL14
IC15: 74LS21N; DIL14
IC16, IC17: 74LS02N; DIL14
IC18: 74LS04N; DIL14

Connections:
+5V: C1.1, C2.1, C3.1, C4.1, C5.1, C6.1, C7.1, C8.1, C9.1, C10.1, C11.1, C12.1, C13.1, C14.1, C15.1, C16.1, C17.1, C18.1, C19.1, C20.+, IC1.16 (VCC), IC2.16 (VCC), IC3.16 (VCC), IC4.10 (2C0), IC4.11 (2C1), IC4.12 (2C2), IC4.13 (2C3), IC4.15 (2G), IC4.16 (VCC), IC5.20 (VCC), IC6.1 (I0), IC6.2 (I1), IC6.4 (I0), IC6.5 (I1), IC6.14 (VCC), IC7.14 (VCC), IC8.16 (VCC), IC9.16 (VCC), IC10.16 (VCC), IC11.1 (CLR), IC11.4 (PRE), IC11.13 (CLR), IC11.14 (VCC), IC12.1 (CLR), IC12.10 (PRE), IC12.14 (VCC), IC13.20 (VCC), IC14.20 (VCC), IC15.14 (VCC), IC16.14 (VCC), IC17.14 (VCC), IC18.5 (I), IC18.11 (I), IC18.13 (I), IC18.14 (VCC), IC20.4 (I0), IC20.5 (I1), IC20.9 (I0), IC20.10 (I1), IC20.12 (I0), IC20.13 (I1), IC20.14 (VCC); also elsewhere on the board
/ALUSHR: IC1.9 (C); also elsewhere on the board
/CARRY1: IC18.3 (I); also elsewhere on the board
/CARRY3: IC18.1 (I); also elsewhere on the board
/ENIPTR: IC13.1 (G1), IC13.19 (G2), IC14.1 (G1), IC14.19 (G2); also elsewhere on the board
/ENMSW: IC5.1 (G1), IC5.19 (G2); also elsewhere on the board
/FI: IC5.6 (A5), IC12.5 (Q); also elsewhere on the board
/FP: IC5.8 (A7), IC11.9 (Q); also elsewhere on the board
/FS: IC5.7 (A6), IC12.9 (Q); also elsewhere on the board
/LATCH_I: IC7.5 (I1); also elsewhere on the board
/LATCH_S: IC7.10 (I1); also elsewhere on the board
/LDMSW: IC7.4 (I0), IC7.9 (I0), IC7.13 (I1), IC9.1 (!A!/B), IC11.3 (CLK), IC11.11 (CLK); also elsewhere on the board
/RST: IC11.10 (PRE), IC12.4 (PRE), IC12.13 (CLR); also elsewhere on the board
ALUBUS0: IC9.2 (1A), IC17.2 (I0); also elsewhere on the board
ALUBUS1: IC9.5 (2A), IC17.3 (I1); also elsewhere on the board
ALUBUS2: IC9.11 (3A), IC17.5 (I0); also elsewhere on the board
ALUBUS3: IC9.14 (4A), IC17.6 (I1); also elsewhere on the board
ALUBUS4: IC12.2 (D), IC17.8 (I0); also elsewhere on the board
ALUBUS5: IC12.12 (D), IC17.9 (I1); also elsewhere on the board
ALUBUS6: IC11.12 (D), IC17.11 (I0); also elsewhere on the board
ALUBUS7: IC2.11 (A), IC3.4 (1C2), IC11.2 (D), IC17.12 (I1); also elsewhere on the board
ALUBUS8: IC16.2 (I0); also elsewhere on the board
ALUBUS9: IC16.3 (I1); also elsewhere on the board
ALUBUS10: IC16.5 (I0); also elsewhere on the board
ALUBUS11: IC16.6 (I1); also elsewhere on the board
ALUBUS12: IC16.8 (I0); also elsewhere on the board
ALUBUS13: IC16.9 (I1); also elsewhere on the board
ALUBUS14: IC16.11 (I0); also elsewhere on the board
ALUBUS15: IC3.5 (1C1), IC3.6 (1C0), IC8.11 (A), IC16.12 (I1); also elsewhere on the board
ALUOP1: IC2.1 (D3), IC2.15 (D4), IC8.1 (D3), IC8.15 (D4), IC18.9 (I); also elsewhere on the board
ALURES0: IC1.2 (D2), IC1.4 (D0); also elsewhere on the board
ALURES8: IC1.3 (D1); also elsewhere on the board
ALU_C: IC1.5 (Y), IC9.3 (1B)
ALU_N: IC3.7 (1Y), IC9.10 (3B)
ALU_V: IC4.7 (1Y), IC9.13 (4B)
ALU_Z: IC3.9 (2Y), IC9.6 (2B)
BUSCLKB: IC6.9 (I0), IC6.12 (I0); also elsewhere on the board
CLK0D: IC10.7 (CLK); also elsewhere on the board
F7: IC5.9 (A8), IC11.5 (Q)
FC: IC5.2 (A1), IC10.3 (Q1); also elsewhere on the board
FN: IC5.4 (A3), IC10.5 (Q3); also elsewhere on the board
FV: IC5.5 (A4), IC10.6 (Q4); also elsewhere on the board
FZ: IC5.3 (A2), IC10.4 (Q2); also elsewhere on the board
GND: C1.2, C2.2, C3.2, C4.2, C5.2, C6.2, C7.2, C8.2, C9.2, C10.2, C11.2, C12.2, C13.2, C14.2, C15.2, C16.2, C17.2, C18.2, C19.2, C20.-, IC1.1 (D3), IC1.7 (G), IC1.8 (GND), IC1.12 (D7), IC2.2 (D2), IC2.4 (D0), IC2.7 (G), IC2.8 (GND), IC2.12 (D7), IC2.14 (D5), IC3.1 (1G), IC3.3 (1C3), IC3.8 (GND), IC3.13 (2C3), IC3.15 (2G), IC4.1 (1G), IC4.3 (1C3), IC4.8 (GND), IC5.10 (GND), IC6.7 (GND), IC7.7 (GND), IC8.2 (D2), IC8.4 (D0), IC8.7 (G), IC8.8 (GND), IC8.12 (D7), IC8.14 (D5), IC9.8 (GND), IC9.15 (G), IC10.1 (M), IC10.2 (N), IC10.8 (GND), IC11.7 (GND), IC12.7 (GND), IC13.2 (A1), IC13.7 (A6), IC13.8 (A7), IC13.9 (A8), IC13.10 (GND), IC14.2 (A1), IC14.3 (A2), IC14.4 (A3), IC14.5 (A4), IC14.6 (A5), IC14.7 (A6), IC14.8 (A7), IC14.9 (A8), IC14.10 (GND), IC15.7 (GND), IC16.7 (GND), IC17.7 (GND), IC18.7 (GND), IC20.7 (GND); also elsewhere on the board
LBUS7: IC2.9 (C); also elsewhere on the board
LBUS15: IC8.9 (C); also elsewhere on the board
LOAD_FLAGS0: IC1.11 (A), IC3.14 (A), IC4.14 (A), IC7.1 (I0); also elsewhere on the board
LOAD_FLAGS1: IC1.10 (B), IC3.2 (B), IC4.2 (B), IC7.2 (I1); also elsewhere on the board
unnamed: IC4.5 (1C1), IC4.6 (1C0), IC8.5 (Y)
unnamed: IC1.13 (D6), IC18.4 (O)
unnamed: IC1.14 (D5), IC1.15 (D4), IC18.2 (O)
unnamed: IC15.1 (I0), IC16.1 (O)
unnamed: IC15.2 (I1), IC16.4 (O)
unnamed: IC15.4 (I2), IC16.10 (O)
unnamed: IC15.5 (I3), IC16.13 (O)
unnamed: IC15.9 (I0), IC17.1 (O)
unnamed: IC15.10 (I1), IC17.4 (O)
unnamed: IC15.12 (I2), IC17.10 (O)
unnamed: IC15.13 (I3), IC17.13 (O)
unnamed: IC3.11 (2C1), IC15.6 (O), IC20.1 (I0)
unnamed: IC3.12 (2C2), IC15.8 (O), IC20.2 (I1)
unnamed: IC3.10 (2C0), IC20.3 (O)
unnamed: IC7.11 (O), IC10.9 (G1), IC10.10 (G2)
unnamed: IC2.5 (Y), IC4.4 (1C2)
unnamed: IC2.3 (D1), IC2.13 (D6), IC8.3 (D1), IC8.13 (D6), IC18.8 (O)
unnamed: IC9.4 (1Y), IC10.14 (D1)
unnamed: IC9.7 (2Y), IC10.13 (D2)
unnamed: IC9.9 (3Y), IC10.12 (D3)
unnamed: IC9.12 (4Y), IC10.11 (D4)
unnamed: IC7.3 (O), IC7.12 (I0)
unnamed: IC6.8 (O), IC12.3 (CLK)
unnamed: IC6.11 (O), IC12.11 (CLK)
unnamed: IC6.10 (I1), IC7.6 (O)
unnamed: IC6.13 (I1), IC7.8 (O)
OP0: IC13.3 (A2); also elsewhere on the board
OP1: IC13.4 (A3); also elsewhere on the board
OP2: IC13.5 (A4); also elsewhere on the board
OP3: IC13.6 (A5); also elsewhere on the board
RBUS0: IC5.18 (Y1), IC13.18 (Y1); also elsewhere on the board
RBUS1: IC5.17 (Y2), IC13.17 (Y2); also elsewhere on the board
RBUS2: IC5.16 (Y3), IC13.16 (Y3); also elsewhere on the board
RBUS3: IC5.15 (Y4), IC13.15 (Y4); also elsewhere on the board
RBUS4: IC5.14 (Y5), IC13.14 (Y5); also elsewhere on the board
RBUS5: IC5.13 (Y6), IC13.13 (Y6); also elsewhere on the board
RBUS6: IC5.12 (Y7), IC13.12 (Y7); also elsewhere on the board
RBUS7: IC2.10 (B), IC5.11 (Y8), IC13.11 (Y8); also elsewhere on the board
RBUS8: IC14.18 (Y1); also elsewhere on the board
RBUS9: IC14.17 (Y2); also elsewhere on the board
RBUS10: IC14.16 (Y3); also elsewhere on the board
RBUS11: IC14.15 (Y4); also elsewhere on the board
RBUS12: IC14.14 (Y5); also elsewhere on the board
RBUS13: IC14.13 (Y6); also elsewhere on the board
RBUS14: IC14.12 (Y7); also elsewhere on the board
RBUS15: IC8.10 (B), IC14.11 (Y8); also elsewhere on the board
RST: IC10.15 (CLR); also elsewhere on the board

Notes on the sheet:
Control (MSW, ALU flags)
2.0
Dawid Pilawa
(C) 2010-2016
CPU.4
