dpilawa/bytec/eagle/4_cpu_control.brd

## EAGLE design eagle/4_cpu_control.brd (continued)

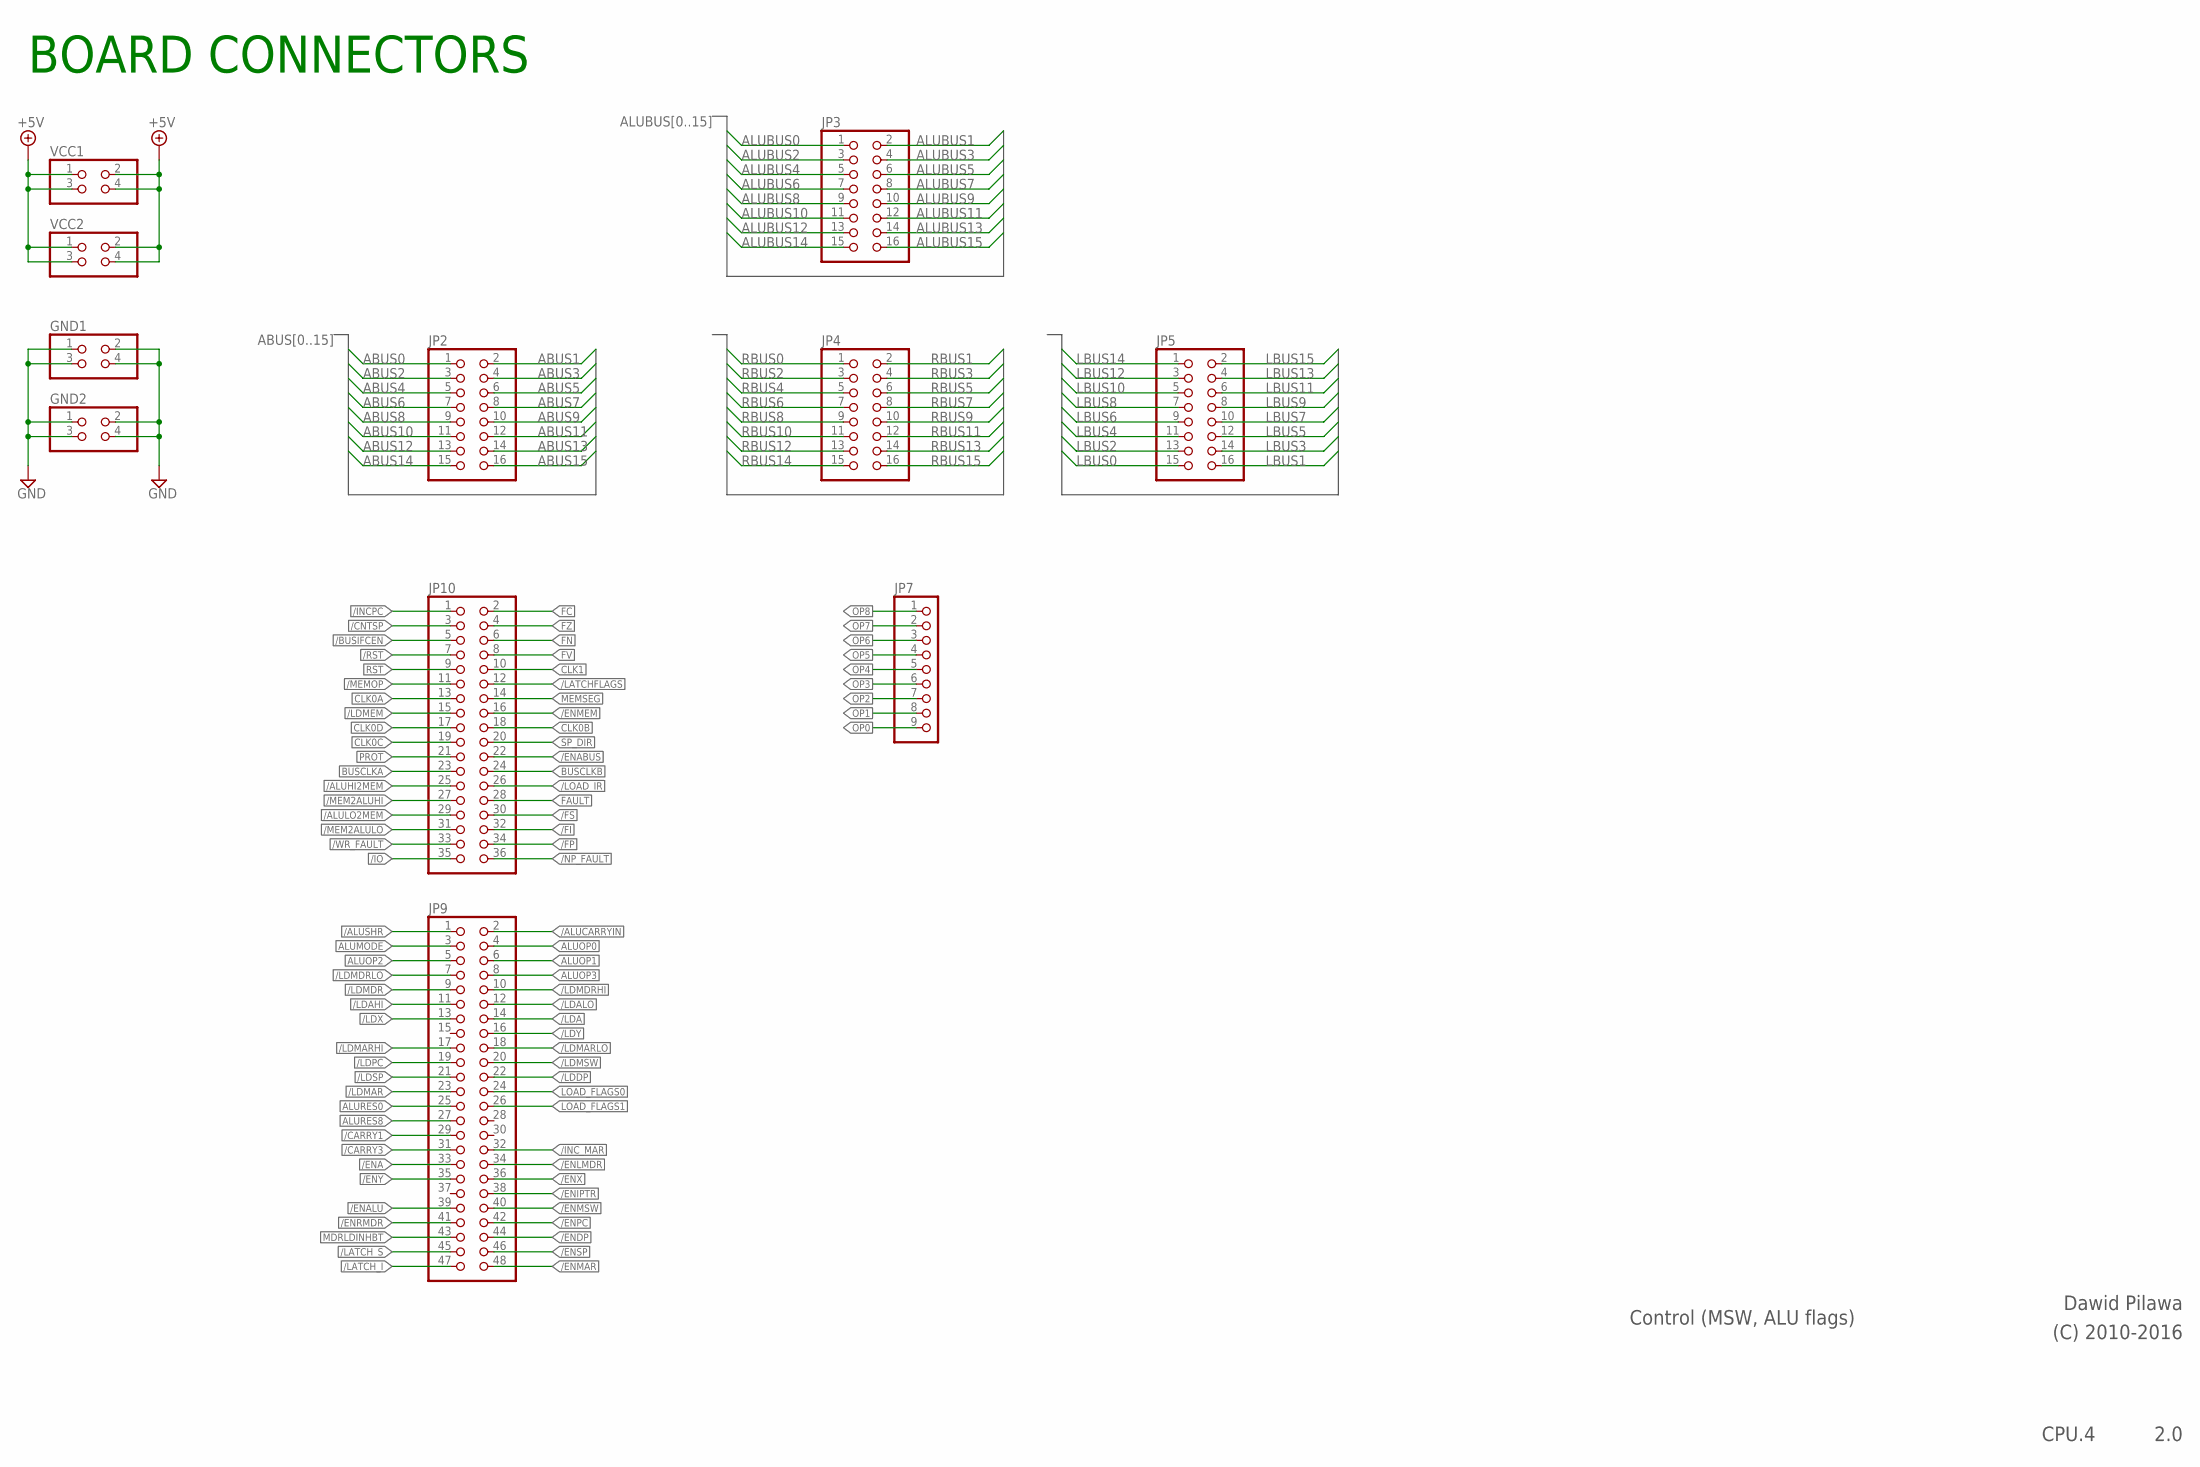
[picture p108: schematic 4_cpu_control.sch, sheet 2]

Parts:
GND1, GND2: PINHD-2X2; 2X02
JP2, JP3, JP4, JP5: PINHD-2X8; 2X08
JP7: PINHD-1X9; 1X09
JP9: PINHD-2X24; 2X24
JP10: PINHD-2X18; 2X18
VCC1, VCC2: PINHD-2X2; 2X02

Connections:
+5V: VCC1.1, VCC1.2, VCC1.3, VCC1.4, VCC2.1, VCC2.2, VCC2.3, VCC2.4; also elsewhere on the board
/ALUCARRYIN: JP9.2
/ALUHI2MEM: JP10.25
/ALULO2MEM: JP10.29
/ALUSHR: JP9.1; also elsewhere on the board
/BUSIFCEN: JP10.5
/CARRY1: JP9.29; also elsewhere on the board
/CARRY3: JP9.31; also elsewhere on the board
/CNTSP: JP10.3
/ENA: JP9.33
/ENABUS: JP10.22
/ENALU: JP9.39
/ENDP: JP9.44
/ENIPTR: JP9.38; also elsewhere on the board
/ENLMDR: JP9.34
/ENMAR: JP9.48
/ENMEM: JP10.16
/ENMSW: JP9.40; also elsewhere on the board
/ENPC: JP9.42
/ENRMDR: JP9.41
/ENSP: JP9.46
/ENX: JP9.36
/ENY: JP9.35
/FI: JP10.32; also elsewhere on the board
/FP: JP10.34; also elsewhere on the board
/FS: JP10.30; also elsewhere on the board
/INCPC: JP10.1
/INC_MAR: JP9.32
/IO: JP10.35
/LATCHFLAGS: JP10.12
/LATCH_I: JP9.47; also elsewhere on the board
/LATCH_S: JP9.45; also elsewhere on the board
/LDA: JP9.14
/LDAHI: JP9.11
/LDALO: JP9.12
/LDDP: JP9.22
/LDMAR: JP9.23
/LDMARHI: JP9.17
/LDMARLO: JP9.18
/LDMDR: JP9.9
/LDMDRHI: JP9.10
/LDMDRLO: JP9.7
/LDMEM: JP10.15
/LDMSW: JP9.20; also elsewhere on the board
/LDPC: JP9.19
/LDSP: JP9.21
/LDX: JP9.13
/LDY: JP9.16
/LOAD_IR: JP10.26
/MEM2ALUHI: JP10.27
/MEM2ALULO: JP10.31
/MEMOP: JP10.11
/NP_FAULT: JP10.36
/RST: JP10.7; also elsewhere on the board
/WR_FAULT: JP10.33
ABUS0: JP2.1
ABUS1: JP2.2
ABUS2: JP2.3
ABUS3: JP2.4
ABUS4: JP2.5
ABUS5: JP2.6
ABUS6: JP2.7
ABUS7: JP2.8
ABUS8: JP2.9
ABUS9: JP2.10
ABUS10: JP2.11
ABUS11: JP2.12
ABUS12: JP2.13
ABUS13: JP2.14
ABUS14: JP2.15
ABUS15: JP2.16
ALUBUS0: JP3.1; also elsewhere on the board
ALUBUS1: JP3.2; also elsewhere on the board
ALUBUS2: JP3.3; also elsewhere on the board
ALUBUS3: JP3.4; also elsewhere on the board
ALUBUS4: JP3.5; also elsewhere on the board
ALUBUS5: JP3.6; also elsewhere on the board
ALUBUS6: JP3.7; also elsewhere on the board
ALUBUS7: JP3.8; also elsewhere on the board
ALUBUS8: JP3.9; also elsewhere on the board
ALUBUS9: JP3.10; also elsewhere on the board
ALUBUS10: JP3.11; also elsewhere on the board
ALUBUS11: JP3.12; also elsewhere on the board
ALUBUS12: JP3.13; also elsewhere on the board
ALUBUS13: JP3.14; also elsewhere on the board
ALUBUS14: JP3.15; also elsewhere on the board
ALUBUS15: JP3.16; also elsewhere on the board
ALUMODE: JP9.3
ALUOP0: JP9.4
ALUOP1: JP9.6; also elsewhere on the board
ALUOP2: JP9.5
ALUOP3: JP9.8
ALURES0: JP9.25; also elsewhere on the board
ALURES8: JP9.27; also elsewhere on the board
BUSCLKA: JP10.23
BUSCLKB: JP10.24; also elsewhere on the board
CLK0A: JP10.13
CLK0B: JP10.18
CLK0C: JP10.19
CLK0D: JP10.17; also elsewhere on the board
CLK1: JP10.10
FAULT: JP10.28
FC: JP10.2; also elsewhere on the board
FN: JP10.6; also elsewhere on the board
FV: JP10.8; also elsewhere on the board
FZ: JP10.4; also elsewhere on the board
GND: GND1.1, GND1.2, GND1.3, GND1.4, GND2.1, GND2.2, GND2.3, GND2.4; also elsewhere on the board
LBUS0: JP5.15
LBUS1: JP5.16
LBUS2: JP5.13
LBUS3: JP5.14
LBUS4: JP5.11
LBUS5: JP5.12
LBUS6: JP5.9
LBUS7: JP5.10; also elsewhere on the board
LBUS8: JP5.7
LBUS9: JP5.8
LBUS10: JP5.5
LBUS11: JP5.6
LBUS12: JP5.3
LBUS13: JP5.4
LBUS14: JP5.1
LBUS15: JP5.2; also elsewhere on the board
LOAD_FLAGS0: JP9.24; also elsewhere on the board
LOAD_FLAGS1: JP9.26; also elsewhere on the board
MDRLDINHBT: JP9.43
MEMSEG: JP10.14
OP0: JP7.9; also elsewhere on the board
OP1: JP7.8; also elsewhere on the board
OP2: JP7.7; also elsewhere on the board
OP3: JP7.6; also elsewhere on the board
OP4: JP7.5
OP5: JP7.4
OP6: JP7.3
OP7: JP7.2
OP8: JP7.1
PROT: JP10.21
RBUS0: JP4.1; also elsewhere on the board
RBUS1: JP4.2; also elsewhere on the board
RBUS2: JP4.3; also elsewhere on the board
RBUS3: JP4.4; also elsewhere on the board
RBUS4: JP4.5; also elsewhere on the board
RBUS5: JP4.6; also elsewhere on the board
RBUS6: JP4.7; also elsewhere on the board
RBUS7: JP4.8; also elsewhere on the board
RBUS8: JP4.9; also elsewhere on the board
RBUS9: JP4.10; also elsewhere on the board
RBUS10: JP4.11; also elsewhere on the board
RBUS11: JP4.12; also elsewhere on the board
RBUS12: JP4.13; also elsewhere on the board
RBUS13: JP4.14; also elsewhere on the board
RBUS14: JP4.15; also elsewhere on the board
RBUS15: JP4.16; also elsewhere on the board
RST: JP10.9; also elsewhere on the board
SP_DIR: JP10.20

Notes on the sheet:
Control (MSW, ALU flags)
2.0
Dawid Pilawa
(C) 2010-2016
CPU.4
BOARD CONNECTORS

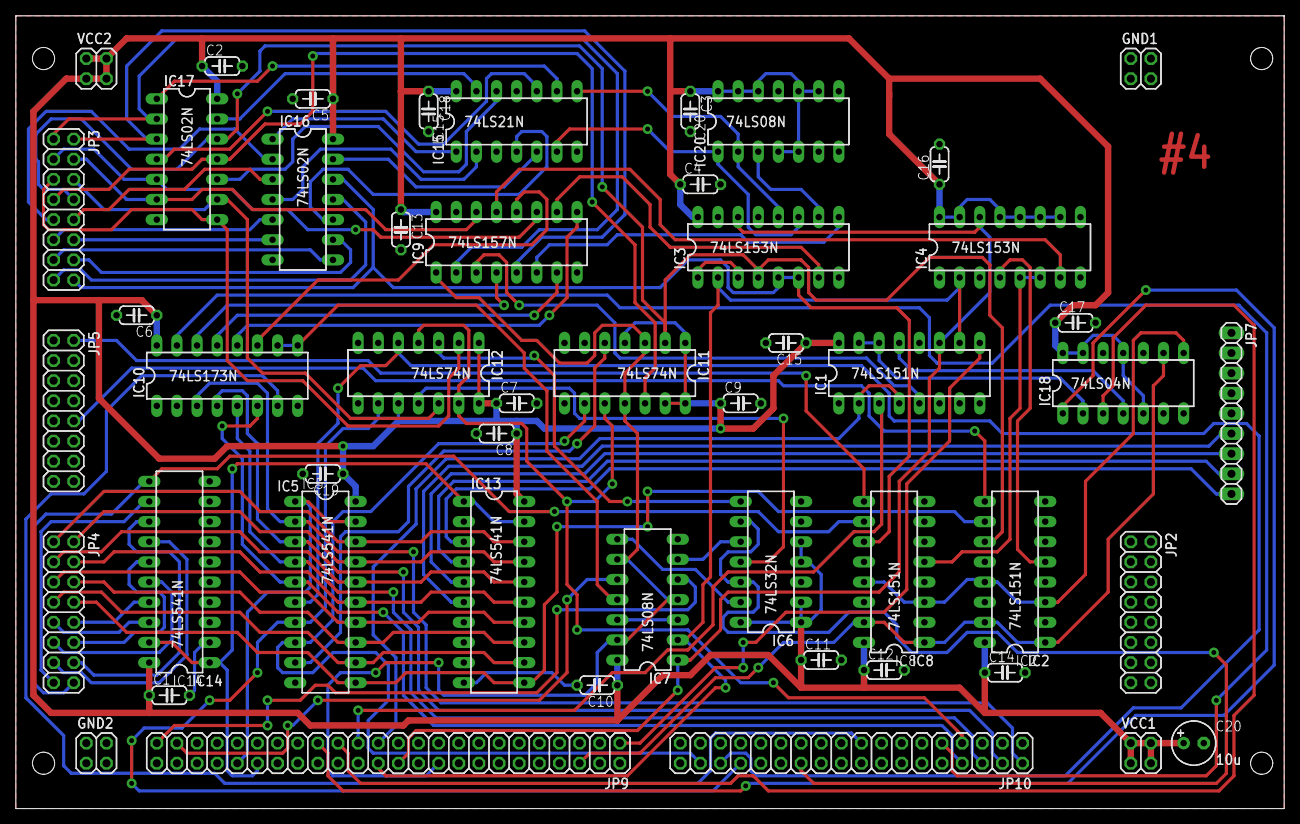
[picture p109: board 4_cpu_control.brd from above]

Board: 2 copper layers, 160.0 x 100.0 mm, 50 parts (0 on the bottom side), 95 nets.
