dpilawa/bytec/eagle/6_cpu_registers_a.brd

## EAGLE design eagle/6_cpu_registers_a.brd (2016-02-10)

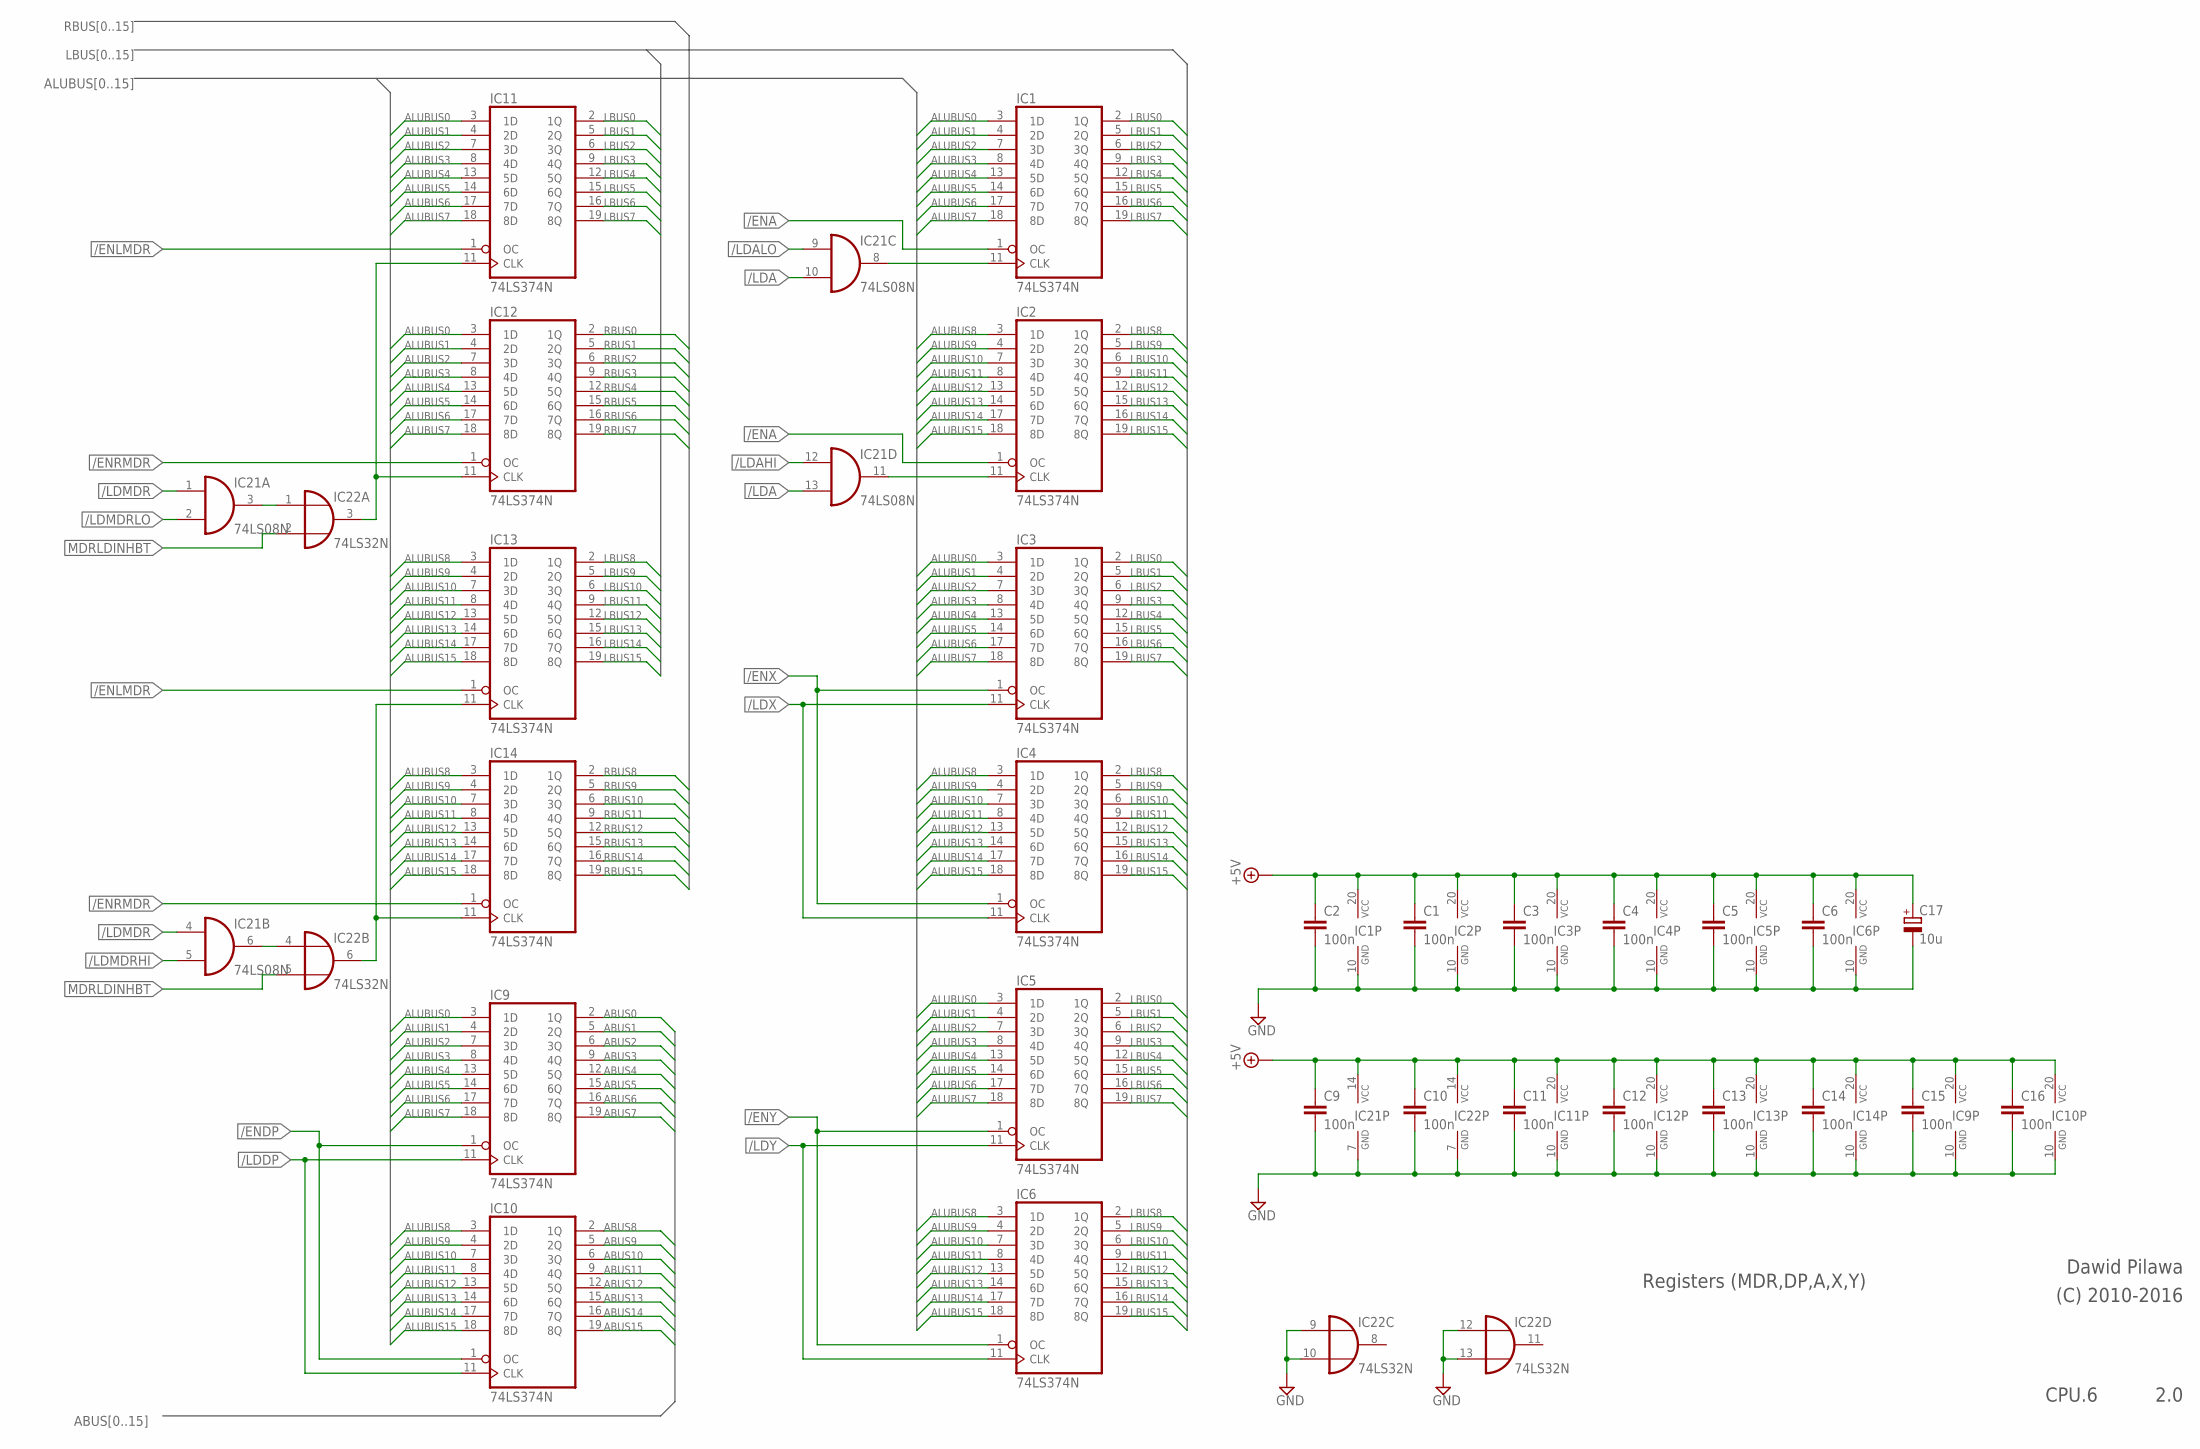
[picture p113: schematic 6_cpu_registers_a.sch, sheet 1]

Parts:
C1, C2, C3, C4, C5, C6, C9, C10, C11, C12, C13, C14, C15, C16: 100n; C050-024X044
C17: 10u; E2,5-6
IC1, IC2, IC3, IC4, IC5, IC6, IC9, IC10, IC11, IC12, IC13, IC14: 74LS374N; DIL20
IC21: 74LS08N; DIL14
IC22: 74LS32N; DIL14

Connections:
+5V: C1.1, C2.1, C3.1, C4.1, C5.1, C6.1, C9.1, C10.1, C11.1, C12.1, C13.1, C14.1, C15.1, C16.1, C17.+, IC1.20 (VCC), IC2.20 (VCC), IC3.20 (VCC), IC4.20 (VCC), IC5.20 (VCC), IC6.20 (VCC), IC9.20 (VCC), IC10.20 (VCC), IC11.20 (VCC), IC12.20 (VCC), IC13.20 (VCC), IC14.20 (VCC), IC21.14 (VCC), IC22.14 (VCC); also elsewhere on the board
/ENA: IC1.1 (OC), IC2.1 (OC); also elsewhere on the board
/ENDP: IC9.1 (OC), IC10.1 (OC); also elsewhere on the board
/ENLMDR: IC11.1 (OC), IC13.1 (OC); also elsewhere on the board
/ENRMDR: IC12.1 (OC), IC14.1 (OC); also elsewhere on the board
/ENX: IC3.1 (OC), IC4.1 (OC); also elsewhere on the board
/ENY: IC5.1 (OC), IC6.1 (OC); also elsewhere on the board
/LDA: IC21.10 (I1), IC21.13 (I1); also elsewhere on the board
/LDAHI: IC21.12 (I0); also elsewhere on the board
/LDALO: IC21.9 (I0); also elsewhere on the board
/LDDP: IC9.11 (CLK), IC10.11 (CLK); also elsewhere on the board
/LDMDR: IC21.1 (I0), IC21.4 (I0); also elsewhere on the board
/LDMDRHI: IC21.5 (I1); also elsewhere on the board
/LDMDRLO: IC21.2 (I1); also elsewhere on the board
/LDX: IC3.11 (CLK), IC4.11 (CLK); also elsewhere on the board
/LDY: IC5.11 (CLK), IC6.11 (CLK); also elsewhere on the board
ABUS0: IC9.2 (1Q); also elsewhere on the board
ABUS1: IC9.5 (2Q); also elsewhere on the board
ABUS2: IC9.6 (3Q); also elsewhere on the board
ABUS3: IC9.9 (4Q); also elsewhere on the board
ABUS4: IC9.12 (5Q); also elsewhere on the board
ABUS5: IC9.15 (6Q); also elsewhere on the board
ABUS6: IC9.16 (7Q); also elsewhere on the board
ABUS7: IC9.19 (8Q); also elsewhere on the board
ABUS8: IC10.2 (1Q); also elsewhere on the board
ABUS9: IC10.5 (2Q); also elsewhere on the board
ABUS10: IC10.6 (3Q); also elsewhere on the board
ABUS11: IC10.9 (4Q); also elsewhere on the board
ABUS12: IC10.12 (5Q); also elsewhere on the board
ABUS13: IC10.15 (6Q); also elsewhere on the board
ABUS14: IC10.16 (7Q); also elsewhere on the board
ABUS15: IC10.19 (8Q); also elsewhere on the board
ALUBUS0: IC1.3 (1D), IC3.3 (1D), IC5.3 (1D), IC9.3 (1D), IC11.3 (1D), IC12.3 (1D); also elsewhere on the board
ALUBUS1: IC1.4 (2D), IC3.4 (2D), IC5.4 (2D), IC9.4 (2D), IC11.4 (2D), IC12.4 (2D); also elsewhere on the board
ALUBUS2: IC1.7 (3D), IC3.7 (3D), IC5.7 (3D), IC9.7 (3D), IC11.7 (3D), IC12.7 (3D); also elsewhere on the board
ALUBUS3: IC1.8 (4D), IC3.8 (4D), IC5.8 (4D), IC9.8 (4D), IC11.8 (4D), IC12.8 (4D); also elsewhere on the board
ALUBUS4: IC1.13 (5D), IC3.13 (5D), IC5.13 (5D), IC9.13 (5D), IC11.13 (5D), IC12.13 (5D); also elsewhere on the board
ALUBUS5: IC1.14 (6D), IC3.14 (6D), IC5.14 (6D), IC9.14 (6D), IC11.14 (6D), IC12.14 (6D); also elsewhere on the board
ALUBUS6: IC1.17 (7D), IC3.17 (7D), IC5.17 (7D), IC9.17 (7D), IC11.17 (7D), IC12.17 (7D); also elsewhere on the board
ALUBUS7: IC1.18 (8D), IC3.18 (8D), IC5.18 (8D), IC9.18 (8D), IC11.18 (8D), IC12.18 (8D); also elsewhere on the board
ALUBUS8: IC2.3 (1D), IC4.3 (1D), IC6.3 (1D), IC10.3 (1D), IC13.3 (1D), IC14.3 (1D); also elsewhere on the board
ALUBUS9: IC2.4 (2D), IC4.4 (2D), IC6.4 (2D), IC10.4 (2D), IC13.4 (2D), IC14.4 (2D); also elsewhere on the board
ALUBUS10: IC2.7 (3D), IC4.7 (3D), IC6.7 (3D), IC10.7 (3D), IC13.7 (3D), IC14.7 (3D); also elsewhere on the board
ALUBUS11: IC2.8 (4D), IC4.8 (4D), IC6.8 (4D), IC10.8 (4D), IC13.8 (4D), IC14.8 (4D); also elsewhere on the board
ALUBUS12: IC2.13 (5D), IC4.13 (5D), IC6.13 (5D), IC10.13 (5D), IC13.13 (5D), IC14.13 (5D); also elsewhere on the board
ALUBUS13: IC2.14 (6D), IC4.14 (6D), IC6.14 (6D), IC10.14 (6D), IC13.14 (6D), IC14.14 (6D); also elsewhere on the board
ALUBUS14: IC2.17 (7D), IC4.17 (7D), IC6.17 (7D), IC10.17 (7D), IC13.17 (7D), IC14.17 (7D); also elsewhere on the board
ALUBUS15: IC2.18 (8D), IC4.18 (8D), IC6.18 (8D), IC10.18 (8D), IC13.18 (8D), IC14.18 (8D); also elsewhere on the board
GND: C1.2, C2.2, C3.2, C4.2, C5.2, C6.2, C9.2, C10.2, C11.2, C12.2, C13.2, C14.2, C15.2, C16.2, C17.-, IC1.10 (GND), IC2.10 (GND), IC3.10 (GND), IC4.10 (GND), IC5.10 (GND), IC6.10 (GND), IC9.10 (GND), IC10.10 (GND), IC11.10 (GND), IC12.10 (GND), IC13.10 (GND), IC14.10 (GND), IC21.7 (GND), IC22.7 (GND), IC22.9 (I0), IC22.10 (I1), IC22.12 (I0), IC22.13 (I1); also elsewhere on the board
LBUS0: IC1.2 (1Q), IC3.2 (1Q), IC5.2 (1Q), IC11.2 (1Q); also elsewhere on the board
LBUS1: IC1.5 (2Q), IC3.5 (2Q), IC5.5 (2Q), IC11.5 (2Q); also elsewhere on the board
LBUS2: IC1.6 (3Q), IC3.6 (3Q), IC5.6 (3Q), IC11.6 (3Q); also elsewhere on the board
LBUS3: IC1.9 (4Q), IC3.9 (4Q), IC5.9 (4Q), IC11.9 (4Q); also elsewhere on the board
LBUS4: IC1.12 (5Q), IC3.12 (5Q), IC5.12 (5Q), IC11.12 (5Q); also elsewhere on the board
LBUS5: IC1.15 (6Q), IC3.15 (6Q), IC5.15 (6Q), IC11.15 (6Q); also elsewhere on the board
LBUS6: IC1.16 (7Q), IC3.16 (7Q), IC5.16 (7Q), IC11.16 (7Q); also elsewhere on the board
LBUS7: IC1.19 (8Q), IC3.19 (8Q), IC5.19 (8Q), IC11.19 (8Q); also elsewhere on the board
LBUS8: IC2.2 (1Q), IC4.2 (1Q), IC6.2 (1Q), IC13.2 (1Q); also elsewhere on the board
LBUS9: IC2.5 (2Q), IC4.5 (2Q), IC6.5 (2Q), IC13.5 (2Q); also elsewhere on the board
LBUS10: IC2.6 (3Q), IC4.6 (3Q), IC6.6 (3Q), IC13.6 (3Q); also elsewhere on the board
LBUS11: IC2.9 (4Q), IC4.9 (4Q), IC6.9 (4Q), IC13.9 (4Q); also elsewhere on the board
LBUS12: IC2.12 (5Q), IC4.12 (5Q), IC6.12 (5Q), IC13.12 (5Q); also elsewhere on the board
LBUS13: IC2.15 (6Q), IC4.15 (6Q), IC6.15 (6Q), IC13.15 (6Q); also elsewhere on the board
LBUS14: IC2.16 (7Q), IC4.16 (7Q), IC6.16 (7Q), IC13.16 (7Q); also elsewhere on the board
LBUS15: IC2.19 (8Q), IC4.19 (8Q), IC6.19 (8Q), IC13.19 (8Q); also elsewhere on the board
MDRLDINHBT: IC22.2 (I1), IC22.5 (I1); also elsewhere on the board
unnamed: IC11.11 (CLK), IC12.11 (CLK), IC22.3 (O)
unnamed: IC21.3 (O), IC22.1 (I0)
unnamed: IC21.6 (O), IC22.4 (I0)
unnamed: IC13.11 (CLK), IC14.11 (CLK), IC22.6 (O)
unnamed: IC1.11 (CLK), IC21.8 (O)
unnamed: IC2.11 (CLK), IC21.11 (O)
RBUS0: IC12.2 (1Q); also elsewhere on the board
RBUS1: IC12.5 (2Q); also elsewhere on the board
RBUS2: IC12.6 (3Q); also elsewhere on the board
RBUS3: IC12.9 (4Q); also elsewhere on the board
RBUS4: IC12.12 (5Q); also elsewhere on the board
RBUS5: IC12.15 (6Q); also elsewhere on the board
RBUS6: IC12.16 (7Q); also elsewhere on the board
RBUS7: IC12.19 (8Q); also elsewhere on the board
RBUS8: IC14.2 (1Q); also elsewhere on the board
RBUS9: IC14.5 (2Q); also elsewhere on the board
RBUS10: IC14.6 (3Q); also elsewhere on the board
RBUS11: IC14.9 (4Q); also elsewhere on the board
RBUS12: IC14.12 (5Q); also elsewhere on the board
RBUS13: IC14.15 (6Q); also elsewhere on the board
RBUS14: IC14.16 (7Q); also elsewhere on the board
RBUS15: IC14.19 (8Q); also elsewhere on the board

Notes on the sheet:
Registers (MDR,DP,A,X,Y)
Dawid Pilawa
(C) 2010-2016
CPU.6
2.0

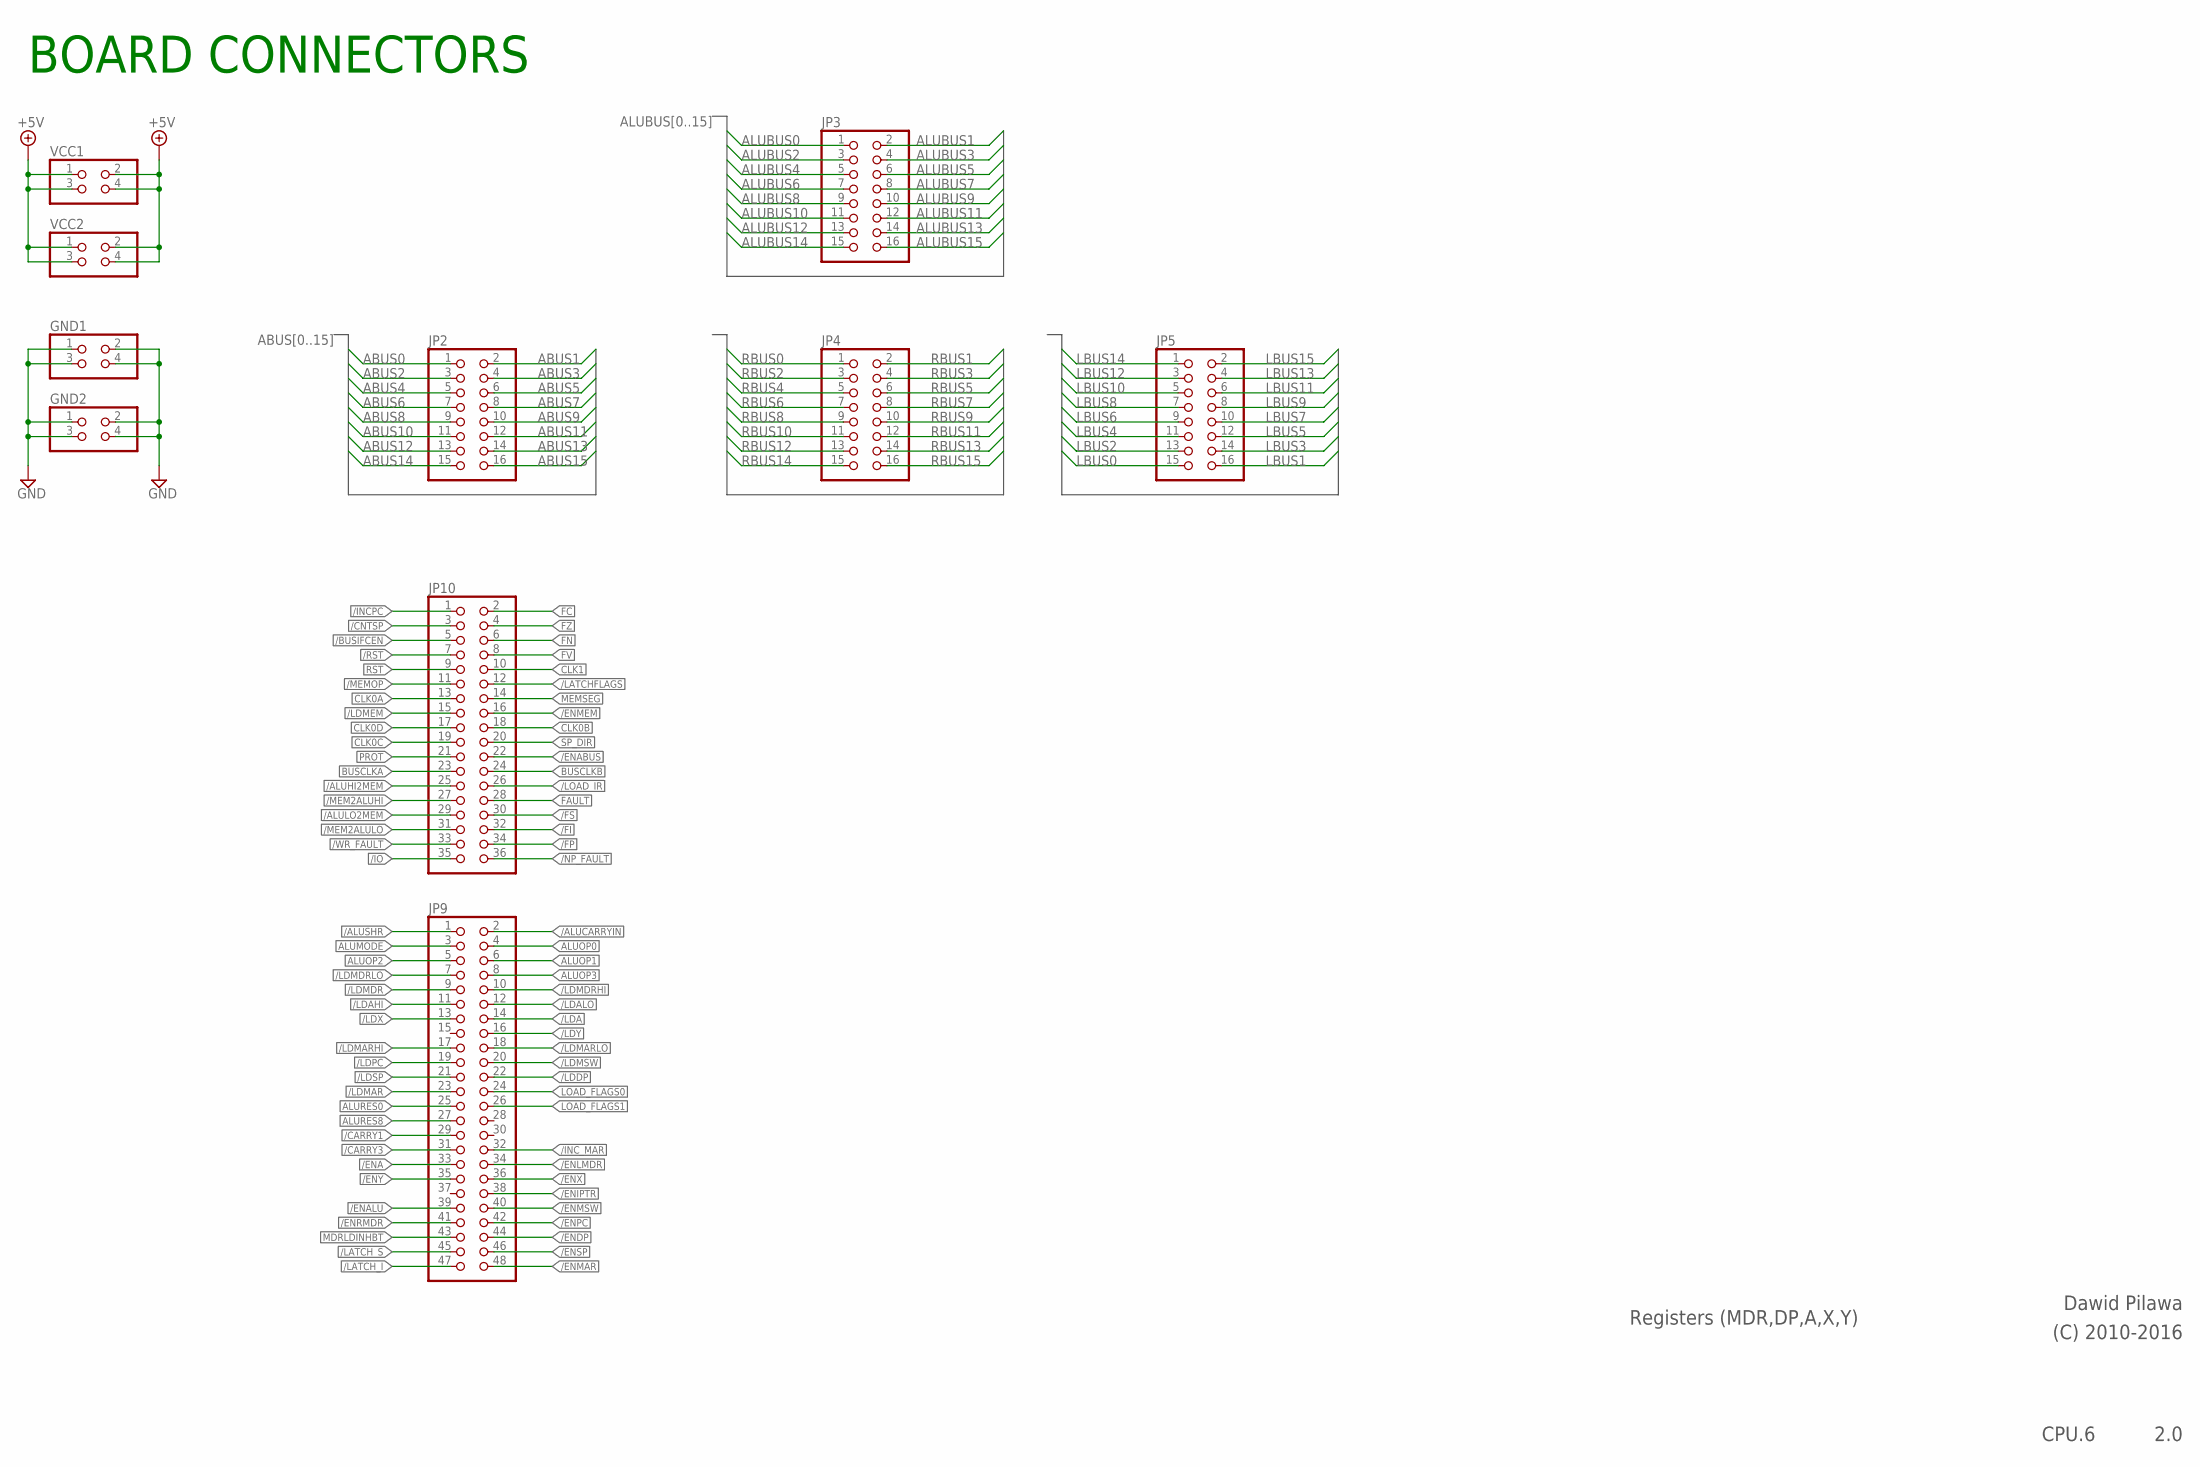
[picture p114: schematic 6_cpu_registers_a.sch, sheet 2]

Parts:
GND1, GND2: PINHD-2X2; 2X02
JP2, JP3, JP4, JP5: PINHD-2X8; 2X08
JP9: PINHD-2X24; 2X24
JP10: PINHD-2X18; 2X18
VCC1, VCC2: PINHD-2X2; 2X02

Connections:
+5V: VCC1.1, VCC1.2, VCC1.3, VCC1.4, VCC2.1, VCC2.2, VCC2.3, VCC2.4; also elsewhere on the board
/ALUCARRYIN: JP9.2
/ALUHI2MEM: JP10.25
/ALULO2MEM: JP10.29
/ALUSHR: JP9.1
/BUSIFCEN: JP10.5
/CARRY1: JP9.29
/CARRY3: JP9.31
/CNTSP: JP10.3
/ENA: JP9.33; also elsewhere on the board
/ENABUS: JP10.22
/ENALU: JP9.39
/ENDP: JP9.44; also elsewhere on the board
/ENIPTR: JP9.38
/ENLMDR: JP9.34; also elsewhere on the board
/ENMAR: JP9.48
/ENMEM: JP10.16
/ENMSW: JP9.40
/ENPC: JP9.42
/ENRMDR: JP9.41; also elsewhere on the board
/ENSP: JP9.46
/ENX: JP9.36; also elsewhere on the board
/ENY: JP9.35; also elsewhere on the board
/FI: JP10.32
/FP: JP10.34
/FS: JP10.30
/INCPC: JP10.1
/INC_MAR: JP9.32
/IO: JP10.35
/LATCHFLAGS: JP10.12
/LATCH_I: JP9.47
/LATCH_S: JP9.45
/LDA: JP9.14; also elsewhere on the board
/LDAHI: JP9.11; also elsewhere on the board
/LDALO: JP9.12; also elsewhere on the board
/LDDP: JP9.22; also elsewhere on the board
/LDMAR: JP9.23
/LDMARHI: JP9.17
/LDMARLO: JP9.18
/LDMDR: JP9.9; also elsewhere on the board
/LDMDRHI: JP9.10; also elsewhere on the board
/LDMDRLO: JP9.7; also elsewhere on the board
/LDMEM: JP10.15
/LDMSW: JP9.20
/LDPC: JP9.19
/LDSP: JP9.21
/LDX: JP9.13; also elsewhere on the board
/LDY: JP9.16; also elsewhere on the board
/LOAD_IR: JP10.26
/MEM2ALUHI: JP10.27
/MEM2ALULO: JP10.31
/MEMOP: JP10.11
/NP_FAULT: JP10.36
/RST: JP10.7
/WR_FAULT: JP10.33
ABUS0: JP2.1; also elsewhere on the board
ABUS1: JP2.2; also elsewhere on the board
ABUS2: JP2.3; also elsewhere on the board
ABUS3: JP2.4; also elsewhere on the board
ABUS4: JP2.5; also elsewhere on the board
ABUS5: JP2.6; also elsewhere on the board
ABUS6: JP2.7; also elsewhere on the board
ABUS7: JP2.8; also elsewhere on the board
ABUS8: JP2.9; also elsewhere on the board
ABUS9: JP2.10; also elsewhere on the board
ABUS10: JP2.11; also elsewhere on the board
ABUS11: JP2.12; also elsewhere on the board
ABUS12: JP2.13; also elsewhere on the board
ABUS13: JP2.14; also elsewhere on the board
ABUS14: JP2.15; also elsewhere on the board
ABUS15: JP2.16; also elsewhere on the board
ALUBUS0: JP3.1; also elsewhere on the board
ALUBUS1: JP3.2; also elsewhere on the board
ALUBUS2: JP3.3; also elsewhere on the board
ALUBUS3: JP3.4; also elsewhere on the board
ALUBUS4: JP3.5; also elsewhere on the board
ALUBUS5: JP3.6; also elsewhere on the board
ALUBUS6: JP3.7; also elsewhere on the board
ALUBUS7: JP3.8; also elsewhere on the board
ALUBUS8: JP3.9; also elsewhere on the board
ALUBUS9: JP3.10; also elsewhere on the board
ALUBUS10: JP3.11; also elsewhere on the board
ALUBUS11: JP3.12; also elsewhere on the board
ALUBUS12: JP3.13; also elsewhere on the board
ALUBUS13: JP3.14; also elsewhere on the board
ALUBUS14: JP3.15; also elsewhere on the board
ALUBUS15: JP3.16; also elsewhere on the board
ALUMODE: JP9.3
ALUOP0: JP9.4
ALUOP1: JP9.6
ALUOP2: JP9.5
ALUOP3: JP9.8
ALURES0: JP9.25
ALURES8: JP9.27
BUSCLKA: JP10.23
BUSCLKB: JP10.24
CLK0A: JP10.13
CLK0B: JP10.18
CLK0C: JP10.19
CLK0D: JP10.17
CLK1: JP10.10
FAULT: JP10.28
FC: JP10.2
FN: JP10.6
FV: JP10.8
FZ: JP10.4
GND: GND1.1, GND1.2, GND1.3, GND1.4, GND2.1, GND2.2, GND2.3, GND2.4; also elsewhere on the board
LBUS0: JP5.15; also elsewhere on the board
LBUS1: JP5.16; also elsewhere on the board
LBUS2: JP5.13; also elsewhere on the board
LBUS3: JP5.14; also elsewhere on the board
LBUS4: JP5.11; also elsewhere on the board
LBUS5: JP5.12; also elsewhere on the board
LBUS6: JP5.9; also elsewhere on the board
LBUS7: JP5.10; also elsewhere on the board
LBUS8: JP5.7; also elsewhere on the board
LBUS9: JP5.8; also elsewhere on the board
LBUS10: JP5.5; also elsewhere on the board
LBUS11: JP5.6; also elsewhere on the board
LBUS12: JP5.3; also elsewhere on the board
LBUS13: JP5.4; also elsewhere on the board
LBUS14: JP5.1; also elsewhere on the board
LBUS15: JP5.2; also elsewhere on the board
LOAD_FLAGS0: JP9.24
LOAD_FLAGS1: JP9.26
MDRLDINHBT: JP9.43; also elsewhere on the board
MEMSEG: JP10.14
PROT: JP10.21
RBUS0: JP4.1; also elsewhere on the board
RBUS1: JP4.2; also elsewhere on the board
RBUS2: JP4.3; also elsewhere on the board
RBUS3: JP4.4; also elsewhere on the board
RBUS4: JP4.5; also elsewhere on the board
RBUS5: JP4.6; also elsewhere on the board
RBUS6: JP4.7; also elsewhere on the board
RBUS7: JP4.8; also elsewhere on the board
RBUS8: JP4.9; also elsewhere on the board
RBUS9: JP4.10; also elsewhere on the board
RBUS10: JP4.11; also elsewhere on the board
RBUS11: JP4.12; also elsewhere on the board
RBUS12: JP4.13; also elsewhere on the board
RBUS13: JP4.14; also elsewhere on the board
RBUS14: JP4.15; also elsewhere on the board
RBUS15: JP4.16; also elsewhere on the board
RST: JP10.9
SP_DIR: JP10.20

Notes on the sheet:
Registers (MDR,DP,A,X,Y)
Dawid Pilawa
(C) 2010-2016
CPU.6
2.0
BOARD CONNECTORS

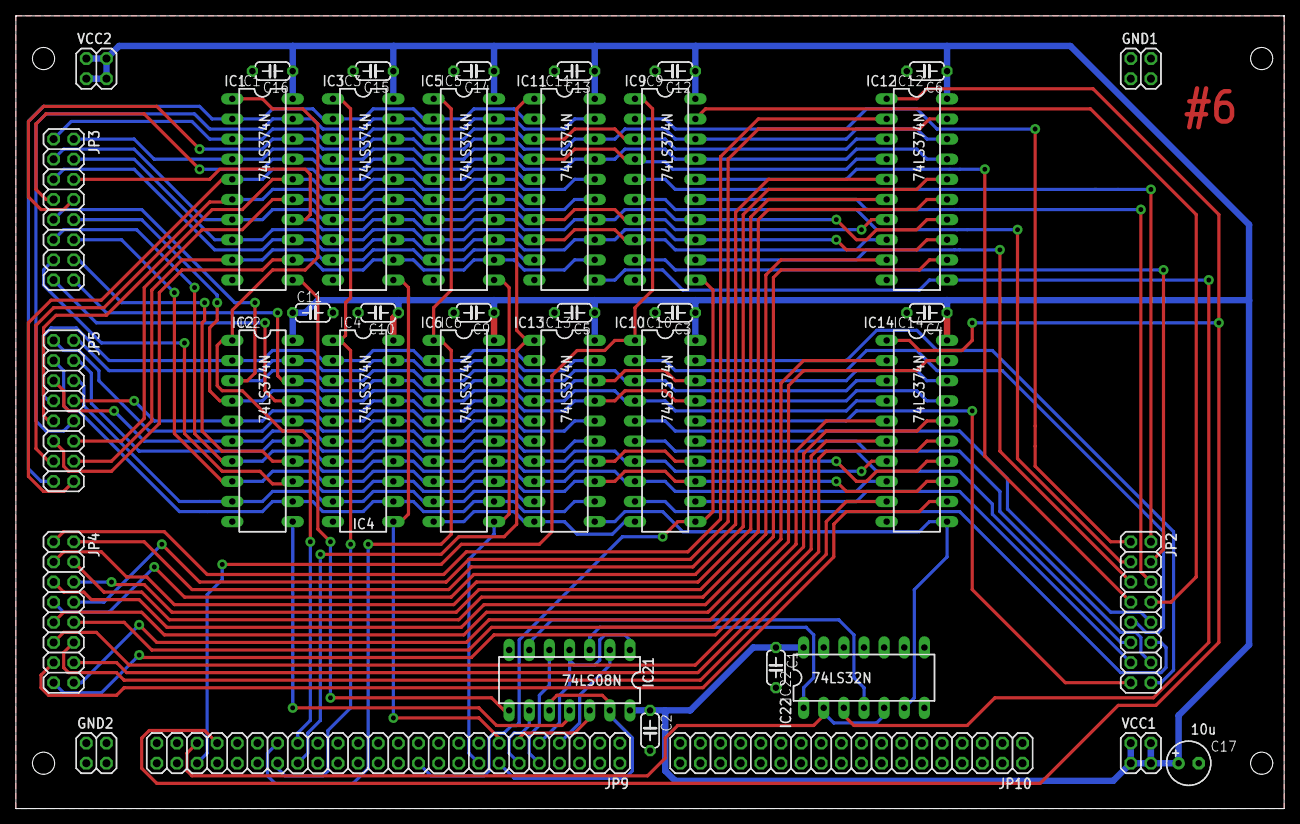
[picture p115: board 6_cpu_registers_a.brd from above]

Board: 2 copper layers, 160.0 x 100.0 mm, 39 parts (0 on the bottom side), 88 nets.
