dpilawa/bytec/lcc/bin/bytec16.c

// LCC machine description for BYTEC/16
// July 2015
// http://www.pilawa.org/computer

// Registers
enum { R_L0, R_L1, R_L2, R_L3, R_AH, R_AL, R_A, R_Y, R_X };

#include "c.h"

#define NODEPTR_TYPE Node
#define OP_LABEL(p) ((p)->op)
#define LEFT_CHILD(p) ((p)->kids[0])
#define RIGHT_CHILD(p) ((p)->kids[1])
#define STATE_LABEL(p) ((p)->x.state)

// Declare local routines to be used by IR record here
static void address(Symbol, Symbol, long);
static void blkfetch(int, int, int, int);
static void blkloop(int, int, int, int, int, int[]);
static void blkstore(int, int, int, int);
static void defaddress(Symbol);
static void defconst(int, int, Value);
static void defstring(int, char *);
static void defsymbol(Symbol);
static void doarg(Node);
static void emit2(Node);
static void export(Symbol);
static void clobber(Node);
static void function(Symbol, Symbol [], Symbol [], int);
static void global(Symbol);
static void import(Symbol);
static void local(Symbol);
static void progbeg(int, char **);
static void progend(void);
static void segment(int);
static void space(int);
static void target(Node);

static int memop(Node);
static int sametree(Node,Node);

// Local vars here

static Symbol charreg[32];
static Symbol intreg[32];
static Symbol floatreg[32];
static Symbol longreg[32];

static Symbol charwldcrd;
static Symbol intwldcrd;
static Symbol floatwldcrd;
static Symbol longwldcrd;

static int cseg;
static int used_longs;
static int used_floats;
static int ever_used_muldiv16;
static int ptr64;

/*
generated at Thu Dec 10 23:41:48 2015
by $Id: lburg.c,v 2.10 2002/03/08 18:45:21 drh Exp $
*/
static void _kids(NODEPTR_TYPE, int, NODEPTR_TYPE[]);
static void _label(NODEPTR_TYPE);
static int _rule(void*, int);

#define _stmt_NT 1
#define _reg8_NT 2
#define _reg_NT 3
#define _reg32_NT 4
#define _regf_NT 5
#define _con8_NT 6
#define _con16_NT 7
#define _con0_NT 8
#define _con1_NT 9
#define _con2_NT 10
#define _con_NT 11
#define _lgaddr_NT 12
#define _addr_NT 13
#define _albl_NT 14
#define _ar_NT 15

static char *_ntname[] = {
	0,
	"stmt",
	"reg8",
	"reg",
	"reg32",
	"regf",
	"con8",
	"con16",
	"con0",
	"con1",
	"con2",
	"con",
	"lgaddr",
	"addr",
	"albl",
	"ar",
	0
};

struct _state {
	short cost[16];
	struct {
		unsigned int _stmt:8;
		unsigned int _reg8:7;
		unsigned int _reg:7;
		unsigned int _reg32:6;
		unsigned int _regf:6;
		unsigned int _con8:2;
		unsigned int _con16:2;
		unsigned int _con0:3;
		unsigned int _con1:3;
		unsigned int _con2:3;
		unsigned int _con:2;
		unsigned int _lgaddr:2;
		unsigned int _addr:3;
		unsigned int _albl:1;
		unsigned int _ar:2;
	} rule;
};

static short _nts_0[] = { 0 };
static short _nts_1[] = { _reg8_NT, 0 };
static short _nts_2[] = { _reg_NT, 0 };
static short _nts_3[] = { _reg32_NT, 0 };
static short _nts_4[] = { _regf_NT, 0 };
static short _nts_5[] = { _con8_NT, 0 };
static short _nts_6[] = { _con16_NT, 0 };
static short _nts_7[] = { _con_NT, 0 };
static short _nts_8[] = { _con0_NT, 0 };
static short _nts_9[] = { _lgaddr_NT, 0 };
static short _nts_10[] = { _reg_NT, _con_NT, 0 };
static short _nts_11[] = { _albl_NT, 0 };
static short _nts_12[] = { _addr_NT, _reg8_NT, 0 };
static short _nts_13[] = { _addr_NT, _reg_NT, 0 };
static short _nts_14[] = { _reg_NT, _reg_NT, 0 };
static short _nts_15[] = { _lgaddr_NT, _reg32_NT, 0 };
static short _nts_16[] = { _lgaddr_NT, _lgaddr_NT, 0 };
static short _nts_17[] = { _lgaddr_NT, _regf_NT, 0 };
static short _nts_18[] = { _addr_NT, 0 };
static short _nts_19[] = { _reg_NT, _addr_NT, 0 };
static short _nts_20[] = { _reg8_NT, _addr_NT, 0 };
static short _nts_21[] = { _reg8_NT, _con_NT, 0 };
static short _nts_22[] = { _reg32_NT, _reg32_NT, 0 };
static short _nts_23[] = { _reg32_NT, _lgaddr_NT, 0 };
static short _nts_24[] = { _regf_NT, _regf_NT, 0 };
static short _nts_25[] = { _regf_NT, _lgaddr_NT, 0 };
static short _nts_26[] = { _lgaddr_NT, _lgaddr_NT, _lgaddr_NT, 0 };
static short _nts_27[] = { _reg_NT, _lgaddr_NT, 0 };
static short _nts_28[] = { _reg8_NT, _lgaddr_NT, 0 };
static short _nts_29[] = { _reg_NT, _con1_NT, 0 };
static short _nts_30[] = { _reg_NT, _con2_NT, 0 };
static short _nts_31[] = { _reg32_NT, _con1_NT, 0 };
static short _nts_32[] = { _ar_NT, 0 };

static short *_nts[] = {
	0,	/* 0 */
	_nts_0,	/* 1 */
	_nts_0,	/* 2 */
	_nts_0,	/* 3 */
	_nts_0,	/* 4 */
	_nts_0,	/* 5 */
	_nts_0,	/* 6 */
	_nts_0,	/* 7 */
	_nts_0,	/* 8 */
	_nts_0,	/* 9 */
	_nts_1,	/* 10 */
	_nts_1,	/* 11 */
	_nts_2,	/* 12 */
	_nts_2,	/* 13 */
	_nts_3,	/* 14 */
	_nts_3,	/* 15 */
	_nts_2,	/* 16 */
	_nts_4,	/* 17 */
	_nts_4,	/* 18 */
	_nts_1,	/* 19 */
	_nts_2,	/* 20 */
	_nts_3,	/* 21 */
	_nts_4,	/* 22 */
	_nts_1,	/* 23 */
	_nts_1,	/* 24 */
	_nts_2,	/* 25 */
	_nts_2,	/* 26 */
	_nts_2,	/* 27 */
	_nts_2,	/* 28 */
	_nts_2,	/* 29 */
	_nts_3,	/* 30 */
	_nts_3,	/* 31 */
	_nts_4,	/* 32 */
	_nts_4,	/* 33 */
	_nts_1,	/* 34 */
	_nts_1,	/* 35 */
	_nts_3,	/* 36 */
	_nts_3,	/* 37 */
	_nts_3,	/* 38 */
	_nts_3,	/* 39 */
	_nts_0,	/* 40 */
	_nts_0,	/* 41 */
	_nts_0,	/* 42 */
	_nts_0,	/* 43 */
	_nts_0,	/* 44 */
	_nts_0,	/* 45 */
	_nts_0,	/* 46 */
	_nts_0,	/* 47 */
	_nts_0,	/* 48 */
	_nts_0,	/* 49 */
	_nts_0,	/* 50 */
	_nts_0,	/* 51 */
	_nts_0,	/* 52 */
	_nts_0,	/* 53 */
	_nts_0,	/* 54 */
	_nts_0,	/* 55 */
	_nts_0,	/* 56 */
	_nts_5,	/* 57 */
	_nts_6,	/* 58 */
	_nts_7,	/* 59 */
	_nts_8,	/* 60 */
	_nts_5,	/* 61 */
	_nts_0,	/* 62 */
	_nts_0,	/* 63 */
	_nts_0,	/* 64 */
	_nts_9,	/* 65 */
	_nts_2,	/* 66 */
	_nts_10,	/* 67 */
	_nts_10,	/* 68 */
	_nts_0,	/* 69 */
	_nts_2,	/* 70 */
	_nts_11,	/* 71 */
	_nts_9,	/* 72 */
	_nts_12,	/* 73 */
	_nts_12,	/* 74 */
	_nts_13,	/* 75 */
	_nts_13,	/* 76 */
	_nts_13,	/* 77 */
	_nts_14,	/* 78 */
	_nts_15,	/* 79 */
	_nts_16,	/* 80 */
	_nts_15,	/* 81 */
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
	_nts_22,	/* 444 */
	_nts_23,	/* 445 */
	_nts_22,	/* 446 */
	_nts_23,	/* 447 */
	_nts_24,	/* 448 */
	_nts_25,	/* 449 */
	_nts_24,	/* 450 */
	_nts_25,	/* 451 */
	_nts_2,	/* 452 */
	_nts_2,	/* 453 */
	_nts_2,	/* 454 */
	_nts_3,	/* 455 */
	_nts_3,	/* 456 */
	_nts_4,	/* 457 */
	_nts_4,	/* 458 */
	_nts_32,	/* 459 */
	_nts_32,	/* 460 */
	_nts_32,	/* 461 */
	_nts_32,	/* 462 */
	_nts_32,	/* 463 */
	_nts_32,	/* 464 */
	_nts_32,	/* 465 */
	_nts_32,	/* 466 */
	_nts_2,	/* 467 */
	_nts_2,	/* 468 */
	_nts_2,	/* 469 */
	_nts_0,	/* 470 */
	_nts_3,	/* 471 */
	_nts_3,	/* 472 */
	_nts_4,	/* 473 */
	_nts_4,	/* 474 */
	_nts_11,	/* 475 */
	_nts_2,	/* 476 */
	_nts_0,	/* 477 */
};

static char *_templates[] = {
/* 0 */	0,
/* 1 */	"# read register\n",	/* reg8: INDIRI1(VREGP) */
/* 2 */	"# read register\n",	/* reg8: INDIRU1(VREGP) */
/* 3 */	"# read register\n",	/* reg: INDIRI2(VREGP) */
/* 4 */	"# read register\n",	/* reg: INDIRU2(VREGP) */
/* 5 */	"# read register\n",	/* reg32: INDIRI4(VREGP) */
/* 6 */	"# read register\n",	/* reg32: INDIRU4(VREGP) */
/* 7 */	"# read register\n",	/* reg: INDIRP2(VREGP) */
/* 8 */	"# read register\n",	/* regf: INDIRF4(VREGP) */
/* 9 */	"# read register\n",	/* regf: INDIRF8(VREGP) */
/* 10 */	"# write register\n",	/* stmt: ASGNI1(VREGP,reg8) */
/* 11 */	"# write register\n",	/* stmt: ASGNU1(VREGP,reg8) */
/* 12 */	"# write register\n",	/* stmt: ASGNI2(VREGP,reg) */
/* 13 */	"# write register\n",	/* stmt: ASGNU2(VREGP,reg) */
/* 14 */	"# write register\n",	/* stmt: ASGNI4(VREGP,reg32) */
/* 15 */	"# write register\n",	/* stmt: ASGNU4(VREGP,reg32) */
/* 16 */	"# write register\n",	/* stmt: ASGNP2(VREGP,reg) */
/* 17 */	"# write register\n",	/* stmt: ASGNF4(VREGP,regf) */
/* 18 */	"# write register\n",	/* stmt: ASGNF8(VREGP,regf) */
/* 19 */	"",	/* stmt: reg8 */
/* 20 */	"",	/* stmt: reg */
/* 21 */	"",	/* stmt: reg32 */
/* 22 */	"",	/* stmt: regf */
/* 23 */	"\tpush\t%0\n\tpop\t%c\n",	/* reg8: LOADI1(reg8) */
/* 24 */	"\tpush\t%0\n\tpop\t%c\n",	/* reg8: LOADU1(reg8) */
/* 25 */	"# emit2\n",	/* reg8: LOADI1(reg) */
/* 26 */	"# emit2\n",	/* reg8: LOADU1(reg) */
/* 27 */	"?\tmov\t%c,%0\n",	/* reg: LOADI2(reg) */
/* 28 */	"?\tmov\t%c,%0\n",	/* reg: LOADU2(reg) */
/* 29 */	"?\tmov\t%c,%0\n",	/* reg: LOADP2(reg) */
/* 30 */	"\tld\ta,(%0)\n\tst\t(%c),a\n\tld\ta,(%0+2)\n\tst\t(%c+2),a\n",	/* reg32: LOADI4(reg32) */
/* 31 */	"\tld\ta,(%0)\n\tst\t(%c),a\n\tld\ta,(%0+2)\n\tst\t(%c+2),a\n",	/* reg32: LOADU4(reg32) */
/* 32 */	"\tCOPY32(%c,%0)\n",	/* regf: LOADF4(regf) */
/* 33 */	"\tCOPY32(%c,%0)\n",	/* regf: LOADF8(regf) */
/* 34 */	"%0",	/* reg8: LOADU1(LOADU2(CVII2(reg8))) */
/* 35 */	"%0",	/* reg8: LOADI1(LOADI2(CVUU2(reg8))) */
/* 36 */	"# emit2\n",	/* reg8: LOADI1(reg32) */
/* 37 */	"# emit2\n",	/* reg8: LOADU1(reg32) */
/* 38 */	"\tld\t%c,(%0+2)\n",	/* reg: LOADI2(reg32) */
/* 39 */	"\tld\t%c,(%0+2)\n",	/* reg: LOADU2(reg32) */
/* 40 */	"%a",	/* con8: CNSTI1 */
/* 41 */	"%a",	/* con8: CNSTU1 */
/* 42 */	"%a",	/* con16: CNSTI2 */
/* 43 */	"%a",	/* con16: CNSTU2 */
/* 44 */	"%a",	/* con16: CNSTP2 */
/* 45 */	"%a",	/* con0: CNSTI1 */
/* 46 */	"%a",	/* con0: CNSTU1 */
/* 47 */	"%a",	/* con0: CNSTI2 */
/* 48 */	"%a",	/* con0: CNSTU2 */
/* 49 */	"%a",	/* con1: CNSTI1 */
/* 50 */	"%a",	/* con1: CNSTU1 */
/* 51 */	"%a",	/* con1: CNSTI2 */
/* 52 */	"%a",	/* con1: CNSTU2 */
/* 53 */	"%a",	/* con2: CNSTI1 */
/* 54 */	"%a",	/* con2: CNSTU1 */
/* 55 */	"%a",	/* con2: CNSTI2 */
/* 56 */	"%a",	/* con2: CNSTU2 */
/* 57 */	"%a",	/* con: con8 */
/* 58 */	"%a",	/* con: con16 */
/* 59 */	"\tld\t%c,%0\n",	/* reg: con */
/* 60 */	"\tld\t%c,0\n",	/* reg: con0 */
/* 61 */	"\tld\t%c,%0\n",	/* reg8: con8 */
/* 62 */	"dp:%a",	/* lgaddr: ADDRGP2 */
/* 63 */	"sp:%a+2+%F",	/* lgaddr: ADDRFP2 */
/* 64 */	"sp:%a+%F",	/* lgaddr: ADDRLP2 */
/* 65 */	"%0",	/* addr: lgaddr */
/* 66 */	"%0:0",	/* addr: reg */
/* 67 */	"%0:%1",	/* addr: ADDP2(reg,con) */
/* 68 */	"%0:-%1",	/* addr: SUBP2(reg,con) */
/* 69 */	"%a",	/* albl: ADDRGP2 */
/* 70 */	"%0",	/* ar: reg */
/* 71 */	"%0",	/* ar: albl */
/* 72 */	"\tlea\t%c,(%0)\n",	/* reg: lgaddr */
/* 73 */	"\tst\t(%0),%1\n",	/* stmt: ASGNI1(addr,reg8) */
/* 74 */	"\tst\t(%0),%1\n",	/* stmt: ASGNU1(addr,reg8) */
/* 75 */	"\tst\t(%0),%1\n",	/* stmt: ASGNI2(addr,reg) */
/* 76 */	"\tst\t(%0),%1\n",	/* stmt: ASGNU2(addr,reg) */
/* 77 */	"\tst\t(%0),%1\n",	/* stmt: ASGNP2(addr,reg) */
/* 78 */	"# emit2\n",	/* stmt: ASGNB(reg,INDIRB(reg)) */
/* 79 */	"\tCOPY32(%0,%1)\n",	/* stmt: ASGNI4(lgaddr,reg32) */
/* 80 */	"\tCOPY32(%0,%1)\n",	/* stmt: ASGNI4(lgaddr,INDIRI4(lgaddr)) */
/* 81 */	"\tCOPY32(%0,%1)\n",	/* stmt: ASGNU4(lgaddr,reg32) */
/* 82 */	"\tCOPY32(%0,%1)\n",	/* stmt: ASGNU4(lgaddr,INDIRU4(lgaddr)) */
/* 83 */	"\tCOPY32(%0,%1)\n",	/* stmt: ASGNF4(lgaddr,regf) */
/* 84 */	"\tCOPY32(%0,%1)\n",	/* stmt: ASGNF4(lgaddr,INDIRF4(lgaddr)) */
/* 85 */	"\tCOPY32(%0,%1)\n",	/* stmt: ASGNF8(lgaddr,regf) */
/* 86 */	"\tCOPY32(%0,%1)\n",	/* stmt: ASGNF8(lgaddr,INDIRF8(lgaddr)) */
/* 87 */	"\tld\t%c,(%0)\n",	/* reg8: INDIRI1(addr) */
/* 88 */	"\tld\t%c,(%0)\n",	/* reg8: INDIRU1(addr) */
/* 89 */	"\tld\t%c,(%0)\n",	/* reg: INDIRI2(addr) */
/* 90 */	"\tld\t%c,(%0)\n",	/* reg: INDIRU2(addr) */
/* 91 */	"\tld\t%c,(%0)\n",	/* reg: INDIRP2(addr) */
/* 92 */	"\tCOPY32(%c,%0)\n",	/* reg32: INDIRI4(lgaddr) */
/* 93 */	"\tld\ta,(%0)\n\tst\t(%c),a\n\tlea\ta,(%0)\n\tld\ta,(a:2)\n\tst\t(%c+2),a\n",	/* reg32: INDIRU4(lgaddr) */
/* 94 */	"\tCOPY32(%c,%0)\n",	/* regf: INDIRF4(lgaddr) */
/* 95 */	"\tCOPY32(%c,%0)\n",	/* regf: INDIRF8(lgaddr) */
/* 96 */	"\tCOPY32(%c,%0)\n",	/* reg32: INDIRI4(reg) */
/* 97 */	"\tCOPY32(%c,%0)\n",	/* reg32: INDIRU4(reg) */
/* 98 */	"\tCOPY32(%c,%0)\n",	/* regf: INDIRF4(reg) */
/* 99 */	"\tCOPY32(%c,%0)\n",	/* regf: INDIRF8(reg) */
/* 100 */	"\tCVI32I8(%c,%0)\n",	/* reg8: CVII1(reg32) */
/* 101 */	"\tCVI32U8(%c,%0)\n",	/* reg8: CVIU1(reg32) */
/* 102 */	"\tCVU32I8(%c,%0)\n",	/* reg8: CVUI1(reg32) */
/* 103 */	"\tCVU32U8(%c,%0)\n",	/* reg8: CVUU1(reg32) */
/* 104 */	"\tsex\t%c\n",	/* reg: CVII2(reg8) */
/* 105 */	"\tand\t%c,0x00ff\n",	/* reg: CVIU2(reg8) */
/* 106 */	"\tand\t%c,0x00ff\n",	/* reg: CVUI2(reg8) */
/* 107 */	"\tand\t%c,0x00ff\n",	/* reg: CVUU2(reg8) */
/* 108 */	"\tCVI8I32(%c,%0)\n",	/* reg32: CVII4(reg8) */
/* 109 */	"\tCVI8U32(%c,%0)\n",	/* reg32: CVIU4(reg8) */
/* 110 */	"\tCVU8I32(%c,%0)\n",	/* reg32: CVUI4(reg8) */
/* 111 */	"\tCVU8U32(%c,%0)\n",	/* reg32: CVUU4(reg8) */
/* 112 */	"\tCVI16I32(%c,%0)\n",	/* reg32: CVII4(reg) */
/* 113 */	"\tst\t(%c+2),%0\n\tld\ta,0\n\tst\t(%c),a\n",	/* reg32: CVIU4(reg) */
/* 114 */	"\tst\t(%c+2),%0\n\tld\ta,0\n\tst\t(%c),a\n",	/* reg32: CVUI4(reg) */
/* 115 */	"\tst\t(%c+2),%0\n\tld\ta,0\n\tst\t(%c),a\n",	/* reg32: CVUU4(reg) */
/* 116 */	"\tCVTI8F32(%c,%0)\n",	/* regf: CVIF4(reg8) */
/* 117 */	"\tCVTI16F32(%c,%0)\n",	/* regf: CVIF4(reg) */
/* 118 */	"\tCVTI32F32(%c,%0)\n",	/* regf: CVIF4(reg32) */
/* 119 */	"\tCVTI8F64(%c,%0)\n",	/* regf: CVIF8(reg8) */
/* 120 */	"\tCVTI16F64(%c,%0)\n",	/* regf: CVIF8(reg) */
/* 121 */	"\tCVTI32F64(%c,%0)\n",	/* regf: CVIF8(reg32) */
/* 122 */	"\tCVTFI16(%c,%0)\n",	/* reg: CVFI2(regf) */
/* 123 */	"\tCVTFI32(%c,%0)\n",	/* reg: CVFI4(regf) */
/* 124 */	"\tCVTF64F32(%c,%0)\n",	/* regf: CVFF4(regf) */
/* 125 */	"\tCVTF32F64(%c,%0)\n",	/* regf: CVFF8(regf) */
/* 126 */	"\tmov\t%c,%0\n",	/* reg: CVPU2(reg) */
/* 127 */	"\tmov\t%c,%0\n",	/* reg: CVUP2(reg) */
/* 128 */	"?\tmov\t%c,%0\n\tadd\t%c,%1\n",	/* reg: ADDI2(reg,reg) */
/* 129 */	"?\tmov\t%c,%0\n\tadd\t%c,(%1)\n",	/* reg: ADDI2(reg,INDIRI2(addr)) */
/* 130 */	"?\tmov\t%c,%0\n\tadd\t%c,%1\n",	/* reg: ADDI2(reg,con) */
/* 131 */	"?\tmov\t%c,%0\n\tadd\t%c,%1\n",	/* reg: ADDU2(reg,reg) */
/* 132 */	"?\tmov\t%c,%0\n\tadd\t%c,(%1)\n",	/* reg: ADDU2(reg,INDIRU2(addr)) */
/* 133 */	"?\tmov\t%c,%0\n\tadd\t%c,%1\n",	/* reg: ADDU2(reg,con) */
/* 134 */	"?\tmov\t%c,%0\n\tadd\t%c,%1\n",	/* reg: ADDP2(reg,reg) */
/* 135 */	"?\tmov\t%c,%0\n\tadd\t%c,%1\n",	/* reg: ADDP2(reg,con) */
/* 136 */	"# emit2 (use AH/AL instead of A)\n",	/* reg8: ADDI2(reg8,CVII2(INDIRI1(addr))) */
/* 137 */	"# emit2 (use AH/AL instead of A)\n",	/* reg8: ADDI2(CVII2(reg8),CVII2(INDIRI1(addr))) */
/* 138 */	"# emit2 (use AH/AL instead of A)\n",	/* reg8: ADDI2(CVUI2(reg8),CVII2(INDIRI1(addr))) */
/* 139 */	"# emit2 (use AH/AL instead of A)\n",	/* reg8: ADDI2(reg8,con) */
/* 140 */	"# emit2 (use AH/AL instead of A)\n",	/* reg8: ADDI2(CVII2(reg8),con) */
/* 141 */	"# emit2 (use AH/AL instead of A)\n",	/* reg8: ADDI2(CVUI2(reg8),con) */
/* 142 */	"# emit2 (use AH/AL instead of A)\n",	/* reg8: ADDU2(reg8,CVUU2(INDIRU1(addr))) */
/* 143 */	"# emit2 (use AH/AL instead of A)\n",	/* reg8: ADDU2(CVUU2(reg8),CVUU2(INDIRU1(addr))) */
/* 144 */	"# emit2 (use AH/AL instead of A)\n",	/* reg8: ADDU2(CVIU2(reg8),CVUU2(INDIRU1(addr))) */
/* 145 */	"# emit2 (use AH/AL instead of A)\n",	/* reg8: ADDU2(reg8,con) */
/* 146 */	"# emit2 (use AH/AL instead of A)\n",	/* reg8: ADDU2(CVUU2(reg8),con) */
/* 147 */	"# emit2 (use AH/AL instead of A)\n",	/* reg8: ADDU2(CVIU2(reg8),con) */
/* 148 */	"?\tCOPY32(%c,%0)\n\tADDI32(%c,%1)\n",	/* reg32: ADDI4(reg32,reg32) */
/* 149 */	"?\tCOPY32(%c,%0)\n\tADDI32(%c,%1)\n",	/* reg32: ADDI4(reg32,INDIRI4(lgaddr)) */
/* 150 */	"?\tld\ta,(%0)\tst\t(%c),a\tld\ta,(%0+2)\tst\t(%c+2),a\n\tld\ta,(%c+2)\n\tadd\ta,(%1+2)\n\tst\t(%c+2),a\n\tld\ta,(%c)\n\tld\ty,(%1)\n\tadc\ta,y\n\tst\t(%c),a\n",	/* reg32: ADDU4(reg32,reg32) */
/* 151 */	"?\tld\ta,(%0)\tst\t(%c),a\tld\ta,(%0+2)\tst\t(%c+2),a\n\tlea\ty,(%1)\n\tld\ta,(%c+2)\n\tadd\ta,(y:2)\n\tst\t(%c+2),a\n\tld\ta,(%c)\n\tld\ty,(y:0)\n\tadc\ta,y\n\tst\t(%c),a\n",	/* reg32: ADDU4(reg32,INDIRU4(lgaddr)) */
/* 152 */	"?\tCOPY32(%c,%0)\n\tADDF32(%c,%1)\n",	/* regf: ADDF4(regf,regf) */
/* 153 */	"?\tCOPY32(%c,%0)\n\tADDF32(%c,%1)\n",	/* regf: ADDF4(regf,INDIRF4(lgaddr)) */
/* 154 */	"?\tCOPY32(%c,%0)\n\tADDF64(%c,%1)\n",	/* regf: ADDF8(regf,regf) */
/* 155 */	"?\tCOPY32(%c,%0)\n\tADDF64(%c,%1)\n",	/* regf: ADDF8(regf,INDIRF8(lgaddr)) */
/* 156 */	"\tCOPY32(%0,%1)\n\tADDI32(%0,%2)\n",	/* stmt: ASGNI4(lgaddr,ADDI4(INDIRI4(lgaddr),INDIRI4(lgaddr))) */
/* 157 */	"\tADDI32(%1,%2)\n",	/* stmt: ASGNI4(lgaddr,ADDI4(INDIRI4(lgaddr),INDIRI4(lgaddr))) */
/* 158 */	"\tCOPY32(%0,%1)\n\tADDU32(%0,%2)\n",	/* stmt: ASGNU4(lgaddr,ADDU4(INDIRU4(lgaddr),INDIRU4(lgaddr))) */
/* 159 */	"\tADDU32(%1,%2)\n",	/* stmt: ASGNU4(lgaddr,ADDU4(INDIRU4(lgaddr),INDIRU4(lgaddr))) */
/* 160 */	"\tCOPY32(%0,%1)\n\tADDF32(%0,%2)\n",	/* stmt: ASGNF4(lgaddr,ADDF4(INDIRF4(lgaddr),INDIRF4(lgaddr))) */
/* 161 */	"\tADDF32(%1,%2)\n",	/* stmt: ASGNF4(lgaddr,ADDF4(INDIRF4(lgaddr),INDIRF4(lgaddr))) */
/* 162 */	"\tCOPY32(%0,%1)\n\tADDF64(%0,%2)\n",	/* stmt: ASGNF8(lgaddr,ADDF8(INDIRF8(lgaddr),INDIRF8(lgaddr))) */
/* 163 */	"\tADDF64(%1,%2)\n",	/* stmt: ASGNF8(lgaddr,ADDF8(INDIRF8(lgaddr),INDIRF8(lgaddr))) */
/* 164 */	"?\tmov\t%c,%0\n\tsub\t%c,%1\n",	/* reg: SUBI2(reg,reg) */
/* 165 */	"?\tmov\t%c,%0\n\tsub\t%c,(%1)\n",	/* reg: SUBI2(reg,INDIRI2(addr)) */
/* 166 */	"?\tmov\t%c,%0\n\tsub\t%c,%1\n",	/* reg: SUBI2(reg,con) */
/* 167 */	"?\tmov\t%c,%0\n\tsub\t%c,%1\n",	/* reg: SUBU2(reg,reg) */
/* 168 */	"?\tmov\t%c,%0\n\tsub\t%c,(%1)\n",	/* reg: SUBU2(reg,INDIRU2(addr)) */
/* 169 */	"?\tmov\t%c,%0\n\tsub\t%c,%1\n",	/* reg: SUBU2(reg,con) */
/* 170 */	"?\tmov\t%c,%0\n\tsub\t%c,%1\n",	/* reg: SUBP2(reg,reg) */
/* 171 */	"?\tmov\t%c,%0\n\tsub\t%c,%1\n",	/* reg: SUBP2(reg,con) */
/* 172 */	"# emit2 (use AH/AL instead of A)\n",	/* reg8: SUBI2(reg8,CVII2(INDIRI1(addr))) */
/* 173 */	"# emit2 (use AH/AL instead of A)\n",	/* reg8: SUBI2(CVII2(reg8),CVII2(INDIRI1(addr))) */
/* 174 */	"# emit2 (use AH/AL instead of A)\n",	/* reg8: SUBI2(CVUI2(reg8),CVII2(INDIRI1(addr))) */
/* 175 */	"# emit2 (use AH/AL instead of A)\n",	/* reg8: SUBI2(reg8,con) */
/* 176 */	"# emit2 (use AH/AL instead of A)\n",	/* reg8: SUBI2(CVII2(reg8),con) */
/* 177 */	"# emit2 (use AH/AL instead of A)\n",	/* reg8: SUBI2(CVUI2(reg8),con) */
/* 178 */	"# emit2 (use AH/AL instead of A)\n",	/* reg8: SUBU2(reg8,CVUU2(INDIRU1(addr))) */
/* 179 */	"# emit2 (use AH/AL instead of A)\n",	/* reg8: SUBU2(CVUU2(reg8),CVUU2(INDIRU1(addr))) */
/* 180 */	"# emit2 (use AH/AL instead of A)\n",	/* reg8: SUBU2(CVIU2(reg8),CVUU2(INDIRU1(addr))) */
/* 181 */	"# emit2 (use AH/AL instead of A)\n",	/* reg8: SUBU2(reg8,con) */
/* 182 */	"# emit2 (use AH/AL instead of A)\n",	/* reg8: SUBU2(CVUU2(reg8),con) */
/* 183 */	"# emit2 (use AH/AL instead of A)\n",	/* reg8: SUBU2(CVIU2(reg8),con) */
/* 184 */	"?\tCOPY32(%c,%0)\n\tSUBI32(%c,%1)\n",	/* reg32: SUBI4(reg32,reg32) */
/* 185 */	"?\tCOPY32(%c,%0)\n\tSUBI32(%c,%1)\n",	/* reg32: SUBI4(reg32,INDIRI4(lgaddr)) */
/* 186 */	"?\tld\ta,(%0)\tst\t(%c),a\tld\ta,(%0+2)\tst\t(%c+2),a\n\tld\ta,(%c+2)\n\tsub\ta,(%1+2)\n\tst\t(%c+2),a\n\tld\ta,(%c)\n\tld\ty,(%1)\n\tsbc\ta,y\n\tst\t(%c),a\n",	/* reg32: SUBU4(reg32,reg32) */
/* 187 */	"?\tld\ta,(%0)\tst\t(%c),a\tld\ta,(%0+2)\tst\t(%c+2),a\n\tlea\ty,(%1)\n\tld\ta,(%c+2)\n\tsub\ta,(y:2)\n\tst\t(%c+2),a\n\tld\ta,(%c)\n\tld\ty,(y:0)\n\tsbc\ta,y\n\tst\t(%c),a\n",	/* reg32: SUBU4(reg32,INDIRU4(lgaddr)) */
/* 188 */	"?\tCOPY32(%c,%0)\n\tSUBF32(%c,%1)\n",	/* regf: SUBF4(regf,regf) */
/* 189 */	"?\tCOPY32(%c,%0)\n\tSUBF32(%c,%1)\n",	/* regf: SUBF4(regf,INDIRF4(lgaddr)) */
/* 190 */	"?\tCOPY32(%c,%0)\n\tSUBF64(%c,%1)\n",	/* regf: SUBF8(regf,regf) */
/* 191 */	"?\tCOPY32(%c,%0)\n\tSUBF64(%c,%1)\n",	/* regf: SUBF8(regf,INDIRF8(lgaddr)) */
/* 192 */	"\tCOPY32(%0,%1)\n\tSUBI32(%0,%2)\n",	/* stmt: ASGNI4(lgaddr,SUBI4(INDIRI4(lgaddr),INDIRI4(lgaddr))) */
/* 193 */	"\tSUBI32(%1,%2)\n",	/* stmt: ASGNI4(lgaddr,SUBI4(INDIRI4(lgaddr),INDIRI4(lgaddr))) */
/* 194 */	"\tCOPY32(%0,%1)\n\tSUBU32(%0,%2)\n",	/* stmt: ASGNU4(lgaddr,SUBU4(INDIRU4(lgaddr),INDIRU4(lgaddr))) */
/* 195 */	"\tSUBU32(%1,%2)\n",	/* stmt: ASGNU4(lgaddr,SUBU4(INDIRU4(lgaddr),INDIRU4(lgaddr))) */
/* 196 */	"\tCOPY32(%0,%1)\n\tSUBF32(%0,%2)\n",	/* stmt: ASGNF4(lgaddr,SUBF4(INDIRF4(lgaddr),INDIRF4(lgaddr))) */
/* 197 */	"\tSUBF32(%1,%2)\n",	/* stmt: ASGNF4(lgaddr,SUBF4(INDIRF4(lgaddr),INDIRF4(lgaddr))) */
/* 198 */	"\tCOPY32(%0,%1)\n\tSUBF64(%0,%2)\n",	/* stmt: ASGNF8(lgaddr,SUBF8(INDIRF8(lgaddr),INDIRF8(lgaddr))) */
/* 199 */	"\tSUBF64(%1,%2)\n",	/* stmt: ASGNF8(lgaddr,SUBF8(INDIRF8(lgaddr),INDIRF8(lgaddr))) */
/* 200 */	"\tld\t%c,0\n\tsub\t%c,%0\n",	/* reg: NEGI2(reg) */
/* 201 */	"\tld\t%c,0\n\tsub\t%c,(%0)\n",	/* reg: NEGI2(INDIRI2(lgaddr)) */
/* 202 */	"\tNEGI32(%c,%0)\n",	/* reg32: NEGI4(reg32) */
/* 203 */	"\tNEGI32(%c,%0)\n",	/* reg32: NEGI4(INDIRI4(lgaddr)) */
/* 204 */	"\tNEGF32(%c,%0)\n",	/* regf: NEGF4(regf) */
/* 205 */	"\tNEGF32(%c,%0)\n",	/* regf: NEGF4(INDIRF4(lgaddr)) */
/* 206 */	"\tNEGF64(%c,%0)\n",	/* regf: NEGF8(regf) */
/* 207 */	"\tNEGF64(%c,%0)\n",	/* regf: NEGF8(INDIRF8(lgaddr)) */
/* 208 */	"?\tmov\t%c,%0\n\tand\t%c,%1\n",	/* reg: BANDI2(reg,reg) */
/* 209 */	"?\tmov\t%c,%0\n\tand\t%c,(%1)\n",	/* reg: BANDI2(reg,INDIRI2(lgaddr)) */
/* 210 */	"?\tmov\t%c,%0\n\tand\t%c,%1\n",	/* reg: BANDI2(reg,con) */
/* 211 */	"?\tmov\t%c,%0\n\tand\t%c,%1\n",	/* reg: BANDU2(reg,reg) */
/* 212 */	"?\tmov\t%c,%0\n\tand\t%c,(%1)\n",	/* reg: BANDU2(reg,INDIRU2(lgaddr)) */
/* 213 */	"?\tmov\t%c,%0\n\tand\t%c,%1\n",	/* reg: BANDU2(reg,con) */
/* 214 */	"# emit2 (use AH/AL instead of A)\n",	/* reg8: BANDI2(reg8,CVII2(INDIRI1(lgaddr))) */
/* 215 */	"# emit2 (use AH/AL instead of A)\n",	/* reg8: BANDI2(CVII2(reg8),CVII2(INDIRI1(lgaddr))) */
/* 216 */	"# emit2 (use AH/AL instead of A)\n",	/* reg8: BANDI2(CVUI2(reg8),CVII2(INDIRI1(lgaddr))) */
/* 217 */	"# emit2 (use AH/AL instead of A)\n",	/* reg8: BANDI2(reg8,con) */
/* 218 */	"# emit2 (use AH/AL instead of A)\n",	/* reg8: BANDI2(CVII2(reg8),con) */
/* 219 */	"# emit2 (use AH/AL instead of A)\n",	/* reg8: BANDI2(CVUI2(reg8),con) */
/* 220 */	"# emit2 (use AH/AL instead of A)\n",	/* reg8: BANDU2(reg8,CVUU2(INDIRU1(lgaddr))) */
/* 221 */	"# emit2 (use AH/AL instead of A)\n",	/* reg8: BANDU2(CVUU2(reg8),CVUU2(INDIRU1(lgaddr))) */
/* 222 */	"# emit2 (use AH/AL instead of A)\n",	/* reg8: BANDU2(CVIU2(reg8),CVUU2(INDIRU1(lgaddr))) */
/* 223 */	"# emit2 (use AH/AL instead of A)\n",	/* reg8: BANDU2(reg8,con) */
/* 224 */	"# emit2 (use AH/AL instead of A)\n",	/* reg8: BANDU2(CVUU2(reg8),con) */
/* 225 */	"# emit2 (use AH/AL instead of A)\n",	/* reg8: BANDU2(CVIU2(reg8),con) */
/* 226 */	"?\tCOPY32(%c,%0)\n\tBANDI32(%c,%1)\n",	/* reg32: BANDI4(reg32,reg32) */
/* 227 */	"?\tCOPY32(%c,%0)\n\tBANDI32(%c,%1)\n",	/* reg32: BANDI4(reg32,INDIRI4(lgaddr)) */
/* 228 */	"?\tCOPY32(%c,%0)\n\tBANDI32(%c,%1)\n",	/* reg32: BANDU4(reg32,reg32) */
/* 229 */	"?\tCOPY32(%c,%0)\n\tBANDI32(%c,%1)\n",	/* reg32: BANDU4(reg32,INDIRU4(lgaddr)) */
/* 230 */	"\tmov\t%c,-1\n\txor\t%c,%0\n",	/* reg: BCOMI2(reg) */
/* 231 */	"\tmov\t%c,-1\n\txor\t%c,%0\n",	/* reg: BCOMU2(reg) */
/* 232 */	"\tBCOMI32(%c,%0)\n",	/* reg32: BCOMI4(reg32) */
/* 233 */	"\tBCOMI32(%c,%0)\n",	/* reg32: BCOMU4(reg32) */
/* 234 */	"?\tmov\t%c,%0\n\tor\t%c,%1\n",	/* reg: BORI2(reg,reg) */
/* 235 */	"?\tmov\t%c,%0\n\tor\t%c,(%1)\n",	/* reg: BORI2(reg,INDIRI2(lgaddr)) */
/* 236 */	"?\tmov\t%c,%0\n\tor\t%c,%1\n",	/* reg: BORI2(reg,con) */
/* 237 */	"?\tmov\t%c,%0\n\tor\t%c,%1\n",	/* reg: BORU2(reg,reg) */
/* 238 */	"?\tmov\t%c,%0\n\tor\t%c,(%1)\n",	/* reg: BORU2(reg,INDIRU2(lgaddr)) */
/* 239 */	"?\tmov\t%c,%0\n\tor\t%c,%1\n",	/* reg: BORU2(reg,con) */
/* 240 */	"# emit2 (use AH/AL instead of A)\n",	/* reg8: BORI2(reg8,CVII2(INDIRI1(lgaddr))) */
/* 241 */	"# emit2 (use AH/AL instead of A)\n",	/* reg8: BORI2(CVII2(reg8),CVII2(INDIRI1(lgaddr))) */
/* 242 */	"# emit2 (use AH/AL instead of A)\n",	/* reg8: BORI2(CVUI2(reg8),CVII2(INDIRI1(lgaddr))) */
/* 243 */	"# emit2 (use AH/AL instead of A)\n",	/* reg8: BORI2(reg8,con) */
/* 244 */	"# emit2 (use AH/AL instead of A)\n",	/* reg8: BORI2(CVII2(reg8),con) */
/* 245 */	"# emit2 (use AH/AL instead of A)\n",	/* reg8: BORI2(CVUI2(reg8),con) */
/* 246 */	"# emit2 (use AH/AL instead of A)\n",	/* reg8: BORU2(reg8,CVUU2(INDIRU1(lgaddr))) */
/* 247 */	"# emit2 (use AH/AL instead of A)\n",	/* reg8: BORU2(CVUU2(reg8),CVUU2(INDIRU1(lgaddr))) */
/* 248 */	"# emit2 (use AH/AL instead of A)\n",	/* reg8: BORU2(CVIU2(reg8),CVUU2(INDIRU1(lgaddr))) */
/* 249 */	"# emit2 (use AH/AL instead of A)\n",	/* reg8: BORU2(reg8,con) */
/* 250 */	"# emit2 (use AH/AL instead of A)\n",	/* reg8: BORU2(CVUU2(reg8),con) */
/* 251 */	"# emit2 (use AH/AL instead of A)\n",	/* reg8: BORU2(CVIU2(reg8),con) */
/* 252 */	"?\tCOPY32(%c,%0)\n\tBORI32(%c,%1)\n",	/* reg32: BORI4(reg32,reg32) */
/* 253 */	"?\tCOPY32(%c,%0)\n\tBORI32(%c,%1)\n",	/* reg32: BORI4(reg32,INDIRI4(lgaddr)) */
/* 254 */	"?\tCOPY32(%c,%0)\n\tBORI32(%c,%1)\n",	/* reg32: BORU4(reg32,reg32) */
/* 255 */	"?\tCOPY32(%c,%0)\n\tBORI32(%c,%1)\n",	/* reg32: BORU4(reg32,INDIRU4(lgaddr)) */
/* 256 */	"?\tmov\t%c,%0\n\txor\t%c,%1\n",	/* reg: BXORI2(reg,reg) */
/* 257 */	"?\tmov\t%c,%0\n\txor\t%c,(%1)\n",	/* reg: BXORI2(reg,INDIRI2(lgaddr)) */
/* 258 */	"?\tmov\t%c,%0\n\txor\t%c,%1\n",	/* reg: BXORI2(reg,con) */
/* 259 */	"?\tmov\t%c,%0\n\txor\t%c,%1\n",	/* reg: BXORU2(reg,reg) */
/* 260 */	"?\tmov\t%c,%0\n\txor\t%c,(%1)\n",	/* reg: BXORU2(reg,INDIRU2(lgaddr)) */
/* 261 */	"?\tmov\t%c,%0\n\txor\t%c,%1\n",	/* reg: BXORU2(reg,con) */
/* 262 */	"# emit2 (use AH/AL instead of A)\n",	/* reg8: BXORI2(reg8,CVII2(INDIRI1(lgaddr))) */
/* 263 */	"# emit2 (use AH/AL instead of A)\n",	/* reg8: BXORI2(CVII2(reg8),CVII2(INDIRI1(lgaddr))) */
/* 264 */	"# emit2 (use AH/AL instead of A)\n",	/* reg8: BXORI2(CVUI2(reg8),CVII2(INDIRI1(lgaddr))) */
/* 265 */	"# emit2 (use AH/AL instead of A)\n",	/* reg8: BXORI2(reg8,con) */
/* 266 */	"# emit2 (use AH/AL instead of A)\n",	/* reg8: BXORI2(CVII2(reg8),con) */
/* 267 */	"# emit2 (use AH/AL instead of A)\n",	/* reg8: BXORI2(CVUI2(reg8),con) */
/* 268 */	"# emit2 (use AH/AL instead of A)\n",	/* reg8: BXORU2(reg8,CVUU2(INDIRU1(lgaddr))) */
/* 269 */	"# emit2 (use AH/AL instead of A)\n",	/* reg8: BXORU2(CVUU2(reg8),CVUU2(INDIRU1(lgaddr))) */
/* 270 */	"# emit2 (use AH/AL instead of A)\n",	/* reg8: BXORU2(CVIU2(reg8),CVUU2(INDIRU1(lgaddr))) */
/* 271 */	"# emit2 (use AH/AL instead of A)\n",	/* reg8: BXORU2(reg8,con) */
/* 272 */	"# emit2 (use AH/AL instead of A)\n",	/* reg8: BXORU2(CVUU2(reg8),con) */
/* 273 */	"# emit2 (use AH/AL instead of A)\n",	/* reg8: BXORU2(CVIU2(reg8),con) */
/* 274 */	"?\tCOPY32(%c,%0)\n\tBXORI32(%c,%1)\n",	/* reg32: BXORI4(reg32,reg32) */
/* 275 */	"?\tCOPY32(%c,%0)\n\tBXORI32(%c,%1)\n",	/* reg32: BXORI4(reg32,INDIRI4(lgaddr)) */
/* 276 */	"?\tCOPY32(%c,%0)\n\tBXORI32(%c,%1)\n",	/* reg32: BXORU4(reg32,reg32) */
/* 277 */	"?\tCOPY32(%c,%0)\n\tBXORI32(%c,%1)\n",	/* reg32: BXORU4(reg32,INDIRU4(lgaddr)) */
/* 278 */	"?\tmov\t%c,%0\n\tcall\t__muli16\n",	/* reg: MULI2(reg,reg) */
/* 279 */	"?\tmov\t%c,%0\n\tcall\t__mulu16\n",	/* reg: MULU2(reg,reg) */
/* 280 */	"?\tmov\t%c,%0\n\tcall\t__divi16\n",	/* reg: DIVI2(reg,reg) */
/* 281 */	"?\tmov\t%c,%0\n\tcall\t__divu16\n",	/* reg: DIVU2(reg,reg) */
/* 282 */	"?\tmov\t%c,%0\n\tcall\t__modi16\n",	/* reg: MODI2(reg,reg) */
/* 283 */	"?\tmov\t%c,%0\n\tcall\t__modu16\n",	/* reg: MODU2(reg,reg) */
/* 284 */	"?\tCOPY32(%c,%0)\n\tMULI32(%c,%1)\n",	/* reg32: MULI4(reg32,reg32) */
/* 285 */	"?\tCOPY32(%c,%0)\n\tMULI32(%c,%1)\n",	/* reg32: MULI4(reg32,INDIRI4(lgaddr)) */
/* 286 */	"?\tCOPY32(%c,%0)\n\tMULU32(%c,%1)\n",	/* reg32: MULU4(reg32,reg32) */
/* 287 */	"?\tCOPY32(%c,%0)\n\tMULU32(%c,%1)\n",	/* reg32: MULU4(reg32,INDIRU4(lgaddr)) */
/* 288 */	"?\tCOPY32(%c,%0)\n\tDIVI32(%c,%1)\n",	/* reg32: DIVI4(reg32,reg32) */
/* 289 */	"?\tCOPY32(%c,%0)\n\tDIVI32(%c,%1)\n",	/* reg32: DIVI4(reg32,INDIRI4(lgaddr)) */
/* 290 */	"?\tCOPY32(%c,%0)\n\tDIVU32(%c,%1)\n",	/* reg32: DIVU4(reg32,reg32) */
/* 291 */	"?\tCOPY32(%c,%0)\n\tDIVU32(%c,%1)\n",	/* reg32: DIVU4(reg32,INDIRU4(lgaddr)) */
/* 292 */	"?\tCOPY32(%c,%0)\n\tMODI32(%c,%1)\n",	/* reg32: MODI4(reg32,reg32) */
/* 293 */	"?\tCOPY32(%c,%0)\n\tMODI32(%c,%1)\n",	/* reg32: MODI4(reg32,INDIRI4(lgaddr)) */
/* 294 */	"?\tCOPY32(%c,%0)\n\tMODU32(%c,%1)\n",	/* reg32: MODU4(reg32,reg32) */
/* 295 */	"?\tCOPY32(%c,%0)\n\tMODU32(%c,%1)\n",	/* reg32: MODU4(reg32,INDIRU4(lgaddr)) */
/* 296 */	"?\tCOPY32(%c,%0)\n\tMULF32(%c,%1)\n",	/* regf: MULF4(regf,regf) */
/* 297 */	"?\tCOPY32(%c,%0)\n\tMULF32(%c,%1)\n",	/* regf: MULF4(regf,INDIRF4(lgaddr)) */
/* 298 */	"?\tCOPY32(%c,%0)\n\tMULF64(%c,%1)\n",	/* regf: MULF8(regf,regf) */
/* 299 */	"?\tCOPY32(%c,%0)\n\tMULF64(%c,%1)\n",	/* regf: MULF8(regf,INDIRF8(lgaddr)) */
/* 300 */	"?\tCOPY32(%c,%0)\n\tDIVF32(%c,%1)\n",	/* regf: DIVF4(regf,regf) */
/* 301 */	"?\tCOPY32(%c,%0)\n\tDIVF32(%c,%1)\n",	/* regf: DIVF4(regf,INDIRF4(lgaddr)) */
/* 302 */	"?\tCOPY32(%c,%0)\n\tDIVF64(%c,%1)\n",	/* regf: DIVF8(regf,regf) */
/* 303 */	"?\tCOPY32(%c,%0)\n\tDIVF64(%c,%1)\n",	/* regf: DIVF8(regf,INDIRF8(lgaddr)) */
/* 304 */	"?\tmov\t%c,%0\n\tshl\t%c\n",	/* reg: LSHI2(reg,con1) */
/* 305 */	"?\tmov\t%c,%0\n\tshl\t%c\n",	/* reg: LSHU2(reg,con1) */
/* 306 */	"?\tmov\t%c,%0\n\tshr\t%c\n",	/* reg: RSHI2(reg,con1) */
/* 307 */	"?\tmov\t%c,%0\n\tshr\t%c\n",	/* reg: RSHU2(reg,con1) */
/* 308 */	"?\tmov\t%c,%0\n\tshl\t%c\n\tshl\t%c\n",	/* reg: LSHI2(reg,con2) */
/* 309 */	"?\tmov\t%c,%0\n\tshl\t%c\n\tshl\t%c\n",	/* reg: LSHU2(reg,con2) */
/* 310 */	"?\tmov\t%c,%0\n\tshr\t%c\n\tshr\t%c\n",	/* reg: RSHI2(reg,con2) */
/* 311 */	"?\tmov\t%c,%0\n\tshr\t%c\n\tshr\t%c\n",	/* reg: RSHU2(reg,con2) */
/* 312 */	"# emit2 (loop)\n",	/* reg: LSHI2(reg,reg) */
/* 313 */	"# emit2 (loop)\n",	/* reg: LSHU2(reg,reg) */
/* 314 */	"# emit2 (loop)\n",	/* reg: RSHI2(reg,reg) */
/* 315 */	"# emit2 (loop)\n",	/* reg: RSHU2(reg,reg) */
/* 316 */	"?\tCOPY32(%c,%0)\n\tLSHI32(%0)\n",	/* reg32: LSHI4(reg32,con1) */
/* 317 */	"?\tld\ta,(%0)\tst\t(%c),a\tld\ta,(%0+2)\tst\t(%c+2),a\n\tld\ta,(%c)\n\tshl\ta\nst\t(%c),a\n\tld\ta,(%c+2)\n\tshl\ta\nst\t(%c+2),a\n\tld\ta,(%c)\n\tld\ty,0\n\tadc\ta,y\n\tst\t(%c),a\n",	/* reg32: LSHU4(reg32,con1) */
/* 318 */	"?\tCOPY32(%c,%0)\n\tRSHI32(%0)\n",	/* reg32: RSHI4(reg32,con1) */
/* 319 */	"?\tCOPY32(%c,%0)\n\tRSHU32(%0)\n",	/* reg32: RSHU4(reg32,con1) */
/* 320 */	"\tcmp\t%0,%1\n\tje\t%a\n",	/* stmt: EQI2(reg,reg) */
/* 321 */	"\tcmp\t%0,(%1)\n\tje\t%a\n",	/* stmt: EQI2(reg,INDIRI2(lgaddr)) */
/* 322 */	"\tcmp\t%0,%1\n\tje\t%a\n",	/* stmt: EQI2(reg,con) */
/* 323 */	"\tcmp\t%0,(%1)\n\tje\t%a\n",	/* stmt: EQI2(CVII2(reg8),CVII2(INDIRI1(lgaddr))) */
/* 324 */	"\tcmp\t%0,(%1)\n\tje\t%a\n",	/* stmt: EQI2(CVUI2(reg8),CVII2(INDIRI1(lgaddr))) */
/* 325 */	"\tcmp\t%0,%1\n\tje\t%a\n",	/* stmt: EQI2(CVII2(reg8),con) */
/* 326 */	"\tcmp\t%0,%1\n\tje\t%a\n",	/* stmt: EQI2(CVUI2(reg8),con) */
/* 327 */	"\tcmp\t%0,%1\n\tje\t%a\n",	/* stmt: EQU2(reg,reg) */
/* 328 */	"\tcmp\t%0,(%1)\n\tje\t%a\n",	/* stmt: EQU2(reg,INDIRU2(lgaddr)) */
/* 329 */	"\tcmp\t%0,%1\n\tje\t%a\n",	/* stmt: EQU2(reg,con) */
/* 330 */	"\tcmp\t%0,(%1)\n\tje\t%a\n",	/* stmt: EQU2(CVUU2(reg8),CVUU2(INDIRU1(lgaddr))) */
/* 331 */	"\tcmp\t%0,(%1)\n\tje\t%a\n",	/* stmt: EQU2(CVIU2(reg8),CVUU2(INDIRU1(lgaddr))) */
/* 332 */	"\tcmp\t%0,%1\n\tje\t%a\n",	/* stmt: EQU2(CVUU2(reg8),con) */
/* 333 */	"\tcmp\t%0,%1\n\tje\t%a\n",	/* stmt: EQU2(CVIU2(reg8),con) */
/* 334 */	"\tCMP32(%0,%1)\n\tje\t%a\n",	/* stmt: EQI4(reg32,reg32) */
/* 335 */	"\tCMP32(%0,%1)\n\tje\t%a\n",	/* stmt: EQI4(reg32,INDIRI4(lgaddr)) */
/* 336 */	"\tCMP32(%0,%1)\n\tje\t%a\n",	/* stmt: EQU4(reg32,reg32) */
/* 337 */	"\tCMP32(%0,%1)\n\tje\t%a\n",	/* stmt: EQU4(reg32,INDIRU4(lgaddr)) */
/* 338 */	"\tCMP32(%0,%1)\n\tje\t%a\n",	/* stmt: EQF4(regf,regf) */
/* 339 */	"\tCMP32(%0,%1)\n\tje\t%a\n",	/* stmt: EQF4(regf,INDIRF4(lgaddr)) */
/* 340 */	"\tCMP64(%0,%1)\n\tje\t%a\n",	/* stmt: EQF8(regf,regf) */
/* 341 */	"\tCMP64(%0,%1)\n\tje\t%a\n",	/* stmt: EQF8(regf,INDIRF8(lgaddr)) */
/* 342 */	"\tcmp\t%0,%1\n\tjne\t%a\n",	/* stmt: NEI2(reg,reg) */
/* 343 */	"\tcmp\t%0,(%1)\n\tjne\t%a\n",	/* stmt: NEI2(reg,INDIRI2(lgaddr)) */
/* 344 */	"\tcmp\t%0,%1\n\tjne\t%a\n",	/* stmt: NEI2(reg,con) */
/* 345 */	"\tcmp\t%0,(%1)\n\tjne\t%a\n",	/* stmt: NEI2(CVII2(reg8),CVII2(INDIRI1(lgaddr))) */
/* 346 */	"\tcmp\t%0,(%1)\n\tjne\t%a\n",	/* stmt: NEI2(CVUI2(reg8),CVII2(INDIRI1(lgaddr))) */
/* 347 */	"\tcmp\t%0,%1\n\tjne\t%a\n",	/* stmt: NEI2(CVII2(reg8),con) */
/* 348 */	"\tcmp\t%0,%1\n\tjne\t%a\n",	/* stmt: NEI2(CVUI2(reg8),con) */
/* 349 */	"\tcmp\t%0,%1\n\tjne\t%a\n",	/* stmt: NEU2(reg,reg) */
/* 350 */	"\tcmp\t%0,(%1)\n\tjne\t%a\n",	/* stmt: NEU2(reg,INDIRU2(lgaddr)) */
/* 351 */	"\tcmp\t%0,%1\n\tjne\t%a\n",	/* stmt: NEU2(reg,con) */
/* 352 */	"\tcmp\t%0,(%1)\n\tjne\t%a\n",	/* stmt: NEU2(CVUU2(reg8),CVUU2(INDIRU1(lgaddr))) */
/* 353 */	"\tcmp\t%0,(%1)\n\tjne\t%a\n",	/* stmt: NEU2(CVIU2(reg8),CVUU2(INDIRU1(lgaddr))) */
/* 354 */	"\tcmp\t%0,%1\n\tjne\t%a\n",	/* stmt: NEU2(CVUU2(reg8),con) */
/* 355 */	"\tcmp\t%0,%1\n\tjne\t%a\n",	/* stmt: NEU2(CVIU2(reg8),con) */
/* 356 */	"\tCMP32(%0,%1)\n\tjne\t%a\n",	/* stmt: NEI4(reg32,reg32) */
/* 357 */	"\tCMP32(%0,%1)\n\tjne\t%a\n",	/* stmt: NEI4(reg32,INDIRI4(lgaddr)) */
/* 358 */	"\tCMP32(%0,%1)\n\tjne\t%a\n",	/* stmt: NEU4(reg32,reg32) */
/* 359 */	"\tCMP32(%0,%1)\n\tjne\t%a\n",	/* stmt: NEU4(reg32,INDIRU4(lgaddr)) */
/* 360 */	"\tCMP32(%0,%1)\n\tjne\t%a\n",	/* stmt: NEF4(regf,regf) */
/* 361 */	"\tCMP32(%0,%1)\n\tjne\t%a\n",	/* stmt: NEF4(regf,INDIRF4(lgaddr)) */
/* 362 */	"\tCMP64(%0,%1)\n\tjne\t%a\n",	/* stmt: NEF8(regf,regf) */
/* 363 */	"\tCMP64(%0,%1)\n\tjne\t%a\n",	/* stmt: NEF8(regf,INDIRF8(lgaddr)) */
/* 364 */	"\tcmp\t%0,%1\n\tjle\t%a\n",	/* stmt: LEI2(reg,reg) */
/* 365 */	"\tcmp\t%0,(%1)\n\tjle\t%a\n",	/* stmt: LEI2(reg,INDIRI2(lgaddr)) */
/* 366 */	"\tcmp\t%0,%1\n\tjle\t%a\n",	/* stmt: LEI2(reg,con) */
/* 367 */	"\tcmp\t%0,(%1)\n\tjle\t%a\n",	/* stmt: LEI2(CVII2(reg8),CVII2(INDIRI1(lgaddr))) */
/* 368 */	"\tcmp\t%0,(%1)\n\tjle\t%a\n",	/* stmt: LEI2(CVUI2(reg8),CVII2(INDIRI1(lgaddr))) */
/* 369 */	"\tcmp\t%0,%1\n\tjle\t%a\n",	/* stmt: LEI2(CVII2(reg8),con) */
/* 370 */	"\tcmp\t%0,%1\n\tjle\t%a\n",	/* stmt: LEI2(CVUI2(reg8),con) */
/* 371 */	"\tcmp\t%0,%1\n\tjleu\t%a\n",	/* stmt: LEU2(reg,reg) */
/* 372 */	"\tcmp\t%0,(%1)\n\tjleu\t%a\n",	/* stmt: LEU2(reg,INDIRU2(lgaddr)) */
/* 373 */	"\tcmp\t%0,%1\n\tjleu\t%a\n",	/* stmt: LEU2(reg,con) */
/* 374 */	"\tcmp\t%0,(%1)\n\tjleu\t%a\n",	/* stmt: LEU2(CVUU2(reg8),CVUU2(INDIRU1(lgaddr))) */
/* 375 */	"\tcmp\t%0,(%1)\n\tjleu\t%a\n",	/* stmt: LEU2(CVIU2(reg8),CVUU2(INDIRU1(lgaddr))) */
/* 376 */	"\tcmp\t%0,%1\n\tjleu\t%a\n",	/* stmt: LEU2(CVUU2(reg8),con) */
/* 377 */	"\tcmp\t%0,%1\n\tjleu\t%a\n",	/* stmt: LEU2(CVIU2(reg8),con) */
/* 378 */	"\tCMP32(%0,%1)\n\tjle\t%a\n",	/* stmt: LEI4(reg32,reg32) */
/* 379 */	"\tCMP32(%0,%1)\n\tjle\t%a\n",	/* stmt: LEI4(reg32,INDIRI4(lgaddr)) */
/* 380 */	"\tCMP32(%0,%1)\n\tjleu\t%a\n",	/* stmt: LEU4(reg32,reg32) */
/* 381 */	"\tCMP32(%0,%1)\n\tjleu\t%a\n",	/* stmt: LEU4(reg32,INDIRU4(lgaddr)) */
/* 382 */	"\tCMP32(%0,%1)\n\tjle\t%a\n",	/* stmt: LEF4(regf,regf) */
/* 383 */	"\tCMP32(%0,%1)\n\tjle\t%a\n",	/* stmt: LEF4(regf,INDIRF4(lgaddr)) */
/* 384 */	"\tCMP64(%0,%1)\n\tjle\t%a\n",	/* stmt: LEF8(regf,regf) */
/* 385 */	"\tCMP64(%0,%1)\n\tjle\t%a\n",	/* stmt: LEF8(regf,INDIRF8(lgaddr)) */
/* 386 */	"\tcmp\t%0,%1\n\tjl\t%a\n",	/* stmt: LTI2(reg,reg) */
/* 387 */	"\tcmp\t%0,(%1)\n\tjl\t%a\n",	/* stmt: LTI2(reg,INDIRI2(lgaddr)) */
/* 388 */	"\tcmp\t%0,%1\n\tjl\t%a\n",	/* stmt: LTI2(reg,con) */
/* 389 */	"\tcmp\t%0,(%1)\n\tjl\t%a\n",	/* stmt: LTI2(CVII2(reg8),CVII2(INDIRI1(lgaddr))) */
/* 390 */	"\tcmp\t%0,(%1)\n\tjl\t%a\n",	/* stmt: LTI2(CVUI2(reg8),CVII2(INDIRI1(lgaddr))) */
/* 391 */	"\tcmp\t%0,%1\n\tjl\t%a\n",	/* stmt: LTI2(CVII2(reg8),con) */
/* 392 */	"\tcmp\t%0,%1\n\tjl\t%a\n",	/* stmt: LTI2(CVUI2(reg8),con) */
/* 393 */	"\tcmp\t%0,%1\n\tjlu\t%a\n",	/* stmt: LTU2(reg,reg) */
/* 394 */	"\tcmp\t%0,(%1)\n\tjlu\t%a\n",	/* stmt: LTU2(reg,INDIRU2(lgaddr)) */
/* 395 */	"\tcmp\t%0,%1\n\tjlu\t%a\n",	/* stmt: LTU2(reg,con) */
/* 396 */	"\tcmp\t%0,(%1)\n\tjlu\t%a\n",	/* stmt: LTU2(CVUU2(reg8),CVUU2(INDIRU1(lgaddr))) */
/* 397 */	"\tcmp\t%0,(%1)\n\tjlu\t%a\n",	/* stmt: LTU2(CVIU2(reg8),CVUU2(INDIRU1(lgaddr))) */
/* 398 */	"\tcmp\t%0,%1\n\tjlu\t%a\n",	/* stmt: LTU2(CVUU2(reg8),con) */
/* 399 */	"\tcmp\t%0,%1\n\tjlu\t%a\n",	/* stmt: LTU2(CVIU2(reg8),con) */
/* 400 */	"\tCMP32(%0,%1)\n\tjl\t%a\n",	/* stmt: LTI4(reg32,reg32) */
/* 401 */	"\tCMP32(%0,%1)\n\tjl\t%a\n",	/* stmt: LTI4(reg32,INDIRI4(lgaddr)) */
/* 402 */	"\tCMP32(%0,%1)\n\tjlu\t%a\n",	/* stmt: LTU4(reg32,reg32) */
/* 403 */	"\tCMP32(%0,%1)\n\tjlu\t%a\n",	/* stmt: LTU4(reg32,INDIRU4(lgaddr)) */
/* 404 */	"\tCMP32(%0,%1)\n\tjl\t%a\n",	/* stmt: LTF4(regf,regf) */
/* 405 */	"\tCMP32(%0,%1)\n\tjl\t%a\n",	/* stmt: LTF4(regf,INDIRF4(lgaddr)) */
/* 406 */	"\tCMP64(%0,%1)\n\tjl\t%a\n",	/* stmt: LTF8(regf,regf) */
/* 407 */	"\tCMP64(%0,%1)\n\tjl\t%a\n",	/* stmt: LTF8(regf,INDIRF8(lgaddr)) */
/* 408 */	"\tcmp\t%0,%1\n\tjge\t%a\n",	/* stmt: GEI2(reg,reg) */
/* 409 */	"\tcmp\t%0,(%1)\n\tjge\t%a\n",	/* stmt: GEI2(reg,INDIRI2(lgaddr)) */
/* 410 */	"\tcmp\t%0,%1\n\tjge\t%a\n",	/* stmt: GEI2(reg,con) */
/* 411 */	"\tcmp\t%0,(%1)\n\tjge\t%a\n",	/* stmt: GEI2(CVII2(reg8),CVII2(INDIRI1(lgaddr))) */
/* 412 */	"\tcmp\t%0,(%1)\n\tjge\t%a\n",	/* stmt: GEI2(CVUI2(reg8),CVII2(INDIRI1(lgaddr))) */
/* 413 */	"\tcmp\t%0,%1\n\tjge\t%a\n",	/* stmt: GEI2(CVII2(reg8),con) */
/* 414 */	"\tcmp\t%0,%1\n\tjge\t%a\n",	/* stmt: GEI2(CVUI2(reg8),con) */
/* 415 */	"\tcmp\t%0,%1\n\tjgeu\t%a\n",	/* stmt: GEU2(reg,reg) */
/* 416 */	"\tcmp\t%0,(%1)\n\tjgeu\t%a\n",	/* stmt: GEU2(reg,INDIRU2(lgaddr)) */
/* 417 */	"\tcmp\t%0,%1\n\tjgeu\t%a\n",	/* stmt: GEU2(reg,con) */
/* 418 */	"\tcmp\t%0,(%1)\n\tjgeu\t%a\n",	/* stmt: GEU2(CVUU2(reg8),CVUU2(INDIRU1(lgaddr))) */
/* 419 */	"\tcmp\t%0,(%1)\n\tjgeu\t%a\n",	/* stmt: GEU2(CVIU2(reg8),CVUU2(INDIRU1(lgaddr))) */
/* 420 */	"\tcmp\t%0,%1\n\tjgeu\t%a\n",	/* stmt: GEU2(CVUU2(reg8),con) */
/* 421 */	"\tcmp\t%0,%1\n\tjgeu\t%a\n",	/* stmt: GEU2(CVIU2(reg8),con) */
/* 422 */	"\tCMP32(%0,%1)\n\tjge\t%a\n",	/* stmt: GEI4(reg32,reg32) */
/* 423 */	"\tCMP32(%0,%1)\n\tjge\t%a\n",	/* stmt: GEI4(reg32,INDIRI4(lgaddr)) */
/* 424 */	"\tCMP32(%0,%1)\n\tjgeu\t%a\n",	/* stmt: GEU4(reg32,reg32) */
/* 425 */	"\tCMP32(%0,%1)\n\tjgeu\t%a\n",	/* stmt: GEU4(reg32,INDIRU4(lgaddr)) */
/* 426 */	"\tCMP32(%0,%1)\n\tjge\t%a\n",	/* stmt: GEF4(regf,regf) */
/* 427 */	"\tCMP32(%0,%1)\n\tjge\t%a\n",	/* stmt: GEF4(regf,INDIRF4(lgaddr)) */
/* 428 */	"\tCMP64(%0,%1)\n\tjge\t%a\n",	/* stmt: GEF8(regf,regf) */
/* 429 */	"\tCMP64(%0,%1)\n\tjge\t%a\n",	/* stmt: GEF8(regf,INDIRF8(lgaddr)) */
/* 430 */	"\tcmp\t%0,%1\n\tjg\t%a\n",	/* stmt: GTI2(reg,reg) */
/* 431 */	"\tcmp\t%0,(%1)\n\tjg\t%a\n",	/* stmt: GTI2(reg,INDIRI2(lgaddr)) */
/* 432 */	"\tcmp\t%0,%1\n\tjg\t%a\n",	/* stmt: GTI2(reg,con) */
/* 433 */	"\tcmp\t%0,(%1)\n\tjg\t%a\n",	/* stmt: GTI2(CVII2(reg8),CVII2(INDIRI1(lgaddr))) */
/* 434 */	"\tcmp\t%0,(%1)\n\tjg\t%a\n",	/* stmt: GTI2(CVUI2(reg8),CVII2(INDIRI1(lgaddr))) */
/* 435 */	"\tcmp\t%0,%1\n\tjg\t%a\n",	/* stmt: GTI2(CVII2(reg8),con) */
/* 436 */	"\tcmp\t%0,%1\n\tjg\t%a\n",	/* stmt: GTI2(CVUI2(reg8),con) */
/* 437 */	"\tcmp\t%0,%1\n\tjgu\t%a\n",	/* stmt: GTU2(reg,reg) */
/* 438 */	"\tcmp\t%0,(%1)\n\tjgu\t%a\n",	/* stmt: GTU2(reg,INDIRU2(lgaddr)) */
/* 439 */	"\tcmp\t%0,%1\n\tjgu\t%a\n",	/* stmt: GTU2(reg,con) */
/* 440 */	"\tcmp\t%0,(%1)\n\tjgu\t%a\n",	/* stmt: GTU2(CVUU2(reg8),CVUU2(INDIRU1(lgaddr))) */
/* 441 */	"\tcmp\t%0,(%1)\n\tjgu\t%a\n",	/* stmt: GTU2(CVIU2(reg8),CVUU2(INDIRU1(lgaddr))) */
/* 442 */	"\tcmp\t%0,%1\n\tjgu\t%a\n",	/* stmt: GTU2(CVUU2(reg8),con) */
/* 443 */	"\tcmp\t%0,%1\n\tjgu\t%a\n",	/* stmt: GTU2(CVIU2(reg8),con) */
/* 444 */	"\tCMP32(%0,%1)\n\tjg\t%a\n",	/* stmt: GTI4(reg32,reg32) */
/* 445 */	"\tCMP32(%0,%1)\n\tjg\t%a\n",	/* stmt: GTI4(reg32,INDIRI4(lgaddr)) */
/* 446 */	"\tCMP32(%0,%1)\n\tjgu\t%a\n",	/* stmt: GTU4(reg32,reg32) */
/* 447 */	"\tCMP32(%0,%1)\n\tjgu\t%a\n",	/* stmt: GTU4(reg32,INDIRU4(lgaddr)) */
/* 448 */	"\tCMP32(%0,%1)\n\tjg\t%a\n",	/* stmt: GTF4(regf,regf) */
/* 449 */	"\tCMP32(%0,%1)\n\tjg\t%a\n",	/* stmt: GTF4(regf,INDIRF4(lgaddr)) */
/* 450 */	"\tCMP64(%0,%1)\n\tjg\t%a\n",	/* stmt: GTF8(regf,regf) */
/* 451 */	"\tCMP64(%0,%1)\n\tjg\t%a\n",	/* stmt: GTF8(regf,INDIRF8(lgaddr)) */
/* 452 */	"# emit2\n",	/* stmt: ARGI2(reg) */
/* 453 */	"# emit2\n",	/* stmt: ARGU2(reg) */
/* 454 */	"# emit2\n",	/* stmt: ARGP2(reg) */
/* 455 */	"# emit2\n",	/* stmt: ARGI4(reg32) */
/* 456 */	"# emit2\n",	/* stmt: ARGU4(reg32) */
/* 457 */	"# emit2\n",	/* stmt: ARGF4(regf) */
/* 458 */	"# emit2\n",	/* stmt: ARGF8(regf) */
/* 459 */	"\tcall\t%0\n",	/* reg: CALLI2(ar) */
/* 460 */	"\tcall\t%0\n",	/* reg: CALLU2(ar) */
/* 461 */	"\tcall\t%0\n",	/* reg: CALLP2(ar) */
/* 462 */	"\tcall\t%0\n",	/* stmt: CALLV(ar) */
/* 463 */	"# emit2\n",	/* reg32: CALLI4(ar) */
/* 464 */	"# emit2\n",	/* reg32: CALLU4(ar) */
/* 465 */	"# emit2\n",	/* regf: CALLF4(ar) */
/* 466 */	"\tlea\tx,%c\n\tcall\t%0\n",	/* regf: CALLF8(ar) */
/* 467 */	"# return\n",	/* stmt: RETI2(reg) */
/* 468 */	"# return\n",	/* stmt: RETU2(reg) */
/* 469 */	"# return\n",	/* stmt: RETP2(reg) */
/* 470 */	"# return\n",	/* stmt: RETV */
/* 471 */	"# return\n",	/* stmt: RETI4(reg32) */
/* 472 */	"# return\n",	/* stmt: RETU4(reg32) */
/* 473 */	"# return\n",	/* stmt: RETF4(regf) */
/* 474 */	"# return\n",	/* stmt: RETF8(regf) */
/* 475 */	"\tjmp\t%0\n",	/* stmt: JUMPV(albl) */
/* 476 */	"\tjmp\t%0\n",	/* stmt: JUMPV(reg) */
/* 477 */	"%a:\n",	/* stmt: LABELV */
};

static char _isinstruction[] = {
/* 0 */	0,
/* 1 */	1,	/* # read register\n */
/* 2 */	1,	/* # read register\n */
/* 3 */	1,	/* # read register\n */
/* 4 */	1,	/* # read register\n */
/* 5 */	1,	/* # read register\n */
/* 6 */	1,	/* # read register\n */
/* 7 */	1,	/* # read register\n */
/* 8 */	1,	/* # read register\n */
/* 9 */	1,	/* # read register\n */
/* 10 */	1,	/* # write register\n */
/* 11 */	1,	/* # write register\n */
/* 12 */	1,	/* # write register\n */
/* 13 */	1,	/* # write register\n */
/* 14 */	1,	/* # write register\n */
/* 15 */	1,	/* # write register\n */
/* 16 */	1,	/* # write register\n */
/* 17 */	1,	/* # write register\n */
/* 18 */	1,	/* # write register\n */
/* 19 */	0,	/*  */
/* 20 */	0,	/*  */
/* 21 */	0,	/*  */
/* 22 */	0,	/*  */
/* 23 */	1,	/* \tpush\t%0\n\tpop\t%c\n */
/* 24 */	1,	/* \tpush\t%0\n\tpop\t%c\n */
/* 25 */	1,	/* # emit2\n */
/* 26 */	1,	/* # emit2\n */
/* 27 */	1,	/* ?\tmov\t%c,%0\n */
/* 28 */	1,	/* ?\tmov\t%c,%0\n */
/* 29 */	1,	/* ?\tmov\t%c,%0\n */
/* 30 */	1,	/* \tld\ta,(%0)\n\tst\t(%c),a\n\tld\ta,(%0+2)\n\tst\t(%c+2),a\n */
/* 31 */	1,	/* \tld\ta,(%0)\n\tst\t(%c),a\n\tld\ta,(%0+2)\n\tst\t(%c+2),a\n */
/* 32 */	1,	/* \tCOPY32(%c,%0)\n */
/* 33 */	1,	/* \tCOPY32(%c,%0)\n */
/* 34 */	0,	/* %0 */
/* 35 */	0,	/* %0 */
/* 36 */	1,	/* # emit2\n */
/* 37 */	1,	/* # emit2\n */
/* 38 */	1,	/* \tld\t%c,(%0+2)\n */
/* 39 */	1,	/* \tld\t%c,(%0+2)\n */
/* 40 */	0,	/* %a */
/* 41 */	0,	/* %a */
/* 42 */	0,	/* %a */
/* 43 */	0,	/* %a */
/* 44 */	0,	/* %a */
/* 45 */	0,	/* %a */
/* 46 */	0,	/* %a */
/* 47 */	0,	/* %a */
/* 48 */	0,	/* %a */
/* 49 */	0,	/* %a */
/* 50 */	0,	/* %a */
/* 51 */	0,	/* %a */
/* 52 */	0,	/* %a */
/* 53 */	0,	/* %a */
/* 54 */	0,	/* %a */
/* 55 */	0,	/* %a */
/* 56 */	0,	/* %a */
/* 57 */	0,	/* %a */
/* 58 */	0,	/* %a */
/* 59 */	1,	/* \tld\t%c,%0\n */
/* 60 */	1,	/* \tld\t%c,0\n */
/* 61 */	1,	/* \tld\t%c,%0\n */
/* 62 */	0,	/* dp:%a */
/* 63 */	0,	/* sp:%a+2+%F */
/* 64 */	0,	/* sp:%a+%F */
/* 65 */	0,	/* %0 */
/* 66 */	0,	/* %0:0 */
/* 67 */	0,	/* %0:%1 */
/* 68 */	0,	/* %0:-%1 */
/* 69 */	0,	/* %a */
/* 70 */	0,	/* %0 */
/* 71 */	0,	/* %0 */
/* 72 */	1,	/* \tlea\t%c,(%0)\n */
/* 73 */	1,	/* \tst\t(%0),%1\n */
/* 74 */	1,	/* \tst\t(%0),%1\n */
/* 75 */	1,	/* \tst\t(%0),%1\n */
/* 76 */	1,	/* \tst\t(%0),%1\n */
/* 77 */	1,	/* \tst\t(%0),%1\n */
/* 78 */	1,	/* # emit2\n */
/* 79 */	1,	/* \tCOPY32(%0,%1)\n */
/* 80 */	1,	/* \tCOPY32(%0,%1)\n */
/* 81 */	1,	/* \tCOPY32(%0,%1)\n */
/* 82 */	1,	/* \tCOPY32(%0,%1)\n */
/* 83 */	1,	/* \tCOPY32(%0,%1)\n */
/* 84 */	1,	/* \tCOPY32(%0,%1)\n */
/* 85 */	1,	/* \tCOPY32(%0,%1)\n */
/* 86 */	1,	/* \tCOPY32(%0,%1)\n */
/* 87 */	1,	/* \tld\t%c,(%0)\n */
/* 88 */	1,	/* \tld\t%c,(%0)\n */
/* 89 */	1,	/* \tld\t%c,(%0)\n */
/* 90 */	1,	/* \tld\t%c,(%0)\n */
/* 91 */	1,	/* \tld\t%c,(%0)\n */
/* 92 */	1,	/* \tCOPY32(%c,%0)\n */
/* 93 */	1,	/* \tld\ta,(%0)\n\tst\t(%c),a\n\tlea\ta,(%0)\n\tld\ta,(a:2)\n\tst\t(%c+2),a\n */
/* 94 */	1,	/* \tCOPY32(%c,%0)\n */
/* 95 */	1,	/* \tCOPY32(%c,%0)\n */
/* 96 */	1,	/* \tCOPY32(%c,%0)\n */
/* 97 */	1,	/* \tCOPY32(%c,%0)\n */
/* 98 */	1,	/* \tCOPY32(%c,%0)\n */
/* 99 */	1,	/* \tCOPY32(%c,%0)\n */
/* 100 */	1,	/* \tCVI32I8(%c,%0)\n */
/* 101 */	1,	/* \tCVI32U8(%c,%0)\n */
/* 102 */	1,	/* \tCVU32I8(%c,%0)\n */
/* 103 */	1,	/* \tCVU32U8(%c,%0)\n */
/* 104 */	1,	/* \tsex\t%c\n */
/* 105 */	1,	/* \tand\t%c,0x00ff\n */
/* 106 */	1,	/* \tand\t%c,0x00ff\n */
/* 107 */	1,	/* \tand\t%c,0x00ff\n */
/* 108 */	1,	/* \tCVI8I32(%c,%0)\n */
/* 109 */	1,	/* \tCVI8U32(%c,%0)\n */
/* 110 */	1,	/* \tCVU8I32(%c,%0)\n */
/* 111 */	1,	/* \tCVU8U32(%c,%0)\n */
/* 112 */	1,	/* \tCVI16I32(%c,%0)\n */
/* 113 */	1,	/* \tst\t(%c+2),%0\n\tld\ta,0\n\tst\t(%c),a\n */
/* 114 */	1,	/* \tst\t(%c+2),%0\n\tld\ta,0\n\tst\t(%c),a\n */
/* 115 */	1,	/* \tst\t(%c+2),%0\n\tld\ta,0\n\tst\t(%c),a\n */
/* 116 */	1,	/* \tCVTI8F32(%c,%0)\n */
/* 117 */	1,	/* \tCVTI16F32(%c,%0)\n */
/* 118 */	1,	/* \tCVTI32F32(%c,%0)\n */
/* 119 */	1,	/* \tCVTI8F64(%c,%0)\n */
/* 120 */	1,	/* \tCVTI16F64(%c,%0)\n */
/* 121 */	1,	/* \tCVTI32F64(%c,%0)\n */
/* 122 */	1,	/* \tCVTFI16(%c,%0)\n */
/* 123 */	1,	/* \tCVTFI32(%c,%0)\n */
/* 124 */	1,	/* \tCVTF64F32(%c,%0)\n */
/* 125 */	1,	/* \tCVTF32F64(%c,%0)\n */
/* 126 */	1,	/* \tmov\t%c,%0\n */
/* 127 */	1,	/* \tmov\t%c,%0\n */
/* 128 */	1,	/* ?\tmov\t%c,%0\n\tadd\t%c,%1\n */
/* 129 */	1,	/* ?\tmov\t%c,%0\n\tadd\t%c,(%1)\n */
/* 130 */	1,	/* ?\tmov\t%c,%0\n\tadd\t%c,%1\n */
/* 131 */	1,	/* ?\tmov\t%c,%0\n\tadd\t%c,%1\n */
/* 132 */	1,	/* ?\tmov\t%c,%0\n\tadd\t%c,(%1)\n */
/* 133 */	1,	/* ?\tmov\t%c,%0\n\tadd\t%c,%1\n */
/* 134 */	1,	/* ?\tmov\t%c,%0\n\tadd\t%c,%1\n */
/* 135 */	1,	/* ?\tmov\t%c,%0\n\tadd\t%c,%1\n */
/* 136 */	1,	/* # emit2 (use AH/AL instead of A)\n */
/* 137 */	1,	/* # emit2 (use AH/AL instead of A)\n */
/* 138 */	1,	/* # emit2 (use AH/AL instead of A)\n */
/* 139 */	1,	/* # emit2 (use AH/AL instead of A)\n */
/* 140 */	1,	/* # emit2 (use AH/AL instead of A)\n */
/* 141 */	1,	/* # emit2 (use AH/AL instead of A)\n */
/* 142 */	1,	/* # emit2 (use AH/AL instead of A)\n */
/* 143 */	1,	/* # emit2 (use AH/AL instead of A)\n */
/* 144 */	1,	/* # emit2 (use AH/AL instead of A)\n */
/* 145 */	1,	/* # emit2 (use AH/AL instead of A)\n */
/* 146 */	1,	/* # emit2 (use AH/AL instead of A)\n */
/* 147 */	1,	/* # emit2 (use AH/AL instead of A)\n */
/* 148 */	1,	/* ?\tCOPY32(%c,%0)\n\tADDI32(%c,%1)\n */
/* 149 */	1,	/* ?\tCOPY32(%c,%0)\n\tADDI32(%c,%1)\n */
/* 150 */	1,	/* ?\tld\ta,(%0)\tst\t(%c),a\tld\ta,(%0+2)\tst\t(%c+2),a\n\tld\ta,(%c+2)\n\tadd\ta,(%1+2)\n\tst\t(%c+2),a\n\tld\ta,(%c)\n\tld\ty,(%1)\n\tadc\ta,y\n\tst\t(%c),a\n */
/* 151 */	1,	/* ?\tld\ta,(%0)\tst\t(%c),a\tld\ta,(%0+2)\tst\t(%c+2),a\n\tlea\ty,(%1)\n\tld\ta,(%c+2)\n\tadd\ta,(y:2)\n\tst\t(%c+2),a\n\tld\ta,(%c)\n\tld\ty,(y:0)\n\tadc\ta,y\n\tst\t(%c),a\n */
/* 152 */	1,	/* ?\tCOPY32(%c,%0)\n\tADDF32(%c,%1)\n */
/* 153 */	1,	/* ?\tCOPY32(%c,%0)\n\tADDF32(%c,%1)\n */
/* 154 */	1,	/* ?\tCOPY32(%c,%0)\n\tADDF64(%c,%1)\n */
/* 155 */	1,	/* ?\tCOPY32(%c,%0)\n\tADDF64(%c,%1)\n */
/* 156 */	1,	/* \tCOPY32(%0,%1)\n\tADDI32(%0,%2)\n */
/* 157 */	1,	/* \tADDI32(%1,%2)\n */
/* 158 */	1,	/* \tCOPY32(%0,%1)\n\tADDU32(%0,%2)\n */
/* 159 */	1,	/* \tADDU32(%1,%2)\n */
/* 160 */	1,	/* \tCOPY32(%0,%1)\n\tADDF32(%0,%2)\n */
/* 161 */	1,	/* \tADDF32(%1,%2)\n */
/* 162 */	1,	/* \tCOPY32(%0,%1)\n\tADDF64(%0,%2)\n */
/* 163 */	1,	/* \tADDF64(%1,%2)\n */
/* 164 */	1,	/* ?\tmov\t%c,%0\n\tsub\t%c,%1\n */
/* 165 */	1,	/* ?\tmov\t%c,%0\n\tsub\t%c,(%1)\n */
/* 166 */	1,	/* ?\tmov\t%c,%0\n\tsub\t%c,%1\n */
/* 167 */	1,	/* ?\tmov\t%c,%0\n\tsub\t%c,%1\n */
/* 168 */	1,	/* ?\tmov\t%c,%0\n\tsub\t%c,(%1)\n */
/* 169 */	1,	/* ?\tmov\t%c,%0\n\tsub\t%c,%1\n */
/* 170 */	1,	/* ?\tmov\t%c,%0\n\tsub\t%c,%1\n */
/* 171 */	1,	/* ?\tmov\t%c,%0\n\tsub\t%c,%1\n */
/* 172 */	1,	/* # emit2 (use AH/AL instead of A)\n */
/* 173 */	1,	/* # emit2 (use AH/AL instead of A)\n */
/* 174 */	1,	/* # emit2 (use AH/AL instead of A)\n */
/* 175 */	1,	/* # emit2 (use AH/AL instead of A)\n */
/* 176 */	1,	/* # emit2 (use AH/AL instead of A)\n */
/* 177 */	1,	/* # emit2 (use AH/AL instead of A)\n */
/* 178 */	1,	/* # emit2 (use AH/AL instead of A)\n */
/* 179 */	1,	/* # emit2 (use AH/AL instead of A)\n */
/* 180 */	1,	/* # emit2 (use AH/AL instead of A)\n */
/* 181 */	1,	/* # emit2 (use AH/AL instead of A)\n */
/* 182 */	1,	/* # emit2 (use AH/AL instead of A)\n */
/* 183 */	1,	/* # emit2 (use AH/AL instead of A)\n */
/* 184 */	1,	/* ?\tCOPY32(%c,%0)\n\tSUBI32(%c,%1)\n */
/* 185 */	1,	/* ?\tCOPY32(%c,%0)\n\tSUBI32(%c,%1)\n */
/* 186 */	1,	/* ?\tld\ta,(%0)\tst\t(%c),a\tld\ta,(%0+2)\tst\t(%c+2),a\n\tld\ta,(%c+2)\n\tsub\ta,(%1+2)\n\tst\t(%c+2),a\n\tld\ta,(%c)\n\tld\ty,(%1)\n\tsbc\ta,y\n\tst\t(%c),a\n */
/* 187 */	1,	/* ?\tld\ta,(%0)\tst\t(%c),a\tld\ta,(%0+2)\tst\t(%c+2),a\n\tlea\ty,(%1)\n\tld\ta,(%c+2)\n\tsub\ta,(y:2)\n\tst\t(%c+2),a\n\tld\ta,(%c)\n\tld\ty,(y:0)\n\tsbc\ta,y\n\tst\t(%c),a\n */
/* 188 */	1,	/* ?\tCOPY32(%c,%0)\n\tSUBF32(%c,%1)\n */
/* 189 */	1,	/* ?\tCOPY32(%c,%0)\n\tSUBF32(%c,%1)\n */
/* 190 */	1,	/* ?\tCOPY32(%c,%0)\n\tSUBF64(%c,%1)\n */
/* 191 */	1,	/* ?\tCOPY32(%c,%0)\n\tSUBF64(%c,%1)\n */
/* 192 */	1,	/* \tCOPY32(%0,%1)\n\tSUBI32(%0,%2)\n */
/* 193 */	1,	/* \tSUBI32(%1,%2)\n */
/* 194 */	1,	/* \tCOPY32(%0,%1)\n\tSUBU32(%0,%2)\n */
/* 195 */	1,	/* \tSUBU32(%1,%2)\n */
/* 196 */	1,	/* \tCOPY32(%0,%1)\n\tSUBF32(%0,%2)\n */
/* 197 */	1,	/* \tSUBF32(%1,%2)\n */
/* 198 */	1,	/* \tCOPY32(%0,%1)\n\tSUBF64(%0,%2)\n */
/* 199 */	1,	/* \tSUBF64(%1,%2)\n */
/* 200 */	1,	/* \tld\t%c,0\n\tsub\t%c,%0\n */
/* 201 */	1,	/* \tld\t%c,0\n\tsub\t%c,(%0)\n */
/* 202 */	1,	/* \tNEGI32(%c,%0)\n */
/* 203 */	1,	/* \tNEGI32(%c,%0)\n */
/* 204 */	1,	/* \tNEGF32(%c,%0)\n */
/* 205 */	1,	/* \tNEGF32(%c,%0)\n */
/* 206 */	1,	/* \tNEGF64(%c,%0)\n */
/* 207 */	1,	/* \tNEGF64(%c,%0)\n */
/* 208 */	1,	/* ?\tmov\t%c,%0\n\tand\t%c,%1\n */
/* 209 */	1,	/* ?\tmov\t%c,%0\n\tand\t%c,(%1)\n */
/* 210 */	1,	/* ?\tmov\t%c,%0\n\tand\t%c,%1\n */
/* 211 */	1,	/* ?\tmov\t%c,%0\n\tand\t%c,%1\n */
/* 212 */	1,	/* ?\tmov\t%c,%0\n\tand\t%c,(%1)\n */
/* 213 */	1,	/* ?\tmov\t%c,%0\n\tand\t%c,%1\n */
/* 214 */	1,	/* # emit2 (use AH/AL instead of A)\n */
/* 215 */	1,	/* # emit2 (use AH/AL instead of A)\n */
/* 216 */	1,	/* # emit2 (use AH/AL instead of A)\n */
/* 217 */	1,	/* # emit2 (use AH/AL instead of A)\n */
/* 218 */	1,	/* # emit2 (use AH/AL instead of A)\n */
/* 219 */	1,	/* # emit2 (use AH/AL instead of A)\n */
/* 220 */	1,	/* # emit2 (use AH/AL instead of A)\n */
/* 221 */	1,	/* # emit2 (use AH/AL instead of A)\n */
/* 222 */	1,	/* # emit2 (use AH/AL instead of A)\n */
/* 223 */	1,	/* # emit2 (use AH/AL instead of A)\n */
/* 224 */	1,	/* # emit2 (use AH/AL instead of A)\n */
/* 225 */	1,	/* # emit2 (use AH/AL instead of A)\n */
/* 226 */	1,	/* ?\tCOPY32(%c,%0)\n\tBANDI32(%c,%1)\n */
/* 227 */	1,	/* ?\tCOPY32(%c,%0)\n\tBANDI32(%c,%1)\n */
/* 228 */	1,	/* ?\tCOPY32(%c,%0)\n\tBANDI32(%c,%1)\n */
/* 229 */	1,	/* ?\tCOPY32(%c,%0)\n\tBANDI32(%c,%1)\n */
/* 230 */	1,	/* \tmov\t%c,-1\n\txor\t%c,%0\n */
/* 231 */	1,	/* \tmov\t%c,-1\n\txor\t%c,%0\n */
/* 232 */	1,	/* \tBCOMI32(%c,%0)\n */
/* 233 */	1,	/* \tBCOMI32(%c,%0)\n */
/* 234 */	1,	/* ?\tmov\t%c,%0\n\tor\t%c,%1\n */
/* 235 */	1,	/* ?\tmov\t%c,%0\n\tor\t%c,(%1)\n */
/* 236 */	1,	/* ?\tmov\t%c,%0\n\tor\t%c,%1\n */
/* 237 */	1,	/* ?\tmov\t%c,%0\n\tor\t%c,%1\n */
/* 238 */	1,	/* ?\tmov\t%c,%0\n\tor\t%c,(%1)\n */
/* 239 */	1,	/* ?\tmov\t%c,%0\n\tor\t%c,%1\n */
/* 240 */	1,	/* # emit2 (use AH/AL instead of A)\n */
/* 241 */	1,	/* # emit2 (use AH/AL instead of A)\n */
/* 242 */	1,	/* # emit2 (use AH/AL instead of A)\n */
/* 243 */	1,	/* # emit2 (use AH/AL instead of A)\n */
/* 244 */	1,	/* # emit2 (use AH/AL instead of A)\n */
/* 245 */	1,	/* # emit2 (use AH/AL instead of A)\n */
/* 246 */	1,	/* # emit2 (use AH/AL instead of A)\n */
/* 247 */	1,	/* # emit2 (use AH/AL instead of A)\n */
/* 248 */	1,	/* # emit2 (use AH/AL instead of A)\n */
/* 249 */	1,	/* # emit2 (use AH/AL instead of A)\n */
/* 250 */	1,	/* # emit2 (use AH/AL instead of A)\n */
/* 251 */	1,	/* # emit2 (use AH/AL instead of A)\n */
/* 252 */	1,	/* ?\tCOPY32(%c,%0)\n\tBORI32(%c,%1)\n */
/* 253 */	1,	/* ?\tCOPY32(%c,%0)\n\tBORI32(%c,%1)\n */
/* 254 */	1,	/* ?\tCOPY32(%c,%0)\n\tBORI32(%c,%1)\n */
/* 255 */	1,	/* ?\tCOPY32(%c,%0)\n\tBORI32(%c,%1)\n */
/* 256 */	1,	/* ?\tmov\t%c,%0\n\txor\t%c,%1\n */
/* 257 */	1,	/* ?\tmov\t%c,%0\n\txor\t%c,(%1)\n */
/* 258 */	1,	/* ?\tmov\t%c,%0\n\txor\t%c,%1\n */
/* 259 */	1,	/* ?\tmov\t%c,%0\n\txor\t%c,%1\n */
/* 260 */	1,	/* ?\tmov\t%c,%0\n\txor\t%c,(%1)\n */
/* 261 */	1,	/* ?\tmov\t%c,%0\n\txor\t%c,%1\n */
/* 262 */	1,	/* # emit2 (use AH/AL instead of A)\n */
/* 263 */	1,	/* # emit2 (use AH/AL instead of A)\n */
/* 264 */	1,	/* # emit2 (use AH/AL instead of A)\n */
/* 265 */	1,	/* # emit2 (use AH/AL instead of A)\n */
/* 266 */	1,	/* # emit2 (use AH/AL instead of A)\n */
/* 267 */	1,	/* # emit2 (use AH/AL instead of A)\n */
/* 268 */	1,	/* # emit2 (use AH/AL instead of A)\n */
/* 269 */	1,	/* # emit2 (use AH/AL instead of A)\n */
/* 270 */	1,	/* # emit2 (use AH/AL instead of A)\n */
/* 271 */	1,	/* # emit2 (use AH/AL instead of A)\n */
/* 272 */	1,	/* # emit2 (use AH/AL instead of A)\n */
/* 273 */	1,	/* # emit2 (use AH/AL instead of A)\n */
/* 274 */	1,	/* ?\tCOPY32(%c,%0)\n\tBXORI32(%c,%1)\n */
/* 275 */	1,	/* ?\tCOPY32(%c,%0)\n\tBXORI32(%c,%1)\n */
/* 276 */	1,	/* ?\tCOPY32(%c,%0)\n\tBXORI32(%c,%1)\n */
/* 277 */	1,	/* ?\tCOPY32(%c,%0)\n\tBXORI32(%c,%1)\n */
/* 278 */	1,	/* ?\tmov\t%c,%0\n\tcall\t__muli16\n */
/* 279 */	1,	/* ?\tmov\t%c,%0\n\tcall\t__mulu16\n */
/* 280 */	1,	/* ?\tmov\t%c,%0\n\tcall\t__divi16\n */
/* 281 */	1,	/* ?\tmov\t%c,%0\n\tcall\t__divu16\n */
/* 282 */	1,	/* ?\tmov\t%c,%0\n\tcall\t__modi16\n */
/* 283 */	1,	/* ?\tmov\t%c,%0\n\tcall\t__modu16\n */
/* 284 */	1,	/* ?\tCOPY32(%c,%0)\n\tMULI32(%c,%1)\n */
/* 285 */	1,	/* ?\tCOPY32(%c,%0)\n\tMULI32(%c,%1)\n */
/* 286 */	1,	/* ?\tCOPY32(%c,%0)\n\tMULU32(%c,%1)\n */
/* 287 */	1,	/* ?\tCOPY32(%c,%0)\n\tMULU32(%c,%1)\n */
/* 288 */	1,	/* ?\tCOPY32(%c,%0)\n\tDIVI32(%c,%1)\n */
/* 289 */	1,	/* ?\tCOPY32(%c,%0)\n\tDIVI32(%c,%1)\n */
/* 290 */	1,	/* ?\tCOPY32(%c,%0)\n\tDIVU32(%c,%1)\n */
/* 291 */	1,	/* ?\tCOPY32(%c,%0)\n\tDIVU32(%c,%1)\n */
/* 292 */	1,	/* ?\tCOPY32(%c,%0)\n\tMODI32(%c,%1)\n */
/* 293 */	1,	/* ?\tCOPY32(%c,%0)\n\tMODI32(%c,%1)\n */
/* 294 */	1,	/* ?\tCOPY32(%c,%0)\n\tMODU32(%c,%1)\n */
/* 295 */	1,	/* ?\tCOPY32(%c,%0)\n\tMODU32(%c,%1)\n */
/* 296 */	1,	/* ?\tCOPY32(%c,%0)\n\tMULF32(%c,%1)\n */
/* 297 */	1,	/* ?\tCOPY32(%c,%0)\n\tMULF32(%c,%1)\n */
/* 298 */	1,	/* ?\tCOPY32(%c,%0)\n\tMULF64(%c,%1)\n */
/* 299 */	1,	/* ?\tCOPY32(%c,%0)\n\tMULF64(%c,%1)\n */
/* 300 */	1,	/* ?\tCOPY32(%c,%0)\n\tDIVF32(%c,%1)\n */
/* 301 */	1,	/* ?\tCOPY32(%c,%0)\n\tDIVF32(%c,%1)\n */
/* 302 */	1,	/* ?\tCOPY32(%c,%0)\n\tDIVF64(%c,%1)\n */
/* 303 */	1,	/* ?\tCOPY32(%c,%0)\n\tDIVF64(%c,%1)\n */
/* 304 */	1,	/* ?\tmov\t%c,%0\n\tshl\t%c\n */
/* 305 */	1,	/* ?\tmov\t%c,%0\n\tshl\t%c\n */
/* 306 */	1,	/* ?\tmov\t%c,%0\n\tshr\t%c\n */
/* 307 */	1,	/* ?\tmov\t%c,%0\n\tshr\t%c\n */
/* 308 */	1,	/* ?\tmov\t%c,%0\n\tshl\t%c\n\tshl\t%c\n */
/* 309 */	1,	/* ?\tmov\t%c,%0\n\tshl\t%c\n\tshl\t%c\n */
/* 310 */	1,	/* ?\tmov\t%c,%0\n\tshr\t%c\n\tshr\t%c\n */
/* 311 */	1,	/* ?\tmov\t%c,%0\n\tshr\t%c\n\tshr\t%c\n */
/* 312 */	1,	/* # emit2 (loop)\n */
/* 313 */	1,	/* # emit2 (loop)\n */
/* 314 */	1,	/* # emit2 (loop)\n */
/* 315 */	1,	/* # emit2 (loop)\n */
/* 316 */	1,	/* ?\tCOPY32(%c,%0)\n\tLSHI32(%0)\n */
/* 317 */	1,	/* ?\tld\ta,(%0)\tst\t(%c),a\tld\ta,(%0+2)\tst\t(%c+2),a\n\tld\ta,(%c)\n\tshl\ta\nst\t(%c),a\n\tld\ta,(%c+2)\n\tshl\ta\nst\t(%c+2),a\n\tld\ta,(%c)\n\tld\ty,0\n\tadc\ta,y\n\tst\t(%c),a\n */
/* 318 */	1,	/* ?\tCOPY32(%c,%0)\n\tRSHI32(%0)\n */
/* 319 */	1,	/* ?\tCOPY32(%c,%0)\n\tRSHU32(%0)\n */
/* 320 */	1,	/* \tcmp\t%0,%1\n\tje\t%a\n */
/* 321 */	1,	/* \tcmp\t%0,(%1)\n\tje\t%a\n */
/* 322 */	1,	/* \tcmp\t%0,%1\n\tje\t%a\n */
/* 323 */	1,	/* \tcmp\t%0,(%1)\n\tje\t%a\n */
/* 324 */	1,	/* \tcmp\t%0,(%1)\n\tje\t%a\n */
/* 325 */	1,	/* \tcmp\t%0,%1\n\tje\t%a\n */
/* 326 */	1,	/* \tcmp\t%0,%1\n\tje\t%a\n */
/* 327 */	1,	/* \tcmp\t%0,%1\n\tje\t%a\n */
/* 328 */	1,	/* \tcmp\t%0,(%1)\n\tje\t%a\n */
/* 329 */	1,	/* \tcmp\t%0,%1\n\tje\t%a\n */
/* 330 */	1,	/* \tcmp\t%0,(%1)\n\tje\t%a\n */
/* 331 */	1,	/* \tcmp\t%0,(%1)\n\tje\t%a\n */
/* 332 */	1,	/* \tcmp\t%0,%1\n\tje\t%a\n */
/* 333 */	1,	/* \tcmp\t%0,%1\n\tje\t%a\n */
/* 334 */	1,	/* \tCMP32(%0,%1)\n\tje\t%a\n */
/* 335 */	1,	/* \tCMP32(%0,%1)\n\tje\t%a\n */
/* 336 */	1,	/* \tCMP32(%0,%1)\n\tje\t%a\n */
/* 337 */	1,	/* \tCMP32(%0,%1)\n\tje\t%a\n */
/* 338 */	1,	/* \tCMP32(%0,%1)\n\tje\t%a\n */
/* 339 */	1,	/* \tCMP32(%0,%1)\n\tje\t%a\n */
/* 340 */	1,	/* \tCMP64(%0,%1)\n\tje\t%a\n */
/* 341 */	1,	/* \tCMP64(%0,%1)\n\tje\t%a\n */
/* 342 */	1,	/* \tcmp\t%0,%1\n\tjne\t%a\n */
/* 343 */	1,	/* \tcmp\t%0,(%1)\n\tjne\t%a\n */
/* 344 */	1,	/* \tcmp\t%0,%1\n\tjne\t%a\n */
/* 345 */	1,	/* \tcmp\t%0,(%1)\n\tjne\t%a\n */
/* 346 */	1,	/* \tcmp\t%0,(%1)\n\tjne\t%a\n */
/* 347 */	1,	/* \tcmp\t%0,%1\n\tjne\t%a\n */
/* 348 */	1,	/* \tcmp\t%0,%1\n\tjne\t%a\n */
/* 349 */	1,	/* \tcmp\t%0,%1\n\tjne\t%a\n */
/* 350 */	1,	/* \tcmp\t%0,(%1)\n\tjne\t%a\n */
/* 351 */	1,	/* \tcmp\t%0,%1\n\tjne\t%a\n */
/* 352 */	1,	/* \tcmp\t%0,(%1)\n\tjne\t%a\n */
/* 353 */	1,	/* \tcmp\t%0,(%1)\n\tjne\t%a\n */
/* 354 */	1,	/* \tcmp\t%0,%1\n\tjne\t%a\n */
/* 355 */	1,	/* \tcmp\t%0,%1\n\tjne\t%a\n */
/* 356 */	1,	/* \tCMP32(%0,%1)\n\tjne\t%a\n */
/* 357 */	1,	/* \tCMP32(%0,%1)\n\tjne\t%a\n */
/* 358 */	1,	/* \tCMP32(%0,%1)\n\tjne\t%a\n */
/* 359 */	1,	/* \tCMP32(%0,%1)\n\tjne\t%a\n */
/* 360 */	1,	/* \tCMP32(%0,%1)\n\tjne\t%a\n */
/* 361 */	1,	/* \tCMP32(%0,%1)\n\tjne\t%a\n */
/* 362 */	1,	/* \tCMP64(%0,%1)\n\tjne\t%a\n */
/* 363 */	1,	/* \tCMP64(%0,%1)\n\tjne\t%a\n */
/* 364 */	1,	/* \tcmp\t%0,%1\n\tjle\t%a\n */
/* 365 */	1,	/* \tcmp\t%0,(%1)\n\tjle\t%a\n */
/* 366 */	1,	/* \tcmp\t%0,%1\n\tjle\t%a\n */
/* 367 */	1,	/* \tcmp\t%0,(%1)\n\tjle\t%a\n */
/* 368 */	1,	/* \tcmp\t%0,(%1)\n\tjle\t%a\n */
/* 369 */	1,	/* \tcmp\t%0,%1\n\tjle\t%a\n */
/* 370 */	1,	/* \tcmp\t%0,%1\n\tjle\t%a\n */
/* 371 */	1,	/* \tcmp\t%0,%1\n\tjleu\t%a\n */
/* 372 */	1,	/* \tcmp\t%0,(%1)\n\tjleu\t%a\n */
/* 373 */	1,	/* \tcmp\t%0,%1\n\tjleu\t%a\n */
/* 374 */	1,	/* \tcmp\t%0,(%1)\n\tjleu\t%a\n */
/* 375 */	1,	/* \tcmp\t%0,(%1)\n\tjleu\t%a\n */
/* 376 */	1,	/* \tcmp\t%0,%1\n\tjleu\t%a\n */
/* 377 */	1,	/* \tcmp\t%0,%1\n\tjleu\t%a\n */
/* 378 */	1,	/* \tCMP32(%0,%1)\n\tjle\t%a\n */
/* 379 */	1,	/* \tCMP32(%0,%1)\n\tjle\t%a\n */
/* 380 */	1,	/* \tCMP32(%0,%1)\n\tjleu\t%a\n */
/* 381 */	1,	/* \tCMP32(%0,%1)\n\tjleu\t%a\n */
/* 382 */	1,	/* \tCMP32(%0,%1)\n\tjle\t%a\n */
/* 383 */	1,	/* \tCMP32(%0,%1)\n\tjle\t%a\n */
/* 384 */	1,	/* \tCMP64(%0,%1)\n\tjle\t%a\n */
/* 385 */	1,	/* \tCMP64(%0,%1)\n\tjle\t%a\n */
/* 386 */	1,	/* \tcmp\t%0,%1\n\tjl\t%a\n */
/* 387 */	1,	/* \tcmp\t%0,(%1)\n\tjl\t%a\n */
/* 388 */	1,	/* \tcmp\t%0,%1\n\tjl\t%a\n */
/* 389 */	1,	/* \tcmp\t%0,(%1)\n\tjl\t%a\n */
/* 390 */	1,	/* \tcmp\t%0,(%1)\n\tjl\t%a\n */
/* 391 */	1,	/* \tcmp\t%0,%1\n\tjl\t%a\n */
/* 392 */	1,	/* \tcmp\t%0,%1\n\tjl\t%a\n */
/* 393 */	1,	/* \tcmp\t%0,%1\n\tjlu\t%a\n */
/* 394 */	1,	/* \tcmp\t%0,(%1)\n\tjlu\t%a\n */
/* 395 */	1,	/* \tcmp\t%0,%1\n\tjlu\t%a\n */
/* 396 */	1,	/* \tcmp\t%0,(%1)\n\tjlu\t%a\n */
/* 397 */	1,	/* \tcmp\t%0,(%1)\n\tjlu\t%a\n */
/* 398 */	1,	/* \tcmp\t%0,%1\n\tjlu\t%a\n */
/* 399 */	1,	/* \tcmp\t%0,%1\n\tjlu\t%a\n */
/* 400 */	1,	/* \tCMP32(%0,%1)\n\tjl\t%a\n */
/* 401 */	1,	/* \tCMP32(%0,%1)\n\tjl\t%a\n */
/* 402 */	1,	/* \tCMP32(%0,%1)\n\tjlu\t%a\n */
/* 403 */	1,	/* \tCMP32(%0,%1)\n\tjlu\t%a\n */
/* 404 */	1,	/* \tCMP32(%0,%1)\n\tjl\t%a\n */
/* 405 */	1,	/* \tCMP32(%0,%1)\n\tjl\t%a\n */
/* 406 */	1,	/* \tCMP64(%0,%1)\n\tjl\t%a\n */
/* 407 */	1,	/* \tCMP64(%0,%1)\n\tjl\t%a\n */
/* 408 */	1,	/* \tcmp\t%0,%1\n\tjge\t%a\n */
/* 409 */	1,	/* \tcmp\t%0,(%1)\n\tjge\t%a\n */
/* 410 */	1,	/* \tcmp\t%0,%1\n\tjge\t%a\n */
/* 411 */	1,	/* \tcmp\t%0,(%1)\n\tjge\t%a\n */
/* 412 */	1,	/* \tcmp\t%0,(%1)\n\tjge\t%a\n */
/* 413 */	1,	/* \tcmp\t%0,%1\n\tjge\t%a\n */
/* 414 */	1,	/* \tcmp\t%0,%1\n\tjge\t%a\n */
/* 415 */	1,	/* \tcmp\t%0,%1\n\tjgeu\t%a\n */
/* 416 */	1,	/* \tcmp\t%0,(%1)\n\tjgeu\t%a\n */
/* 417 */	1,	/* \tcmp\t%0,%1\n\tjgeu\t%a\n */
/* 418 */	1,	/* \tcmp\t%0,(%1)\n\tjgeu\t%a\n */
/* 419 */	1,	/* \tcmp\t%0,(%1)\n\tjgeu\t%a\n */
/* 420 */	1,	/* \tcmp\t%0,%1\n\tjgeu\t%a\n */
/* 421 */	1,	/* \tcmp\t%0,%1\n\tjgeu\t%a\n */
/* 422 */	1,	/* \tCMP32(%0,%1)\n\tjge\t%a\n */
/* 423 */	1,	/* \tCMP32(%0,%1)\n\tjge\t%a\n */
/* 424 */	1,	/* \tCMP32(%0,%1)\n\tjgeu\t%a\n */
/* 425 */	1,	/* \tCMP32(%0,%1)\n\tjgeu\t%a\n */
/* 426 */	1,	/* \tCMP32(%0,%1)\n\tjge\t%a\n */
/* 427 */	1,	/* \tCMP32(%0,%1)\n\tjge\t%a\n */
/* 428 */	1,	/* \tCMP64(%0,%1)\n\tjge\t%a\n */
/* 429 */	1,	/* \tCMP64(%0,%1)\n\tjge\t%a\n */
/* 430 */	1,	/* \tcmp\t%0,%1\n\tjg\t%a\n */
/* 431 */	1,	/* \tcmp\t%0,(%1)\n\tjg\t%a\n */
/* 432 */	1,	/* \tcmp\t%0,%1\n\tjg\t%a\n */
/* 433 */	1,	/* \tcmp\t%0,(%1)\n\tjg\t%a\n */
/* 434 */	1,	/* \tcmp\t%0,(%1)\n\tjg\t%a\n */
/* 435 */	1,	/* \tcmp\t%0,%1\n\tjg\t%a\n */
/* 436 */	1,	/* \tcmp\t%0,%1\n\tjg\t%a\n */
/* 437 */	1,	/* \tcmp\t%0,%1\n\tjgu\t%a\n */
/* 438 */	1,	/* \tcmp\t%0,(%1)\n\tjgu\t%a\n */
/* 439 */	1,	/* \tcmp\t%0,%1\n\tjgu\t%a\n */
/* 440 */	1,	/* \tcmp\t%0,(%1)\n\tjgu\t%a\n */
/* 441 */	1,	/* \tcmp\t%0,(%1)\n\tjgu\t%a\n */
/* 442 */	1,	/* \tcmp\t%0,%1\n\tjgu\t%a\n */
/* 443 */	1,	/* \tcmp\t%0,%1\n\tjgu\t%a\n */
/* 444 */	1,	/* \tCMP32(%0,%1)\n\tjg\t%a\n */
/* 445 */	1,	/* \tCMP32(%0,%1)\n\tjg\t%a\n */
/* 446 */	1,	/* \tCMP32(%0,%1)\n\tjgu\t%a\n */
/* 447 */	1,	/* \tCMP32(%0,%1)\n\tjgu\t%a\n */
/* 448 */	1,	/* \tCMP32(%0,%1)\n\tjg\t%a\n */
/* 449 */	1,	/* \tCMP32(%0,%1)\n\tjg\t%a\n */
/* 450 */	1,	/* \tCMP64(%0,%1)\n\tjg\t%a\n */
/* 451 */	1,	/* \tCMP64(%0,%1)\n\tjg\t%a\n */
/* 452 */	1,	/* # emit2\n */
/* 453 */	1,	/* # emit2\n */
/* 454 */	1,	/* # emit2\n */
/* 455 */	1,	/* # emit2\n */
/* 456 */	1,	/* # emit2\n */
/* 457 */	1,	/* # emit2\n */
/* 458 */	1,	/* # emit2\n */
/* 459 */	1,	/* \tcall\t%0\n */
/* 460 */	1,	/* \tcall\t%0\n */
/* 461 */	1,	/* \tcall\t%0\n */
/* 462 */	1,	/* \tcall\t%0\n */
/* 463 */	1,	/* # emit2\n */
/* 464 */	1,	/* # emit2\n */
/* 465 */	1,	/* # emit2\n */
/* 466 */	1,	/* \tlea\tx,%c\n\tcall\t%0\n */
/* 467 */	1,	/* # return\n */
/* 468 */	1,	/* # return\n */
/* 469 */	1,	/* # return\n */
/* 470 */	1,	/* # return\n */
/* 471 */	1,	/* # return\n */
/* 472 */	1,	/* # return\n */
/* 473 */	1,	/* # return\n */
/* 474 */	1,	/* # return\n */
/* 475 */	1,	/* \tjmp\t%0\n */
/* 476 */	1,	/* \tjmp\t%0\n */
/* 477 */	1,	/* %a:\n */
};

static char *_string[] = {
/* 0 */	0,
/* 1 */	"reg8: INDIRI1(VREGP)",
/* 2 */	"reg8: INDIRU1(VREGP)",
/* 3 */	"reg: INDIRI2(VREGP)",
/* 4 */	"reg: INDIRU2(VREGP)",
/* 5 */	"reg32: INDIRI4(VREGP)",
/* 6 */	"reg32: INDIRU4(VREGP)",
/* 7 */	"reg: INDIRP2(VREGP)",
/* 8 */	"regf: INDIRF4(VREGP)",
/* 9 */	"regf: INDIRF8(VREGP)",
/* 10 */	"stmt: ASGNI1(VREGP,reg8)",
/* 11 */	"stmt: ASGNU1(VREGP,reg8)",
/* 12 */	"stmt: ASGNI2(VREGP,reg)",
/* 13 */	"stmt: ASGNU2(VREGP,reg)",
/* 14 */	"stmt: ASGNI4(VREGP,reg32)",
/* 15 */	"stmt: ASGNU4(VREGP,reg32)",
/* 16 */	"stmt: ASGNP2(VREGP,reg)",
/* 17 */	"stmt: ASGNF4(VREGP,regf)",
/* 18 */	"stmt: ASGNF8(VREGP,regf)",
/* 19 */	"stmt: reg8",
/* 20 */	"stmt: reg",
/* 21 */	"stmt: reg32",
/* 22 */	"stmt: regf",
/* 23 */	"reg8: LOADI1(reg8)",
/* 24 */	"reg8: LOADU1(reg8)",
/* 25 */	"reg8: LOADI1(reg)",
/* 26 */	"reg8: LOADU1(reg)",
/* 27 */	"reg: LOADI2(reg)",
/* 28 */	"reg: LOADU2(reg)",
/* 29 */	"reg: LOADP2(reg)",
/* 30 */	"reg32: LOADI4(reg32)",
/* 31 */	"reg32: LOADU4(reg32)",
/* 32 */	"regf: LOADF4(regf)",
/* 33 */	"regf: LOADF8(regf)",
/* 34 */	"reg8: LOADU1(LOADU2(CVII2(reg8)))",
/* 35 */	"reg8: LOADI1(LOADI2(CVUU2(reg8)))",
/* 36 */	"reg8: LOADI1(reg32)",
/* 37 */	"reg8: LOADU1(reg32)",
/* 38 */	"reg: LOADI2(reg32)",
/* 39 */	"reg: LOADU2(reg32)",
/* 40 */	"con8: CNSTI1",
/* 41 */	"con8: CNSTU1",
/* 42 */	"con16: CNSTI2",
/* 43 */	"con16: CNSTU2",
/* 44 */	"con16: CNSTP2",
/* 45 */	"con0: CNSTI1",
/* 46 */	"con0: CNSTU1",
/* 47 */	"con0: CNSTI2",
/* 48 */	"con0: CNSTU2",
/* 49 */	"con1: CNSTI1",
/* 50 */	"con1: CNSTU1",
/* 51 */	"con1: CNSTI2",
/* 52 */	"con1: CNSTU2",
/* 53 */	"con2: CNSTI1",
/* 54 */	"con2: CNSTU1",
/* 55 */	"con2: CNSTI2",
/* 56 */	"con2: CNSTU2",
/* 57 */	"con: con8",
/* 58 */	"con: con16",
/* 59 */	"reg: con",
/* 60 */	"reg: con0",
/* 61 */	"reg8: con8",
/* 62 */	"lgaddr: ADDRGP2",
/* 63 */	"lgaddr: ADDRFP2",
/* 64 */	"lgaddr: ADDRLP2",
/* 65 */	"addr: lgaddr",
/* 66 */	"addr: reg",
/* 67 */	"addr: ADDP2(reg,con)",
/* 68 */	"addr: SUBP2(reg,con)",
/* 69 */	"albl: ADDRGP2",
/* 70 */	"ar: reg",
/* 71 */	"ar: albl",
/* 72 */	"reg: lgaddr",
/* 73 */	"stmt: ASGNI1(addr,reg8)",
/* 74 */	"stmt: ASGNU1(addr,reg8)",
/* 75 */	"stmt: ASGNI2(addr,reg)",
/* 76 */	"stmt: ASGNU2(addr,reg)",
/* 77 */	"stmt: ASGNP2(addr,reg)",
/* 78 */	"stmt: ASGNB(reg,INDIRB(reg))",
/* 79 */	"stmt: ASGNI4(lgaddr,reg32)",
/* 80 */	"stmt: ASGNI4(lgaddr,INDIRI4(lgaddr))",
/* 81 */	"stmt: ASGNU4(lgaddr,reg32)",
/* 82 */	"stmt: ASGNU4(lgaddr,INDIRU4(lgaddr))",
/* 83 */	"stmt: ASGNF4(lgaddr,regf)",
/* 84 */	"stmt: ASGNF4(lgaddr,INDIRF4(lgaddr))",
/* 85 */	"stmt: ASGNF8(lgaddr,regf)",
/* 86 */	"stmt: ASGNF8(lgaddr,INDIRF8(lgaddr))",
/* 87 */	"reg8: INDIRI1(addr)",
/* 88 */	"reg8: INDIRU1(addr)",
/* 89 */	"reg: INDIRI2(addr)",
/* 90 */	"reg: INDIRU2(addr)",
/* 91 */	"reg: INDIRP2(addr)",
/* 92 */	"reg32: INDIRI4(lgaddr)",
/* 93 */	"reg32: INDIRU4(lgaddr)",
/* 94 */	"regf: INDIRF4(lgaddr)",
/* 95 */	"regf: INDIRF8(lgaddr)",
/* 96 */	"reg32: INDIRI4(reg)",
/* 97 */	"reg32: INDIRU4(reg)",
/* 98 */	"regf: INDIRF4(reg)",
/* 99 */	"regf: INDIRF8(reg)",
/* 100 */	"reg8: CVII1(reg32)",
/* 101 */	"reg8: CVIU1(reg32)",
/* 102 */	"reg8: CVUI1(reg32)",
/* 103 */	"reg8: CVUU1(reg32)",
/* 104 */	"reg: CVII2(reg8)",
/* 105 */	"reg: CVIU2(reg8)",
/* 106 */	"reg: CVUI2(reg8)",
/* 107 */	"reg: CVUU2(reg8)",
/* 108 */	"reg32: CVII4(reg8)",
/* 109 */	"reg32: CVIU4(reg8)",
/* 110 */	"reg32: CVUI4(reg8)",
/* 111 */	"reg32: CVUU4(reg8)",
/* 112 */	"reg32: CVII4(reg)",
/* 113 */	"reg32: CVIU4(reg)",
/* 114 */	"reg32: CVUI4(reg)",
/* 115 */	"reg32: CVUU4(reg)",
/* 116 */	"regf: CVIF4(reg8)",
/* 117 */	"regf: CVIF4(reg)",
/* 118 */	"regf: CVIF4(reg32)",
/* 119 */	"regf: CVIF8(reg8)",
/* 120 */	"regf: CVIF8(reg)",
/* 121 */	"regf: CVIF8(reg32)",
/* 122 */	"reg: CVFI2(regf)",
/* 123 */	"reg: CVFI4(regf)",
/* 124 */	"regf: CVFF4(regf)",
/* 125 */	"regf: CVFF8(regf)",
/* 126 */	"reg: CVPU2(reg)",
/* 127 */	"reg: CVUP2(reg)",
/* 128 */	"reg: ADDI2(reg,reg)",
/* 129 */	"reg: ADDI2(reg,INDIRI2(addr))",
/* 130 */	"reg: ADDI2(reg,con)",
/* 131 */	"reg: ADDU2(reg,reg)",
/* 132 */	"reg: ADDU2(reg,INDIRU2(addr))",
/* 133 */	"reg: ADDU2(reg,con)",
/* 134 */	"reg: ADDP2(reg,reg)",
/* 135 */	"reg: ADDP2(reg,con)",
/* 136 */	"reg8: ADDI2(reg8,CVII2(INDIRI1(addr)))",
/* 137 */	"reg8: ADDI2(CVII2(reg8),CVII2(INDIRI1(addr)))",
/* 138 */	"reg8: ADDI2(CVUI2(reg8),CVII2(INDIRI1(addr)))",
/* 139 */	"reg8: ADDI2(reg8,con)",
/* 140 */	"reg8: ADDI2(CVII2(reg8),con)",
/* 141 */	"reg8: ADDI2(CVUI2(reg8),con)",
/* 142 */	"reg8: ADDU2(reg8,CVUU2(INDIRU1(addr)))",
/* 143 */	"reg8: ADDU2(CVUU2(reg8),CVUU2(INDIRU1(addr)))",
/* 144 */	"reg8: ADDU2(CVIU2(reg8),CVUU2(INDIRU1(addr)))",
/* 145 */	"reg8: ADDU2(reg8,con)",
/* 146 */	"reg8: ADDU2(CVUU2(reg8),con)",
/* 147 */	"reg8: ADDU2(CVIU2(reg8),con)",
/* 148 */	"reg32: ADDI4(reg32,reg32)",
/* 149 */	"reg32: ADDI4(reg32,INDIRI4(lgaddr))",
/* 150 */	"reg32: ADDU4(reg32,reg32)",
/* 151 */	"reg32: ADDU4(reg32,INDIRU4(lgaddr))",
/* 152 */	"regf: ADDF4(regf,regf)",
/* 153 */	"regf: ADDF4(regf,INDIRF4(lgaddr))",
/* 154 */	"regf: ADDF8(regf,regf)",
/* 155 */	"regf: ADDF8(regf,INDIRF8(lgaddr))",
/* 156 */	"stmt: ASGNI4(lgaddr,ADDI4(INDIRI4(lgaddr),INDIRI4(lgaddr)))",
/* 157 */	"stmt: ASGNI4(lgaddr,ADDI4(INDIRI4(lgaddr),INDIRI4(lgaddr)))",
/* 158 */	"stmt: ASGNU4(lgaddr,ADDU4(INDIRU4(lgaddr),INDIRU4(lgaddr)))",
/* 159 */	"stmt: ASGNU4(lgaddr,ADDU4(INDIRU4(lgaddr),INDIRU4(lgaddr)))",
/* 160 */	"stmt: ASGNF4(lgaddr,ADDF4(INDIRF4(lgaddr),INDIRF4(lgaddr)))",
/* 161 */	"stmt: ASGNF4(lgaddr,ADDF4(INDIRF4(lgaddr),INDIRF4(lgaddr)))",
/* 162 */	"stmt: ASGNF8(lgaddr,ADDF8(INDIRF8(lgaddr),INDIRF8(lgaddr)))",
/* 163 */	"stmt: ASGNF8(lgaddr,ADDF8(INDIRF8(lgaddr),INDIRF8(lgaddr)))",
/* 164 */	"reg: SUBI2(reg,reg)",
/* 165 */	"reg: SUBI2(reg,INDIRI2(addr))",
/* 166 */	"reg: SUBI2(reg,con)",
/* 167 */	"reg: SUBU2(reg,reg)",
/* 168 */	"reg: SUBU2(reg,INDIRU2(addr))",
/* 169 */	"reg: SUBU2(reg,con)",
/* 170 */	"reg: SUBP2(reg,reg)",
/* 171 */	"reg: SUBP2(reg,con)",
/* 172 */	"reg8: SUBI2(reg8,CVII2(INDIRI1(addr)))",
/* 173 */	"reg8: SUBI2(CVII2(reg8),CVII2(INDIRI1(addr)))",
/* 174 */	"reg8: SUBI2(CVUI2(reg8),CVII2(INDIRI1(addr)))",
/* 175 */	"reg8: SUBI2(reg8,con)",
/* 176 */	"reg8: SUBI2(CVII2(reg8),con)",
/* 177 */	"reg8: SUBI2(CVUI2(reg8),con)",
/* 178 */	"reg8: SUBU2(reg8,CVUU2(INDIRU1(addr)))",
/* 179 */	"reg8: SUBU2(CVUU2(reg8),CVUU2(INDIRU1(addr)))",
/* 180 */	"reg8: SUBU2(CVIU2(reg8),CVUU2(INDIRU1(addr)))",
/* 181 */	"reg8: SUBU2(reg8,con)",
/* 182 */	"reg8: SUBU2(CVUU2(reg8),con)",
/* 183 */	"reg8: SUBU2(CVIU2(reg8),con)",
/* 184 */	"reg32: SUBI4(reg32,reg32)",
/* 185 */	"reg32: SUBI4(reg32,INDIRI4(lgaddr))",
/* 186 */	"reg32: SUBU4(reg32,reg32)",
/* 187 */	"reg32: SUBU4(reg32,INDIRU4(lgaddr))",
/* 188 */	"regf: SUBF4(regf,regf)",
/* 189 */	"regf: SUBF4(regf,INDIRF4(lgaddr))",
/* 190 */	"regf: SUBF8(regf,regf)",
/* 191 */	"regf: SUBF8(regf,INDIRF8(lgaddr))",
/* 192 */	"stmt: ASGNI4(lgaddr,SUBI4(INDIRI4(lgaddr),INDIRI4(lgaddr)))",
/* 193 */	"stmt: ASGNI4(lgaddr,SUBI4(INDIRI4(lgaddr),INDIRI4(lgaddr)))",
/* 194 */	"stmt: ASGNU4(lgaddr,SUBU4(INDIRU4(lgaddr),INDIRU4(lgaddr)))",
/* 195 */	"stmt: ASGNU4(lgaddr,SUBU4(INDIRU4(lgaddr),INDIRU4(lgaddr)))",
/* 196 */	"stmt: ASGNF4(lgaddr,SUBF4(INDIRF4(lgaddr),INDIRF4(lgaddr)))",
/* 197 */	"stmt: ASGNF4(lgaddr,SUBF4(INDIRF4(lgaddr),INDIRF4(lgaddr)))",
/* 198 */	"stmt: ASGNF8(lgaddr,SUBF8(INDIRF8(lgaddr),INDIRF8(lgaddr)))",
/* 199 */	"stmt: ASGNF8(lgaddr,SUBF8(INDIRF8(lgaddr),INDIRF8(lgaddr)))",
/* 200 */	"reg: NEGI2(reg)",
/* 201 */	"reg: NEGI2(INDIRI2(lgaddr))",
/* 202 */	"reg32: NEGI4(reg32)",
/* 203 */	"reg32: NEGI4(INDIRI4(lgaddr))",
/* 204 */	"regf: NEGF4(regf)",
/* 205 */	"regf: NEGF4(INDIRF4(lgaddr))",
/* 206 */	"regf: NEGF8(regf)",
/* 207 */	"regf: NEGF8(INDIRF8(lgaddr))",
/* 208 */	"reg: BANDI2(reg,reg)",
/* 209 */	"reg: BANDI2(reg,INDIRI2(lgaddr))",
/* 210 */	"reg: BANDI2(reg,con)",
/* 211 */	"reg: BANDU2(reg,reg)",
/* 212 */	"reg: BANDU2(reg,INDIRU2(lgaddr))",
/* 213 */	"reg: BANDU2(reg,con)",
/* 214 */	"reg8: BANDI2(reg8,CVII2(INDIRI1(lgaddr)))",
/* 215 */	"reg8: BANDI2(CVII2(reg8),CVII2(INDIRI1(lgaddr)))",
/* 216 */	"reg8: BANDI2(CVUI2(reg8),CVII2(INDIRI1(lgaddr)))",
/* 217 */	"reg8: BANDI2(reg8,con)",
/* 218 */	"reg8: BANDI2(CVII2(reg8),con)",
/* 219 */	"reg8: BANDI2(CVUI2(reg8),con)",
/* 220 */	"reg8: BANDU2(reg8,CVUU2(INDIRU1(lgaddr)))",
/* 221 */	"reg8: BANDU2(CVUU2(reg8),CVUU2(INDIRU1(lgaddr)))",
/* 222 */	"reg8: BANDU2(CVIU2(reg8),CVUU2(INDIRU1(lgaddr)))",
/* 223 */	"reg8: BANDU2(reg8,con)",
/* 224 */	"reg8: BANDU2(CVUU2(reg8),con)",
/* 225 */	"reg8: BANDU2(CVIU2(reg8),con)",
/* 226 */	"reg32: BANDI4(reg32,reg32)",
/* 227 */	"reg32: BANDI4(reg32,INDIRI4(lgaddr))",
/* 228 */	"reg32: BANDU4(reg32,reg32)",
/* 229 */	"reg32: BANDU4(reg32,INDIRU4(lgaddr))",
/* 230 */	"reg: BCOMI2(reg)",
/* 231 */	"reg: BCOMU2(reg)",
/* 232 */	"reg32: BCOMI4(reg32)",
/* 233 */	"reg32: BCOMU4(reg32)",
/* 234 */	"reg: BORI2(reg,reg)",
/* 235 */	"reg: BORI2(reg,INDIRI2(lgaddr))",
/* 236 */	"reg: BORI2(reg,con)",
/* 237 */	"reg: BORU2(reg,reg)",
/* 238 */	"reg: BORU2(reg,INDIRU2(lgaddr))",
/* 239 */	"reg: BORU2(reg,con)",
/* 240 */	"reg8: BORI2(reg8,CVII2(INDIRI1(lgaddr)))",
/* 241 */	"reg8: BORI2(CVII2(reg8),CVII2(INDIRI1(lgaddr)))",
/* 242 */	"reg8: BORI2(CVUI2(reg8),CVII2(INDIRI1(lgaddr)))",
/* 243 */	"reg8: BORI2(reg8,con)",
/* 244 */	"reg8: BORI2(CVII2(reg8),con)",
/* 245 */	"reg8: BORI2(CVUI2(reg8),con)",
/* 246 */	"reg8: BORU2(reg8,CVUU2(INDIRU1(lgaddr)))",
/* 247 */	"reg8: BORU2(CVUU2(reg8),CVUU2(INDIRU1(lgaddr)))",
/* 248 */	"reg8: BORU2(CVIU2(reg8),CVUU2(INDIRU1(lgaddr)))",
/* 249 */	"reg8: BORU2(reg8,con)",
/* 250 */	"reg8: BORU2(CVUU2(reg8),con)",
/* 251 */	"reg8: BORU2(CVIU2(reg8),con)",
/* 252 */	"reg32: BORI4(reg32,reg32)",
/* 253 */	"reg32: BORI4(reg32,INDIRI4(lgaddr))",
/* 254 */	"reg32: BORU4(reg32,reg32)",
/* 255 */	"reg32: BORU4(reg32,INDIRU4(lgaddr))",
/* 256 */	"reg: BXORI2(reg,reg)",
/* 257 */	"reg: BXORI2(reg,INDIRI2(lgaddr))",
/* 258 */	"reg: BXORI2(reg,con)",
/* 259 */	"reg: BXORU2(reg,reg)",
/* 260 */	"reg: BXORU2(reg,INDIRU2(lgaddr))",
/* 261 */	"reg: BXORU2(reg,con)",
/* 262 */	"reg8: BXORI2(reg8,CVII2(INDIRI1(lgaddr)))",
/* 263 */	"reg8: BXORI2(CVII2(reg8),CVII2(INDIRI1(lgaddr)))",
/* 264 */	"reg8: BXORI2(CVUI2(reg8),CVII2(INDIRI1(lgaddr)))",
/* 265 */	"reg8: BXORI2(reg8,con)",
/* 266 */	"reg8: BXORI2(CVII2(reg8),con)",
/* 267 */	"reg8: BXORI2(CVUI2(reg8),con)",
/* 268 */	"reg8: BXORU2(reg8,CVUU2(INDIRU1(lgaddr)))",
/* 269 */	"reg8: BXORU2(CVUU2(reg8),CVUU2(INDIRU1(lgaddr)))",
/* 270 */	"reg8: BXORU2(CVIU2(reg8),CVUU2(INDIRU1(lgaddr)))",
/* 271 */	"reg8: BXORU2(reg8,con)",
/* 272 */	"reg8: BXORU2(CVUU2(reg8),con)",
/* 273 */	"reg8: BXORU2(CVIU2(reg8),con)",
/* 274 */	"reg32: BXORI4(reg32,reg32)",
/* 275 */	"reg32: BXORI4(reg32,INDIRI4(lgaddr))",
/* 276 */	"reg32: BXORU4(reg32,reg32)",
/* 277 */	"reg32: BXORU4(reg32,INDIRU4(lgaddr))",
/* 278 */	"reg: MULI2(reg,reg)",
/* 279 */	"reg: MULU2(reg,reg)",
/* 280 */	"reg: DIVI2(reg,reg)",
/* 281 */	"reg: DIVU2(reg,reg)",
/* 282 */	"reg: MODI2(reg,reg)",
/* 283 */	"reg: MODU2(reg,reg)",
/* 284 */	"reg32: MULI4(reg32,reg32)",
/* 285 */	"reg32: MULI4(reg32,INDIRI4(lgaddr))",
/* 286 */	"reg32: MULU4(reg32,reg32)",
/* 287 */	"reg32: MULU4(reg32,INDIRU4(lgaddr))",
/* 288 */	"reg32: DIVI4(reg32,reg32)",
/* 289 */	"reg32: DIVI4(reg32,INDIRI4(lgaddr))",
/* 290 */	"reg32: DIVU4(reg32,reg32)",
/* 291 */	"reg32: DIVU4(reg32,INDIRU4(lgaddr))",
/* 292 */	"reg32: MODI4(reg32,reg32)",
/* 293 */	"reg32: MODI4(reg32,INDIRI4(lgaddr))",
/* 294 */	"reg32: MODU4(reg32,reg32)",
/* 295 */	"reg32: MODU4(reg32,INDIRU4(lgaddr))",
/* 296 */	"regf: MULF4(regf,regf)",
/* 297 */	"regf: MULF4(regf,INDIRF4(lgaddr))",
/* 298 */	"regf: MULF8(regf,regf)",
/* 299 */	"regf: MULF8(regf,INDIRF8(lgaddr))",
/* 300 */	"regf: DIVF4(regf,regf)",
/* 301 */	"regf: DIVF4(regf,INDIRF4(lgaddr))",
/* 302 */	"regf: DIVF8(regf,regf)",
/* 303 */	"regf: DIVF8(regf,INDIRF8(lgaddr))",
/* 304 */	"reg: LSHI2(reg,con1)",
/* 305 */	"reg: LSHU2(reg,con1)",
/* 306 */	"reg: RSHI2(reg,con1)",
/* 307 */	"reg: RSHU2(reg,con1)",
/* 308 */	"reg: LSHI2(reg,con2)",
/* 309 */	"reg: LSHU2(reg,con2)",
/* 310 */	"reg: RSHI2(reg,con2)",
/* 311 */	"reg: RSHU2(reg,con2)",
/* 312 */	"reg: LSHI2(reg,reg)",
/* 313 */	"reg: LSHU2(reg,reg)",
/* 314 */	"reg: RSHI2(reg,reg)",
/* 315 */	"reg: RSHU2(reg,reg)",
/* 316 */	"reg32: LSHI4(reg32,con1)",
/* 317 */	"reg32: LSHU4(reg32,con1)",
/* 318 */	"reg32: RSHI4(reg32,con1)",
/* 319 */	"reg32: RSHU4(reg32,con1)",
/* 320 */	"stmt: EQI2(reg,reg)",
/* 321 */	"stmt: EQI2(reg,INDIRI2(lgaddr))",
/* 322 */	"stmt: EQI2(reg,con)",
/* 323 */	"stmt: EQI2(CVII2(reg8),CVII2(INDIRI1(lgaddr)))",
/* 324 */	"stmt: EQI2(CVUI2(reg8),CVII2(INDIRI1(lgaddr)))",
/* 325 */	"stmt: EQI2(CVII2(reg8),con)",
/* 326 */	"stmt: EQI2(CVUI2(reg8),con)",
/* 327 */	"stmt: EQU2(reg,reg)",
/* 328 */	"stmt: EQU2(reg,INDIRU2(lgaddr))",
/* 329 */	"stmt: EQU2(reg,con)",
/* 330 */	"stmt: EQU2(CVUU2(reg8),CVUU2(INDIRU1(lgaddr)))",
/* 331 */	"stmt: EQU2(CVIU2(reg8),CVUU2(INDIRU1(lgaddr)))",
/* 332 */	"stmt: EQU2(CVUU2(reg8),con)",
/* 333 */	"stmt: EQU2(CVIU2(reg8),con)",
/* 334 */	"stmt: EQI4(reg32,reg32)",
/* 335 */	"stmt: EQI4(reg32,INDIRI4(lgaddr))",
/* 336 */	"stmt: EQU4(reg32,reg32)",
/* 337 */	"stmt: EQU4(reg32,INDIRU4(lgaddr))",
/* 338 */	"stmt: EQF4(regf,regf)",
/* 339 */	"stmt: EQF4(regf,INDIRF4(lgaddr))",
/* 340 */	"stmt: EQF8(regf,regf)",
/* 341 */	"stmt: EQF8(regf,INDIRF8(lgaddr))",
/* 342 */	"stmt: NEI2(reg,reg)",
/* 343 */	"stmt: NEI2(reg,INDIRI2(lgaddr))",
/* 344 */	"stmt: NEI2(reg,con)",
/* 345 */	"stmt: NEI2(CVII2(reg8),CVII2(INDIRI1(lgaddr)))",
/* 346 */	"stmt: NEI2(CVUI2(reg8),CVII2(INDIRI1(lgaddr)))",
/* 347 */	"stmt: NEI2(CVII2(reg8),con)",
/* 348 */	"stmt: NEI2(CVUI2(reg8),con)",
/* 349 */	"stmt: NEU2(reg,reg)",
/* 350 */	"stmt: NEU2(reg,INDIRU2(lgaddr))",
/* 351 */	"stmt: NEU2(reg,con)",
/* 352 */	"stmt: NEU2(CVUU2(reg8),CVUU2(INDIRU1(lgaddr)))",
/* 353 */	"stmt: NEU2(CVIU2(reg8),CVUU2(INDIRU1(lgaddr)))",
/* 354 */	"stmt: NEU2(CVUU2(reg8),con)",
/* 355 */	"stmt: NEU2(CVIU2(reg8),con)",
/* 356 */	"stmt: NEI4(reg32,reg32)",
/* 357 */	"stmt: NEI4(reg32,INDIRI4(lgaddr))",
/* 358 */	"stmt: NEU4(reg32,reg32)",
/* 359 */	"stmt: NEU4(reg32,INDIRU4(lgaddr))",
/* 360 */	"stmt: NEF4(regf,regf)",
/* 361 */	"stmt: NEF4(regf,INDIRF4(lgaddr))",
/* 362 */	"stmt: NEF8(regf,regf)",
/* 363 */	"stmt: NEF8(regf,INDIRF8(lgaddr))",
/* 364 */	"stmt: LEI2(reg,reg)",
/* 365 */	"stmt: LEI2(reg,INDIRI2(lgaddr))",
/* 366 */	"stmt: LEI2(reg,con)",
/* 367 */	"stmt: LEI2(CVII2(reg8),CVII2(INDIRI1(lgaddr)))",
/* 368 */	"stmt: LEI2(CVUI2(reg8),CVII2(INDIRI1(lgaddr)))",
/* 369 */	"stmt: LEI2(CVII2(reg8),con)",
/* 370 */	"stmt: LEI2(CVUI2(reg8),con)",
/* 371 */	"stmt: LEU2(reg,reg)",
/* 372 */	"stmt: LEU2(reg,INDIRU2(lgaddr))",
/* 373 */	"stmt: LEU2(reg,con)",
/* 374 */	"stmt: LEU2(CVUU2(reg8),CVUU2(INDIRU1(lgaddr)))",
/* 375 */	"stmt: LEU2(CVIU2(reg8),CVUU2(INDIRU1(lgaddr)))",
/* 376 */	"stmt: LEU2(CVUU2(reg8),con)",
/* 377 */	"stmt: LEU2(CVIU2(reg8),con)",
/* 378 */	"stmt: LEI4(reg32,reg32)",
/* 379 */	"stmt: LEI4(reg32,INDIRI4(lgaddr))",
/* 380 */	"stmt: LEU4(reg32,reg32)",
/* 381 */	"stmt: LEU4(reg32,INDIRU4(lgaddr))",
/* 382 */	"stmt: LEF4(regf,regf)",
/* 383 */	"stmt: LEF4(regf,INDIRF4(lgaddr))",
/* 384 */	"stmt: LEF8(regf,regf)",
/* 385 */	"stmt: LEF8(regf,INDIRF8(lgaddr))",
/* 386 */	"stmt: LTI2(reg,reg)",
/* 387 */	"stmt: LTI2(reg,INDIRI2(lgaddr))",
/* 388 */	"stmt: LTI2(reg,con)",
/* 389 */	"stmt: LTI2(CVII2(reg8),CVII2(INDIRI1(lgaddr)))",
/* 390 */	"stmt: LTI2(CVUI2(reg8),CVII2(INDIRI1(lgaddr)))",
/* 391 */	"stmt: LTI2(CVII2(reg8),con)",
/* 392 */	"stmt: LTI2(CVUI2(reg8),con)",
/* 393 */	"stmt: LTU2(reg,reg)",
/* 394 */	"stmt: LTU2(reg,INDIRU2(lgaddr))",
/* 395 */	"stmt: LTU2(reg,con)",
/* 396 */	"stmt: LTU2(CVUU2(reg8),CVUU2(INDIRU1(lgaddr)))",
/* 397 */	"stmt: LTU2(CVIU2(reg8),CVUU2(INDIRU1(lgaddr)))",
/* 398 */	"stmt: LTU2(CVUU2(reg8),con)",
/* 399 */	"stmt: LTU2(CVIU2(reg8),con)",
/* 400 */	"stmt: LTI4(reg32,reg32)",
/* 401 */	"stmt: LTI4(reg32,INDIRI4(lgaddr))",
/* 402 */	"stmt: LTU4(reg32,reg32)",
/* 403 */	"stmt: LTU4(reg32,INDIRU4(lgaddr))",
/* 404 */	"stmt: LTF4(regf,regf)",
/* 405 */	"stmt: LTF4(regf,INDIRF4(lgaddr))",
/* 406 */	"stmt: LTF8(regf,regf)",
/* 407 */	"stmt: LTF8(regf,INDIRF8(lgaddr))",
/* 408 */	"stmt: GEI2(reg,reg)",
/* 409 */	"stmt: GEI2(reg,INDIRI2(lgaddr))",
/* 410 */	"stmt: GEI2(reg,con)",
/* 411 */	"stmt: GEI2(CVII2(reg8),CVII2(INDIRI1(lgaddr)))",
/* 412 */	"stmt: GEI2(CVUI2(reg8),CVII2(INDIRI1(lgaddr)))",
/* 413 */	"stmt: GEI2(CVII2(reg8),con)",
/* 414 */	"stmt: GEI2(CVUI2(reg8),con)",
/* 415 */	"stmt: GEU2(reg,reg)",
/* 416 */	"stmt: GEU2(reg,INDIRU2(lgaddr))",
/* 417 */	"stmt: GEU2(reg,con)",
/* 418 */	"stmt: GEU2(CVUU2(reg8),CVUU2(INDIRU1(lgaddr)))",
/* 419 */	"stmt: GEU2(CVIU2(reg8),CVUU2(INDIRU1(lgaddr)))",
/* 420 */	"stmt: GEU2(CVUU2(reg8),con)",
/* 421 */	"stmt: GEU2(CVIU2(reg8),con)",
/* 422 */	"stmt: GEI4(reg32,reg32)",
/* 423 */	"stmt: GEI4(reg32,INDIRI4(lgaddr))",
/* 424 */	"stmt: GEU4(reg32,reg32)",
/* 425 */	"stmt: GEU4(reg32,INDIRU4(lgaddr))",
/* 426 */	"stmt: GEF4(regf,regf)",
/* 427 */	"stmt: GEF4(regf,INDIRF4(lgaddr))",
/* 428 */	"stmt: GEF8(regf,regf)",
/* 429 */	"stmt: GEF8(regf,INDIRF8(lgaddr))",
/* 430 */	"stmt: GTI2(reg,reg)",
/* 431 */	"stmt: GTI2(reg,INDIRI2(lgaddr))",
/* 432 */	"stmt: GTI2(reg,con)",
/* 433 */	"stmt: GTI2(CVII2(reg8),CVII2(INDIRI1(lgaddr)))",
/* 434 */	"stmt: GTI2(CVUI2(reg8),CVII2(INDIRI1(lgaddr)))",
/* 435 */	"stmt: GTI2(CVII2(reg8),con)",
/* 436 */	"stmt: GTI2(CVUI2(reg8),con)",
/* 437 */	"stmt: GTU2(reg,reg)",
/* 438 */	"stmt: GTU2(reg,INDIRU2(lgaddr))",
/* 439 */	"stmt: GTU2(reg,con)",
/* 440 */	"stmt: GTU2(CVUU2(reg8),CVUU2(INDIRU1(lgaddr)))",
/* 441 */	"stmt: GTU2(CVIU2(reg8),CVUU2(INDIRU1(lgaddr)))",
/* 442 */	"stmt: GTU2(CVUU2(reg8),con)",
/* 443 */	"stmt: GTU2(CVIU2(reg8),con)",
/* 444 */	"stmt: GTI4(reg32,reg32)",
/* 445 */	"stmt: GTI4(reg32,INDIRI4(lgaddr))",
/* 446 */	"stmt: GTU4(reg32,reg32)",
/* 447 */	"stmt: GTU4(reg32,INDIRU4(lgaddr))",
/* 448 */	"stmt: GTF4(regf,regf)",
/* 449 */	"stmt: GTF4(regf,INDIRF4(lgaddr))",
/* 450 */	"stmt: GTF8(regf,regf)",
/* 451 */	"stmt: GTF8(regf,INDIRF8(lgaddr))",
/* 452 */	"stmt: ARGI2(reg)",
/* 453 */	"stmt: ARGU2(reg)",
/* 454 */	"stmt: ARGP2(reg)",
/* 455 */	"stmt: ARGI4(reg32)",
/* 456 */	"stmt: ARGU4(reg32)",
/* 457 */	"stmt: ARGF4(regf)",
/* 458 */	"stmt: ARGF8(regf)",
/* 459 */	"reg: CALLI2(ar)",
/* 460 */	"reg: CALLU2(ar)",
/* 461 */	"reg: CALLP2(ar)",
/* 462 */	"stmt: CALLV(ar)",
/* 463 */	"reg32: CALLI4(ar)",
/* 464 */	"reg32: CALLU4(ar)",
/* 465 */	"regf: CALLF4(ar)",
/* 466 */	"regf: CALLF8(ar)",
/* 467 */	"stmt: RETI2(reg)",
/* 468 */	"stmt: RETU2(reg)",
/* 469 */	"stmt: RETP2(reg)",
/* 470 */	"stmt: RETV",
/* 471 */	"stmt: RETI4(reg32)",
/* 472 */	"stmt: RETU4(reg32)",
/* 473 */	"stmt: RETF4(regf)",
/* 474 */	"stmt: RETF8(regf)",
/* 475 */	"stmt: JUMPV(albl)",
/* 476 */	"stmt: JUMPV(reg)",
/* 477 */	"stmt: LABELV",
};

static short _decode_stmt[] = {
	0,
	10,
	11,
	12,
	13,
	14,
	15,
	16,
	17,
	18,
	19,
	20,
	21,
	22,
	73,
	74,
	75,
	76,
	77,
	78,
	79,
	80,
	81,
	82,
	83,
	84,
	85,
	86,
	156,
	157,
	158,
	159,
	160,
	161,
	162,
	163,
	192,
	193,
	194,
	195,
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
};

static short _decode_reg8[] = {
	0,
	1,
	2,
	23,
	24,
	25,
	26,
	34,
	35,
	36,
	37,
	61,
	87,
	88,
	100,
	101,
	102,
	103,
	136,
	137,
	138,
	139,
	140,
	141,
	142,
	143,
	144,
	145,
	146,
	147,
	172,
	173,
	174,
	175,
	176,
	177,
	178,
	179,
	180,
	181,
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
};

static short _decode_reg[] = {
	0,
	3,
	4,
	7,
	27,
	28,
	29,
	38,
	39,
	59,
	60,
	72,
	89,
	90,
	91,
	104,
	105,
	106,
	107,
	122,
	123,
	126,
	127,
	128,
	129,
	130,
	131,
	132,
	133,
	134,
	135,
	164,
	165,
	166,
	167,
	168,
	169,
	170,
	171,
	200,
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
};

static short _decode_reg32[] = {
	0,
	5,
	6,
	30,
	31,
	92,
	93,
	96,
	97,
	108,
	109,
	110,
	111,
	112,
	113,
	114,
	115,
	148,
	149,
	150,
	151,
	184,
	185,
	186,
	187,
	202,
	203,
	226,
	227,
	228,
	229,
	232,
	233,
	252,
	253,
	254,
	255,
	274,
	275,
	276,
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
};

static short _decode_regf[] = {
	0,
	8,
	9,
	32,
	33,
	94,
	95,
	98,
	99,
	116,
	117,
	118,
	119,
	120,
	121,
	124,
	125,
	152,
	153,
	154,
	155,
	188,
	189,
	190,
	191,
	204,
	205,
	206,
	207,
	296,
	297,
	298,
	299,
	300,
	301,
	302,
	303,
	465,
	466,
};

static short _decode_con8[] = {
	0,
	40,
	41,
};

static short _decode_con16[] = {
	0,
	42,
	43,
	44,
};

static short _decode_con0[] = {
	0,
	45,
	46,
	47,
	48,
};

static short _decode_con1[] = {
	0,
	49,
	50,
	51,
	52,
};

static short _decode_con2[] = {
	0,
	53,
	54,
	55,
	56,
};

static short _decode_con[] = {
	0,
	57,
	58,
};

static short _decode_lgaddr[] = {
	0,
	62,
	63,
	64,
};

static short _decode_addr[] = {
	0,
	65,
	66,
	67,
	68,
};

static short _decode_albl[] = {
	0,
	69,
};

static short _decode_ar[] = {
	0,
	70,
	71,
};

static int _rule(void *state, int goalnt) {
	if (goalnt < 1 || goalnt > 15)
		fatal("_rule", "Bad goal nonterminal %d\n", goalnt);
	if (!state)
		return 0;
	switch (goalnt) {
	case _stmt_NT:	return _decode_stmt[((struct _state *)state)->rule._stmt];
	case _reg8_NT:	return _decode_reg8[((struct _state *)state)->rule._reg8];
	case _reg_NT:	return _decode_reg[((struct _state *)state)->rule._reg];
	case _reg32_NT:	return _decode_reg32[((struct _state *)state)->rule._reg32];
	case _regf_NT:	return _decode_regf[((struct _state *)state)->rule._regf];
	case _con8_NT:	return _decode_con8[((struct _state *)state)->rule._con8];
	case _con16_NT:	return _decode_con16[((struct _state *)state)->rule._con16];
	case _con0_NT:	return _decode_con0[((struct _state *)state)->rule._con0];
	case _con1_NT:	return _decode_con1[((struct _state *)state)->rule._con1];
	case _con2_NT:	return _decode_con2[((struct _state *)state)->rule._con2];
	case _con_NT:	return _decode_con[((struct _state *)state)->rule._con];
	case _lgaddr_NT:	return _decode_lgaddr[((struct _state *)state)->rule._lgaddr];
	case _addr_NT:	return _decode_addr[((struct _state *)state)->rule._addr];
	case _albl_NT:	return _decode_albl[((struct _state *)state)->rule._albl];
	case _ar_NT:	return _decode_ar[((struct _state *)state)->rule._ar];
	default:
		fatal("_rule", "Bad goal nonterminal %d\n", goalnt);
		return 0;
	}
}

static void _closure_reg8(NODEPTR_TYPE, int);
static void _closure_reg(NODEPTR_TYPE, int);
static void _closure_reg32(NODEPTR_TYPE, int);
static void _closure_regf(NODEPTR_TYPE, int);
static void _closure_con8(NODEPTR_TYPE, int);
static void _closure_con16(NODEPTR_TYPE, int);
static void _closure_con0(NODEPTR_TYPE, int);
static void _closure_con(NODEPTR_TYPE, int);
static void _closure_lgaddr(NODEPTR_TYPE, int);
static void _closure_albl(NODEPTR_TYPE, int);

static void _closure_reg8(NODEPTR_TYPE a, int c) {
	struct _state *p = STATE_LABEL(a);
	if (c + 0 < p->cost[_stmt_NT]) {
		p->cost[_stmt_NT] = c + 0;
		p->rule._stmt = 10;
	}
}

static void _closure_reg(NODEPTR_TYPE a, int c) {
	struct _state *p = STATE_LABEL(a);
	if (c + 0 < p->cost[_ar_NT]) {
		p->cost[_ar_NT] = c + 0;
		p->rule._ar = 1;
	}
	if (c + 0 < p->cost[_addr_NT]) {
		p->cost[_addr_NT] = c + 0;
		p->rule._addr = 2;
	}
	if (c + 0 < p->cost[_stmt_NT]) {
		p->cost[_stmt_NT] = c + 0;
		p->rule._stmt = 11;
	}
}

static void _closure_reg32(NODEPTR_TYPE a, int c) {
	struct _state *p = STATE_LABEL(a);
	if (c + 0 < p->cost[_stmt_NT]) {
		p->cost[_stmt_NT] = c + 0;
		p->rule._stmt = 12;
	}
}

static void _closure_regf(NODEPTR_TYPE a, int c) {
	struct _state *p = STATE_LABEL(a);
	if (c + 0 < p->cost[_stmt_NT]) {
		p->cost[_stmt_NT] = c + 0;
		p->rule._stmt = 13;
	}
}

static void _closure_con8(NODEPTR_TYPE a, int c) {
	struct _state *p = STATE_LABEL(a);
	if (c + 1 < p->cost[_reg8_NT]) {
		p->cost[_reg8_NT] = c + 1;
		p->rule._reg8 = 11;
		_closure_reg8(a, c + 1);
	}
	if (c + 0 < p->cost[_con_NT]) {
		p->cost[_con_NT] = c + 0;
		p->rule._con = 1;
		_closure_con(a, c + 0);
	}
}

static void _closure_con16(NODEPTR_TYPE a, int c) {
	struct _state *p = STATE_LABEL(a);
	if (c + 0 < p->cost[_con_NT]) {
		p->cost[_con_NT] = c + 0;
		p->rule._con = 2;
		_closure_con(a, c + 0);
	}
}

static void _closure_con0(NODEPTR_TYPE a, int c) {
	struct _state *p = STATE_LABEL(a);
	if (c + 1 < p->cost[_reg_NT]) {
		p->cost[_reg_NT] = c + 1;
		p->rule._reg = 10;
		_closure_reg(a, c + 1);
	}
}

static void _closure_con(NODEPTR_TYPE a, int c) {
	struct _state *p = STATE_LABEL(a);
	if (c + 2 < p->cost[_reg_NT]) {
		p->cost[_reg_NT] = c + 2;
		p->rule._reg = 9;
		_closure_reg(a, c + 2);
	}
}

static void _closure_lgaddr(NODEPTR_TYPE a, int c) {
	struct _state *p = STATE_LABEL(a);
	if (c + 2 < p->cost[_reg_NT]) {
		p->cost[_reg_NT] = c + 2;
		p->rule._reg = 11;
		_closure_reg(a, c + 2);
	}
	if (c + 0 < p->cost[_addr_NT]) {
		p->cost[_addr_NT] = c + 0;
		p->rule._addr = 1;
	}
}

static void _closure_albl(NODEPTR_TYPE a, int c) {
	struct _state *p = STATE_LABEL(a);
	if (c + 0 < p->cost[_ar_NT]) {
		p->cost[_ar_NT] = c + 0;
		p->rule._ar = 2;
	}
}
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
