dpilawa/bytec/lcc/bin/x86linux.c

/* x86/linux lburg spec. Derived from x86.md by
Marcos Ramirez <marcos@inf.utfsm.cl>
Horst von Brand <vonbrand@sleipnir.valparaiso.cl>
Jacob Navia <jacob@jacob.remcomp.fr>
*/
enum { EAX=0, ECX=1, EDX=2, EBX=3, ESI=6, EDI=7 };
#include "c.h"
#define NODEPTR_TYPE Node
#define OP_LABEL(p) ((p)->op)
#define LEFT_CHILD(p) ((p)->kids[0])
#define RIGHT_CHILD(p) ((p)->kids[1])
#define STATE_LABEL(p) ((p)->x.state)
extern int ckstack(Node, int);
extern int memop(Node);
extern int sametree(Node, Node);
static Symbol charreg[32], shortreg[32], intreg[32];
static Symbol fltreg[32];

static Symbol charregw, shortregw, intregw, fltregw;

static int cseg;

static Symbol quo, rem;

extern char *stabprefix;
extern void stabblock(int, int, Symbol*);
extern void stabend(Coordinate *, Symbol, Coordinate **, Symbol *, Symbol *);
extern void stabfend(Symbol, int);
extern void stabinit(char *, int, char *[]);
extern void stabline(Coordinate *);
extern void stabsym(Symbol);
extern void stabtype(Symbol);

static int pflag = 0;
static char rcsid[] = "$Id: x86linux.md,v 1.1 2002/08/28 23:12:48 drh Exp $";

#define hasargs(p) (p->syms[0] && p->syms[0]->u.c.v.i > 0 ? 0 : LBURG_MAX)
/*
generated at Thu Dec 10 23:20:02 2015
by $Id: lburg.c,v 2.10 2002/03/08 18:45:21 drh Exp $
*/
static void _kids(NODEPTR_TYPE, int, NODEPTR_TYPE[]);
static void _label(NODEPTR_TYPE);
static int _rule(void*, int);

#define _stmt_NT 1
#define _reg_NT 2
#define _freg_NT 3
#define _cnst_NT 4
#define _con_NT 5
#define _acon_NT 6
#define _baseaddr_NT 7
#define _base_NT 8
#define _index_NT 9
#define _con1_NT 10
#define _con2_NT 11
#define _con3_NT 12
#define _con0_NT 13
#define _addr_NT 14
#define _mem1_NT 15
#define _mem2_NT 16
#define _mem4_NT 17
#define _rc_NT 18
#define _mr_NT 19
#define _mr1_NT 20
#define _mr2_NT 21
#define _mrc_NT 22
#define _rc5_NT 23
#define _mrca_NT 24
#define _memf_NT 25
#define _flt_NT 26
#define _flt2_NT 27
#define _addrj_NT 28
#define _cmpf_NT 29

static char *_ntname[] = {
	0,
	"stmt",
	"reg",
	"freg",
	"cnst",
	"con",
	"acon",
	"baseaddr",
	"base",
	"index",
	"con1",
	"con2",
	"con3",
	"con0",
	"addr",
	"mem1",
	"mem2",
	"mem4",
	"rc",
	"mr",
	"mr1",
	"mr2",
	"mrc",
	"rc5",
	"mrca",
	"memf",
	"flt",
	"flt2",
	"addrj",
	"cmpf",
	0
};

struct _state {
	short cost[30];
	struct {
		unsigned int _stmt:7;
		unsigned int _reg:7;
		unsigned int _freg:6;
		unsigned int _cnst:4;
		unsigned int _con:1;
		unsigned int _acon:2;
		unsigned int _baseaddr:1;
		unsigned int _base:3;
		unsigned int _index:3;
		unsigned int _con1:2;
		unsigned int _con2:2;
		unsigned int _con3:2;
		unsigned int _con0:2;
		unsigned int _addr:4;
		unsigned int _mem1:2;
		unsigned int _mem2:2;
		unsigned int _mem4:2;
		unsigned int _rc:2;
		unsigned int _mr:2;
		unsigned int _mr1:2;
		unsigned int _mr2:2;
		unsigned int _mrc:3;
		unsigned int _rc5:2;
		unsigned int _mrca:3;
		unsigned int _memf:3;
		unsigned int _flt:2;
		unsigned int _flt2:2;
		unsigned int _addrj:2;
		unsigned int _cmpf:3;
	} rule;
};

static short _nts_0[] = { 0 };
static short _nts_1[] = { _reg_NT, 0 };
static short _nts_2[] = { _cnst_NT, 0 };
static short _nts_3[] = { _freg_NT, 0 };
static short _nts_4[] = { _reg_NT, _acon_NT, 0 };
static short _nts_5[] = { _reg_NT, _con1_NT, 0 };
static short _nts_6[] = { _reg_NT, _con2_NT, 0 };
static short _nts_7[] = { _reg_NT, _con3_NT, 0 };
static short _nts_8[] = { _base_NT, 0 };
static short _nts_9[] = { _baseaddr_NT, 0 };
static short _nts_10[] = { _index_NT, _baseaddr_NT, 0 };
static short _nts_11[] = { _reg_NT, _baseaddr_NT, 0 };
static short _nts_12[] = { _index_NT, _reg_NT, 0 };
static short _nts_13[] = { _index_NT, 0 };
static short _nts_14[] = { _addr_NT, 0 };
static short _nts_15[] = { _con_NT, 0 };
static short _nts_16[] = { _mem4_NT, 0 };
static short _nts_17[] = { _mem1_NT, 0 };
static short _nts_18[] = { _mem2_NT, 0 };
static short _nts_19[] = { _rc_NT, 0 };
static short _nts_20[] = { _mr_NT, 0 };
static short _nts_21[] = { _mr1_NT, 0 };
static short _nts_22[] = { _mr2_NT, 0 };
static short _nts_23[] = { _reg_NT, _mrc_NT, 0 };
static short _nts_24[] = { _addr_NT, _mem4_NT, _con1_NT, 0 };
static short _nts_25[] = { _addr_NT, _mem4_NT, _rc_NT, 0 };
static short _nts_26[] = { _addr_NT, _mem4_NT, 0 };
static short _nts_27[] = { _reg_NT, _rc5_NT, 0 };
static short _nts_28[] = { _addr_NT, _mem4_NT, _rc5_NT, 0 };
static short _nts_29[] = { _con_NT, _mr_NT, 0 };
static short _nts_30[] = { _reg_NT, _mr_NT, 0 };
static short _nts_31[] = { _reg_NT, _reg_NT, 0 };
static short _nts_32[] = { _addr_NT, _rc_NT, 0 };
static short _nts_33[] = { _mrca_NT, 0 };
static short _nts_34[] = { _memf_NT, 0 };
static short _nts_35[] = { _addr_NT, _freg_NT, 0 };
static short _nts_36[] = { _freg_NT, _flt_NT, 0 };
static short _nts_37[] = { _freg_NT, _flt2_NT, 0 };
static short _nts_38[] = { _addrj_NT, 0 };
static short _nts_39[] = { _mem4_NT, _rc_NT, 0 };
static short _nts_40[] = { _mr_NT, _con_NT, _con0_NT, 0 };
static short _nts_41[] = { _addr_NT, _con_NT, _con0_NT, 0 };
static short _nts_42[] = { _cmpf_NT, _freg_NT, 0 };
static short _nts_43[] = { _freg_NT, _addr_NT, 0 };

static short *_nts[] = {
	0,	/* 0 */
	_nts_0,	/* 1 */
	_nts_0,	/* 2 */
	_nts_0,	/* 3 */
	_nts_0,	/* 4 */
	_nts_0,	/* 5 */
	_nts_0,	/* 6 */
	_nts_0,	/* 7 */
	_nts_0,	/* 8 */
	_nts_0,	/* 9 */
	_nts_0,	/* 10 */
	_nts_0,	/* 11 */
	_nts_0,	/* 12 */
	_nts_1,	/* 13 */
	_nts_1,	/* 14 */
	_nts_1,	/* 15 */
	_nts_1,	/* 16 */
	_nts_1,	/* 17 */
	_nts_1,	/* 18 */
	_nts_1,	/* 19 */
	_nts_1,	/* 20 */
	_nts_1,	/* 21 */
	_nts_1,	/* 22 */
	_nts_1,	/* 23 */
	_nts_1,	/* 24 */
	_nts_0,	/* 25 */
	_nts_0,	/* 26 */
	_nts_0,	/* 27 */
	_nts_0,	/* 28 */
	_nts_0,	/* 29 */
	_nts_0,	/* 30 */
	_nts_0,	/* 31 */
	_nts_0,	/* 32 */
	_nts_0,	/* 33 */
	_nts_0,	/* 34 */
	_nts_2,	/* 35 */
	_nts_1,	/* 36 */
	_nts_3,	/* 37 */
	_nts_0,	/* 38 */
	_nts_0,	/* 39 */
	_nts_2,	/* 40 */
	_nts_0,	/* 41 */
	_nts_1,	/* 42 */
	_nts_4,	/* 43 */
	_nts_4,	/* 44 */
	_nts_4,	/* 45 */
	_nts_0,	/* 46 */
	_nts_0,	/* 47 */
	_nts_1,	/* 48 */
	_nts_5,	/* 49 */
	_nts_6,	/* 50 */
	_nts_7,	/* 51 */
	_nts_5,	/* 52 */
	_nts_6,	/* 53 */
	_nts_7,	/* 54 */
	_nts_0,	/* 55 */
	_nts_0,	/* 56 */
	_nts_0,	/* 57 */
	_nts_0,	/* 58 */
	_nts_0,	/* 59 */
	_nts_0,	/* 60 */
	_nts_0,	/* 61 */
	_nts_0,	/* 62 */
	_nts_8,	/* 63 */
	_nts_9,	/* 64 */
	_nts_10,	/* 65 */
	_nts_10,	/* 66 */
	_nts_10,	/* 67 */
	_nts_11,	/* 68 */
	_nts_11,	/* 69 */
	_nts_11,	/* 70 */
	_nts_12,	/* 71 */
	_nts_12,	/* 72 */
	_nts_12,	/* 73 */
	_nts_13,	/* 74 */
	_nts_14,	/* 75 */
	_nts_14,	/* 76 */
	_nts_14,	/* 77 */
	_nts_14,	/* 78 */
	_nts_14,	/* 79 */
	_nts_14,	/* 80 */
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
	_nts_38,	/* 291 */
	_nts_38,	/* 292 */
	_nts_38,	/* 293 */
	_nts_38,	/* 294 */
	_nts_38,	/* 295 */
	_nts_38,	/* 296 */
	_nts_38,	/* 297 */
	_nts_38,	/* 298 */
	_nts_38,	/* 299 */
	_nts_38,	/* 300 */
	_nts_1,	/* 301 */
	_nts_1,	/* 302 */
	_nts_1,	/* 303 */
	_nts_3,	/* 304 */
	_nts_3,	/* 305 */
};

static char *_templates[] = {
/* 0 */	0,
/* 1 */	"# read register\n",	/* reg: INDIRI1(VREGP) */
/* 2 */	"# read register\n",	/* reg: INDIRU1(VREGP) */
/* 3 */	"# read register\n",	/* reg: INDIRI2(VREGP) */
/* 4 */	"# read register\n",	/* reg: INDIRU2(VREGP) */
/* 5 */	"# read register\n",	/* reg: INDIRI4(VREGP) */
/* 6 */	"# read register\n",	/* reg: INDIRP4(VREGP) */
/* 7 */	"# read register\n",	/* reg: INDIRU4(VREGP) */
/* 8 */	"# read register\n",	/* reg: INDIRI8(VREGP) */
/* 9 */	"# read register\n",	/* reg: INDIRP8(VREGP) */
/* 10 */	"# read register\n",	/* reg: INDIRU8(VREGP) */
/* 11 */	"# read register\n",	/* freg: INDIRF4(VREGP) */
/* 12 */	"# read register\n",	/* freg: INDIRF8(VREGP) */
/* 13 */	"# write register\n",	/* stmt: ASGNI1(VREGP,reg) */
/* 14 */	"# write register\n",	/* stmt: ASGNU1(VREGP,reg) */
/* 15 */	"# write register\n",	/* stmt: ASGNI2(VREGP,reg) */
/* 16 */	"# write register\n",	/* stmt: ASGNU2(VREGP,reg) */
/* 17 */	"# write register\n",	/* stmt: ASGNF4(VREGP,reg) */
/* 18 */	"# write register\n",	/* stmt: ASGNI4(VREGP,reg) */
/* 19 */	"# write register\n",	/* stmt: ASGNP4(VREGP,reg) */
/* 20 */	"# write register\n",	/* stmt: ASGNU4(VREGP,reg) */
/* 21 */	"# write register\n",	/* stmt: ASGNF8(VREGP,reg) */
/* 22 */	"# write register\n",	/* stmt: ASGNI8(VREGP,reg) */
/* 23 */	"# write register\n",	/* stmt: ASGNP8(VREGP,reg) */
/* 24 */	"# write register\n",	/* stmt: ASGNU8(VREGP,reg) */
/* 25 */	"%a",	/* cnst: CNSTI1 */
/* 26 */	"%a",	/* cnst: CNSTU1 */
/* 27 */	"%a",	/* cnst: CNSTI2 */
/* 28 */	"%a",	/* cnst: CNSTU2 */
/* 29 */	"%a",	/* cnst: CNSTI4 */
/* 30 */	"%a",	/* cnst: CNSTU4 */
/* 31 */	"%a",	/* cnst: CNSTP4 */
/* 32 */	"%a",	/* cnst: CNSTI8 */
/* 33 */	"%a",	/* cnst: CNSTU8 */
/* 34 */	"%a",	/* cnst: CNSTP8 */
/* 35 */	"$%0",	/* con: cnst */
/* 36 */	"",	/* stmt: reg */
/* 37 */	"",	/* stmt: freg */
/* 38 */	"%a",	/* acon: ADDRGP4 */
/* 39 */	"%a",	/* acon: ADDRGP8 */
/* 40 */	"%0",	/* acon: cnst */
/* 41 */	"%a",	/* baseaddr: ADDRGP4 */
/* 42 */	"(%0)",	/* base: reg */
/* 43 */	"%1(%0)",	/* base: ADDI4(reg,acon) */
/* 44 */	"%1(%0)",	/* base: ADDP4(reg,acon) */
/* 45 */	"%1(%0)",	/* base: ADDU4(reg,acon) */
/* 46 */	"%a(%%ebp)",	/* base: ADDRFP4 */
/* 47 */	"%a(%%ebp)",	/* base: ADDRLP4 */
/* 48 */	"%0",	/* index: reg */
/* 49 */	"%0,2",	/* index: LSHI4(reg,con1) */
/* 50 */	"%0,4",	/* index: LSHI4(reg,con2) */
/* 51 */	"%0,8",	/* index: LSHI4(reg,con3) */
/* 52 */	"%0,2",	/* index: LSHU4(reg,con1) */
/* 53 */	"%0,4",	/* index: LSHU4(reg,con2) */
/* 54 */	"%0,8",	/* index: LSHU4(reg,con3) */
/* 55 */	"1",	/* con0: CNSTI4 */
/* 56 */	"1",	/* con0: CNSTU4 */
/* 57 */	"1",	/* con1: CNSTI4 */
/* 58 */	"1",	/* con1: CNSTU4 */
/* 59 */	"2",	/* con2: CNSTI4 */
/* 60 */	"2",	/* con2: CNSTU4 */
/* 61 */	"3",	/* con3: CNSTI4 */
/* 62 */	"3",	/* con3: CNSTU4 */
/* 63 */	"%0",	/* addr: base */
/* 64 */	"%0",	/* addr: baseaddr */
/* 65 */	"%1(,%0)",	/* addr: ADDI4(index,baseaddr) */
/* 66 */	"%1(,%0)",	/* addr: ADDP4(index,baseaddr) */
/* 67 */	"%1(,%0)",	/* addr: ADDU4(index,baseaddr) */
/* 68 */	"%1(%0)",	/* addr: ADDI4(reg,baseaddr) */
/* 69 */	"%1(%0)",	/* addr: ADDP4(reg,baseaddr) */
/* 70 */	"%1(%0)",	/* addr: ADDU4(reg,baseaddr) */
/* 71 */	"(%1,%0)",	/* addr: ADDI4(index,reg) */
/* 72 */	"(%1,%0)",	/* addr: ADDP4(index,reg) */
/* 73 */	"(%1,%0)",	/* addr: ADDU4(index,reg) */
/* 74 */	"(,%0)",	/* addr: index */
/* 75 */	"%0",	/* mem1: INDIRI1(addr) */
/* 76 */	"%0",	/* mem1: INDIRU1(addr) */
/* 77 */	"%0",	/* mem2: INDIRI2(addr) */
/* 78 */	"%0",	/* mem2: INDIRU2(addr) */
/* 79 */	"%0",	/* mem4: INDIRI4(addr) */
/* 80 */	"%0",	/* mem4: INDIRU4(addr) */
/* 81 */	"%0",	/* mem4: INDIRP4(addr) */
/* 82 */	"%0",	/* rc: reg */
/* 83 */	"%0",	/* rc: con */
/* 84 */	"%0",	/* mr: reg */
/* 85 */	"%0",	/* mr: mem4 */
/* 86 */	"%0",	/* mr1: reg */
/* 87 */	"%0",	/* mr1: mem1 */
/* 88 */	"%0",	/* mr2: reg */
/* 89 */	"%0",	/* mr2: mem2 */
/* 90 */	"%0",	/* mrc: mem4 */
/* 91 */	"%0",	/* mrc: mem1 */
/* 92 */	"%0",	/* mrc: mem2 */
/* 93 */	"%0",	/* mrc: rc */
/* 94 */	"leal %0,%c\n",	/* reg: addr */
/* 95 */	"movl %0,%c\n",	/* reg: mr */
/* 96 */	"movb %0,%c\n",	/* reg: mr1 */
/* 97 */	"movw %0,%c\n",	/* reg: mr2 */
/* 98 */	"mov %0,%c\n",	/* reg: con */
/* 99 */	"# move\n",	/* reg: LOADI1(reg) */
/* 100 */	"# move\n",	/* reg: LOADI2(reg) */
/* 101 */	"# move\n",	/* reg: LOADI4(reg) */
/* 102 */	"# move\n",	/* reg: LOADU1(reg) */
/* 103 */	"# move\n",	/* reg: LOADU2(reg) */
/* 104 */	"# move\n",	/* reg: LOADU4(reg) */
/* 105 */	"# move\n",	/* reg: LOADP4(reg) */
/* 106 */	"?movl %0,%c\naddl %1,%c\n",	/* reg: ADDI4(reg,mrc) */
/* 107 */	"?movl %0,%c\naddl %1,%c\n",	/* reg: ADDP4(reg,mrc) */
/* 108 */	"?movl %0,%c\naddl %1,%c\n",	/* reg: ADDU4(reg,mrc) */
/* 109 */	"?movl %0,%c\nsubl %1,%c\n",	/* reg: SUBI4(reg,mrc) */
/* 110 */	"?movl %0,%c\nsubl %1,%c\n",	/* reg: SUBP4(reg,mrc) */
/* 111 */	"?movl %0,%c\nsubl %1,%c\n",	/* reg: SUBU4(reg,mrc) */
/* 112 */	"?movl %0,%c\nandl %1,%c\n",	/* reg: BANDI4(reg,mrc) */
/* 113 */	"?movl %0,%c\norl %1,%c\n",	/* reg: BORI4(reg,mrc) */
/* 114 */	"?movl %0,%c\nxorl %1,%c\n",	/* reg: BXORI4(reg,mrc) */
/* 115 */	"?movl %0,%c\nandl %1,%c\n",	/* reg: BANDU4(reg,mrc) */
/* 116 */	"?movl %0,%c\norl %1,%c\n",	/* reg: BORU4(reg,mrc) */
/* 117 */	"?movl %0,%c\nxorl %1,%c\n",	/* reg: BXORU4(reg,mrc) */
/* 118 */	"incl %1\n",	/* stmt: ASGNI4(addr,ADDI4(mem4,con1)) */
/* 119 */	"incl %1\n",	/* stmt: ASGNI4(addr,ADDU4(mem4,con1)) */
/* 120 */	"incl %1\n",	/* stmt: ASGNP4(addr,ADDP4(mem4,con1)) */
/* 121 */	"decl %1\n",	/* stmt: ASGNI4(addr,SUBI4(mem4,con1)) */
/* 122 */	"decl %1\n",	/* stmt: ASGNI4(addr,SUBU4(mem4,con1)) */
/* 123 */	"decl %1\n",	/* stmt: ASGNP4(addr,SUBP4(mem4,con1)) */
/* 124 */	"addl %2,%1\n",	/* stmt: ASGNI4(addr,ADDI4(mem4,rc)) */
/* 125 */	"subl %2,%1\n",	/* stmt: ASGNI4(addr,SUBI4(mem4,rc)) */
/* 126 */	"addl %2,%1\n",	/* stmt: ASGNU4(addr,ADDU4(mem4,rc)) */
/* 127 */	"subl %2,%1\n",	/* stmt: ASGNU4(addr,SUBU4(mem4,rc)) */
/* 128 */	"andl %2,%1\n",	/* stmt: ASGNI4(addr,BANDI4(mem4,rc)) */
/* 129 */	"orl %2,%1\n",	/* stmt: ASGNI4(addr,BORI4(mem4,rc)) */
/* 130 */	"xorl %2,%1\n",	/* stmt: ASGNI4(addr,BXORI4(mem4,rc)) */
/* 131 */	"andl %2,%1\n",	/* stmt: ASGNU4(addr,BANDU4(mem4,rc)) */
/* 132 */	"orl %2,%1\n",	/* stmt: ASGNU4(addr,BORU4(mem4,rc)) */
/* 133 */	"xorl %2,%1\n",	/* stmt: ASGNU4(addr,BXORU4(mem4,rc)) */
/* 134 */	"?movl %0,%c\nnotl %c\n",	/* reg: BCOMI4(reg) */
/* 135 */	"?movl %0,%c\nnotl %c\n",	/* reg: BCOMU4(reg) */
/* 136 */	"?movl %0,%c\nnegl %c\n",	/* reg: NEGI4(reg) */
/* 137 */	"notl %1\n",	/* stmt: ASGNI4(addr,BCOMI4(mem4)) */
/* 138 */	"notl %1\n",	/* stmt: ASGNU4(addr,BCOMU4(mem4)) */
/* 139 */	"negl %1\n",	/* stmt: ASGNI4(addr,NEGI4(mem4)) */
/* 140 */	"?movl %0,%c\nsall %1,%c\n",	/* reg: LSHI4(reg,rc5) */
/* 141 */	"?movl %0,%c\nshll %1,%c\n",	/* reg: LSHU4(reg,rc5) */
/* 142 */	"?movl %0,%c\nsarl %1,%c\n",	/* reg: RSHI4(reg,rc5) */
/* 143 */	"?movl %0,%c\nshrl %1,%c\n",	/* reg: RSHU4(reg,rc5) */
/* 144 */	"sall %2,%1\n",	/* stmt: ASGNI4(addr,LSHI4(mem4,rc5)) */
/* 145 */	"shll %2,%1\n",	/* stmt: ASGNI4(addr,LSHU4(mem4,rc5)) */
/* 146 */	"sarl %2,%1\n",	/* stmt: ASGNI4(addr,RSHI4(mem4,rc5)) */
/* 147 */	"shrl %2,%1\n",	/* stmt: ASGNI4(addr,RSHU4(mem4,rc5)) */
/* 148 */	"$%a",	/* rc5: CNSTI4 */
/* 149 */	"%%cl",	/* rc5: reg */
/* 150 */	"?movl %0,%c\nimull %1,%c\n",	/* reg: MULI4(reg,mrc) */
/* 151 */	"imul %0,%1,%c\n",	/* reg: MULI4(con,mr) */
/* 152 */	"mull %1\n",	/* reg: MULU4(reg,mr) */
/* 153 */	"xorl %%edx,%%edx\ndivl %1\n",	/* reg: DIVU4(reg,reg) */
/* 154 */	"xorl %%edx,%%edx\ndivl %1\n",	/* reg: MODU4(reg,reg) */
/* 155 */	"cdq\nidivl %1\n",	/* reg: DIVI4(reg,reg) */
/* 156 */	"cdq\nidivl %1\n",	/* reg: MODI4(reg,reg) */
/* 157 */	"movl %0,%c\n",	/* reg: CVPU4(reg) */
/* 158 */	"movl %0,%c\n",	/* reg: CVUP4(reg) */
/* 159 */	"movsbl %0,%c\n",	/* reg: CVII4(INDIRI1(addr)) */
/* 160 */	"movswl %0,%c\n",	/* reg: CVII4(INDIRI2(addr)) */
/* 161 */	"movzbl %0,%c\n",	/* reg: CVUU4(INDIRU1(addr)) */
/* 162 */	"movzwl %0,%c\n",	/* reg: CVUU4(INDIRU2(addr)) */
/* 163 */	"# extend\n",	/* reg: CVII4(reg) */
/* 164 */	"# extend\n",	/* reg: CVIU4(reg) */
/* 165 */	"# extend\n",	/* reg: CVUI4(reg) */
/* 166 */	"# extend\n",	/* reg: CVUU4(reg) */
/* 167 */	"# truncate\n",	/* reg: CVII1(reg) */
/* 168 */	"# truncate\n",	/* reg: CVII2(reg) */
/* 169 */	"# truncate\n",	/* reg: CVUU1(reg) */
/* 170 */	"# truncate\n",	/* reg: CVUU2(reg) */
/* 171 */	"%0",	/* mrca: mem4 */
/* 172 */	"%0",	/* mrca: rc */
/* 173 */	"$%a",	/* mrca: ADDRGP4 */
/* 174 */	"$%a",	/* mrca: ADDRGP8 */
/* 175 */	"movb %1,%0\n",	/* stmt: ASGNI1(addr,rc) */
/* 176 */	"movw %1,%0\n",	/* stmt: ASGNI2(addr,rc) */
/* 177 */	"movl %1,%0\n",	/* stmt: ASGNI4(addr,rc) */
/* 178 */	"movb %1,%0\n",	/* stmt: ASGNU1(addr,rc) */
/* 179 */	"movw %1,%0\n",	/* stmt: ASGNU2(addr,rc) */
/* 180 */	"movl %1,%0\n",	/* stmt: ASGNU4(addr,rc) */
/* 181 */	"movl %1,%0\n",	/* stmt: ASGNP4(addr,rc) */
/* 182 */	"pushl %0\n",	/* stmt: ARGI4(mrca) */
/* 183 */	"pushl %0\n",	/* stmt: ARGU4(mrca) */
/* 184 */	"pushl %0\n",	/* stmt: ARGP4(mrca) */
/* 185 */	"movl $%a,%%ecx\nrep\nmovsb\n",	/* stmt: ASGNB(reg,INDIRB(reg)) */
/* 186 */	"# ARGB\n",	/* stmt: ARGB(INDIRB(reg)) */
/* 187 */	"l %0",	/* memf: INDIRF8(addr) */
/* 188 */	"s %0",	/* memf: INDIRF4(addr) */
/* 189 */	"s %0",	/* memf: CVFF8(INDIRF4(addr)) */
/* 190 */	"l %0",	/* memf: CVFF4(INDIRF8(addr)) */
/* 191 */	"fld%0\n",	/* freg: memf */
/* 192 */	"fstpl %0\n",	/* stmt: ASGNF8(addr,freg) */
/* 193 */	"fstps %0\n",	/* stmt: ASGNF4(addr,freg) */
/* 194 */	"fstps %0\n",	/* stmt: ASGNF4(addr,CVFF4(freg)) */
/* 195 */	"subl $8,%%esp\nfstpl (%%esp)\n",	/* stmt: ARGF8(freg) */
/* 196 */	"subl $4,%%esp\nfstps (%%esp)\n",	/* stmt: ARGF4(freg) */
/* 197 */	"fchs\n",	/* freg: NEGF8(freg) */
/* 198 */	"fchs\n",	/* freg: NEGF4(freg) */
/* 199 */	"%0",	/* flt: memf */
/* 200 */	"p %%st,%%st(1)",	/* flt: freg */
/* 201 */	"%0",	/* flt2: memf */
/* 202 */	"rp %%st,%%st(1)",	/* flt2: freg */
/* 203 */	"fadd%1\n",	/* freg: ADDF4(freg,flt) */
/* 204 */	"fadd%1\n",	/* freg: ADDF8(freg,flt) */
/* 205 */	"fdiv%1\n",	/* freg: DIVF4(freg,flt2) */
/* 206 */	"fdiv%1\n",	/* freg: DIVF8(freg,flt2) */
/* 207 */	"fmul%1\n",	/* freg: MULF4(freg,flt) */
/* 208 */	"fmul%1\n",	/* freg: MULF8(freg,flt) */
/* 209 */	"fsub%1\n",	/* freg: SUBF4(freg,flt2) */
/* 210 */	"fsub%1\n",	/* freg: SUBF8(freg,flt2) */
/* 211 */	"# CVFF8\n",	/* freg: CVFF8(freg) */
/* 212 */	"sub $4,%%esp\nfstps (%%esp)\nflds (%%esp)\naddl $4,%%esp\n",	/* freg: CVFF4(freg) */
/* 213 */	"subl $8,%%esp\nfnstcw 4(%%esp)\nmovl 4(%%esp),%%edx\nmovb $12,%%dh\nmovl %%edx,0(%%esp)\nfldcw 0(%%esp)\nfistpl 0(%%esp)\npopl %c\nfldcw 0(%%esp)\naddl $4,%%esp\n",	/* reg: CVFI4(freg) */
/* 214 */	"fildl %0\n",	/* freg: CVIF8(INDIRI4(addr)) */
/* 215 */	"pushl %0\nfildl (%%esp)\naddl $4,%%esp\n",	/* freg: CVIF8(reg) */
/* 216 */	"fildl %0\n",	/* freg: CVIF4(INDIRI4(addr)) */
/* 217 */	"pushl %0\nfildl (%%esp)\naddl $4,%%esp\n",	/* freg: CVIF4(reg) */
/* 218 */	"%a",	/* addrj: ADDRGP4 */
/* 219 */	"*%0",	/* addrj: reg */
/* 220 */	"*%0",	/* addrj: mem4 */
/* 221 */	"%a:\n",	/* stmt: LABELV */
/* 222 */	"jmp %0\n",	/* stmt: JUMPV(addrj) */
/* 223 */	"cmpl %1,%0\nje %a\n",	/* stmt: EQI4(mem4,rc) */
/* 224 */	"cmpl %1,%0\njge %a\n",	/* stmt: GEI4(mem4,rc) */
/* 225 */	"cmpl %1,%0\njg %a\n",	/* stmt: GTI4(mem4,rc) */
/* 226 */	"cmpl %1,%0\njle %a\n",	/* stmt: LEI4(mem4,rc) */
/* 227 */	"cmpl %1,%0\njl %a\n",	/* stmt: LTI4(mem4,rc) */
/* 228 */	"cmpl %1,%0\njne %a\n",	/* stmt: NEI4(mem4,rc) */
/* 229 */	"cmpl %1,%0\njae %a\n",	/* stmt: GEU4(mem4,rc) */
/* 230 */	"cmpl %1,%0\nja  %a\n",	/* stmt: GTU4(mem4,rc) */
/* 231 */	"cmpl %1,%0\njbe %a\n",	/* stmt: LEU4(mem4,rc) */
/* 232 */	"cmpl %1,%0\njb  %a\n",	/* stmt: LTU4(mem4,rc) */
/* 233 */	"cmpl %1,%0\nje %a\n",	/* stmt: EQI4(reg,mrc) */
/* 234 */	"cmpl %1,%0\njge %a\n",	/* stmt: GEI4(reg,mrc) */
/* 235 */	"cmpl %1,%0\njg %a\n",	/* stmt: GTI4(reg,mrc) */
/* 236 */	"cmpl %1,%0\njle %a\n",	/* stmt: LEI4(reg,mrc) */
/* 237 */	"cmpl %1,%0\njl %a\n",	/* stmt: LTI4(reg,mrc) */
/* 238 */	"cmpl %1,%0\njne %a\n",	/* stmt: NEI4(reg,mrc) */
/* 239 */	"cmpl %1,%0\nje %a\n",	/* stmt: EQU4(reg,mrc) */
/* 240 */	"cmpl %1,%0\njae %a\n",	/* stmt: GEU4(reg,mrc) */
/* 241 */	"cmpl %1,%0\nja %a\n",	/* stmt: GTU4(reg,mrc) */
/* 242 */	"cmpl %1,%0\njbe %a\n",	/* stmt: LEU4(reg,mrc) */
/* 243 */	"cmpl %1,%0\njb %a\n",	/* stmt: LTU4(reg,mrc) */
/* 244 */	"cmpl %1,%0\njne %a\n",	/* stmt: NEU4(reg,mrc) */
/* 245 */	"testl %1,%0\nje %a\n",	/* stmt: EQI4(BANDU4(mr,con),con0) */
/* 246 */	"testl %1,%0\njne %a\n",	/* stmt: NEI4(BANDU4(mr,con),con0) */
/* 247 */	"testw %1,%0\nje %a\n",	/* stmt: EQI4(BANDU4(CVII2(INDIRI2(addr)),con),con0) */
/* 248 */	"testw %1,%0\njne %a\n",	/* stmt: NEI4(BANDU4(CVII2(INDIRI2(addr)),con),con0) */
/* 249 */	"testw %1,%0\nje %a\n",	/* stmt: EQI4(BANDU4(CVIU2(INDIRI2(addr)),con),con0) */
/* 250 */	"testw %1,%0\njne %a\n",	/* stmt: NEI4(BANDU4(CVIU2(INDIRI2(addr)),con),con0) */
/* 251 */	"testb %1,%0\nje %a\n",	/* stmt: EQI4(BANDU4(CVII1(INDIRI1(addr)),con),con0) */
/* 252 */	"l %0",	/* cmpf: INDIRF8(addr) */
/* 253 */	"s %0",	/* cmpf: INDIRF4(addr) */
/* 254 */	"s %0",	/* cmpf: CVFF8(INDIRF4(addr)) */
/* 255 */	"p",	/* cmpf: freg */
/* 256 */	"fcomp%0\nfstsw %%ax\nsahf\njp 1f\nje %a\n1:\n",	/* stmt: EQF8(cmpf,freg) */
/* 257 */	"fcomp%0\nfstsw %%ax\nsahf\njp %a\njbe %a\n",	/* stmt: GEF8(cmpf,freg) */
/* 258 */	"fcomp%0\nfstsw %%ax\nsahf\njp %a\njb %a\n",	/* stmt: GTF8(cmpf,freg) */
/* 259 */	"fcomp%0\nfstsw %%ax\nsahf\njp %a\njae %a\n",	/* stmt: LEF8(cmpf,freg) */
/* 260 */	"fcomp%0\nfstsw %%ax\nsahf\njp %a\nja %a\n",	/* stmt: LTF8(cmpf,freg) */
/* 261 */	"fcomp%0\nfstsw %%ax\nsahf\njp %a\njne %a\n",	/* stmt: NEF8(cmpf,freg) */
/* 262 */	"fcomp%0\nfstsw %%ax\nsahf\njp 1f\nje %a\n1:\n",	/* stmt: EQF4(cmpf,freg) */
/* 263 */	"fcomp%0\nfstsw %%ax\nsahf\njp %a\njbe %a\n",	/* stmt: GEF4(cmpf,freg) */
/* 264 */	"fcomp%0\nfstsw %%ax\nsahf\njp %a\njb %a\n",	/* stmt: GTF4(cmpf,freg) */
/* 265 */	"fcomp%0\nfstsw %%ax\nsahf\njp %a\njae %a\n",	/* stmt: LEF4(cmpf,freg) */
/* 266 */	"fcomp%0\nfstsw %%ax\nsahf\njp %a\nja %a\n",	/* stmt: LTF4(cmpf,freg) */
/* 267 */	"fcomp%0\nfstsw %%ax\nsahf\njp %a\njne %a\n",	/* stmt: NEF4(cmpf,freg) */
/* 268 */	"fidivl %1\n",	/* freg: DIVF8(freg,CVIF8(INDIRI4(addr))) */
/* 269 */	"fidivrl %0\n",	/* freg: DIVF8(CVIF8(INDIRI4(addr)),freg) */
/* 270 */	"fidivs %1\n",	/* freg: DIVF8(freg,CVIF8(CVII2(INDIRI2(addr)))) */
/* 271 */	"fidivrs %0\n",	/* freg: DIVF8(CVIF8(CVII2(INDIRI2(addr))),freg) */
/* 272 */	"fimull %1\n",	/* freg: MULF8(freg,CVIF8(INDIRI4(addr))) */
/* 273 */	"fimuls %1\n",	/* freg: MULF8(freg,CVIF8(CVII2(INDIRI2(addr)))) */
/* 274 */	"fisubl %1\n",	/* freg: SUBF8(freg,CVIF8(INDIRI4(addr))) */
/* 275 */	"fisubrl %0\n",	/* freg: SUBF8(CVIF8(INDIRI4(addr)),freg) */
/* 276 */	"fisubs %1\n",	/* freg: SUBF8(freg,CVIF8(CVII2(INDIRI2(addr)))) */
/* 277 */	"fisubrs %0\n",	/* freg: SUBF8(CVIF8(CVII2(INDIRI2(addr))),freg) */
/* 278 */	"fiaddl %1\n",	/* freg: ADDF8(freg,CVIF8(INDIRI4(addr))) */
/* 279 */	"fiadds %1\n",	/* freg: ADDF8(freg,CVIF8(CVII2(INDIRI2(addr)))) */
/* 280 */	"fdivs %1\n",	/* freg: ADDF8(freg,CVFF8(INDIRF4(addr))) */
/* 281 */	"fsubs %1\n",	/* freg: SUBF8(freg,CVFF8(INDIRF4(addr))) */
/* 282 */	"fmuls %1\n",	/* freg: MULF8(freg,CVFF8(INDIRF4(addr))) */
/* 283 */	"fdivs %1\n",	/* freg: DIVF8(freg,CVFF8(INDIRF4(addr))) */
/* 284 */	"fld%0\n",	/* freg: LOADF8(memf) */
/* 285 */	"call %0\naddl $%a,%%esp\n",	/* reg: CALLI4(addrj) */
/* 286 */	"call %0\naddl $%a,%%esp\n",	/* reg: CALLU4(addrj) */
/* 287 */	"call %0\naddl $%a,%%esp\n",	/* reg: CALLP4(addrj) */
/* 288 */	"call %0\n",	/* reg: CALLI4(addrj) */
/* 289 */	"call %0\n",	/* reg: CALLU4(addrj) */
/* 290 */	"call %0\n",	/* reg: CALLP4(addrj) */
/* 291 */	"call %0\naddl $%a,%%esp\n",	/* stmt: CALLV(addrj) */
/* 292 */	"call %0\n",	/* stmt: CALLV(addrj) */
/* 293 */	"call %0\naddl $%a,%%esp\n",	/* freg: CALLF4(addrj) */
/* 294 */	"call %0\n",	/* freg: CALLF4(addrj) */
/* 295 */	"call %0\naddl $%a,%%esp\nfstp %%st(0)\n",	/* stmt: CALLF4(addrj) */
/* 296 */	"call %0\nfstp %%st(0)\n",	/* stmt: CALLF4(addrj) */
/* 297 */	"call %0\naddl $%a,%%esp\n",	/* freg: CALLF8(addrj) */
/* 298 */	"call %0\n",	/* freg: CALLF8(addrj) */
/* 299 */	"call %0\naddl $%a,%%esp\nfstp %%st(0)\n",	/* stmt: CALLF8(addrj) */
/* 300 */	"call %0\nfstp %%st(0)\n",	/* stmt: CALLF8(addrj) */
/* 301 */	"# ret\n",	/* stmt: RETI4(reg) */
/* 302 */	"# ret\n",	/* stmt: RETU4(reg) */
/* 303 */	"# ret\n",	/* stmt: RETP4(reg) */
/* 304 */	"# ret\n",	/* stmt: RETF4(freg) */
/* 305 */	"# ret\n",	/* stmt: RETF8(freg) */
};

static char _isinstruction[] = {
/* 0 */	0,
/* 1 */	1,	/* # read register\n */
/* 2 */	1,	/* # read register\n */
/* 3 */	1,	/* # read register\n */
/* 4 */	1,	/* # read register\n */
/* 5 */	1,	/* # read register\n */
/* 6 */	1,	/* # read register\n */
/* 7 */	1,	/* # read register\n */
/* 8 */	1,	/* # read register\n */
/* 9 */	1,	/* # read register\n */
/* 10 */	1,	/* # read register\n */
/* 11 */	1,	/* # read register\n */
/* 12 */	1,	/* # read register\n */
/* 13 */	1,	/* # write register\n */
/* 14 */	1,	/* # write register\n */
/* 15 */	1,	/* # write register\n */
/* 16 */	1,	/* # write register\n */
/* 17 */	1,	/* # write register\n */
/* 18 */	1,	/* # write register\n */
/* 19 */	1,	/* # write register\n */
/* 20 */	1,	/* # write register\n */
/* 21 */	1,	/* # write register\n */
/* 22 */	1,	/* # write register\n */
/* 23 */	1,	/* # write register\n */
/* 24 */	1,	/* # write register\n */
/* 25 */	0,	/* %a */
/* 26 */	0,	/* %a */
/* 27 */	0,	/* %a */
/* 28 */	0,	/* %a */
/* 29 */	0,	/* %a */
/* 30 */	0,	/* %a */
/* 31 */	0,	/* %a */
/* 32 */	0,	/* %a */
/* 33 */	0,	/* %a */
/* 34 */	0,	/* %a */
/* 35 */	0,	/* $%0 */
/* 36 */	0,	/*  */
/* 37 */	0,	/*  */
/* 38 */	0,	/* %a */
/* 39 */	0,	/* %a */
/* 40 */	0,	/* %0 */
/* 41 */	0,	/* %a */
/* 42 */	0,	/* (%0) */
/* 43 */	0,	/* %1(%0) */
/* 44 */	0,	/* %1(%0) */
/* 45 */	0,	/* %1(%0) */
/* 46 */	0,	/* %a(%%ebp) */
/* 47 */	0,	/* %a(%%ebp) */
/* 48 */	0,	/* %0 */
/* 49 */	0,	/* %0,2 */
/* 50 */	0,	/* %0,4 */
/* 51 */	0,	/* %0,8 */
/* 52 */	0,	/* %0,2 */
/* 53 */	0,	/* %0,4 */
/* 54 */	0,	/* %0,8 */
/* 55 */	0,	/* 1 */
/* 56 */	0,	/* 1 */
/* 57 */	0,	/* 1 */
/* 58 */	0,	/* 1 */
/* 59 */	0,	/* 2 */
/* 60 */	0,	/* 2 */
/* 61 */	0,	/* 3 */
/* 62 */	0,	/* 3 */
/* 63 */	0,	/* %0 */
/* 64 */	0,	/* %0 */
/* 65 */	0,	/* %1(,%0) */
/* 66 */	0,	/* %1(,%0) */
/* 67 */	0,	/* %1(,%0) */
/* 68 */	0,	/* %1(%0) */
/* 69 */	0,	/* %1(%0) */
/* 70 */	0,	/* %1(%0) */
/* 71 */	0,	/* (%1,%0) */
/* 72 */	0,	/* (%1,%0) */
/* 73 */	0,	/* (%1,%0) */
/* 74 */	0,	/* (,%0) */
/* 75 */	0,	/* %0 */
/* 76 */	0,	/* %0 */
/* 77 */	0,	/* %0 */
/* 78 */	0,	/* %0 */
/* 79 */	0,	/* %0 */
/* 80 */	0,	/* %0 */
/* 81 */	0,	/* %0 */
/* 82 */	0,	/* %0 */
/* 83 */	0,	/* %0 */
/* 84 */	0,	/* %0 */
/* 85 */	0,	/* %0 */
/* 86 */	0,	/* %0 */
/* 87 */	0,	/* %0 */
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
/* 94 */	1,	/* leal %0,%c\n */
/* 95 */	1,	/* movl %0,%c\n */
/* 96 */	1,	/* movb %0,%c\n */
/* 97 */	1,	/* movw %0,%c\n */
/* 98 */	1,	/* mov %0,%c\n */
/* 99 */	1,	/* # move\n */
/* 100 */	1,	/* # move\n */
/* 101 */	1,	/* # move\n */
/* 102 */	1,	/* # move\n */
/* 103 */	1,	/* # move\n */
/* 104 */	1,	/* # move\n */
/* 105 */	1,	/* # move\n */
/* 106 */	1,	/* ?movl %0,%c\naddl %1,%c\n */
/* 107 */	1,	/* ?movl %0,%c\naddl %1,%c\n */
/* 108 */	1,	/* ?movl %0,%c\naddl %1,%c\n */
/* 109 */	1,	/* ?movl %0,%c\nsubl %1,%c\n */
/* 110 */	1,	/* ?movl %0,%c\nsubl %1,%c\n */
/* 111 */	1,	/* ?movl %0,%c\nsubl %1,%c\n */
/* 112 */	1,	/* ?movl %0,%c\nandl %1,%c\n */
/* 113 */	1,	/* ?movl %0,%c\norl %1,%c\n */
/* 114 */	1,	/* ?movl %0,%c\nxorl %1,%c\n */
/* 115 */	1,	/* ?movl %0,%c\nandl %1,%c\n */
/* 116 */	1,	/* ?movl %0,%c\norl %1,%c\n */
/* 117 */	1,	/* ?movl %0,%c\nxorl %1,%c\n */
/* 118 */	1,	/* incl %1\n */
/* 119 */	1,	/* incl %1\n */
/* 120 */	1,	/* incl %1\n */
/* 121 */	1,	/* decl %1\n */
/* 122 */	1,	/* decl %1\n */
/* 123 */	1,	/* decl %1\n */
/* 124 */	1,	/* addl %2,%1\n */
/* 125 */	1,	/* subl %2,%1\n */
/* 126 */	1,	/* addl %2,%1\n */
/* 127 */	1,	/* subl %2,%1\n */
/* 128 */	1,	/* andl %2,%1\n */
/* 129 */	1,	/* orl %2,%1\n */
/* 130 */	1,	/* xorl %2,%1\n */
/* 131 */	1,	/* andl %2,%1\n */
/* 132 */	1,	/* orl %2,%1\n */
/* 133 */	1,	/* xorl %2,%1\n */
/* 134 */	1,	/* ?movl %0,%c\nnotl %c\n */
/* 135 */	1,	/* ?movl %0,%c\nnotl %c\n */
/* 136 */	1,	/* ?movl %0,%c\nnegl %c\n */
/* 137 */	1,	/* notl %1\n */
/* 138 */	1,	/* notl %1\n */
/* 139 */	1,	/* negl %1\n */
/* 140 */	1,	/* ?movl %0,%c\nsall %1,%c\n */
/* 141 */	1,	/* ?movl %0,%c\nshll %1,%c\n */
/* 142 */	1,	/* ?movl %0,%c\nsarl %1,%c\n */
/* 143 */	1,	/* ?movl %0,%c\nshrl %1,%c\n */
/* 144 */	1,	/* sall %2,%1\n */
/* 145 */	1,	/* shll %2,%1\n */
/* 146 */	1,	/* sarl %2,%1\n */
/* 147 */	1,	/* shrl %2,%1\n */
/* 148 */	0,	/* $%a */
/* 149 */	0,	/* %%cl */
/* 150 */	1,	/* ?movl %0,%c\nimull %1,%c\n */
/* 151 */	1,	/* imul %0,%1,%c\n */
/* 152 */	1,	/* mull %1\n */
/* 153 */	1,	/* xorl %%edx,%%edx\ndivl %1\n */
/* 154 */	1,	/* xorl %%edx,%%edx\ndivl %1\n */
/* 155 */	1,	/* cdq\nidivl %1\n */
/* 156 */	1,	/* cdq\nidivl %1\n */
/* 157 */	1,	/* movl %0,%c\n */
/* 158 */	1,	/* movl %0,%c\n */
/* 159 */	1,	/* movsbl %0,%c\n */
/* 160 */	1,	/* movswl %0,%c\n */
/* 161 */	1,	/* movzbl %0,%c\n */
/* 162 */	1,	/* movzwl %0,%c\n */
/* 163 */	1,	/* # extend\n */
/* 164 */	1,	/* # extend\n */
/* 165 */	1,	/* # extend\n */
/* 166 */	1,	/* # extend\n */
/* 167 */	1,	/* # truncate\n */
/* 168 */	1,	/* # truncate\n */
/* 169 */	1,	/* # truncate\n */
/* 170 */	1,	/* # truncate\n */
/* 171 */	0,	/* %0 */
/* 172 */	0,	/* %0 */
/* 173 */	0,	/* $%a */
/* 174 */	0,	/* $%a */
/* 175 */	1,	/* movb %1,%0\n */
/* 176 */	1,	/* movw %1,%0\n */
/* 177 */	1,	/* movl %1,%0\n */
/* 178 */	1,	/* movb %1,%0\n */
/* 179 */	1,	/* movw %1,%0\n */
/* 180 */	1,	/* movl %1,%0\n */
/* 181 */	1,	/* movl %1,%0\n */
/* 182 */	1,	/* pushl %0\n */
/* 183 */	1,	/* pushl %0\n */
/* 184 */	1,	/* pushl %0\n */
/* 185 */	1,	/* movl $%a,%%ecx\nrep\nmovsb\n */
/* 186 */	1,	/* # ARGB\n */
/* 187 */	0,	/* l %0 */
/* 188 */	0,	/* s %0 */
/* 189 */	0,	/* s %0 */
/* 190 */	0,	/* l %0 */
/* 191 */	1,	/* fld%0\n */
/* 192 */	1,	/* fstpl %0\n */
/* 193 */	1,	/* fstps %0\n */
/* 194 */	1,	/* fstps %0\n */
/* 195 */	1,	/* subl $8,%%esp\nfstpl (%%esp)\n */
/* 196 */	1,	/* subl $4,%%esp\nfstps (%%esp)\n */
/* 197 */	1,	/* fchs\n */
/* 198 */	1,	/* fchs\n */
/* 199 */	0,	/* %0 */
/* 200 */	0,	/* p %%st,%%st(1) */
/* 201 */	0,	/* %0 */
/* 202 */	0,	/* rp %%st,%%st(1) */
/* 203 */	1,	/* fadd%1\n */
/* 204 */	1,	/* fadd%1\n */
/* 205 */	1,	/* fdiv%1\n */
/* 206 */	1,	/* fdiv%1\n */
/* 207 */	1,	/* fmul%1\n */
/* 208 */	1,	/* fmul%1\n */
/* 209 */	1,	/* fsub%1\n */
/* 210 */	1,	/* fsub%1\n */
/* 211 */	1,	/* # CVFF8\n */
/* 212 */	1,	/* sub $4,%%esp\nfstps (%%esp)\nflds (%%esp)\naddl $4,%%esp\n */
/* 213 */	1,	/* subl $8,%%esp\nfnstcw 4(%%esp)\nmovl 4(%%esp),%%edx\nmovb $12,%%dh\nmovl %%edx,0(%%esp)\nfldcw 0(%%esp)\nfistpl 0(%%esp)\npopl %c\nfldcw 0(%%esp)\naddl $4,%%esp\n */
/* 214 */	1,	/* fildl %0\n */
/* 215 */	1,	/* pushl %0\nfildl (%%esp)\naddl $4,%%esp\n */
/* 216 */	1,	/* fildl %0\n */
/* 217 */	1,	/* pushl %0\nfildl (%%esp)\naddl $4,%%esp\n */
/* 218 */	0,	/* %a */
/* 219 */	0,	/* *%0 */
/* 220 */	0,	/* *%0 */
/* 221 */	1,	/* %a:\n */
/* 222 */	1,	/* jmp %0\n */
/* 223 */	1,	/* cmpl %1,%0\nje %a\n */
/* 224 */	1,	/* cmpl %1,%0\njge %a\n */
/* 225 */	1,	/* cmpl %1,%0\njg %a\n */
/* 226 */	1,	/* cmpl %1,%0\njle %a\n */
/* 227 */	1,	/* cmpl %1,%0\njl %a\n */
/* 228 */	1,	/* cmpl %1,%0\njne %a\n */
/* 229 */	1,	/* cmpl %1,%0\njae %a\n */
/* 230 */	1,	/* cmpl %1,%0\nja  %a\n */
/* 231 */	1,	/* cmpl %1,%0\njbe %a\n */
/* 232 */	1,	/* cmpl %1,%0\njb  %a\n */
/* 233 */	1,	/* cmpl %1,%0\nje %a\n */
/* 234 */	1,	/* cmpl %1,%0\njge %a\n */
/* 235 */	1,	/* cmpl %1,%0\njg %a\n */
/* 236 */	1,	/* cmpl %1,%0\njle %a\n */
/* 237 */	1,	/* cmpl %1,%0\njl %a\n */
/* 238 */	1,	/* cmpl %1,%0\njne %a\n */
/* 239 */	1,	/* cmpl %1,%0\nje %a\n */
/* 240 */	1,	/* cmpl %1,%0\njae %a\n */
/* 241 */	1,	/* cmpl %1,%0\nja %a\n */
/* 242 */	1,	/* cmpl %1,%0\njbe %a\n */
/* 243 */	1,	/* cmpl %1,%0\njb %a\n */
/* 244 */	1,	/* cmpl %1,%0\njne %a\n */
/* 245 */	1,	/* testl %1,%0\nje %a\n */
/* 246 */	1,	/* testl %1,%0\njne %a\n */
/* 247 */	1,	/* testw %1,%0\nje %a\n */
/* 248 */	1,	/* testw %1,%0\njne %a\n */
/* 249 */	1,	/* testw %1,%0\nje %a\n */
/* 250 */	1,	/* testw %1,%0\njne %a\n */
/* 251 */	1,	/* testb %1,%0\nje %a\n */
/* 252 */	0,	/* l %0 */
/* 253 */	0,	/* s %0 */
/* 254 */	0,	/* s %0 */
/* 255 */	0,	/* p */
/* 256 */	1,	/* fcomp%0\nfstsw %%ax\nsahf\njp 1f\nje %a\n1:\n */
/* 257 */	1,	/* fcomp%0\nfstsw %%ax\nsahf\njp %a\njbe %a\n */
/* 258 */	1,	/* fcomp%0\nfstsw %%ax\nsahf\njp %a\njb %a\n */
/* 259 */	1,	/* fcomp%0\nfstsw %%ax\nsahf\njp %a\njae %a\n */
/* 260 */	1,	/* fcomp%0\nfstsw %%ax\nsahf\njp %a\nja %a\n */
/* 261 */	1,	/* fcomp%0\nfstsw %%ax\nsahf\njp %a\njne %a\n */
/* 262 */	1,	/* fcomp%0\nfstsw %%ax\nsahf\njp 1f\nje %a\n1:\n */
/* 263 */	1,	/* fcomp%0\nfstsw %%ax\nsahf\njp %a\njbe %a\n */
/* 264 */	1,	/* fcomp%0\nfstsw %%ax\nsahf\njp %a\njb %a\n */
/* 265 */	1,	/* fcomp%0\nfstsw %%ax\nsahf\njp %a\njae %a\n */
/* 266 */	1,	/* fcomp%0\nfstsw %%ax\nsahf\njp %a\nja %a\n */
/* 267 */	1,	/* fcomp%0\nfstsw %%ax\nsahf\njp %a\njne %a\n */
/* 268 */	1,	/* fidivl %1\n */
/* 269 */	1,	/* fidivrl %0\n */
/* 270 */	1,	/* fidivs %1\n */
/* 271 */	1,	/* fidivrs %0\n */
/* 272 */	1,	/* fimull %1\n */
/* 273 */	1,	/* fimuls %1\n */
/* 274 */	1,	/* fisubl %1\n */
/* 275 */	1,	/* fisubrl %0\n */
/* 276 */	1,	/* fisubs %1\n */
/* 277 */	1,	/* fisubrs %0\n */
/* 278 */	1,	/* fiaddl %1\n */
/* 279 */	1,	/* fiadds %1\n */
/* 280 */	1,	/* fdivs %1\n */
/* 281 */	1,	/* fsubs %1\n */
/* 282 */	1,	/* fmuls %1\n */
/* 283 */	1,	/* fdivs %1\n */
/* 284 */	1,	/* fld%0\n */
/* 285 */	1,	/* call %0\naddl $%a,%%esp\n */
/* 286 */	1,	/* call %0\naddl $%a,%%esp\n */
/* 287 */	1,	/* call %0\naddl $%a,%%esp\n */
/* 288 */	1,	/* call %0\n */
/* 289 */	1,	/* call %0\n */
/* 290 */	1,	/* call %0\n */
/* 291 */	1,	/* call %0\naddl $%a,%%esp\n */
/* 292 */	1,	/* call %0\n */
/* 293 */	1,	/* call %0\naddl $%a,%%esp\n */
/* 294 */	1,	/* call %0\n */
/* 295 */	1,	/* call %0\naddl $%a,%%esp\nfstp %%st(0)\n */
/* 296 */	1,	/* call %0\nfstp %%st(0)\n */
/* 297 */	1,	/* call %0\naddl $%a,%%esp\n */
/* 298 */	1,	/* call %0\n */
/* 299 */	1,	/* call %0\naddl $%a,%%esp\nfstp %%st(0)\n */
/* 300 */	1,	/* call %0\nfstp %%st(0)\n */
/* 301 */	1,	/* # ret\n */
/* 302 */	1,	/* # ret\n */
/* 303 */	1,	/* # ret\n */
/* 304 */	1,	/* # ret\n */
/* 305 */	1,	/* # ret\n */
};
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
