dpilawa/bytec/ucasm/Parser.cpp

/* 
 * 
 *    Parser.cpp - this file is part of Microcode Assembler
 *   
 *    Copyright 2009, 2010, 2011, 2016 Dawid Pilawa
 * 
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
 */

#include <iostream>
#include <fstream>
#include <vector>
#include <set>
#include <sstream>
#include <iomanip>
#include <cstdlib>
#include "Microcode.h"
#include "Lexer.h"
#include "Parser.h"

using namespace ucasm;
using namespace std;

/**************************************************************
 *
 * Parser constructor
 *
 **************************************************************/
Parser::Parser(Lexer* l, Microcode* m) {
	lexer = l;
	ucode = m;
}

/**************************************************************
 *
 * Accept token given in parameter and read next token
 *
 **************************************************************/
int Parser::accept(ifstream& s, token t) {
	if (currentToken==t) {
		currentToken = lexer->getToken(s);
		return 1;
	} else {
		return 0;
	}
}

/**************************************************************
 *
 * Return next visible token
 *
 **************************************************************/
int Parser::see(ifstream& s, token t) {
	if (currentToken==t) {
		return 1;
	} else {
		return 0;
	}
}

/**************************************************************
 *
 * Return 1 if current token as expected (provided), 0 otherwise
 *
 **************************************************************/
int Parser::expect(ifstream& s, token t) {
	if (accept(s, t)) {
		return 1;
	}
	else {
		return 0;
	}
}

/**************************************************************
 *
 * Top level parsing routine. Parse opcodes until EOF:
 *   opcode
 *   opcode
 *   ...
 *   opcode
 *   END
 *
 **************************************************************/
void Parser::Parse(ifstream& s) {
	currentToken = lexer->getToken(s);
	while (!accept(s, END)) {
		parseOpcode(s);
	}
}

/**************************************************************
 *
 * Parse opcode:
 *   opcode(OPCODE#)
 *		line
 *		line
 *		...
 *		line
 *   endop
 *
 **************************************************************/
void Parser::parseOpcode(ifstream& s) {

	if (!expect(s, OP))
	{
		err("Expected opcode definition");
	}

	if (!expect(s, LBR))
	{
		err("Expected (");
	}

	if (!expect(s, HEXVAL))
	{
		err("Expected 8-bit hexadecimal value");
	}
	else
	{
		// check if opcode# in range 00h-FFh or 100h-10Fh
		currentOpcode = lexer->getVal();
		if ((currentOpcode < 0) or (currentOpcode > 255 + 16))
		{
			err("Opcode out of range");
		}
		else
		{
			// check for opcode redefinition
			if (usedTokens.find(currentOpcode) != usedTokens.end())
			{
				err("Redefinition of opcode");
			}
			else
			{
				usedTokens.insert(currentOpcode);
			}
		}
	}

	if (!expect(s, RBR))
	{
		err("Expected )");
	}

	// parse lines
	usedSteps.clear();
	while (!accept(s, ENDOP))
	{
		parseLine(s);
	}

	// verify if steps are continuous in range 0..n
	for (unsigned int i=0; i < usedSteps.size(); i++)
	{
		if (usedSteps.find(i) == usedSteps.end())
		{
			stringstream s;
			s << "Non continuous instruction steps for opcode " << hex << setw(3) << setfill('0') << currentOpcode << endl;
			err(s.str().c_str());
		}
	}

}
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
