dpilawa/bytec/lcc/bin/dagcheck.c

#include "c.h"
typedef Node NODEPTR_TYPE;
#define OP_LABEL(p)     (specific((p)->op))
#define LEFT_CHILD(p)   ((p)->kids[0])
#define RIGHT_CHILD(p)  ((p)->kids[1])
#define STATE_LABEL(p)  ((p)->x.state)
#define PANIC	   error
/*
generated at Thu Dec 10 23:19:59 2015
by $Id: lburg.c,v 2.10 2002/03/08 18:45:21 drh Exp $
*/
static void _kids(NODEPTR_TYPE, int, NODEPTR_TYPE[]);
static void _label(NODEPTR_TYPE);
static int _rule(void*, int);

#define _stmt_NT 1
#define _P_NT 2
#define _V_NT 3
#define _bogus_NT 4
#define _I_NT 5
#define _U_NT 6
#define _F_NT 7
#define _B_NT 8

static char *_ntname[] = {
	0,
	"stmt",
	"P",
	"V",
	"bogus",
	"I",
	"U",
	"F",
	"B",
	0
};

struct _state {
	short cost[9];
	struct {
		unsigned int _stmt:4;
		unsigned int _P:4;
		unsigned int _V:6;
		unsigned int _bogus:3;
		unsigned int _I:5;
		unsigned int _U:5;
		unsigned int _F:4;
		unsigned int _B:2;
	} rule;
};
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
