dpilawa/bytec/(commit log)

2015-12-28 Renamed F6 to /FP
    [3_cpu_control.brd, 3_cpu_control.sch]
2015-12-28 Added /FP (flag paging enabled) to schematics and board, extended header connector
    [3_cpu_control.brd, 3_cpu_control.sch]
2015-12-31 All boards prepared for MMU extension
    [0_cpu_interface.brd, 0_cpu_interface.sch, 0a_cpu_mmu.brd, 0a_cpu_mmu.sch, 1_cpu_control.brd, 1_cpu_control.sch, 2_cpu_control.brd, 2_cpu_control.sch]
2015-12-31 Removed obsolete power connector board
    [7_cpu_powercon.brd, 7_cpu_powercon.sch]
2016-01-06 Parts library updated (added fast SRAM), MMU board half complete
    [0_cpu_interface.brd, 0_cpu_interface.sch, 0a_cpu_mmu.brd, 0a_cpu_mmu.sch]
2016-01-12 MMU schematics update
    [0_cpu_interface.brd, 0_cpu_interface.sch, 0a_cpu_mmu.brd, 0a_cpu_mmu.sch, 3_cpu_control.sch]
2016-01-13 Updates to MMU faults generation circuit
    [0a_cpu_mmu.brd, 0a_cpu_mmu.sch]
2016-01-20 More MMU changes, added PPREG
    [0_cpu_interface.brd, 0_cpu_interface.sch, 0a_cpu_mmu.brd, 0a_cpu_mmu.sch]
2016-01-22 Removal of PPC started
    [0_cpu_interface.brd, 0_cpu_interface.sch, 0a_cpu_mmu.brd, 0a_cpu_mmu.sch, 1_cpu_control.brd, 1_cpu_control.sch, 2_cpu_control.brd, 2_cpu_control.sch]
2016-01-24 PPC removal completed, control card RBUS selector changed from LS138 to LS139, removed /LDPPC and /ENPPC signals
    [2_cpu_control.brd, 2_cpu_control.sch, 5_cpu_registers_a.brd]
2016-01-24 Renumbered boards and schematic sheets
    [1_cpu_control.brd, 1_cpu_mmu.brd, 1_cpu_mmu.sch, 2_cpu_control.brd, 2_cpu_control.sch, 3_cpu_control.brd, 3_cpu_control.sch, 4_cpu_control.brd]
2016-02-06 Sat Feb 6 20:10:54 CET 2016
    [1_cpu_mmu.brd, 1_cpu_mmu.sch, 2_cpu_control.brd, 2_cpu_control.sch, 3_cpu_control.brd, 3_cpu_control.sch, 4_cpu_control.brd, 4_cpu_control.sch]
2016-02-08 UCasm: renamed IRET to FRET (fault return) and modified microcode word layout to match new schematics
2016-02-08 Mon Feb 8 16:27:58 CET 2016
    [2_cpu_control.brd, 2_cpu_control.sch, 3_cpu_control.brd, 3_cpu_control.sch]
2016-02-09 2016-02-09 13:30
    [2_cpu_control.brd, 2_cpu_control.sch]
2016-02-09 2016-02-09 18:12
    [2_cpu_control.brd, 2_cpu_control.sch, 5_cpu_alu.brd, 7_cpu_registers_b.brd]
2016-02-10 2016-02-10 17:30 (completed boards 2,6,7)
    [2_cpu_control.brd, 2_cpu_control.sch, 3_cpu_control.brd, 3_cpu_control.sch, 4_cpu_control.brd, 4_cpu_control.sch, 5_cpu_alu.brd, 5_cpu_alu.sch]
2016-02-10 Wed Feb 10 22:17:37 CET 2016 (completed boards 5,4)
    [2_cpu_control.brd, 2_cpu_control.sch, 4_cpu_control.brd, 4_cpu_control.sch, 5_cpu_alu.brd]
2016-02-10 Completed board 3
    [3_cpu_control.brd, 3_cpu_control.sch]
2016-02-11 Fixed microcode word layout, updated microcode (added FRET in place of HALT)
    [Microcode.h]
2016-02-11 Completed board 0
    [0_cpu_interface.brd, 0_cpu_interface.sch, 2_cpu_control.sch, 3_cpu_control.sch]
2016-02-15 MMU board in progress
    [1_cpu_mmu.brd, 1_cpu_mmu.sch]
2016-02-16 MMU schematics completed
    [1_cpu_mmu.brd, 1_cpu_mmu.sch]
2016-02-16 MMU power rails and bypass caps added in schematic, board started
    [1_cpu_mmu.brd, 1_cpu_mmu.sch]
2016-02-20 Cosmetic change to board 2
    [2_cpu_control.sch]
2016-02-22 MMU board layout updates
    [1_cpu_mmu.brd]
2016-02-24 MMU board updates 2016-02-24
    [1_cpu_mmu.brd]
2016-02-25 MMU board updates 2016-02-25
    [1_cpu_mmu.brd, 1_cpu_mmu.sch]
2016-03-04 MMU and Memory board updates, removed mem_ext board (obsolete)
    [1_cpu_mmu.brd, mem_base.brd, mem_base.sch, mem_ext.sch, memory.brd, memory.sch]
2016-03-07 Memory board v2.0 completed
    [memory.brd]
2016-03-08 Gerber files added for Memory Board (v2.0)
    [7_cpu_powercon.GBL, 7_cpu_powercon.GBO, 7_cpu_powercon.GBP, 7_cpu_powercon.GBS, 7_cpu_powercon.GTL, 7_cpu_powercon.GTO, 7_cpu_powercon.GTP, 7_cpu_powercon.GTS]
2016-03-16 MMU board updates 2016-03-16
    [1_cpu_mmu.brd, 1_cpu_mmu.sch]
2016-03-24 MMU board updates 2016-03-24
    [1_cpu_mmu.brd]
2016-04-14 MMU board updates 2016-04-13
    [1_cpu_mmu.brd]
2016-04-14 MMU board completed
    [1_cpu_mmu.brd]
2016-04-14 Library update to CPU board #0, addedd schematics PDFs
    [0_cpu_interface.brd, 0_cpu_interface.sch]
2016-04-15 Updates for CPU rev.2.0 release
    [0_cpu_interface.GBL, 0_cpu_interface.GBO, 0_cpu_interface.GBS, 0_cpu_interface.GTL, 0_cpu_interface.GTO, 0_cpu_interface.GTP, 0_cpu_interface.GTS, 1_cpu_mmu.GBL]
2016-04-15 Removed obsolete files cont.
    [bom.ods]
2019-03-24 assembler changes for cpu rev. 2.0
